Korvova/gitar/print/1/README.txt

ПАПКА 1 — первая нитяная секция (напечатать и подёргать руками):
  zona_body — 1 шт, плашмя (дно+борта+жёлобы+пьедесталы роликов по этажам)
  zona_cover — 1 шт, плашмя (крышка со щелями)
  boat_x4 — 4 шт (лодочка: ножка 3 мм, 4 пары ушек по этажам)
  roller4_x8 — 8 шт, слои 0.12 (ролик Ø4, ось = винт M2 в пьедестал)
СБОРКА ТЕСТА: ролики на M2 -> крышку на M2 -> лодочки в щели ->
нить (зубная/плетёнка): правый борт -> ЛЕВОЕ ушко своего этажа, левый -> ПРАВОЕ
(перекрест под лодочкой), концы пока просто узлами с натягом рукой.
ПРОВЕРКА: лодочка ездит ~43 мм; нить не задевает чужие этажи; тяга без рывков.
