Korvova/gitar/wiki/t-plata.md

Плата управления: ESP32, драйверы моторов TMC2209, питание. Здесь — как подключать
и на чём уже обожглись.

## Требования

| Номер | Требование | Описание | Урок | Статус |
|---|---|---|---|---|
| 8.1 | Собрать под три фаланги пальца | | | ⬜ Не начато |
| 8.2 | UART драйвера — на ножки D16 и D17 | D16 (RX2) → контакт TX драйвера; D17 (TX2) → резистор 1 кОм → контакт RX драйвера. На плате ESP32 эти ножки подписаны **D16 / D17**, а не RX2 / TX2 | Ножки **RX0 / TX0** — это линия USB, к ним драйвер не подключать: команды проходят, ESP отвечает «ok», а мотор стоит. Потеряли на этом вечер 19.09 | ✅ Проверено |
| 8.3 | Команда `diag` в прошивке стенда | `drive_web.ino`: считает байты по RX2. 0 — линия мертва (не те ножки, обрыв); 4 — своё эхо есть, драйвер молчит (нет питания VM); 12 — связь есть, дальше версия, EN, ток, обрыв и замыкание катушек | Проверка перемычкой D16–D17 без драйвера должна дать 4. Библиотека TMCStepper отвечает «нет VM» и на полностью мёртвый UART — верить только счёту байт | ✅ Проверено |
| 8.4 | Драйвер S2209 V4: ток только по UART | Подстроечного винта тока нет, настройки после выключения не сохраняются — прошивка задаёт ток при каждом старте. Два штырька у EN — выходы DIAG и INDEX, не перемычка, оставить пустыми | Без резистора 1 кОм на линии D17 → RX ток не задать | ✅ Проверено |
| 8.5 | Питание драйвера VM | Логика TMC2209 питается от VM, порог запуска 4.75 В; VIO (3.3 В) чип не запускает. Рабочее питание — PD-триггер 9–20 В, минус общий с GND ESP | Для пробы на столе хватает ножки VIN ESP (питание от USB): 19.09 мотор Ø36 на 200 мА крутится, `diag` — версия 0x21, катушки ок. Сила на скорости от 5 В проваливается — для работы нужен триггер (8.7) | ✅ Проверено 19.09 |
| 8.6 | Проба первого мотора Ø36 от ESP32 | Стенд: ESP32 + S2209 V4 + мотор Ø36, пульт `2-0/websim/serial_pult.html` по USB. Команды `deg ±15`, `deg ±90` — вал ходит туда и обратно и возвращается в те же углы | Мотор подключать и отключать только при вынутом USB. Порядок проводов в разъёме мотора подошёл как есть: чёрный A2, оранжевый A1, красный B1, синий B2 | ✅ Проверено 19.09 |
| 8.7 | Питание мотора от PD-триггера | Зарядка Xiaomi 100 Вт (MDY-16-EL) → кабель Type-C → триггер с красным DIP и зелёным клеммником (PDSink) → VBUS на VM, GND на GND рядом с VM. Провод VIN с VM снят; от ESP на этой стороне драйвера только 3V3 → VIO и GND → GND у VIO. `diag`: версия 0x21, обе катушки ок, ток 275 мА при `cur 300`; `deg ±15` ходит туда и обратно без потери шагов | Порядок включения: сначала зарядка, потом USB в ESP (ESP настраивает драйвер при старте; перепутал — кнопка EN на ESP). Выключать наоборот. Клеммы триггера сверху не подписаны — VBUS и GND смотреть на обороте, клемму плюса пометить маркером: переполюсовка сжигает драйвер. VIN и VBUS не соединять — напряжение триггера сожжёт ESP. Таблицы положений DIP у продавца нет, напряжение на выходе не измерено — любое 5–20 В для драйвера безопасно (держит до 28 В). Осталось: измерить напряжение и записать таблицу DIP | ✅ Проверено 19.09 |

## Схема

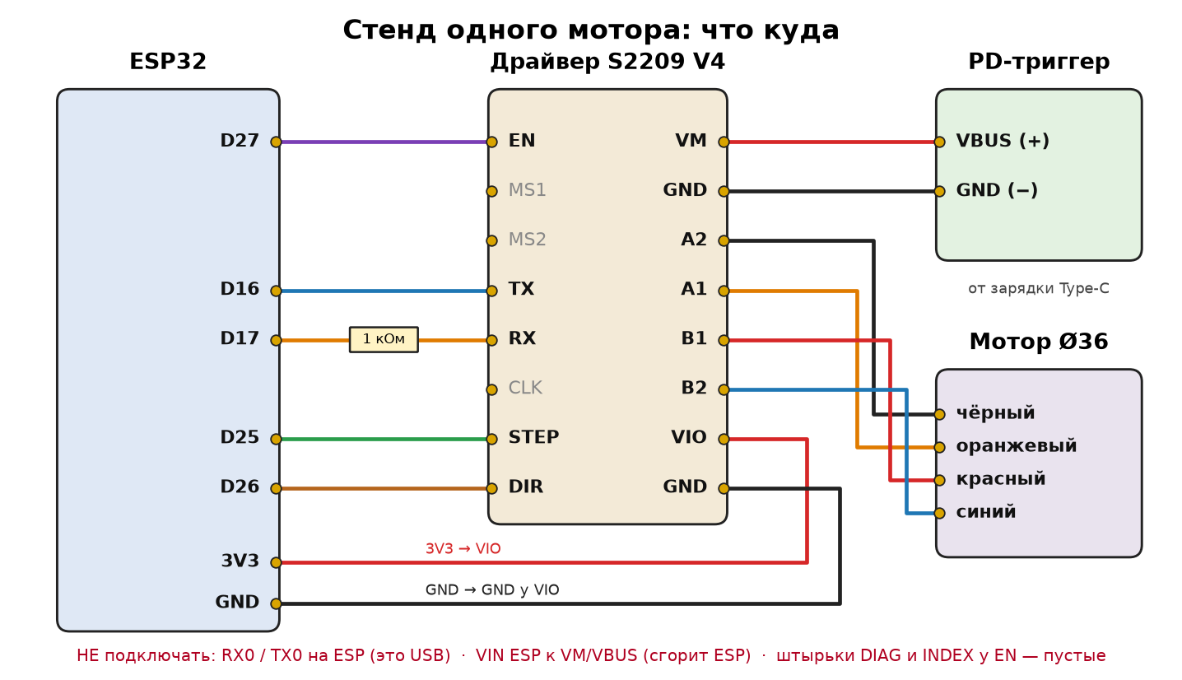
[picture p26: wiki/img/plata_shema.png]
Схема стенда одного мотора


## Распиновка стенда (один мотор)

| ESP32 | Драйвер S2209 V4 |
|---|---|
| D25 | STEP |
| D26 | DIR |
| D27 | EN |
| D16 | TX |
| D17 → 1 кОм | RX |
| 3V3 | VIO |
| GND | GND (рядом с VIO) |
| — | VM и GND рядом с ним: PD-триггер, VBUS на VM, GND на GND |
| — | A2, A1, B1, B2: мотор (чёрный, оранжевый, красный, синий) |

## Фото

**Драйвер S2209 V4.** Подписи контактов — на плате сверху.

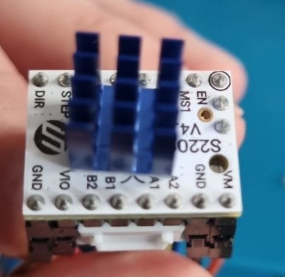
[picture p27: wiki/img/plata_foto_drayver.png]
Драйвер


**Разъём мотора на драйвере:** белый разъём на четырёх средних контактах A2 A1 B1 B2, по бокам — VM, GND и VIO, GND.

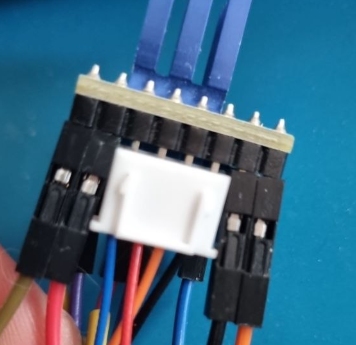
[picture p28: wiki/img/plata_foto_razem_motora.png]
Разъём мотора


**Сюда драйвер НЕ подключать.** Стрелки — ножки TX0 и RX0, это линия USB. Нужные D16 и D17 — ниже по тому же ряду, между D5 и D4.

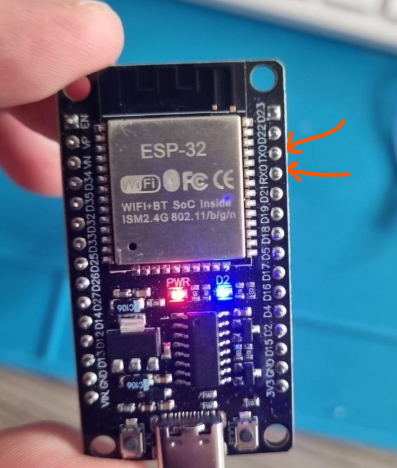
[picture p29: wiki/img/plata_foto_esp_rx0_tx0.png]
RX0 и TX0 — не сюда


**Питание:** зарядка 100 Вт → кабель Type-C → триггер.

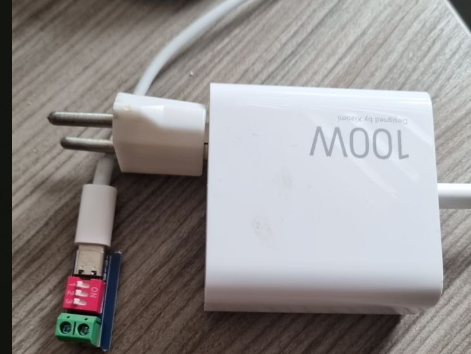
[picture p30: wiki/img/plata_foto_zaryadka_trigger.png]
Зарядка и триггер


**Оборот триггера:** VBUS (плюс) и GND подписаны здесь, на самом клеммнике подписей нет.

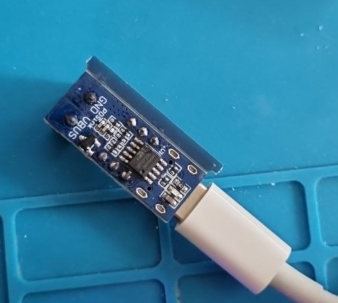
[picture p31: wiki/img/plata_foto_trigger_oborot.png]
Оборот триггера


*Схема рисуется скриптом* `tools/render_plata_shema.py`.
