Korvova/gitar/wiki/t-3d-modeli.md

&nbsp;



&nbsp;



&nbsp;

:file[palka1_golova.stl](/homepage/iniciativa.-razrabotka/jepik-ruka-gitara/t-3d-modeli/.files/palka1golova-2.stl)

:file[palka2_seredina.stl](/homepage/iniciativa.-razrabotka/jepik-ruka-gitara/t-3d-modeli/.files/palka2seredina-2.stl)

:file[palka3_k_deke.stl](/homepage/iniciativa.-razrabotka/jepik-ruka-gitara/t-3d-modeli/.files/palka3kdeke-2.stl)

&nbsp;

&nbsp;



:file[2-0.zip](/homepage/iniciativa.-razrabotka/jepik-ruka-gitara/t-3d-modeli/.files/2-0.zip){type="application/x-zip-compressed"}

&nbsp;

#|
||

Номер

|

Требования

|

Описания

|

Урок

||
||

|

|

|

||
||

|

|

|

||
|#

&nbsp;
