Korvova/gitar/wiki/t-elektronika.md

Электроника: один ESP32 читает шесть датчиков струн, отдаёт поток в браузер по USB,
браузерная страница рисует осциллографы и синтезирует звук. В продукте звук уходит
по BLE-MIDI на телефон или компьютер, динамик не нужен.

## Требования

| Номер | Требование | Описание | Урок | Статус |
|---|---|---|---|---|
| 4.1 | Опрос шести струн | 49E на пинах 32, 33, 34, 35, 36, 39 (ADC1), ~650 полных опросов в секунду | ADC1 не конфликтует с Wi-Fi, в отличие от ADC2 | ✅ Готово |
| 4.2 | Подавление шума ADC | Усреднение 4–16 замеров на выборку | Шум упал в разы, внешние конденсаторы не понадобились | ✅ Готово |
| 4.3 | Поток в браузер | Web Serial, 460800 бод, строка равна шести значениям | Сброс DTR и RTS обязателен, иначе плата висит в ресете; порт занимает открытая Arduino IDE | ✅ Готово |
| 4.4 | Детект щипка | Фильтр высоких частот, порог, антидребезг 70 мс, перевзвод на 0.85 порога | Детект по фронту вместо уровня убрал «динь-динь-динь» после щипка, перевзвод убрал пропуски при быстрой игре | ✅ Готово |
| 4.5 | Звук щипка | Синтез Карплуса-Стронга в браузере, тон зависит от направления рывка | Отзыв владельца: «как на гитаре, не отличить от электрогитары» | ✅ Готово |
| 4.6 | Ноты шести струн | E2 A2 D3 G3 B3 E4 на шести каналах | В странице есть переключатель обратного порядка нот | ✅ Готово |
| 4.7 | BLE-MIDI | Щипок даёт ноту с velocity, направление рывка — артикуляцию | Заменяет динамик: звук из любого синтезатора, плюс девайс становится MIDI-контроллером | ⬜ Не начато |
| 4.8 | Питание и разводка стенда | Две шины (3.3 В и земля) на клеммниках WAGO, сигналы напрямую в ESP | В серии — одна печатная плата на зону струн: шесть холлов в нужных точках, ESP, конденсаторы, DC-DC. Модуль прикручивается к ней без жгута | ⚠️ Частично |
| 4.9 | Заливка прошивок | arduino-cli, ядро esp32 3.3.10, FQBN esp32:esp32:esp32 | Родной ctags падает с access violation — заменён заглушкой, поэтому функции в скетчах объявляются до первого использования | ✅ Готово |
| 4.10 | Пульт не даёт ложных нот на живой раме | Развязка: щипок засчитывается сильнейшей из струн в окне 18 мс; соседям на 250 мс поднимается порог (занавес); повторный щипок должен быть выше собственного звона на 15 %, маска забывается за 150 мс | Три разных сбоя — три разных лекарства: одновременная дрожь соседей лечится сравнением амплитуд, поздний резонанс — занавесом, «пулемёт» на звоне одной струны — маской; чистый порог с перевзводом стрелял очередью на каждом горбе звона. Галка у струны выключает её из детекта и масштаба — так отлаживали по одной. Тремоло глохло, пока маска помнила звон почти секунду | ✅ Готово |
| 4.11 | Пульт показывает ровно то, что видит детект | На графике тот же фильтрованный сигнал, что в детекте; общий масштаб всех дорожек; цифра размаха у каждой струны; ноты селектором, «⇅» переворачивает порядок, «Лесенка» C3..G4 для отладки на слух | Пока график рисовал одно, а детект считал другое, «выше красной линии» ничего не значило; автомасштаб каждой дорожки прятал, кто реально громче. Пустые входы ADC 34–39 без подтяжек шумят до 200 единиц — снимать галку или 10 кОм на землю. У AS5600 магнит у границы шкалы 4095→0 давал иглы ±4096 — развёртка шкалы в пульте оставлена | ✅ Готово |
| 4.12 | Заливка на второй машине | arduino-cli 1.2.2 в Program Files, ядро esp32 3.3.11, esptool 5.3.1 через flasher.exe, порт COM6 (после передёргивания USB — COM4) | Там ctags не падает и заливка без BOOT работает, а на первой машине та же плата просит BOOT при том же драйвере CH340 — расследование на странице [Прошивка ESP32](/homepage/iniciativa.-razrabotka/jepik-ruka-gitara/proshivka-esp32). Вкладка пульта с Web Serial держит порт и молча рвёт заливку | ⚠️ Частично |
| 4.13 | Один ESP32 на струны и четыре мотора | 6 ADC1 (32–39) под 49E плюс STEP/DIR×4 и UART TMC2209 на свободных GPIO; прошивка объединяет стример струн (`struny6_hall`) и качание секторами (`drive_web`) | Пинов одного ESP32 на это хватает; браслет и LED — отдельный контроллер по ESP-NOW, как в карте продукта | ⬜ Не начато |

## Файлы

* `2-0/struny6_hall/struny6_hall.ino` — шесть холлов в ADC, текущая прошивка
* `2-0/hall49e_test/hall49e_test.ino` — одна струна, отладка датчика
* `2-0/struny6_test/struny6_test.ino` — вариант на AS5600 через мультиплексор
* `2-0/websim/struny6_pult.html` — пульт на шесть струн
* `2-0/websim/struna_pult.html` — пульт одной струны
* [Прошивка ESP32](/homepage/iniciativa.-razrabotka/jepik-ruka-gitara/proshivka-esp32) — команды заливки, окружение двух машин, чтение Serial из PowerShell
