Korvova/gitar/wiki/arxitektura.md

Как устроен проект технически: модели пишутся кодом, столы печати собираются
скриптом, геометрия проверяется автоматически.

## Стек

| Слой | Чем сделано |
|---|---|
| Модели деталей | Python и build123d, окружение `2-0/.venv-b123d` |
| Экспорт | STL в `2-0/Print/Print`, столы печати 3MF в `2-0/Print3mf` и `3-0/Print3mf` |
| Проверка сборки | `2-0/clearance.py` — зазоры, касания, совпадение отверстий |
| Слайсер | Bambu Studio, профиль PETG HF, слой 0.2 мм |
| Визуализация | Blender: сцены пересобираются из STL скриптом |
| Прошивки | Arduino ESP32 через arduino-cli, скетчи в папках рядом с моделями |
| Пульты и симуляторы | HTML-страницы в `2-0/websim`, Web Serial, работают без сервера |

## Как это работает

Каждый узел — один Python-файл: `gitara_struny.py`, `trainer_v9.py`,
`gitara_korpus.py`. Файл описывает детали булевыми операциями над примитивами,
экспортирует STL и в конце сам проверяет сборку: строит виртуальную сборку из
экспортированных файлов и убеждается, что детали не пересекаются там, где не должны,
касаются там, где должны, и что отверстия совпадают.

`make_3mf.py` собирает столы печати: каждая позиция — имя стола, профиль печати
и список деталей с ориентацией (положить как есть, перевернуть, положить на бок).
Столы нумеруются по порядку появления, номер живёт до конца проекта — так по
номеру всегда понятно, что печаталось.

## Правила, выведенные из практики

* Печать без поддержек — требование к геометрии, а не пожелание. Если деталь
  просит поддержку, переделывается деталь.
* Все соединения на винтах и защёлках, никакого клея и скотча: «скотч не годится,
  я такое продавать не буду».
* Размеры, проверенные печатью, помечаются в коде как зафиксированные. Например,
  посадка платы датчика: карман 23.1 мм, штырьки Ø3.6 мм — «село прям с щелчком».
* Координаты отверстий в проверках задаются в мировых координатах сборки,
  а не в локальных координатах детали.
* Печатные защёлки-грибки оказались хрупкими: там, где нужна надёжность,
  ставятся винты.
