Korvova/gitar/wiki/hronika.md

Хроника проекта: что произошло и чем кончилось, новые сверху. Подробности — по ссылкам в «Итог».

| Дата | Что произошло | Итог |
|---|---|---|
| 13.11.2026 | Проба балки v2: кнопки с одинаковым шагом 8.5 в длине 50, П ленты в одну сторону, широкий П-язычок тележки 10×10 с перекладиной на линии ленты (совпало = жми) | 🔄 [Т. Моторчик в тележке](/homepage/iniciativa.-razrabotka/jepik-ruka-gitara/t-motorchik-v-telezhki) 19.54 |
| 13.11.2026 | Зазор хвоста выбран 0.2; тележка с двумя П-язычками навстречу (нажатие снова в центре); в репо выложены все генераторы, сцены Blender, STL и asm трёх папок (most_v2, most_test, full_v5) | 🔄 [Т. Моторчик в тележке](/homepage/iniciativa.-razrabotka/jepik-ruka-gitara/t-motorchik-v-telezhki) 19.53 |
| 13.11.2026 | Проба балки с кнопками на столе: корпус, пластина с ячейками, крышка, лента с язычками, тележка с нажимником на кончике; зазор хвоста 0.1 туго / 0.4 болтается → две тележки 0.3 и 0.2 | 🔄 Печать: [Т. Моторчик в тележке](/homepage/iniciativa.-razrabotka/jepik-ruka-gitara/t-motorchik-v-telezhki) 19.52 |
| 13.11.2026 | Полный макет v5: привод телескоп v3 + узкий мост (лоток 9.6, тележка 13.8, рельсы-хвост на крышке, П-язычок, лента TPU с бугорками), вибромоторы под мостом на TPU-подушках с упорами; сцена 4 модулей | 🔄 Модель готова: [Т. Моторчик в тележке](/homepage/iniciativa.-razrabotka/jepik-ruka-gitara/t-motorchik-v-telezhki) 19.51 |
| 12.11.2026 | Мост-кассета с кнопками: STL пробы на столе (верх + лоток + крышки кнопок + пластина), тележка под неё | ⬜ Печать: [Т. Моторчик в тележке](/homepage/iniciativa.-razrabotka/jepik-ruka-gitara/t-motorchik-v-telezhki) 19.50 |
| 12.11.2026 | Решено: кнопки под каждой струной — главная часть, положение тележки даёт кнопка (49E не нужны). Задание: мост-кассета с кармашками, крышками на буртиках, пазом под плату 1.5 мм и каналом под резисторы | ⬜ [Т. Моторчик в тележке](/homepage/iniciativa.-razrabotka/jepik-ruka-gitara/t-motorchik-v-telezhki) 19.50 |
| 12.11.2026 | Телескоп v4: в мосту 6 SMD-кнопок под струнами с крышками и каналами под провода; горбик тележки нажимает кнопку только над струной | ⬜ [Т. Моторчик в тележке](/homepage/iniciativa.-razrabotka/jepik-ruka-gitara/t-motorchik-v-telezhki) 19.49 |
| 12.11.2026 | **Телескоп v3 собран и работает:** мотор неподвижен, шестерня мотора двигает ползун ±11, плавающие шестерни на ползуне катятся по неподвижной рейке и везут тележку ±22. Гриф 50 мм, высота 23.4, провода к тележке не нужны, всё печатается без поддержек. Задача привода, которую решали больше трёх месяцев, закрыта. Дальше — датчик положения и кнопка | ✅ [Т. Моторчик в тележке](/homepage/iniciativa.-razrabotka/jepik-ruka-gitara/t-motorchik-v-telezhki) 19.48 |
| 10.11.2026 | Положение тележки: 3 датчика 49E в платформе и 2 магнита на тележке (решение владельца). Датчики боком, ножки в три отверстия, провода снизу без пересечений и не через щель; на всех 6 струнах по модели определяется верно, между струнами датчики молчат. Главный риск — поле мотора, проверить на стенде | ⬜ Задание на STL: [Т. Моторчик в тележке](/homepage/iniciativa.-razrabotka/jepik-ruka-gitara/t-motorchik-v-telezhki) 19.47 |
| 09.11.2026 | Выбраны провода через центр мотора: МГТФ 0,07 или силиконовый 30 AWG | ⬜ Купить: [Т. Моторчик в тележке](/homepage/iniciativa.-razrabotka/jepik-ruka-gitara/t-motorchik-v-telezhki) 19.46 |
| 09.11.2026 | Шагоход проверен: большие диски заедают в печати и в MuJoCo; штырьки в симуляции идут от мотора только при подобранных зазорах, от пальца полный ход не подтверждён. Сложно: 12 реек на 4 пальца. Основной путь — мотор в тележке | 💤 Шагоход отложен, возможная вторая версия тренажёра: [Т. Моторчик в тележке](/homepage/iniciativa.-razrabotka/jepik-ruka-gitara/t-motorchik-v-telezhki) 19.44–19.45 |
| 09.11.2026 | Шагоход на 3 слоя реек — задание на стенд одной тележки: разбивка на детали, порядок сборки, трапецеидальные зубья | ⬜ [Т. Моторчик в тележке](/homepage/iniciativa.-razrabotka/jepik-ruka-gitara/t-motorchik-v-telezhki) 19.45 |
| 08.11.2026 | Идея владельца: шагоход — неподвижный мотор плашмя, рейки на эксцентриках ходят по кругу и по очереди входят в гребёнку тележки. Анимация; лучший вариант — 3 слоя реек: плавно, без мёртвой точки, ~19.8 мм без основания | 💡 Заметка [Т. Моторчик в тележке](/homepage/iniciativa.-razrabotka/jepik-ruka-gitara/t-motorchik-v-telezhki) 19.44 |
| 06.11.2026 | Рольганг собран — работает плохо («отстойно»). Возврат к мотору в тележке: мотор 2204 плашмя, винт М3 сквозь трубку Ø3, шестерня m1 z12 сразу на выходе — без пластины между ними; лапы рельсов на стойках тележки, перемычка над рейкой, щёчки и упоры под шестернёй, провода вниз в прорезь. До дна ложа 22 мм с плитой 2 мм (владелец печатал такую — крепкая). Основание грифа 2.5, бюджет высоты ~24.5 мм: крышка = дно ложа, шпилька М3 без головки, датчика положения пока нет. Заметка: моторизированный фейдер с ремешком (19.39). Заметка: положение для режима «сам» — 49E на тележке, магниты в плите под струнами разной полярности и высоты (19.40). Порядок: сначала только нормальное перемещение, режим «сам» и датчик — потом. Внешний вид: механизм в неподвижной чёрной ванночке шириной 60.6 с бортиком 4 мм, сверху ездят закрытые кубики; рейка закрыта крышкой, шестерня заходит под неё; прорези оставлены и спрятаны чёрным цветом. Ванночка оказалась шире грифа (60.6 против 52), поэтому итог другой: мотор перевёрнут, неподвижная часть приклеена к крышке, провода идут через его трубку и выходят из центра полой шестерни в щель; шестерня утоплена в паз с зубьями на стенке, ширина 52, высота 24.2. Затем: рейка и ласточкин хвост — одно целое со скосом, задний рельс узкий с упором вплотную, два зеркальных окна сбоку. Замеры: отверстие мотора сквозное Ø3, подшипник вровень. Эту версию владелец печатает и собирает дома на одну тележку. Концепт в Blender; файлы на печать — следующий шаг (стол 114) | ⬜ [Т. Моторчик в тележке](/homepage/iniciativa.-razrabotka/jepik-ruka-gitara/t-motorchik-v-telezhki) 19.38–19.43 |
| 05.11.2026 | Идея владельца: передавать тележку с рейки на рейку шестернёй-улиткой — у шестерни половина с зубьями, половина лысая; две рейки сверху со штырьками на спине, лысина опускает рейку и штырёк выходит из тележки, вторая рейка подхватывает. Перебрали отдельные кулачки, рейки снизу/сверху, мотор плашмя, удвоитель, ремень, овальные шестерни; выбран вариант «мотор боком, рейки сверху» — анимация в Blender. Запасной, если рольганг пойдёт туго. Затем — вариант с копиром: рейки не поднимаются, один штырёк тележки переводит из рейки в рейку неподвижный S-паз (~25°) | 💤 [Т. Моторчик в тележке](/homepage/iniciativa.-razrabotka/jepik-ruka-gitara/t-motorchik-v-telezhki) 19.36–19.37 |
| 04.11.2026 | Гимбал 2204 с Авито (11 Ом, обмотки целые) подключён к SimpleFOC Mini V2: через SimpleFOC не крутится, синус прямо на IN1–IN3 — крутится → прошивка пульта переписана на свой синус без SimpleFOC, мотор ходит с пульта. Владелец нашёл кассету «телескоп» (мотор неподвижен, тележка ±24 через плавающие шестерни, m0.5): проверили ход программно, напечатали на FDM с макетом мотора; добавлена полка под плавающими шестернями и штырьки на ползуне | ⌛ [Т. Моторчик в тележке](/homepage/iniciativa.-razrabotka/jepik-ruka-gitara/t-motorchik-v-telezhki) 19.30, 19.32 |
| 02.11.2026 | Купил на Авито б/у подвес с двумя гимбал-моторами 2204 260KV (1800 ₽; продавец замерил Ø27.8 × 12.2) — та же модель, что сломалась, должна встать в стенд 2204 (стол 101) как есть: можно гнать проверки хода, силы, ручного хода и вибрации, не дожидаясь GB1806. Донор Zhiyun Smooth 4 не пригодился: моторы залиты в корпус, отдельно не вынуть | ⌛ [Т. Моторчик в тележке](/homepage/iniciativa.-razrabotka/jepik-ruka-gitara/t-motorchik-v-telezhki) 19.18 ❌, 19.29, 19.32–19.35 |
| 01.11.2026 | Новая страница «Сборка: лазерная резка»: корпус из фанеры лазером, пропорции настоящей классики (корпус с XII лада, 325 мм), гриф = сама платформа с тележками ~27 мм, дно плоское (ребро-клин 19.26 отклонено — у XII вышло бы 43 мм), гриф расширяется 52 → 60; толкатель — короб во всю высоту грифа с платой ESP32 + 4 драйвера внутри, рейка в пазу дна короба, NEMA17 осью вверх; тележки в корпусах-«клавишах». Опыт: полоса PLA 2.5 × 295 боком держит крепко → дно грифа — фанера 3 мм. Плата AS5048A продавца: можно 3 провода (ШИМ), питание 5 В | ⚠️ [Т. Сборка: лазерная резка](/homepage/iniciativa.-razrabotka/jepik-ruka-gitara/t-sborka-lazernaja-rezka) 20.1–20.15, [Т. Моторчик в тележке](/homepage/iniciativa.-razrabotka/jepik-ruka-gitara/t-motorchik-v-telezhki) 19.14 |
| 30.10.2026 | Почему не крутится 2204: драйвер проверен синусом напрямую — работает; мультиметр — обрыв во всех трёх фазах мотора (брак). На моторе 1306 цепочка ESP32 → SimpleFOC Mini V2 → мотор крутится ровно. 12 В от USB-C зарядника через PD-триггер (только переключатель 1, кабель C↔C). Написаны прошивка motor1_fw и пульт в браузере. Нарисован заранее стенд под GB1806 (стол 103, шестерня m1 z14 ≈ 870 г/А) | ✅ [Т. Моторчик в тележке](/homepage/iniciativa.-razrabotka/jepik-ruka-gitara/t-motorchik-v-telezhki) 19.16, 19.30–19.32 |
| 29.10.2026 | Стенд одного пальца на гимбале 2204 напечатан и собран (стол 101): мотор на ребре в тележке-клетке, шестерня m1 z26, рейка поперёк, Т-рельсы. При нажатии тележка закусывала — полозья расширены до ±16.8, зазор у рейки 1.5 (стол 102). Заказаны 4 × GB1806 с AS5048A и 5 × DRV8316 | ⚠️ [Т. Моторчик в тележке](/homepage/iniciativa.-razrabotka/jepik-ruka-gitara/t-motorchik-v-telezhki) 19.11, 19.15, 19.29 |
| 15.10.2026 | Вибрация «где зажать» — самим мотором тележки (быстрые толчки поверх удержания позиции), без вибромотора; факт зажатия — две мягкие тактовые кнопки под концами рейки, неподвижно на платформе (FSR отклонён — нужен щелчок) | ⚠️ [Т. Моторчик в тележке](/homepage/iniciativa.-razrabotka/jepik-ruka-gitara/t-motorchik-v-telezhki) 19.27–19.28 |
| 14.10.2026 | Платформа с 4 тележками вдоль грифа: двигать **толкателем из деки** (зубчатая штанга перед платформой, мотор в деке — толщина грифа не растёт); штанга-трубка везёт провода к плате на платформе (ESP32 + 4 FOC), в деке — катящаяся петля плоского шлейфа. Затем толкатель сделан плоской пластиной на всю ширину со струнами сверху (провода в желобке под ней), лады — неподвижными метками на бортиках; шторки спереди отклонены. Концепты в Blender. Жёсткость грифа: снизу по центру ребро-клин (у головы тонкое, у деки ~20 мм, как пятка гитары) + печатная насадка, прогиб ~1 мм | ⚠️ [Т. Моторчик в тележке](/homepage/iniciativa.-razrabotka/jepik-ruka-gitara/t-motorchik-v-telezhki) 19.19–19.26 |
| 13.10.2026 | Заказ стабилизатора Aochuan отменён; взамен заказан Zhiyun Smooth 4 (Авито, 1500 ₽) — донор трёх гимбал-моторов для пробы. Обсуждены цена (Founder's около 40 тыс ₽, в мире $800–1000; серия 25–30 тыс + подписка), лестница партий 2 → 10 → 100 → 1000 и оснастка (литьё дорого; первые сотни — 3D-печать + лазерная резка листа) | ⌛ [Т. Моторчик в тележке](/homepage/iniciativa.-razrabotka/jepik-ruka-gitara/t-motorchik-v-telezhki) 19.18 |
| 12.10.2026 | Решение: мотор прямо в тележке — гимбал-мотор на ребро, шестерня по рейке поперёк грифа, бока грифа у тележек открыты. Сравнили моторы (квадрокоптерные, NEMA 8, гимбалы 2204 / GB2205 / GB1806, бескаркасные, пьезо, индукционные, промышленные линейные); выбран SteadyWin GB1806 с AS5048A. Концепт 4 тележек в Blender. Для пробы, пока копится на GB1806, заказан б/у трёхосевой стабилизатор Aochuan (Авито, 1500 ₽, оплата при получении) — донор трёх гимбал-моторов; в пути драйвер BLDC и моторы 1306 / 1503 для отладки FOC | ⌛ [Т. Моторчик в тележке](/homepage/iniciativa.-razrabotka/jepik-ruka-gitara/t-motorchik-v-telezhki) |
| 10.10.2026 | Идеи владельца: спарник (планка между двумя дисками), второй диск у тележки (стенды 99, 100), гипоидная передача | [Т. Вариант с тележками](/homepage/iniciativa.-razrabotka/jepik-ruka-gitara/t-variant-s-telezhkami) 14.19–14.20, [Т. Гипоидная передача](/homepage/iniciativa.-razrabotka/jepik-ruka-gitara/t-gipoidnaja-peredacha) |
| 09.10.2026 | Стенд 90 (приблуда в деке → лента → плечо) собран — тянет слабо, нестабильно. Назад к мотору: шатун 100 мм (стол 92), кривошип R14 сектором (стол 95) | 💤 [Т. Магнитный + Кривошип](/homepage/iniciativa.-razrabotka/jepik-ruka-gitara/t-magnitnyj-krivoshyp) 18.16, [Т. Вариант с тележками](/homepage/iniciativa.-razrabotka/jepik-ruka-gitara/t-variant-s-telezhkami) 14.17–14.18 |
| 08.10.2026 | Стержень Ø15 × 5 на меди 0.4 поехал (500 мА, ±16 мм); идея положить приблуду в деку и толкать ленту — стенд одного пальца, столы 90/91 | [Т. Магнитная версия 2.0](/homepage/iniciativa.-razrabotka/jepik-ruka-gitara/t-magnitnaja-versija-2) 17.18, [Т. Магнитный + Кривошип](/homepage/iniciativa.-razrabotka/jepik-ruka-gitara/t-magnitnyj-krivoshyp) 18.4–18.12 |
| 04–07.10.2026 | Стержень на дисках 4 × 2 едет слабо; на Ø15 намотана стальная проволока «для бисера» — не поехало | [Т. Магнитная версия 2.0](/homepage/iniciativa.-razrabotka/jepik-ruka-gitara/t-magnitnaja-versija-2) 17.12, 17.18 |
| 01–03.10.2026 | Механика с рычагом закусывает — переход на магниты: плоское русло (стол 86), затем «магнитный стержень + бегущая катушка» | 💤 [Т. Магнитная версия](/homepage/iniciativa.-razrabotka/jepik-ruka-gitara/t-magnitnaja-versija), [Т. Магнитная версия 2.0](/homepage/iniciativa.-razrabotka/jepik-ruka-gitara/t-magnitnaja-versija-2) |
| 26–27.09.2026 | Ложа, калибровка струн и упражнения в пульте; палец плохо чувствует ход — рычаг ×5.2 умножает люфт, мёртвые точки кривошипа; стенды рычаг ×2 и шатун (столы 81, 82, 85) | [Т. Тележки](/homepage/iniciativa.-razrabotka/jepik-ruka-gitara/t-telezhki), 💤 [Т. Вариант с тележками](/homepage/iniciativa.-razrabotka/jepik-ruka-gitara/t-variant-s-telezhkami) |
| 24–26.09.2026 | Плата 4 моторов спаяна; короткий гриф (секции 1–2 + дека с 4 моторами) — все четыре тележки ездят от пульта | ✅ [Т. Сборка короткий гриф](/homepage/iniciativa.-razrabotka/jepik-ruka-gitara/t-sborka-korotkij-grif) |
| 19–20.09.2026 | Стенд одного мотора от ESP32 + TMC2209; плата 4 моторов изготовлена дома (маркер, перекись, лужение) | ✅ [Т. Плата для мотора](/homepage/iniciativa.-razrabotka/jepik-ruka-gitara/t-plata), [Т. Плата для 4-х моторов](/homepage/iniciativa.-razrabotka/jepik-ruka-gitara/t-plata-4-motora) |
| 15.09.2026 | Стенд датчика положения: 49E под лентой — монотонно, 194 единицы на 12 мм | ✅ [Т. Положение тележек](/homepage/iniciativa.-razrabotka/jepik-ruka-gitara/t-polozhenie-telezhek) |
| 13.09.2026 | Секция-1 с 4 станциями собрана руками, посадки Ø5.1 по купону | ✅ [Т. Инструкция по сборке: секция-1](/homepage/iniciativa.-razrabotka/jepik-ruka-gitara/t-instrukcija-sborki) |
| 09.09.2026 | Выбран привод «палка»: мотор в деке → кривошип → лента → плечо → тележка; физика 4 станций в Bullet; печать секции-1 | [Т. Гриф и аппликатура](/homepage/iniciativa.-razrabotka/jepik-ruka-gitara/t-grif) 2.10–2.16 |
| июль 2026 | Тросовая версия v9 (барабаны, ролики, нить) | ❌ Исключена — люфт и натяжение; референс в [Т. Гриф и аппликатура](/homepage/iniciativa.-razrabotka/jepik-ruka-gitara/t-grif) |
