Korvova/gitar/wiki/t-motorchik-v-telezhki.md

Текущее направление (12.10.2026): **мотор прямо в тележке**. В каждой тележке стоит маленький бесколлекторный гимбал-мотор на ребро (вал вдоль грифа), на его вращающемся корпусе — шестерёнка, она катится по рейке, уложенной на дне грифа поперёк. Тележка едет сама — без лент, рычагов, кривошипов и мотора в деке. Почему так: за июль–октябрь все варианты упирались в **передачу** от мотора к пальцу — каждое звено (лента, плечо, кривошип, шатун) добавляло люфт, мёртвые точки и трение ([Т. Вариант с тележками](/homepage/iniciativa.-razrabotka/jepik-ruka-gitara/t-variant-s-telezhkami), [Т. Магнитный + Кривошип](/homepage/iniciativa.-razrabotka/jepik-ruka-gitara/t-magnitnyj-krivoshyp)). Здесь звено одно: шестерня по рейке. Как к этому шли — [📜 Хроника](/homepage/iniciativa.-razrabotka/jepik-ruka-gitara/hronika).

**Сейчас (12.11):** привод тележки решён — **телескоп v3 (19.48)**: мотор стоит на месте, шестерни удваивают ход ползуна ±11 до ±22, собран и работает. Дальше — датчик положения и кнопка. Мотор в тележке (19.38–19.43) и шагоход (19.44–19.45) — пройденные варианты.

## Этап 1. Компоновка: 4 тележки в грифе (12.10)

| Номер | Требование | Описание | Урок | Статус |
|---|---|---|---|---|
| 19.1 | Мотор в тележке, шестерня по рейке | Тележка = мотор на ребро + шестерня m0.5 Ø6 на выходе + ложе сверху. Рейка m0.5 лежит на дне своего кармана поперёк грифа, ход тележки ±22 (струны 1–6, шаг 8.8) | Всё, что едет внутри грифа шириной 52 при ходе 44, может быть шириной только ~8 мм — мотор Ø20+ не влезет. Но ложе (~24 мм) и так выезжает за край грифа на ~6 мм: если мотор спрятан под ложем, он выходит не дальше ложа. Решение владельца 12.10: **бока грифа у тележек открыты**, тележка может выезжать за край | ✅ Решение |
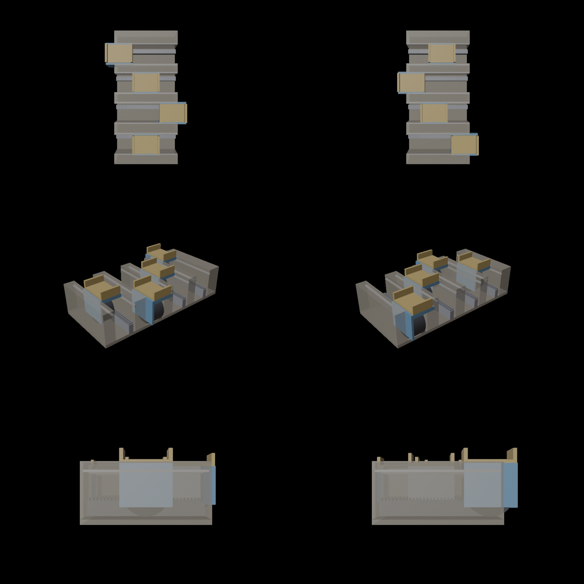
[picture p32: wiki/img/motor_v_telezhke_koncept.png]
Концепт 4 тележек с моторами
| 19.2 | Четыре кармана поперёк грифа | Под каждым пальцем сквозной поперечный карман (открыт с боков и сверху), шаг пальцев V позиции 24–26 мм (станции Y 16 / 42 / 67 / 91). Мотор с шестерней вдоль грифа ~20 мм — между тележками остаётся 4–6 мм. Концепт-сцена [Гриф_4_тележки_моторы.blend](https://raw.githubusercontent.com/Korvova/gitar/main/2-0/%D0%93%D1%80%D0%B8%D1%84_4_%D1%82%D0%B5%D0%BB%D0%B5%D0%B6%D0%BA%D0%B8_%D0%BC%D0%BE%D1%82%D0%BE%D1%80%D1%8B.b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) (пробел — тележки ездят каждая своим ритмом), скрипт [scene_motor_v_telezhke.py](https://github.com/Korvova/gitar/blob/main/2-0/scene_motor_v_telezhke.py). Сверху, наискосок и с торца, два положения:  | Шаг 24–26 — это пальцы на V позиции (указательный на 5 ладу … мизинец на 8), не механика: механически можно до ~20 мм. К деке лады короче (XII — 16–18 мм), к порожку длиннее (I — 31–34 мм); ширина грифа — наоборот, к деке растёт | ⚠️ Концепт, не напечатан |
| 19.3 | Высота грифа | Мотор Ø22 на ребро + дно ~2 = 24 мм — в гриф 25 влезает. С мотором Ø26 (GB2205) гриф толще на 2–3 мм — владелец согласен, если работает | Владелец 12.10: «для тренажёра можно гриф чуть толще, зато будет работать отлично» | ✅ Решение |
| 19.4 | Прочность грифа-«гребёнки» | Карманы открыты с боков — гриф держится на дне и перемычках между карманами. Дно 3–4 мм или полоса стали/алюминия в дне | | ⬜ Не начато |
| 19.5 | Тележку не отжимает от рейки | Шестерня под нагрузкой отжимается вверх: крыша тележки лапками в пазах перемычек или рельсы по дну с «замком». Если тележки ведут рельсы по дну — стенки между карманами не нужны, места вдоль грифа больше | | ⬜ Не начато |

## Этап 2. Какой мотор (12.10)

| Номер | Требование | Описание | Урок | Статус |
|---|---|---|---|---|
| 19.6 | Нужная сила и скорость | 300 г на тележке через шестерню Ø6 (r 3 мм) = **~9 мН·м** на валу (с трением ~12). Скорость ~100 мм/с (струна за 0.1 с, весь ход 44 мм за 0.4 с) = ~320 об/мин | Меньше радиус шестерни — больше сила при том же моторе: колесо Ø20 вместо шестерни Ø6 потребовало бы втрое больше момента | ✅ Посчитано |
| 19.7 | ~~Мотор от квадрокоптера (1404, 1306, 1503)~~ | ~~Сделан на тысячи оборотов: при ~3000 об/мин на вольт момент ~3 мН·м на ампер — для 300 г без редуктора 3–4 А, мотор весом 10 г перегреется. С редуктором 1:4 хватит ~0.7 А, но возвращаются люфт шестерён и шум~~ | ~~1306 и 1503 уже куплены (12.10, едут) — пригодятся для отладки драйвера и прошивки FOC, пока едет основной мотор~~ | ❌ Не основной путь |
| 19.8 | Шаговик NEMA 8 (20HS24) | 20 × 20 × 24, ~10–15 мН·м — силы хватает, работает от нашей платы TMC2209. Минусы: вдоль грифа ~30 мм (четыре только шахматкой), в ручном режиме «рябь» по шагам | | 💤 Запасной |
| 19.9 | Гимбал 2204 (Ø28) | 260–330 об/мин на вольт, ~30–37 мН·м на ампер — сила с большим запасом, но Ø28: на ребро выше грифа, плашмя шире шага пальцев | Годится для пробы одного пальца, не для четырёх в ряд. 30.10: на стенде мотор не крутился — между любыми двумя проводами обрыв (мультиметр «1»), при том что каждый провод до своего контакта целый: оборваны выводы обмоток внутри, вероятнее всего винтами М2 × 6 в неподвижной стороне (входили в мотор на ~2 мм) | ❌ Первый сломан 30.10, выброшен. 02.11 — с Авито два таких же 2204 (хроника); 04.11 новый мотор (11 Ом между проводами, обмотки целые) крутится — 19.32 |
| 19.10 | Гимбал GB2205 (Ø26.3) | Ø26.3 × 13 (+3.5), 0.04 Н·м номинал / 0.06 пик, фаза 8 Ом, 12 В; выход — фланец Ø8 с 4 × М2, вала нет. ~1170 ₽. С шестернёй Ø6 ~1.3 кг | Гриф толще на 2–3 мм (19.3) | 💤 Запасной, дешевле |
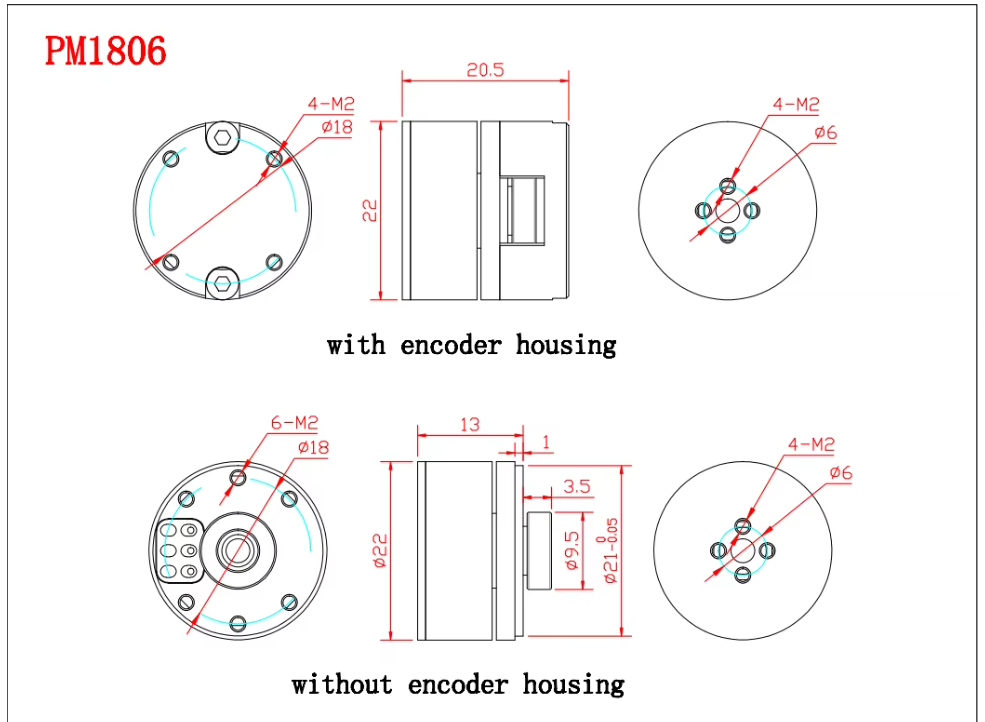
[picture p33: wiki/img/gb1806_chertezh.png]
GB1806 чертёж
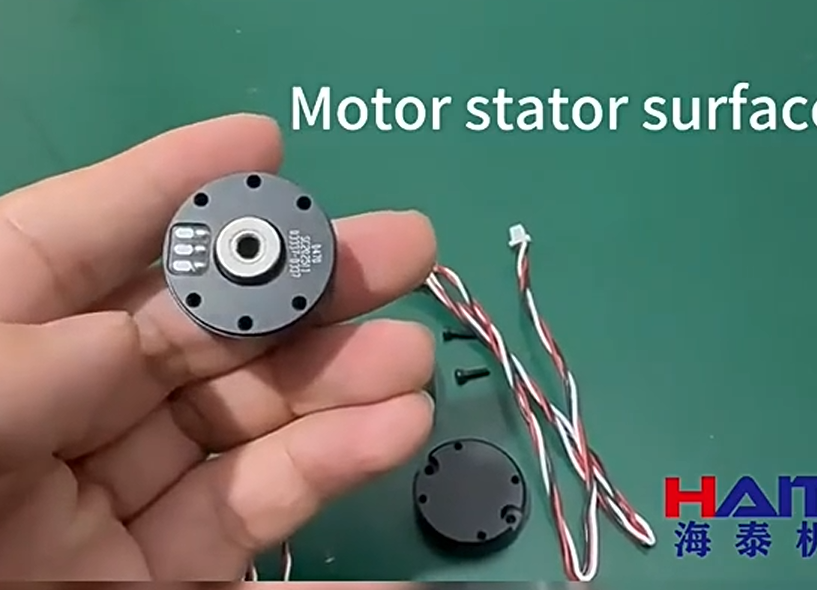
[picture p34: wiki/img/gb1806_stator.png]
GB1806 статор
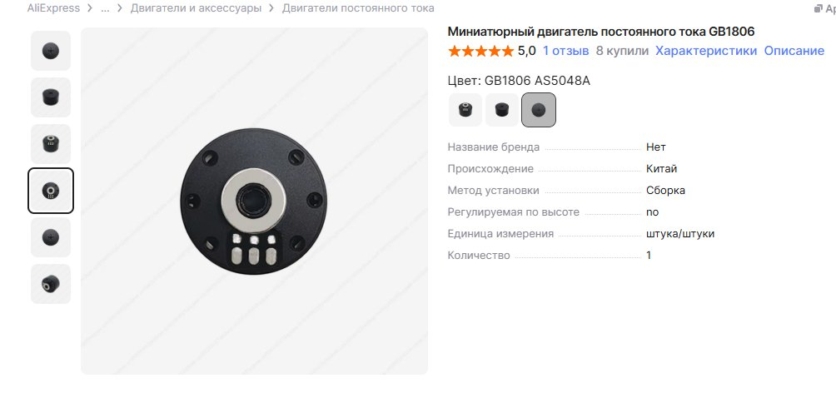
[picture p35: wiki/img/kup_gb1806_as5048a.jpg]
Что купили — GB1806 AS5048A
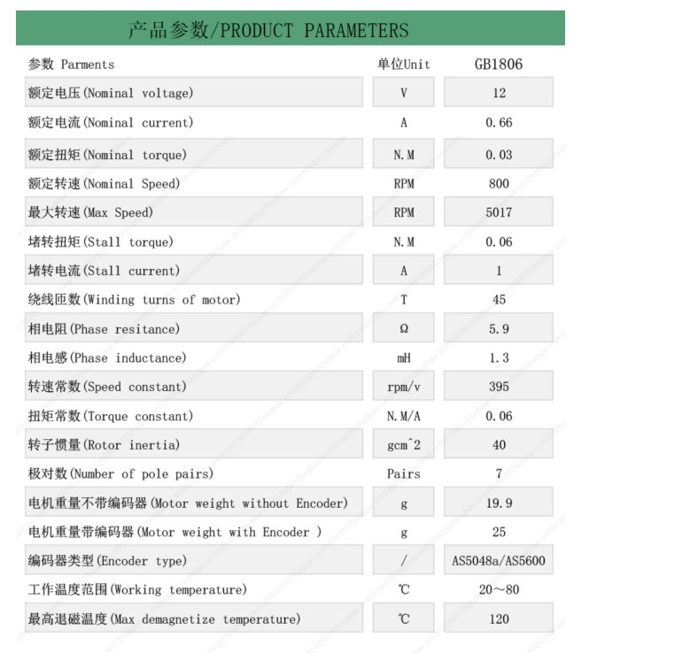
[picture p36: wiki/img/gb1806_parametry.jpg]
GB1806 параметры
| 19.11 | **Гимбал SteadyWin GB1806 / PM1806 (Ø22) — выбран** | Ø22 × 13 + 1 + 3.5 (с корпусом энкодера длина 20.5); **0.03 Н·м номинал, 0.06 пик**, 12 В / 0.66 А, фаза 5.9 Ом, 7 пар полюсов, 395 об/мин на вольт, 20 г (25 с энкодером). Неподвижная сторона — 6 × М2 на Ø18, провода; **вращается весь стакан** с торцом 4 × М2 на Ø6 — на него шестерня. С шестернёй Ø6: **~1 кг постоянно, ~2 кг рывком, ~250 мм/с** — запас по силе ×3, по скорости ×2.5 (можно шестерню Ø8–10). GB1806 с AS5048A ~2330 ₽ + доставка, PM1806 ~3100 ₽. Чертёж:  Сторона статора:  **29.10 заказано 4 шт. GB1806 с AS5048A по 2 329 ₽**  Параметры продавца:  — **постоянная момента 0.06 Н·м/А**, 5.9 Ом, 7 пар полюсов; с корпусом энкодера длина 20.5, неподвижная сторона 4 × М2 на Ø18, крутится торец 4 × М2 на Ø6 | Гимбал сделан ровно под нашу работу: медленно, плавно, с силой держать положение; залипания почти нет — в ручном режиме палец двигает тележку легко. Без редуктора — нет люфта и шума шестерён. Цифры — по карточкам продавцов, проверить на стенде | ⬜ Едут 4 шт. (заказ 29.10) |
| 19.12 | Бескаркасный WK1806 / WK1105 | Только статор и кольцо-ротор, без корпуса и подшипников: вал можно провести насквозь и поставить **шестерни с двух сторон** на две рейки — тележку не перекашивает (идея владельца). WK1806 — та же начинка, что GB1806, ~900 ₽. WK1105 (ротор Ø14.9 × 6) — скорее слабый | Свои подшипники и соосность: магниты тянут ротор к статору, кривой зазор — трение | 💤 Идея |
| 19.13 | ~~Пьезо, индукционный (токи Фуко), промышленные линейные~~ | ~~Пьезо держит трением (ручного режима нет) и дорогой; индукционный слабый на таком масштабе и не держит позицию; промышленные (Yaskawa, HIWIN, GYU) — сотни долларов и длиннее грифа~~ | ~~Промышленный U-канал GYU2: 4.2 Н/√Вт — наша приблуда по расчёту давала ~70 % от него, но в гриф не влезла~~ | ❌ |

## Этап 3. Электроника (12.10)

| Номер | Требование | Описание | Урок | Статус |
|---|---|---|---|---|
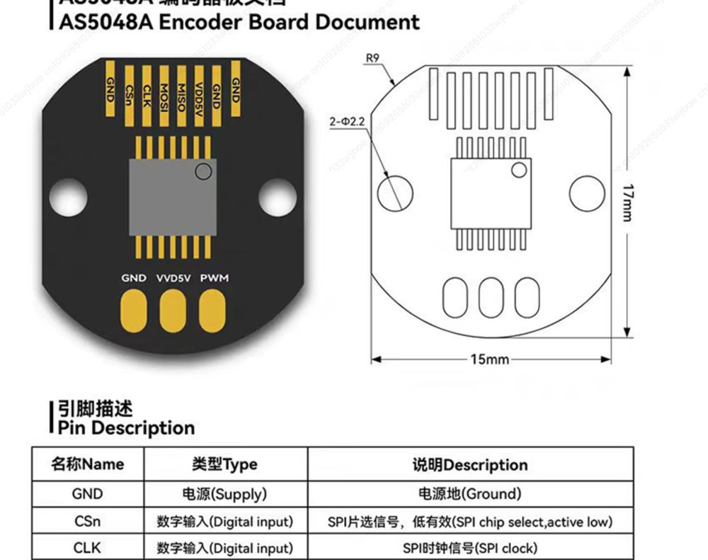
[picture p37: wiki/img/as5048a_raspinovka.jpg]
Плата AS5048A
| 19.14 | Датчик угла на каждом моторе | Для FOC драйверу нужен угол ротора в каждый момент: 7 пар полюсов, при шестерне Ø6 сдвиг тележки на 1 мм — это >100° «электрического» угла, Холл по тележке такой точности не даст. **AS5048A** (14 бит, SPI) — четыре на одну шину, у каждого свой CS; у AS5600 (I2C) адрес у всех одинаковый. Магнит на торце, зазор 0.5–3 мм. **01.11 — плата AS5048A продавца** (стоит в корпусе энкодера GB1806): 15 × 17 мм, 2 × Ø2.2; два набора контактов — ряд SPI (GND, CSn, CLK, MOSI, MISO, VDD5V, GND, GND) и три крупных площадки **GND, VDD5V, PWM** — датчик можно подключить **тремя проводами** (ШИМ ~1 кГц, SimpleFOC читает), тогда на тележку 6 проводов вместо 9.  **Питание 5 В и выход ШИМ 5-вольтовый** — вход ESP32 рассчитан на 3.3 В: на сигнальный провод делитель (10 кОм + 20 кОм). Провода к плате — [Т. Сборка: лазерная резка](/homepage/iniciativa.-razrabotka/jepik-ruka-gitara/t-sborka-lazernaja-rezka) 20.15 | Положение тележки этот же датчик даёт даром: угол вала и путь по рейке связаны жёстко | ⬜ AS5048A едут вместе с GB1806 (19.11) |
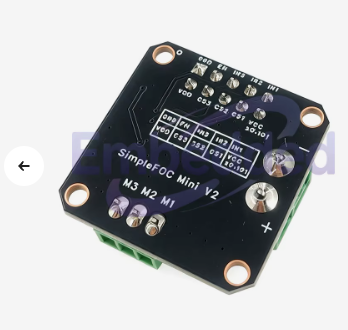
[picture p38: wiki/img/simplefoc_mini_v2_verh.png]
SimpleFOC Mini V2 сверху
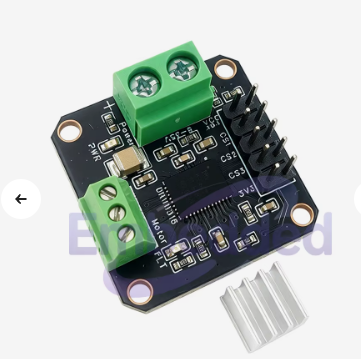
[picture p39: wiki/img/simplefoc_mini_v2_niz.png]
SimpleFOC Mini V2 снизу
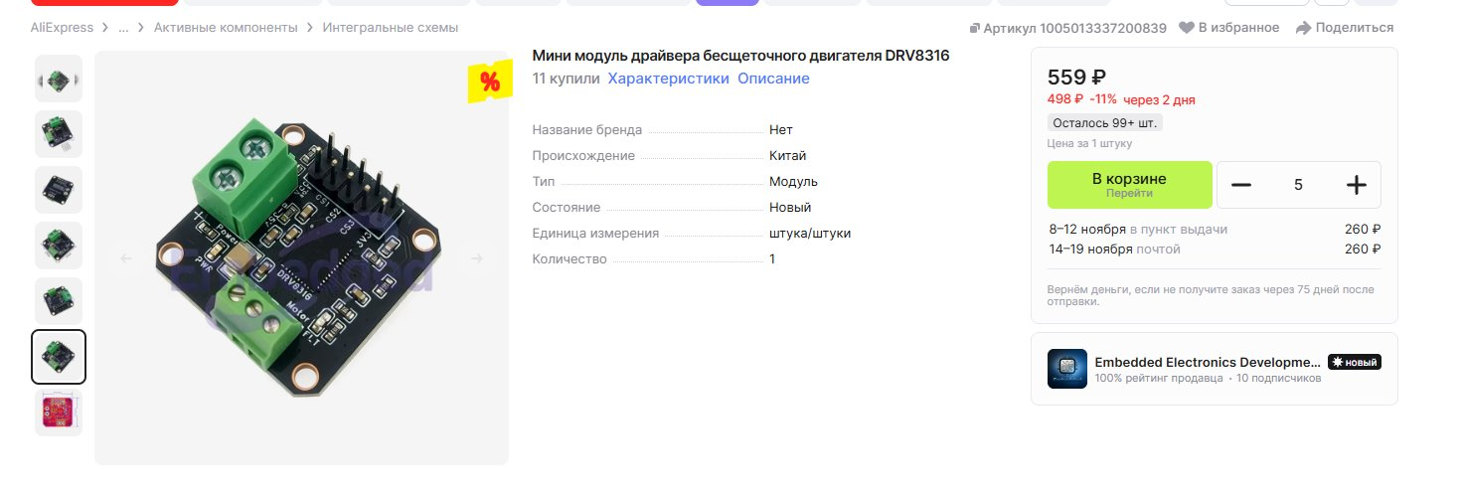
[picture p40: wiki/img/kup_drv8316.jpg]
Что купили — DRV8316
| 19.15 | Драйвер FOC на каждый мотор | SimpleFOC Mini или аналог, 12 В, ток ~1 А; ESP32 + библиотека SimpleFOC. Один уже есть — **SimpleFOC Mini V2** на DRV8316 (866 ₽):   Подключение — 19.30. **29.10 заказано ещё 5 модулей DRV8316CT по 559 ₽** (всего 6: 4 на моторы + 2 запасных) : 8–35 В, 3 А долго / 8 А пик, 3PWM под SimpleFOC, встроенный датчик тока, стабилизатор 3.3/5 В — им же питать энкодеры | Наша плата с TMC2209 трёхфазный мотор не крутит. Владелец: «электроника не проблема, главное — механика»; Модули с клеммниками для прототипа громоздкие — для тренажёра потом своя плата: ESP32 + 4 микросхемы драйвера | ⬜ Едут 5 шт. (заказ 29.10); 1 есть — подключаем на стенде (19.30) |

## Этап 4. Стенд одного пальца

| Номер | Требование | Описание | Урок | Статус |
|---|---|---|---|---|
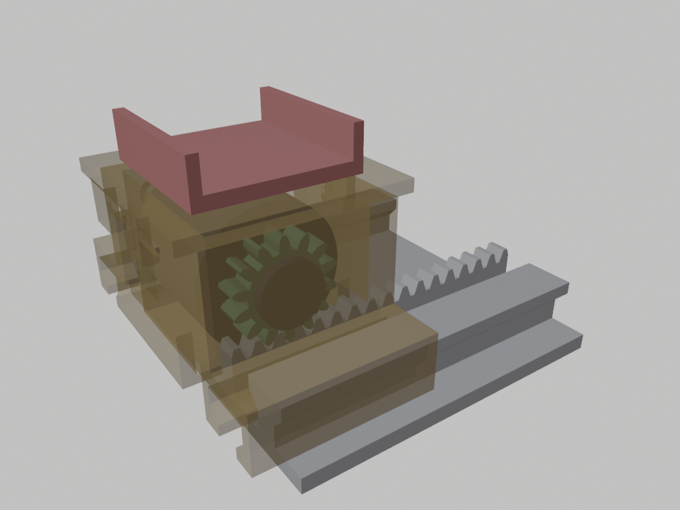
[picture p41: wiki/img/motor2_stend_gb1806.png]
Стенд GB1806
| 19.16 | Стенд под GB1806 | **30.10 нарисован заранее** по чертежу продавца (19.11), на основе стенда 2204 с его исправлениями: Ø22, с корпусом энкодера длина 20.5 (корпус + основание 7.5 неподвижно, стакан 13 крутится). **Шестерня m1 z14** (Ø14 по делительной) на торец стакана 4 × М2 на Ø6, головки винтов наружу: сила ~0.06 Н·м/А ÷ 7 мм ≈ **870 г на ампер** (номинал 0.66 А ≈ 570 г). Чтобы мотор Ø22 не лёг на пол, **рейка на гребне** (делительная линия 10.1 над столом), головка зуба рейки укорочена до 0.8 — у шестерни z14 нет подреза. **Мотор прикручен корпусом энкодера к задней стенке винтами М2 на Ø18** — справа, сверху, слева (мотор повёрнут на 45° от чертежа: снизу дырку закрывает задний полоз); по диагоналям — гнёзда под головки винтов корпуса энкодера. **Глубина винтов — одна цифра SCREW_IN** в скрипте: на сколько винт заходит в мотор; толщина стенки под головкой = длина винта − SCREW_IN. В боках клетки окна у корпуса энкодера — под разъём AS5048A и провода фаз. Полозья по ширине коробки и зазор у рейки 1.5 — как в исправленной тележке 102. Ось мотора 17.1 над столом, верх тележки 30.8 (у 2204 было 20 и 36.7). Генератор [gitara_motor2.py](https://github.com/Korvova/gitar/blob/main/2-0/gitara_motor2.py) — проверка зацепления по всему ходу ±22 и зазоров чистая; стол [103_stend_gb1806.3mf](https://raw.githubusercontent.com/Korvova/gitar/main/2-0/Print3mf/103_stend_gb1806.3mf), всё без поддержек; сцена [Стенд_GB1806.blend](https://raw.githubusercontent.com/Korvova/gitar/main/2-0/%D0%A1%D1%82%D0%B5%D0%BD%D0%B4_GB1806.blend)  | Проверить: сила безменом, ручной ход без тока, люфт шестерни по рейке, нагрев при удержании. Размеры в чертеже продавца могут не совпасть с мотором — до печати замерить: диаметр, длину, расположение дырок М2 и головок винтов корпуса энкодера, куда смотрит разъём. **Урок 2204 (19.9):** винты в неподвижную сторону — не глубже резьбы в её дырках (за ней выводы обмоток). До сборки замерить глубину дырок М2 и сопротивление фаз; мерить мультиметром три раза — из коробки, после винтов, перед драйвером | ⬜ Нарисован; ждёт моторы — замерить мотор и глубину резьбы (SCREW_IN), потом печатать 103 |
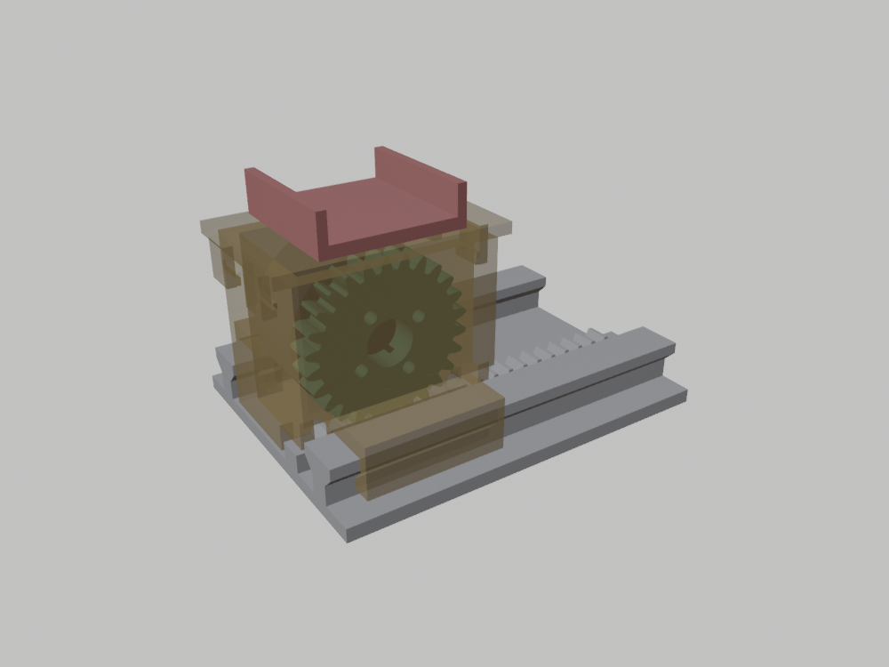
[picture p42: wiki/img/motor1_stend_2204.png]
Стенд 2204
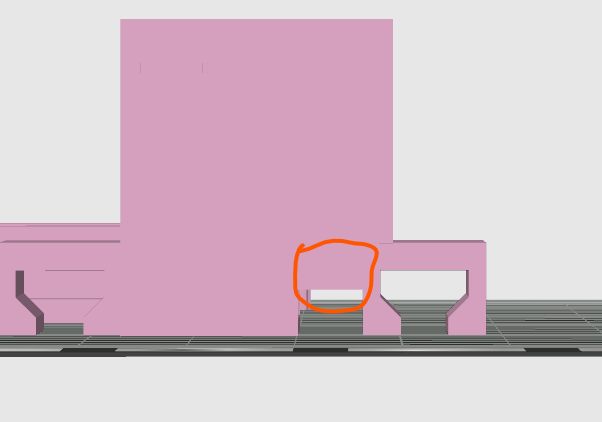
[picture p43: wiki/img/m1_telezhka_vhod_reiki.png]
Тесный вход на рейку
| 19.29 | Стенд одного пальца на гимбале 2204 (29.10) | Приехал гимбал 2204 260kV (Ø27.7 × 13; неподвижна сторона с проводами — на ней тоже дырки М2; крутится сторона с 4 × М2 на Ø12) и драйвер DRV8316 (SimpleFOC, 3PWM, 8–35 В). Стенд: мотор на ребре в тележке, **шестерня m1 z26** (Ø26 по делительной: мотор целиком выше рейки; 4 × М2 на Ø12 — внутри впадин зубьев) на крутящейся стороне, **рейка m1** поперёк — плита шириной грифа 52, зубья до самого края, на краях хода тележка выезжает за грань наполовину, тележка на двух **Т-рельсах с фаской** (не дают шестерне отжаться вверх, 19.5), ход ±22. **Тележка — клетка** (29.10, владелец): рама с полом под мотором, задней стенкой с клеевым кольцом и **окном под провода вниз**, боками и передней стойкой; сверху **крышка на 4 защёлках** — мотор с шестернёй вставляется сверху. Ложе клеится на крышку. Генератор [gitara_motor1.py](https://github.com/Korvova/gitar/blob/main/2-0/gitara_motor1.py) — с проверкой зацепления шестерни по рейке на всём ходу и зазоров; стол [101_motor_v_telezhke.3mf](https://raw.githubusercontent.com/Korvova/gitar/main/2-0/Print3mf/101_motor_v_telezhke.3mf), всё без поддержек (рама стоя, крышка крышей на стол); сцена [Стенд_мотор_в_тележке.blend](https://raw.githubusercontent.com/Korvova/gitar/main/2-0/%D0%A1%D1%82%D0%B5%D0%BD%D0%B4_%D0%BC%D0%BE%D1%82%D0%BE%D1%80_%D0%B2_%D1%82%D0%B5%D0%BB%D0%B5%D0%B6%D0%BA%D0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)  **29.10 напечатан и собран.** Что вылезло на сборке: (1) при нажатии пальцем тележка чуть заваливается и закусывает — полозья были ±12 при коробке ±16.8; (2) вход тележки на зубчатую рейку был тесный (зазор 0.5 мм над зубьями и перед рейкой) — при наклоне кромка цепляла зубья: владелец откусил её кусачками и смазал рельсы силиконовой смазкой — стало ходить хорошо.  Исправлено в модели: **полозья по ширине коробки ±16.8** (на краю хода опора на рельсе ~21 мм вместо ~16) и **зазор вокруг рейки 1.5 мм**; новая тележка — стол [102_telezhka_shire.3mf](https://raw.githubusercontent.com/Korvova/gitar/main/2-0/Print3mf/102_telezhka_shire.3mf) (только тележка, остальное прежнее) | Сборка: шестерню прикрутить к мотору 4 × М2 × 6 (головки утоплены), мотор с шестернёй опустить в клетку сверху, неподвижный торец прикрутить двумя винтами М2 × 6 по диагонали (в стенке радиальные прорези под 45° и 225° — подходят дырки мотора на расстоянии 11…19 мм; можно ещё капнуть клей) к кольцу Ø20 на стенке (обод мотора не касается — он крутится), провода — в окно вниз; защёлкнуть крышку; тележку надеть на рельсы с торца плиты. Сила ~37 мН·м/А / 13 мм ≈ **290 г на ампер**. Ось мотора 20 над столом, верх тележки 36.7 — для пробы; GB1806 вернёт гриф к 25. Закусывание — как ящик в комоде: люфт в Т-пазу (0.3 на сторону) даёт наклон, углы полоза упираются. Помогает длинный полоз, смазка; если мало — проба зазора паза 0.1 / 0.15 / 0.2 (паз печатается стоя, верх мостом — плотный может не пойти) | ⚠️ Механика ходит (со смазкой); мотор 2204 сломан (19.9) — тележку 102 не печатать, стенд переделать под GB1806 (19.16) |
| 19.17 | ~~Донор для пробы: стабилизатор Aochuan (12.10)~~ | ~~Б/у трёхосевой стабилизатор для телефона с Авито, 1500 ₽, оплата при получении — внутри три гимбал-мотора (ожидаемо Ø20–24). При получении проверить, что все три оси работают; перед разборкой — фото и замер каждого мотора. Крутить нашим драйвером: без датчика в режиме «как шаговик» (SimpleFOC) или с AS5600~~ | ~~Готовый стабилизатор за 7 тыс. ради мотора невыгоден — б/у донор за 1.5 тыс. даёт три мотора для пробы силы и ручного хода. Возможны упор поворота в рычаге и фирменные датчики — их не используем~~ | ❌ Заказ отменён 13.10 → 19.18 |
| 19.18 | ~~Донор для пробы: Zhiyun Smooth 4 (13.10)~~ | ~~Заказ Aochuan отменён — взамен Zhiyun Smooth 4 с Авито, 1500 ₽, продавец 4.9 / 62 отзыва, Авито Доставка с оплатой при получении. Трёхосевой, не складной — **три мотора**, у нескладных они обычно крупнее. Разборки с размерами моторов в сети не нашлось — мерить штангенциркулем. При получении проверить все три оси; до разборки прикинуть момент: на включённом стабилизаторе потянуть ось безменом на известном плече~~ | ~~Мотор может оказаться ~Ø28: тогда гриф ~30–31 мм вместо 25 — владелец согласен («для тренажёра не критично»); GB1806 (Ø22) потом вернёт 24–25 мм без переделки остального~~ | ❌ Моторы залиты в корпус стабилизатора — отдельно не вынуть |

## Этап 5. Платформа вдоль грифа и питание (14.10)

| Номер | Требование | Описание | Урок | Статус |
|---|---|---|---|---|
| 19.19 | Платформа с 4 тележками ездит вдоль грифа | Смена позиции (I … XII) — весь блок тележек едет вдоль грифа, ход ~290 мм. Платформа тащит всю кисть ученика — нужна сила в несколько ньютонов и удержание позиции, когда рука тянет назад | С мотором в тележке смена позиции стала простой: тележки самостоятельные, к деке их держат только провода (раньше ленты из деки привязывали тележки к месту). Шаг пальцев вдоль грифа меняется (I — 31–34 мм, XII — 16–18), но ложе ~25 мм вдоль грифа — пальцы сами сдвигаются внутри своих лож (решение владельца 13.10), раздвижка тележек не нужна | ✅ Решение |
| 19.20 | ~~Ремень GT2 / рейка / винт под платформой, моторы на платформе~~ | ~~Ремень GT2 вдоль грифа: обе ветви идут по всей длине — под платформой нужен слой ~7 мм (гриф 32–35). Два гимбала на платформе параллельно + длинная рейка: рейка тоже под платформой, ~+4 мм, плюс вес и нагрев от удержания руки. Винт вдоль грифа: держит позицию, но медленный и ученик сам руку не сдвинет. Магнитный стержень на 30 см — мало силы~~ | ~~В зоне платформы гриф по всей высоте занят моторами тележек — всё, что тянется по всей длине грифа, лезет под платформу и добавляет толщину~~ | ❌ |
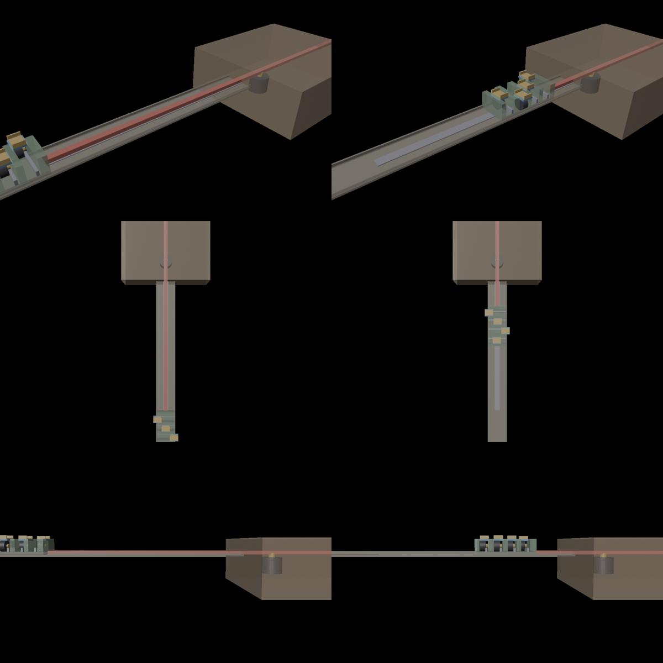
[picture p44: wiki/img/platforma_tolkatel_koncept.png]
Платформа и толкатель
| 19.21 | **Толкатель из деки** | От южного края платформы к деке идёт жёсткая зубчатая штанга (~10 × 6, рейка снизу) в своём канале по дну грифа; в деке мотор с шестернёй толкает и тянет её. Штанга живёт в грифе **перед** платформой, где пусто по всей высоте — **толщина грифа не растёт**. Когда платформа у деки (XII), хвост штанги уходит в корпус почти на 30 см — в корпусе 480 мм места хватает, но вдоль оси нужен свободный канал (не ставить туда электронику и узел струн). Мотор в деке — NEMA на нашей плате TMC2209: сила с запасом, держит позицию, без тока ученик двигает руку сам. Концепт:  Сцена [Гриф_платформа_толкатель.blend](https://raw.githubusercontent.com/Korvova/gitar/main/2-0/%D0%93%D1%80%D0%B8%D1%84_%D0%BF%D0%BB%D0%B0%D1%82%D1%84%D0%BE%D1%80%D0%BC%D0%B0_%D1%82%D0%BE%D0%BB%D0%BA%D0%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) (пробел — платформа ездит вдоль грифа, тележки «паучком»), скрипт [scene_platforma_tolkatel.py](https://github.com/Korvova/gitar/blob/main/2-0/scene_platforma_tolkatel.py) | Та же «лента-спица», что в приводе «палка», только одна, толще и на 290 мм; без канала-направляющей по всей длине выгнется при толкании. Владелец: «гриф чуть толще — не проблема», но толкатель толщину не трогает вовсе | ⚠️ Концепт |
| 19.22 | ~~Штанга-трубка везёт провода (идея владельца)~~ | ~~Штанга делается трубкой: например, алюминиевая квадратная 10 × 10 с печатной рейкой снизу — заодно жёсткая. Внутри трубки — провода к плате на платформе~~ | ~~Одна деталь решает и привод платформы, и проводку — отдельный шлейф вдоль грифа не нужен~~ | ❌ Заменено 14.10 → 19.25 |
| 19.23 | Электроника на платформе | На платформе маленькая плата: ESP32 + 4 драйвера FOC, датчики AS5048A тележек — к ней. Через трубку идут только **2 провода питания** 12 В (4 мотора ~2–4 А → AWG 20–22) и при желании 2 провода связи с платой в деке; можно и по радио (ESP-NOW / Bluetooth) — тогда только питание | Вместо двух десятков проводов от моторов и датчиков — 2–4 провода | ⬜ |
| 19.24 | В деке — «катящаяся петля» плоского шлейфа | От хвоста трубки к неподвижной электронике в деке — плоский шлейф петлёй в своём канале, как у головки принтера или сканера: петля перекатывается при ходе ~290 мм | Витой провод «как у телефона» тоже возможен (идея владельца), но в закрытом корпусе на 30 см хода цепляется и провисает; катящаяся петля рассчитана на миллионы ходов. Решение владельца 14.10: в деке — петля | ✅ Решение |
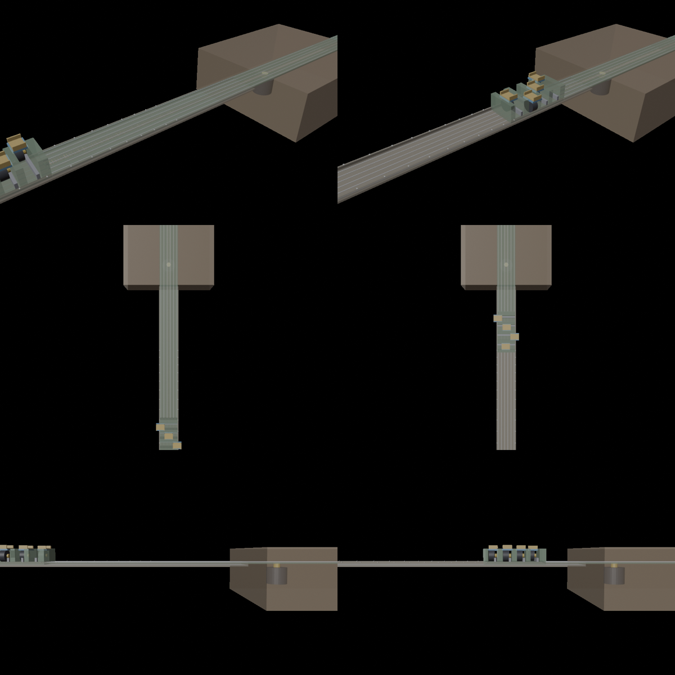
[picture p45: wiki/img/platforma_ploskij_tolkatel.png]
Плоский толкатель
| 19.25 | Плоский толкатель-накладка со струнами (идея владельца 14.10) | Толкатель — не штанга, а **плоская пластина на всю ширину грифа** (~48 × 2.5), края идут в пазах бортиков (иначе выгнется вверх при толкании), рейка снизу посередине. Сверху на пластине **нарисованы струны** — гриф позади платформы выглядит как настоящий. Перед платформой (к порожку) — плоское неподвижное дно грифа тоже со струнами, платформа проезжает над ним. **Лады — неподвижными метками на бортиках** (мензура 650), а не на пластине. Провода к плате на платформе — в плоском желобке под пластиной, трубка не нужна. Концепт:  Сцена [Гриф_платформа_плоский_толкатель.blend](https://raw.githubusercontent.com/Korvova/gitar/main/2-0/%D0%93%D1%80%D0%B8%D1%84_%D0%BF%D0%BB%D0%B0%D1%82%D1%84%D0%BE%D1%80%D0%BC%D0%B0_%D0%BF%D0%BB%D0%BE%D1%81%D0%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), скрипт [scene_platforma_ploskij.py](https://github.com/Korvova/gitar/blob/main/2-0/scene_platforma_ploskij.py) | Струны идут вдоль грифа — на движущейся пластине выглядят одинаково; лады на ней поехали бы вместе с рукой, поэтому лады — только на неподвижных бортиках. Вторая пластина спереди или шторка из ламелей, загибающаяся под гриф, отклонены владельцем: «выглядит как колхоз» | ⚠️ Концепт |
| 19.26 | Жёсткость грифа: ребро-клин снизу по центру (идея владельца 14.10) | Боковые стенки грифа в зоне хода платформы невозможны — тележки выезжают за край и занимают всю высоту. Жёсткость даёт **одно ребро снизу по центру**: в сечении «Т» (дно — шляпка, ребро — ножка). Ребро — **клин**: у головы ~3–5 мм (гриф почти 25), у деки ~20 мм (гриф ~40–45, как пятка гитары). Материал — алюминиевая полоса на ребро, срезанная по клину, или Т-профиль; сверху печатная плавная насадка-спинка. Оценка: нажатие 2.5 кг на конце грифа 45 см → прогиб ~1 мм. Основание платформы — алюминиевая пластина Д16Т 2 мм (~48 × 110), скольжение по полоскам PTFE | Гриф — консоль от деки: изгиб максимален у основания и почти ноль у головы, поэтому высота ребра нужна только у деки. У настоящей гитары гриф к деке тоже толстеет (~21 мм у 1-го лада → 23–24 у 12-го, дальше пятка) и расширяется (52 → ~62) — под рукой привычно. Отклонено: широкая труба 40×20 под всем дном — гриф везде +20 мм; стальной швеллер 50×10 — тяжёлый (470 г) и прогиб ~4.5 мм. Тренажёр — полноценная гитара, держится в руках как настоящая: подпорки грифа не годятся | ⚠️ Концепт |
| 19.27 | Вибрация — сам мотор тележки, без вибромотора | Вибрация показывает, где зажать палец. Плата держит позицию тележки и поверх подмешивает в ток мотора маленькие быстрые толчки (~150–250 Гц, доли миллиметра): тележка с ложем мелко дрожит на месте. Пример: тележка доезжает на 2 см и там вибрирует. Узоры: постоянная («сюда»), короткий «тук», «тук-тук», вибрация на ходу («веду сюда»), сильнее пока не дожал — стихает, когда зажал | Так делают ручки с «щелчками» на гимбал-моторах (проект SmartKnob). Ни отдельной таблетки-вибромотора, ни лишних проводов в тележке. Насколько отчётливо чувствует палец — проверить на стенде одного пальца | ⬜ Проверить на стенде |
| 19.28 | Зажатие пальца — две кнопки под концами рейки (идея владельца 15.10) | Рейка тележки лежит на двух концах, под каждым — мягкая тактовая кнопка (~50–100 г, обычные 160–250 г — тугие). Палец давит на ложе → тележка → рейка → кнопка; обе кнопки параллельно на один вход: нажалась любая — палец зажал. Ход рейки ~0.3 мм, тележка опускается вместе с ней — зацепление шестерни и рейки не меняется; без нажатия рейку поджимает пружина самой кнопки | Кнопки неподвижны на платформе — к тележке не нужен лишний провод. Одна кнопка под одним концом (рейка-рычаг) не годится: тележка у дальнего конца почти не жмёт. Две плёнки FSR (сумма = сила пальца) отклонены владельцем: щелчок кнопки — заодно подсказка ученику «зажал» | ✅ Решение |

## Этап 6. Тест стенда 2204 (29.10)

| Номер | Требование | Описание | Урок | Статус |
|---|---|---|---|---|
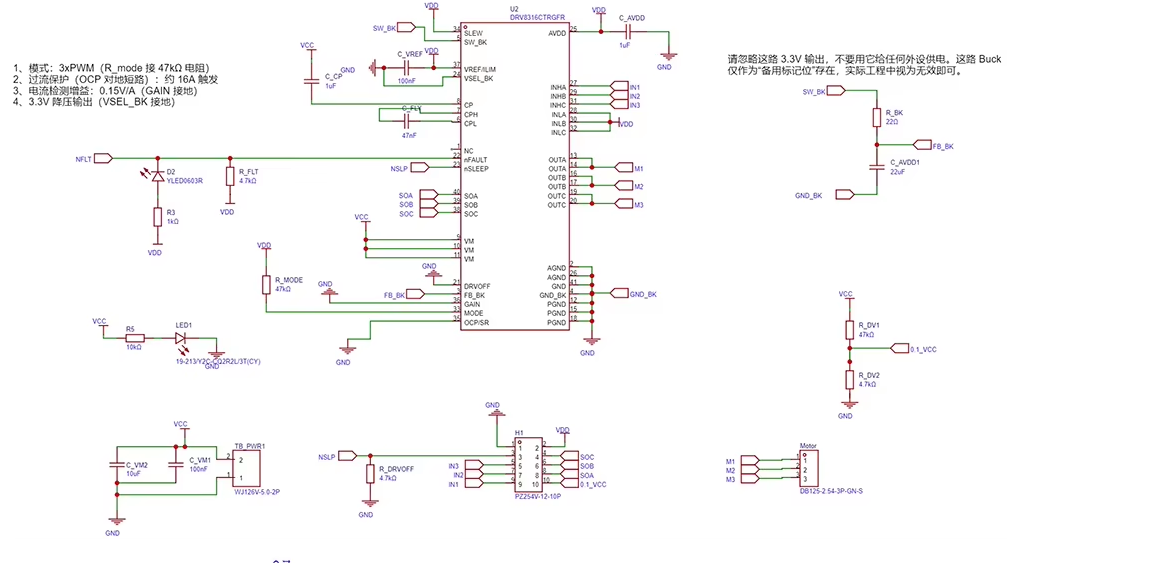
[picture p46: wiki/img/simplefoc_mini_v2_shema.png]
SimpleFOC Mini V2 схема
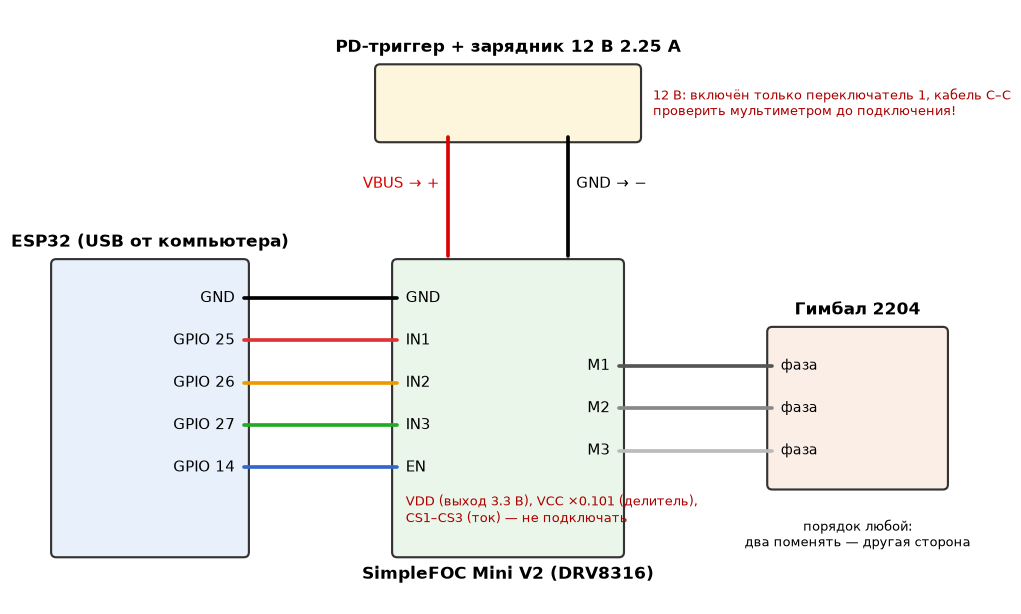
[picture p47: wiki/img/stend2204_podkluchenie.png]
Подключение стенда 2204
| 19.30 | Подключить драйвер к ESP32 и мотору | SimpleFOC Mini V2: **M1, M2, M3** — три провода мотора в любом порядке; **+ / −** — питание 12 В (19.31); **GND** — GND ESP32 (общая земля обязательна); **IN1 / IN2 / IN3** — GPIO 25 / 26 / 27; **EN** — GPIO 14. **VDD, VCC, CS1–CS3 не подключать.** По схеме продавца (ниже): **EN — это nSLEEP** DRV8316 (притянут к GND — без сигнала плата спит); **VDD** (на лицевой стороне «3V3») — выход 3.3 В самой микросхемы, есть только когда она проснулась; **VCC ×0.101** — делитель напряжения питания мотора для АЦП (при 12 В там ~1.2 В — это и намерили «1 В»); CS1–CS3 — выходы датчиков тока; режим 3PWM, INLA/B/C подтянуты к VDD. Светодиоды: **PWR** (жёлтый) — есть питание мотора, **FLT** (красный) — драйвер проснулся и видит ошибку. ESP32 — от USB. Схема платы:  Схема:  Скрипт схемы [render_stend2204_shema.py](https://github.com/Korvova/gitar/blob/main/tools/render_stend2204_shema.py) **04.11 — гимбал 2204 с Авито:** омметр 11 Ом между проводами — обмотки целые. Через SimpleFOC (прошивка пульта) мотор не шевелился, хотя позиция в прошивке менялась; проба с синусом прямо на IN1–IN3 ([motor1_sinus.ino](https://github.com/Korvova/gitar/blob/main/2-0/motor1_sinus/motor1_sinus.ino), ~3.6 В) — **крутится**. Значит, железо в порядке, а молчит библиотека SimpleFOC на нашей ESP32 (core 3.3.10, SimpleFOC 2.4.0) | Порядок фаз ничего не сжигает: поменять две местами — мотор крутится в другую сторону, это правится в прошивке (с датчиком SimpleFOC находит направление сам). Сжечь можно питанием: перепутать + и − или подать 12 В на логику. **30.10 — как искали, почему мотор не крутится:** (1) кабель — первый оказался только для зарядки, ESP32 не появлялась в системе, со вторым — COM7, мигалка залилась; (2) EN включён, красный FLT не горит — ошибки нет; (3) проба без SimpleFOC (синус прямо на IN1–IN3, [motor1_sinus.ino](https://github.com/Korvova/gitar/blob/main/2-0/motor1_sinus/motor1_sinus.ino)) — вольтметр на M1–M2 медленно «гуляет» до ~3 В: **драйвер работает**; (4) мультиметр на сопротивление между проводами мотора — обрыв во всех трёх парах → мотор (19.9). Урок: начинать с замера сопротивления фаз мотора — 30 секунд вместо вечера. **Подтверждение на другом моторе (30.10):** мотор квадрокоптера 1306 3000KV (19.7; обмотки ~0.1–0.2 Ом — поэтому всего 0.54 В, ток ~3–4 А, 15 с и драйвер сам засыпает): на 0.36 В дёргался туда-сюда, на 0.54 В и ~1.4 об/с **крутится ровно** — цепочка ESP32 → SimpleFOC Mini V2 → мотор работает. Прошивка [motor1306_sinus.ino](https://github.com/Korvova/gitar/blob/main/2-0/motor1306_sinus/motor1306_sinus.ino) | ✅ ESP32 и драйвер работают — проверено на моторе 1306; 2204 сломан |
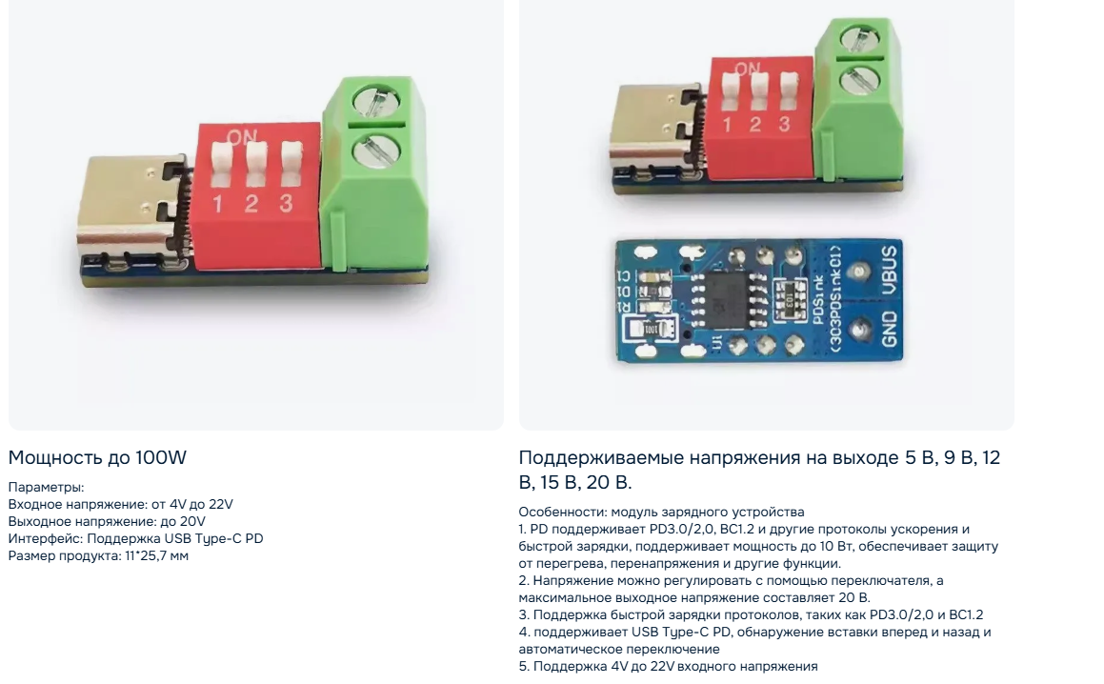
[picture p48: wiki/img/pd_trigger_ch224k.png]
PD-триггер
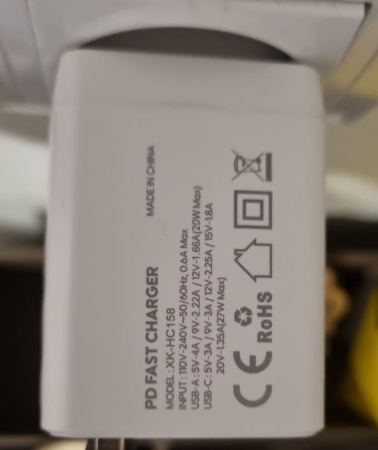
[picture p49: wiki/img/pd_zaryadnik_12v.png]
Зарядник 12 В
| 19.31 | Питание 12 В от USB-C зарядника | PD-триггер (CH224K, переключатели 1–2–3, клеммник VBUS / GND) + зарядник XK-HC158 (USB-C: 5 В 3 А / 9 В 3 А / **12 В 2.25 А** / 15 В 1.8 А / 20 В 1.35 А). **30.10 проверено:** 12 В (на клеммнике 11.67) — включён **только переключатель 1**; раскладка из справки CH224K (3 ON) к этой плате не подошла. Нужен кабель **USB-C ↔ USB-C** в порт USB-C зарядника: с кабелем от USB-A было 4.95 В при любых переключателях (порт USB-A даёт 12 В только по QC, триггер его не понимает). Переключатели читаются при включении — переключил, вынь и вставь кабель. VBUS → «+», GND → «−» платы.   | 12 В 2.25 А на один мотор 2204 — с большим запасом; для четырёх GB1806 (по ~0.7–1 А) — впритык, потом нужен блок 12 В 3–5 А | ✅ 12 В есть (30.10) |
| 19.32 | Мотор крутится: прошивка без датчика | ESP32 + библиотека SimpleFOC, режим без датчика (open loop, «как шаговик»): тележка ходит туда-сюда ±22, команды с компьютера. Ограничение напряжения в прошивке малое (единицы вольт), чтобы мотор не грелся. Потом — с датчиком угла AS5048A (замкнутый контур). **30.10 написано:** прошивка [motor1_fw.ino](https://github.com/Korvova/gitar/blob/main/2-0/motor1_fw/motor1_fw.ino) (команды: x мм, s мм/с, u В, on/off, z ноль, dir, p пары полюсов) и пульт [motor1_pult.html](https://github.com/Korvova/gitar/blob/main/2-0/websim/motor1_pult.html) через Web Serial в Chrome: положение ползунком и кнопками струн 1–6, «качели», сила и скорость; проба «просто крутись» [motor1_test.ino](https://github.com/Korvova/gitar/blob/main/2-0/motor1_test/motor1_test.ino) **04.11 переписана без SimpleFOC:** синус считает сама ESP32 и пишет в IN1–IN3 через ledc (20 кГц), EN — HIGH; команды те же, пульт работает как был. Проверено на гимбале 2204 с Авито: вал ходит туда-сюда ползунком и кнопками струн, держит положение, «качели» работают. Для режима с датчиком AS5048A (GB1806) FOC придётся писать своим кодом поверх этого синуса — или разобраться, почему молчит SimpleFOC | Владелец 29.10: прошивку — когда механика станет уверенной («сборка самое сложное») | ✅ Работает без датчика (свой синус, 04.11, гимбал 2204 с Авито) |
| 19.33 | Толкает ли палец: сила | Безмен на ложе, мотор держит позицию; мерить силу при разном токе. Ожидание по расчёту ~37 мН·м/А ÷ 13 мм ≈ **290 г на ампер**; цель — 300 г (19.6) | Без датчика (open loop) сила меньше, чем в FOC с датчиком — окончательную цифру мерить на GB1806 с AS5048A | ⬜ После 19.32 |
| 19.34 | Ручной ход без тока, люфт, нагрев | Без тока: двигает ли палец тележку легко, чувствуются ли «зубчики» магнитов; люфт шестерни по рейке (качнуть тележку при стоящем моторе); нагрев мотора при удержании позиции 5–10 мин |  | ⬜ После 19.32 |
| 19.35 | Вибрация самим мотором (19.27) | Подмешать в ток мелкие быстрые толчки 50–250 Гц: чувствует ли палец; какие частоты отчётливее; узоры «тук», «тук-тук», «стихает, когда зажал». Тем же мотором — щелчок «перескочил лад» и мягкая упругость «как струна» | Люфт пары шестерня–рейка может дребезжать на слабой вибрации — проверить, мешает или нет | ⬜ После 19.33 |

## Этап 7. Мотор неподвижен — передача тележки (05.11)

| Номер | Требование | Описание | Урок | Статус |
|---|---|---|---|---|
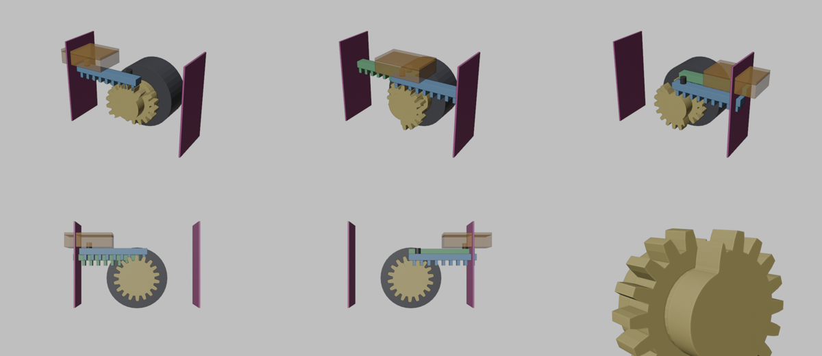
[picture p50: wiki/img/ulitka_lysaja_shesternja.png]
Шестерня-улитка
| 19.36 | Передача тележки с рейки на рейку: шестерня-улитка (идея владельца 05.11) | Задача та же, что у кассеты-телескопа и рольганга (04.11, хроника): **мотор неподвижен, тележка ходит ±24, ничего не торчит дальше тележки**. Мотор **боком** (ось вдоль грифа), на нём одна печатная деталь: фланец + **две шестерни m1 z18 рядом**, у каждой **половина круга с зубьями, дальше зубья плавно «садятся» и круг лысый** (радиус 5.6 вместо 10); у второй шестерни зубья и лысина повёрнуты наоборот. **Две рейки лежат сверху** (каждая на своей шестерне), у каждой **штырёк прямо на спине** — вверх в дырку тележки. Пока под рейкой зубья — рейка поднята, штырёк в тележке, рейка везёт тележку (А — левую половину хода, Б — правую). Пришёл лысый участок — рейка опускается на 2.4 мм, штырёк выходит из тележки, рейка стоит на месте; в середине хода ~3 мм тележку везут обе. Угол вала однозначно задаёт место тележки (весь ход < оборота), поэтому стоящая рейка при возврате попадает зубьями туда, где её оставили — без удара «зуб в зуб». Сцена [Идея_улитка_лысая_шестерня.blend](https://raw.githubusercontent.com/Korvova/gitar/main/2-0/%D0%98%D0%B4%D0%B5%D1%8F_%D1%83%D0%BB%D0%B8%D1%82%D0%BA%D0%B0_%D0%BB%D1%8B%D1%81%D0%B0%D1%8F_%D1%88%D0%B5%D1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) (пробел), скрипт [scene_ulitka_lysaja.py](https://github.com/Korvova/gitar/blob/main/2-0/scene_ulitka_lysaja.py)  | Нужны: пружинка/резинка, прижимающая рейку к шестерне (гитару держат боком — вес не прижмёт), и лёгкий фиксатор стоящей рейки (лысый круг крутится под ней и может тащить трением). Что перебрали по дороге: отдельные кулачки-улитки рядом с шестернями (лишние детали); рейки снизу — длинный штырёк через всю шестерню; рейки сверху со штырьком вбок в крючки тележки — сложно; мотор плашмя (два этажа) — работает, но вдоль грифа ~30–33 мм, больше шага пальцев 24–26; удвоитель с одной шестерёнкой и ремень — рейка тележки 28 мм, выходит за тележку (владелец: «не нравится, что выходит лишнее»); овальные шестерни — скорость и глубина зацепления скачут. Выбрано владельцем: мотор боком, рейки сверху, штырёк на спине | 💤 Запасной — если рольганг (столы 108/109) пойдёт туго в свободном ходе |
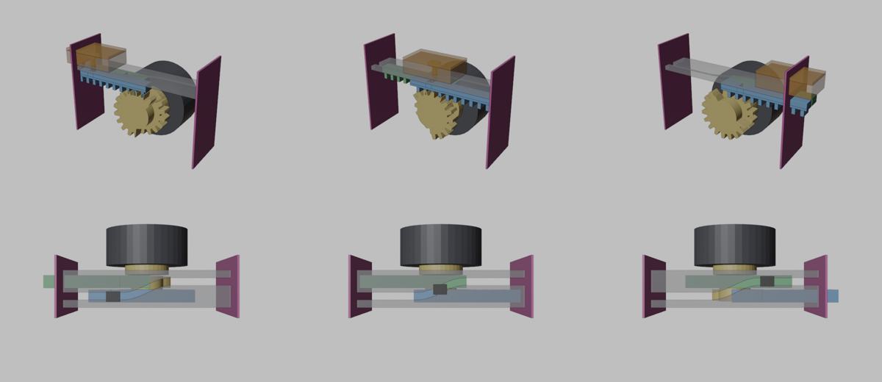
[picture p51: wiki/img/ulitka_kopir.png]
Копир
| 19.37 | Шестерни-улитки + копир: рейки не поднимаются (05.11) | Развитие 19.36 (идея копира — из ответа другого ИИ, «встречные рейки со скользящим зацепом»). Та же деталь на моторе (мотор боком): две шестерни, у каждой половина с зубьями, половина лысая; рейки сверху. **Рейки по высоте не двигаются**: на лысом участке рейка просто стоит, зубья ни за что не цепляют — **пружинки не нужны**. В спине каждой рейки **выемка**, открытая в сторону соседней рейки. Над рейками — **неподвижная пластина-копир с пазом**: над рейкой А — прямо, в середине хода — **плавная S-дуга (~25° в самом крутом месте)**, дальше — над рейкой Б. У тележки **один штырёк**: внизу сидит в выемке рейки, проходит сквозь паз копира, вверху — на **ползунке в поперечном Т-пазу тележки** (паз держит штырёк по ходу — так штырёк толкает тележку, а поперёк пускает). Тележка едет — штырёк идёт по пазу; на S-дуге паз сам переводит его вбок из выемки А в выемку Б (в зоне ±7 обе шестерни с зубьями, обе рейки едут вместе — выемки стоят друг напротив друга). Обратно — так же. Сцена [Идея_улитка_копир_25.blend](https://raw.githubusercontent.com/Korvova/gitar/main/2-0/%D0%98%D0%B4%D0%B5%D1%8F_%D1%83%D0%BB%D0%B8%D1%82%D0%BA%D0%B0_%D0%BA%D0%BE%D0%BF%D0%B8%D1%80_25.blend) (пробел; камера «сверху» — видно паз), скрипт [scene_ulitka_kopir.py](https://github.com/Korvova/gitar/blob/main/2-0/scene_ulitka_kopir.py)  | Угол паза: до 30° штырёк идёт мягко, 45° туго, после ~60° может заклинить. Против закусывания на «перекрёстке»: дуги на входе и выходе вместо изломов; фаски 0.5 × 45° на входе в выемки; щель между рейками ~0.5 мм; паз шире штырька на 0.2–0.3; штырёк — стальной пруток или латунная трубка-ролик, смазка силиконом. Фиксатор стоящей рейки по-прежнему нужен. Высота +2 мм к 19.36 (пластина-копир) | 💤 Запасной — лучше 19.36 (без пружин); если рольганг (108/109) пойдёт туго |

## Этап 8. Мотор плашмя в тележке (06.11)

| Номер | Требование | Описание | Урок | Статус |
|---|---|---|---|---|
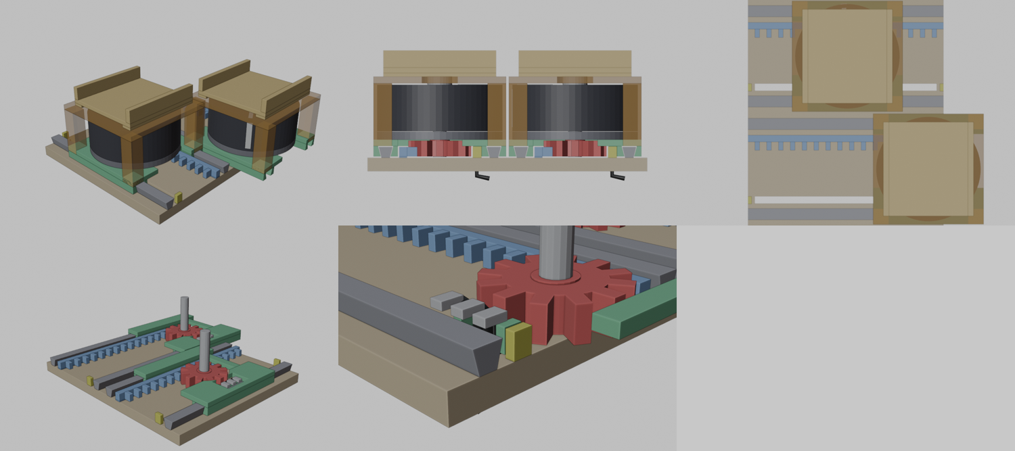
[picture p52: wiki/img/plashmya_nizkij.png]
Мотор плашмя, низкий вариант
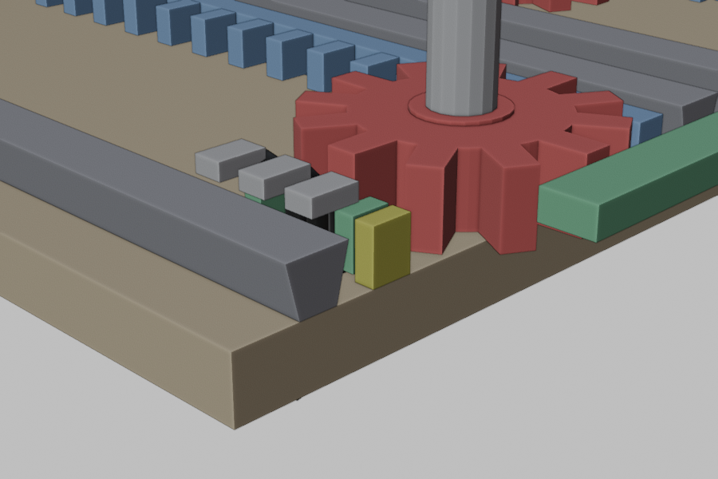
[picture p53: wiki/img/plashmya_nizkij_upor.png]
Упор под шестернёй
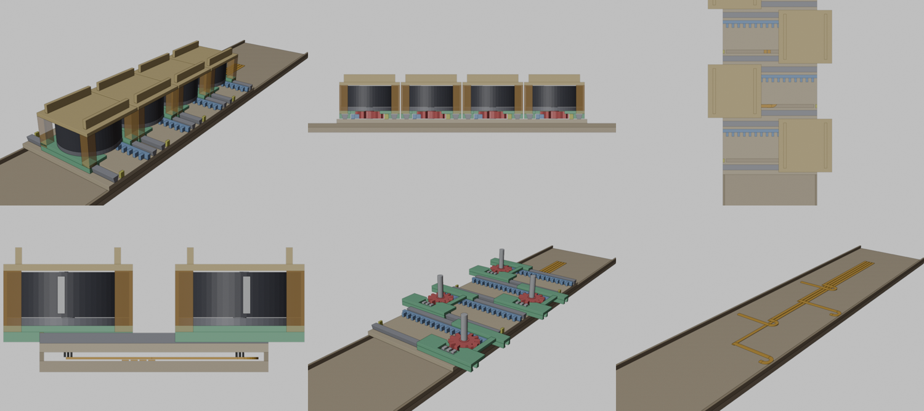
[picture p54: wiki/img/grif_plashmya_itog.png]
Итоговая схема
| 19.38 | Мотор плашмя, низкий вариант (06.11) — **задание: подготовить файлы на печать** | Идея владельца: тележка снова едет вместе с мотором, но мотор **лежит плашмя** и шестерня стоит **сразу на выходе**, в одном слое с рейкой и рельсами. Развитие стола 112 ([plashmya_2204.py](https://github.com/Korvova/gitar/blob/main/2-0/kasseta/plashmya_2204.py)): там между шестернёй и мотором пластина тележки 3 мм и рельсы на y ±17 (шире шага); здесь пластины нет, рельсы на y ±12. **Высоты (Z, 0 — верх плиты; плита стенда 2 мм — владелец печатал такую, крепкая; в сцене нарисована 3):** шестерня и рейка от 0.3; верх рейки 2.4, верх шестерни 3.8; рельсы 0…2.4 (ласточкин хвост: половина ширины 0.9 внизу, 1.5 вверху); плашки 2.6…4.0; мотор 2204 Ø27.8 × 12.23 — 4.0…16.2; крышка 16.5…18.0 с дыркой Ø8 под головку винта; ложе: дно 18.8…20.0, борта до 23.8. В сцене так; **на печать — по бюджету 06.11 ниже** (крышка и дно ложа — одна деталь, винт без головки). **Оси:** X поперёк грифа, ход ±22; Y вдоль; тележка X, Y ±14.7 (29.4, шаг 30 проходит с зазором 0.6). **Детали:** (1) **плита** 52 × длина с рельсами на y ±12 и рейкой m1: зубья y 5…7.25, тело 7.25…9, длина ±26; прорезь под провода x ±24.2, y −9.15…−7.25 насквозь; (2) **упоры** у края плиты x ±25.05…26, y −9.25…−7.3, высота 2.5 — лучше заодно с плитой; (3) **тележка одной деталью или склейкой:** 4 угловые стойки x, y от 10.6 до 14.7, z 2.6…16.5; задняя плашка y −14.7…−5 с круглым вырезом R7.5 и вырезом x ±4.5, y −13…−7 под пайку; передняя плашка y 9.3…14.7; **перемычка над рейкой** x 8…10.6, y −5…9.3; лапы ласточкина хвоста вокруг обоих рельсов z 0.3…2.6, зазор как на столе 112; **две щёчки упора** на внутренней задней лапе x ±(2.05…3), y −9.3…−7.45, z 0.3…2.6 — при x = ±22 упираются в упоры, между ними проходят провода; крышка с ложем; (4) **шестерня** m1 z12, z 0.3…3.8, ступица Ø4.4 до внутреннего кольца подшипника, квадрат 2.6 под винт как на столе 112. **Крепёж:** шпилька **М3** без головки (длина ~16, в сцене нарисован винт с головкой) сквозь трубку мотора Ø3 (трубка крутится с корпусом, проверено владельцем), вкручена в шестерню, с клеем. **Дно мотора приклеить** к плашкам (эпоксидка или гель): отверстия М2 на ~Ø12 закрыты шестернёй радиусом 7, винтами не прикрутить. Мотор повёрнут пайкой к −Y; провода вниз в прорезь (шаг внизу 1.25, родные Ø1 впритык, тонкие силиконовые свободнее). **Сцена** [Стенд_2204_плашмя_низкий.blend](https://raw.githubusercontent.com/Korvova/gitar/main/2-0/kasseta/%D0%A1%D1%82%D0%B5%D0%BD%D0%B4_2204_%D0%BF%D0%BB%D0%B0%D1%88%D0%BC%D1%8F_%D0%BD%D0%B8%D0%B7%D0%BA%D0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) (пробел; две тележки с шагом 30), скрипт [scene_plashmya_nizkij.py](https://github.com/Korvova/gitar/blob/main/2-0/kasseta/scene_plashmya_nizkij.py) — в сцене только концепт, размеры брать оттуда.   **Итоговая схема грифа** (24.5 мм: основание, щель с петлями проводов, платформа, 4 тележки с шагом 30, шпилька без головки, крышка = дно ложа; пробел — тележки ходят, платформа едет вдоль основания): [Гриф_плашмя_итог.blend](https://raw.githubusercontent.com/Korvova/gitar/main/2-0/kasseta/%D0%93%D1%80%D0%B8%D1%84_%D0%BF%D0%BB%D0%B0%D1%88%D0%BC%D1%8F_%D0%B8%D1%82%D0%BE%D0%B3.blend), скрипт [scene_grif_plashmya_itog.py](https://github.com/Korvova/gitar/blob/main/2-0/kasseta/scene_grif_plashmya_itog.py)  **Порядок работ (владелец 06.11): сейчас только нормальное перемещение тележки; режим «сам» и датчик положения — потом, навешиваются позже (19.40). В эту печать карман под датчик, магниты и планку не закладывать.** **Что сделать (другому ИИ):** новый генератор на build123d по образцу plashmya_2204.py (зубья, зазоры C_G, профили рельсов — оттуда), проверка хода ±22 и зазоров, детали без поддержек, следующий свободный стол (**114**) в make_3mf.py, сцена, строка здесь и в хронике. Для стенда плиту поставить на ножки, чтобы провода свисали. | Сила ~630 г/А (37 мН·м/А ÷ 6 мм). В сцене столкновений нет на всём ходу, пересекаются только зубья и то, что входит в дно мотора. **Не мерили на железе:** наружный диаметр внутреннего кольца подшипника (по фото ~4.5). **Риски:** зуб работает по ширине 2.1 мм (рейка понижена ради перемычки) — на рывках близко к пределу пластика; лапы и плашки тонкие (1–1.4 мм), могут разойтись под пальцем; упор 1 × 1.9 мм только страховка — в прошивке останавливать раньше; клей на дне — мотор потом трудно снять. На крайней струне шестерня выходит за плиту на 3 мм, тележка — на ~11 мм. Прорезь оставляет 1.8 мм плиты у краёв. В настоящем грифе петле проводов нужен лоток под плитой ~1–1.5 мм (тонкие силиконовые или FFC), стоя петля заняла бы 5–10 мм. Плита там едет вдоль неподвижного дна грифа; решение владельца 06.11: **дно — авиафанера 2 мм** (20.8), плита 2 мм (или алюминий 1 мм: печатная 1 мм порвётся у прорези, края 1.8). **Цель — гриф как можно тоньше, ужиматься везде, где разумно. Бюджет высоты (владелец 06.11):** основание грифа 2.5 (к платформе не относится, она по нему скользит) + щель под провода 2 + платформа 2 + слой лыж и шестерни 4 + мотор 12.2 + зазор 0.3 + крышка 1.5 = **~24.5 мм**. Для этого: **крышка = дно ложа, одна деталь 1.5 мм** (борта ложа сверху); **вместо винта с головкой — шпилька М3 без головки** (или винт со спиленной головкой): вклеена в трубку и вкручена в шестерню, над мотором ничего не торчит. **Датчика положения пока нет (решение владельца 06.11, придумает позже иначе):** прошивка без датчика на своём синусе (19.32) его не требует; над мотором под него места не оставляем. Сила без датчика ниже расчётной, мерить на стенде (19.33). Рольганг владелец собрал 06.11: «работает отстойно» — поэтому возврат к мотору в тележке | Основа механики; печатаем 19.43 |
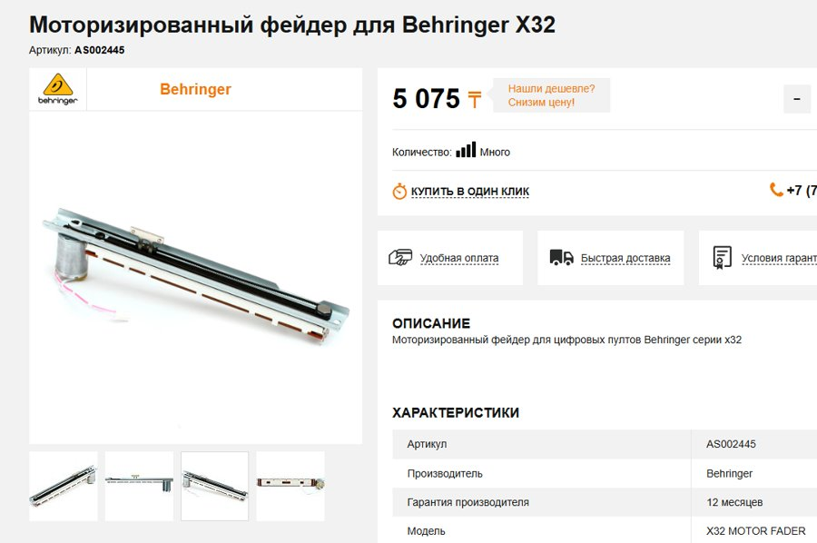
[picture p55: wiki/img/motor_fader_x32.jpg]
Моторизированный фейдер Behringer X32
| 19.39 | Заметка: моторизированный фейдер с ремешком (06.11) | Идея владельца — посмотреть на устройство фейдера микшерных пультов (пример: Behringer X32 Motor Fader, 5 075 ₸): на торце маленький мотор постоянного тока, вдоль всей длины — **ремешок**, он тянет ползунок; положение читается **резистивной дорожкой** того же ползунка. Всё в одной плоской узкой детали, это серийный узел, который сам ездит в заданное положение и которым можно двигать рукой.  | Чем интересно: ремешок без шестерён — свободный ход лёгкий и нет зубьев; ползунок едет сам и даёт положение (режим «сам» решён сразу, 19.32–19.33). Что проверить: длина (ход 44 мм + мотор на торце; у пультовых фейдеров ход обычно около 100 мм и мотор выступает — в гриф 52 мм готовый не войдёт, значит, брать только сам принцип), сила ремешка и маленького мотора (нужно 300 г на пальце), трение ползунка по дорожке. Цифры по длине не мерили | 💡 Заметка |
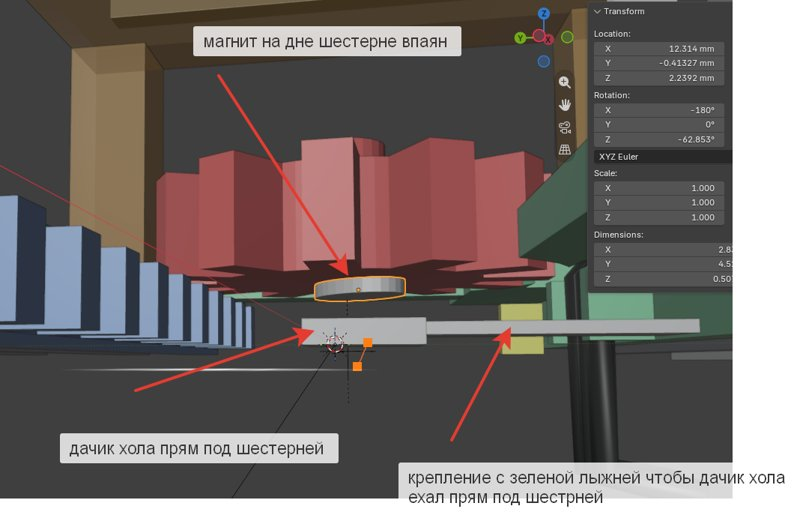
[picture p56: wiki/img/hall_pod_shesternej.jpg]
49E под шестернёй
| 19.40 | Заметка: положение для режима «сам» — 49E на тележке, магниты в плите под струнами (идея владельца 06.11) | Для режима «сам» (мотор отпущен, ученик двигает палец, Т. Положение тележек) нужен датчик; в режиме обучения положение считается по шагам от упора (6.1). Нужно знать только **на какой из 6 струн палец**. На тележке **один датчик Холла 49E** на планке от лыжи (владелец: 49E на опытах работает лучше), смотрит вниз. В плите **под каждой струной магнит** (шаг 8.8, 6 на тележку, 24 всего). **Каждая струна отличается полярностью и высотой магнита:** N/S чередуются, три глубины дают три силы: N близко, S близко, N средне, S средне, N далеко, S далеко — соседние всегда разной полярности, между ними чистый переход через ноль. Датчик показывает струну сразу после включения, без упора и подсчёта; 3 провода на тележку. Таблицу значений записать при калибровке: мотор сам проезжает все струны и запоминает значения (как 6.5), потому что соседние магниты вносят поправку. Первый вариант (магнит в шестерне, два 49E под 90°) отложен: шестерня за ход делает ~1.17 оборота, нужен угол, сложнее.  | Место: под шестернёй зазор 0.3, сбоку полоска 2 мм занята прорезью для проводов. Вариант: карман в плите глубиной ~1.2 мм от прорези под шестерню, вдоль всего хода — датчик на планке едет в нём; магниты клеятся снизу плиты (остаток 0.8) в щель для проводов 2 мм: зазор до датчика ~1–2 мм, магнит опускают проставкой. **Не проверено:** различаются ли шесть значений с запасом. Быстрая проба: картонка с 6 магнитами через 8.8 разной полярности и высоты, вести 49E рукой, смотреть на пульте (стенд 15.09: шум ±1.5). Запасные: 4 × 49E на плите, два оптодатчика на зубьях | 💡 Решение найдено, делаем позже: сначала перемещение (19.38) |
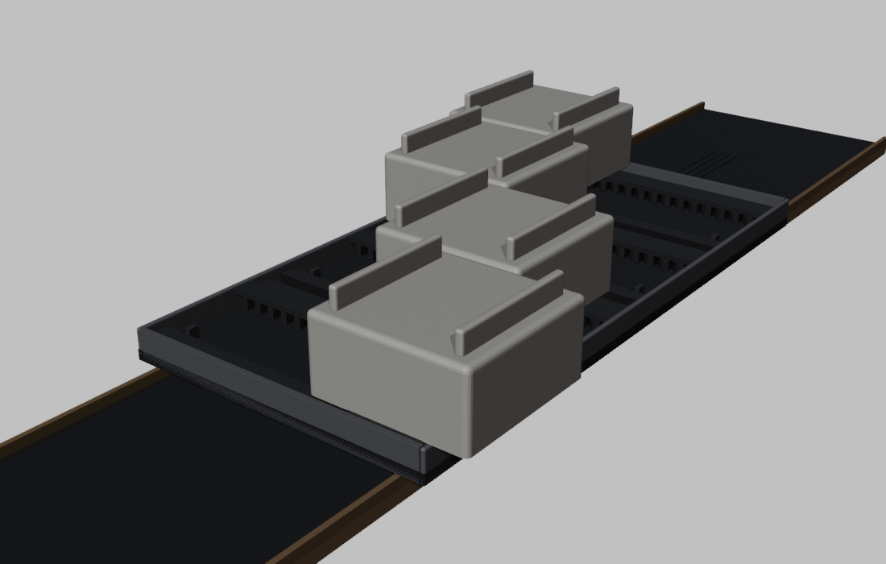
[picture p57: wiki/img/grif_vannochka.png]
Ванночка и кубики
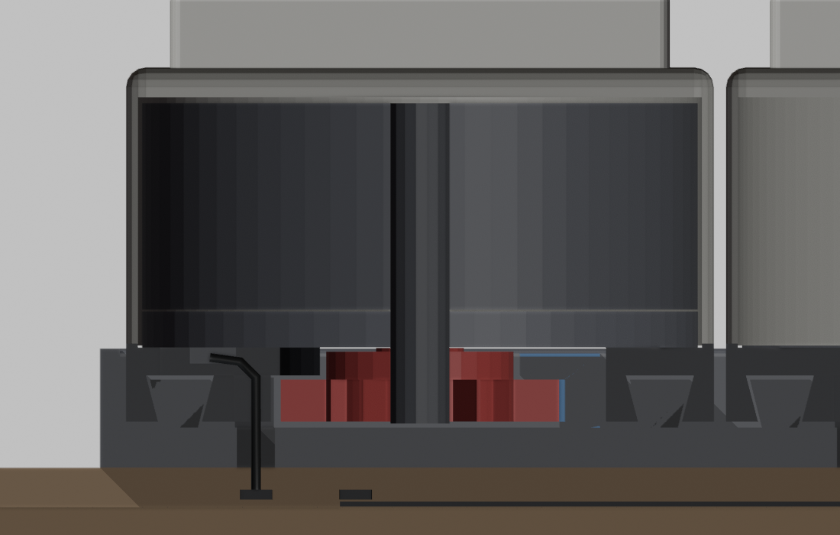
[picture p58: wiki/img/grif_vannochka_razrez.png]
Разрез: шестерня красная, рейка синяя
| 19.41 | Внешний вид: ванночка, кубики, рейка с крышкой (06.11) — **эту версию владелец печатает и собирает дома, на одну тележку; задание: подготовить файлы на печать** | Механика из 19.38, но механизм спрятан: снизу неподвижная ванночка, сверху ездят только закрытые кубики. Все размеры ниже заменяют соответствующие в 19.38, остальное оттуда. **Оси:** X поперёк грифа, ход ±22; Y вдоль; Z = 0 — верх платформы. **(1) Ванночка:** дно 2 мм, бортики x ±(29.3…30.3), верх 3.95, ширина снаружи 60.6; гриф остаётся 52, ванночка выступает над ним на 4.3 с каждой стороны. Рельсы y ±12 и рейка идут от бортика до бортика (±29.3). Упоры и прорезь под провода как в 19.38. **(2) Рейка с крышкой:** зубья y 5…7.25 и тело 7.25…9 по z 0.3…2.4, как раньше; над телом стенка до z 3.7; крышка над зубьями y 5…7.25, z 2.6…3.7 (1.1 мм). Зазор зубья — крышка 0.2, крышка — дно мотора 0.3. Сверху зубья закрыты; низко со стороны шестерни их немного видно. **(3) Шестерня:** m1 z12, зубья z 0.3…2.4 (ширина как у рейки, сила не меняется: верх шестерни и в 19.38 с рейкой не работал); выше гладкий цилиндр Ø9.4 до z 3.8, он проходит в 0.3 мм от края крышки; ступица Ø4.4 и квадрат 2.6 как в 19.38. **(4) Низ тележки ±7:** лапы и плашки укорочены по X до ±7 (на краю хода 22 + 7 = 29, зазор до бортика 0.3); плашки z 2.6…4, задняя y −14.7…−5 с вырезами R7.5 и x ±4.5 под пайку, передняя y 9.3…14.7; щёчки упора как в 19.38; перемычки над рейкой нет. Язычки y ±(14.1…14.7), x ±7, z 4…4.2 соединяют низ с кубиком. **(5) Кубик:** x, y ±14.7, z 4.1…18 (низ над бортиком, зазор 0.15), рёбра и верх скруглены R1, снизу полость Ø28.2 до z 16.5 (зазор до мотора 0.2, самая тонкая стенка 0.6). Крышка 1.5 = дно ложа, борта ложа x ±(10.5…12), y ±12.5 до z 21.8. Высота та же: **24.5 мм** до крышки. **(6) Цвет — чтобы прятать механику:** кубик светлый; ванночка, рейка, рельсы, упоры, низ тележки и шестерня матово-чёрные. Прорезь оставляем (решение владельца 06.11): провода и шлейф чёрные, на основании под платформой чёрная плёнка, щель читается как тёмная линия. **Сцена** (4 тележки, пробел — анимация): [Гриф_ванночка.blend](https://raw.githubusercontent.com/Korvova/gitar/main/2-0/kasseta/%D0%93%D1%80%D0%B8%D1%84_%D0%B2%D0%B0%D0%BD%D0%BD%D0%BE%D1%87%D0%BA%D0%B0.blend), скрипт [scene_grif_vannochka.py](https://github.com/Korvova/gitar/blob/main/2-0/kasseta/scene_grif_vannochka.py).   **Что сделать (другому ИИ):** стенд на **одну тележку**: ванночка y ±16 с торцами, плита на ножках, чтобы провода свисали (датчика нет, карман под него не закладывать, 19.40). Генератор на build123d по образцу [plashmya_2204.py](https://github.com/Korvova/gitar/blob/main/2-0/kasseta/plashmya_2204.py) (зубья, зазоры, профили рельсов оттуда), проверка хода ±22 и зазоров, стол **114** в make_3mf.py, строка здесь и в хронике. **Разбить на детали так, чтобы собиралось:** рельсы и шестерня с рейкой под крышкой заводятся только с торца, поэтому **один бортик съёмный или клеится последним**; рейку с крышкой печатать отдельно на спине (зубья без поддержек) и клеить в ванночку; низ тележки и кубик — отдельные детали, склейка по язычкам. **Порядок сборки:** шпилька в мотор → шестерня на шпильку → мотор в кубик снизу, провода в вырез → низ тележки приклеить к кубику, дно мотора к плашкам → завести тележку с открытого торца → закрыть бортик. | В сцене столкновений нет на всём ходу; пересекаются только зубья и то, что входит в дно мотора. **Железо ещё не проверено. Риски:** лапы короткие (28→14 мм по X) — тележку может подклинивать, проверить первым делом; площадка приклейки мотора стала намного меньше, без перемычки низ держится только через кубик; стенка 0.6 и зазор 0.2 у мотора могут задевать (если задевает — шлифовать или шаг тележек больше 30); зазоры 0.2–0.3 у крышки на грани точности FDM. Ход и ширина: мотору с ходом 44 нужно 72 мм, поэтому кубик на краю всё равно выходит за бортик на 6.4 мм. Открытыми сверху остаются рельсы и прорезь. Ванночка шире грифа (60.6 против 52) | Не печатаем: выбран 19.42 |
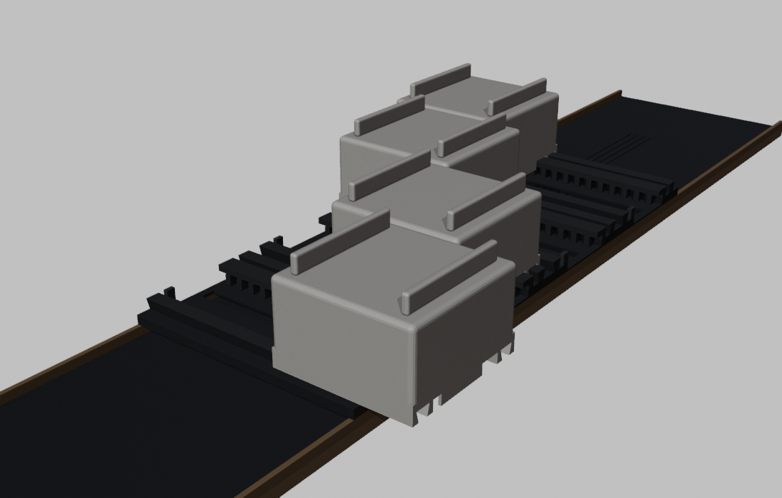
[picture p59: wiki/img/motor_perevernut.png]
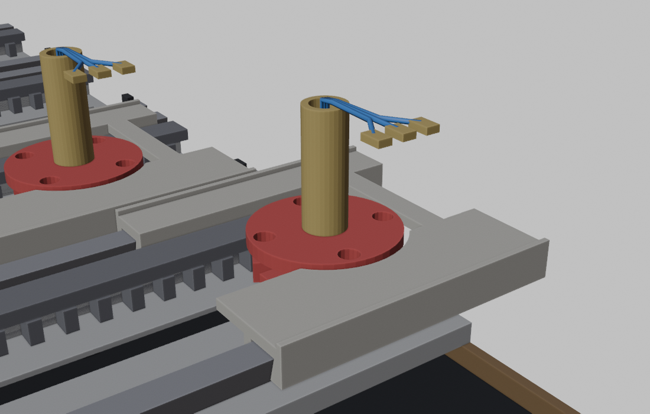
[picture p60: wiki/img/motor_perevernut_put.png]
Без кубика и корпуса: провода синие, трубка жёлтая, шестерня красная
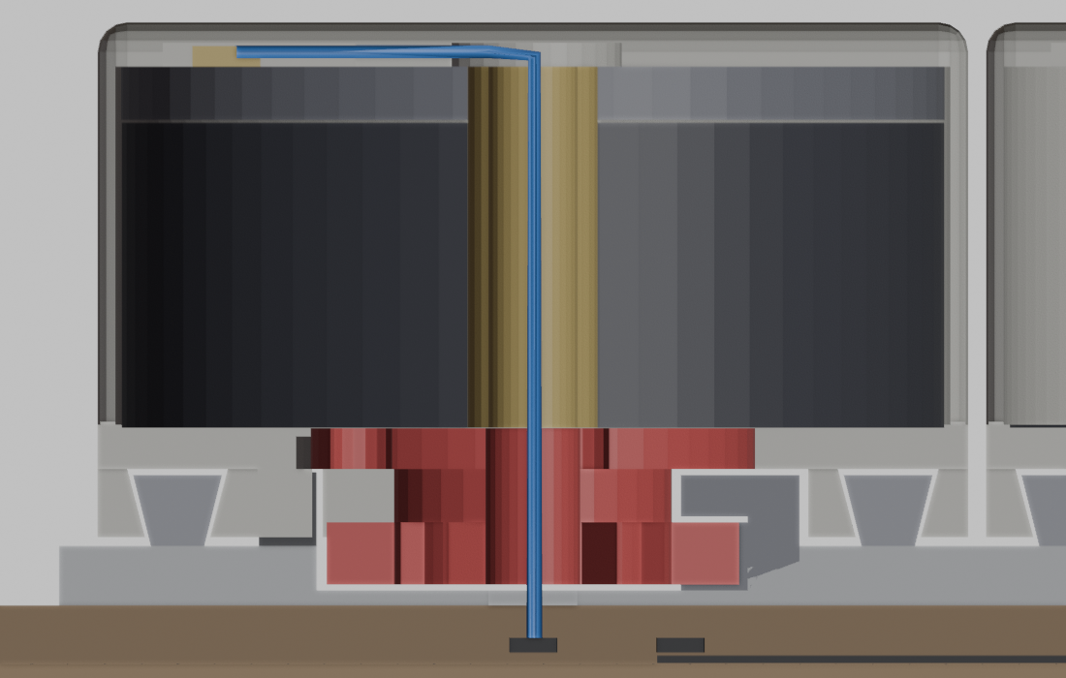
[picture p61: wiki/img/motor_perevernut_razrez.png]
Разрез
| 19.42 | Мотор перевёрнут, провода через его трубку (06.11) — **эту версию владелец печатает и собирает дома, на одну тележку; задание: подготовить файлы на печать** | Идея владельца. Мотор лежит плашмя, но **перевёрнут**: неподвижная часть с пайкой вверху, крутящийся торец корпуса внизу. Провода от пайки сразу идут в центральную трубку мотора и выходят из центра полой шестерни в щель. Трубка поворачивается примерно на ±210° вокруг неподвижных проводов, провода не скручиваются. Шпилька М3 и латунная трубка не нужны. Заменяет на печати 19.38 и 19.41; бортика и ванночки нет. **Оси:** X поперёк грифа, ход ±22; Y вдоль; Z = 0 — верх платформы. Шаг тележек 30, ширина **52 мм**, высота **24.2 мм** (от низа основания до верха крышки, без бортов ложа). **(1) Платформа одной деталью, 52 × длина, толщина 2:** рельсы — ласточкин хвост y ±12, z 0…2.4, половина ширины 0.9 внизу и 1.5 вверху, x ±26. **Паз** поперёк: y −7.3…7.25, дно z −1.5 (остаётся 0.5), концы открыты, потому что шестерня на краю хода выходит за плиту на 3 мм. На стенке +Y зубья m1: y 5…7.25, z −1.5…0.8. За ними стенка y 7.25…9 до z 2.4, над зубьями крышка y 5…7.25, z 1.0…2.4 (зазор до зубьев шестерни 0.2). **Щель под провода** в дне паза: y ±1.5, x ±24.2, насквозь. Упоры x ±25.05…26, y −9.25…−7.3, z 0…2.5. **(2) Шестерня с фланцем одной деталью, полая Ø3.2:** зубья m1 z12, z −1.3…0.8; шейка Ø9.4, z 0.8…2.6; фланец Ø15, z 2.6…3.98, 4 отверстия Ø2.1 на Ø12 под М2 крутящегося торца. Фланец клеить на торец на эпоксидку; винты М2 — только страховка и **не глубже 1.5 мм в мотор** (так сгорел первый 2204). **(3) Мотор 2204 Ø27.8 × 12.2:** корпус z 4…14.3, неподвижная часть z 14.4…16.2 приклеена к крышке, пайка к −Y. **(4) Тележка:** x, y ±14.7. **Кубик** z 4.1…17.7, рёбра и верх скруглены R1, снизу полость Ø28.2 до z 16.2 (стенка в самом тонком месте 0.6). **Крышка** 1.5 = дно ложа, в её низу до z 17: карман под пайку x ±4, y −12.5…−6; канавка под провода x ±1.2, y −9…0; карман Ø6 над трубкой (над ними остаётся 0.7). Борта ложа x ±(10.5…12), y ±12.5 до z 21.5. **Низ тележки** к мотору не приклеен, держится через стенки кубика: плашки z 2.6…3.7 (зазор до корпуса 0.3), задняя y −14.7…−5 с вырезом R8 под фланец, передняя y 9.3…14.7, перемычка x 8…10.6, y −5…9.3; лапы вокруг обоих рельсов z 0.3…2.6, длиной x ±14.7, зазор как на столе 112; щёчки упора x ±(2.05…3), y −9.3…−7.45, z 0.3…2.6, при x = ±22 упираются в упоры. **Боковая юбка** x ±(14.1…14.7): z 2.6…4.2 по всей длине y; z 0.3…2.6 при y −7.1…4.7, закрывает шестерню сбоку. **(5) Провода:** три фазы, тонкие и скользкие (МГТФ 0.07–0.12). Под ними плоская катящаяся петля в щели 2 мм, как в 19.38. **Через эту же трубку потом можно вывести и провода кнопки** (мысль владельца): пять проводов Ø0.6 по расчёту проходят в Ø3. **(6) Цвет:** кубик светлый; платформа, рейка, рельсы, упоры матово-чёрные; провода чёрные, на основании под платформой чёрная плёнка. **Сцена** (4 тележки, пробел — анимация): [Гриф_мотор_перевёрнут.blend](https://raw.githubusercontent.com/Korvova/gitar/main/2-0/kasseta/%D0%93%D1%80%D0%B8%D1%84_%D0%BC%D0%BE%D1%82%D0%BE%D1%80_%D0%BF%D0%B5%D1%80%D0%B5%D0%B2%D1%91%D1%80%D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), скрипт [scene_grif_perevorot.py](https://github.com/Korvova/gitar/blob/main/2-0/kasseta/scene_grif_perevorot.py).    **Что сделать (другому ИИ):** стенд на **одну тележку**: платформа y ±16 на ножках, чтобы провода свисали; датчик не закладывать (19.40). Генератор на build123d по образцу [plashmya_2204.py](https://github.com/Korvova/gitar/blob/main/2-0/kasseta/plashmya_2204.py) (зубья, зазоры, профили рельсов оттуда), проверка хода ±22 и зазоров, детали без поддержек, стол **114** в make_3mf.py, строка здесь и в хронике. Кубик и низ тележки разделить на две детали, склейка по юбке. **Порядок сборки:** припаять тонкие провода к пайке → продеть через трубку → кубик на мотор, неподвижную часть приклеить к крышке → продеть провода в шестерню, фланец приклеить к торцу → приклеить низ тележки → надеть тележку на рельсы с торца платформы (шестерня заходит под крышку зубьев) → провода в щель. | В сцене столкновений нет на всём ходу; пересекаются только зубья и то, что входит в дно мотора (мотор нарисован сплошным). Сила та же, ~630 г/А, без датчика ниже расчётной (19.33). **Железо ещё не проверено. До печати померить на своём 2204:** сквозное ли отверстие на крутящемся торце и его диаметр; насколько трубка выступает над неподвижной стороной (в кармане запас 0.8). **Проверить опытом:** протянуть три провода через трубку и погонять мотор на ±210° — не мешает ли трение. **Риски:** крышка над карманом 0.7, а палец давит сверху — может прогибаться; дно паза 0.5 при открытых концах — плита может быть хлипкой, тогда снизу клеить тонкий лист; стенка кубика 0.6 при зазоре 0.2 у мотора может задевать; зазоры 0.2–0.3 на грани точности печати; клей на моторе потом трудно снять. На краю хода кубик выходит за гриф на 10.7, сбоку видны чёрные концы рельсов и рейки. | Основа; печатаем с изменениями 19.43 |
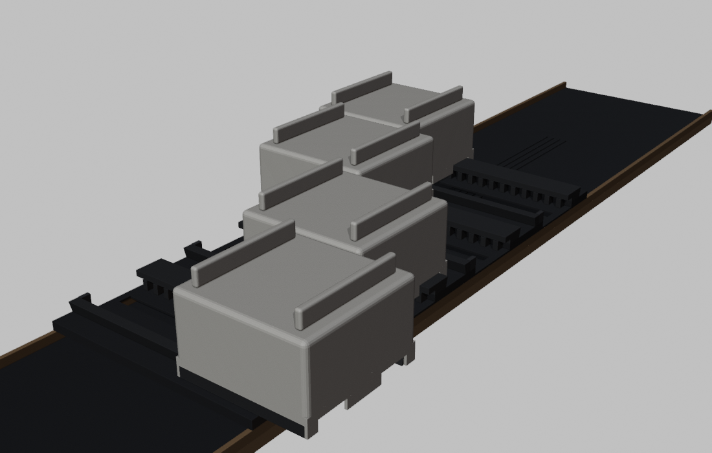
[picture p62: wiki/img/simmetria.png]
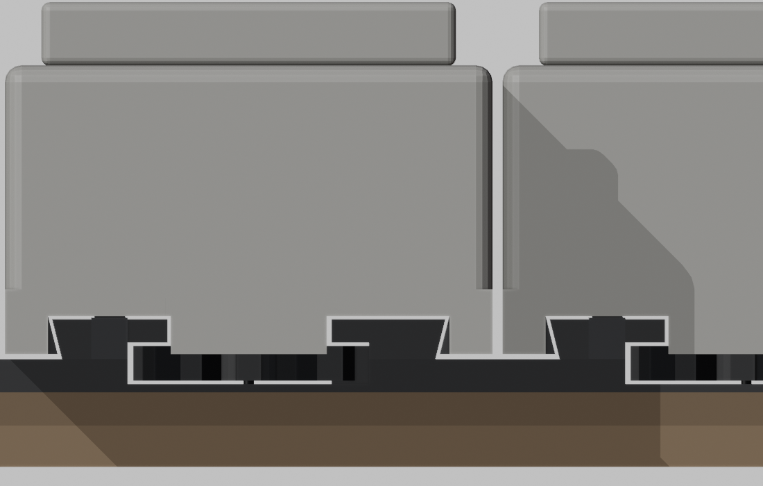
[picture p63: wiki/img/simmetria_sboku.png]
Сбоку: два окна, скосы зеркально
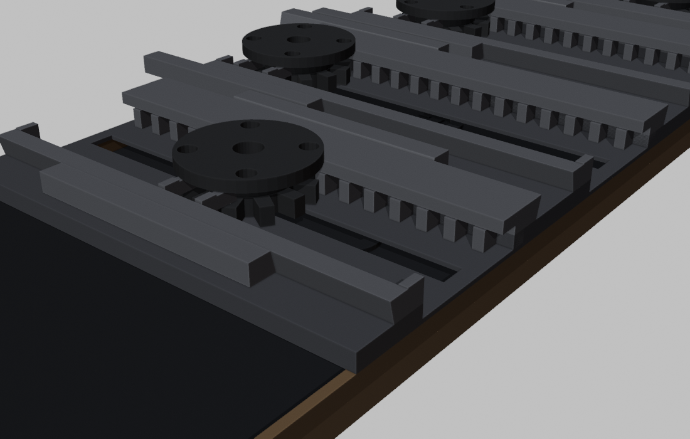
[picture p64: wiki/img/simmetria_bez_kubika.png]
Без кубика и мотора: бортики и шестерня
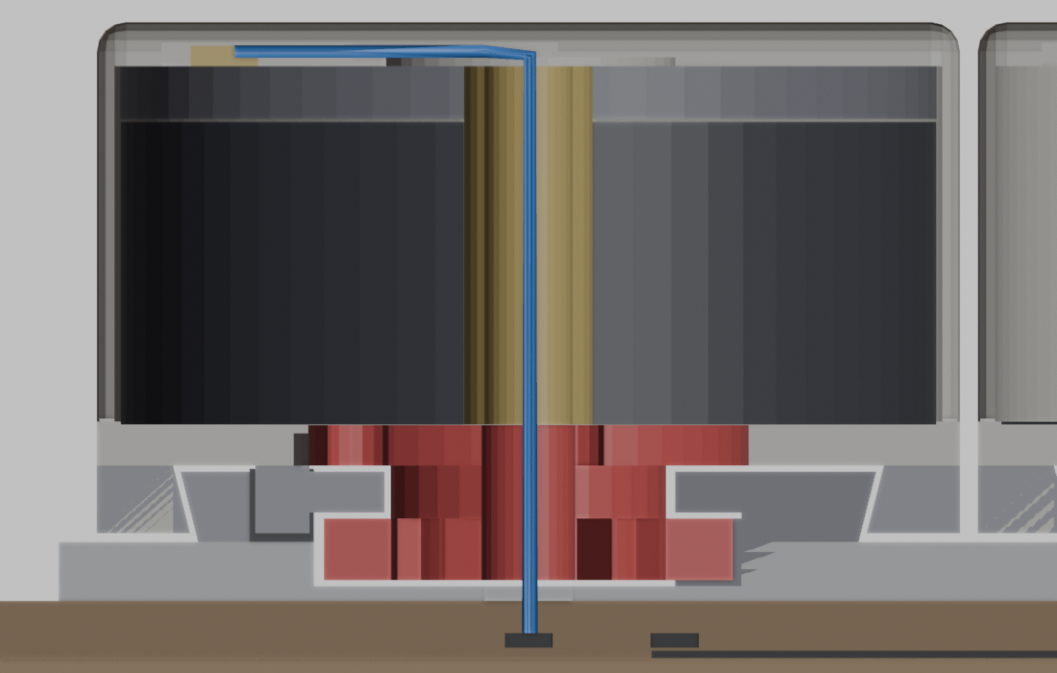
[picture p65: wiki/img/simmetria_razrez.png]
Разрез: провода синие
| 19.43 | Итог внешнего вида: мотор перевёрнут, рейка со скосом, два окна, всё зеркально (06.11) — **эту версию владелец печатает и собирает дома, на одну тележку; задание: подготовить файлы на печать** | Владелец: «как будто прям красота». Основа — 19.42 (мотор перевёрнут, провода через его трубку, полая шестерня с фланцем, паз в платформе), всё, что здесь не указано, оттуда. **Источник геометрии — скрипт** [scene_grif_simmetria.py](https://github.com/Korvova/gitar/blob/main/2-0/kasseta/scene_grif_simmetria.py), сцена [Гриф_симметрия.blend](https://raw.githubusercontent.com/Korvova/gitar/main/2-0/kasseta/%D0%93%D1%80%D0%B8%D1%84_%D1%81%D0%B8%D0%BC%D0%BC%D0%B5%D1%82%D1%80%D0%B8%D1%8F.blend) (4 тележки, пробел: тележки ходят ±22, платформа стоит). Скрипт — эскиз Blender: размеры брать из него, а точные посадки, отверстия и крепёж доводить по столу 112 и замерам. **Оси:** X поперёк грифа, Y вдоль, Z = 0 — верх платформы. Ширина **52 мм**, высота **24.2 мм**. **Что нового относительно 19.42 (идеи владельца):** **(1) Рейка и ласточкин хвост — одно целое.** Отдельного переднего рельса нет: спинка рейки y 7.25…11.25 у основания, скос наружу до y 11.85 на z 2.4, за него цепляется передняя лапа. Зубья и крышка над ними как в 19.42. **(2) Задний рельс узкий, скос только наружу:** внутренняя грань y −9.5, основание до y −11.25, верх до y −11.85, z 0…2.4. Два встречных скоса держат тележку. **(3) Упор вплотную к рельсу, как бортик:** x ±(25.05…26), y −9.5…−7.3, z 0…2.5. Паз y −7.3…7.25, щель y ±1.5 — как в 19.42. **(4) Лапы зеркальные, x ±14.1 (за юбкой):** задняя — контур (y, z): (−12.1, 2.6), (−14.7, 2.6), (−14.7, 0.3), (−11.525, 0.3); передняя — то же с обратным знаком y. Зазор по скосу 0.2 заложен для сцены, на печати подобрать. **(5) Два зеркальных окна сбоку.** Юбка x ±(14.1…14.7): z 2.6…4.2 по всей длине; ниже, z 0.3…2.6, стенка только при y −14.7…−12.1, −4.7…4.7, 12.1…14.7. Окна y 4.7…12.1 и −12.1…−4.7. **(6) Щёчки упора:** x ±(2.05…3), y −9.3…−7.45, z 0.3…2.6 и над зубьями шестерни y −7.45…−4.9, z 1…2.4 (закрывает просвет в окне, под фланцем зазор 0.2). **(7) Цвет:** кубик и юбка светлые; лапы, щёчки, шестерня, платформа, рейка, рельсы, упоры матово-чёрные; провода чёрные, чёрная плёнка на основании. **Замеры на двигателе владельца (06.11):** отверстие сквозное, Ø3; подшипник вровень с неподвижной стороной, не выступает. По фото, примерно: шаг контактов пайки ~3.2, группа ±4.6, контакты на радиусе ~8…12.5, подшипник ~Ø8.7, отверстия М2 на неподвижной стороне ~Ø13 (померить). **Поэтому в крышке, в её низу:** карман под пайку x ±5.5, y −12.5…−6 до z 17; канавка под провода x ±1.2, y −9…1 до z 17; карман над подшипником Ø10 только до z 16.5 (внутреннее кольцо крутится, касаться нельзя). **Клей только по внешнему полю, в подшипник не должен попасть.** Провода перепаять так, чтобы шли внутрь, к центру. Мотор к крышке можно не клеить, а прикрутить короткими потайными М2 — снимается; правило то же: **в мотор не глубже 1.5 мм**.     **Что сделать (другому ИИ):** прочитать скрипт, 19.42 и эту строку; переделать на build123d по образцу [plashmya_2204.py](https://github.com/Korvova/gitar/blob/main/2-0/kasseta/plashmya_2204.py) с точными размерами крепежа и посадок; стенд на **одну тележку** (платформа y ±16 на ножках, чтобы провода свисали; датчик не закладывать, 19.40); проверка хода ±22 и зазоров; **всё без поддержек**, разбить на детали как удобнее для этого; стол **114** в make_3mf.py; строка здесь и в хронике. **Порядок сборки:** как в 19.42. Тележка надевается на рейку и рельс с торца платформы. | В сцене столкновений нет на всём ходу; пересекаются только зубья и то, что входит в дно мотора (мотор нарисован сплошным). **Железо ещё не проверено. Проверить опытом:** три провода через трубку на ±210° — не мешает ли трение. **Риски:** задний рельс узкий (1.75 у основания) — может подломиться при рывке, основная нагрузка на толстой спинке рейки; скосы требуют точности — большой зазор даст качание, малый — тугой ход; дно паза 0.5 при открытых концах; крышка над карманами 0.7; стенка кубика 0.6 при зазоре 0.2 у мотора. | ⬜ Ждёт файлов на печать |
| 19.44 | ~~Заметка: шагоход — неподвижный мотор плашмя и рейки по кругу (08.11)~~ | Идея владельца. Мотор лежит и стоит на месте, вал вертикальный с эксцентриками. Плоские рейки друг над другом ходят по кругу со сдвигом фазы, зубья сбоку по очереди входят в гребёнку тележки, тележка едет вдоль реек. Рейки с размахом целиком внутри грифа (±26), тележка на краю свисает. Вторая опора реек нужна, чтобы рейка не поворачивалась. **Расчёт при эксцентрике 2 мм:** 2 слоя — шаг 4, 8 мм/об, волна хода 0.42 мм, в момент передачи скорость 0 и мёртвая точка; **3 слоя (сдвиг 120°) — шаг 3.46, 10.4 мм/об, волна 0.14 мм, скорость не ниже 50 %, мёртвой точки нет, глубина зуба 1 мм**; 4 слоя — волна 0.06, глубина 0.6. Сила в 3.6 раза больше, чем у шестерни R6 (расчёт). **Высота 3 слоя: мотор 12.2 + рейки 3 × 1.5 с зазорами + дно ложа 2 ≈ 19.8 мм.** Нынешний вариант 19.43 в том же счёте 19.7 (без основания и щели), но у шагохода мотор стоит на месте и его можно утопить: в платформу, щель почти не нужна — всего ~22.5 мм против 24.2; ещё и в прорезь основания шириной 28 — ~20 мм, но основанию нужна компенсация жёсткости. Провода к тележке не идут. Сцена [Шагоход_3_слоя.blend](https://raw.githubusercontent.com/Korvova/gitar/main/2-0/kasseta/%D0%A8%D0%B0%D0%B3%D0%BE%D1%85%D0%BE%D0%B4_3_%D1%81%D0%BB%D0%BE%D1%8F.blend), скрипт [scene_shagohod_3sloya.py](https://github.com/Korvova/gitar/blob/main/2-0/kasseta/scene_shagohod_3sloya.py). Шагоход, 3 слоя | Анимация: столкновений нет, ход ±22. Железо не проверено. **Риски:** зуб заходит на 1 мм, три рейки должны попадать в одни пазы — точность зазоров и эксцентриков; зубья 1.5 мм из PLA слабые, лучше металл или текстолит 1–1.5; на 4 пальца 12 реек и много эксцентриков; на краю тележка свисает. Первый шаг, если пробовать: дорожка на одну тележку, сравнить со стендом 114 Итог проб — в 19.45. | 💤 Вторая версия |
| 19.45 | ~~Шагоход на 3 слоя реек: сборка стенда на одну тележку (09.11) — задание другому ИИ: подготовить файлы на печать~~ | Идея и расчёт — 19.44. **Источник геометрии — скрипт** [scene_shagohod_3sloya.py](https://github.com/Korvova/gitar/blob/main/2-0/kasseta/scene_shagohod_3sloya.py), сцена [Гриф: Шагоход_3_слоя.blend](https://raw.githubusercontent.com/Korvova/gitar/main/2-0/kasseta/%D0%A8%D0%B0%D0%B3%D0%BE%D1%85%D0%BE%D0%B4_3_%D1%81%D0%BB%D0%BE%D1%8F.blend) (пробел — анимация). Скрипт — кинематический эскиз: размеры брать из него, посадки, крепёж и детали без поддержек доводить. Поддержки и вторая опора в сцене показаны условно. **Оси:** X вдоль реек (поперёк грифа), Y поперёк реек, Z вверх; Z = 0 — верх мотора. Ход тележки ±22. **Главные числа:** эксцентриситет 2; шаг зубьев и пазов √3 × 2 = **3.464**; 10.39 мм за оборот, весь ход ±22 — 2.12 оборота в каждую сторону. **(1) Мотор** 2204 Ø27.8 × 12.2 лежит плашмя, неподвижная сторона вниз, в отверстии платформы (утопить, сколько позволяет платформа); крутящийся торец вверх, z −12.2…0. Провода неподвижны, тележки не касаются. Крепление: М2 или клей; **в мотор винт не глубже 1.5 мм**, клей не должен попасть в подшипник. **(2) Вал:** Ø3 в сквозную трубку мотора на эпоксидке (трубка крутится вместе с корпусом, проверено), торчит вверх до z 5.5. Верх вала — **шестигранник** или другая шпонка: шестигранник сам даёт фазы 0°/120°/240°. **(3) Эксцентрики — три отдельных диска Ø8, смещение отверстия 2,** толщина по этажу; фазы 0°, 120°, 240°. Одной деталью напечатать нельзя: рейка не наденется через соседний кулачок, поэтому собирать пакетом снизу вверх: диск, рейка, диск, рейка. **(4) Вторая опора при x = 17** (без неё рейка поворачивается): такие же три диска в тех же фазах на своём шестигранном валу, вал свободно крутится в опоре (держит рейки через мёртвую точку; диски на вал не свободно). Низ её оси — в платформе, сбоку от мотора (R13.9). **(5) Три рейки, толщина 1.5, этажи z 0.3…1.8, 2.1…3.6, 3.9…5.4:** тело x ±24, y ±5; отверстия Ø8.3 при x = 0 и x = 17; зубья вдоль стороны +Y при x = k × 3.464, k = −6…6, высота зуба 2.8 (y 5…7.8), одинаковая фаза у всех трёх реек. С размахом ±2 рейка остаётся в ±26. Материал: для первой пробы можно печатать, но PLA 1.5 мм на зубьях слабый; лучше лазер/фрезер из металла или текстолита 1–1.5. **(6) Тележка:** верх-ложе x ±11, y ±14, z 5.6…7.6 (дно 2 мм), борта x ±(9.5…11), y ±12.5 до z 11.4. Снизу гребёнка: 6 зубьев-столбиков шириной 1.6 при x = (k + 0.5) × 3.464, k = −3…2, y 8.3…11, z 0.3…5.4; спинка y 11…12, x ±11. Глубина захода зуба 0.5 при передаче, до 1.5 в середине окна. На краю хода тележка свисает, в зацеплении минимум 3 паза. **(7) Направляющие:** неподвижные полосы y ±(12.2…14), x ±26, z 0.3…5.55; ложе скользит по ним. В сцене ложе просто лежит сверху — **добавить удержание от подъёма**: встречные скосы, как у рейки в 19.43. Тележка при работе толкается по Y от зубьев, зазор 0.1–0.2. **(8) Зубья трапецией (идея владельца, в сцене пока прямоугольные):** не острый треугольник, а скосы 15–20° на сторону и плоская вершина около 0.7; пазы гребёнки по тому же профилю с боковым зазором 0.2–0.3. **(9) Прошивка:** motor1_fw считать тележку как 10.39 мм/об (эквивалентный радиус 1.654 мм). Положение можно сгладить таблицей x(θ): волна хода известна, 0.14 мм. Упоры на ±22 для привязки положения — добавить. **Что сделать:** стенд на одну тележку: платформа x ±26, y ±15 на ножках; всё без поддержек; проверка хода ±22 и зазоров; первый свободный номер стола — смотреть make_3mf.py; строка здесь и в хронике. Потом сравнить со стендом 114 по силе, ходу, шуму и усилию пальцем. **Порядок сборки:** мотор в платформу → вал в трубку → вторая опора → пакетом снизу: диск, рейка, диск, рейка, диск, рейка на оба вала (фазы 0/120/240 и попадание в зубья проверить) → фиксатор сверху → направляющие → тележка с торца. | Кинематика в сцене: столкновений нет, ход ±22, зубья в зацеплении; нагрузку, трение и прочность сцена не считает. **Железо не проверено. Риски:** зуб заходит всего на 0.5–1.5 мм — важна точность шага и эксцентриков; три рейки должны попасть в одни пазы; зубья 1.5 мм из PLA могут сломаться; на краю хода тележка свисает; 3 диска и 3 рейки на тележку — много деталей (на 4 пальца 12 реек). Если шагоход на дорожке будет туго ходить — сначала зазор и трапеция, потом уже решать. **Итог проб 09.11:** крупная проба с большими дисками Ø14 напечатана — заедает, в симуляции MuJoCo тоже, при трении 0.3 плечо трения 2.1 мм больше рабочего 1.5 мм у передачи. Вариант со штырьками Ø5 ([shag_v3.py](https://github.com/Korvova/gitar/blob/main/2-0/kasseta/shagohod/shag_v3.py), основание и тележка — [shag_v2.py](https://github.com/Korvova/gitar/blob/main/2-0/kasseta/shagohod/shag_v2.py)) в симуляции от мотора идёт только с узкой вершиной зуба 1 мм и разносом отверстий рейки 20.2–20.4 мм при валах на 20 (при 20.0 и меньше заедает); от пальца полный ход не подтверждён: при 2 Н тележка встала через 4 мм. Живая физика с ползунками: [shag_sim.py](https://github.com/Korvova/gitar/blob/main/2-0/kasseta/shagohod/shag_sim.py). В железе штырьки ещё не собраны. **Решение владельца 09.11: сложно, основной путь — мотор в тележке (19.43, стенд 114); шагоход отложен как возможная вторая версия тренажёра.** | 💤 Вторая версия, файлы не нужны |
| 19.46 | Купить тонкие гибкие провода через центр мотора | Для проводов сквозь трубку мотора Ø3: **МГТФ 0,07** (запас — МГТФ 0,12) или **силиконовый 30 AWG**. Запросы: «провод МГТФ 0,07», «провод силиконовый 30 AWG», на AliExpress «30AWG silicone wire ultra flexible». Наружный диаметр проверять в карточке: нужно не больше 0.8 мм, чтобы свободно шли 3–5 проводов. Взять по 2–3 м, лучше трёх цветов | МГТФ скользкий, меньше цепляется в трубке. Силикон мягче, лучше для катящейся петли, но толще (около 0.9–1 мм) и сильнее тормозит в трубке: три пройдут, пять впритык. Диаметры ориентировочные. Сравнить вживую на моторе, ±210° | ⬜ Купить |
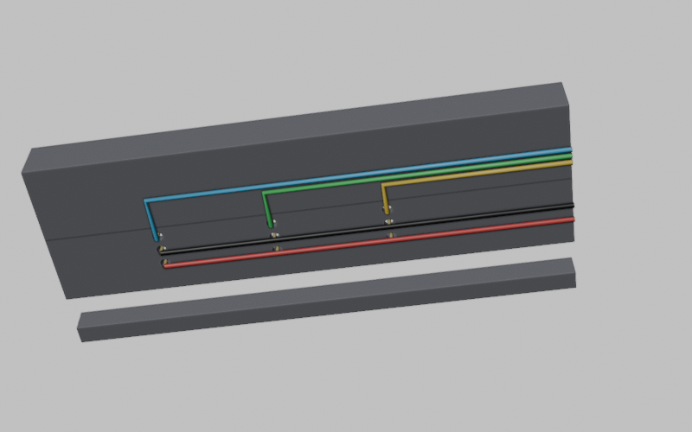
[picture p66: wiki/img/datchiki_bokom_snizu.png]
Снизу: провода без пересечений
| 19.47 | Положение тележки: 3 датчика 49E боком, ножки в отверстия, провода снизу без пересечений (10.11) — **задание другому ИИ: внести в 114/116 и подготовить STL для сборки** | Решение владельца. Развитие коммита 1e7785a (3 датчика 49E в дне паза, 2 магнита на тележке), остальное оттуда. **Принцип:** датчики неподвижно в платформе на x −8.8, 0, +8.8; два магнита Ø4 на тележке на x ±13.2 от её центра, разной полярности (+ при +13.2, − при −13.2), y = −5.2 от оси дорожки. На каждой из 6 струн (тележка на ±4.4, ±13.2, ±22) над одним датчиком стоит один магнит: какой датчик и какой знак — это номер струны, калибровка значений не нужна. Прошивка уже читает три датчика (GPIO 32, 33, 34). **Что меняется — как стоит датчик** (вместо канавок ножек в щель, она занята проводами мотора): оси X вдоль рейки, Y поперёк, Z = 0 верх платформы, ось дорожки y = 0. Датчик **боком**: корпус 3.0 по X, 4.1 по Y, 1.5 по Z, центр y = −5.2, z −3.0…−1.55, **маркировкой вверх**, ножки в сторону −X. Гнездо x ±1.55 от датчика, y центр ±2.1, z −3.05…−1 (сверху открыто в паз). Канавка ножек от x_дат − 3.15 до x_дат − 1.5, y центр ±2.1, z −2.9…−1. Ножки загибаются вниз в **три отверстия Ø0.8 при x_дат − 2.6**, y = −5.2 + 1.27 (питание), −5.2 (земля), −5.2 − 1.27 (сигнал), насквозь через дно. **Провода снизу платформы, z ≈ −3.95:** питание и земля — две прямые линии вдоль X через все три датчика, к краю +X; **сигнал крайний**, сразу уходит в сторону −Y, затем вдоль X к краю: от первого датчика самая дальняя линия (y −10.1), от второго −9.55, от третьего −9.0; так провода не пересекаются. В щель y ±1.5 ничего не заходит. Катящаяся петля проводов мотора — по другую сторону от оси дорожки (+Y). Датчики на платформе, поэтому через трубку мотора их провода не идут: там только 3 фазы и, при необходимости, кнопка. **Сцена одной дорожки** (камеры «Снизу» и «Сверху», тележка условно на x = +4.4): [Датчики_боком_с_дырками.blend](https://raw.githubusercontent.com/Korvova/gitar/main/2-0/kasseta/datchiki/%D0%94%D0%B0%D1%82%D1%87%D0%B8%D0%BA%D0%B8_%D0%B1%D0%BE%D0%BA%D0%BE%D0%BC_%D1%81_%D0%B4%D1%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), скрипт [scene_datchiki_bokom.py](https://github.com/Korvova/gitar/blob/main/2-0/kasseta/datchiki/scene_datchiki_bokom.py). **Интерактивная проверка** с ползунком: [datchiki_3x49e_schema.html](https://github.com/Korvova/gitar/blob/main/2-0/websim/datchiki_3x49e_schema.html).  **Что сделать (другому ИИ):** внести гнёзда, канавки и отверстия в генератор [grif_telezhka_114.py](https://github.com/Korvova/gitar/blob/main/2-0/kasseta/grif_telezhka_114.py) и 116, убрать старые канавки ножек в щель и заглушить их; магниты как есть; снизу платформы при необходимости неглубокие канавки под провода, где толщина позволяет; проверить отверстия и ход ±22; собрать STL/3MF без поддержек, следующий свободный стол — смотреть make_3mf.py; строка здесь и в хронике. **Плата (следующий шаг, не сейчас):** узкая полоска ~22 × 5 мм снизу платформы; на 4 тележки с ADS1115 на каждой — всего 4 провода вдоль грифа вместо 14 и хватит входов (12 сигналов, у ESP32 надёжных ADC1 около 6). | Модель поля — диполь, магнит–кристалл 2.8 мм, порог 35 %: все 6 струн определяются верно, ложных нет на всём ходе; определяется только ±1.8 мм вокруг струны (~44 % хода), между струнами — «ни один не сработал», для вопроса «на какой струне палец» этого достаточно. Число приближённое. **Перед печатью проверить на своих деталях:** шаг ножек 1.27; **распиновку** (питание–земля–сигнал при маркировке вверх, ножки к −X: взята стандартная для 49E, проверить мультиметром, иначе развернуть ножки в +X и зеркально отверстия); зазор гнезда до стенки паза всего 0.05 мм — при необходимости сдвинуть датчик на 0.5 мм к центру. **Главный риск — поле самого мотора:** на части струн мотор проезжает над датчиками; поставить тележку над датчиком, крутить вал и подать ток, смотреть, меняются ли значения (в схеме есть ползунок помехи; реальная величина неизвестна). Провода питания и земли идут под гнёздами соседних датчиков — закрепить клеем или лентой | ⬜ Ждёт файлов на печать |
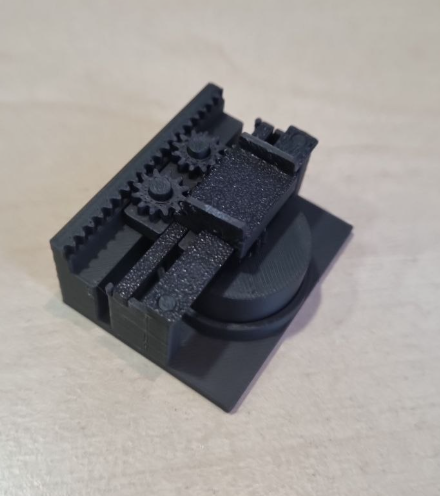
[picture p67: wiki/img/teleskop_v3_sobran.png]
Собранный телескоп
| 19.48 | **Телескоп v3 — РАБОТАЕТ (12.11):** мотор стоит на месте, ход тележки ±22 удваивается шестернями — основной привод | Владелец собрал и проверил: «работает хорошо». Задача привода тележки, которую решали больше трёх месяцев, решена. **Принцип:** мотор 2204 неподвижен в основании. Его шестерня m0.8 z11 двигает **ползун** на ±11; на ползуне две **плавающие шестерни** z12, они катятся по **неподвижной рейке** основания и везут **рейку тележки** вдвое дальше — ±22. К тележке не идут провода, она узкая (20 мм). **Размеры:** основание 50 × 39.6 мм (ширина грифа 50), до верха ложа 23.4 мм; тележка на крайней струне свешивается за край на 7 мм. Сила примерно 430 г на 1 А без потерь, ~360 г с трением (у шестерни R6 прямо по рейке было 630): тележка проходит 55 мм за оборот мотора против 37.7. Если силы мало — шестерня мотора меньше (z9 даст ~+20 %). **Конструкция v3:** полка плоская; ползун ведёт брусок-прямоугольник в пазу на верху ползуна (вровень с ним), брусок лежит в пазах двух стоек у краёв, стойки же — упоры хода ±11; мост — трапеция (шире вверху), тележка держится за него губами и не поднимается; планка сверху связывает оси плавающих шестерён; неподвижная рейка заодно с основанием, под зубьями сплошная стенка до ползуна. Оси Ø4, отверстия шестерён Ø4.5, шестерня мотора Ø3.3 по трубке мотора. Скользящие зазоры 0.2. **Всё печатается без поддержек.** **Файлы:** папка [2-0/teleskop_v3](https://github.com/Korvova/gitar/tree/main/2-0/teleskop_v3) — генератор [teleskop_v3.py](https://github.com/Korvova/gitar/blob/main/2-0/teleskop_v3/teleskop_v3.py) (build123d, при запуске сам проверяет ход и нависания), STL на печать в stl/ (10 деталей, уже положены как печатать), сцена с анимацией [teleskop_v3.blend](https://raw.githubusercontent.com/Korvova/gitar/main/2-0/teleskop_v3/teleskop_v3.blend) (пробел), инструкция [СБОРКА.txt](https://github.com/Korvova/gitar/blob/main/2-0/teleskop_v3/%D0%A1%D0%91%D0%9E%D0%A0%D0%9A%D0%90.txt).  Модель | v1 и v2 — пробы 11–12.11 (вторая печать: упоры, свободные шестерни, рейка заодно с основанием, балка ползуна); v3 — доработка, чтобы детали не снимались при любом положении гитары. **Что осталось:** брусок прямоугольный — ведёт ползун вбок, от подъёма не держит; если при наклоне ползун приподнимется и выйдет из зацепления с шестернёй мотора, вернуть небольшой скос по бокам бруска. Люфт двух зацеплений m0.8 больше, чем у одной шестерни по рейке. На 4 пальца: одна дорожка вместе с мотором 39.6 мм вдоль грифа при шаге 30 — моторы, вероятно, в шахматном порядке, проверить. Дальше — датчик положения и кнопка (у владельца есть простое решение) | ✅ Работает |
| 19.49 | Телескоп v4: кнопка зажатия на каждой струне (12.11) | Основа — v3 (19.48), основание v3 без изменений (штырьки стоек подрезать до 0.4 мм). Мост неподвижный, шире назад на 5 мм: 6 гнёзд под SMD-кнопки 5.2×5.2×1.5 (ход 0.3) под струнами, сверху плотные крышки 5.4×5.4×0.6 вровень с мостом, вдоль гнёзд с двух сторон каналы 1.2 мм под провода, края гнёзд по ходу тележки со скосом 0.3/0.8 — чтобы при нажатом пальце не закусывало. Под центром тележки горбик 0.4 (накладка, печать на боку): над струной продавливает крышку → кнопка, между струн стоит на мосту → нет. Волны на мосту отброшены (ступеньки при печати, лишняя сложность). Генератор [teleskop_v4.py](https://github.com/Korvova/gitar/blob/main/2-0/teleskop_v4/teleskop_v4.py), STL в stl/, сцена teleskop_v4.blend, сборка — СБОРКА.txt. Печатать: 02_most, 08_telezhka, 11_kryshka_knopki ×6, 12_nakladka_telezhki. **Схема кнопок (владелец 12.11): резисторная лестница на один аналоговый пин ESP32.** Кнопки одним выводом на общую шину питания 3.3 В, другим — на точки цепочки резисторов, соединённых последовательно до пина ESP; кнопка 1 — напрямую, кнопка 2 — через 1 резистор, кнопка 6 — через все. Пин подтянут к земле, поэтому напряжение на нём своё у каждой кнопки, по нему прошивка понимает, какая нажата. Пример номиналов: по 1 кОм в цепочке, подтяжка 4.7 кОм — около 3.3 / 2.7 / 2.3 / 2.0 / 1.8 / 1.6 В. На мост 3 провода (3.3 В, сигнал, земля). Две кнопки сразу различить нельзя (победит ближняя к пину) — для зажатия одним пальцем не мешает | Модель проверена по ходу ±22, железо ещё нет. Проверить: горбик на крайних струнах попадает на крышку (крайние кнопки сдвинуты внутрь на 0.6), между струн горбик в 0.1 мм от края крышки; в будущем — плата с кнопками в паз моста | ⬜ Печать |
| 19.50 | Мост-кассета с кнопками под плату (12.11) — **задание другому ИИ: модель и STL** | Решение владельца: кнопки — главная часть тренажёра, каждая кнопка = струна, поэтому датчики 49E становятся не нужны (положение при нажатии даёт кнопка, в обучении — шаги мотора после привязки к упору). Сейчас — проба на ощупь «как щёлкают», потом вставляется плата. **Мост-кассета** на основе v4 (19.49): 6 кармашков под SMD-кнопки 5.2×5.2×1.5 (ход 0.3) под струнами (x ±4.4, ±13.2, крайние ±21.4); снизу паз во всю длину под **плату 1.5 мм** (текстолит FR-4), плата вдвигается с торца; пока вместо платы — **напечатанная пластина 1.5 мм** того же размера. **Крышки** кнопок сверху вровень с мостом, толщина ~0.5, не должны вылетать: крышка с буртиком снизу, буртик шире окна в верху моста — крышки вставляются снизу, потом кнопки, потом плата/пластина держит всё (мост печатать верхом на стол, кармашки открыты вверх — без поддержек). Края окон по ходу тележки со скосом (как в v4), чтобы нажатая крышка не закусывала. **Резисторная лестница** (19.49: по 1 кОм между кнопками, подтяжка 4.7 кОм) — резисторы выводные 0.25 Вт Ø2.2 × 6 мм: канал вдоль кармашков шириной 2.5–3 мм, второй канал — провода; 3 провода на мост (3.3 В, сигнал, земля). Для пробы всё паяется колхозно на ножки кнопок, плата потом просто вставляется в тот же паз. **Высота:** мост станет ~4 мм вместо 2.5 (плата 1.5 + кнопка 1.5 + крышка 0.5 + 0.5). Опустить низ моста за счёт: дно основания 2.5 → 1 мм (мотор ниже на 1.5), слой шестерни мотора/ползуна тоньше на 0.5–1 мм — верх ложа останется ~23.4, допустимо до 25. Основание перепечатать. **Порядок:** сначала только мост-кассета + пластина + крышки для пробы на старом основании (можно временно выше), потом v5 целиком. Генератор — на базе 2-0/teleskop_v4/teleskop_v4.py, новая папка teleskop_v5 | Нужно проверить на пробе: удобство щелчка через крышку, ложные нажатия при движении тележки с нажимом (отсекать в прошивке: тележка стоит и кнопка держится пару мс), как держатся крышки  **STL готовы (12.11), проба на столе:** кассета из двух частей — [kaseta_stl](https://github.com/Korvova/gitar/tree/main/2-0/teleskop_v4/kaseta_stl): 01_kryshka_kasety (верх, трапеция под тележку, окна со скосами, перевёрнута), 02_lotok (низ: гнездо пластины/платы 1.5, сзади канал 3.6 под резисторы, выход на торцы, штырьки Ø1.2), 03_kryshka_knopki ×6 (буртиком вниз), 04_plastina_vmesto_platy; тележка под неё — stl/08_telezhka (длиннее, 22.7) + stl/12_nakladka_telezhki (горбик, печать на боку, вклеить в гнездо). Сборка: пластина в лоток → кнопки → крышки в окна снизу → крышку на лоток. Генераторы: [kaseta_proba.py](https://github.com/Korvova/gitar/blob/main/2-0/teleskop_v4/kaseta_proba.py), [teleskop_v4.py](https://github.com/Korvova/gitar/blob/main/2-0/teleskop_v4/teleskop_v4.py); сцена kaseta_proba.blend (скрипт kaseta_blender.py). Всё без поддержек. В гриф кассета пока не встаёт — для этого v5 с опущенным основанием | ⬜ Печать пробы |
| 19.51 | **Полный макет v5: привод телескоп v3 + узкий мост с кнопками** (13.11) | Мост-кассета (19.50) после печати отброшена, мост переделан с нуля и посажен на привод v3. **Мост:** лоток 9.6 мм с платой 7 мм (6 SMD-кнопок 5.2×5.2 в один ряд, крайние на ±19.5, резисторы лестницы — SMD 0805 между кнопками); крышка на всю ширину с рельсами-ласточкиным хвостом по краям (верх ±5.6, на 0.5 выше ленты), держится 2 штифтами из филамента 1.75; сверху сплошная лента TPU 0.6 с квадратными бугорками 4×4 через окна 4.4×4.4 до кнопок (между струн под лентой сплошная крышка — ложных нажатий нет). **Тележка 20×13.8:** обнимает хвост крышки снизу (надевается с торца, люфт вверх ~0.2), корпус 1.3 мм; П-язычок 8×14.5×0.8 вдоль хода, прорезь 0.5, снизу штырь 4.6×4.6 (до ленты 0.2) — допуск попадания ±4 мм, нажатие ~450 г; сверху накладка 0.4 (2 слоя PLA/TPU) прячет П и продавливается пальцем; спереди рейка v3 к плавающим шестерням, передняя грань одной плоскостью. **Вибромотор — под мостом, не на тележке** (провода неподвижные): лоток с 2 задними ушами, таблетки Ø10×2.7 снизу ушей, мост лежит на TPU-подушках 1.2 на стойках основания (штырьки TPU вниз и вверх), жёсткие упоры через 0.3 — палец лежит → мост плавает и вибрирует, жмёт → мост встаёт на упоры и жмётся кнопка; вибрация идёт на тележку через рельсы. Оси плавающих шестерён срезаны вровень, планки нет — сверху потом будет крышка шестерён почти вровень с тележкой (оставить щель под рейку). Высота модуля 26.5 мм (резерв: пол основания 2.5→1). Проверка хода ±22, подушек, таблеток: пересечений нет, все STL герметичны, без поддержек. **4 модуля** вдоль струн вплотную (158 мм): прямой/прямой/повёрнутый/повёрнутый, средним пальцам сдвиг ~±1, крайним нужен сдвиг ±16.7 — делать сдвигом моста относительно основания (рейка с другого края тележки), удлинитель-рычаг отброшен. Открыто: этот сдвиг, крышка шестерён, настоящая плата, тест вибрации на мосту против тележки. Генераторы: [full_v5.py](https://github.com/Korvova/gitar/blob/main/2-0/full_v5/full_v5.py) (берёт детали из [teleskop_v3](https://github.com/Korvova/gitar/tree/main/2-0/teleskop_v3) и [most_v2.py](https://github.com/Korvova/gitar/blob/main/2-0/most_v2/most_v2.py)), STL: [full_v5/stl](https://github.com/Korvova/gitar/tree/main/2-0/full_v5/stl), сцены: full_v5_blender.py, full_v5_x4_blender.py | 🔄 Модель готова, печать |
| 19.52 | **Проба балки с кнопками на столе** (13.11) — печать и сборка рукой, без привода | Отдельный набор из 19.51, чтобы проверить кнопки до полного макета. **01 корпус** 50×9.6: на торцах 2 штырька, крышка надевается без клея, прорезь проводов в торце. **02 пластина вместо текстолита** с перегородками: 6 ячеек 5.5×5.5, кнопки просто кладутся (выводы поперёк балки), канал проводов вдоль борта. **03 крышка** с рельсами-хвостом, выемка под ленту до самых рельсов. **04 лента** 45×7.2 (PLA или TPU): вокруг каждого бугорка 4×4 П-прорезь — бугорок на своём язычке; у крайних корень к торцу, рамка замкнута (иначе рвались при вынимании). **05 тележка** без накладки и без зуба упора; нажимник 1.6×3 на кончике П-язычка (центральный штырь не нажимал) — точка нажатия смещена от центра тележки на 5.2, учесть в прошивке. **Зазор хвоста по печати:** 0.1 туго, 0.4 болтается (люфт вверх ~0.85) → печатаем 2 тележки: 0.3 (люфт ~0.6) и 0.2 (~0.4), выбрать; в коде параметр CL (по умолчанию 0.3). Проверка: пересечений нет, ход чистый, все STL герметичны, без поддержек. Код: [most_test.py](https://github.com/Korvova/gitar/blob/main/2-0/most_test/most_test.py) (берёт геометрию из [most_v2.py](https://github.com/Korvova/gitar/blob/main/2-0/most_v2/most_v2.py)), [telezhki_zazor.py](https://github.com/Korvova/gitar/blob/main/2-0/most_test/telezhki_zazor.py); STL: [most_test/stl](https://github.com/Korvova/gitar/tree/main/2-0/most_test/stl) | 🔄 Печать, выбор зазора |
| 19.53 | **Тележка: два П-язычка навстречу, зазор хвоста 0.2** (13.11) + всё для доработки дома | По печати 19.52: зазор хвоста **0.2** — хорошо (0.3 почти так же), взят по умолчанию (CL в most_v2.py). Тележка: прорезь «Н» — два язычка 8×8×**0.6** от краёв ±X, кончики сходятся в центре со щелью 0.8, на обоих нажимники (вместе 2.4×3, до ленты 0.2). Точка нажатия снова в центре тележки (сдвиг 5.2 из 19.52 больше не нужен); жмёшь у любого края — давит свой язычок; усилие ~450 г, если туго — толщина 0.5 (T_TG). **Что где (всё в репо):** [2-0/most_v2](https://github.com/Korvova/gitar/tree/main/2-0/most_v2) — генератор моста most_v2.py (вся геометрия: лоток, крышка с рельсами-хвостом, лента, пластина, кнопки, тележка, накладка; параметры в шапке), most_v2_blender.py + most_v2.blend, stl/, asm/; [2-0/most_test](https://github.com/Korvova/gitar/tree/main/2-0/most_test) — проба на столе: most_test.py (берёт геометрию из most_v2), telezhki_zazor.py (тележки с разным зазором), most_test_blender.py + most_test.blend, stl/ (01 корпус, 02 пластина с ячейками, 03 крышка, 04 лента, 05 тележка); [2-0/full_v5](https://github.com/Korvova/gitar/tree/main/2-0/full_v5) — полный макет с приводом: full_v5.py (берёт teleskop_v3 + most_v2), full_v5_blender.py (1 модуль, анимация), full_v5_x4_blender.py (4 модуля), .blend, stl/ (01–15). **Как запустить дома:** venv с build123d + trimesh; из папки детали `python most_test.py` (или most_v2.py / full_v5.py) → stl/ и asm/; сцену: `blender -b -P most_test_blender.py` (скрипты ищут asm/ рядом с собой). Проверки в генераторах печатают «проверка: ЧИСТО» и для каждого STL герметичность и нависание. | 🔄 Печать тележки |
| 19.54 | **Проба балки v2: одинаковый шаг 8.5, П в одну сторону, широкий язычок тележки** (13.11) | Правки после сборки 19.52–19.53. **Кнопки с одинаковым шагом 8.5:** ±4.25, ±12.75, ±21.25 — длина осталась 50 (как гриф), крайние в ходе телескопа ±22; торцы корпуса срезаны до 0.8, штырьков нет — крышку пока на клей, крепление потом. **Лента 49.6×7.2:** все П-прорези в одну сторону (перекладина к −X, корень к +X), бугорки 4×4 на язычках. **Тележка 20×14.4, зазор хвоста 0.2:** один широкий П-язычок под палец 10.7×10×0.6 (узкий 5.7×4.4 жали чуть не ногтем), нажимник 1.6×3 ровно над центром кнопки, усилие ~320 г; **перекладина П тележки на той же линии, что перекладина П ленты — линии совпали = можно жать** (видна тёмная щель сквозь обе прорези). Без накладки и без зуба упора. Проверка: пересечений нет, ход чистый, STL герметичны, без поддержек. Только в тестовом наборе — полный макет full_v5 пока со старой расстановкой. Код [most_test.py](https://github.com/Korvova/gitar/blob/main/2-0/most_test/most_test.py) (база — [most_v2.py](https://github.com/Korvova/gitar/blob/main/2-0/most_v2/most_v2.py)), сцена most_test_blender.py + most_test.blend, [STL](https://github.com/Korvova/gitar/tree/main/2-0/most_test/stl): 01 корпус, 02 пластина с ячейками, 03 крышка, 04 лента, 05 тележка; asm/ для сцены. Запуск: `python most_test.py` → stl/ и asm/, `blender -b -P most_test_blender.py` → .blend | 🔄 Печать дома |
