Korvova/gitar/wiki/t-sborka-lazernaja-rezka.md

Как собрать тренажёр «мотор в тележке» быстро и как продукт: **всё плоское — фанера лазерной резкой по заказу**, на принтере — только мелкие детали сложной формы (тележки, шестерни, рейки, корпуса тележек), остальное — алюминий из магазина и шурупы. Механика — [Т. Моторчик в тележке](/homepage/iniciativa.-razrabotka/jepik-ruka-gitara/t-motorchik-v-telezhki), контур корпуса — классика из [Т. Корпус и дека](/homepage/iniciativa.-razrabotka/jepik-ruka-gitara/t-korpus) (480 × 370, глубина 95).

Сцена [Гитара_сборка_фанера.blend](https://raw.githubusercontent.com/Korvova/gitar/main/2-0/%D0%93%D0%B8%D1%82%D0%B0%D1%80%D0%B0_%D1%81%D0%B1%D0%BE%D1%80%D0%BA%D0%B0_%D1%84%D0%B0%D0%BD%D0%B5%D1%80%D0%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) (кадр 1 — собрано, кадр 120 — разлёт, пробел — анимация; цвет — из чего деталь: светлое дерево — фанера на лазер, оранжевое — печать, серое — алюминий, полупрозрачное — ПЭТ, зелёное — электроника), скрипт [scene_sborka_fanera.py](https://github.com/Korvova/gitar/blob/main/2-0/scene_sborka_fanera.py).

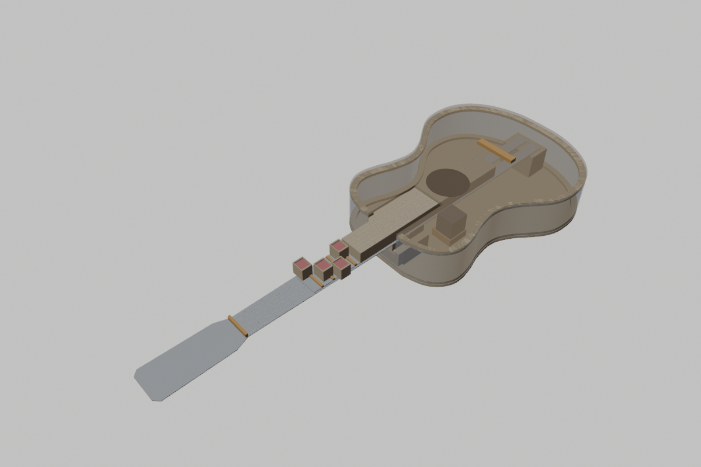
[picture p68: wiki/img/lazer_sborka_sobrano.png]
Сборка — собрано


## Этап 1. Корпус (01.11)

| Номер | Требование | Описание | Урок | Статус |
|---|---|---|---|---|
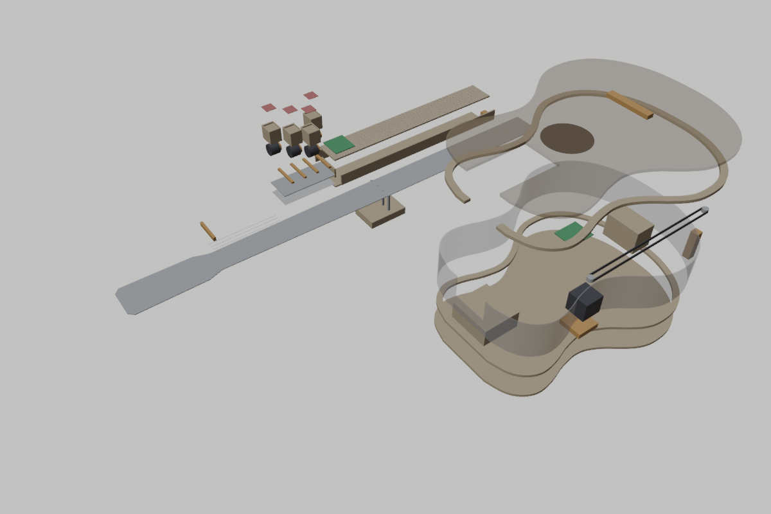
[picture p69: wiki/img/lazer_sborka_razlet.png]
Сборка — разлёт
| 20.1 | Корпус из фанеры лазерной резкой | «Бутерброд»: **дно** 6 мм → **кольцо дна** (рамка по контуру шириной 13) → **бока** → **кольцо деки** → **дека** 6 мм; внутри — склеенные из фанеры **брусок под пятку грифа** (4 винта М4) и **брусок в хвосте**. Всё скручивается шурупами и клеится. Разлёт — порядок сборки:  | На 3D-принтере корпус печатался бы днями кусками и всё равно гнулся (Т. Корпус и дека, 3.2) — плоское на лазере быстро, ровно и жёстко. Свой фрезер TTC3018 режет поле 300 × 180 — корпус и гриф целиком не влезают, поэтому резку заказываем; фанера дешевле пластика и легче, держит шурупы, клеится любым клеем | ✅ Решение |
| 20.2 | Бока — полоса ПЭТ 1.5 мм | Полоса ПЭТ/PETG или полистирол 1.5–2 мм высотой с глубину корпуса огибает фанерные кольца дна и деки, клеится или на мелкие шурупы; в боку у грифа — проём, в него входит гриф и уходит короб толкателя | Сама полоса форму не держит — держат кольца. Печатать бока сегментами можно, но это десятки часов печати | ✅ Решение |
| 20.3 | ~~Прозрачная дека из оргстекла~~ | ~~Чтобы сквозь деку было видно механику~~ | ~~Владелец 01.11: «лишнее, там не так уж и красиво». Оргстекло ещё и в 2–3 раза дороже фанеры, хрупкое у винтов~~ | ❌ Отклонено |
| 20.11 | Пропорции настоящей классики: корпус с XII лада | Владелец 01.11: у настоящей гитары часть ладов на деке — **гриф входит в корпус на XII ладу, 325 мм от порожка**, лады 13–19 — на продолжении грифа по деке. У нас было 480 мм до корпуса — гитара на 15 см длиннее настоящей. Теперь корпус сдвинут к XII; на высоких позициях (IX–XII) платформа с тележками **заезжает в окно в деке** (±38 — тележки выступают за край грифа), короб толкателя уходит под деку; розетка — рисунок на деке (отверстие открыло бы короб), подставка — на мензуре 650 | Откуда взялось 480: из концептов платформы 19.19–19.25 — весь ход платформы с 4 тележками до XII хотели уместить на грифе; с настоящей гитарой не сверили. Плюс: консоль грифа короче (325 вместо 480) — прогиб растёт как куб длины, втрое меньше | ✅ Решение |
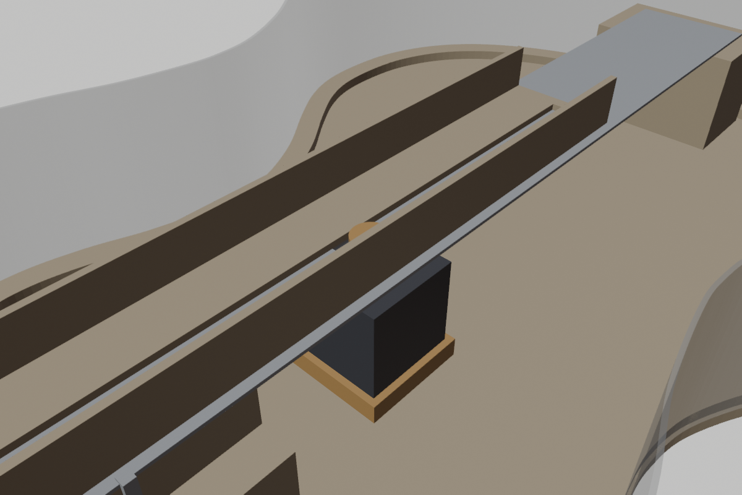
[picture p70: wiki/img/lazer_sborka_vnutri.png]
Внутри корпуса
| 20.4 | Дека над коробом толкателя | Короб толкателя во всю высоту грифа (20.7) уезжает в корпус — дека поднята над ним: верх деки вровень с грифом (как у электрогитары). Внутри: NEMA17 толкателя на печатной стойке, его шестерня через паз в дне грифа цепляет рейку под коробом; место под плату питания. Без деки:  | Можно и как у классики — дека ниже, а над ней накладка-туннель («продолжение грифа») для короба | ⚠️ Концепт |

## Этап 2. Гриф (01.11)

| Номер | Требование | Описание | Урок | Статус |
|---|---|---|---|---|
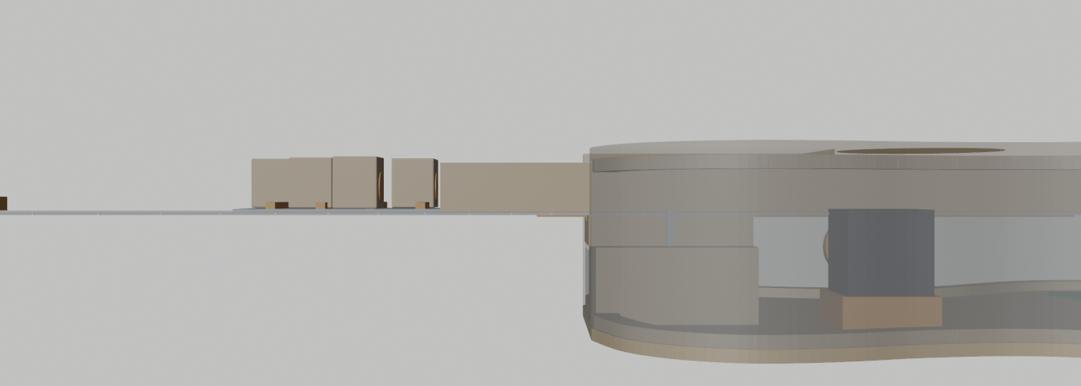
[picture p71: wiki/img/lazer_sborka_sboku.png]
Гриф сбоку
| 20.5 | Гриф = платформа с тележками высотой ~27 мм | Владелец: тележка с 4 гимбалами сделана так, чтобы высота была как у настоящего грифа. Мотор GB1806 — 22 мм, на всё остальное ~3–5 мм: **дно грифа 1.5** + **платформа 1.5** (скользит по дну на плёнке PTFE) + мотор + **ложе**; от дна до ложа 27.2 мм. **Дно грифа плоское** — ни ребра, ни полукруглой спинки. Перед платформой — плоское дно со струнами, метки ладов на торцах дна (мензура 650). Тележки ходят поперёк ±22 (6 струн, шаг 8.8) и на крайних струнах выходят за края грифа 52. Сбоку:  | Первый вариант сцены — дно грифа из двух слоёв фанеры с алюминиевым ребром-клином и печатной спинкой (19.26) — владелец отклонил: гриф — это сама платформа | ✅ Решение |
| 20.12 | ~~Снизу гриф конусом — клин~~ → пятка только в корпусе | ~~Клин под плоским дном: у порожка 1 мм, у XII 16 мм — 9 фанерных пластин треугольного профиля на ребро~~. Посчитали: у XII гриф вышел бы 27 + 16 = **43 мм** против ~24 у настоящей. Владелец 01.11: «слишком толстый, не обхватить, неудобно» — по грифу клина нет, утолщение осталось **только в корпусе**: пятка грифа на бруске (фанерные пластины, 4 винта М4) | Жёсткость от толщины растёт в кубе — клин помогал сильно, но рука важнее. Ширина даёт жёсткость только пропорционально (20.13) — остаются материал дна и платформа на коробе толкателя (20.8) | ⚠️ Пересмотрено 01.11 |
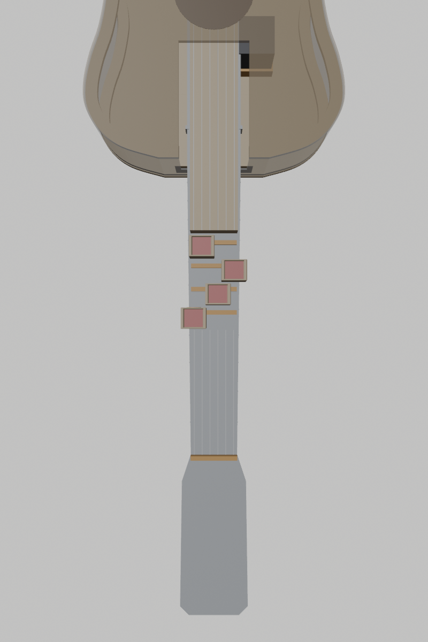
[picture p72: wiki/img/lazer_sborka_sverhu.png]
Сверху
| 20.13 | Гриф расширяется к корпусу | Как у настоящей: **52 мм у порожка → 60 у XII**, дальше в корпусе 60 (у классики ~62 у XII). Расширяется дно грифа и пятка; платформа и короб толкателя остаются 52 и едут по дну; метки ладов — по краю. Струны пока параллельные (шаг 8.8): у настоящей к XII расходятся до ~10 мм — можно повторить прошивкой (у каждой тележки свой мотор с датчиком), но для крайних струн на XII нужен ход ±25 вместо ±22 — решить с прошивкой. Сверху:  | Жёсткость от ширины 52 → 60 растёт только на ~10% (пропорционально ширине) — главное здесь вид и рука | ✅ Решение |
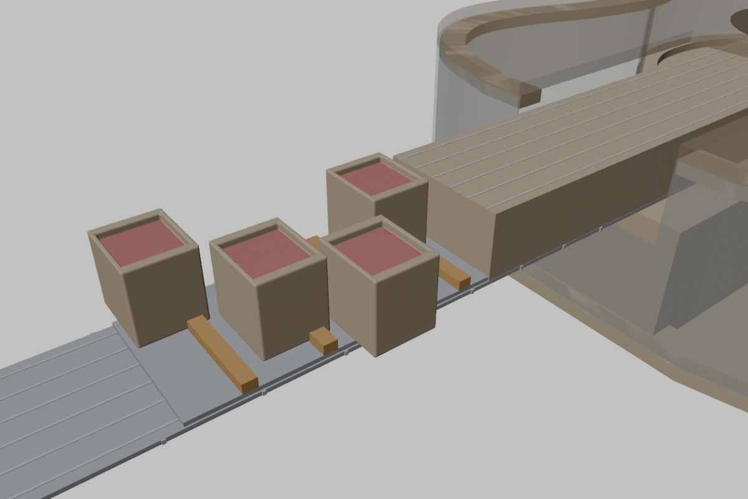
[picture p73: wiki/img/lazer_sborka_klavishi.png]
Клавиши
| 20.6 | Тележки в корпусах-«клавишах» | У каждой тележки свой корпус: гладкая коробочка со скруглёнными углами в цвет короба толкателя, сверху выемка под палец с мягкой накладкой (бортики выемки — бортики ложа). Мотор и шестерня внутри.  | Общий короб на 4 тележки был бы ~76 мм шириной (ход 44 + тележка 28 + стенки) — гриф под рукой в полтора раза шире настоящего. Между клавишами пока видны рейки — можно утопить в пазы платформы или закрыть накладками | ⚠️ Концепт |
| 20.7 | Толкатель — короб во всю высоту грифа | Владелец: толкатель из корпуса толкает платформу; должен быть высотой с гриф — красивее. Короб 52 × 27 из фанеры 3 мм (верх, 2 бока, дно, торец с окном под провода), сверху нарисованы струны. **Внутри — плата ESP32 + 4 драйвера** (у переднего конца) и провода. Двигает короб рейка в пазу его дна (20.14) — снаружи не видна | Плата на платформе была открытой зелёной плашкой — в коробе её не видно, платформа короче | ⚠️ Концепт |
| 20.14 | Привод толкателя — рейка в пазу дна короба | Было: рейка снизу короба, шестерня NEMA17 через **паз посередине дна грифа** — паз ослаблял дно ровно посередине и был виден перед платформой (с IV лада). **Стало (01.11, идея владельца):** паз — **в дне самого короба** (он нужен и так: через него выходят провода), вдоль одного края паза внутри короба — **рейка зубьями вбок** (POM или оргстекло, лазер). NEMA17 стоит в корпусе **осью вверх** под полом канала, его горизонтальная шестерня m1 z16 через окошко в полу входит в паз снизу и цепляет рейку; мотор крутит туда-сюда — короб ездит весь ход ~289 мм. Паз смотрит вниз, на дно грифа — снаружи не виден даже когда короб выдвинут; **дно грифа целое**, окошко под шестерню только в корпусе. NEMA17 крутит наша плата TMC2209. Внутри (без деки и верха короба): Рейка в дне короба | Промежуточный вариант — ремень GT2 на двух шкивах в корпусе (хомут на хвосте короба) — тоже прятал всё в корпусе, но лишние шкивы и натяжение; рейка в пазу проще. Рейка сбоку короба не годится: при 29 см хода ~10 см зубьев выходили бы из корпуса на бок грифа | ✅ Решение |
| 20.15 | Провода от тележек к плате | **Сколько:** на тележку 3 фазы мотора + датчик AS5048A — через ШИМ 3 провода (GND, 5 В, PWM) или через SPI 6; итого **6** (или 9) на тележку, 24–36 на все четыре. Каждая тележка ездит поперёк ±22, вся платформа — вдоль грифа; плата ESP32 + 4 драйвера — в коробе толкателя (20.7). **Основной вариант — плоский шлейф (FFC ~0.15 мм) «катящейся петлёй»**, как у головки принтера: петля U в вертикальной плоскости в щели за каждой тележкой (один конец — на боку тележки, другой — на платформе; высоты 22 мм хватает), дальше шлейф плашмя по платформе под соседними клавишами (зазор 0.3) к щели в торце короба и в разъёмы платы; щели между клавишами ~5 мм вместо 3. **Упрощение:** драйвер прямо на тележке (маленькая плата: DRV8316 + AS5048A) — к тележке только питание и шина, 4 провода. **Для печатного прототипа:** тонкие силиконовые провода свободной петлёй вбок за край грифа и жгутом к коробу — некрасиво, но для механики хватит | Владелец 01.11: «провода в платформе — важная задача». Датчик 5-вольтовый — на сигнал к ESP32 делитель (Т. Моторчик 19.14) | ⬜ Ждём GB1806 — посмотреть кабель энкодера, потом шлейфы |
| 20.8 | Жёсткость грифа | **Сначала посчитали «гриф плашмя, давят сверху»:** чтобы гриф 325 мм под 2 кг гнулся ≤ 1 мм, нужна жёсткость ~2.3·10⁸ Н·мм² — плоская пластина ~55 мм её не даёт ни из чего: алюминий 2 мм мягче в ~90 раз, сталь 3 мм — в ~9, карбон 3 мм — в ~14 (по жёсткости как сталь, только легче), сталь 5 мм — в ~2. Жёсткость даёт высота (растёт в кубе — поэтому мосты делают коробами и фермами) → запасной путь: короб толкателя из алюминиевой профильной трубы 50 × 25 × 1.5 (жёсткость ~2·10⁹, ×9 к нужной), платформа жёстко на трубе, труба в длинной гильзе в корпусе. **Владелец 01.11: гитару держат боком, а не плашмя — так что разобрали, что гриф гнёт на самом деле:** (1) вес и наклоны — гнут пластину по ширине, на ребро: 55 × 2 мм так ~2·10⁹ даже из алюминия — прогиба нет; (2) пальцы давят в ложа, большой палец сзади навстречу — сжатие в одном месте, силы гасят друг друга на платформе, гриф целиком почти не гнётся; (3) тележки ездят поперёк — опять по ширине, на ребро. Гнут поперёк только неуравновешенные нагрузки: рука тянет гриф на себя, удар, гитару прислонили головой — небольшие и редкие; для них хватает стали 2–3 мм или алюминия 3 мм (спружинит и вернётся) | Считать надо по тому, как инструмент держат и как на него давят, а не по худшему случаю «плашмя». Владелец 01.11: «по факту наш гриф-пластина — лишь опора, чтобы боком было удобно держать». Паза под рейку в дне больше нет (20.14) — дно целое | ✅ Проверено 01.11: напечатанная полоса **PLA** 2.5 × 295 мм, заполнение 100% (52 → 58, стол 104, [test_polosa_grifa.py](https://github.com/Korvova/gitar/blob/main/2-0/test_polosa_grifa.py), в описании скрипта указан PETG, но напечатана PLA — подтвердил владелец 06.11) боком держит крепко. Прикидка к этой полосе (берёза E ~9–12 ГПа, PLA ~3.5 ГПа, гриф 325 длиннее полосы: прогиб ×1.34): авиафанера 2 мм ~1.1–1.5 раза, фанера 3 мм ~4 раза. 06.11 владелец: печатал и пластину 2 мм — довольно крепкая (размеры и материал не записаны). **Решение владельца 06.11: основание грифа ~2–2.5 мм из авиационной берёзовой фанеры** (в бюджете 19.38 — 2.5). Запас по жёсткости небольшой, настоящую полосу из авиафанеры ещё не держали в руках; если будет мягко — алюминий 1.5 мм (~3 раза) |

## Этап 3. Заказ резки

| Номер | Требование | Описание | Урок | Статус |
|---|---|---|---|---|
| 20.9 | Список деталей на лазер и DXF | **Фанера:** дно, кольцо дна, кольцо деки, дека с окном (6 мм); пластины брусков пятки и хвоста (6 мм); пластины пятки грифа (6 мм); короб толкателя — верх, бока, дно, торец (3 мм). **Авиафанера берёзовая 2 мм (20.8, решение 06.11):** дно грифа с головой. **Фанера 1.5 мм или алюминий:** платформа. **ПЭТ:** полоса на бока. **Печать:** клавиши-тележки, шестерни, рейки, порожек, стойка мотора, шестерня толкателя. Чертежи DXF — послойно из сцены | Резку заказывать, когда механика устоится на GB1806: от неё зависят высота грифа, паз под рейку и место под электронику | ⬜ После стенда GB1806 (19.16) |
| 20.10 | Сборка шурупами — как продукт | Детали в пазах и на шурупах, без подгонки по месту; инструкция с картинками — как у секции-1 | Владелец 01.11: «по факту останется шурупами скрутить — и будет рыночный продукт» | ⬜ После 20.9 |
