Korvova/gitar/wiki/index.md

Тренажёр для обучения игре на гитаре: устройство ведёт левую руку ученика. На грифе
четыре тележки, в них вставлены пальцы. Моторы в деке двигают тележки поперёк грифа —
пальцы сгибаются и разгибаются, как при зажатии струн, и ученик руками запоминает
аккорды и переходы. Всё печатается на 3D-принтере и собирается на винтах.

Отличие от того, что есть на рынке: карманные тренажёры аккордов и смарт-гитары вроде
AeroBand AG01 показывают или слушают, но руку не ведут. Наш тренажёр сам ставит пальцы,
а тактильные подсказки (вибро в тележках, браслет) переносят опыт «как играет мастер»
на руки ученика.

## Исходная постановка задачи

*Как было задумано вначале. Суть не изменилась — четыре тележки ведут пальцы; привод с тех пор другой: вместо шнура и барабана NEMA 14 — лента и кривошип на моторе Ø36 (см. [Т. Гриф](/homepage/iniciativa.-razrabotka/jepik-ruka-gitara/t-grif)).*

на грифе гитаре 4-ре тележечки рядом примерно по 1.5 см одна тележечка с бортиками,
которые перемещаются перпендикулярно грифу, расстояние между тележечками примерно 1 мм.

Так как ширина грифа 5 см, то тележечка может перемещаться от края до края.
Длина пути будет около 4 см.

в эти тележечки будут вставляться пальцы, что при перемещении тележечки палец будет
сгибаться и разгибаться эмитируя реальную игру на гитаре когда мы зажимаем струны.

Движение тележечки осуществляется через ленту (оплетку) (Плетеный шнур KAME PE MAX
4X 0.5 мм) которая идет в грифе по боковым каналам слева и справа и фиксируется на
барабане моторчика (Шаговый двигатель NEMA 14) который зафиксирован в деке.

всего 4-ре таких моторчика чтобы управлять всеми 4-мя тележками.

каждая полость где идет тросик имеет свой этаж чтобы не пересекаться с другими.
Так как толщина грифа 2 см получается одна полость имеет около 5 мм. на конце полости
стоит подвижный ролик диаметром 5 мм, чтобы на изгибе не было большого трения тросика.

гриф и дека все сборное то есть печатается на 3д принтере слои и собираются,
также и все детали печатаются и собираются.

## Текущее состояние

| Узел | Состояние |
|---|---|
| Привод тележек | ⌛ 12.10: **мотор прямо в тележке** — гимбал-мотор GB1806 на ребро, шестерня по рейке поперёк грифа; концепт 4 тележек готов, моторы к заказу — [Т. Моторчик в тележке](/homepage/iniciativa.-razrabotka/jepik-ruka-gitara/t-motorchik-v-telezhki). Механика с мотором в деке и магнитные приводы — 💤 (история в [📜 Хронике](/homepage/iniciativa.-razrabotka/jepik-ruka-gitara/hronika)) |
| Гриф с тележками | ⌛ Короткий гриф с приводом «палка» собран 26.09, все 4 тележки ездят; под мотор в тележке гриф перерисовывается (карманы поперёк, открытые бока) |
| Плата управления | ✅ Плата 4 шаговых моторов (TMC2209) изготовлена 25.09; для моторов в тележках нужны драйверы FOC — [Т. Моторчик в тележке](/homepage/iniciativa.-razrabotka/jepik-ruka-gitara/t-motorchik-v-telezhki) 19.14–19.15 |
| Корпус и дека | ⌛ Спроектированы полностью, напечатаны частично |
| Тактильная обратная связь | ⬜ Браслет и вибро в тележках — не начаты |
| Струны (правая рука) | Вспомогательная проверка: узел щипка на датчиках Холла собран и работает, дальше пока не развиваем |

## Доступы и ресурсы

* Репозиторий: [github.com/Korvova/gitar](https://github.com/Korvova/gitar) — модели,
  столы печати, прошивки, эта документация в папке `wiki/`
* Модели генерируются кодом (build123d), STL и столы печати — в репозитории
* Плата: своя плата 4 моторов (ESP32 DevKit + 4 × TMC2209 S2209 V4 + PD-триггер), прошивка `plata4_fw`, COM-порт зависит от машины
* Печать: Bambu Lab P2S, PETG HF, слой 0.2, без поддержек
* Две рабочие машины: проект ведётся с обеих через этот репозиторий; порт платы
  COM8 на первой, COM6 на второй, окружение — на странице [Прошивка ESP32](/homepage/iniciativa.-razrabotka/jepik-ruka-gitara/proshivka-esp32)

## Оглавление

**Сейчас в работе**

* [Т. Моторчик в тележке](/homepage/iniciativa.-razrabotka/jepik-ruka-gitara/t-motorchik-v-telezhki) — мотор прямо в тележке, шестерня по рейке: компоновка 4 тележек, выбор мотора (GB1806), электроника, стенд одного пальца
* [Т. Сборка: лазерная резка](/homepage/iniciativa.-razrabotka/jepik-ruka-gitara/t-sborka-lazernaja-rezka) — корпус и короб толкателя из фанеры лазерной резкой, гриф = платформа с тележками ~27 мм, тележки в корпусах-«клавишах»; открытый вопрос — жёсткость грифа
* [📜 Хроника](/homepage/iniciativa.-razrabotka/jepik-ruka-gitara/hronika) — что происходило в проекте и чем кончилось, новые сверху

**В работе и в планах**

* [Т. Тележки](/homepage/iniciativa.-razrabotka/jepik-ruka-gitara/t-telezhki) — тележки с ложем для пальцев: посадка, удобство для любой руки, потом вибро и кнопка
* [Т. Софт](/homepage/iniciativa.-razrabotka/jepik-ruka-gitara/t-soft) — прошивки, пульты в браузере, калибровка и мелодии, скрипты моделей, столов, плат и вики
* [Т. План](/homepage/iniciativa.-razrabotka/jepik-ruka-gitara/t-plan) — дорожная карта до производства (этап 1 писался под привод «палка», см. 1.8)
* [Т. Корпус и дека](/homepage/iniciativa.-razrabotka/jepik-ruka-gitara/t-korpus) — форма классической гитары
* [Т. Электроника и звук](/homepage/iniciativa.-razrabotka/jepik-ruka-gitara/t-elektronika) — датчики, прошивки, MIDI
* [Т. Перемещение по грифу рукой](/homepage/iniciativa.-razrabotka/jepik-ruka-gitara/t-peremeshchenie-po-grifu) — идея «затвор» под большим пальцем: как ученик сам задаёт сдвиг позиции
* [Т. Тактильная обратная связь](/homepage/iniciativa.-razrabotka/jepik-ruka-gitara/t-taktilka) — браслет, вибро, LED
* [Архитектура и стек](/homepage/iniciativa.-razrabotka/jepik-ruka-gitara/arxitektura) — как устроен код моделей
* [Печать и сборка](/homepage/iniciativa.-razrabotka/jepik-ruka-gitara/pechat-sborka) — столы печати и крепёж
* [Прошивка ESP32](/homepage/iniciativa.-razrabotka/jepik-ruka-gitara/proshivka-esp32) — заливка без BOOT, окружение машин, чтение Serial

**Привод «палка» (мотор в деке → лента → плечо) — 💤 отложено 12.10, остаётся рабочим референсом**

* [Т. Гриф и аппликатура](/homepage/iniciativa.-razrabotka/jepik-ruka-gitara/t-grif) — тележки, привод «палка», моторы
* [Т. Гриф под тележки](/homepage/iniciativa.-razrabotka/jepik-ruka-gitara/t-grif-pod-telezhki) — секция-1 v2: тележки на расстоянии пальцев V позиции
* [Т. Гриф в деке](/homepage/iniciativa.-razrabotka/jepik-ruka-gitara/t-grif-v-deke) — дека с четырьмя моторами по шагам
* [Т. Инструкция по сборке: гриф с моторами](/homepage/iniciativa.-razrabotka/jepik-ruka-gitara/t-instrukcija-grif) — секции 2 и 3 с лентами, дека с моторами
* [Т. Сборка гриф](/homepage/iniciativa.-razrabotka/jepik-ruka-gitara/t-sborka-grif) — пошаговый чек-лист сборки грифа, деки и корпуса
* 💤 [Т. Вариант с тележками](/homepage/iniciativa.-razrabotka/jepik-ruka-gitara/t-variant-s-telezhkami) — рычаг, шатун, сектор R14, спарник (стенды 81–100)
* [Т. Гипоидная передача](/homepage/iniciativa.-razrabotka/jepik-ruka-gitara/t-gipoidnaja-peredacha) — заметка владельца 10.10: шестерня в деке → перпендикулярная шестерня → тележка

**Магнитные приводы — 💤 отложено**

* 💤 [Т. Магнитный + Кривошип](/homepage/iniciativa.-razrabotka/jepik-ruka-gitara/t-magnitnyj-krivoshyp) — приблуда в деке толкает ленту, стенд 90 — тянет слабо (18.16)
* 💤 [Т. Магнитная версия 2.0](/homepage/iniciativa.-razrabotka/jepik-ruka-gitara/t-magnitnaja-versija-2) — магнитный стержень + бегущая катушка: расчёты, опыты 4×2 и Ø15
* 💤 [Т. Магнитная версия](/homepage/iniciativa.-razrabotka/jepik-ruka-gitara/t-magnitnaja-versija) — плоское русло со скобой 20×10×5
* 💤 [Т. Инструкция по сборке: магнитное русло (проба)](/homepage/iniciativa.-razrabotka/jepik-ruka-gitara/t-instrukcija-magnit) — стол 86

**Готово ✅**

* [Гриф в деке от астра](/homepage/iniciativa.-razrabotka/jepik-ruka-gitara/t-grif-v-deke-ot-astra) — дека A2/A3 с четырьмя моторами Ø36, собрана в коротком грифе 26.09

* [Т. Сборка короткий гриф](/homepage/iniciativa.-razrabotka/jepik-ruka-gitara/t-sborka-korotkij-grif) — стенд: секция-1 + секция-2 + дека с 4 моторами + плата, проверка всех четырёх тележек
* [Т. Плата для 4-х моторов](/homepage/iniciativa.-razrabotka/jepik-ruka-gitara/t-plata-4-motora) — своя плата: разводка, изготовление на станке, травление, пайка, проверка
* [Т. Плата для мотора](/homepage/iniciativa.-razrabotka/jepik-ruka-gitara/t-plata) — стенд одного мотора: ESP32 + драйвер S2209, проверенная схема
* [Т. Инструкция по сборке](/homepage/iniciativa.-razrabotka/jepik-ruka-gitara/t-instrukcija-sborki) — сборка руками по шагам с картинками: этап А, полная стопка, файлы для печати
* [Т. Положение тележек](/homepage/iniciativa.-razrabotka/jepik-ruka-gitara/t-polozhenie-telezhek) — как узнать, где тележка: хоминг по упору, датчики Холла по ленте в деке, стенд проверки
* [Т. Струны](/homepage/iniciativa.-razrabotka/jepik-ruka-gitara/t-struny) — вспомогательная проверка: узел щипка правой руки
