Korvova/gitar/wiki/t-magnitnaja-versija-2.md

Текущее направление (03.10): **магнитный стержень + бегущая катушка**. Поперёк грифа неподвижно лежит стержень из дисковых магнитов, сложенных полюсами навстречу (N-S-N-S); по нему ездит короткая катушка-муфта, к ней прямо крепится ложе пальца. Ток в катушке толкает её вдоль стержня — сильно, тихо, без рычагов, лент, шестерёнок и люфта. Катушка — в две фазы, как шаговый мотор, поэтому подключается к нашей плате с TMC2209 вместо мотора: пульт, калибровка струн и мелодии работают как есть. Как к этому пришли — ниже, этап 1; прежние варианты отложены: [Т. Вариант с тележками](/homepage/iniciativa.-razrabotka/jepik-ruka-gitara/t-variant-s-telezhkami) (механика, стенды 81–85), [Т. Магнитная версия](/homepage/iniciativa.-razrabotka/jepik-ruka-gitara/t-magnitnaja-versija) (плоское русло со скобой, стол 86). Расчёты — в репозитории `2-0/magnit/`.

## Этап 1. Как пришли к стержню (03.10)

| Номер | Требование | Описание | Урок | Статус |
|---|---|---|---|---|
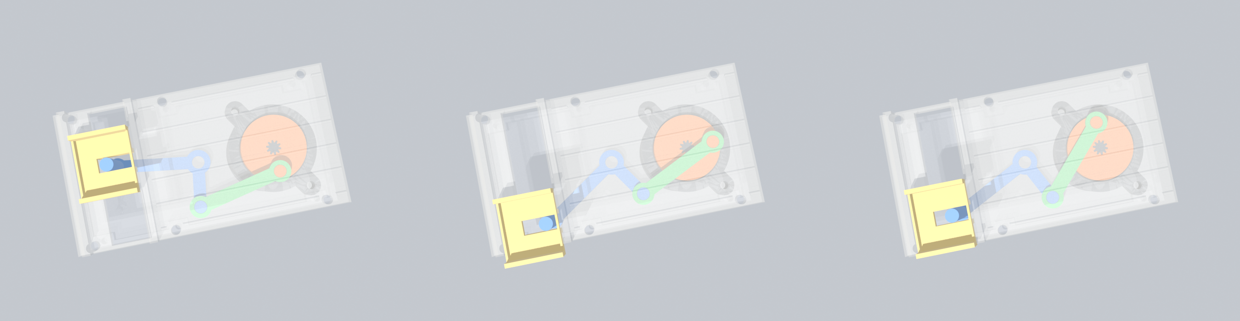
[picture p74: wiki/img/mini2_verh_strip.png]
Стенд с шатуном
| 17.1 | ~~Механика с рычагом и шатуном — закусывает~~ | ~~Стенд одного пальца с шатуном прямо на кривошипе (стол 82/85) собран и поехал, но в месте, где шатун тянет плечо под острым углом (31°), закусывает. Посчитано, что дальний мотор и ход на пол-оборота дают 46–51°, но остаётся рычаг, люфт и шум шестерёнок.  Расчёты: [sim_mini2.py](https://github.com/Korvova/gitar/blob/main/2-0/sim_mini2.py) (MuJoCo), [shatun_sektor.py](https://github.com/Korvova/gitar/blob/main/2-0/shatun_sektor.py), [shatun_dlinnyj.py](https://github.com/Korvova/gitar/blob/main/2-0/shatun_dlinnyj.py), [shatun_polovina.py](https://github.com/Korvova/gitar/blob/main/2-0/shatun_polovina.py)~~ | ~~Владелец: «честно скажу не нравится — давай попробуем на магнитах»~~ | 💤 Отложено |
| 17.2 | {green}(Сравнение магнитных схем на силу 3 Н (~300 г) под палец) | {green}(Посчитано magpylib на одном русле 52 мм, гриф до 25 мм. **Плоское одностороннее** (магниты на каретке над плоскими катушками) — 40–100 Вт, мёртвые точки; со сталью под катушками прижим 15 Н съедает тягу ([ploskij_odnostoronnij.py](https://github.com/Korvova/gitar/blob/main/2-0/magnit/ploskij_odnostoronnij.py)). **U-скоба** с 6 магнитами 20×10×5 — ~9 Вт ([compare_magnets.py](https://github.com/Korvova/gitar/blob/main/2-0/magnit/compare_magnets.py)). **Магнит в трубке, катушки на трубке** — ~5 Вт, но штифт к ложу не выйти сквозь витки; магнитная муфта через намотку тянет 4.5–5.8 Н, зато прижимает ~10 Н ([trubka_magnit_vnutri.py](https://github.com/Korvova/gitar/blob/main/2-0/magnit/trubka_magnit_vnutri.py), [trubka_mufta.py](https://github.com/Korvova/gitar/blob/main/2-0/magnit/trubka_mufta.py)). **Магниты стоят, катушка едет (стержень)** — ~3 Вт и ложе прямо на катушке) | {green}(Катушка, которая охватывает магнит со всех сторон, использует почти весь его поток — в 2–3 раза выгоднее, чем магниты с одной стороны. Почему NEMA сильнее: железо и зазор 0.05 мм, 50 зубьев) | ✅ Выбран стержень |
| 17.3 | {green}(Почему полюса чередуются и зачем 2 фазы) | {green}(У сплошного длинного магнита поле выходит наружу только у концов — в середине катушку не толкает, как ни меняй ток. Встречные группы (N к N) выталкивают поле наружу через каждый полюс — «точки опоры» по всему ходу. Одна катушка над серединой полюса стоит в мёртвой точке, поэтому 4 отсека: A = 1 + 3 наоборот, B = 2 + 4 наоборот, сдвиг четверть периода — как педали велосипеда; плата подаёт синус/косинус и бегунок едет непрерывно) | {green}(Это не «одна толкает, другая тянет»: каждый отсек толкается сам — ток поперёк поля магнитов) | ✅ |

## Этап 2. Расчёт стержня

| Номер | Требование | Описание | Урок | Статус |
|---|---|---|---|---|
| 17.4 | {green}(Диаметр магнитов и полюс) | {green}(N52, катушка-бегунок 4 отсека, намотка 4 мм ([sterzhen_diametr.py](https://github.com/Korvova/gitar/blob/main/2-0/magnit/sterzhen_diametr.py)): Ø10×10 — 500 г за 9 Вт; Ø12×12 — 5 Вт; **Ø15 с полюсом 15 мм (3 диска 15×5) — 500 г за 2.7 Вт, 1 кг за 11 Вт**; Ø20 — 1.7 Вт, но катушка Ø30 не влезает ни по высоте грифа, ни между пальцами (шаг 24–26). Полюс 15 у дисков 15×5 заметно лучше, чем 10 (5 Вт)) | {green}(Предел — высота грифа: катушка вокруг Ø15 выходит Ø24. Диски 15×5 удобнее цельных: дозируются по кассетам) | ✅ Ø15×5, полюс из 3 дисков |
| 17.5 | {green}(Диаметр катушки) | {green}(Магниты Ø12, 4 отсека ([sterzhen_katushka_diametr.py](https://github.com/Korvova/gitar/blob/main/2-0/magnit/sterzhen_katushka_diametr.py)): снаружи Ø17 — 3 Н за 4.1 Вт, **Ø20 — 3.1 Вт**, Ø23 — 2.9, Ø30 — 2.5, Ø36 — 2.3 Вт при 78 г меди) | {green}(Около Ø20–24 оптимум: дальше витки дальше от поля, катушка тяжелеет в разы, а сила почти не растёт) | ✅ |
| 17.6 | {green}(Ток, нагрев, удержание) | {green}(Без железа сила прямо пропорциональна току, нагрев — квадрату: вдвое сильнее — вчетверо горячее. Большой ток — короткими рывками на переход (0.2–0.5 с), держать — малым: на Ø12 удержание 1 Н ≈ 0.3 Вт, 2 Н ≈ 1.3 Вт (ток удержания 20/50/100% уже есть в пульте). TMC2209: ~1.4 А долго, 2 А пик. PETG гильза — до 60–70 °C, магниты — до 80 °C) | {green}(Без тока бегунок стоит свободно (нет «залипания»). Держать без питания — защёлкой (соленоиды с самоблокировкой SDO у владельца есть) или лёгким тормозом) | ✅ |
| 17.7 | {green}(Соседние стержни) | {green}(Поле стержня с чередованием полюсов падает очень быстро: у витков 0.106 Тл, на 10 мм 0.007, на 24 мм (соседний палец) **0.0003 Тл** — меньше 0.3 %. Экран не нужен) | {green}(С магнитами Ø15 у соседа будет ~2–3 % — тоже незаметно; если понадобится — тонкая сталь между руслами) | ✅ |
| 17.8 | Положение без датчиков | Плата считает шаги, струны калибруются в пульте как сейчас. Если палец передавит удержание, катушка соскочит на целый период (16 мм на дисках 4×2, 30 мм на Ø15) — плата не заметит. Поэтому потом: один датчик Холла на краю — «ноль» при включении; при нужде — у струн или полная обратная связь | Сначала без датчиков: проверить, хватает ли удержания | ⬜ Ждёт опыта 17.12 |

## Этап 3. Опыт на дисках 4×2 (стол 87)

| Номер | Требование | Описание | Урок | Статус |
|---|---|---|---|---|
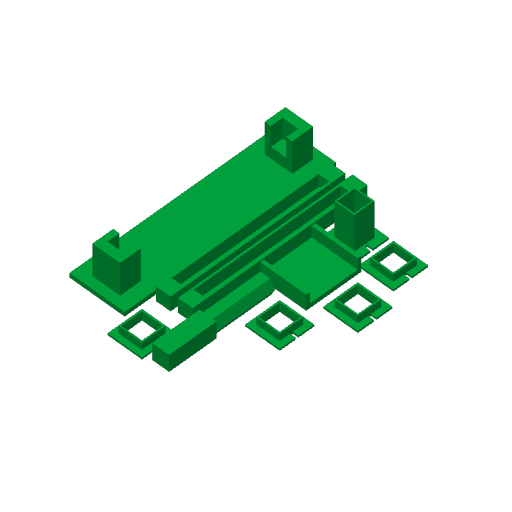
[picture p75: wiki/img/mag_stol87_v2.png]
Стол 87
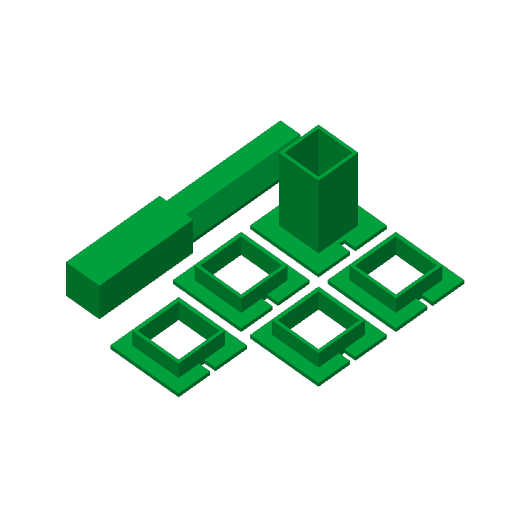
[picture p76: wiki/img/mag_stol88_gilza.png]
Стол 88 — гильза
| 17.9 | {green}(Детали опыта) | {green}(Идея владельца: стержень квадратный снаружи (катушка не крутится), склейка суперклеем. [gitara_sterzhen_proba.py](https://github.com/Korvova/gitar/blob/main/2-0/magnit/gitara_sterzhen_proba.py), всё без поддержек. **Стол [87_sterzhen_proba.3mf](https://raw.githubusercontent.com/Korvova/gitar/main/2-0/Print3mf/87_sterzhen_proba.3mf)**: стержень одной деталью 6.4 × 6.4 × 76 с открытым сверху жёлобом 4.6 под диски, концы сразу в пазы стоек; основа со стойками (ось стержня 10.5 над столом), ложе, ось для намотки 7.35 (квадрат + шестигранник под шуруповёрт). **Стол [88_gilza_sekcii.3mf](https://raw.githubusercontent.com/Korvova/gitar/main/2-0/Print3mf/88_gilza_sekcii.3mf)** — гильза по рисунку владельца: трубка со щёчкой (дырка 7.5) + 4 насадки «щёчка + втулка» — втулка сама задаёт отсек 3.2 при шаге 4.0; щёчки 15 × 15, ~42 витка на отсек. Проверка хода ±22.6 — чисто.  ) | {green}(04.10 переделки по ходу: кассеты 5.6 со стрелками печатались плохо — стержень одной деталью; цельная гильза лёжа печаталась плохо — сборная; дырка 6.8 и 7.0 туго (стержень вышел 6.5 × 6.3) — 7.5. Ожидание 50–90 г было для гильзы вплотную к магнитам; на насадках витки дальше (r 5.1–7.5) — по расчёту ~11 г при 0.8 А, см. 17.12) | ✅ Напечатано 04.10 |
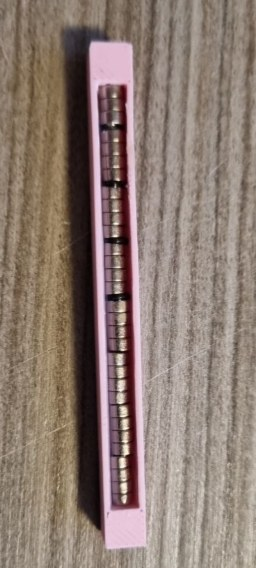
[picture p77: wiki/img/foto_sterzhen_sobran.jpg]
Стержень собран
| 17.10 | {green}(Сборка стержня) | {green}(Диски 4×2 — в жёлоб стержня группами по 4 навстречу (N-S-N-S), каждая группа на капле суперклея, полярность — маркером. Владелец в часть стыков поставил стальные шайбы — сравнить силу; последняя группа — 3 диска. ) | {green}(Соседние группы отталкиваются — вставлять по одной и прижимать, пока схватится. У шайб катушка потом ехала заметно лучше (17.12)) | ✅ Собрано 04.10 |
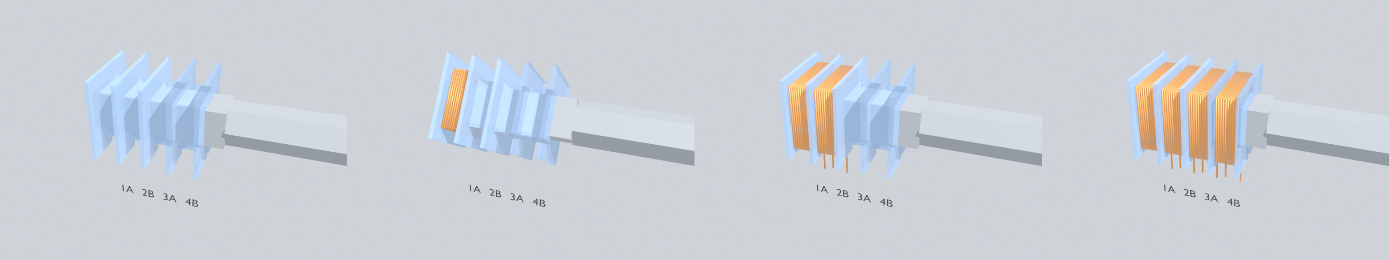
[picture p78: wiki/img/mag_namotka_gilzy.png]
Намотка гильзы
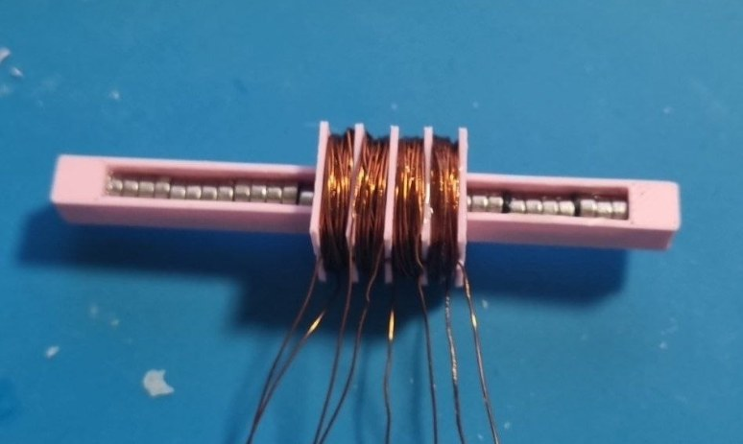
[picture p79: wiki/img/foto_gilza_namotana.jpg]
Гильза намотана
| 17.11 | {green}(Намотка гильзы) | {green}(Гильзу на ось для намотки, шестигранник в шуруповёрт, малые обороты; отсеки 1 → 4 по очереди, **все в одну сторону**, ~50 витков, начало и конец каждого — вниз через прорезь, хвосты 10 см.  Анимация — [Как_мотать_гильзу.blend](https://github.com/Korvova/gitar/blob/main/2-0/magnit/%D0%9A%D0%B0%D0%BA_%D0%BC%D0%BE%D1%82%D0%B0%D1%82%D1%8C_%D0%B3%D0%B8%D0%BB%D1%8C%D0%B7%D1%83.blend) **04.10 намотано** (гильза из трубки + 4 насадок, стол 88): ) | {green}(Готовые катушки (CD105 и т. п.) не подходят: ферритовый сердечник без дырки, к тому же магнитный) | ✅ Намотано 04.10 |
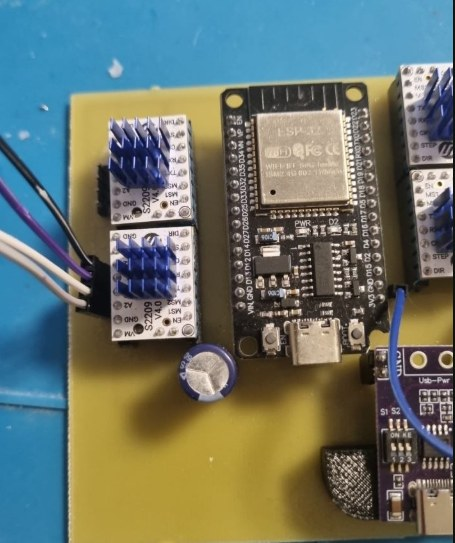
[picture p80: wiki/img/foto_plata_katushka_m3.jpg]
Катушка на драйвере мотора 3
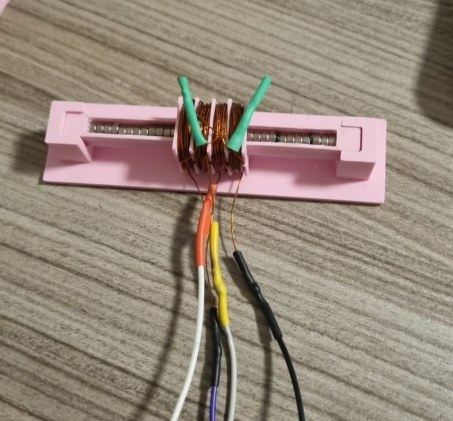
[picture p81: wiki/img/foto_katushka_na_sterzhne.jpg]
Катушка на стержне
| 17.12 | Пайка и пуск | Фаза A = отсек 1 + отсек 3 наоборот, B = 2 + 4 наоборот; к нашей плате вместо мотора, ток 0.5–0.8 А; прошивка — `lim 0` (полный ход). Пульт: ◀ ▶, калибровка струн, мелодии **04.10 — поехала**: плата сама (драйвер 3 отвечает, EN и STEP доходят, катушки без обрыва и замыкания); удержание 900 мА — гильза «защёлкивается» через 4 мм; с пульта ±5° (≈ ±11 мм) ездит влево-вправо. Мотор 3 = нижний левый драйвер; провода: серый (1) + белый (3) — фаза A, синий (2) + чёрный (4) — фаза B. В пульте 1° ≈ 2.2 мм хода.   | Сила маленькая, как и ждали от дисков Ø4: по расчёту ~11 г при 0.8 А, ~21 г при 1.5 А — витки на насадках дальше от магнитов (r 5.1–7.5). **Там, где в стыках стальные шайбы, едет заметно лучше** — подтверждает 17.17. Пальцем сила 10–15 г не ощущается — проверять стержнем вертикально | ⚠️ Едет 04.10, слабо |

## Этап 4. Настоящий палец и дальше

| Номер | Требование | Описание | Урок | Статус |
|---|---|---|---|---|
| 17.13 | Магниты Ø15×5 N52 | Заказано 03.10: набор 15 шт — ровно на один стержень: 5 полюсов по 3 диска (15 мм) = 75 мм. Под них — кассеты, гильза Ø24 и стойки перерисовать после опыта 17.12 | Бегунок с полюсом 15 длиннее (~31 мм) — в крайних положениях выходит за край грифа сильнее ложа: решать (2 отсека вместо 4 или чуть шире гриф у тележек) | ⌛ Едут |
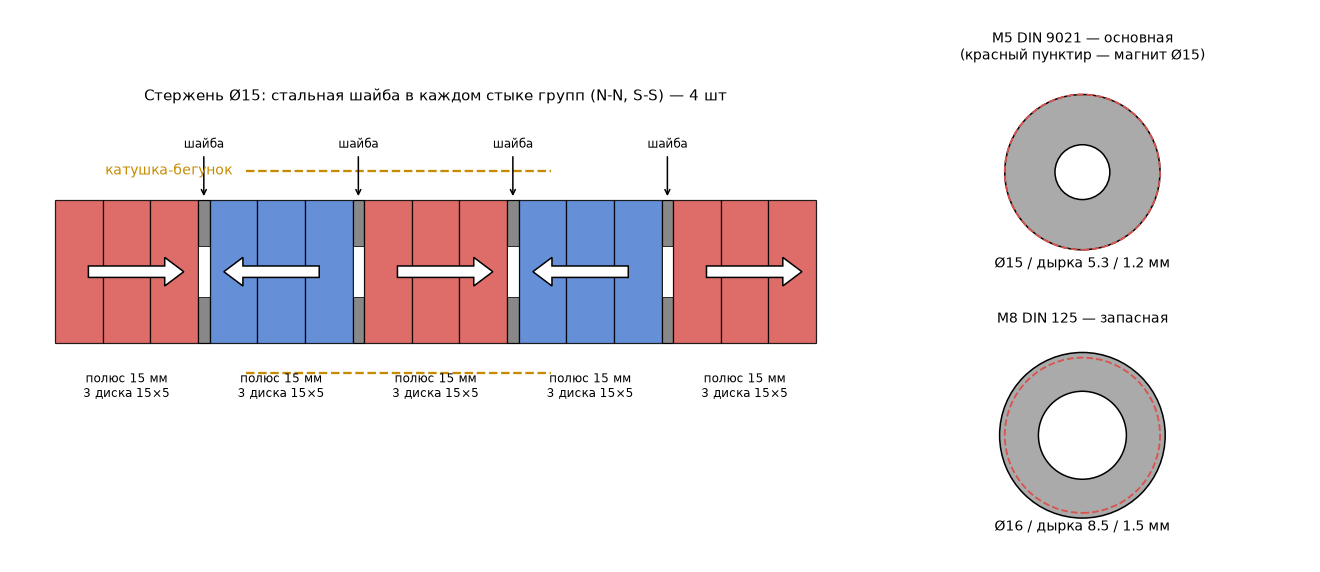
[picture p82: wiki/img/mag_shaiby_sterzhen.png]
Шайбы в стержне
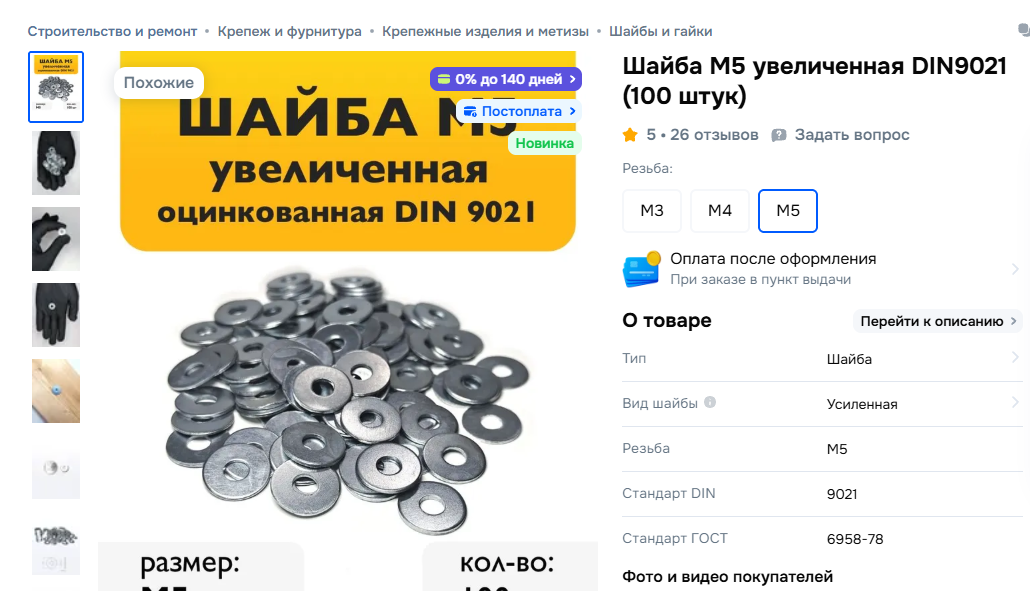
[picture p83: wiki/img/kup_shaiba_m5_din9021.png]
Шайба М5 DIN 9021
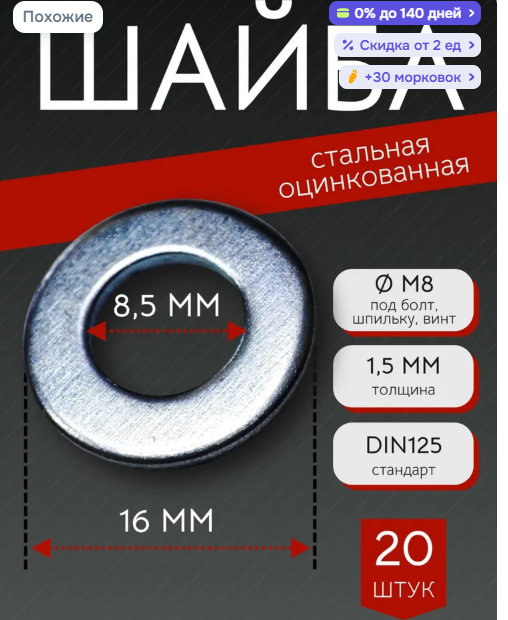
[picture p84: wiki/img/kup_shaiba_m8_din125.png]
Шайба М8 DIN 125
| 17.17 | Стальные шайбы между полюсами | Сталь в стыках групп (N-N, S-S) выталкивает поле наружу, к катушке: по плоскому расчёту ([fem_shaiby.py](https://github.com/Korvova/gitar/blob/main/2-0/magnit/fem_shaiby.py)) шайбы 1–2 мм дают **+22 % силы** (ватты на ту же силу ×0.67), а вместе с неподвижным стальным жёлобом вокруг — до ×1.5–1.65. Заказано 04.10: **шайба М5 увеличенная DIN 9021** (Ø15 / дырка 5.3 / 1.2 мм, 100 шт) — ровно по диаметру магнита, основной вариант; **шайба М8 DIN 125** (Ø16 / 8.5 / 1.5 мм, 20 шт) — запасной. На стержень из 5 полюсов — 4 шайбы (или 8, если по две в стык).  Что купили:   | Шайба должна быть по диаметру магнита: шире — торчит из стержня и отодвигает катушку, уже (Ø9 у владельца) — работает только середина. Дырка в центре почти не мешает. Оцинковка не влияет; нержавейку не брать. Тонкая сталь насыщается — сколько слоёв в стык, досчитать с насыщением | ⬜ Едут |
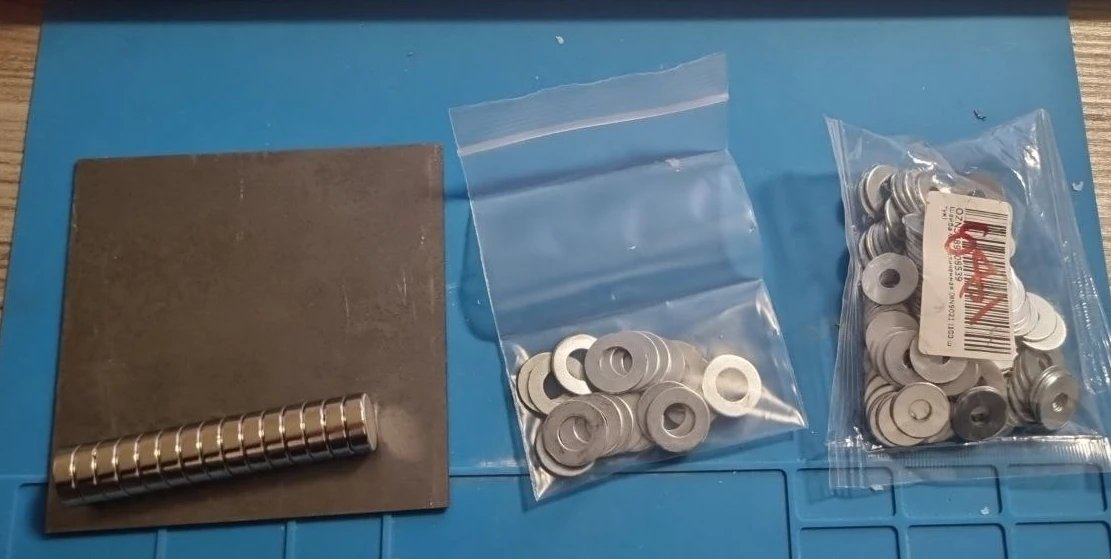
[picture p85: wiki/img/foto_prishlo_magnity_shaiby.jpg]
Пришло
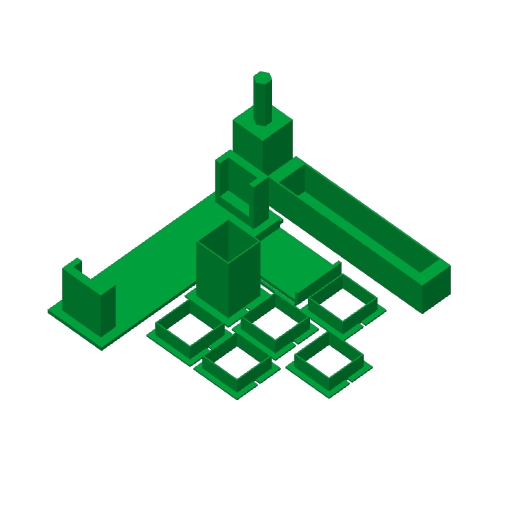
[picture p86: wiki/img/mag_stol89.png]
Стол 89
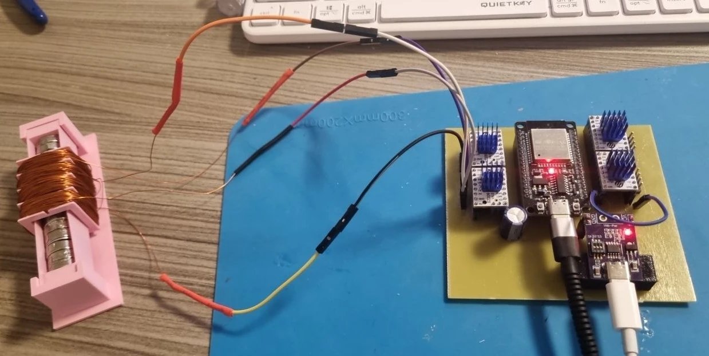
[picture p87: wiki/img/foto_stol89_namotan_stal.jpg]
Намотано стальной
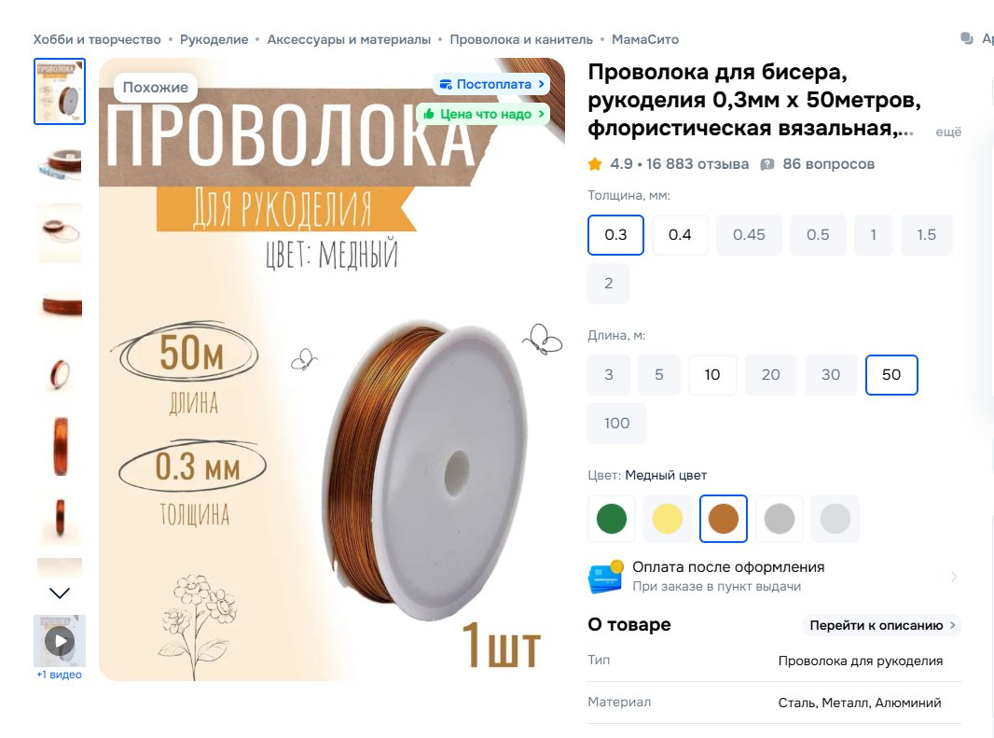
[picture p88: wiki/img/kup_provoloka_stal_oshibka.jpg]
Ошибка — проволока
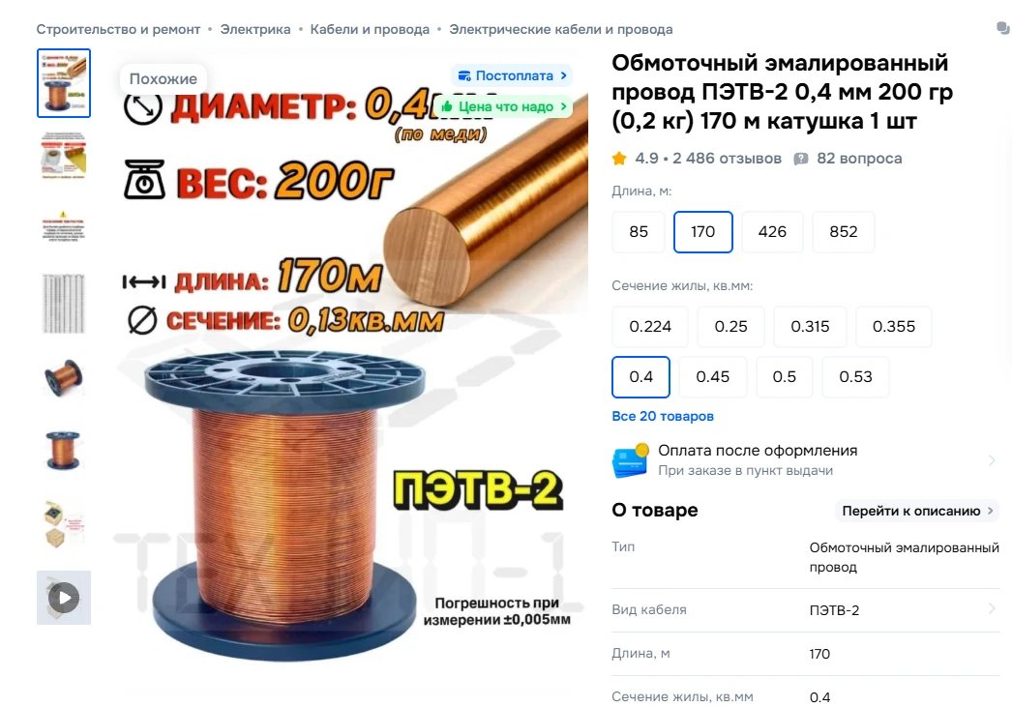
[picture p89: wiki/img/kup_provod_petv2_04.jpg]
ПЭТВ-2 0.4
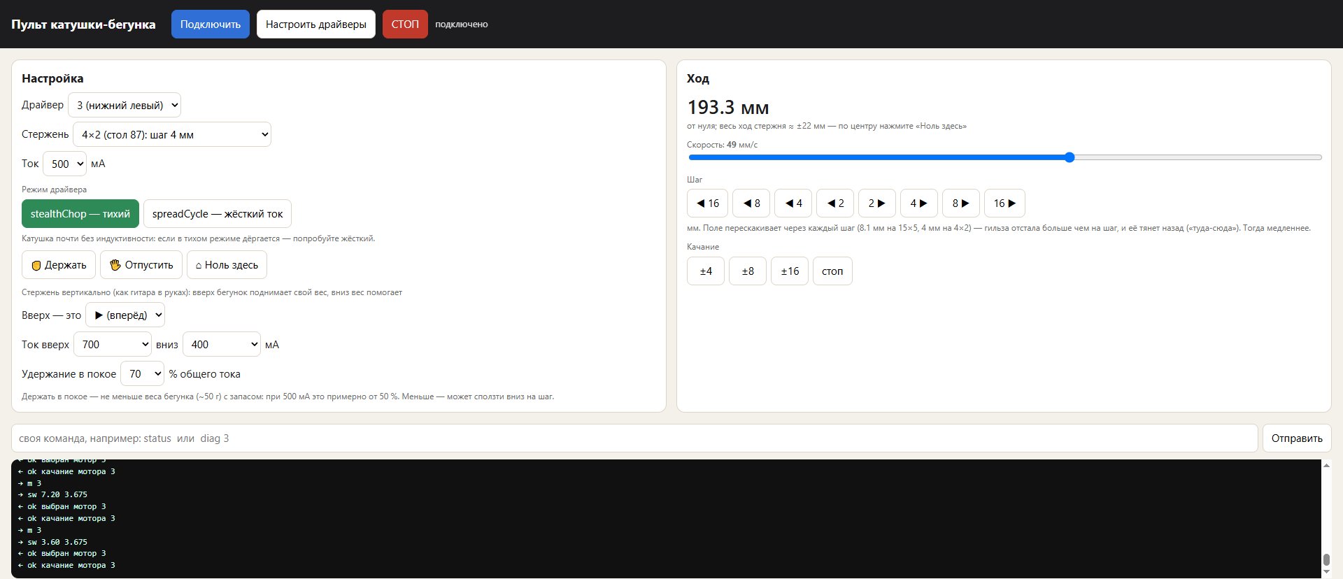
[picture p90: wiki/img/soft_katushka_pult_horosho.jpg]
Пульт — настройка, где хорошо ходит
| 17.18 | {green}(Стол 89: стержень на дисках 15×5) | {green}(Пришли 05.10 диски, шайбы М5 и М8, лист 1.5 . [gitara_sterzhen_15.py](https://github.com/Korvova/gitar/blob/main/2-0/magnit/gitara_sterzhen_15.py), стол [89_sterzhen_15.3mf](https://raw.githubusercontent.com/Korvova/gitar/main/2-0/Print3mf/89_sterzhen_15.3mf): брус 17 × 17 с жёлобом 15.4 — 5 групп по 3 диска навстречу, между группами по одной шайбе М5 (шаг полюсов 16.2); гильза 26 × 26 — трубка со щёчкой + 4 насадки, отсеки 7.3 с шагом 8.1; основа (ось 16), ложе, ось намотки с шестигранником 7 по центру. Ход ±22.5 — чисто. 3D МКЭ с насыщением ([fem3d_zhelob.py](https://github.com/Korvova/gitar/blob/main/2-0/magnit/fem3d_zhelob.py)): 1 шайба М5 ×1.15, 2 шайбы ×1.16, 3 — ×1.13; + неподвижный П-жёлоб ×1.31, + труба со щелью ×1.34. Ожидание при ~120 витках 0.3: 0.3 А ≈ 150 г, 0.5 А ≈ 245 г  07.10 намотано — не поехало : провод оказался стальной проволокой для бисера . Заказан медный ПЭТВ-2 0.4 мм, 170 м  — с ним ~70–90 витков на отсек, фаза ~2 Ом, ~250 г при ~0.85 А **08.10 перемотано медью 0.4 — едет**: 500 мА, spreadCycle, качание «±16» в пульте — ровно, с заметной силой (пульт тогда считал шаг 4 мм как у стержня 4×2; на 15×5 полный шаг 8.1 мм, так что на деле было ±32 мм — больше хода, гильза доезжала до стоек; 08.10 в пульте добавлен выбор стержня). Шаг «4» в пульте (на деле 8.1) ходит хорошо влево-вправо. **08.10 настройка, на которой хорошо ходит туда-сюда** ([пульт катушки](https://github.com/Korvova/gitar/blob/main/2-0/websim/katushka_pult.html)): драйвер 3, режим stealthChop, ток 500 мА, вверх 700 / вниз 400 мА, удержание 70 %, качание `sw 3.6 3.675` — на деле ±16 мм со скоростью ~100 мм/с (в пульте был выбран стержень 4×2, поэтому на экране «±8» и «49 мм/с»; `sw 7.2` = ±32 мм — больше хода). Команды: `m 3`, `cur 500`, `spread 0`, `holdpct 70`, `up 1`, `curup 700`, `curdn 400`, `sw 3.6 3.675` ) | {green}(Проволока «для рукоделия / бисера» цвета «медный» — сталь: липнет к магниту, сопротивление в разы больше, драйвер видит «обрыв». Брать только «ПЭТВ-2 / медный эмалированный». На катушке с большим сопротивлением проверка драйвера в тихом режиме (stealthChop) врёт «обрыв» — проверять и работать в spreadCycle (`spread 1`, кнопка в пульте катушки). Стальное кольцо на бегунке не ставим — залипание в ручном режиме; жёлоб — неподвижный и потом (нужна новая основа, сталь крепить намертво, проверить прогиб стержня) Если палец передержал бегунок (или гильза упёрлась в стойку), он теряет шаг и дальше идёт «с затупом» — плата не знает, где он: нужен датчик Холла / обратная связь (17.14, 17.8).) | ✅ Едет 08.10 |
| 17.14 | Датчик Холла «ноль» | Один датчик на краю хода: при включении бегунок доезжает до него — калибровка держится между включениями | | ⬜ После 17.12 |
| 17.15 | Четыре пальца | 4 стержня с шагом V позиции 24–26, катушки Ø24 между ними помещаются, поле соседей < 3 % | Шлейф к каждому бегунку — 4 провода + потом вибро и кнопка | ⬜ Ждёт опыта 17.12 |
| 17.16 | Перемещение по ладам | Тот же принцип вдоль грифа: длинный магнитный стержень (~30 см) под накладкой, бегунок возит весь блок четырёх тележек; I–XII позиция ≈ 29 см хода. Раздвижка тележек под лады — см. 15.12 | Тихо и без ремня — та же плата, тот же пульт | ⬜ Идея |
| 17.19 | Направление отложено (12.10) | Стержень Ø15 едет (17.18), но в гриф поперёк не влезает (магниты ≥ ход + катушка), а из деки через ленту и плечо силы не хватило ([Т. Магнитный + Кривошип](/homepage/iniciativa.-razrabotka/jepik-ruka-gitara/t-magnitnyj-krivoshyp) 18.16). Привод тележек теперь — [Т. Моторчик в тележке](/homepage/iniciativa.-razrabotka/jepik-ruka-gitara/t-motorchik-v-telezhki) | Промышленные трубчатые моторы подчиняются тому же правилу длины — не наша ошибка, а физика компоновки | 💤 Отложено 12.10 |

### Отложено (03.10)

* [Т. Вариант с тележками](/homepage/iniciativa.-razrabotka/jepik-ruka-gitara/t-variant-s-telezhkami) — механика (рычаг ×2, стенды 81, 82, 85): работает, но закусывает и шумит шестерёнками.
* [Т. Магнитная версия](/homepage/iniciativa.-razrabotka/jepik-ruka-gitara/t-magnitnaja-versija) и [инструкция к столу 86](/homepage/iniciativa.-razrabotka/jepik-ruka-gitara/t-instrukcija-magnit) — плоское русло со скобой 20×10×5: запасной путь, магниты и сталь едут — можно собрать для сравнения.
