Korvova/gitar/wiki/t-magnitnyj-krivoshyp.md

Идея 08.10: линейный магнитный привод «стержень + катушка» (он уже ездит, см. [Т. Магнитная версия 2.0](/homepage/iniciativa.-razrabotka/jepik-ruka-gitara/t-magnitnaja-versija-2), 17.18) кладём **в деку вместо мотора**, а в гриф передаём ход, как раньше: лентой-спицей своего этажа и рычагом у тележки. Так гриф остаётся тонким (50 мм) — в нём только ленты и рычаги, всё неподвижное и тяжёлое в деке.

## Этап 1. Почему привод не помещается в гриф (08.10)

| Номер | Требование | Описание | Урок | Статус |
|---|---|---|---|---|
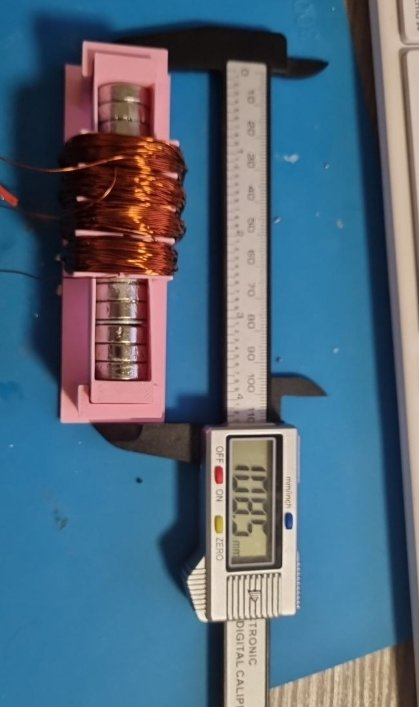
[picture p91: wiki/img/mk_shtangen_108.jpg]
Стол 89 — 108 мм
| 18.1 | {green}(Гриф 50 мм, ход тележки 44 мм) | {green}(6 струн через 8.8 мм — ход 44 мм. Стол 89 с основой — 108 мм поперёк грифа, а гриф 50 мм . Длина магнитов не может быть меньше «ход + длина катушки» = 44 + 33 = 77 мм — иначе на краях катушка съезжает с магнитов) | {green}(Неважно, что стоит, а что едет — катушка или стержень: у любого привода «катушка вокруг магнитов» общая длина 77+ мм) | ✅ Выяснено 08.10 |
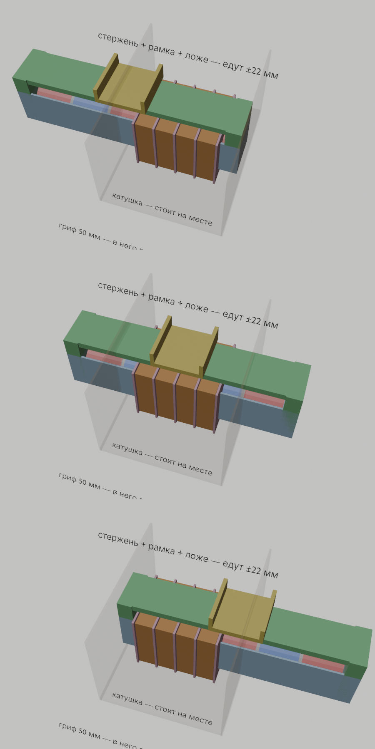
[picture p92: wiki/img/mk_ramka_3_polozhenia.png]
Рамка — 3 положения
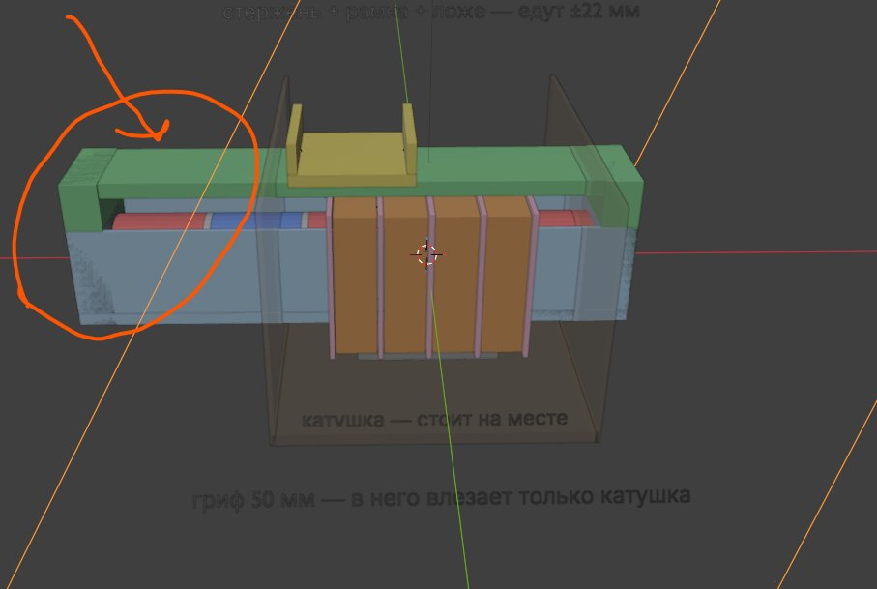
[picture p93: wiki/img/mk_ramka_vyhodit.jpg]
Выходит за гриф
| 18.2 | ~~Перевернуть: катушка стоит в грифе, стержень едет с рамкой~~ | ~~Катушка (33 мм) неподвижно в грифе, стержень с магнитами едет вместе с рамкой — стойки на концах стержня и планка над катушкой, на планке ложе. Сцена [Рамка_стержень_едет.blend](https://github.com/Korvova/gitar/blob/main/2-0/magnit/%D0%A0%D0%B0%D0%BC%D0%BA%D0%B0_%D1%81%D1%82%D0%B5%D1%80%D0%B6%D0%B5%D0%BD%D1%8C_%D0%B5%D0%B4%D0%B5%D1%82.blend) ~~ | ~~Владелец: «так у тебя выходит за гриф» — стержень 92 мм торчит на ~20 мм с каждой стороны даже в середине . Выходить за гриф может только тележка~~ | ❌ Исключено 08.10 → 18.4 |
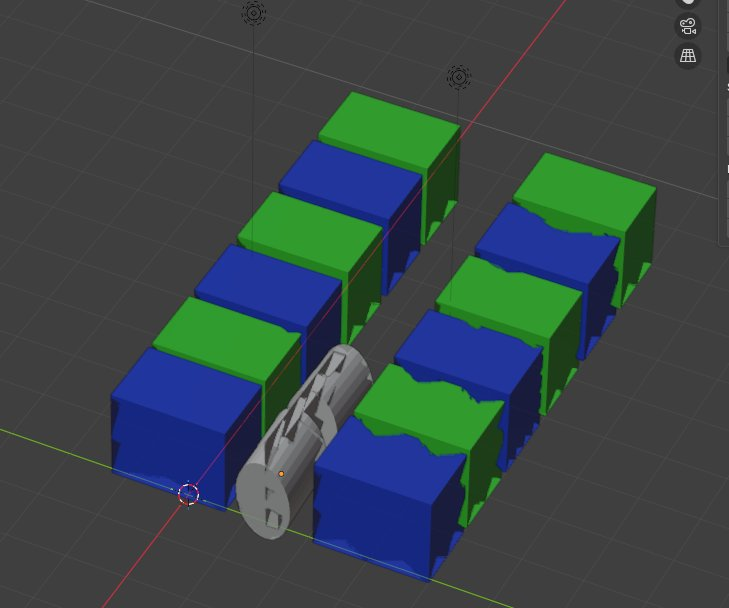
[picture p94: wiki/img/mk_magnity_sboku.jpg]
Магниты по бокам
| 18.3 | Магниты по бокам, катушка в центре (магнитная дорожка) | Идея владельца: два неподвижных ряда магнитов во всю ширину грифа, катушка едет между ними, сверху открыто — ложе прямо на катушке . Для круглой или квадратной катушки ряды должны смотреть друг на друга **одинаковыми** полюсами (N напротив N), вдоль ряда — N, S, N, S; при N напротив S нужна плоская катушка-«стадион». Ряды можно делить между соседними пальцами: ряд — катушка — ряд — катушка …, шаг ~24 мм | На краях хода катушка частично выезжает из рядов — сила ~60–70 %. Катушка едет — к тележке нужны провода. Силу не считали | ⬜ Идея, запасная |

## Этап 2. Привод в деке + передача в гриф (выбрано 08.10)

| Номер | Требование | Описание | Урок | Статус |
|---|---|---|---|---|
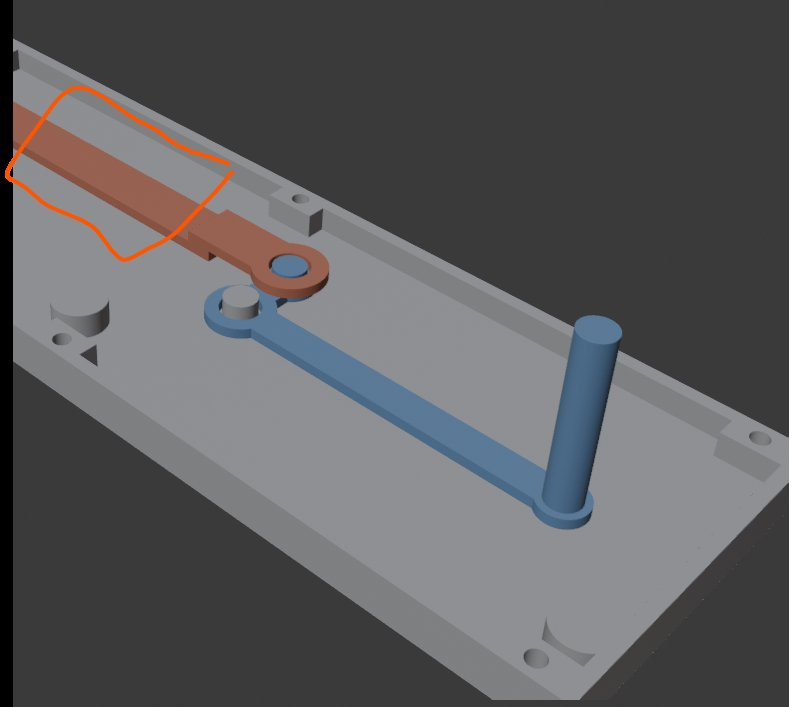
[picture p95: wiki/img/mk_krivoshyp_polzun.jpg]
Кривошип и ползун — было
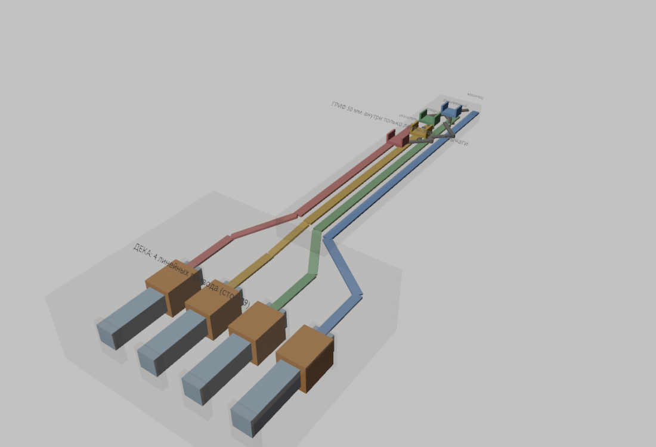
[picture p96: wiki/img/mk_deka_privody_f41.png]
Дека — 4 привода и ленты
| 18.4 | Линейный привод в деке вместо мотора | Идея владельца: как на стенде с кривошипом мотор гнал ленту-спицу , так теперь ленту толкает и тянет катушка линейного привода — **напрямую, без кривошипа и шатуна**. 4 привода (стол 89: стержень 15×5 + шайбы М5, катушка 26 × 26 × 33) лежат в деке рядом, каждый тянет ленту своего этажа . Сцена [Дека_линейные_приводы.blend](https://github.com/Korvova/gitar/blob/main/2-0/magnit/%D0%94%D0%B5%D0%BA%D0%B0_%D0%BB%D0%B8%D0%BD%D0%B5%D0%B9%D0%BD%D1%8B%D0%B5_%D0%BF%D1%80%D0%B8%D0%B2%D0%BE%D0%B4%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) — пробел запускает ход ±22 | Почему лучше мотора с кривошипом: нет угла шатуна (на стенде закусывало при 31°), нет мёртвых точек и люфта шестерён; ход привода ±22 = ход тележки; без тока ход рукой гладкий (в катушке нет железа); провода катушки короткие — в деке, к тележке проводов нет | ⬜ Идея — нарисовать в настоящей деке |
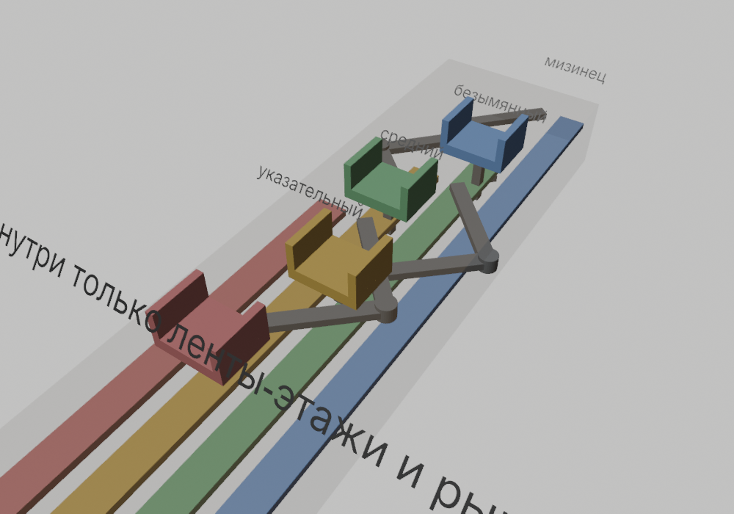
[picture p97: wiki/img/mk_rychagi_f41.png]
Рычаги у тележек
| 18.5 | Перевод хода ленты в ход тележки: рычаг-уголок 1:1 | У тележки — рычаг с двумя перпендикулярными плечами по 30 мм на оси: лента сдвинулась на s — тележка на s поперёк грифа, линейно (качание до ±47°). У каждого пальца свой этаж ленты и свой рычаг; у двух пальцев рычаги зеркальные, чтобы всё влезло в 50 мм  | Урок стенда: штыри шарниров выползают вверх — каждый узел запирать сверху. Концы плеч — штыри в пазах ленты и тележки | ⬜ Идея |
| 18.6 | Даст ли рычаг силы? | Рычаг меняет ход на силу: чтобы на тележке было ×2 силы, привод должен ходить ×2 (±44 мм — стержень из 30 дисков, вдвое медленнее). Наш привод ходит ровно ±22 — значит, рычаг 1:1, сила на тележке ≈ сила привода минус трение ленты в этаже. Привод сейчас (медь 0.4, ~80 витков на отсек): 0.5 А ≈ 250 г, 0.7 А ≈ 330 г, 0.9 А ≈ 400+ г (по расчёту) | Старый рычаг ×2 (лента ±11 → палец ±22) силу наоборот ДЕЛИЛ на 2 — здесь он не нужен. Больше силы: длиннее привод + рычаг 2:1; ток 0.9 А в движении и малый в покое (`holdpct`); П-жёлоб из стали +13 % | ⬜ Посчитать трение ленты |
| 18.7 | {green}(Привод уже работает) | {green}(Стол 89 на меди 0.4: качание и плавный ползунок положения (прошивка: `tgt`, дробление 1/32 — шаг 0.25 мм), ток вверх/вниз отдельно (`curup` / `curdn`) — против веса, когда гриф вертикально. Подробно — 17.18 Т. Магнитная версия 2.0) | {green}(Пульт катушки — [katushka_pult.html](https://github.com/Korvova/gitar/blob/main/2-0/websim/katushka_pult.html)) | ✅ Работает 08.10 |
| 18.8 | Датчики Холла — положение привода | SS49E у владельца есть. Два линейных датчика через 8.1 мм (четверть периода) неподвижно у стержня привода в деке: магниты стержня — сами себе шкала, синус/косинус → положение ~0.1 мм. Дальше: видеть отставание и прибавлять ток до проскока, в покое сбрасывать; потом — управление «как сервопривод» | Датчики стоят в деке рядом с приводом — проводов к тележке нет. Для полного сервопривода нужен драйвер с прямым заданием тока фаз (SimpleFOC и т. п.), TMC2209 умеет только шаги и ток | ⬜ Следующий опыт |
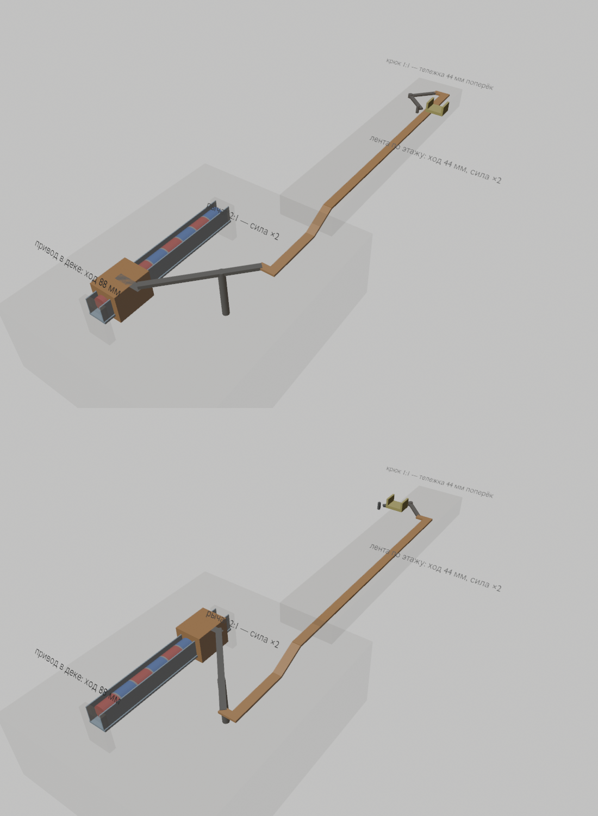
[picture p98: wiki/img/mk_rychag2k1_2pol.png]
Рычаг 2:1 — два крайних положения
| 18.9 | Рычаг 2:1 в деке — сила ×2 без лишнего нагрева | Решение владельца 08.10 «нужна нормальная сила»: привод ходит ±44 (88 мм), рычаг 2:1 в деке (плечи 60 : 30, ось посередине, концы плеч — штыри в поперечных прорезях катушки и ленты) → лента по этажу ходит как раньше ±22 (44 мм), но тянет вдвое сильнее → «крюк» 1:1 у тележки → тележка 44 мм поперёк. Один палец: сцена [Рычаг_2к1_один_палец.blend](https://github.com/Korvova/gitar/blob/main/2-0/magnit/%D0%A0%D1%8B%D1%87%D0%B0%D0%B3_2%D0%BA1_%D0%BE%D0%B4%D0%B8%D0%BD_%D0%BF%D0%B0%D0%BB%D0%B5%D1%86.blend) (пробел — ход)  | В грифе рычаг 2:1 не влезает (длинное плечо ~60 мм, гриф 50) — поэтому в деке. Для 500 г на тележке: 1:1 — ~2.7 Вт, 2:1 — ~0.7 Вт. Цена — стержень ~25 дисков 15×5 (≈128 мм магнитов) и привод едет вдвое быстрее. Ожидание: ~400 г при 0.5 А, ~550 г при 0.7 А (с запасом на трение) | ⬜ Ждёт дисков 15×5 (~10 шт) |
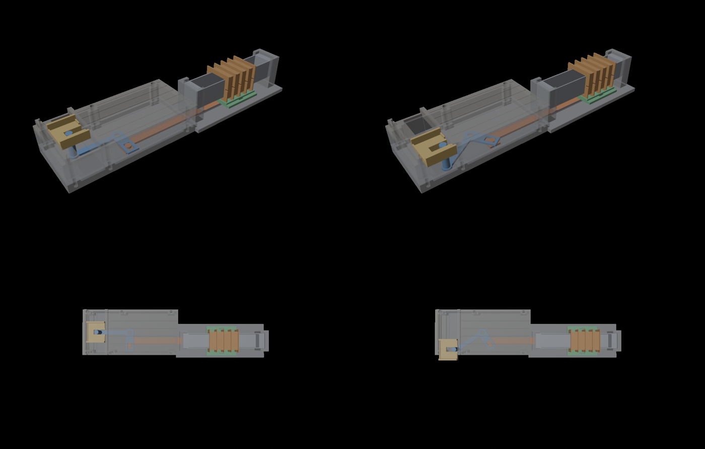
[picture p99: wiki/img/stend_pribluda_mini3.png]
Стенд на приблуде
| 18.10 | Стенд одного пальца на приблуде (вариант А, 09.10) | Стенд 81 (кусок грифа 52 × 110, плечо 36 с прорезью, ложе v3), но вместо мотора с кривошипом — приблуда со стола 89 за южным краем: ось стержня вдоль ленты (x 10) на высоте 22, под гильзой **седло** с пальцем Ø5 вниз в круглую дырку на хвосте ленты. Катушка ±10 → лента ±10 → плечо → ложе ±20. Дно и площадка приблуды — одна деталь 56 × 214 (влезает в стол P2S), лента идёт в рельсах по дну и в туннеле под северной стойкой, сверху мостики. Генератор [gitara_mini3.py](https://github.com/Korvova/gitar/blob/main/2-0/gitara_mini3.py), сцена [Стенд_один_палец_приблуда.blend](https://raw.githubusercontent.com/Korvova/gitar/main/2-0/%D0%A1%D1%82%D0%B5%D0%BD%D0%B4_%D0%BE%D0%B4%D0%B8%D0%BD_%D0%BF%D0%B0%D0%BB%D0%B5%D1%86_%D0%BF%D1%80%D0%B8%D0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) (пробел — ход), скрипт `2-0/scene_mini3.py`. **Стол [90_stend_pribluda.3mf](https://raw.githubusercontent.com/Korvova/gitar/main/3-0/Print3mf/90_stend_pribluda.3mf)**: дно с площадкой, лента, седло (пальцем вверх, юбкой на стол — дно седла мостом 26 мм); **стол [91_stend_pribluda_verh.3mf](https://raw.githubusercontent.com/Korvova/gitar/main/3-0/Print3mf/91_stend_pribluda_verh.3mf)** — середина, палуба, плечо, ложе v3, если стенд 81 не печатался. Стержень и гильза — свои со стола 89. Седло к гильзе — суперклей или стяжка через два паза. Середина хода и край, сбоку и сверху:  | Проверка сборки (`clearance.py`) на ходе ±10 шагом 2.5 — чисто (пара «дно ↔ середина» с глубиной 999 — заглушка fcl, реальное пересечение 0). Прорезь в плече не люфт: стад ленты едет по радиусу 15 → 18 мм, поперёк посадка плотная. Сила на ложе ≈ сила приблуды / 2…2.4 (~125 г при 0.5 А) — мерить безменом. Заметка для ИИ: владелец предложил проще — не печатать большое дно, а поставить основу стола 89 на подставку ~6 мм (две ножки с проходом под ленту) рядом с уже собранным стендом (81 с лентой — снять мотор и кривошип, прорезать окно 9 × 4 в южной стенке; 82/85 с шатуном — седло толкает конец шатуна). Спросить, какой стенд собран, и сделать подставку + седло + ленту | ⬜ Не напечатано |
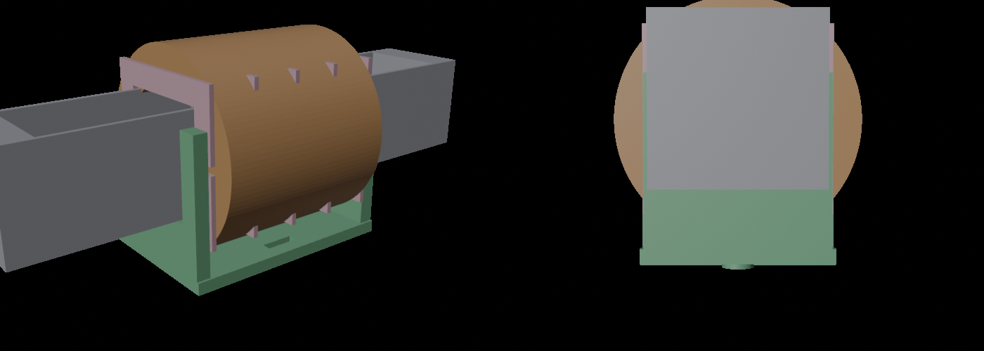
[picture p100: wiki/img/sedlo_v2_mini3.png]
Седло v2
| 18.11 | Седло v2 под толстую медь (10.10) | Владелец намотал на гильзу заметно больше меди — она выпирает за щёчки 26 мм, седло с бортиками по бокам не надевалось. Теперь: **бортиков по бокам нет**, только две торцевые вилки — обнимают крайние щёчки гильзы снаружи по оси и стержень с боков, до оси + 6 мм; пластина под медью с зазором 0.5 при меди до Ø34. Приблуда поднята: ось стержня 22 → **26 мм** над столом (стойки в дне выше), низ седла 6.5, палец Ø5 вниз в ленту — как раньше. Стол 90 пересобран: седло печатается пальцем вверх, вилками на стол, пластина мостом 33 мм между вилками — без поддержек. Медь (оранжевая — Ø34 для проверки), щёчки гильзы (розовые), седло (зелёное):  | Седло держит катушку вдоль хода за щёчки — бока не нужны, палец толкает вдоль оси. Проверка сборки на ходе ±10: медь Ø34 не задевает седло и дно. Если медь толще Ø34 — `CU_D` в `gitara_mini3.py`, перегенерировать и `make_3mf.py 90` | ⬜ Не напечатано |
| 18.12 | Файлы стенда по отдельности и катушка длиннее (10.10) | STL стенда (те же, что на столе 90): [mini3_base.stl](https://raw.githubusercontent.com/Korvova/gitar/main/2-0/Print/Print/mini3_base.stl) — дно с площадкой приблуды, [mini3_lenta.stl](https://raw.githubusercontent.com/Korvova/gitar/main/2-0/Print/Print/mini3_lenta.stl) — длинная лента, [mini3_sedlo.stl](https://raw.githubusercontent.com/Korvova/gitar/main/2-0/Print/Print/mini3_sedlo.stl) — седло v2. Для полной сборки: столы 90 + 91 (91 — если стенд 81 не печатался), стержень и гильза со стола 89 (основа 89 не нужна — стержень ложится в стойки нового дна), 6 винтов М3 × 20–25 (палуба и середина в бобышки дна), стяжка или суперклей для седла, силиконовая смазка. **Катушка длиннее = сила больше** (при том же токе сила растёт с числом отсеков; нагрев на ту же силу падает). Правило: магниты ≥ ход приблуды (±10–11 = 22 мм) + длина катушки; сейчас стержень 5 полюсов ≈ 80 мм магнитов. 4 отсека (33 мм) — нужно 55, есть: ×1, на пальце ~105 г; **6 отсеков** (50 мм) — нужно 72, есть: ×1.5, ~155 г; 8 отсеков (66 мм) — нужно 88, впритык (на краях хода катушка съезжает на ~4 мм): ~×1.8; 8 отсеков + 6-й полюс (ещё 3 диска 15×5 + шайба, 96 мм) — ×2, ~210 г; + стальная труба со щелью ×1.3 — ~270 г. Фазы для 6 отсеков: A = 1, 3 (наоборот), 5; B = 2, 4 (наоборот), 6; для 8 — A = 1, 3̄, 5, 7̄; B = 2, 4̄, 6, 8̄. Цифры на пальце — расчёт при 0.5 А и рычаге ~×2.4; рывком 0.9 А — ещё ~×1.8 | Сначала измерить безменом нынешние 4 отсека на стенде: если ~100 г — расчёту верим и выбираем 6 или 8 отсеков. Гильза под 6/8 отсеков — новая трубка длиннее и 6/8 насадок (`gitara_sterzhen_15.py`, `NSEC`), основание/дно стенда — стойки дальше под длинный стержень | ⬜ Сначала замер |
| 18.13 | Седло v3 — печать без поддержек (09.10) | Владелец: седло v2 плохо печаталось (пальцем вверх, пластина мостом 33 мм между вилками). Теперь палец Ø5 — отдельная деталь [mini3_palec.stl](https://raw.githubusercontent.com/Korvova/gitar/main/2-0/Print/Print/mini3_palec.stl): шляпка Ø8 × 1 входит в зенковку сверху пластины заподлицо, стержень — сквозь дырку Ø5.3 вниз в ленту, вклеить. Седло [mini3_sedlo.stl](https://raw.githubusercontent.com/Korvova/gitar/main/2-0/Print/Print/mini3_sedlo.stl) печатается **пластиной на стол**, вилки растут вверх — ни мостов, ни поддержек; зубцы вилок толще (4.5 вместо 3.5). Стол [90_stend_pribluda.3mf](https://raw.githubusercontent.com/Korvova/gitar/main/2-0/Print3mf/90_stend_pribluda.3mf) пересобран (+2 пальца, один запасной), проверка хода ±10 — чисто | Деталь с выступом в обе стороны от плоской пластины лучше резать на две — каждая плоской стороной на стол | ⬜ Печатается |
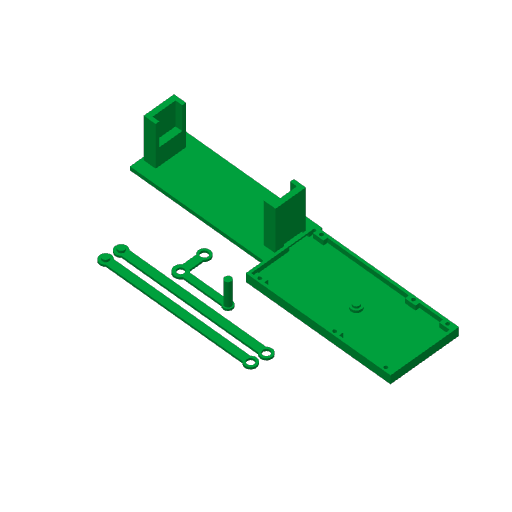
[picture p101: wiki/img/stol93_pribluda_shatun.png]
Стол 93
| 18.14 | Стенд «приблуда + шатун» — без прорези (09.10) | Идея владельца: в столе 90 палец ленты ходит в прямоугольной прорези плеча — это люфт. Здесь вместо ленты **шатун 110 мм с круглыми дырками**: палец седла катушки → задняя дырка шатуна, стад шатуна → круглая дырка на коротком плече 18. Дугу конца плеча берёт наклон длинного шатуна; катушка едет прямо — мёртвых точек нет, пальцем водится по всему ходу. Плечо 36 : 18 — катушка −9.8…+10.1 мм → ложе ±20 (сила на ложе ≈ ÷2). Худший угол передачи 54°. Генератор [gitara_mini4.py](https://github.com/Korvova/gitar/blob/main/2-0/gitara_mini4.py), стол [93_stend_pribluda_shatun.3mf](https://raw.githubusercontent.com/Korvova/gitar/main/2-0/Print3mf/93_stend_pribluda_shatun.3mf): дно (без рельсов ленты, проход шире), шатун + запасной, плечо с круглой дыркой . С других столов: середина, палуба, ложе — 91; седло и палец — 90; стержень и гильза — 89. Проверка хода — чисто | Чтобы сила не делилась, короткое плечо надо длиннее (до 36), но в стенд 52 мм больше ~22 не влезает — решать в настоящем грифе | ⬜ Печатать |
| 18.15 | Палуба v2 и длинное ложе для стендов 90/93 (09.10) | Владелец: на столе 91 короткое ложе v3 (20 мм) проваливается одним концом в прорезь палубы. Сделано как у стенда 85: длинное ложе [mini2_lozhe](https://raw.githubusercontent.com/Korvova/gitar/main/2-0/Print/Print/mini2_lozhe.stl) (лежит на палубе по обе стороны прорези) и палуба [mini1_deck_v2](https://raw.githubusercontent.com/Korvova/gitar/main/2-0/Print/Print/mini1_deck_v2.stl) — северный бортик русла +17 вместо +12. 09.10 по просьбе владельца у ложа длинные полозья ([mini2_lozhe_v2](https://raw.githubusercontent.com/Korvova/gitar/main/2-0/Print/Print/mini2_lozhe_v2.stl)): уходят сквозь прорезь палубы вниз до 9.5 над столом — штырь плеча зажат по высоте ~16 мм, а не только у дна ложа; снаружи тоньше (3.85), чтобы на краю хода не задеть стенки середины. Стол [94_paluba_v2_dlinnoe_lozhe.3mf](https://raw.githubusercontent.com/Korvova/gitar/main/2-0/Print3mf/94_paluba_v2_dlinnoe_lozhe.3mf) — вместо палубы и ложа стола 91; проверки хода стендов 90 и 93 — чисто | Та же ошибка, что на стенде 82 (03.10): исправили в mini2, а в mini1 осталось старое — при переносе деталей между стендами брать исправленные | ⬜ Печатать |
| 18.16 | Стенд 90 собран — тянет слабо (09.10) | Владелец собрал стенд 90 (приблуда → лента → плечо 36 : 15…18 → ложе): «плохо, не двигает толком». Сила катушки делится плечом примерно на 2 и съедается трением ленты в рельсах и пальца в прорези. Решение владельца: назад к мотору NEMA с большим кривошипом сектором — [Т. Вариант с тележками](/homepage/iniciativa.-razrabotka/jepik-ruka-gitara/t-variant-s-telezhkami), 14.18 | Приблуда хороша, когда толкает напрямую или с выигрышем в силе; плечо ×2 (на ход) съедает её силу. Если вернёмся к магниту — без деления силы (рычаг 1:1 или 2:1 в пользу силы, 18.6, 18.9) | ❌ Слабо 09.10 → 14.18 |
| 18.17 | Направление отложено (12.10) | Приблуда в деке с передачей лентой и плечом не дала нужной силы (18.16); привод тележек теперь — мотор прямо в тележке, шестерня по рейке: [Т. Моторчик в тележке](/homepage/iniciativa.-razrabotka/jepik-ruka-gitara/t-motorchik-v-telezhki) | Сила делилась плечом и съедалась трением ленты и пальца в прорези — каждое звено передачи забирает своё | 💤 Отложено 12.10 |
