Korvova/gitar/wiki/t-plan.md

Дорожная карта от текущего прототипа до рыночного производства. Этапы идут по
порядку, внутри этапа пункты можно вести параллельно. Сделанное зачёркиваем и ставим
✅, чтобы прогресс читался сверху вниз. Подробности по каждому пункту — на страницах
требований (ссылки в столбце «Где»).

Опорные решения: механика грифа — привод «палка» (тросы исключены), струны — шесть
картриджей на 49E, звук — BLE-MIDI без динамика, главная фишка продукта — тактильная
подсказка (вибро-браслет входит в первую продаваемую версию). Себестоимость цели
11–13 тыс ₽, первая партия 5–10 шт по ~15 тыс прямыми продажами, дальше 19–22 тыс
плюс подписка на уроки.

## Этап 0 — что уже есть

| Номер | Пункт | Что значит «сделано» | Где | Статус |
|---|---|---|---|---|
| 0.1 | ~~Механизм привода тележки выбран и проверен стендом~~ | Тележка ездит от мотора на 700 мА, ход 40 мм, качание сектором | Т. Гриф 2.10–2.11 | ✅ Готово |
| 0.2 | ~~Гриф трёх секций и дека спроектированы и напечатаны~~ | Столы 31–36, плиты, рейки, ленты, хребет | Т. Гриф 2.12–2.14 | ✅ Готово |
| 0.3 | ~~Узел шести струн работает~~ | Шесть картриджей на 49E, шум ±2–4, пульт со звуком, «как хорошие гусли» | Т. Струны | ✅ Готово |
| 0.4 | ~~Корпус спроектирован~~ | Дно, крышка, обечайка, стыки, розетка — столы 37–47 | Т. Корпус 3.1–3.4 | ✅ Готово |
| 0.5 | ~~Проект ведётся в git и вики~~ | Репозиторий Korvova/gitar, страницы требований, публикация скриптом | Эпик | ✅ Готово |

## Этап 1 — гриф едет: аппликатура

| Номер | Пункт | Что значит «сделано» | Где | Статус |
|---|---|---|---|---|
| 1.1 | Тест силы на 20 В | NEMA14 на стенде от PD-триггера 20 В тянет тележку на рабочей скорости без пропусков шагов. Решение по мотору: остаёмся на NEMA14 (тогда колодцы деки пересчитать — сейчас они под NEMA17) или берём 4 × NEMA17 | Т. Гриф 2.9, 2.15 | ⬜ Не начато |
| 1.2 | Прошивка четырёх каналов | ESP32 качает четыре мотора секторами независимо, принимает позиции тележек по USB/Wi-Fi, рампы, ограничение хода, смена позиции 0.1–0.3 с | Т. Гриф 2.6, Т. Электроника 4.13 | ⬜ Не начато |
| 1.3 | Сборка секции-1 с декой и четырьмя моторами | По чек-листу «Т. Сборка гриф» до шага Д7: все четыре тележки ездят от кривошипов | Т. Сборка гриф | ⚠️ Частично — секция-1 с четырьмя станциями собрана и проверена руками 13.09.2026; хребет перепроектируется под моторы Ø36 (напечатан под NEMA17) |
| 1.4 | Калибровка хода и люфтов | Каждая тележка проходит 40 мм, гистерезис на реверсе измерен и скомпенсирован сектором в прошивке | Т. Гриф 2.11 | ⬜ Не начато |
| 1.5 | Аппликатура | Таблица аккордов и табулатур → позиции четырёх тележек; проигрывание последовательности в темпе метронома | Т. Гриф | ⬜ Не начато |
| 1.6 | Истинная позиция тележки | Датчик угла на оси плеча: ловля пропуска шагов, ручной режим (ученик двигает тележки сам, система видит и оценивает) | Т. Гриф 2.7 | ⬜ Не начато |
| 1.7 | Положение тележки по ленте (магнит + 49E в деке) | Стенд подтвердил формат «датчик под лентой» (194 единицы на 12 мм при шуме ±1.5); дальше — карман под магнит в лентах, стойки v2 под лентой, стол, проверка на деке | Т. Положение тележек 6.3, 6.7–6.9 | ⚠️ Частично |
| 1.8 | Привод тележек (обновление 12.10) | Пункты 1.1–1.4 и 1.6–1.7 писались под привод «палка» (мотор в деке → кривошип → лента → плечо). Привод сменён: мотор прямо в тележке, шестерня по рейке, датчик угла AS5048A на моторе; история — [📜 Хроника](/homepage/iniciativa.-razrabotka/jepik-ruka-gitara/hronika) | [Т. Моторчик в тележке](/homepage/iniciativa.-razrabotka/jepik-ruka-gitara/t-motorchik-v-telezhki) | ⌛ В работе |

### Заметки по этапу 1 — шаг за шагом

* **09.09.2026 — печать под ручной тест цепочки (к 1.3).** На печать уходят шесть столов, файлы
  в репозитории: [31_gitara_sec1_plity](https://raw.githubusercontent.com/Korvova/gitar/main/2-0/Print3mf/31_gitara_sec1_plity.3mf) (4 плиты P0–P3), [32_gitara_sec1_meh](https://raw.githubusercontent.com/Korvova/gitar/main/2-0/Print3mf/32_gitara_sec1_meh.3mf) (палуба, 4 плеча, 4 спицы, 4 тележки; слой 0.12, брим на
  штыри), [33_gitara_sec2](https://raw.githubusercontent.com/Korvova/gitar/main/2-0/Print3mf/33_gitara_sec2.3mf) и [34_gitara_sec3](https://raw.githubusercontent.com/Korvova/gitar/main/2-0/Print3mf/34_gitara_sec3.3mf) (дно, 4 П-рейки, фретборд каждой секции), [35_gitara_deka1](https://raw.githubusercontent.com/Korvova/gitar/main/2-0/Print3mf/35_gitara_deka1.3mf) (хребет Д1, 3 кривошипа, 3 втулки,
  3 гребёнки), [36_gitara_deka2](https://raw.githubusercontent.com/Korvova/gitar/main/2-0/Print3mf/36_gitara_deka2.3mf) (хребет Д2, 8 лент ext, 4 хвоста). Столы 33–36 — поддержки только от стола.
  Все STL — в [2-0/Print/Print](https://github.com/Korvova/gitar/tree/main/2-0/Print/Print), 55 деталей.
  Цель теста: собрать по чек-листу «Т. Сборка гриф» до шага Д7 и **крутить кривошипы пальцем** —
  все четыре тележки должны ездить на 40 мм. Моторы не нужны: вместо вала — болт М5 в колодец.
  Корпус (37–47) для теста не печатаем.
* **09.09.2026, вечер — физика вместо печати вслепую.** Собрали Bullet-модель всех четырёх станций
  ([gitara_physics4.py](https://github.com/Korvova/gitar/blob/main/2-0/gitara_physics4.py)) и ручную сцену с пультом четырёх моторов.
  Нашли до печати: вилка тележки должна смотреть на север (инструкция говорила «на юг»), прорези
  под штыри расширены до ±24.5 (столы 31/32 v2), кривошипу нужен запас r5.5 (в хребет, столы 35/36
  — вместе с решением по мотору). Люфты Ø5/Ø6 съедают ~6 мм на сторону — полные 40 мм требуют
  либо ужатых посадок Ø5.5, либо принять ~34 мм. Тележки в модели клинят на нижних этажах —
  переделываются позже под электронику, сейчас тест руками. Итог для печати: **31, 32 (v2), 33, 34 —
  в печать; 35, 36 — ждут мотора**. Подробно — Т. Гриф 2.16.
* **09.09.2026 — решение: гриф собираем и проверяем ПО ЭТАЖАМ** (идея владельца). Этап А: стопка
  P0 + P1 + P4 (палуба садится на стенки любой межэтажки) = станции 0 и 1: 3 плиты, плечи 0/1,
  спицы 0/1, 2 тележки — печатать первыми, ленты тянуть рукой. Нижний этаж — худший случай
  (штырь 25 мм); если едет — добавляем P2/P3 с плечами 2/3.
* **09.09.2026, 13:00 — отправлено в печать: архив «Печать_гриф_этап_А»** — 9 деталей STL (P0, P1, P4,
  плечи 0/1, спицы 0/1, 2 тележки; прорези ±24.5) + столы 33 и 34 (3MF). Ждём печати.
* **15.09.2026 — стенд датчика положения (стол 70) на машине 2.** Датчик сбоку, как напечатано, —
  горб и 90 единиц; датчик под палкой — монотонно, 194 единицы на 12 мм. Решение владельца: деку и
  ленты делать под формат «магнит в кармане ленты, 49E под лентой» (Т. Положение тележек 6.7–6.9).
  Пульт стенда с анимацией — `websim/hall_stend_pult.html`. Вечером — идея владельца: боковой
  язычок ленты под магнит и тумбочка с датчиком под ним (Т. Положение тележек 6.10), дека
  Астры не перепечатывается, только хвосты и тумбочки; для позиций нужны STL Астры.
* ✅ **Результат этапа А и полной стопки (13.09.2026, машина 1):** секция-1 собрана целиком, все четыре
  плеча и тележки ходят от хвостов спиц свободно, клинов нет. Сработали плотные посадки Ø5.1 по купону
  (стол 65, `FIT_D = 5.1`) и смазка — вместо люфта Ø6. Подробно — [Т. Инструкция по сборке](/homepage/iniciativa.-razrabotka/jepik-ruka-gitara/t-instrukcija-sborki).
  Дальше по той же машине: дека v3 под моторы Ø36 (полный оборот кривошипа r4.8, столы 66–68), проба
  первого мотора (стол 67), датчики положения тележек по ленте (стол 70 — стенд, 71 — стойки),
  «затвор» под большим пальцем (стол 72).

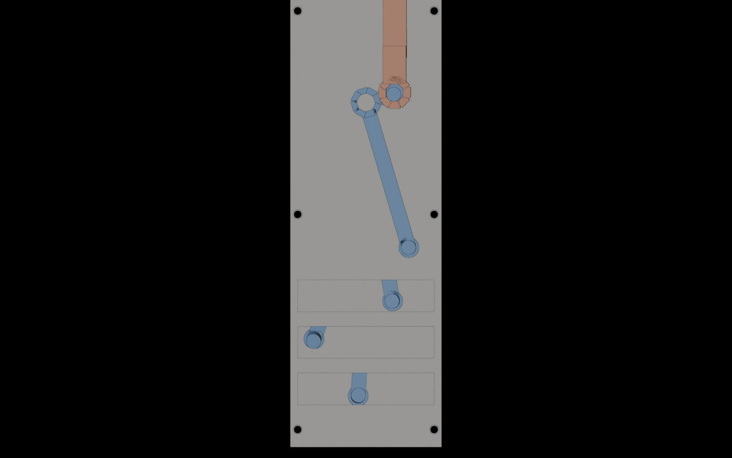
[picture p102: wiki/img/sim4_north_top.jpg]
Физика четырёх станций: плечи и штыри в прорезях (вид сверху, тележки сняты)


## Этап 2 — струны на гитаре, полный цикл игры

| Номер | Пункт | Что значит «сделано» | Где | Статус |
|---|---|---|---|---|
| 2.1 | Основание струн на крышке | Крышка пересчитана под гребёнку основания 108×190, узел стоит над розеткой, провода в розетку | Т. Корпус 3.7 | ⬜ Не начато |
| 2.2 | Одна прошивка на струны и моторы | Стример струн и четыре канала моторов в одном ESP32 | Т. Электроника 4.13 | ⬜ Не начато |
| 2.3 | BLE-MIDI | Щипок → нота с velocity на телефон/ПК, направление рывка → артикуляция; динамик не нужен | Т. Электроника 4.7 | ⬜ Не начато |
| 2.4 | Полный цикл | Тележки ведут пальцы по аккорду, ученик щиплет, звучит правильная нота; кнопка прижима на тележке — следующий шаг | Т. Гриф 2.8 | ⬜ Не начато |

## Этап 3 — корпус целиком

| Номер | Пункт | Что значит «сделано» | Где | Статус |
|---|---|---|---|---|
| 3.1 | Допечатать корпус | Столы 37–47: дно, крышка, обечайка (PETG) | Печать и сборка | ⬜ Не начато |
| 3.2 | Сборка по чек-листу | Шаги Д4–Д9 «Т. Сборка гриф»: хребет на тумбах, ленты, обечайка, крышка с языком фретборда | Т. Сборка гриф | ⬜ Не начато |
| 3.3 | Электроника внутри | ESP32, драйверы, PD-триггер, разводка — на стойках хребта, снимается с крышкой | Т. Электроника 4.8 | ⬜ Не начато |
| 3.4 | Вау-дизайн | Соты, полупрозрачный PETG, подсветка — после отладки техники | Т. Корпус 3.6 | ⬜ Не начато |

## Этап 4 — тактильная подсказка (главная фишка)

| Номер | Пункт | Что значит «сделано» | Где | Статус |
|---|---|---|---|---|
| 4.1 | Браслет с тремя вибромоторами | Бегущая волна «двигай руку туда», ESP-NOW до деки, моторчики разнесены ≥25 мм | Т. Тактилка 5.1–5.2 | ⬜ Не начато |
| 4.2 | Протокол подсказок | Аппликатура задаёт не только тележки, но и волну браслета; синхронная игра «как мастер» | Т. Тактилка | ⬜ Не начато |
| 4.3 | Вибро и кнопка в тележке | Ощущение зажима/отжима, реальный прижим; решён шлейф к подвижной тележке | Т. Тактилка 5.3, Т. Гриф 2.8 | ⬜ Не начато |
| 4.4 | LED вдоль грифа | Позиция мнимой руки; лента клеится сверху | Т. Тактилка 5.4 | ⬜ Не начато |
| 4.5 | Напальчники правой руки | После браслета | Т. Тактилка 5.6 | ⬜ Не начато |

## Этап 5 — испытания прототипа

| Номер | Пункт | Что значит «сделано» | Где | Статус |
|---|---|---|---|---|
| 5.1 | Тест с учениками | 3–5 человек без опыта: аккорд за N минут с тренажёром против видеоурока | Т. маркетинг | ⬜ Не начато |
| 5.2 | Метрики | Ошибки аппликатуры, время до чистого аккорда, субъективная оценка ощущений | | ⬜ Не начато |
| 5.3 | Доработки по итогам | Список изменений в механике, софте, подсказках | | ⬜ Не начато |

## Этап 6 — подготовка к производству

| Номер | Пункт | Что значит «сделано» | Где | Статус |
|---|---|---|---|---|
| 6.1 | Печатная плата зоны струн | Шесть 49E, ESP, конденсаторы, DC-DC на одной плате — без жгута | Т. Электроника 4.8, Т. Плата | ⬜ Не начато |
| 6.2 | Меньше деталей и часов печати | Ревизия каждого узла: объединить, убрать поддержки, посчитать время печати на комплект | Архитектура | ⬜ Не начато |
| 6.3 | BOM и себестоимость | Полный список покупного с ценами, цель 11–13 тыс ₽ | | ⬜ Не начато |
| 6.4 | Софт ученика | Приложение или веб-страница: уроки, аппликатуры, оценка игры, подписка | | ⬜ Не начато |
| 6.5 | Инструкция и упаковка | Сборка для покупателя или готовое изделие, коробка, быстрый старт | Т. Сборка гриф | ⬜ Не начато |
| 6.6 | Безопасность и документы | Питание 20 В от USB-PD, нагрев моторов, что нужно для продажи | | ⬜ Не начато |
| 6.7 | Маркетинг | Видео, лендинг, предзаказ; позиционирование «продаём процесс, а не инвентарь» | Т. маркетинг | ⬜ Не начато |

## Этап 7 — рынок

| Номер | Пункт | Что значит «сделано» | Где | Статус |
|---|---|---|---|---|
| 7.1 | Первая партия 5–10 шт | Продажа по ~15 тыс ₽ напрямую, сбор обратной связи | | ⬜ Не начато |
| 7.2 | Серия | Цена 19–22 тыс ₽ плюс подписка на уроки, производство по заказам | | ⬜ Не начато |
