Korvova/gitar/wiki/t-variant-s-telezhkami.md

Итог обсуждений 27.09: как устроен вариант «тележки на грифе, моторы в деке», почему палец плохо чувствует ход, какие другие механизмы мы примеряли и к чему пришли — **уменьшить рычаг в секции-1**, чтобы лента ходила больше, а люфт умножался меньше. Сами ложа, калибровка и мелодии — на странице [Т. Тележки](/homepage/iniciativa.-razrabotka/jepik-ruka-gitara/t-telezhki), секция-1 v2 — [Т. Гриф под тележки](/homepage/iniciativa.-razrabotka/jepik-ruka-gitara/t-grif-pod-telezhki).

## Этап 1. Как устроено сейчас

| Номер | Требование | Описание | Урок | Статус |
|---|---|---|---|---|
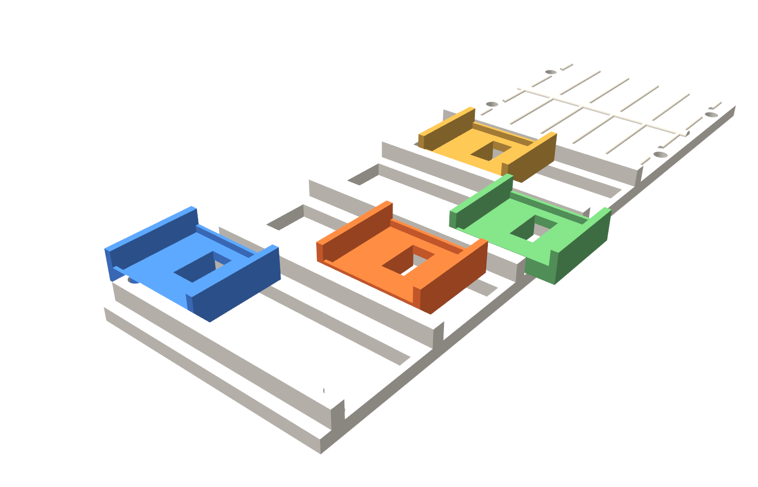
[picture p103: wiki/img/lozhe_v2_plosk_na_grife.png]
Ложа на секции-1 v2
| 14.1 | Цепочка от мотора до пальца | Четыре мотора Ø36 стоят в деке (этажи 0–3, y 515 / 565 / 615 / 678). На валу мотора — кривошип, его палец ходит в прорези-кулисе хвоста ленты. Лента (спица 8 × 1.6) бежит вдоль грифа по жёлобу x 6…14 своего этажа через секции 3 и 2 до секции-1. В секции-1 голова спицы надета на стад короткого плеча, плечо качается на оси, длинное плечо 52 мм несёт штырь — он выходит вверх сквозь прорезь палубы в ложе пальца. Ход ложа поперёк грифа 44 мм: палец достаёт струны 1–6 (шаг 8.8).  | Исходники: дека [gitara_deka.py](https://github.com/Korvova/gitar/blob/main/2-0/gitara_deka.py), секция-1 [gitara_sec1_v2.py](https://github.com/Korvova/gitar/blob/main/2-0/gitara_sec1_v2.py), ложа [gitara_lozhe.py](https://github.com/Korvova/gitar/blob/main/2-0/gitara_lozhe.py), сцена [Гитара_секция1_v2.blend](https://github.com/Korvova/gitar/blob/main/2-0/%D0%93%D0%B8%D1%82%D0%B0%D1%80%D0%B0_%D1%81%D0%B5%D0%BA%D1%86%D0%B8%D1%8F1_v2.blend) | ✅ Собрано, работает |
| 14.2 | Какой мотор — какой палец | V позиция: указательный на 5 ладу, средний на 6, безымянный на 7, мизинец на 8. Мотор в пульте = гнездо драйвера на плате: **0 — мизинец** (этаж 3, тележка у деки), 1 — безымянный, 2 — средний, 3 — указательный. Струна 1 — тонкая, у края грифа со стороны ладони | Номер этажа и номер мотора в пульте не совпадают: этаж 3 = мотор 0. Путались дважды — смотреть подпись пальца на карточке пульта ([Т. Софт](/homepage/iniciativa.-razrabotka/jepik-ruka-gitara/t-soft)) | ✅ |

## Этап 2. Почему палец плохо чувствует ход

| Номер | Требование | Описание | Урок | Статус |
|---|---|---|---|---|
| 14.3 | ~~Люфт умножается рычагом ×5.2~~ | ~~Плечо в секции-1 — 52 : 10. Лента ходит всего ±4.2 мм (8.4 мм от струны 6 до струны 1, 1.7 мм на струну), рычаг растягивает это до ±22 на пальце. Любой зазор у оси, стада, в ленте и в шестерне мотора на пальце становится в 5.2 раза больше, шаг мотора — рывком~~ | ~~Главная причина (вывод владельца 27.09: «проблема в малом ходе»). Лечится меньшим рычагом — этап 4~~ | 💤 Отложено (03.10, см. [Т. Магнитная версия 2.0](/homepage/iniciativa.-razrabotka/jepik-ruka-gitara/t-magnitnaja-versija-2)) |
| 14.4 | ~~Мёртвые точки кривошипа~~ | ~~С радиусом 4.8 струны 1 и 6 стоят на ±62° кривошипа: между струнами 1–2 диск крутится на 35°, посередине на 15° — у краёв тележка ползёт. Кривошип R7.5 — [Т. Тележки](/homepage/iniciativa.-razrabotka/jepik-ruka-gitara/t-telezhki), 11.13–11.14~~ | ~~Чем больше радиус кривошипа на тот же ход ленты, тем ровнее ход~~ | 💤 Отложено (03.10, см. [Т. Магнитная версия 2.0](/homepage/iniciativa.-razrabotka/jepik-ruka-gitara/t-magnitnaja-versija-2)) |
| 14.5 | Штырь пружинит, палец крутит мотор | Штырь Ø5 высотой ~10 мм гнётся под пальцем. При токе удержания 20% палец проворачивал мотор — в пульте выбор 20 / 50 / 100%, по умолчанию 50% | Удержание ниже 50% не ставить, пока палец в ложе | ✅ Удержание 50% |

## Этап 3. Что примеряли вместо (27.09)

| Номер | Требование | Описание | Урок | Статус |
|---|---|---|---|---|
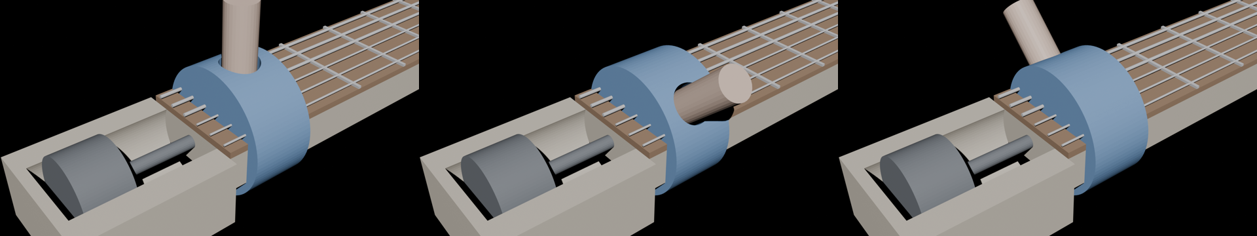
[picture p104: wiki/img/baraban_idea_3kadra.png]
Барабан
| 14.6 | Барабан на валу мотора в голове грифа | Идея владельца: мотор лёжа в голове грифа, на валу барабан Ø60, в нём дырка под кончик пальца — палец идёт по дуге поперёк грифа, без лент и плеч.  Сцена [Идея_барабан_палец.blend](https://github.com/Korvova/gitar/blob/main/2-0/%D0%98%D0%B4%D0%B5%D1%8F_%D0%B1%D0%B0%D1%80%D0%B0%D0%B1%D0%B0%D0%BD_%D0%BF%D0%B0%D0%BB%D0%B5%D1%86.blend), скрипт [scene_baraban_idea.py](https://github.com/Korvova/gitar/blob/main/2-0/scene_baraban_idea.py) | Слишком широко, и так можно вести только один палец | ❌ Отклонено |
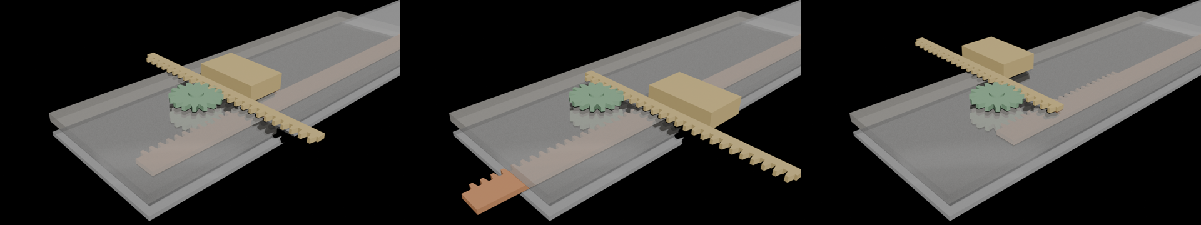
[picture p105: wiki/img/reika_idea_krup.png]
Рейка крупно
| 14.7 | Рейка 1:1 | Шестерня на моторе → лента с зубьями → двухвенцовая шестерня в секции-1 → рейка на тележке. Ход равномерный, без плеча.  Сцена [Идея_рейка_1к1.blend](https://github.com/Korvova/gitar/blob/main/2-0/%D0%98%D0%B4%D0%B5%D1%8F_%D1%80%D0%B5%D0%B9%D0%BA%D0%B0_1%D0%BA1.blend), скрипт [scene_reika_idea.py](https://github.com/Korvova/gitar/blob/main/2-0/scene_reika_idea.py) | Рейка тележки длиной с ход (45+) выезжает за край грифа — мешает руке | ❌ Отклонено |
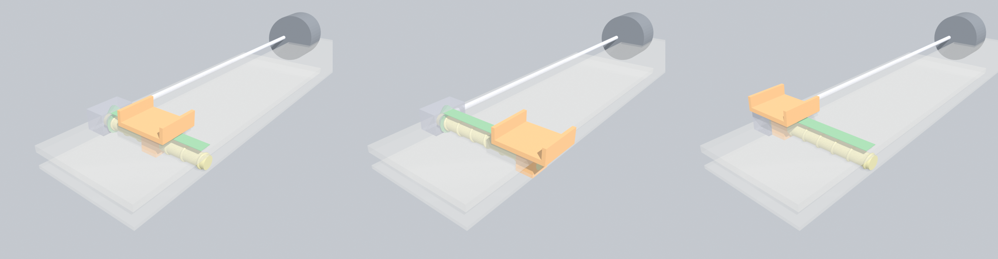
[picture p106: wiki/img/vint_krup_strip.png]
Винт
| 14.8 | Ходовой винт поперёк грифа | Мотор лёжа в деке → пруток вдоль грифа → коническая пара → винт шаг 8 поперёк грифа → гайка в тележке (45 мм = 5.6 оборота). Ход равномерный, винт сам держит.  Сцена [Идея_винт_поперёк.blend](https://github.com/Korvova/gitar/blob/main/2-0/%D0%98%D0%B4%D0%B5%D1%8F_%D0%B2%D0%B8%D0%BD%D1%82_%D0%BF%D0%BE%D0%BF%D0%B5%D1%80%D1%91%D0%BA.blend), скрипт [scene_vint_idea.py](https://github.com/Korvova/gitar/blob/main/2-0/scene_vint_idea.py) | Винт с гайкой на ход 45 занимает всю ширину 52 — коническая пара встаёт снаружи края коробочкой ~10 мм. Пруток можно пустить по центру грифа, но угол всё равно на краю. Сложнее текущего | ❌ Пока нет |
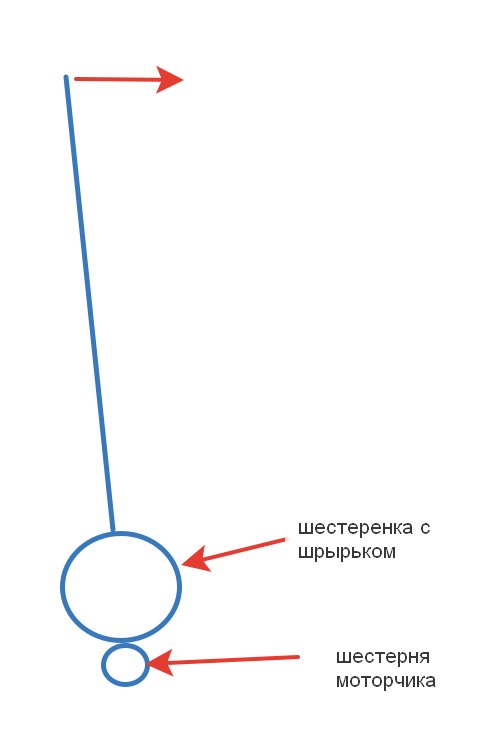
[picture p107: wiki/img/strelka_idea.png]
Стрелка
| 14.9 | «Стрелка часов» | Рисунок владельца: шестерёнка мотора → большая шестерня со стрелкой, кончик стрелки двигает тележку.  | Это и есть наше плечо в секции-1, только с шестернями. Имеет смысл, если мотор прямо под стрелкой — а 4 мотора Ø36 в гриф 52 × 26 не влезают; с мотором в деке опять нужна лента | ❌ = текущий рычаг |
| 14.10 | Шнур / трос | — | Владелец: «мёртвая идея, сразу отметай» | ❌ |
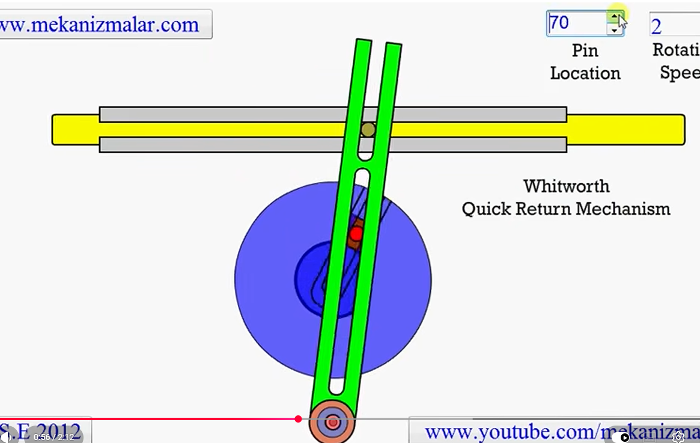
[picture p108: wiki/img/idea_whitworth.png]
Механизм Уитворта
| 14.15 | Кулисный механизм Уитворта (заметка 08.10) | Идея владельца: диск на валу мотора, его палец ходит в прорези длинного рычага-кулисы; рычаг качается на нижней оси, а его верхняя прорезь гонит палец ползуна по направляющей поперёк хода. Ход ползуна меняется переставлением пальца на диске. Видео: [youtube.com/watch?v=UuTNtg7-Bwg](https://www.youtube.com/watch?v=UuTNtg7-Bwg)  | По сути это наше плечо секции-1 (кривошип → кулиса → штырь в тележке), только мотор прямо под рычагом. Свойства: при полном обороте туда и обратно с разной скоростью («быстрый возврат») — не проблема: качаем туда-обратно, а не крутим по кругу (владелец 08.10); две пары «палец в прорези» (палец диска в нижней прорези рычага, палец ползуна в верхней) — в каждой нужен зазор, это люфт: делать плотные посадки со смазкой, как Ø5.1 в секции-1; как поставить тележку — решим потом, главное перпендикулярное перемещение (владелец 08.10); моторы стоят в деке, как сейчас, у каждой тележки свой этаж со своим рычагом (уточнение владельца 08.10). Имеет смысл, если вернёмся к механике | 💤 Заметка |
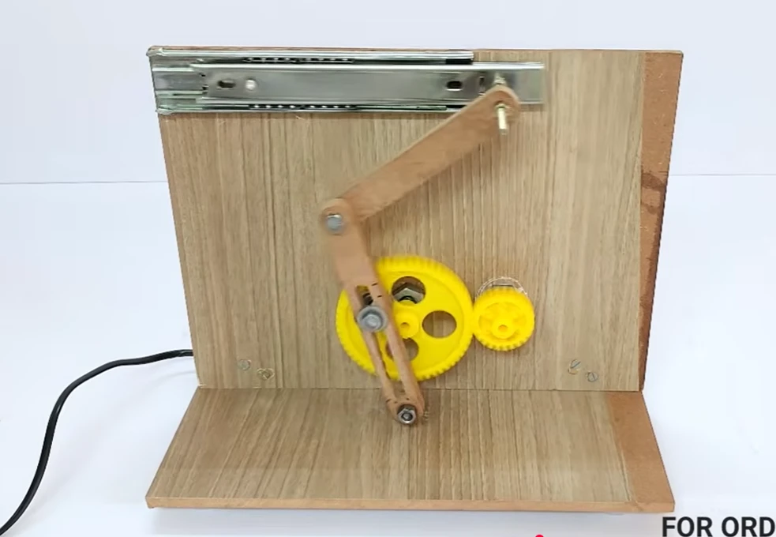
[picture p109: wiki/img/idea_kulisa_shatun.png]
Кулиса с шатуном
| 14.16 | Кулиса с шатуном на ползун (заметка 08.10) | Идея владельца: мотор → малая шестерня → большая шестерня с пальцем; палец ходит в прорези рычага, рычаг качается на нижней оси; верх рычага соединён шатуном (две круглые оси) с ползуном на шариковой мебельной направляющей. Видео: [youtube.com/watch?v=0OTapOLVqEQ](https://www.youtube.com/watch?v=0OTapOLVqEQ)  | Тот же кулисный механизм, что 14.15, но верхняя прорезь заменена шатуном: пара «палец в прорези» осталась одна (внизу), остальные шарниры круглые — люфта меньше. Ползун на шариковой направляющей — ход без люфта и почти без трения. Шестерни дают редукцию (сила больше), но добавляют свой люфт — у нас мотор в деке, шестерни можно не ставить. Шатун под острым углом может подклинивать, как в 14.14 (31°) — проверять угол передачи | 💤 Заметка |
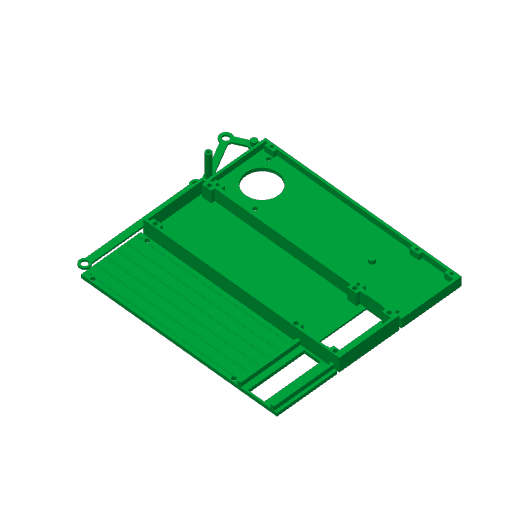
[picture p110: wiki/img/stol92_shatun_100.png]
Стол 92
| 14.17 | Стенд с длинным шатуном ~100 мм (09.10) | Владелец: «если мотор дальше разместить — не будет закуса и пальцем водилось бы лучше». Расчёт угла передачи (кривошип R10, короткое плечо 18): шатун 34.9 — 31° (как мерили на стенде), 50 — 39°, 70 — 44°, 100 — 47.5°; от 40° механизм идёт без заеданий. Стенд v2, мотор отодвинут: [gitara_mini2_dlinnyj.py](https://github.com/Korvova/gitar/blob/main/2-0/gitara_mini2_dlinnyj.py), стол [92_stend_shatun_100.3mf](https://raw.githubusercontent.com/Korvova/gitar/main/2-0/Print3mf/92_stend_shatun_100.3mf) — дно, середина, палуба 170 мм, плечо (длинное 35.6), шатун 96.6 ц-ц; кривошип R10, проставка и ложе — со стенда 82/85. Проверка полного оборота — чисто, ложе ±19.9, худший угол 47°  | Пальцем на струнах 1 и 6 всё равно туго — там мёртвые точки кривошипа (кривошип и шатун на одной линии) при любом шатуне. Лечится кривошипом больше (R14) и качанием сектором ±45° — до мёртвых точек не доходит. Печатается для сравнения с магнитным приводом (Т. Магнитный + Кривошип, 18.10) | ⬜ Печатается |
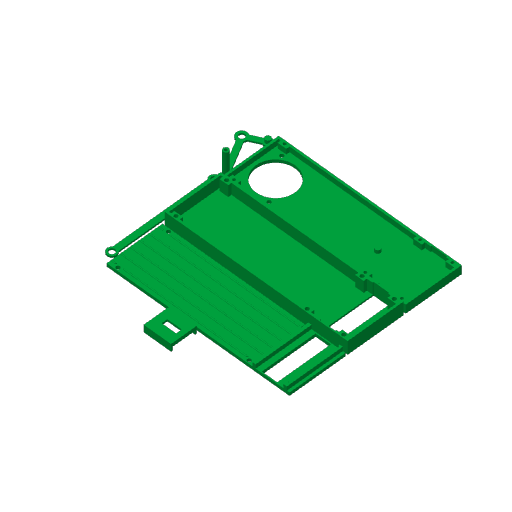
[picture p111: wiki/img/stol95_nema_sektor.png]
Стол 95
| 14.18 | Стенд с мотором: кривошип R14 качается сектором (09.10) | Владелец: приблуда на стенде 90 тянет слабо (сила делится плечом и трением) — назад к NEMA, «круг больше, не полный оборот». Кривошип **R14** качается **+51.3° / −52.4°** вокруг положения «палец поперёк шатуна» — до мёртвых точек не доходит, пальцем водится по всему ходу; шатун 95, плечо 36 : 18, ложе **±22** (как в гитаре: 6 струн через 8.8 = 44 мм), худший угол передачи **49°**. Генератор [gitara_mini2_sektor.py](https://github.com/Korvova/gitar/blob/main/2-0/gitara_mini2_sektor.py), стол [95_stend_nema_sektor.3mf](https://raw.githubusercontent.com/Korvova/gitar/main/2-0/Print3mf/95_stend_nema_sektor.3mf) — дно, середина, палуба 170, плечо, шатун, ложе без полозьев (на ±22 им нет места у стенок — ложе ведут бортики русла); в полосе хода штыря стенки тоньше (1 мм), прорезь ±25, кольцо плеча у штыря Ø5.8; стол [96_krivoshyp_r14.3mf](https://raw.githubusercontent.com/Korvova/gitar/main/2-0/Print3mf/96_krivoshyp_r14.3mf) — кривошип отдельно, с поддержкой только от стола (диск Ø35 шире ступицы — ступица как у R10, чтобы пройти внутри проставки). Проставка и мотор — со стенда 82  | Сектор задаётся в пульте моторов: качание ±52° вокруг нуля (ноль — палец кривошипа поперёк шатуна). Момент мотора на ту же силу ×1.4 к R10 — ток ~800 мА; не хватит — NEMA17 или передача | ⬜ Печатать |
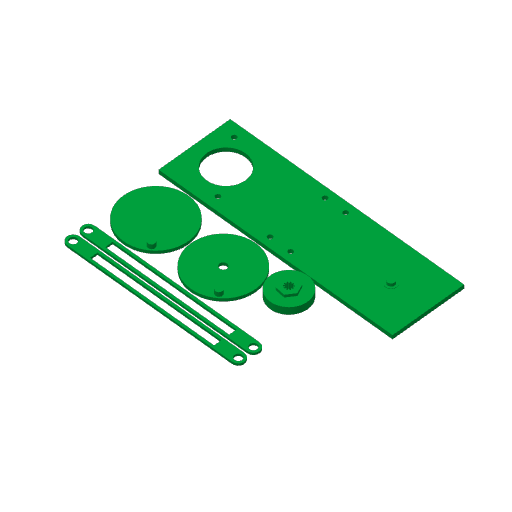
[picture p112: wiki/img/stol99_sparnik.png]
Стол 99
| 14.19 | Стенд «спарник» (10.10) | Идея владельца: на моторе диск с пальцем, на другом конце свободный диск того же радиуса, между пальцами планка — она ходит параллельно сама себе (как спарник паровоза), каждая точка по кругу R20; в щели вдоль планки — штырь тележки: поперёк тележка ходит ±20 (чистый синус), вдоль штырь скользит в щели. Ни плеча, ни шатуна под углом. Генератор [gitara_sparnik.py](https://github.com/Korvova/gitar/blob/main/2-0/gitara_sparnik.py), стол [99_stend_sparnik.3mf](https://raw.githubusercontent.com/Korvova/gitar/main/2-0/Print3mf/99_stend_sparnik.3mf): дно 52 × 170 (мотор как у стенда 95, через проставку), диски R20 над полом, ступица мотора отдельно (шестигранник в диск — диск печатается плашмя), планка ц-ц 120 с дырками 5.3 и щелью 15…105 (+ запасная). Полный оборот — чисто  | В середине хода оба пальца и планка в одну линию — свободный диск может «передумать» и крутануться не туда. Неравные диски это убирают, но планка тогда наклоняется до ~10° — хуже. Если на пробе перевернётся — ремень между дисками или вторая планка со сдвигом 90° (на других уровнях). Ход ±20 в стенде 52 — для ±22 стенд шире | ⬜ Печатать |
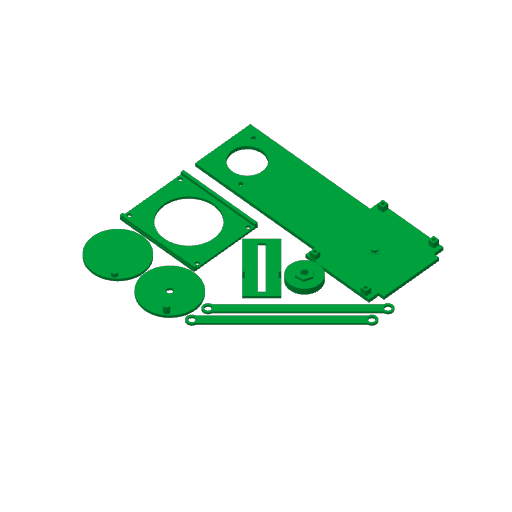
[picture p113: wiki/img/stol100_disk_u_telezhki.png]
Стол 100
| 14.20 | Макет «второй диск у тележки» (10.10) | Идея владельца: на 4 пальца — у каждого диск на моторе в деке и второй диск прямо у своей тележки на своём этаже; планка-спарник между пальцами, второй диск повторяет поворот первого; давление ученика уходит в ось второго диска — длинная планка вбок не нагружена. Макет одного пальца, один мотор: [gitara_sparnik2.py](https://github.com/Korvova/gitar/blob/main/2-0/gitara_sparnik2.py), стол [100_maket_disk_u_telezhki.3mf](https://raw.githubusercontent.com/Korvova/gitar/main/2-0/Print3mf/100_maket_disk_u_telezhki.3mf) — дно, диск на мотор + ступица (как стол 99), второй диск с высоким пальцем, планка без щели (+ запас), мостик с круглым окном и бортиками, салазки-тележка с прорезью вдоль грифа: палец ходит по кругу R20, салазки — только поперёк ±20. Полный оборот — чисто  | Проверить: середину хода (пальцы и планка в одну линию — второй диск может пойти «не туда»; лекарство — зубчатый ремень вместо планки) и тугость пальцем у краёв. Раскладка на 4 этажа — сцены Полудиск_4_этажа.blend (диск сдвинут к деке, лапа тележки) | ⬜ Печатать |
| 14.21 | Механика с мотором в деке отложена (12.10) | Стенды 92, 95, 99, 100 — последние варианты передачи от мотора в деке к тележке. Новое направление — мотор прямо в тележке, без передачи: [Т. Моторчик в тележке](/homepage/iniciativa.-razrabotka/jepik-ruka-gitara/t-motorchik-v-telezhki) | Если стенды 92–100 уже собраны и проверены — дописать результат отдельной строкой | 💤 Отложено 12.10 |

## Этап 4. Меньше рычаг — больше ход ленты

| Номер | Требование | Описание | Урок | Статус |
|---|---|---|---|---|
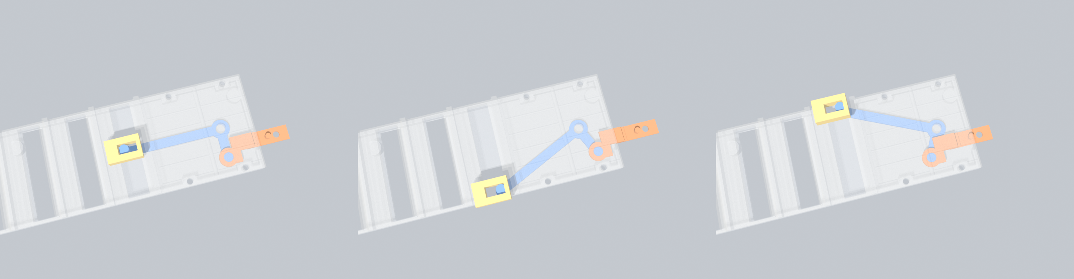
[picture p114: wiki/img/arm3_r16_strip.png]
Плечо R16
| 14.11 | ~~Этаж 3 (мизинец): рычаг ×3.25~~ | ~~Проба без перепечатки секции: короткое плечо 16 вместо 10 (рычаг 52 : 16), лента ±6.8 мм (13.5 мм всего, 2.7 мм на струну) — люфт на пальце в 1.6 раза меньше. Новая спица 3 с «коленом» на 6 мм к жёлобу (стад теперь на x 16). В деке кривошип 3 R10 (сектор ±43°, ровнее, чем ±62°) и хвост 3 R10. Плиты и палуба секции-1 v2 — старые. Синее — плечо, оранжевое — спица, жёлтое — тележка (середина, +25°, −25°):  Стол [80_etazh3_r16.3mf](https://raw.githubusercontent.com/Korvova/gitar/main/2-0/Print3mf/80_etazh3_r16.3mf): плечо, спица, кривошип (пальцем вниз, поддержки под диском), хвост. После сборки: «Стереть калибровку» у мотора 0, кривошип пальцем на запад, откалибровать струны 1–6~~ | ~~Больше 16 не влезает: на махе +12…25° пад стада подходит к бобышке винта стяжки (x 21, y 150); кольцо спицы уменьшено 5.5 → 5.0 по той же причине. Сила на пальце ~на 20% меньше, чем сейчас. Проверка моделью [gitara_arm3_r16.py](https://github.com/Korvova/gitar/blob/main/2-0/gitara_arm3_r16.py) (мах ±22.6° как у v2 — на ±25° штырь и так упирается в концы прорезей), кривошип [gitara_crank3_big.py](https://github.com/Korvova/gitar/blob/main/2-0/gitara_crank3_big.py) `10 45` — чисто. Сцена [Секция1_плечо3_R16.blend](https://github.com/Korvova/gitar/blob/main/2-0/%D0%A1%D0%B5%D0%BA%D1%86%D0%B8%D1%8F1_%D0%BF%D0%BB%D0%B5%D1%87%D0%BE3_R16.blend), скрипт [scene_arm3_r16.py](https://github.com/Korvova/gitar/blob/main/2-0/scene_arm3_r16.py)~~ | 💤 Отложено (03.10, см. [Т. Магнитная версия 2.0](/homepage/iniciativa.-razrabotka/jepik-ruka-gitara/t-magnitnaja-versija-2)) |
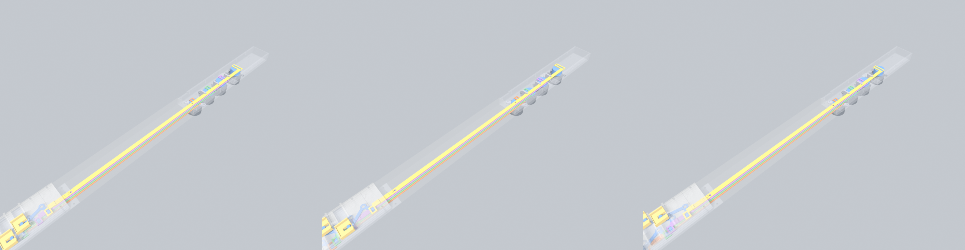
[picture p115: wiki/img/x2_ves_strip.png]
Гриф ×2
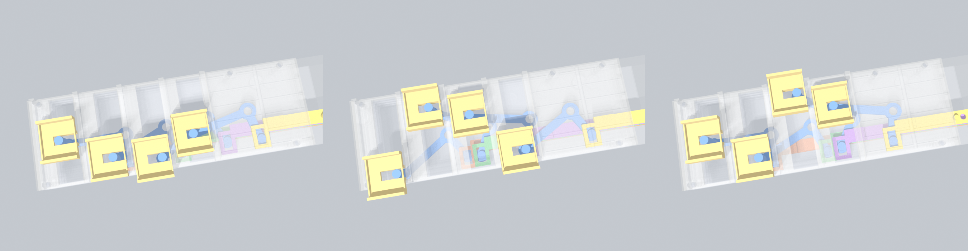
[picture p116: wiki/img/x2_sec1_strip.png]
Секция-1 v3
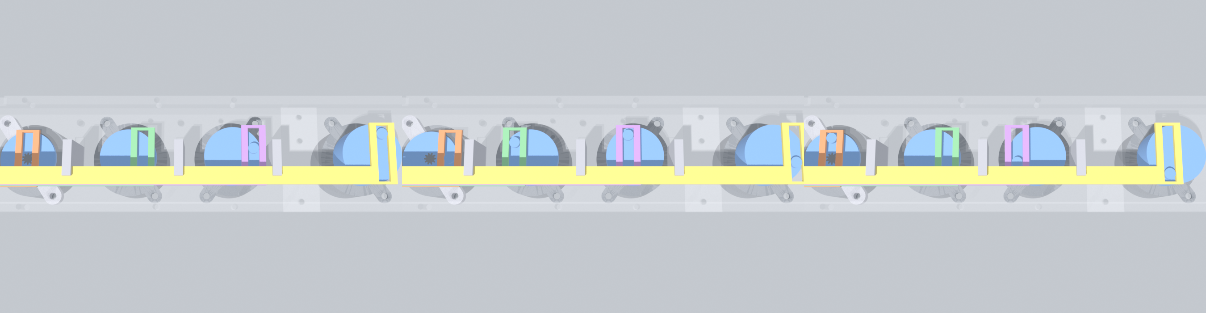
[picture p117: wiki/img/x2_deka_strip.png]
Дека ×2
| 14.12 | ~~Все этажи: рычаг ×2~~ | ~~Решение владельца 27.09: всё от деки до секции-1 под рычаг ×2. **Секция-1 v3:** плечо 36 : 18 (короткое больше 18 не влезает — кольцо стада упирается в стенку x 24), оси на тележка + 36, мах ±37.7°, лента ±11 (22 мм на 44 мм пальца). Штырь на махе уходит к оси на 7.5 — прорези плит и палубы до yc + 10.7, ложе v3 с длинной дыркой и полозьями. Стад на коротком плече уходит по X на 3.8 — голова спицы с прорезью вдоль X (по Y плотно), лента вбок не гнётся; от головы колено к жёлобу. Винт стяжки (23.5, 120) убран — там ходит голова спицы 3. **Дека ×2:** кривошипы R10 полным диском Ø27 (владелец 27.09: струны 1–6 = пол-оборота, 180°; полный круг, и тело диска у этажей 1–3 опускается до дна с зазором 0.35 — не перекосится на шестерне), посадка по зубьям шестерни. Полный оборот разрешён: кулиса хвоста открыта в обе стороны — если мотор проскочит, ничего не заклинит; лента ±10, ложе ±20 — ровно до концов прорезей секции-1, струны 1 и 6 — в крайних точках. Перемычки кулисы хвоста 3 мм (было 1.5) — длинная прорезь меньше пружинит. Палец кривошипа торчит над лентой на 1.8 мм (у мотора 3 — 1.3, выше крышка), чтобы кулиса не соскакивала (просьба владельца); до ленты этажа выше 1.95. В дне Д1 окно под диск 0 кругом Ø28. **Печать без поддержек** (владелец 27.09): кривошип — цилиндр с плоским дном и пальцем сверху, ступицы снизу нет (шестерню держит само тело: у мотора 0 вся, у 1–3 — 3.2 из 4 мм); проставка мотора 0 — кольцо вокруг диска с ушами (gdk_spacer0_x2). Д2, гребёнки, проставка, моторы — на прежних местах. Цепочка: кривошип θ → лента 10·sin θ → ложе 2 × лента. Весь гриф:  Секция-1 сверху — ложа ходят каждое своим ритмом:  Дека сверху — кривошипы крутятся полными оборотами, пальцы в кулисах хвостов:  Симуляция [Гриф_x2.blend](https://github.com/Korvova/gitar/blob/main/2-0/%D0%93%D1%80%D0%B8%D1%84_x2.blend), скрипт [scene_x2.py](https://github.com/Korvova/gitar/blob/main/2-0/scene_x2.py)~~ | ~~Проверки моделью чистые. Секция [gitara_sec1_v3.py](https://github.com/Korvova/gitar/blob/main/2-0/gitara_sec1_v3.py): 4 этажа × 5 положений маха (ложе ±20, как у v2 — на ±22 полозья упираются в концы прорези), штыри сквозь все плиты выше, соседние ложа навстречу. Дека [gitara_deka.py](https://github.com/Korvova/gitar/blob/main/2-0/gitara_deka.py) с `DEKA_X2=1`: полный оборот шагом 30°, все вместе и со сдвигом 90° — минимум: палец в прорези 0.15, кривошип/дно 0.35, лента/гребёнка 0.2, кривошип 0/проставка 0.35. Сила на пальце выше, чем сейчас (10 × 2 = 20 против 4.8 × 5.2 = 25 — меньше плечо), но у струн 1 и 6 ход медленнее (мёртвые точки) Секции 2–3 не меняются — ленты в них идут по сплошным каналам. Прошивка та же: границы хода берутся из калибровки~~ | 💤 Отложено (03.10, см. [Т. Магнитная версия 2.0](/homepage/iniciativa.-razrabotka/jepik-ruka-gitara/t-magnitnaja-versija-2)) |
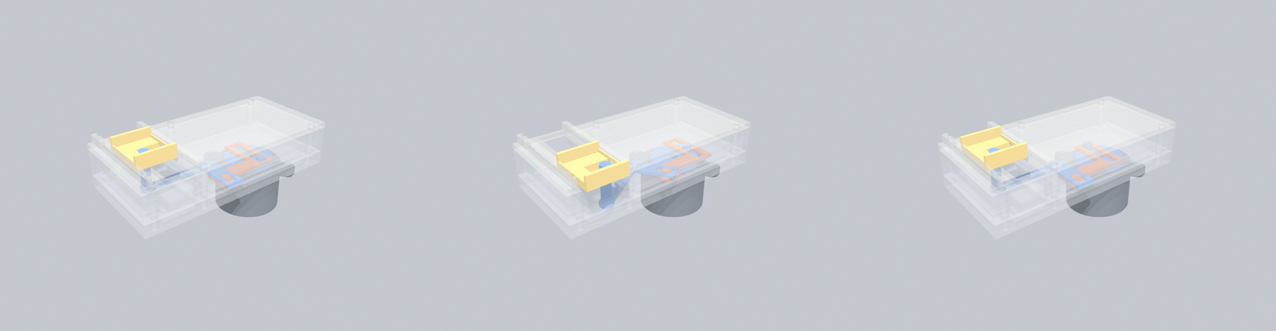
[picture p118: wiki/img/mini1_bok_strip.png]
Стенд сбоку
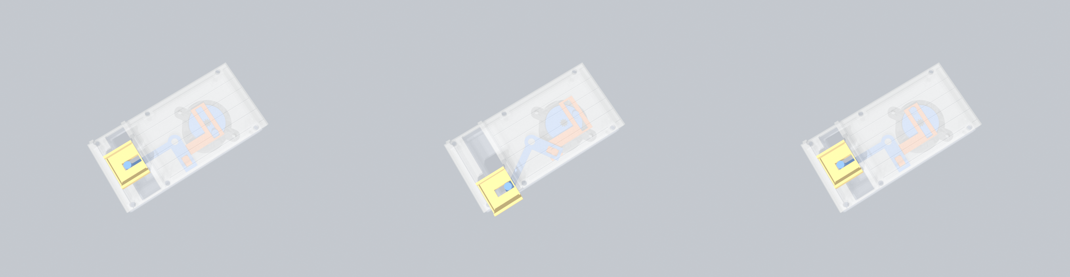
[picture p119: wiki/img/mini1_verh_strip.png]
Стенд сверху
| 14.13 | ~~Стенд одного пальца (указательный)~~ | ~~Идея владельца 27.09: проверить ×2 на одном пальце с минимумом печати, потом раздать на остальные; на этом же стенде потом — тележка с вибро и кнопкой. Кусок грифа 52 × 110, высота до палубы 24 (как гриф 23–25). Всё как этаж 0 грифа ×2, только без секций 2–3: мотор сразу за плечом, спица и хвост — одна короткая лента. Мотор снизу дна на проставке, кривошип R10 полным диском в окне дна (полный оборот = струны 1..6..1), **всё печатается без поддержек** (владелец 27.09): лента плоская со стадом вверх, плечо плоское с прорезью вдоль короткого плеча — стад ленты скользит в ней по радиусу 15…18, плечо лежит на ступеньке стада оси над лентой (передаточное ×2.4 в середине, ×2 у краёв; лента ±10 → ложе ±20); кривошип плоским дном на стол, проставка — кольцо; кулиса ленты у мотора; по X кулису держат рейки на дне, сверху всё прижимает потолок середины. Стопка: дно + середина + палуба, 6 винтов М3 × 20–25 в бобышки дна, мотор — 2 винта М3 сквозь дно и проставку. Мотор висит под дном на 26 мм — ставить на край стола. Сбоку и сверху (полный оборот):   Стол [81_stend_odin_palec.3mf](https://raw.githubusercontent.com/Korvova/gitar/main/2-0/Print3mf/81_stend_odin_palec.3mf): дно, середина, палуба, плечо, лента, кривошип 0 R10 (плоским дном на стол), проставка-кольцо — без поддержек; ложе v3 бортиками на стол, дно мостом~~ | ~~Проверка моделью [gitara_mini1.py](https://github.com/Korvova/gitar/blob/main/2-0/gitara_mini1.py): полный оборот шагом 30° — кривошип, лента, плечо, ложе ничего не задевают, стопка садится. Детали кривошипа, проставки и ложа — те же, что для грифа ×2 (одни файлы). Сцена [Стенд_один_палец.blend](https://github.com/Korvova/gitar/blob/main/2-0/%D0%A1%D1%82%D0%B5%D0%BD%D0%B4_%D0%BE%D0%B4%D0%B8%D0%BD_%D0%BF%D0%B0%D0%BB%D0%B5%D1%86.blend), скрипт [scene_mini1.py](https://github.com/Korvova/gitar/blob/main/2-0/scene_mini1.py). В пульте — калибровка струн у того мотора, куда подключён~~ | 💤 Отложено (03.10, см. [Т. Магнитная версия 2.0](/homepage/iniciativa.-razrabotka/jepik-ruka-gitara/t-magnitnaja-versija-2)) |
| 14.14 | ~~Стенд одного пальца v2: шатун прямо на кривошипе~~ | ~~Идеи владельца 27.09: «не люблю перемычки, когда ходит внутри дырки-прямоугольника — чем меньше ходят, тем лучше» и «зачем посредники — зелёную сразу на пимку в колесе». Ленты и прорезей нет: шарнирный четырёхзвенник — кривошип R10 (полный оборот) → шатун 34.9 мм с двумя круглыми дырками → плечо (длинное 32.5, короткое 18) → штырь → ложе ±20. Размеры подобраны из условия «крайние положения плеча — когда кривошип и шатун на одной линии». Слои: плечо на полу, шатун над ним на стаде плеча и пальце кривошипа; кривошип свой (палец выше — под шатун), проставка-кольцо и ложе v3 — общие. Высота до палубы 24. Штырьки (палец кривошипа, стад плеча, стад оси) торчат над деталями на 1.5 мм — впритык могли выскочить (владелец). В штыре ложа дырка Ø2.6 глубиной 10 под самонарез М3 с шайбой Ø7 (владелец): штырь на 0.3 выше дна ложа — шайба держит ложе сверху, не зажимая (штырь ездит в ложе вдоль грифа на 7 мм); в южном бортике ложа v3 разрыв ±4.5 под шайбу. Сверху, полный оборот: Стенд с шатуном Стол [82_stend_shatun.3mf](https://raw.githubusercontent.com/Korvova/gitar/main/2-0/Print3mf/82_stend_shatun.3mf): дно, середина, палуба, плечо, шатун, кривошип, проставка — без поддержек; ложе бортиками на стол~~ | ~~Проверка моделью [gitara_mini2.py](https://github.com/Korvova/gitar/blob/main/2-0/gitara_mini2.py): полный оборот шагом 15° — ничего не задевает. Минимальный угол передачи (шатун к плечу) 31° — вживую посмотреть, не подклинивает ли там. Сцена [Стенд_шатун.blend](https://github.com/Korvova/gitar/blob/main/2-0/%D0%A1%D1%82%D0%B5%D0%BD%D0%B4_%D1%88%D0%B0%D1%82%D1%83%D0%BD.blend), скрипт [scene_mini2.py](https://github.com/Korvova/gitar/blob/main/2-0/scene_mini2.py). В полном грифе шатуном станет сама лента (идея владельца): гуляет по своему этажу; 50 см на толкание без боковых направляющих гнётся вбок (8 мм — около 5 Н) — делать шире, 12 мм, каналы у деки шире (конец ходит вбок ±10)~~ | 💤 Отложено (03.10, см. [Т. Магнитная версия 2.0](/homepage/iniciativa.-razrabotka/jepik-ruka-gitara/t-magnitnaja-versija-2)) |
