Korvova/gitar/wiki/t-instrukcija-magnit.md

Как собрать пробное магнитное русло руками: по шагам, с картинкой на каждый шаг, что печатать, что купить, как мотать и паять. Картинки нарисованы с настоящих STL стола 86 ([render_sborka_magnit.py](https://github.com/Korvova/gitar/blob/main/2-0/magnit/render_sborka_magnit.py)). Зачем это русло и как посчитано — на странице [Т. Магнитная версия](/homepage/iniciativa.-razrabotka/jepik-ruka-gitara/t-magnitnaja-versija), строки 15.13–15.14.

Как работает: посередине стоит неподвижная пластина из 8 плоских катушек. Её обнимает U-скоба с 6 магнитами. Ток в катушках толкает магниты, и скоба едет вдоль пластины ±22 мм — от струны 6 до струны 1. Проводов к скобе нет.

## Этап 1. Что нужно

| Номер | Требование | Описание | Урок | Статус |
|---|---|---|---|---|
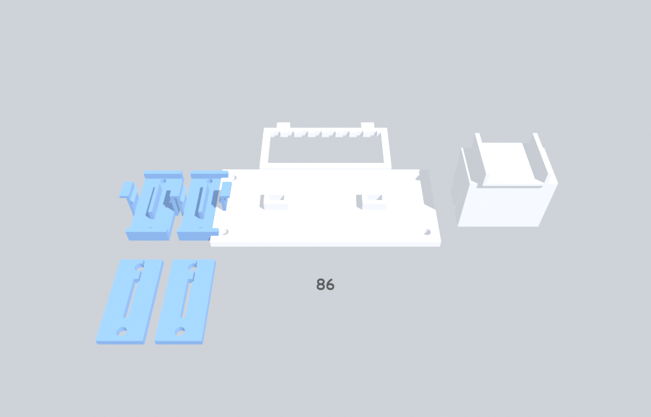
[picture p120: wiki/img/mag_sb_0_detali.png]
Детали стола 86
| 16.1 | ~~Напечатать стол 86~~ | ~~[86_magnit_proba.3mf](https://raw.githubusercontent.com/Korvova/gitar/main/2-0/Print3mf/86_magnit_proba.3mf), PETG, без поддержек: 2 оправки (щёчка с сердечником `mag_opravka_a` + прижимная `mag_opravka_b`), рамка катушек `mag_ramka` (лёжа), основа `mag_osnova`, U-скоба `mag_skoba`. ~~ | ~~Оправки две — пока сохнет клей на одной катушке, мотаем следующую~~ | 💤 Отложено (03.10, см. [Т. Магнитная версия 2.0](/homepage/iniciativa.-razrabotka/jepik-ruka-gitara/t-magnitnaja-versija-2)) |
| 16.2 | ~~Купить и найти~~ | ~~Магниты 20 × 10 × 5 N52, намагничены по толщине 5 — 6 шт (+2 запас). Сталь 1–1.5 мм — 2 пластинки 30 × 20. Провод ПЭТВ-2 0.3 мм — ~14 м из 20. Суперклей или лак для катушек, эпоксидка или суперклей для магнитов. Паяльник, термоусадка. Магнит для проверки стали, мультиметр~~ | ~~Сталь проверить магнитом: шлифованная нержавейка почти не магнитится. Винты рядом со скобой — латунь или пластик: стальной притянет~~ | 💤 Отложено (03.10, см. [Т. Магнитная версия 2.0](/homepage/iniciativa.-razrabotka/jepik-ruka-gitara/t-magnitnaja-versija-2)) |

## Этап 2. Катушки

| Номер | Требование | Описание | Урок | Статус |
|---|---|---|---|---|
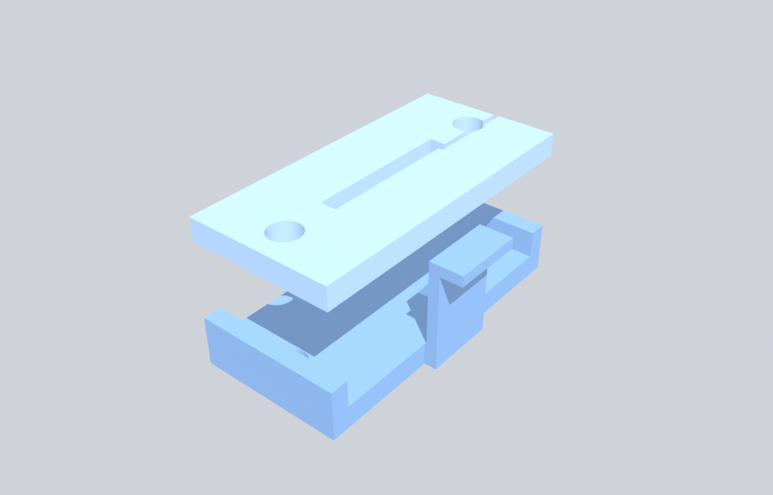
[picture p121: wiki/img/mag_sb_1_opravka.png]
Оправка
| 16.3 | ~~Собрать оправку~~ | ~~Прижимную щёчку надеть на сердечник и **нажать до щелчка** — её держат два язычка с крючками по бокам (винты М3 не нужны, дырки под них остались на всякий случай). Между щёчками ровно 3 мм — это толщина катушки. Открыть: отжать оба язычка за ушки наружу и снять щёчку. ~~ | ~~Щёчки внутри протереть или обклеить скотчем — клей к ним не пристанет~~ | 💤 Отложено (03.10, см. [Т. Магнитная версия 2.0](/homepage/iniciativa.-razrabotka/jepik-ruka-gitara/t-magnitnaja-versija-2)) |
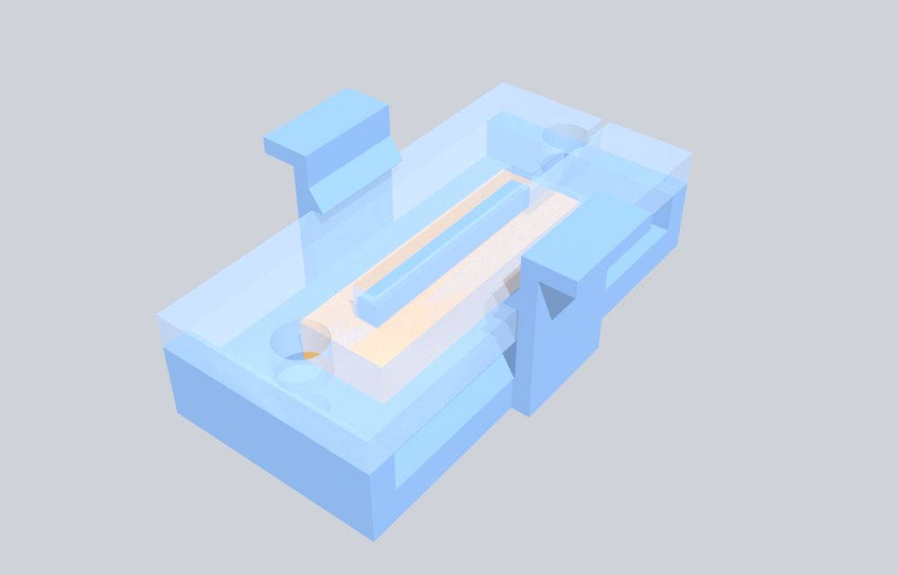
[picture p122: wiki/img/mag_sb_2_namotka.png]
Намотка
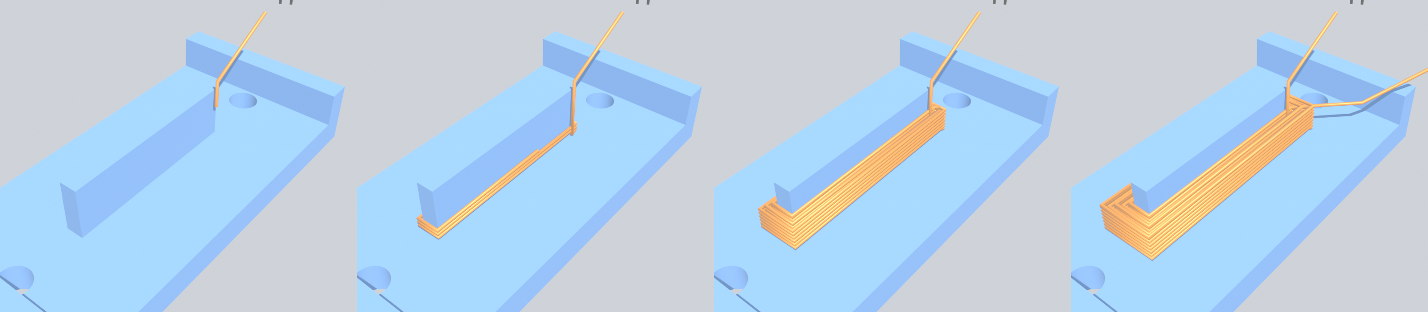
[picture p123: wiki/img/mag_namotka_shagi.png]
Намотка по слоям
| 16.4 | ~~Намотать 8 катушек~~ | ~~Начало провода — в прорезь прижимной щёчки, хвост 10 см: это **«н» — начало**. Мотать ~40 витков плотно, виток к витку, **все катушки в одну сторону** (например, по часовой, глядя на прижимную щёчку). Конец — **«к»**, хвост 10 см. Промазать суперклеем или лаком, дать высохнуть, снять щёчку, стянуть катушку. Получится плоская 6.5 × 21 × 3. Хвосты подписать (скотч «н»/«к»).  Как ложится провод (прижимная щёчка снята, чтобы было видно; анимация — [Как_мотать_катушку.blend](https://github.com/Korvova/gitar/blob/main/2-0/magnit/%D0%9A%D0%B0%D0%BA_%D0%BC%D0%BE%D1%82%D0%B0%D1%82%D1%8C_%D0%BA%D0%B0%D1%82%D1%83%D1%88%D0%BA%D1%83.blend)): начало сверху через прорезь вниз к сердечнику → первый слой 8 витков рядом поперёк щели → второй слой поверх, обратно → … 5 слоёв ≈ 40 витков → конец наружу. ~~ | ~~Если витки не влезают в 3 мм — меньше витков, не страшно: 35 тоже работают. Лак с проводов на концах снять ножом или паяльником с флюсом~~ | 💤 Отложено (03.10, см. [Т. Магнитная версия 2.0](/homepage/iniciativa.-razrabotka/jepik-ruka-gitara/t-magnitnaja-versija-2)) |
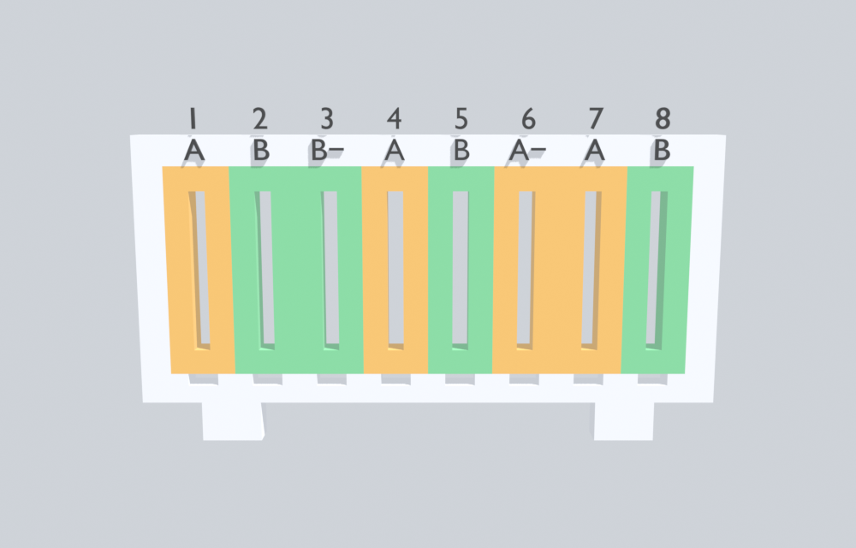
[picture p124: wiki/img/mag_sb_3_katushki.png]
Катушки в рамке
| 16.5 | ~~Вклеить катушки в рамку~~ | ~~Рамку положить, катушки вставить в окно по номерам слева направо (номер = число точек на нижней планке), выводы вниз через пазы. Цвет на картинке — фаза. Приклеить по краям к рамке и друг к другу. ~~ | ~~Катушки должны быть заподлицо с рамкой: торчащая катушка будет тереть по магнитам — щель всего 0.5 с каждой стороны~~ | 💤 Отложено (03.10, см. [Т. Магнитная версия 2.0](/homepage/iniciativa.-razrabotka/jepik-ruka-gitara/t-magnitnaja-versija-2)) |
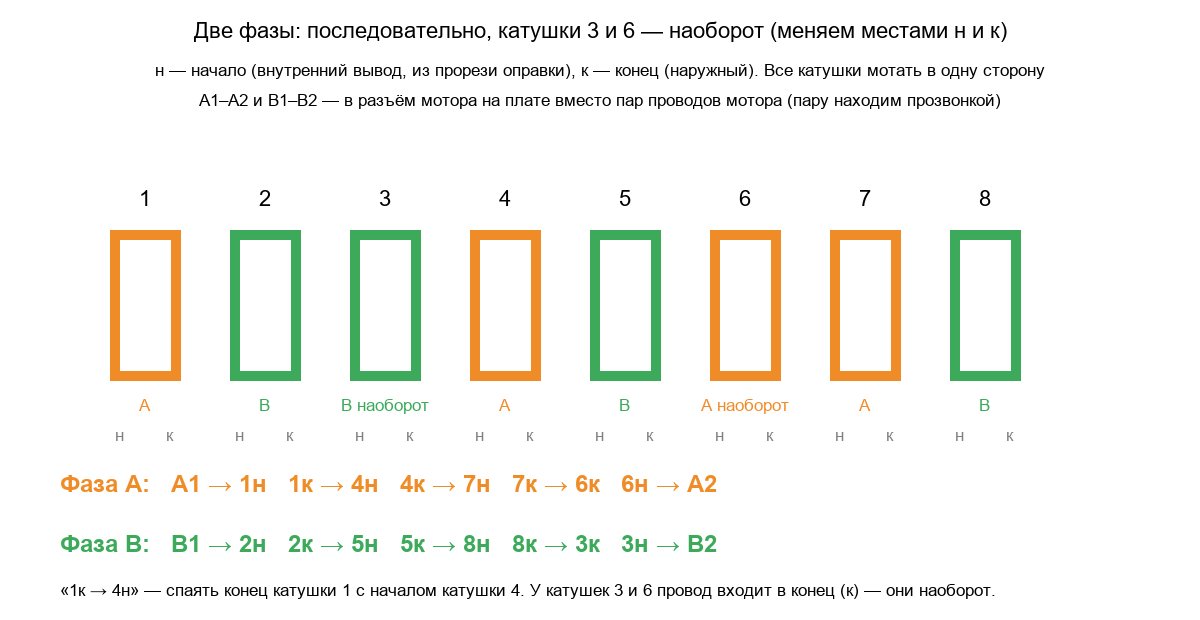
[picture p125: wiki/img/mag_sb_7_shema.png]
Схема
| 16.6 | ~~Спаять в две фазы~~ | ~~По цепочке: **A1 → 1н, 1к → 4н, 4к → 7н, 7к → 6к, 6н → A2**; **B1 → 2н, 2к → 5н, 5к → 8н, 8к → 3к, 3н → B2**. Катушки 3 и 6 — наоборот. Прозвонить: A1–A2 и B1–B2 — по ~1 Ом, между A и B — обрыв. ~~ | ~~Пайки изолировать термоусадкой, провода вывести вниз под рамку~~ | 💤 Отложено (03.10, см. [Т. Магнитная версия 2.0](/homepage/iniciativa.-razrabotka/jepik-ruka-gitara/t-magnitnaja-versija-2)) |
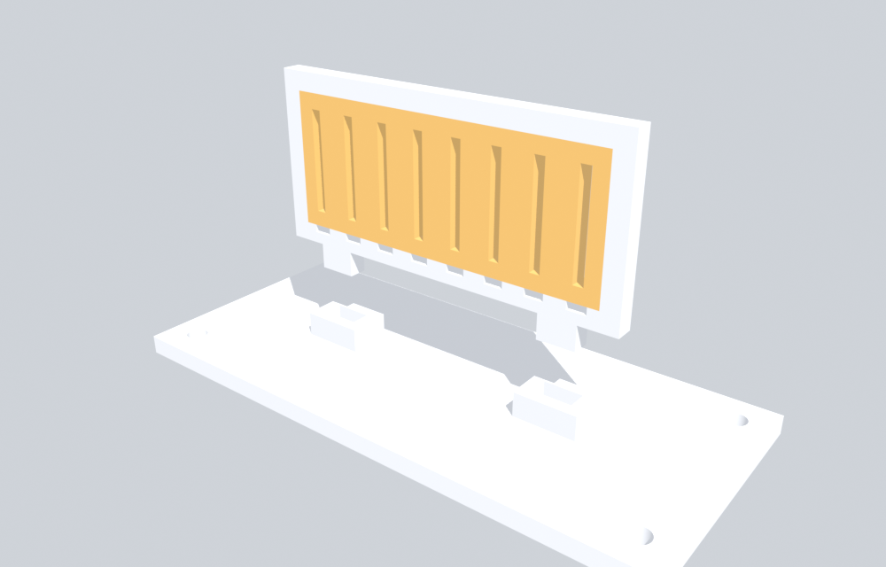
[picture p126: wiki/img/mag_sb_4_osnova.png]
Рамка в основу
| 16.7 | ~~Рамку в основу~~ | ~~Лапки рамки вставить в стойки основы, посадить на клей. Рамка должна стоять вертикально. ~~ | | 💤 Отложено (03.10, см. [Т. Магнитная версия 2.0](/homepage/iniciativa.-razrabotka/jepik-ruka-gitara/t-magnitnaja-versija-2)) |

## Этап 3. Скоба с магнитами (когда приедут магниты)

| Номер | Требование | Описание | Урок | Статус |
|---|---|---|---|---|
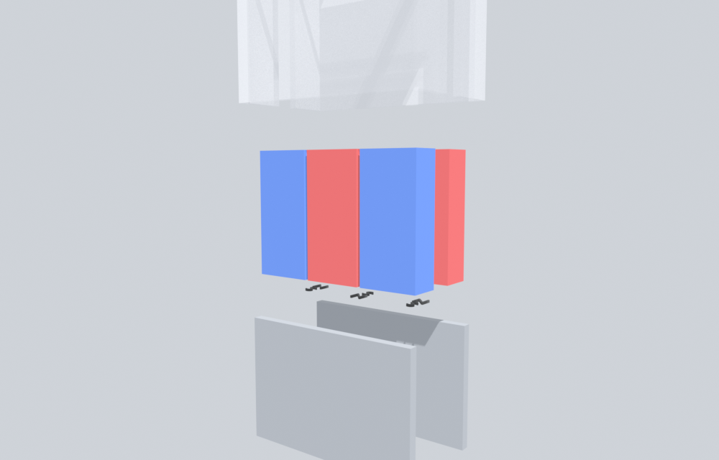
[picture p127: wiki/img/mag_sb_5_magnity.png]
Магниты в скобу
| 16.8 | ~~Магниты и сталь в скобу~~ | ~~Скобу перевернуть. В каждое гнездо снизу: сначала стальная пластинка (к наружной стенке), потом по одному 3 магнита. **С одной стороны полюса к щели N-S-N, с другой — S-N-S**: магниты напротив друг друга должны **притягиваться** через щель. Каждый магнит — на капельку клея. ~~ | ~~N52 сильно щёлкают друг о друга и колются — ставить по одному, держать остальные подальше. Соседние в ряду магниты отталкиваются (они разными полюсами наружу) — придержать, пока схватится клей. Проверка полюсов: магнит из запаса должен прилипать к щели одинаково с обеих сторон~~ | 💤 Отложено (03.10, см. [Т. Магнитная версия 2.0](/homepage/iniciativa.-razrabotka/jepik-ruka-gitara/t-magnitnaja-versija-2)) |
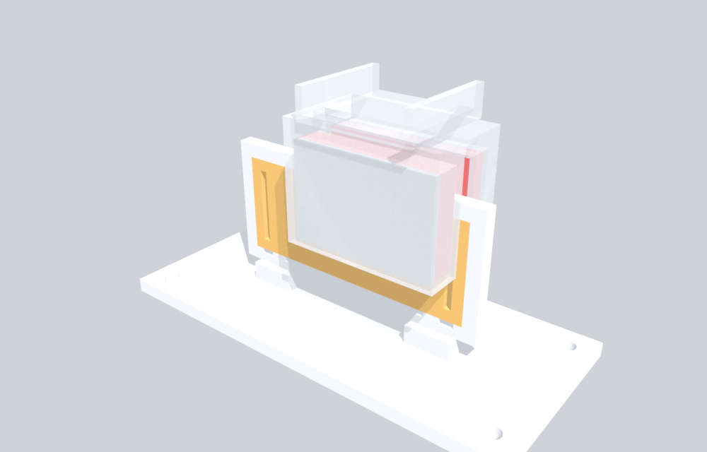
[picture p128: wiki/img/mag_sb_6_skoba.png]
Скоба на рельсе
| 16.9 | ~~Скобу на рельс~~ | ~~Скобу сверху надеть на рамку: паз мостика садится на верхнюю планку, магниты встают по бокам от катушек. Проверить рукой: ходит от края до края, нигде не трёт. ~~ | ~~Если трёт о катушку — катушка торчит из рамки, подпилить или переклеить~~ | 💤 Отложено (03.10, см. [Т. Магнитная версия 2.0](/homepage/iniciativa.-razrabotka/jepik-ruka-gitara/t-magnitnaja-versija-2)) |

## Этап 4. Подключение и первый пуск

| Номер | Требование | Описание | Урок | Статус |
|---|---|---|---|---|
| 16.10 | ~~К плате вместо мотора~~ | ~~Отключить мотор стенда от разъёма платы, на его место — A1, A2 в одну пару контактов, B1, B2 в другую (пару у мотора найти прозвонкой — между проводами одной пары несколько Ом, между разными парами обрыв). Пульт как обычно: «Подключить», PD-триггер, «Настроить драйверы», ток 500 мА~~ | ~~Для платы русло — тот же шаговик: 4 шага = 20 мм (пара полюсов), «оборот» пульта — около 1 м хода, 1° ≈ 2.8 мм, весь ход 44 мм ≈ 16°. Ток выше 1000 мА не ставить, пока не проверен нагрев~~ | 💤 Отложено (03.10, см. [Т. Магнитная версия 2.0](/homepage/iniciativa.-razrabotka/jepik-ruka-gitara/t-magnitnaja-versija-2)) |
| 16.11 | ~~Проверка~~ | ~~Кнопками ◀ 1° / 1° ▶ скоба должна сдвигаться примерно на 3 мм. Если дёргается на месте — поменять местами провода одной фазы (A1 ↔ A2). Дальше: ход от края до края, сила вбок кухонными весами, нагрев катушек пальцем через 5 минут~~ | ~~По расчёту на 1–1.5 А — около 100–150 г вбок. Это проба «едет ли и как ощущается», а не сила под палец~~ | 💤 Отложено (03.10, см. [Т. Магнитная версия 2.0](/homepage/iniciativa.-razrabotka/jepik-ruka-gitara/t-magnitnaja-versija-2)) |
