Korvova/gitar/wiki/t-magnitnaja-versija.md

Магнитная версия привода тележек: вместо моторов в деке, лент, кривошипов и плеч — **линейный мотор прямо в грифе**. В каждом русле поперёк грифа стоит неподвижная пластина из плоских медных катушек, тележка — U-скоба с магнитами, которая обнимает пластину и едет над ней. Ток в катушках толкает магниты: ход прямой, без рычага и без люфта. Механика текущего варианта — на странице [Т. Вариант с тележками](/homepage/iniciativa.-razrabotka/jepik-ruka-gitara/t-variant-s-telezhkami), посадка пальца — [Т. Тележки](/homepage/iniciativa.-razrabotka/jepik-ruka-gitara/t-telezhki).

## Этап 1. Как пришли к магнитам (01.10)

| Номер | Требование | Описание | Урок | Статус |
|---|---|---|---|---|
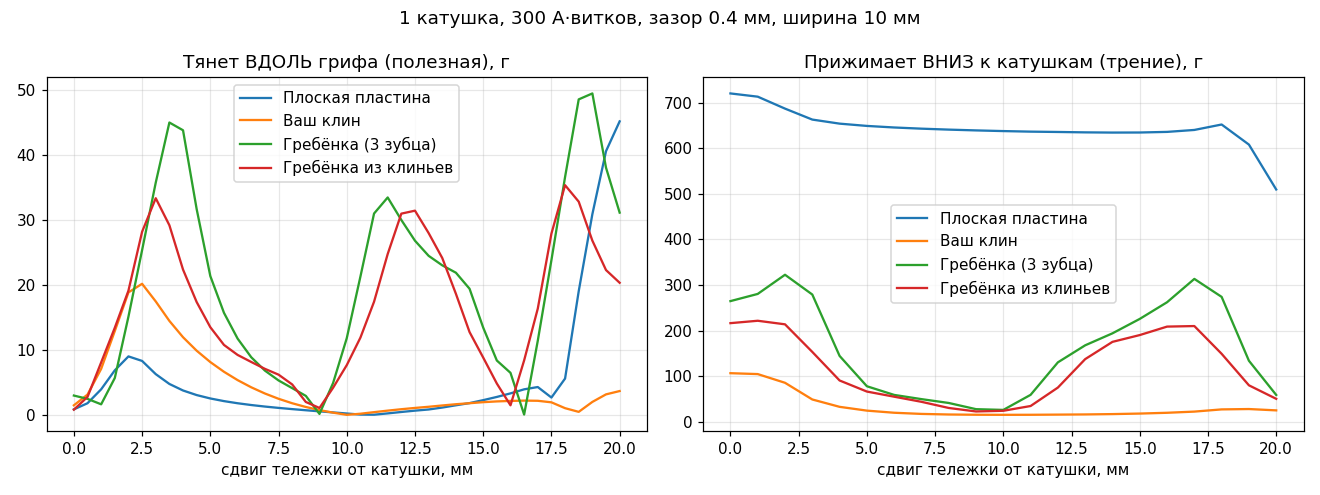
[picture p129: wiki/img/magnit_formy_telezhki.png]
Формы тележки
| 15.1 | Катушки в грифе, стальная тележка | Первая мысль: ряд электромагнитов под палубой, тележка — стальная пластина, катушки включаются по очереди и перетягивают её. Посчитано 2D-моделью (метод конечных элементов): плоская пластина, клин остриём вниз, гребёнка из зубцов, гребёнка из клиньев.  Скрипты [femsim.py](https://github.com/Korvova/gitar/blob/main/2-0/magnit/femsim.py), [analyze.py](https://github.com/Korvova/gitar/blob/main/2-0/magnit/analyze.py) | Плоская пластина почти не тянется вбок, только прилипает вниз (до 700 г прижима при 10–45 г вбок). Лучше всех гребёнка: ~50 г вбок на катушку 300 ампер-витков, и зубцов нужно 4, иначе тележка застревает. Готовые удерживающие электромагниты (KK-P20/15, P25/20 «5 кг») дают вбок ~150–400 г: «5 кг» — это прижим вплотную, а не тяга | ❌ Слабо, заменено 15.2 |
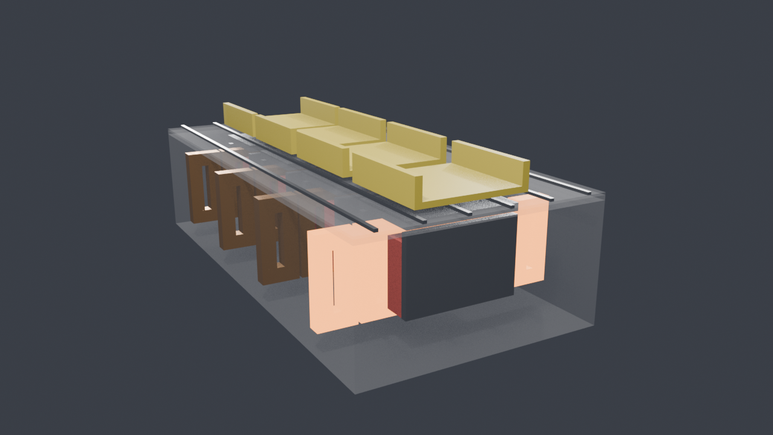
[picture p130: wiki/img/magnit_dorozhki.png]
Магнитные русла
| 15.2 | ~~Магниты на тележке, катушки в грифе без железа~~ | ~~Решение 01.10: постоянные магниты N52 чередуются N-S-N, катушки плоские, без сердечника. Сила растёт прямо с током, ничего не липнет, провода к тележке не нужны. Модель [guitar_mag_lanes.blend](https://github.com/Korvova/gitar/blob/main/2-0/magnit/guitar_mag_lanes.blend) — 4 русла на местах V позиции (Y 16 / 42 / 67 / 91), «Паучок» 6 → 1 → 6, у ближних тележек снята передняя стальная пластина. ~~ | ~~Сначала считали наоборот (магниты в стенках, катушки на тележке), но ход поперёк грифа 44 мм при ширине 52 — тележка с катушками длиной ~50 мм не помещается. Поэтому катушки неподвижны на всю ширину, а короткая скоба с магнитами едет~~ | 💤 Отложено (03.10, см. [Т. Магнитная версия 2.0](/homepage/iniciativa.-razrabotka/jepik-ruka-gitara/t-magnitnaja-versija-2)) |

## Этап 2. Размеры одного русла

| Номер | Требование | Описание | Урок | Статус |
|---|---|---|---|---|
| 15.3 | ~~Тележка: U-скоба с магнитами~~ | ~~С каждой стороны пластины по 3 магнита **15 × 10 × 5 мм N52, намагничены по толщине 5**: 10 мм — вдоль хода (шаг полюсов), 15 мм — по высоте. Полюса N-S-N, магниты напротив друг друга смотрят разными полюсами (поле идёт сквозь щель). Снаружи — стальные пластины 30 × 17 × 1.2, сверху мостик и ложе 24 × 22. Щель между рядами магнитов 4 мм. Ширина скобы ~16.5 мм — влезает в русло с шагом 24. Вес тележки ~50 г: магниты 34, сталь 10, ложе и мостик ~6~~ | ~~Стальные пластины снаружи усиливают поле в щели и закрывают поле от соседних русел. Соседние русла друг другу не мешают~~ | 💤 Отложено (03.10, см. [Т. Магнитная версия 2.0](/homepage/iniciativa.-razrabotka/jepik-ruka-gitara/t-magnitnaja-versija-2)) |
| 15.4 | ~~Пластина катушек~~ | ~~8 плоских катушек в ряд на всю ширину 52, ширина катушки 6.5, толщина 3, высота ~19 (активная часть 15 + лобовые части по 2). Окно катушки ~2.2 × 15. Провод ПЭТВ-2 0.15–0.18 мм, ~200 витков, ~8 Ом. Подключение по три фазы U-V-W-U-V-W-U-V (шаг 6.5 ≈ 120° при шаге полюсов 10). Скрипты подбора [lane_final.py](https://github.com/Korvova/gitar/blob/main/2-0/magnit/lane_final.py), [lane_opt.py](https://github.com/Korvova/gitar/blob/main/2-0/magnit/lane_opt.py)~~ | ~~Раскладка из 3–5 широких катушек даёт «провалы» силы в отдельных точках хода (там, где все катушки стоят в одной фазе с магнитами). 8 узких — самая ровная. Две смещённые прослойки катушек ([lane_2layer.py](https://github.com/Korvova/gitar/blob/main/2-0/magnit/lane_2layer.py)) почти не выигрывают~~ | 💤 Отложено (03.10, см. [Т. Магнитная версия 2.0](/homepage/iniciativa.-razrabotka/jepik-ruka-gitara/t-magnitnaja-versija-2)) |
| 15.5 | ~~Высота стопки ≤ 25 мм~~ | ~~Палуба 1.5 + зазор 0.3 + мостик 1.2 + зазор 0.5 + лобовая часть 2 + магниты/активная часть 15 + лобовая часть 2 + дно 1 = **23.5 мм**~~ | ~~Запас 1.5 мм. Если тесно — магниты 12 мм по высоте, сила падает примерно на 20%~~ | 💤 Отложено (03.10, см. [Т. Магнитная версия 2.0](/homepage/iniciativa.-razrabotka/jepik-ruka-gitara/t-magnitnaja-versija-2)) |
| 15.6 | ~~Сила и нагрев~~ | ~~Оценка расчётом (магниты без учёта стальных пластин — с ними сильнее): **500 г вбок ≈ 16 Вт** в среднем по ходу, до ~22 Вт в худших точках, если каждой катушкой управлять отдельно; при простом подключении тремя фазами — примерно в 1.7 раза больше. **300 г ≈ 6 Вт, 150 г ≈ 1.5 Вт** — мощность растёт как квадрат силы. Переход между струнами 0.2–0.5 с нагревает работающие катушки на 1–3 °C~~ | ~~Держать 500 г долго нельзя — перегрев. Двигать сильно, держать слабо. Сила падает у краёв хода (струны 1 и 6), там магниты частично выходят за пластину~~ | 💤 Отложено (03.10, см. [Т. Магнитная версия 2.0](/homepage/iniciativa.-razrabotka/jepik-ruka-gitara/t-magnitnaja-versija-2)) |
| 15.7 | ~~Удержание без тока (идея)~~ | ~~Маленькие стальные вставки под палубой на местах 6 струн: магниты тележки сами «защёлкиваются» на струне, держать током не нужно. Ток нужен только на переход~~ | ~~Размер вставок подобрать так, чтобы защёлка держала палец, но мотор её легко перебарывал~~ | 💤 Отложено (03.10, см. [Т. Магнитная версия 2.0](/homepage/iniciativa.-razrabotka/jepik-ruka-gitara/t-magnitnaja-versija-2)) |
| 15.8 | ~~Крепёж рядом с руслами~~ | ~~Винты стяжки рядом с магнитами — латунь или нержавейка A2. Стальной винт притянет тележку~~ | ~~Магниты N52 в скобе сильно тянутся друг к другу и к пластинам — собирать скобу на клей в печатной рамке, по одному магниту~~ | 💤 Отложено (03.10, см. [Т. Магнитная версия 2.0](/homepage/iniciativa.-razrabotka/jepik-ruka-gitara/t-magnitnaja-versija-2)) |

## Этап 3. Проба одного русла

| Номер | Требование | Описание | Урок | Статус |
|---|---|---|---|---|
| 15.9 | ~~Покупки на пробу и на 4 русла~~ | ~~Магниты 15 × 10 × 5 N52, намагничены по толщине — 30 шт (24 + запас). Провод ПЭТВ-2 0.15–0.18 мм — катушка 100 г. Стальная полоса 1–1.5 мм под пластины скобы. Драйвер на 3 фазы, например модуль SimpleFOC Mini (DRV8313) — 4 шт (на пробу 1). Блок 12 В 5 А. Эпоксидка или суперклей для катушек, латунные винты M3~~ | ~~Управление и положение тележки — своим способом владельца~~ | 💤 Отложено (03.10, см. [Т. Магнитная версия 2.0](/homepage/iniciativa.-razrabotka/jepik-ruka-gitara/t-magnitnaja-versija-2)) |
| 15.10 | ~~Намотка катушек~~ | ~~Печатная оправка: сердечник 2.2 × 15 и две щёчки с зазором 3 мм. ~200 витков, по ходу пропитывать клеем, снять с оправки. 8 катушек вклеить в рамку пластины в ряд~~ | ~~Удобнее самоспекающийся провод: после намотки прогреть феном, витки склеятся сами~~ | 💤 Отложено (03.10, см. [Т. Магнитная версия 2.0](/homepage/iniciativa.-razrabotka/jepik-ruka-gitara/t-magnitnaja-versija-2)) |
| 15.11 | ~~Проба: «да, это оно» на одном пальце~~ | ~~Одно русло: пластина катушек + скоба с 6 магнитами + ложе. Проверить: ход 44 мм от струны 6 до струны 1, сила под пальцем (потянуть вбок через весы), нагрев за 5 минут «Паучка», насколько ровно идёт у краёв~~ | ~~Как и в 11.12: сначала доводим один палец, потом копируем на остальные~~ | 💤 Отложено (03.10, см. [Т. Магнитная версия 2.0](/homepage/iniciativa.-razrabotka/jepik-ruka-gitara/t-magnitnaja-versija-2)) |
| 15.13 | ~~Магниты и провод на пробу (03.10)~~ | ~~Посчитано, что есть в продаже ([compare_magnets.py](https://github.com/Korvova/gitar/blob/main/2-0/magnit/compare_magnets.py)): **20×10×5 N52 стоя** (10 вдоль хода, 20 по высоте) — 300 г ≈ 9 Вт, 500 г ≈ 25 Вт, стопка 25 мм (катушка 16 + лобовые прячутся в высоте магнита) — лучше расчётного 15×10×5 (12 / 32 Вт). Диск Ø15×5 — 17 / 48 Вт; 20×10×5 лёжа — 48 / 134; 20×10×3 с дыркой — 96 / 267. Куплено: 2 набора 20×10×5 N52 (8 шт), сталь 1.5 мм 100×100. Провод — свой 0.3 мм: силу на ватт не меняет, ~40 витков, малое сопротивление — к нашей плате с TMC2209 (она держит ток). Тоньше 0.15–0.18 понадобится для DRV8833 на каждую катушку~~ | ~~Диски 4×2 владельца — до 60 г даже плиткой ([lane_disk4x2.py](https://github.com/Korvova/gitar/blob/main/2-0/magnit/lane_disk4x2.py)); дорожка магнитов с катушками на тележке — ещё слабее ([track_disk4x2.py](https://github.com/Korvova/gitar/blob/main/2-0/magnit/track_disk4x2.py)); ряд самодельных электромагнитов со сталью под струнами — едет только на колёсиках ([fem_magnit_nad_katushkami.py](https://github.com/Korvova/gitar/blob/main/2-0/magnit/fem_magnit_nad_katushkami.py)). Две фазы последовательно на всю ширину — ~64 Вт на 300 г против ~8–11 при управлении каждой катушкой ([lane_2phase.py](https://github.com/Korvova/gitar/blob/main/2-0/magnit/lane_2phase.py)): для пробы годится, для силы — по катушке~~ | 💤 Отложено (03.10, см. [Т. Магнитная версия 2.0](/homepage/iniciativa.-razrabotka/jepik-ruka-gitara/t-magnitnaja-versija-2)) |
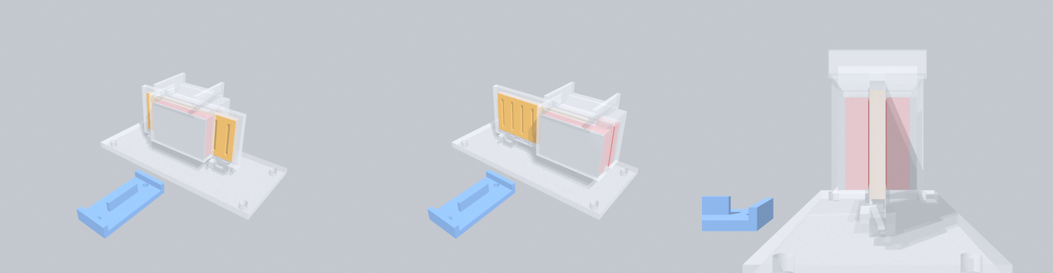
[picture p131: wiki/img/magnit_proba_stol86.png]
Стол 86
| 15.14 | ~~Пробное русло: стол 86~~ | ~~Детали [gitara_magnit_proba.py](https://github.com/Korvova/gitar/blob/main/2-0/magnit/gitara_magnit_proba.py), стол [86_magnit_proba.3mf](https://raw.githubusercontent.com/Korvova/gitar/main/2-0/Print3mf/86_magnit_proba.3mf): 2 оправки для намотки (щёчка с сердечником 1.6 × 16 + прижимная, зазор 3.0, 2 × М3), рамка катушек 3 мм с окном 52 × 21 (верхняя планка — рельс скобы), основа, U-скоба с гнёздами под 6 магнитов и 2 стальные пластинки 30 × 20 × 1.5, мостик с пазом едет по рельсу, сверху ложе. Катушка: окно 1.6 × 16, снаружи 6.5 × 20.9, толщина 3, ~40 витков провода 0.3 (8 шт ≈ 14 м). Фазы: **A — катушки 1, 4, 7 прямо + 6 наоборот; B — 2, 5, 8 прямо + 3 наоборот** (номера — точки на нижней планке, слева направо). ~~ | ~~Стенд шире грифа: скоба 33 мм при ходе ±22 выходит за край на 11 мм — в настоящем грифе решать (2 магнита на сторону или иначе). Магниты в гнёзда — снизу, по одному, на клей; сталь держится на магнитах~~ | 💤 Отложено (03.10, см. [Т. Магнитная версия 2.0](/homepage/iniciativa.-razrabotka/jepik-ruka-gitara/t-magnitnaja-versija-2)) |

## Этап 4. Потом: перемещение по грифу

| Номер | Требование | Описание | Урок | Статус |
|---|---|---|---|---|
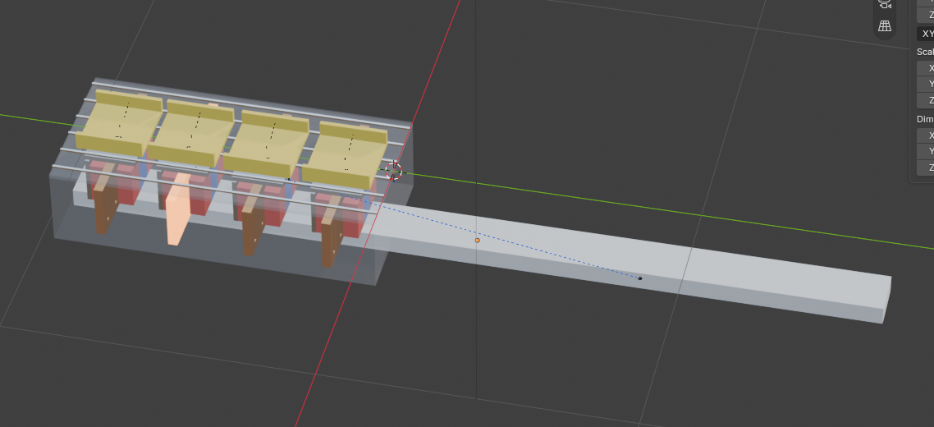
[picture p132: wiki/img/magnit_blok_vdol_grifa.png]
Блок на грифе
| 15.12 | ~~Блок из 4 русел ездит вдоль грифа~~ | ~~Идея владельца 01.10: если магнитные русла заработают, весь блок (4 пластины катушек, 4 тележки, рамка) становится кареткой и ездит вдоль грифа. Возит её NEMA 14 в деке через ремень — смена позиции (I, V, IX…) без участия руки. ~~ | ~~Блок лёгкий (~300–400 г), NEMA 14 с ремнём даёт 2–4 кг тяги — с запасом. К катушкам блока нужен гибкий шлейф. Шаг русел постоянный, а расстояние между ладами меняется: I позиция 34/32/31 мм, V — 27/26/24, XII — 18–16. Блок с шагом V позиции удобен в зоне V–IX; дальше — несколько зон или раздвижные русла~~ | 💤 Отложено (03.10, см. [Т. Магнитная версия 2.0](/homepage/iniciativa.-razrabotka/jepik-ruka-gitara/t-magnitnaja-versija-2)) |

## Переписка 01.10 — для продолжения на другом ПК

Весь разговор с ИИ 01.10, по порядку: вопрос владельца → ответ. Заметка для ИИ на другом ПК: прочитать эту страницу целиком, потом [Т. Вариант с тележками](/homepage/iniciativa.-razrabotka/jepik-ruka-gitara/t-variant-s-telezhkami) и [Т. Тележки](/homepage/iniciativa.-razrabotka/jepik-ruka-gitara/t-telezhki). Расчёты и модели — в репозитории `2-0/magnit/`.

1. **Как сделать тактильный тренажёр аппликатуры (перчатка / платформа / палка)?** Варианты: свет на грифе + вибро в пальцы; перчатка с вибро-кодом; палка-тренажёр с кнопками и вибро; платформа под ладонь с напальчниками; «Брайль на грифе» (выдвижные штырьки); проверка правильности датчиками струн 49E.
2. **А двигающиеся тележки на грифе?** Можно: одна тележка показывает позицию, 4 тележки по пальцу, тележка сзади грифа под большой палец. Поперёк грифа мешают струны.
3. **Нужно, чтобы палец сгибался и разгибался.** Варианты: толкающая «палка», рычаги-экзоскелет, мягкая пневматика, нитинол, электростимуляция. Обязательно ограничение силы.
4. **Решение владельца: 4 тележки, по одной на палец; струн можно не делать.** Без струн тележки едут в самом грифе, нажим — человек.
5. **Магнит в напальчнике + тележка под тонкой крышкой: дальнодействие маленькое?** Да: N52 10×3 — ~2 кг вплотную, ~1 кг через 1 мм, ~0.5 кг через 2 мм, почти ноль через 5 мм. Палец из воздуха не притянет, только держит и ведёт. Вбок держит в 3–5 раз слабее, чем на отрыв.
6. **Идея владельца: ряд катушек под крышкой, на пальце пластинка, катушки включаются по очереди.** Это матрица электромагнитов (плоский шаговый мотор). С магнитом на пальце вместо пластинки — сильнее и можно отталкивать. Смена полярности: текущая катушка отталкивает, следующая тянет. Нюансы: сердечник тянет магнит всегда; для смены полярности нужны H-мосты (DRV8833), ULN2803 не годится.
7. **Идея владельца: тележка над рядом электромагнитов.** Это линейный двигатель. Лучшая тележка — мягкая сталь с зубцами (реактивный мотор, без проводов, не липнет); шаг зубцов ≠ шаг катушек. Готовых линейных моторов в рознице почти нет — собирать из удерживающих электромагнитов KK-P10/10, P20/15. Соленоиды с толкателем не подходят.
8. **Тележка причудливой формы (клин)?** Посчитано 2D-моделью — строка 15.1: лучше всех гребёнка (~50 г вбок на 300 ампер-витков), плоская пластина только прилипает вниз. Модель `linear_finger.blend` (одна тележка с пальцем на IK).
9. **Электромагниты с Али подойдут? Можно хоть 220 В.** 220 В не нужно и опасно; сила упирается в нагрев и насыщение железа. Брать P20/15 12 В, импульсы 24 В. «5 кг» у P25/20 — это прижим вплотную; вбок реально 150–400 г.
10. **NEMA 14 сколько тянет?** Момент 0.1–0.4 Н·м: с ремнём GT2 20T — 2–4.5 кг, с винтом T8 — 10–15 кг. Нужно ограничение тока (TMC2209, StallGuard).
11. **Нужно ~500 г вбок, тележки лёгкие, 4 дорожки. Может, на тележке три электромагнита: один отталкивает, другие тянут?** Да, но перевернуть: внизу дорожка из постоянных магнитов N-S-N-S, катушки без железа. Это линейный мотор с подвижными катушками; U-канал из магнитов с двух сторон почти удваивает поле. Расчёт magpylib (`ironless_track.py`).
12. **Греться будет?** 500 г ≈ 6–7 Вт при длинной дорожке; рывок 0.3–1 с — меньше 1 °C; держать постоянно нельзя. Мощность растёт как квадрат силы: 250 г ≈ 1.7 Вт. Провод 0.25 мм ~320 витков ~8 Ом.
13. **Модель в Blender без пальца, видеть внутренности.** Сцена MagnetTrack (`magnet_track.blend`): 5 стенок магнитов, 4 щели, тележки с катушками.
14. **Вес 0.5 кг магнитов — правда? Сколько весит тележка? Дорожки не мешают друг другу?** ~85 магнитов 12×5×15 по 6.8 г ≈ 0.5 кг; тележка ~30 г (медь 20 г); поле общее, соседям не мешает; стенки сильно тянутся друг к другу.
15. **Что такое плоская катушка, где взять? Ширина грифа 4.5 см?** Наматывать самому ПЭТВ-2 на печатную оправку, пропитка клеем или самоспекающийся провод; катушки-дорожки на плате в 2–3 раза слабее. Гриф: электро 41–43 мм, акустика 43–45, классика 50–52.
16. **Владелец прислал вики проекта.** Главное: тележки ездят ПОПЕРЁК грифа, ход 44, гриф 52 × 26, русла с шагом 24–26. Схема перевёрнута: катушки неподвижны на всю ширину, едет U-скоба с магнитами — строки 15.2–15.6. Модель `guitar_mag_lanes.blend` (сцена GuitarMagLanes).
17. **Создать эту страницу; обратная связь и драйверы — не проблема (владелец делает по-своему); что купить сегодня; учёл ли высоту 2.5 см?** Страница создана; высота стопки 23.5 мм (15.5); список покупок — 15.9.
18. **Если заработает — весь блок русел возить вдоль грифа NEMA в деке (потом).** Записано в 15.12.
19. **Что уже есть в наличии (скриншоты заказов)** — ниже. Итог: магнитная лента (тип Б) слабая, не подходит; MG996R, кнопки, MAX98357, TCA9548A, 74HC14 к этой задаче не относятся.

### Что есть у владельца (01.10)

| Есть | Годится для магнитной версии |
|---|---|
| DRV8833 модуль (сколько — уточнить) | ✅ управление катушками (до 10.8 В, ~1.5 А на канал) |
| ESP32 DevKit CH340C Type-C | ✅ контроллер пробы |
| ПЭТВ-2 0.3 мм, 20 м | ⚠️ на одно русло впритык (~17 м на 8 катушек), витков мало (~50), катушка ~0.6 Ом — ток ограничивать ШИМ. На 4 русла докупить, лучше 0.15–0.18 мм |
| Кабель AWG24 6- и 16-жильный | ✅ шлейф к катушкам |
| Макетные платы 830 / 400, Dupont, клеммники XY301V 3P и MF301, JST ZH 3pin, припой | ✅ стенд |
| Вплавляемые гайки M3 | ✅ рамка |
| Винты M3×8 оцинкованные | ⚠️ стальные — рядом с магнитами не ставить, нужны латунные |
| Подшипники 626-ZZ ×10 | на потом — каретка вдоль грифа (15.12) |
| Магнитная лента 12.7 × 1.5 тип Б | ❌ слишком слабая, нужны неодимовые N52 |

### Следующий шаг

Владелец досылает, что ещё есть, — ИИ даёт короткий список докупки для пробы одного русла (15.9–15.11). Скорее всего докупить: **магниты N52 15 × 10 × 5, намагниченные по толщине 5 мм** (на пробу 6–10 шт, на 4 русла 30), **стальную полосу 1–1.2 мм** под пластины скобы, **латунные винты M3**, тонкий провод 0.15–0.18 мм на остальные русла.
