Korvova/gitar/wiki/t-telezhki.md

Тележки — узел, от которого зависит успех тренажёра: в них вставляются пальцы, и тележки ведут их по грифу. Здесь всё про сами тележки: ложе, посадку на штырь, удобство для любой руки, а потом вибромотор и кнопку в тележке. Гриф, по которому они ездят, — на странице [Т. Гриф под тележки](/homepage/iniciativa.-razrabotka/jepik-ruka-gitara/t-grif-pod-telezhki).

## Этап 1. Ложе и посадка на штырь

| Номер | Требование | Описание | Урок | Статус |
|---|---|---|---|---|
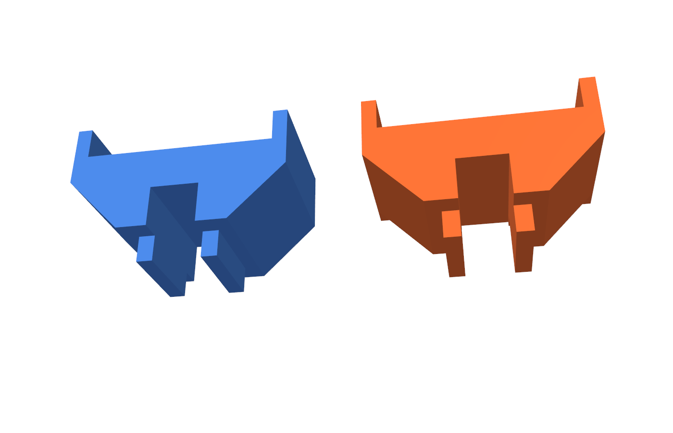
[picture p133: wiki/img/lozhe_v0_detal.png]
Ложе v0
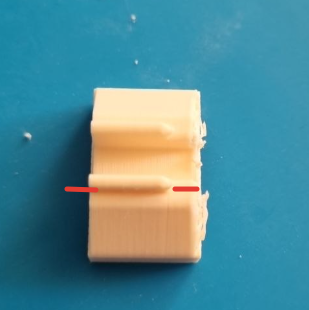
[picture p134: wiki/img/lozhe_v0_pervaya_pechat.png]
Первая печать
| 11.1 | Тележка с ложем для пальца | Под напечатанную секцию-1 (шаг тележек 16). **Переделана 26.09 по замерам владельца:** прорезь палубы на деле 10.5 мм (в модели 11), штырь 4.9. Тележка стоит на палубе, снизу два полоза уходят в прорезь (ширина 10.0) и держат её по Y; штырь — в сквозном по Y канале 5.3: по X ведёт тележку, по Y гуляет (в крайних положениях плеча уходит на юг на 4 мм). Сверху ложе 24×15: бортики 5 мм по концам хода, 1.5 мм вдоль. Старую тележку вынуть, новую поставить полозьями в прорезь на штырь. Стол [69_lozhe_palcy.3mf](https://raw.githubusercontent.com/Korvova/gitar/main/2-0/Print3mf/69_lozhe_palcy.3mf) пересобран — 4 шт, без поддержек, полозьями на стол.  | Первая печать 26.09 не встала: тележка была рассчитана лежать на палубе поверх прорези, а владелец ставил её в прорезь — теперь она делает и то и другое. Полозья вплотную к штырю: на ходу ±20 мм не упираются в концы прорези (±24.5). Модель [gitara_lozhe.py](https://github.com/Korvova/gitar/blob/main/2-0/gitara_lozhe.py) (`v0`), проверка: соседние ложа в крайних положениях не задевают друг друга, полозья не врезаются в палубу. Пальцам тесно при шаге 16 — поэтому секция-1 v2 ([Т. Гриф под тележки](/homepage/iniciativa.-razrabotka/jepik-ruka-gitara/t-grif-pod-telezhki), 12.1) **Итог 26.09:** первая печать (тележка поверх прорези) наклонялась: прорезь сдвинута на 2 мм к деке, и тележка опиралась с одной стороны на 0.5 мм.  Следующий вариант — по центру прорези, но владелец предложил проще: убрать тележку и скосы совсем (11.2) | ❌ Заменено плоским ложем 11.2 |
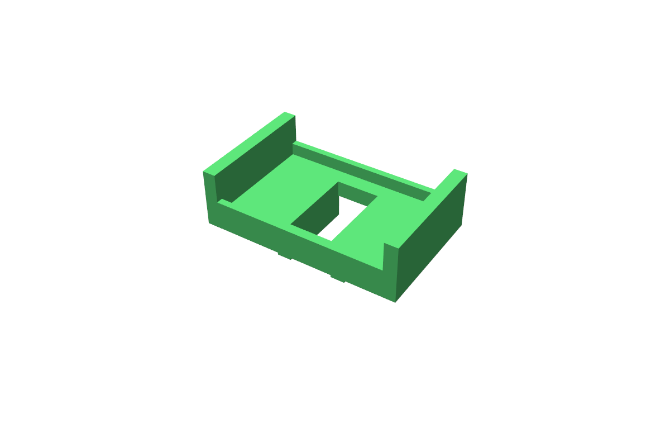
[picture p135: wiki/img/lozhe_plosk_sverhu.png]
Плоское ложе сверху
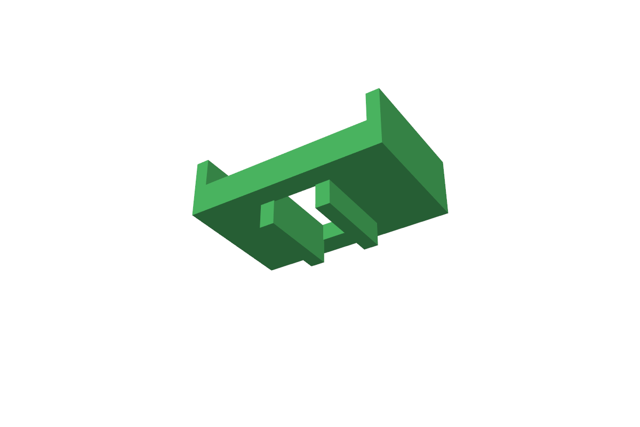
[picture p136: wiki/img/lozhe_plosk_snizu.png]
Плоское ложе снизу
| 11.2 | Плоское ложе (идея владельца 26.09) | Без тележки и скосов: ложе 24×15 с бортиками лежит прямо на палубе, по центру прорези; снизу два полоза уходят в прорезь на 2.9 мм и держат его поперёк; в дне продолговатая дырка под штырь 5.3 × 9.6 — штырь ведёт ложе вдоль хода и гуляет вдоль грифа на 4 мм, над дном торчит ~2 мм (для пробы можно). Для тележки 3 — крайнее: укорочено к деке, там бортик канала. Печать вверх ногами — бортиками на стол, дно мостом, без поддержек. Проба — стол [75_lozhe_proba.3mf](https://raw.githubusercontent.com/Korvova/gitar/main/2-0/Print3mf/75_lozhe_proba.3mf) (1 шт), ещё три — [76_lozhe_plosk_3.3mf](https://raw.githubusercontent.com/Korvova/gitar/main/2-0/Print3mf/76_lozhe_plosk_3.3mf) (2 обычных + крайнее). Сверху:  Снизу:  | Замеры владельца: прорезь палубы напечаталась 10.5 (в модели 11), штырь 4.9 — полозья 10.0, дырка 5.3. Скосы были нужны только чтобы поднять ложе над штырём и напечатать широкое ложе без поддержек; когда ложе лежит на палубе, они не нужны. Модель [gitara_lozhe.py](https://github.com/Korvova/gitar/blob/main/2-0/gitara_lozhe.py) `v0`, проверка: все 4 ложа в крайних положениях ±20 мм ложатся на палубу без вреза, крайнее не задевает бортик | ⚠️ Одно напечатано — «вариант неплох» (26.09), ещё три на печати |
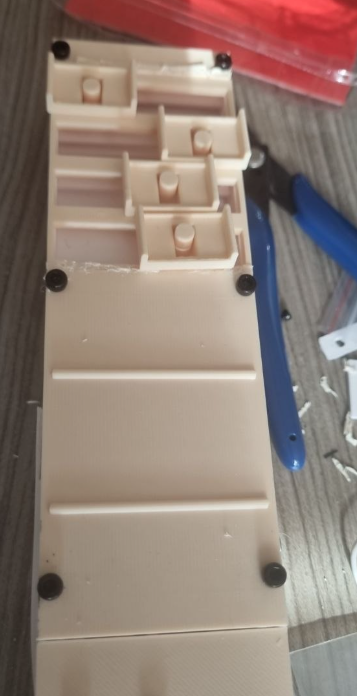
[picture p137: wiki/img/lozhe_plosk_na_grife_foto.png]
Плоские ложа на грифе
| 11.3 | Аппликатура чувствуется | Вставить пальцы в ложа, гонять тележки с пульта по одной и вместе: палец сгибается и разгибается, как при зажатии струн  | 26.09, владелец: «поставил пальцы — было прям лучше, покрутил моторами, потенциал есть; до идеала далеко» | ⚠️ Первая проба 26.09: лучше, до идеала далеко |

## Этап 2. Удобство для любой руки

| Номер | Требование | Описание | Урок | Статус |
|---|---|---|---|---|
| 11.4 | Удобство для любой руки | **Решение 26.09:** прорези остаются перпендикулярны грифу — это путь кончика вдоль лада, как на настоящей гитаре. Угол пальца (веер: указательный к порожку, мизинец к деке) даёт само ложе: оно палец не зажимает, а только ведёт, палец сам поворачивается внутри. Поворотный механизм не нужен — нужно просторное ложе. Проверить на v2 (внутри 20 мм); если тесно под углом — скруглить углы ложа или расширить его к концам | Если повернуть прорези на 10°, кончик на 6-й и 1-й струне разойдётся по ладу на ~8 мм (44 × tan 10°) — треть ладового промежутка V позиции: тренажёр учил бы ставить палец не туда. У гитариста кончик тоже идёт по ладу, а угол подстраивают кисть и запястье; у тренажёра кисть неподвижна — эту свободу даёт ложе | ⬜ Проверить на v2 |
| 11.5 | Размеры под руку: S / M / L | Ширина ложа внутри 12 / 14 / 16 мм — детская, женская, мужская рука; ложе мизинца всегда самое маленькое | Ширина подушечки взрослого 14–18 мм, ребёнка ~12. Делать после пробы секции-1 v2 | ⬜ Идея |

## Этап 3. Электроника в тележке

| Номер | Требование | Описание | Урок | Статус |
|---|---|---|---|---|
| 11.6 | Вибромотор в тележке | Подсказка пальцу: «здесь», «жми», ошибка | Главная трудность — провода к подвижной тележке: ход ±20 мм поперёк грифа, тележек четыре | ⬜ Потом |
| 11.7 | Кнопка в тележке | Тренажёр узнаёт, что ученик нажал пальцем | То же: провода к подвижной тележке | ⬜ Потом |

## Этап 4. Калибровка струн и первая мелодия

| Номер | Требование | Описание | Урок | Статус |
|---|---|---|---|---|
| 11.8 | Калибровка струн для каждой тележки | Идея владельца 26.09: в пульте у каждого мотора кнопки «чуть влево / чуть вправо» (шаг 1° и 5°); ставишь палец над струной 1 — «Струна 1 — запомнить», сдвигаешь — «Струна 2 — запомнить», и так все 6. Позиции хранятся в памяти ESP и не теряются при выключении | Запоминается угол мотора, а не миллиметры: кривошип двигает тележку по синусу, калибровка это учитывает сама | ⚠️ Сделано в прошивке и пульте 26.09, на грифе не проверено — [Т. Софт](/homepage/iniciativa.-razrabotka/jepik-ruka-gitara/t-soft) 13.7–13.8 |
| 11.9 | Сверка в начале сессии | Мотор не знает, где стоит после включения — считаем шаги от места включения. Поэтому в начале сессии каждую тележку ставим на струну 1 и жмём «это струна 1», остальные пять пересчитываются сами | Потом сверку сделают датчики Холла под лентами — [Т. Положение тележек](/homepage/iniciativa.-razrabotka/jepik-ruka-gitara/t-polozhenie-telezhek) | ⚠️ Сделано в прошивке и пульте 26.09, на грифе не проверено — [Т. Софт](/homepage/iniciativa.-razrabotka/jepik-ruka-gitara/t-soft) 13.7–13.8 |
| 11.10 | Первая мелодия: «Ода к радости» | В V позиции, работают все 4 пальца, 2 струны: ми — 2 струна 5 лад, указательный; фа — 2 струна 6 лад, средний; соль — 2 струна 8 лад, мизинец; ре — 3 струна 7 лад, безымянный; до — 3 струна 5 лад, указательный. Порядок: ми ми фа соль, соль фа ми ре, до до ре ми, ми ре ре. На каждой ноте нужная тележка переезжает на свою струну, пульт в это время играет звук ноты; темп — ползунком, для начала медленно. Послушать: [oda_k_radosti.wav](https://raw.githubusercontent.com/Korvova/gitar/main/wiki/audio/oda_k_radosti.wav) | Мелодию выбрал и одобрил владелец 26.09. Звук синтезирован щипком струны (Карплус-Стронг), скрипт [make_oda_wav.py](https://github.com/Korvova/gitar/blob/main/2-0/websim/make_oda_wav.py). Делать после калибровки 11.8 | Мотор = палец (по сборке владельца 27.09): 0 — мизинец, 1 — безымянный, 2 — средний, 3 — указательный; в пульте карточки подписаны пальцами. ⚠️ Сделано в прошивке и пульте 26.09, на грифе не проверено — [Т. Софт](/homepage/iniciativa.-razrabotka/jepik-ruka-gitara/t-soft) 13.7–13.8 |
| 11.11 | Упражнения, где пальцы много ходят | В «Оде» между струнами ходит только указательный — движений для пробы мало (владелец 27.09). В пульте выбор из списка: «Ода к радости»; **«Паучок» 6 → 1 → 6** — на каждой струне по очереди указательный, средний, безымянный, мизинец (лады 5–8), вверх до струны 1 и обратно, 48 нот, каждый палец проходит все 6 струн; **ля-минорная пентатоника** — все 6 струн вверх и обратно, указательный, безымянный и мизинец. Для каждого пункта пульт пишет, какие струны каких моторов нужно откалибровать | Тележка двигает палец только поперёк грифа, «прижать и отпустить» не умеет — поэтому ощущается только смена струн. Идея на потом: «парковка» неиграющих пальцев за край грифа, чтобы каждая нота была движением | ⚠️ Сделано в пульте 27.09, на грифе не проверено |
| 11.12 | Один палец: указательный прыгает | Решение 27.09: сначала довести до «да, это оно» один указательный, потом копировать на остальные. Упражнение «Указательный: прыжки» (стоит первым в списке пульта): 5 лад, по одной струне 6 → 1 → 6, через струну (6–4, 5–3, 4–2, 3–1 и обратно), большие прыжки 6–1–6–1, 5–2, 4–3; 39 нот. Ползунок «переезд» 20–150 об/мин — насколько резко тележка прыгает на струну | Отдельной мелодии на один палец нет: на одном ладу у пальца всего 6 нот (ля, ре, соль, до, ми, ля), зато вместе они звучат как перебор аккорда. Что проверить на указательном: ложе (удобство, угол), движение (какая скорость ощущается естественно), нота (нужен ли «поставил — убрал» — толчок или вибро) | ⚠️ Сделано в пульте 27.09, на грифе не проверено |

## Этап 5. Равномерный ход: большой кривошип (проба на моторе 3)

| Номер | Требование | Описание | Урок | Статус |
|---|---|---|---|---|
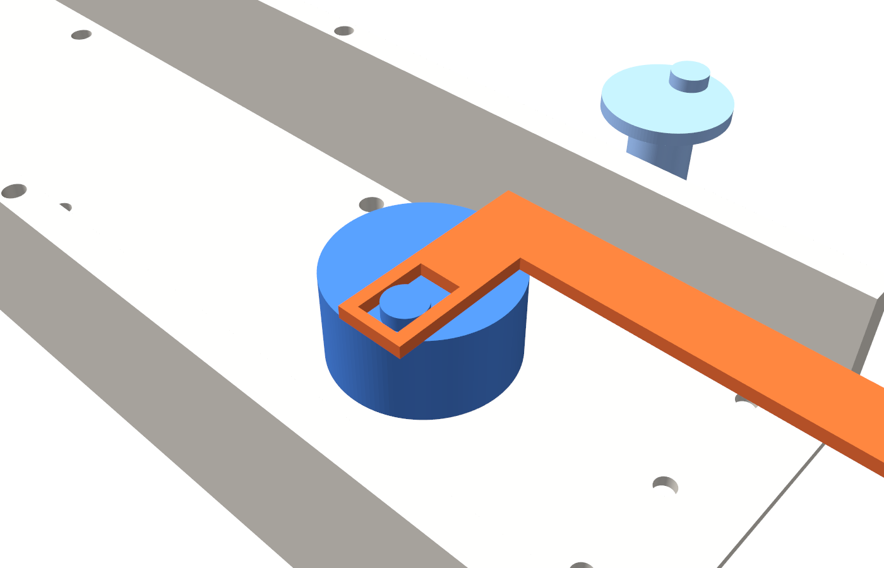
[picture p138: wiki/img/crank3_big.png]
Большой кривошип
| 11.13 | Кривошип 3 радиусом 7.5 и хвост 3 под него | Палец указательного почти не чувствовал переход 1 → 2: с радиусом 4.8 крайние струны стоят в «мёртвых точках» кривошипа (±62°) — между струнами 1–2 и 5–6 диск крутится на 35°, посередине на 15°. С радиусом 7.5 струны 1–6 — это ±34°, ход почти равномерный. Кривошип сделан как усиленный astra_crank3_A3 (та же посадка Ø5.8 на шестерню, высота диска и пальца, конус-усиление), больше только радиус пальца и диска (Ø22). Палец на западе — рабочий сектор 180° ± 50°. Хвост 3: прорезь-кулиса только с западной стороны, лента целая. Стол [78_crank3_big.3mf](https://raw.githubusercontent.com/Korvova/gitar/main/2-0/Print3mf/78_crank3_big.3mf): кривошип пальцем вниз (поддержки от стола под диском) + хвост.  | Полный оборот больше нельзя: на ±50° лента уходит на ±5.75, тележка уехала бы за концы прорези секции-1. Поэтому прошивка держит мотор внутри откалиброванных струн 1–6 (+40 шагов). После замены: «Стереть калибровку» у мотора 3, повернуть кривошип пальцем на запад (от ленты), надеть хвост, откалибровать струны заново. Проверка моделью [gitara_crank3_big.py](https://github.com/Korvova/gitar/blob/main/2-0/gitara_crank3_big.py): сектор ±50° шагом 10° — кривошип и хвост не задевают Д1, Д2 и ленту этажа 2, палец не доходит до концов прорези (запас 0.3). Идея «барабан на валу в голове грифа» ([сцена](https://github.com/Korvova/gitar/blob/main/2-0/%D0%98%D0%B4%D0%B5%D1%8F_%D0%B1%D0%B0%D1%80%D0%B0%D0%B1%D0%B0%D0%BD_%D0%BF%D0%B0%D0%BB%D0%B5%D1%86.blend)) отклонена владельцем: слишком широко | ⬜ Не напечатано |
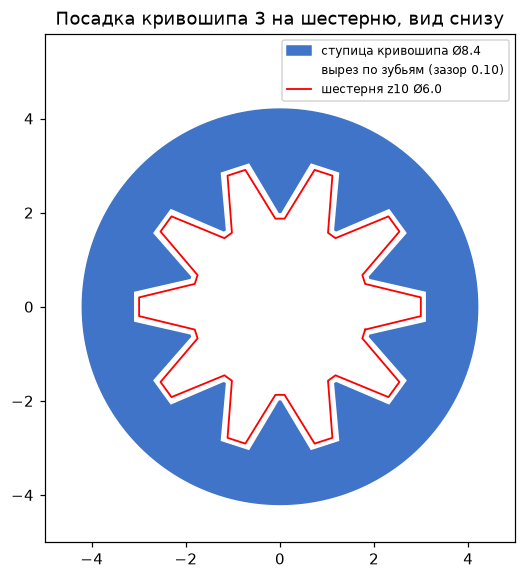
[picture p139: wiki/img/crank3_big_zub_sechenie.png]
Посадка по зубьям
| 11.14 | Кривошип 3 не проворачивается на шестерне | Круглая посадка Ø5.8 на шестерню Ø6.0 проворачивалась (владелец 27.09). У кривошипа 3 R7.5 вырез теперь по зубьям шестерни z10 с зазором 0.10 — профиль «звёздочки» из купона 66. Стол [79_crank3_big_zub.3mf](https://raw.githubusercontent.com/Korvova/gitar/main/2-0/Print3mf/79_crank3_big_zub.3mf) — только кривошип; хвост со стола 78 тот же.  | Шестерня мотора: 10 зубьев, Ø6.0 по вершинам (замер 13.09). Если туго — зазор 0.15–0.2; если болтается — 0.05 | ⬜ Не напечатано |
