Korvova/gitar/wiki/t-grif-pod-telezhki.md

Секция-1 грифа — та, по которой ездят тележки с пальцами. Версия v2 разводит тележки на расстояние между пальцами как на настоящем грифе. Сами тележки — на странице [Т. Тележки](/homepage/iniciativa.-razrabotka/jepik-ruka-gitara/t-telezhki).

## Этап 1. Проект секции-1 v2

| Номер | Требование | Описание | Урок | Статус |
|---|---|---|---|---|
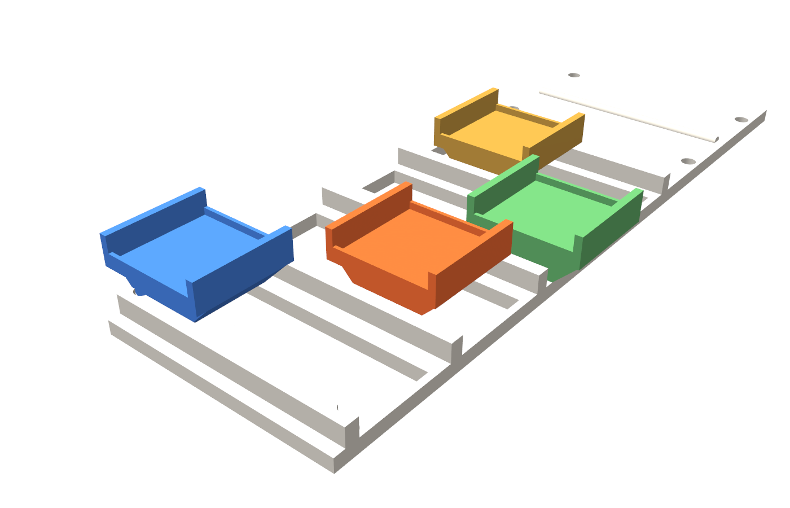
[picture p141: wiki/img/lozhe_v2_na_grife.png]
На грифе
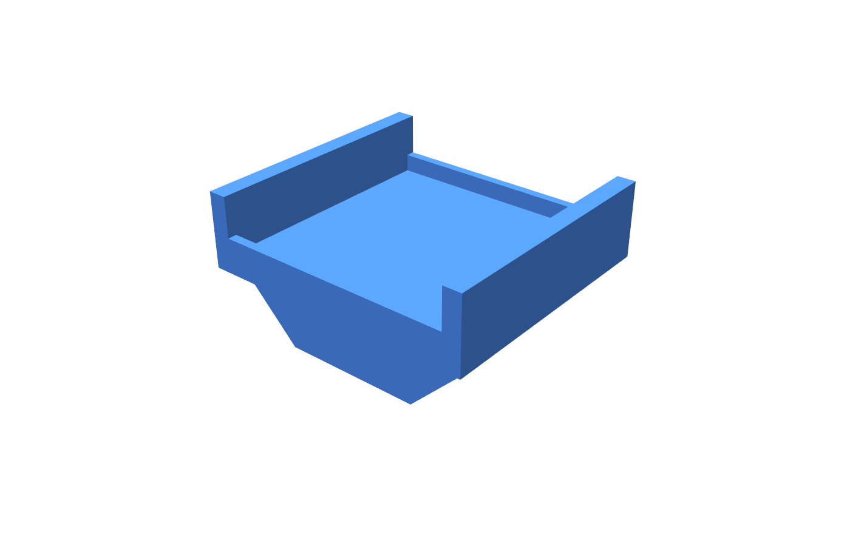
[picture p142: wiki/img/lozhe_v2_detal.png]
Тележка v2
| 12.1 | Шаг тележек V позиции | Тележки на Y 16 / 42 / 67 / 91 — шаг 26 / 25 / 24 мм, как между пальцами на ладах 5–8 (мензура 650). Тележка 12×18, у каждой своё русло: бортики снаружи и между тележками. Паз под штырь закрыт с обеих сторон и длиннее: штырь гуляет по Y и тележку не толкает. Сверху ложе 24×22 — внутри 20 мм, влезает любой палец. Средняя стяжка стопки переехала с y=80 на y=120 (там теперь ходят тележки).   Сцена в сборе с анимацией качания: [Гитара_секция1_v2.blend](https://github.com/Korvova/gitar/blob/main/2-0/%D0%93%D0%B8%D1%82%D0%B0%D1%80%D0%B0_%D1%81%D0%B5%D0%BA%D1%86%D0%B8%D1%8F1_v2.blend) (пробел — проиграть; коллекции прятать глазом, чтобы заглянуть внутрь) | Исследование 26.09: расстояние между пальцами — I позиция 34/32/31 мм, V — 27/26/24, IX — 22/21/19, XII — 18–16. Наши 16 мм — это XII лад, отсюда «тесно». Ширина подушечки взрослого 14–18 мм. Пальцы стоят веером, кончик давит почти отвесно. Модель [gitara_sec1_v2.py](https://github.com/Korvova/gitar/blob/main/2-0/gitara_sec1_v2.py), проверка: плечи на ±22.6° не задевают плиты, штырь в пазу тележки, тележка в русле без вреза, спица-3 (ось 143) ещё помещается до стыка. Меняется только секция-1: секция-2, дека и плата те же | ✅ Модель готова, проверена |
| 12.2 | Струны-бугорки на палубе секции-1 | Как на фретбордах секций 2 и 3: 6 полуцилиндров высотой 0.6 с шагом 8.8 вдоль грифа Сделано на палубе секции-1 v2 (стол 74): от конца русел до южного края, у винтов стяжки прерываются | Решение владельца 26.09: только на свободной части палубы южнее тележек, для вида — в руслах тележки о них спотыкались бы. На напечатанной секции v0 не делаем | ✅ В модели v2 |

## Этап 2. Печать и сборка

| Номер | Требование | Описание | Урок | Статус |
|---|---|---|---|---|
| 12.3 | Печать секции-1 v2 | [73_sec1_v2_plity.3mf](https://raw.githubusercontent.com/Korvova/gitar/main/2-0/Print3mf/73_sec1_v2_plity.3mf) — дно и 3 межэтажки, слой 0.2. [74_sec1_v2_meh.3mf](https://raw.githubusercontent.com/Korvova/gitar/main/2-0/Print3mf/74_sec1_v2_meh.3mf) — палуба, 4 плеча, 4 спицы, 4 тележки с ложем, слой 0.12 (как стол 32) | Столы 31/32 (секция-1 v0) не трогаем — остаются рабочими | ⬜ Не напечатано |
| 12.4 | Сборка секции-1 v2 | Та же, что у v0 — по [Т. Инструкция по сборке: секция-1](/homepage/iniciativa.-razrabotka/jepik-ruka-gitara/t-instrukcija-sborki); отличие одно: тележка ставится в своё русло пазом на штырь |  | ⬜ |
