Korvova/gitar/wiki/t-sborka-korotkij-grif.md

**Готово 26.09:** короткий гриф собран, все четыре мотора ведут свои тележки. Тележки и секция-1 v2 дальше ведутся на отдельных страницах.

Стенд для проверки всех четырёх моторов: гриф **без секции-3**. Секция-3 — просто удлинитель
лент (переходник), на столе с ней неудобно. Снизу секции 2 и 3 одинаковые, поэтому дека
ставится прямо на секцию-2 тем же стыком. Собираем: секция-1 с тележками → секция-2 с лентами →
дека с четырьмя моторами → плата 4 моторов, и гоняем все четыре тележки с пульта.

Подробные шаги с картинками — на страницах [Т. Инструкция по сборке: гриф с моторами](/homepage/iniciativa.-razrabotka/jepik-ruka-gitara/t-instrukcija-grif)
(часть 1) и [Т. Гриф в деке](/homepage/iniciativa.-razrabotka/jepik-ruka-gitara/t-grif-v-deke); здесь — что именно делать для короткого грифа и отметки.

## Этап 1. Что напечатать и найти

| Номер | Требование | Описание | Урок | Статус |
|---|---|---|---|---|
| 10.1 | Стол 68 | [68_deka2_v3.3mf](https://raw.githubusercontent.com/Korvova/gitar/main/2-0/Print3mf/68_deka2_v3.3mf): хребет Д2, кривошип 3, лента-хвост 3. Слой 0.2, поддержки только от стола. Без него мотор 3 ставить некуда |  | ✅ Напечатано |
| 10.2 | Уже есть | Секция-1 с тележками (собрана 13.09). Стол 33 — секция-2: дно, 4 П-рейки, фретборд, планка-потолок. 4 ленты-продолжения со столов 35/36 (нужны 4 из 8). Стол 67 — хребет Д1, кривошипы 0–2, проставка, 3 гребёнки, 3 фиксатора, хвосты 0–2. 4 мотора Ø36, плата 4 моторов | Стол 34 (секция-3) для короткого грифа не нужен | ✅ Есть |
| 10.3 | Винты | М3×4 — 9 шт (стыки 1/2, 2/Д1, Д1/Д2, по 3); М3×10 — 7 шт (фретборд секции-2) + 2 шт (уши мотора 0 сквозь проставку); М3×5 — 6 шт (уши моторов 1–3) |  | ✅ |

## Этап 2. Гриф: секция-1 + секция-2

| Номер | Требование | Описание | Урок | Статус |
|---|---|---|---|---|
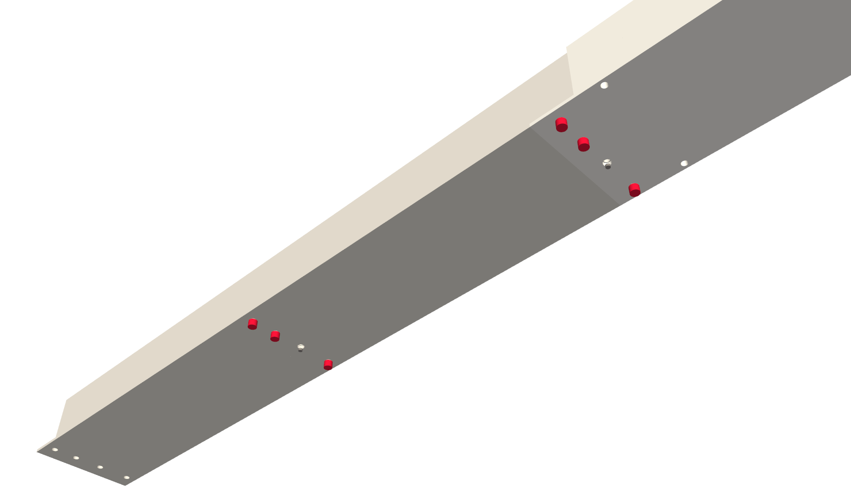
[picture p143: wiki/img/sborka_v_1_styki.png]
Стык
| 10.4 | Стык секция-1 / секция-2 | Дно секции-2 вырезом поверх полки секции-1, 3 винта М3×4 снизу; среднее отверстие со стороны жёлоба лент — пустое (винт вылезет в проход ленты).  |  | ✅ Собрано 26.09 |
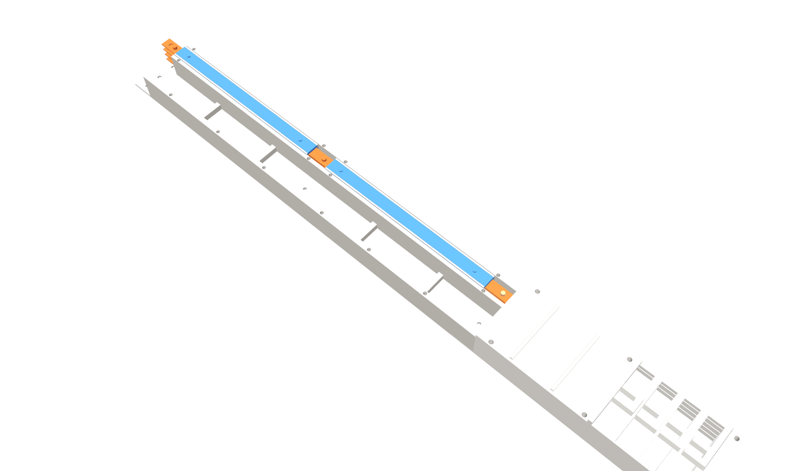
[picture p144: wiki/img/sborka_v_3_etazhi.png]
Этажи
| 10.5 | Ленты этажей 0–3 | В секцию-2 по П-рейке жёлобом вверх, ленту — северным концом на хвост спицы из секции-1 (штырёк в дырку). Следующая рейка — на стенки предыдущей. На ленту этажа 3 — планка-потолок пеньками вверх. После каждого этажа подвигать ленту ±4 мм — едет только своя тележка.  |  | ✅ Собрано 26.09 |
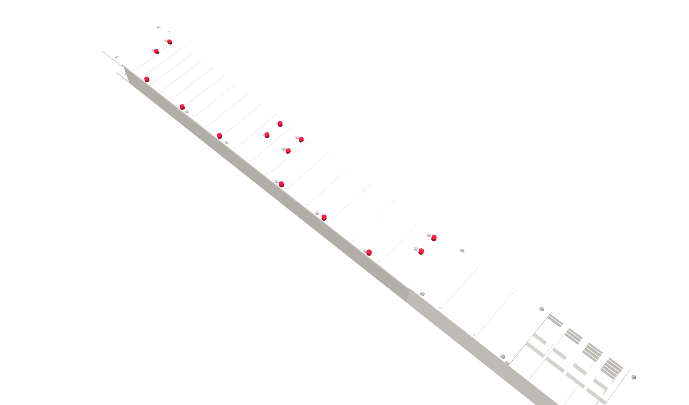
[picture p145: wiki/img/sborka_v_4_fretbordy.png]
Фретборд
| 10.6 | Фретборд секции-2 | Ладами вверх, пеньки планки — в дырки снизу, 7 винтов М3×10.  | Туго после фретборда — пенёк планки не попал в дырку | ✅ Собрано 26.09 |

## Этап 3. Дека с четырьмя моторами

| Номер | Требование | Описание | Урок | Статус |
|---|---|---|---|---|
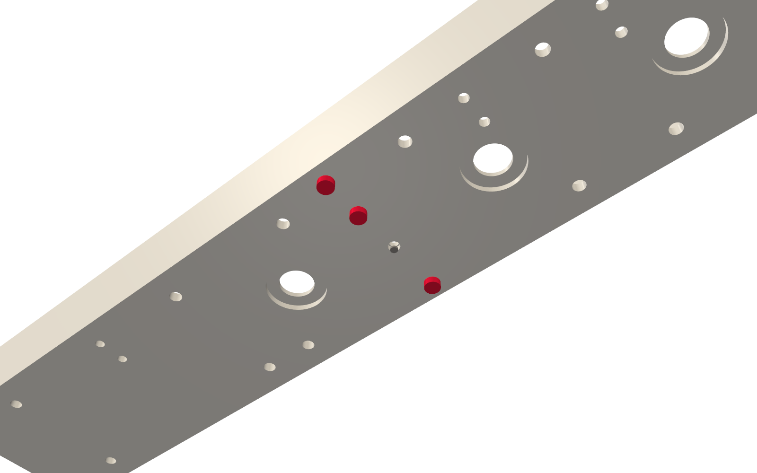
[picture p146: wiki/img/deka3_2_styk.png]
Стык деки
| 10.7 | Стык Д1 / Д2 | Д2 на полку Д1, 3 винта М3×4 снизу, одно среднее — пустое.  |  | ✅ Собрано 26.09 |
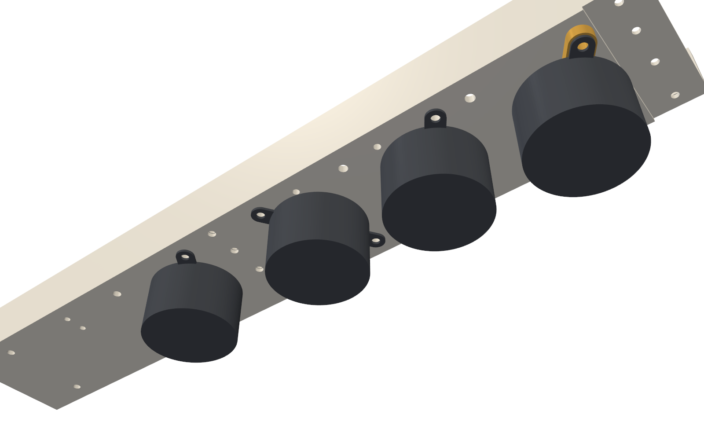
[picture p147: wiki/img/deka3_3_motory.png]
Моторы
| 10.8 | Моторы 0–3 | Снизу круглым выступом в отверстия; мотор 0 (у северного края Д1) — на проставку. Винты сверху: мотор 0 — М3×10, моторы 1–3 — М3×5.  | Мотор 0 уже стоит — проба 25.09 прошла | ✅ Собрано 26.09 |
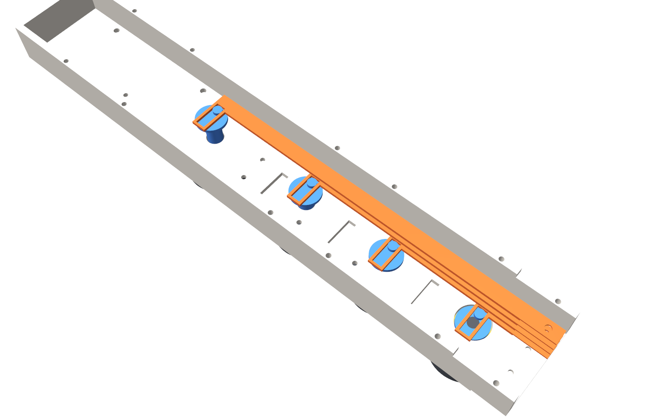
[picture p148: wiki/img/deka3_6_etazhi.png]
Этажи деки
| 10.9 | Кривошипы и хвосты | По этажам 0 → 3: кривошип (ножка от низкой к высокой) на шестерёнку пальцем вверх, хвост — рамкой на палец (от короткого к длинному).  |  | ✅ Собрано 26.09 |
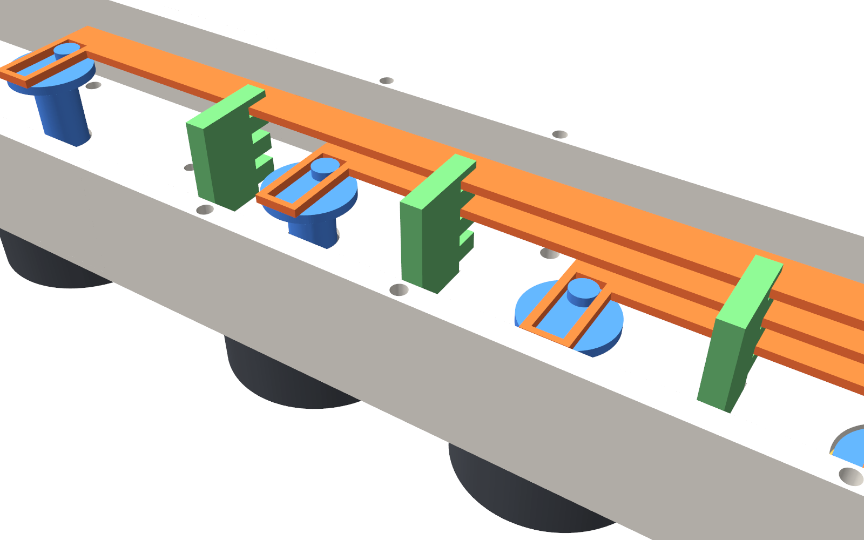
[picture p149: wiki/img/deka3_7b_grebenki_zadvinut.png]
Гребёнки
| 10.10 | Гребёнки | Рядом с лентами, ножкой в щель, задвинуть до упора, фиксатор позади.  |  | ✅ Собрано 26.09 |

## Этап 4. Гриф к деке

| Номер | Требование | Описание | Урок | Статус |
|---|---|---|---|---|
| 10.11 | Стык секция-2 / Д1 | Д1 северным вырезом на южную полку секции-2 — так же, как секции между собой; 3 винта М3×4 снизу, среднее у жёлоба — пустое. Северные концы хвостов деки защёлкнуть на южные концы лент секции-2 (штырёк в дырку, язычки заподлицо) | Дно секций 2 и 3 строится одной функцией (`build_section` в `gitara_sec2.py`) — южная полка одинаковая, поэтому дека встаёт на секцию-2 без переделок | ✅ Собрано 26.09 |

## Этап 5. Плата и проверка всех четырёх

| Номер | Требование | Описание | Урок | Статус |
|---|---|---|---|---|
| 10.12 | Моторы к плате | При вынутой зарядке: мотор k → штыри драйвера k (мотор 0 — северный, у секции-2), чёрный провод к метке «чёрн». Порядок включения: зарядка в триггер, потом USB. Схема и ножки — [Т. Плата для 4-х моторов](/homepage/iniciativa.-razrabotka/jepik-ruka-gitara/t-plata-4-motora) | Мотор переставлять только без питания | ✅ Собрано 26.09 |
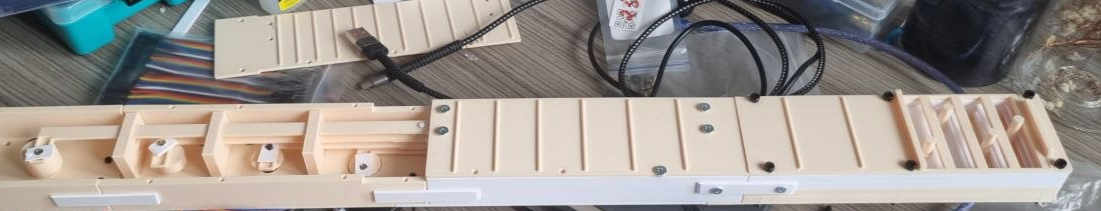
[picture p150: wiki/img/korotkij_grif_sobran.png]
Короткий гриф в сборе
| 10.13 | Каждый мотор ведёт свою тележку | Пульт [plata4_pult.html](https://github.com/Korvova/gitar/blob/main/2-0/websim/plata4_pult.html): «Подключить» → COM-порт ESP, «Настроить драйверы», «Проверить все». В карточке мотора k — ±15°, ±90°, качание: едет тележка k, соседние стоят Собрано и работает 26.09:  |  | ✅ Работает (владелец 26.09) |
| 10.14 | Все четыре по очереди без заеданий | Качание ±90° на 30 об/мин у каждого мотора по минуте: нет пропусков шагов (вал возвращается в ноль), лента не клинит в гребёнке, винты не откручиваются | Если мотор пропускает шаги — ток выше (`cur 500`), скорость ниже Через 5 минут моторы и драйверы тёплые: мотор держал вал половиной рабочего тока и после «Теста» не отпускался. Исправлено в прошивке — см. [Т. Плата для 4-х моторов](/homepage/iniciativa.-razrabotka/jepik-ruka-gitara/t-plata-4-motora) 9.18 | ✅ Проверено 26.09: все четыре гоняли, работает |

## Этап 6. Ложа для пальцев → [Т. Тележки](/homepage/iniciativa.-razrabotka/jepik-ruka-gitara/t-telezhki)

| Номер | Требование | Описание | Урок | Статус |
|---|---|---|---|---|
| 10.15 | Тележка с ложем для пальца | Перенесено в [Т. Тележки](/homepage/iniciativa.-razrabotka/jepik-ruka-gitara/t-telezhki), 11.1 | | ➡️ Перенесено 26.09 |
| 10.15a | Плоское ложе (идея владельца 26.09) | Перенесено в [Т. Тележки](/homepage/iniciativa.-razrabotka/jepik-ruka-gitara/t-telezhki), 11.2 | | ➡️ Перенесено 26.09 |
| 10.16 | Аппликатура чувствуется | Перенесено в [Т. Тележки](/homepage/iniciativa.-razrabotka/jepik-ruka-gitara/t-telezhki), 11.3 | | ➡️ Перенесено 26.09 |

## Этап 7. Секция-1 v2 → [Т. Гриф под тележки](/homepage/iniciativa.-razrabotka/jepik-ruka-gitara/t-grif-pod-telezhki)

| Номер | Требование | Описание | Урок | Статус |
|---|---|---|---|---|
| 10.17 | Шаг тележек V позиции | Перенесено в [Т. Гриф под тележки](/homepage/iniciativa.-razrabotka/jepik-ruka-gitara/t-grif-pod-telezhki), 12.1 | | ➡️ Перенесено 26.09 |
| 10.18 | Печать секции-1 v2 | Перенесено в [Т. Гриф под тележки](/homepage/iniciativa.-razrabotka/jepik-ruka-gitara/t-grif-pod-telezhki), 12.3 | | ➡️ Перенесено 26.09 |
| 10.19 | Сборка секции-1 v2 | Перенесено в [Т. Гриф под тележки](/homepage/iniciativa.-razrabotka/jepik-ruka-gitara/t-grif-pod-telezhki), 12.4 | | ➡️ Перенесено 26.09 |
| 10.20 | Удобство для любой руки | Перенесено в [Т. Тележки](/homepage/iniciativa.-razrabotka/jepik-ruka-gitara/t-telezhki), 11.4 | | ➡️ Перенесено 26.09 |
| 10.21 | Струны-бугорки на палубе секции-1 | Перенесено в [Т. Гриф под тележки](/homepage/iniciativa.-razrabotka/jepik-ruka-gitara/t-grif-pod-telezhki), 12.2 | | ➡️ Перенесено 26.09 |
