Korvova/gitar/wiki/t-plata-4-motora.md

Плата управления четырьмя моторами грифа: одна ESP32, четыре драйвера S2209 V4, общее питание.
Продолжение страницы [Т. Плата для мотора](/homepage/iniciativa.-razrabotka/jepik-ruka-gitara/t-plata) — там проверенная схема одного мотора.

## Требования к плате (проект)

| Номер | Требование | Описание | Урок | Статус |
|---|---|---|---|---|
| 9.1 | Посадочные размеры модулей | ESP32 (30 ножек): между рядами **25.4 мм** (измерено владельцем 19.09). Драйвер S2209 V4: между рядами 12.7 мм, по 8 ножек в ряду. Шаг штырьков везде 2.54 мм. Модули ставятся в гнёзда PBS, моторы — белым разъёмом на штыри PLS по 4 | У плат ESP32 расстояние между рядами бывает 22.9 / 25.4 / 27.9 мм — перед разводкой мерить свою | ✅ Измерено |
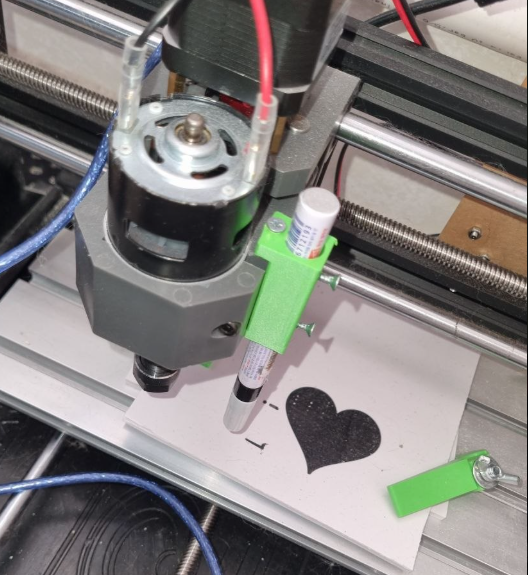
[picture p151: wiki/img/plata4_foto_marker.png]
Маркер на станке
| 9.2 | Способ изготовления: маркер + травление | Односторонний текстолит FR4 1.5 мм, 100×150. Станок: сверловка шпинделем, рисунок дорожек маркером в держателе сбоку от шпинделя, затем травление. Маркер: линия ~1 мм, подпружинен, травление с ним уже проверено владельцем. Дорожки 1.2–1.5 мм, площадки кружками вокруг отверстий Держатель маркера на станке:  | Сверлить и рисовать за одну установку, не снимая плату. Маркер смещён от оси шпинделя — смещение измерить один раз (просверлить точку, нарисовать крестик в тех же координатах) и вписать в G-code. Рисунок проходить дважды. Фрезеровка изоляции V30 для платы такого размера хуже: карта высот, час резки **Итог 20.09:** способ работает — линии маркера 1 мм чёткие, дорожки 1.2 мм с зазором 1 мм не слиплись, после травления перекисью обрывов нет. Порядок на деле: рисунок → сверловка → обрезка → травление → лужение. Смещение маркера мерить не пришлось — сверло выставляется по нарисованному крестику (9.13). Заготовка — 100×100, а не 100×150 (9.11b) | ✅ Проверено 20.09: плата сделана этим способом |
| 9.3 | Компоновка: всё на гнёздах, моторы втыкаются, разъёмы с одной стороны | Плата 141×90 мм, односторонняя. Четыре драйвера в ряд в гнёздах PBS, над каждым 4 штыря PLS под белый разъём мотора (метка «чёрный»). ESP32 в гнёздах. **Оба разъёма — Type-C питания и USB ESP — выходят на правый край**, моторы — на верхний. Конденсатор 470 мкФ на левом конце шины VM. Резистор 1 кОм — один, под ESP. 4 отверстия М3 | Сгоревший драйвер или ESP меняется без пайки. Проверка KiCad: замыканий и нарушений зазора нет (зазор не меньше 0.7 мм, дорожки 1.2 и 1.5 мм — под маркер 1 мм). Первая версия с триггером слева отклонена владельцем: разъёмы должны быть с одной стороны | ❌ Заменено 20.09 компактной платой — см. 9.7–9.9 |
| 9.4 | Ножки ESP32 для прошивки | Мотор 0: EN D32, STEP D33, DIR D25. Мотор 1: EN D26, STEP D27, DIR D14. Мотор 2: EN D23, STEP D22, DIR D21. Мотор 3: EN D19, STEP D18, DIR D5. UART общий: D16 прямо, D17 через 1 кОм; адрес драйвера = номер мотора | Двигают мотор STEP и DIR — они у каждого свои; UART только для настройки тока и диагностики, поэтому он общий. EN у каждого мотора свой: общая линия потребовала бы перемычек, а так можно держать под током только тот мотор, который едет. Ножки выбраны так, чтобы дорожки не пересекались | ❌ Заменено 20.09 компактной платой — см. 9.7–9.9 |
| 9.5 | Разводка в один слой | Ряд ножек модуля — стена, пройти можно только через свою ножку. VM — шина под драйверами; GND — цепочка: под драйвером от ножки 2 к ножке 8, к соседу дугой над его ножкой VM, к ESP — вдоль нижнего края; VIO — шина по верхнему краю и полоса под драйверами; UART — полоса под драйверами, TX и RX каждого драйвера соединены вместе (однопроводная схема) | Остались 3 перемычки адреса (MS1 у драйвера 1, MS2 у драйвера 2, обе у драйвера 3) на полосу VIO — изолированный проводок 5 мм со стороны меди. Соединение TX+RX проверить на стенде до изготовления платы | ❌ Заменено 20.09 компактной платой — см. 9.7–9.9 |
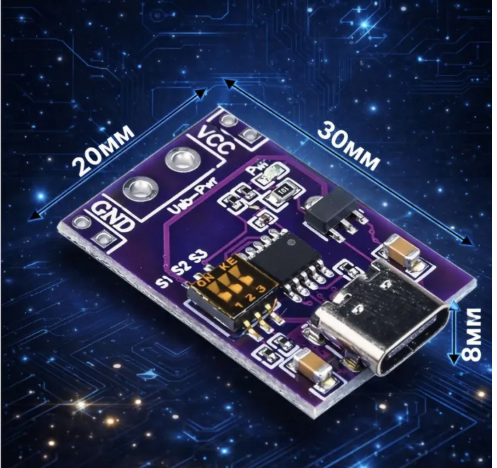
[picture p152: wiki/img/plata4_foto_trigger.png]
Триггер
| 9.6 | PD-триггер лежит на плате плашмя | Фиолетовый триггер 30×20 мм лежит прямо на плате (верх платы — голый текстолит, меди там нет, замкнуть нечего), Type-C у правого края. Четыре штыря **без пластика** (вынуть из гребёнки PLS или взять обрезки ножек) проходят сквозь угловые отверстия GND и VCC триггера и сквозь плату; паяются сверху к триггеру и снизу к меди платы. Между парами отверстий 17.78 мм (8-й штырёк гребёнки, измерено владельцем). Таблица напряжений напечатана на обороте и после пайки не видна — сфотографировать до пайки; переключатели сверху, доступны. Два больших отверстия посередине — тот же выход под винтовой клеммник, не используются Триггер:  | Отклонено владельцем: (1) триггер в гнёздах на высоте 11 мм — держится одним концом, висит; (2) на пластике гребёнки в 2.5 мм над платой — всё равно висит. С пластиком сверху нельзя: он закрывает площадки триггера, и штырь к триггеру не припаять. Если снизу у триггера выступают ножки корпуса Type-C — под них в плате сверлятся 4 отверстия, иначе триггер ляжет с перекосом | ✅ Сделано: триггер на плате, питает все 4 драйвера |
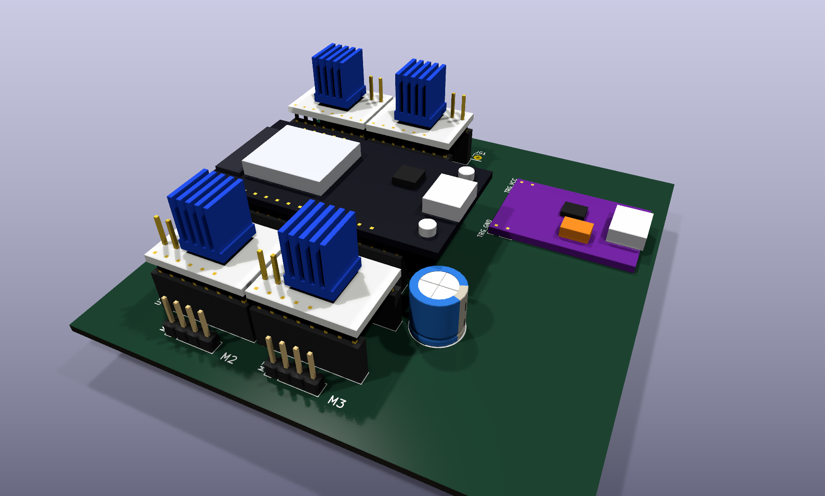
[picture p153: wiki/img/plata4_render_3d.png]
Плата в 3D
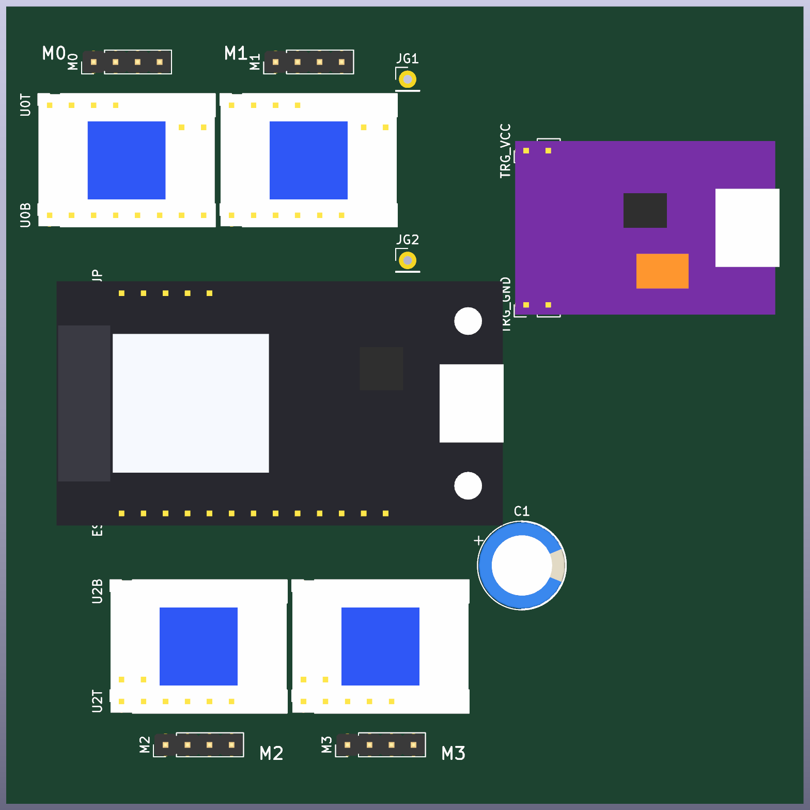
[picture p154: wiki/img/plata4_render_top.png]
Вид сверху
| 9.7 | Компактная плата под заготовку 100×100 | Владельцу удобно крепить на станке заготовку 10×10 см, плата 141×90 не годится. Новая компоновка: драйверы 0 и 1 сверху (штыри моторов у верхнего края), ESP32 посередине, драйверы 2 и 3 снизу, развёрнуты на 180° (штыри моторов у нижнего края). Справа — триггер плашмя и конденсатор; Type-C триггера и USB ESP смотрят в одну сторону, вправо. Плата 92×92, весь рисунок и все отверстия — в поле 65×89 мм, правая полоса заготовки пустая, туда встают прижимы. Крепёжных отверстий нет — плату держит корпус за края Вид в 3D:  Сверху:  Покрутить: открыть [plata_4_motora.kicad_pcb](https://github.com/Korvova/gitar/blob/main/plata-4-motora/plata_4_motora.kicad_pcb) в KiCad и нажать Alt+3 | Идея владельца: драйверы не обязаны стоять в один ряд. В один ряд меньше 93 мм не получалось. Проверка KiCad: замыканий и нарушений зазора нет | ✅ Изготовлена и проверена 25.09 |
| 9.8 | Ножки ESP32 для прошивки (компактная плата) | Мотор 0: EN D23, STEP D22, DIR D21. Мотор 1: EN D19, STEP D4, DIR D2. Мотор 2: EN D25, STEP D33, DIR D32. Мотор 3: EN D14, STEP D27, DIR D26. UART общий: D16 прямо, D17 через 1 кОм (резистор под ESP); адрес драйвера = номер мотора Прошивка: [plata4_fw.ino](https://github.com/Korvova/gitar/blob/main/plata4_fw/plata4_fw.ino) — по USB 115200, пульт `websim/serial_pult.html`; `m 0…3` выбирает мотор, дальше `deg`, `sw`, `hold`, `free`, `stop` к нему; `cur` — ток всех; `init` — перенастроить драйверы (если триггер включили после ESP); `diag` — все адреса, `diag N` — тест катушек мотора N Пульт на 4 мотора: [plata4_pult.html](https://github.com/Korvova/gitar/blob/main/2-0/websim/plata4_pult.html) — карточка на каждый мотор (повороты, качание, скорость, «Тест»), вверху «Настроить драйверы», «Проверить все», ток, «СТОП», «Отпустить все» | Ножки выбраны так, чтобы дорожки шли от драйвера к ESP почти прямо: верхние драйверы — в верхний ряд ESP, нижние — в нижний. D2 — ещё и светодиод на плате ESP: будет мигать вместе с DIR мотора 1, это нормально | ✅ Проверено 25.09: все ножки 4 моторов работают, прошивка plata4_fw |
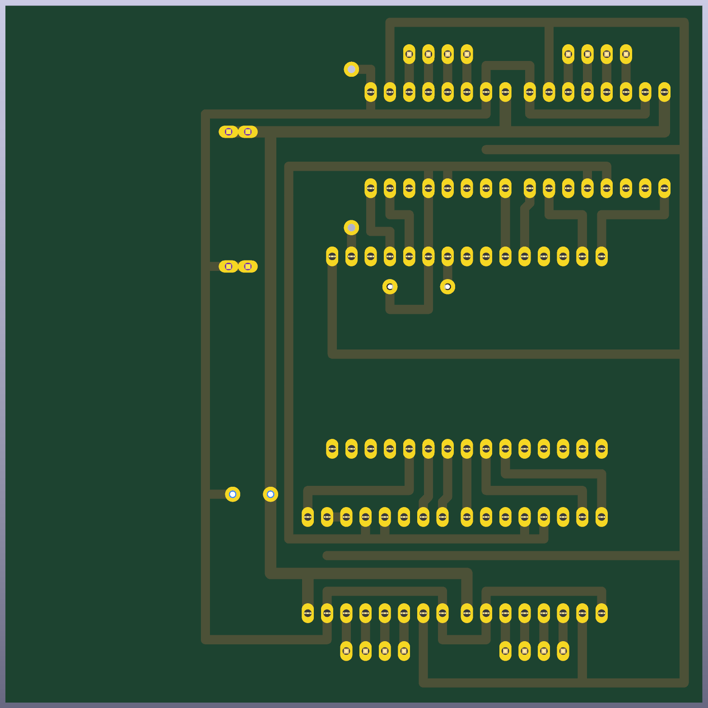
[picture p155: wiki/img/plata4_render_med.png]
Дорожки
| 9.9 | Разводка компактной платы в один слой | Под каждым драйвером 4 полосы: GND, VM, VIO, UART. Верхний и нижний ряд драйверов соединяют вложенные петли справа: UART внутри, VM, GND снаружи; слева — петля VIO, в неё же из-под ESP приходит 3V3. UART к D16 спускается сквозь ножку RX драйвера 1. TX и RX каждого драйвера соединены вместе Сторона меди:  | Перемычек 4: три адресные (MS1 драйвера 1, MS2 драйвера 2, MS1+MS2 драйвера 3 → полоса VIO, изолированный провод 5 мм со стороны меди) и одна GND к ESP — прямая проволочная 21 мм сверху, рядом с драйвером 1 (отверстия JG1 и JG2) | ✅ Проверено 25.09: разводка верная, все цепи работают |

## Этап 1. Подготовка: проверка схемы и станок

| Номер | Требование | Описание | Урок | Статус |
|---|---|---|---|---|
| 9.10 | Проверка на стенде до изготовления: TX и RX драйвера вместе | На плате у каждого драйвера контакты TX и RX соединены (однопроводная схема UART). На стенде одного мотора: провод D16 переставить с контакта TX драйвера на контакт RX (туда же, куда приходит резистор от D17), команда `diag` должна ответить «12 байт, версия 0x21» | Если не ответит — в разводке развести TX и RX отдельными линиями, до травления это бесплатно | ❌ Не понадобилась: однопроводной UART проверен сразу на готовой плате (9.17) |
| 9.11 | Калибровка смещения маркера | На обрезке текстолита: просверлить 2 точки, не снимая заготовку нарисовать маркером крестики в тех же координатах, измерить, на сколько крестик ушёл от отверстия по X и Y. Числа вписать в генератор G-code | Площадка шириной 1.6 мм при сверле 1.0 прощает ошибку не больше 0.3 мм — без калибровки отверстия уйдут с площадок | ❌ Не понадобилась: сверло выставляется по нарисованному крестику (9.13) |
| 9.11a | Станок виден компьютеру | Станок TTC3018, плата MKS DLC32 (ESP32 + CH340), программа Candle, порт COM8, 115200. Если порта нет в диспетчере устройств — сначала мерить блок питания станка мультиметром (должно быть ~24 В), потом кабель и гнездо | 20.09: порт не появлялся совсем — виноват оказался блок питания станка (включался и сразу гас), а не USB. Без питания платы её CH340 не отвечает. Проверка кабеля: тем же кабелем в то же гнездо воткнуть Arduino или ESP32 | ✅ Проверено 20.09 |
| 9.11b | Рабочее поле — заготовка 100×100 | Станок достаёт дальше, но прижимы и стол удобны под заготовку 10×10 см. Плата проектируется так, чтобы рисунок и отверстия влезали в это поле | Из-за этого плата 141×90 была переделана в компактную (9.7). Спрашивать размер заготовки ДО разводки | ✅ Учтено |

## Этап 2. Станок: рисунок, сверловка, обрезка

| Номер | Требование | Описание | Урок | Статус |
|---|---|---|---|---|
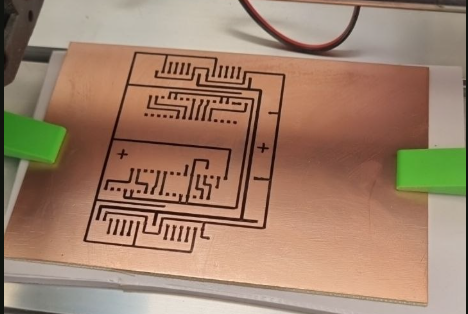
[picture p156: wiki/img/plata4_foto_risunok.png]
Рисунок маркером на заготовке
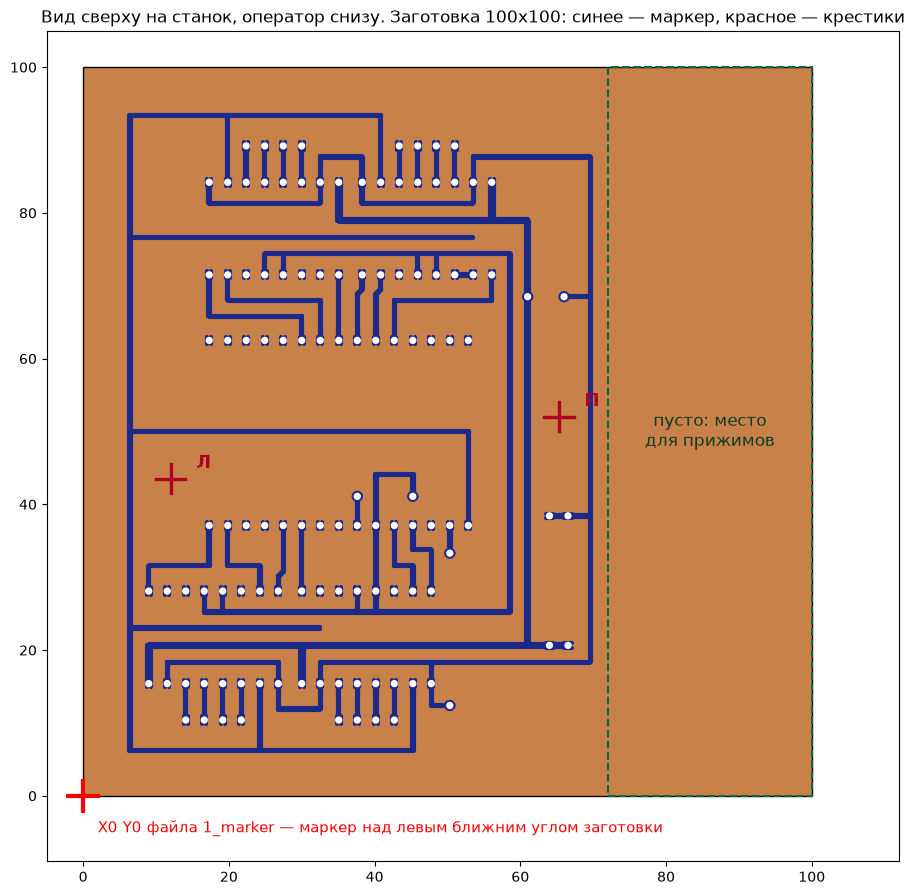
[picture p157: wiki/img/plata4_gcode_preview.png]
Раскладка на заготовке
| 9.12 | Рисунок маркером | Файл [1_marker.nc](https://raw.githubusercontent.com/Korvova/gitar/main/plata-4-motora/gcode/1_marker.nc): заготовка 100×100 медью вверх, X0 Y0 — кончик маркера над левым ближним углом, Z0 — касание меди; 2.6 м линий. Прижимы — на правой пустой полосе 28 мм и не глубже 5 мм с остальных сторон. Текстолит зачистить и обезжирить. Маркер рисует дорожки 1.2 и 1.5 мм, площадки и два крестика; широкие дорожки — в два прохода по кромкам  Как рисунок ложится на заготовку (вид сверху на станок, оператор снизу, красные крестики — для сверла):  | Порядок предложен владельцем: сначала рисунок, потом сверловка. Если сверлить первым — маркер проваливается в отверстия, а снятие заусенцев царапает медь под будущий рисунок | ✅ Сделано 20.09 |
| 9.13 | Точки синхронизации | Маркер вместе с платой рисует два крестика — Л (слева) и П (справа), в меди они остаются как метки. Сверло ставится нулём X0 Y0 на центр крестика Л; файл сверловки сначала уезжает к крестику П и встаёт на паузу в 0.5 мм над медью — проверить попадание и продолжить | Смещение маркера от шпинделя мерить не нужно: сверловка привязана к нарисованному, а не к углу заготовки. Поэтому калибровка 9.11 стала необязательной | ✅ Сделано 20.09: сверло попало в правый крестик |
| 9.14 | Сверловка | Файл [2_sverlo.nc](https://raw.githubusercontent.com/Korvova/gitar/main/plata-4-motora/gcode/2_sverlo.nc): 120 отверстий сверлом 1.0 мм за ту же установку. Между свёрлами перезанулять только Z | Стружку сдувать, не стирать — рисунок маркера царапается. Заусенцы снимать уже после травления | ✅ Сделано 20.09, сверло 0.9 мм |
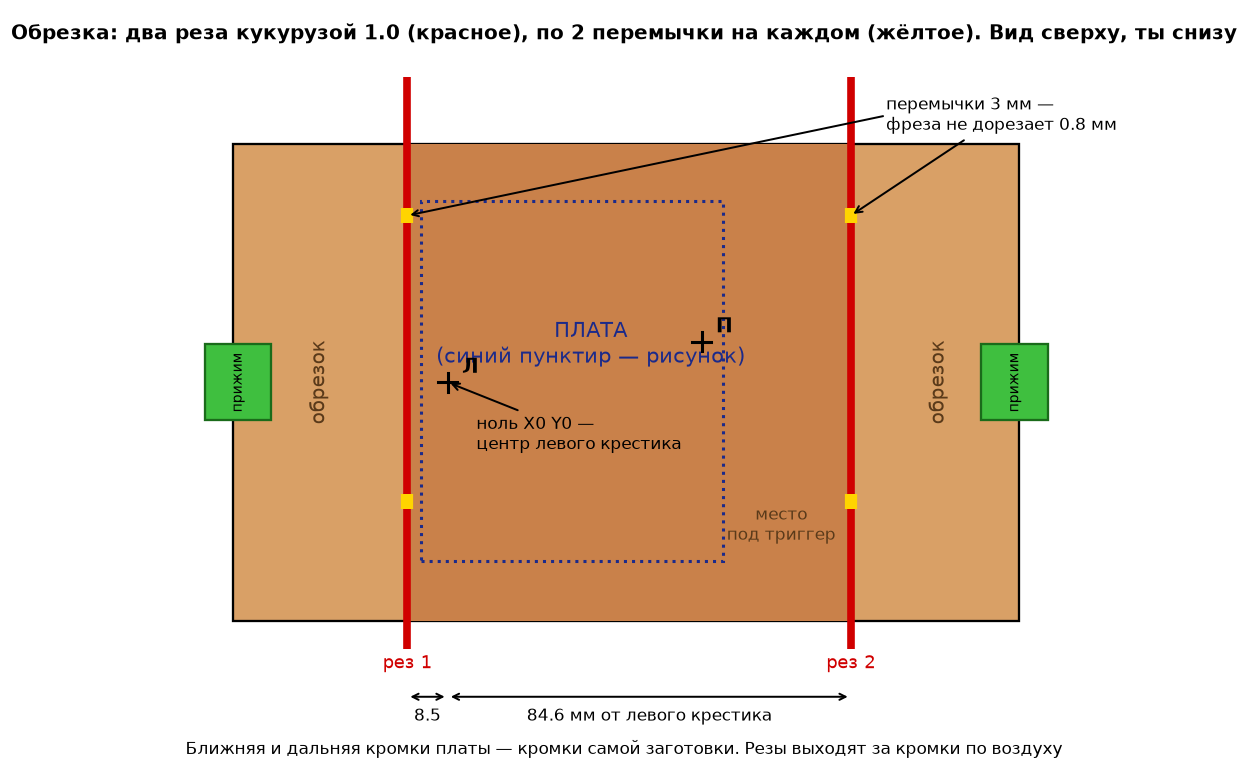
[picture p158: wiki/img/plata4_obrezka.png]
Схема обрезки
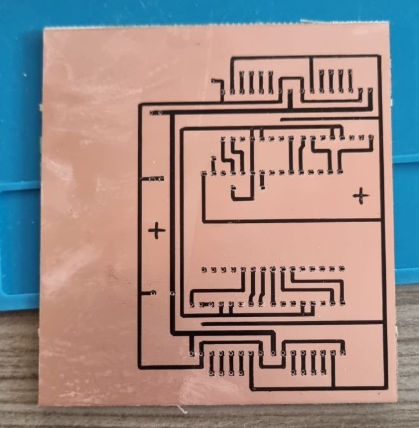
[picture p159: wiki/img/plata4_foto_pered_travleniem.png]
Плата перед травлением
| 9.14a | Обрезка платы | Файл [3_obrezka_kukuruza_1.0.nc](https://raw.githubusercontent.com/Korvova/gitar/main/plata-4-motora/gcode/3_obrezka_kukuruza_1.0.nc): кукуруза 1.0, ноль — по левому крестику, два параллельных реза слева и справа от рисунка, 4 прохода до 1.9 мм, по 2 перемычки на рез. Ближняя и дальняя кромки платы — кромки заготовки.  Плата после обрезки, перед травлением:  | Заготовка у владельца длинная, рисунок посередине, прижимы на концах — поэтому резов два, а не Г-образный. Перемычки держат плату между обрезками, иначе в конце реза она закусит фрезу | ✅ Сделано 20.09 |
| 9.14b | G-code без вложенных скобок | В строке паузы `M0` не должно быть комментария со скобками внутри скобок: GRBL отвечает `error:2`, Candle показывает окно «Ignore / Abort» и встаёт | 20.09: из-за строки `M0 (… P (praviy)? …)` сверловка не пошла. Исправлено: `M0` без комментария. После выключения станка ноль теряется (нет концевиков) — заново навести инструмент на левый крестик, X0 Y0 | ✅ Исправлено |

## Этап 3. Химия: травление и лужение

| Номер | Требование | Описание | Урок | Статус |
|---|---|---|---|---|
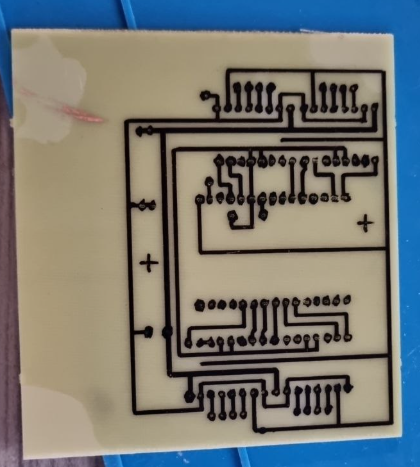
[picture p160: wiki/img/plata4_foto_posle_travleniya.png]
После травления
| 9.15 | Травление: перекись + лимонная кислота + соль | На плату 96×96: **200 мл аптечной перекиси водорода 3 %, 60 г лимонной кислоты, 2 чайные ложки соли** (на 100 мл — 30 г и 1 ложка). Воду не добавлять. Размешать до растворения в пластиковой или стеклянной ёмкости, плату положить медью вверх, покачивать. Тёплый раствор (поставить ёмкость в горячую воду, 40–50 °C) травит за 15–30 минут, холодный — до часа. Готово, когда между дорожками везде виден чистый текстолит. Промыть водой, маркер смыть спиртом или ацетоном, прозвонить соседние дорожки и шины VM/GND на замыкание  | Раствор одноразовый, готовить перед травлением: через пару часов выдыхается. Рисунок в растворе не тереть — маркер держится, пока его не трогают. Если травление встало — долить перекиси и досыпать соли. Металлическую посуду не брать | ✅ Сделано 20.09 |
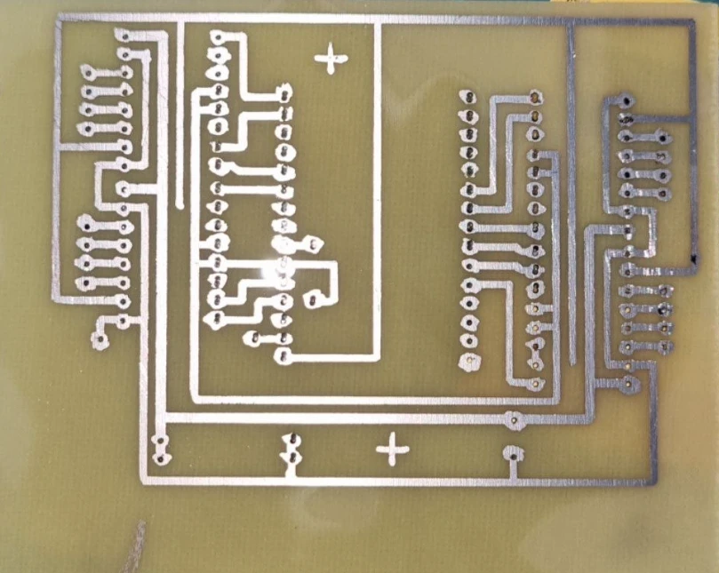
[picture p161: wiki/img/plata4_foto_luzhenie.png]
После лужения
| 9.15a | Лужение «жидким оловом» | После травления: смыть маркер спиртом или ацетоном, зачистить медь мелкой шкуркой до блеска, обезжирить, прозвонить соседние дорожки. Плату медью вверх в раствор «Жидкое олово» на 5–15 минут — дорожки становятся серебристыми. Промыть, высушить. Раствор слить обратно — многоразовый  | Олово садится только на чистую медь, на текстолит не ложится. В составе тиомочевина — перчатки, проветривание, посуда не из-под еды. Слой тонкий: паять в ближайшие дни | ✅ Сделано 20.09 |

## Этап 4. Пайка и проверка платы

| Номер | Требование | Описание | Урок | Статус |
|---|---|---|---|---|
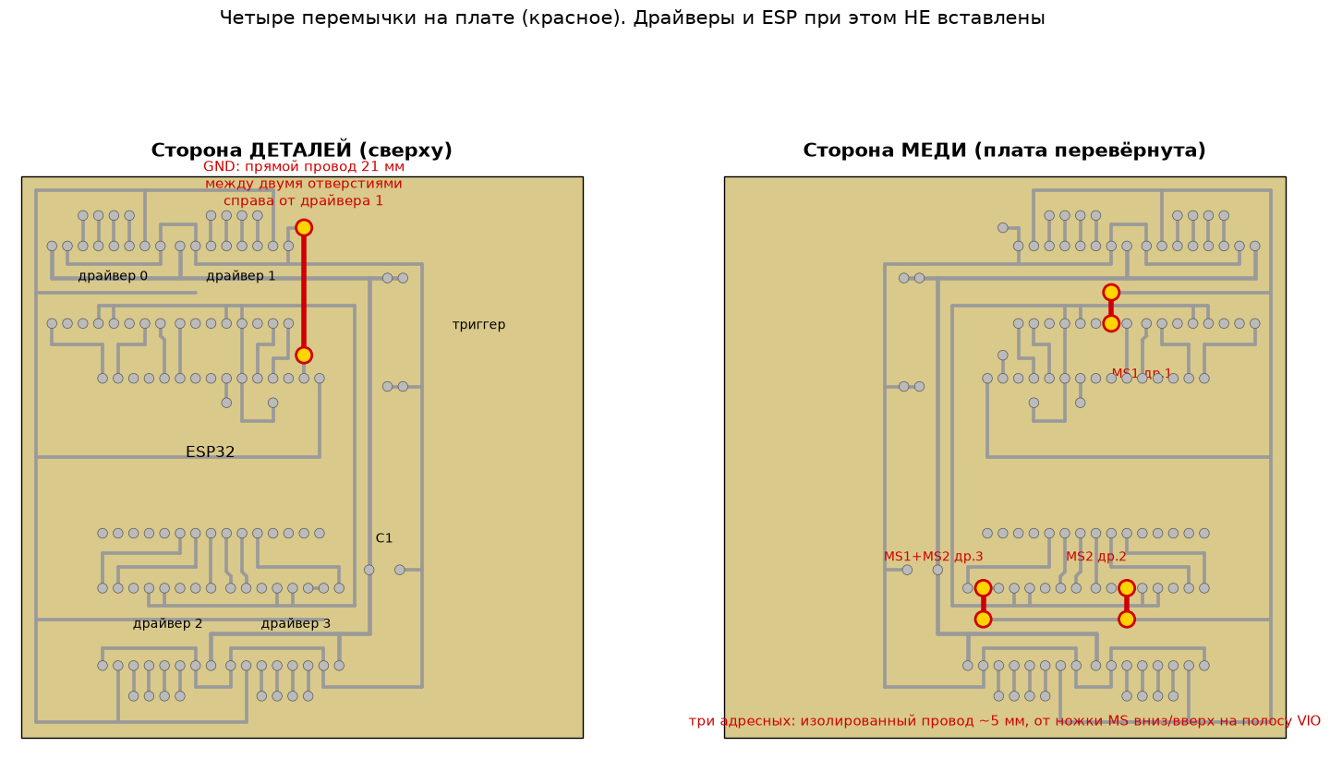
[picture p162: wiki/img/plata4_peremychki.png]
Перемычки
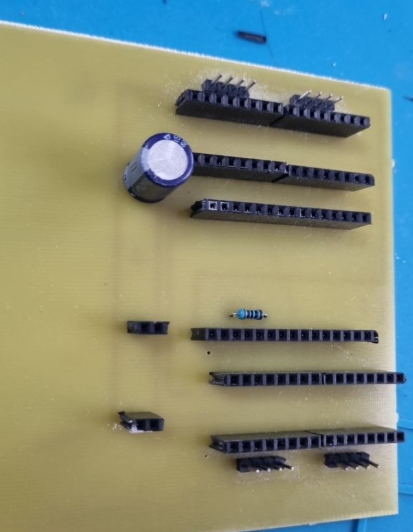
[picture p163: wiki/img/plata4_foto_spayana.png]
Плата спаяна
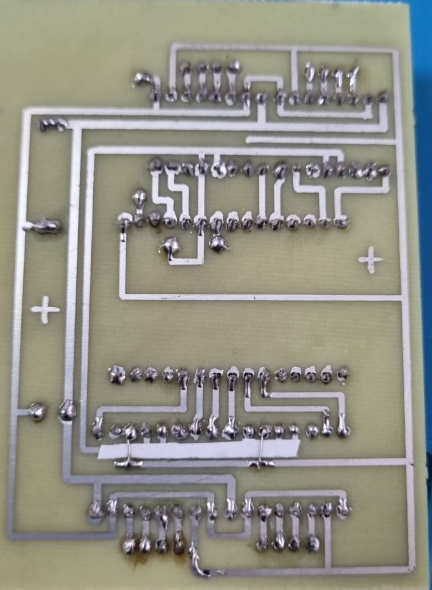
[picture p164: wiki/img/plata4_foto_peremychki_med.png]
Перемычки на меди
| 9.16 | Пайка | Гнёзда PBS: 8 кусков по 8 (драйверы) и 2 по 15 (ESP); штыри PLS 4×4 (моторы); резистор 1 кОм (под ESP); конденсатор 470 мкФ (полоска — к минусу); триггер плашмя на 4 штырях без пластика; 3 перемычки адреса изолированным проводом со стороны меди: MS1 драйвера 1, MS2 драйвера 2, MS1+MS2 драйвера 3 — на полосу VIO Где перемычки:  Спаяно 24.09:  Перемычки со стороны меди:  | Таблицу напряжений с оборота триггера сфотографировать до пайки и выставить 12 В Конденсатор: полоса (минус) — от ESP к краю платы; со стороны меди картинка зеркальная, легко перепутать — проверять прозвонкой минуса с GND. Триггер на 12 В выставлять ДО пайки (таблица на обороте) | ✅ Сделано 24.09 |
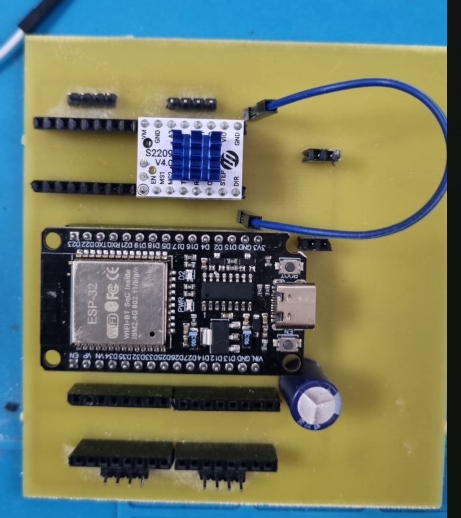
[picture p165: wiki/img/plata4_foto_drayver1.png]
Драйвер 1 на плате
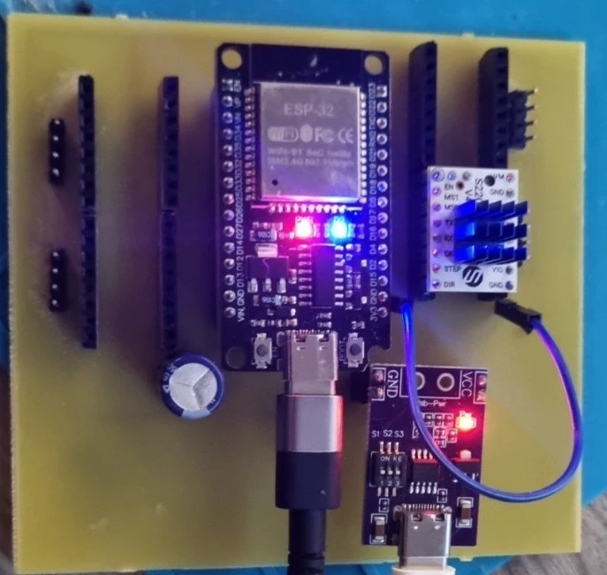
[picture p166: wiki/img/plata4_foto_pervoe_vklyuchenie.png]
Первое включение
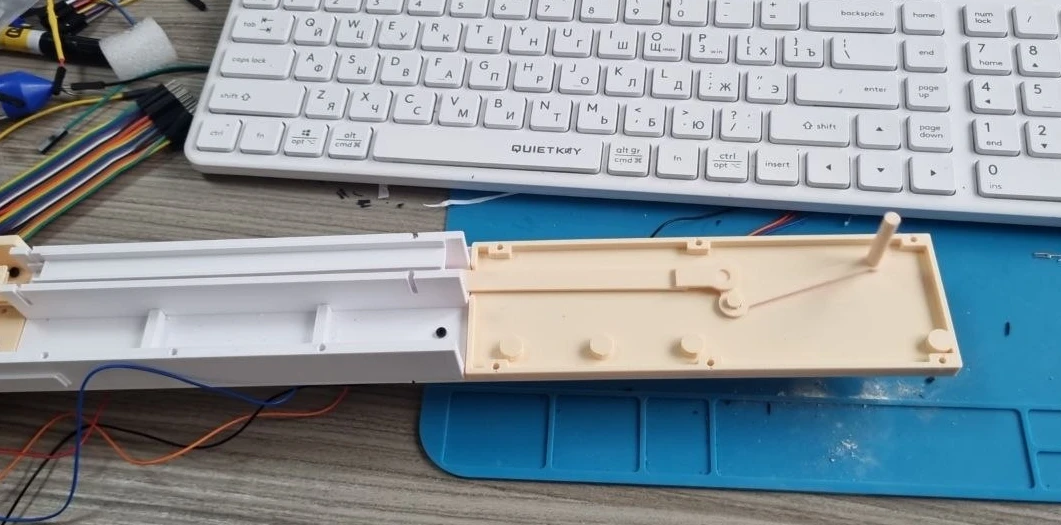
[picture p167: wiki/img/deka3_proba_motor0.png]
Проба первого мотора на деке
| 9.17 | Проверка платы | Без модулей: питание от триггера, на гнёздах VM — 12 В, на VIO — 0. С ESP: 3.3 В на VIO. Потом по одному драйверу: `diag` отвечает версией 0x21 со своего адреса Команда `diag` опрашивает все 4 адреса сразу, `diag N` — полный тест драйвера N с катушками на ножках платы. 24.09, только ESP по USB: на всех адресах 4 байта — эхо идёт по D17 → резистор → D16, дорожки UART и резистор целы. Драйвер 1 в гнезде:  Первое включение 24.09 от триггера: драйвер в гнезде драйвера 1 ответил «12 байт, версия 0x21», но на адресе 0, а не 1 — питание VM, земля и UART платы работают, адресная перемычка MS1 драйвера 1 под вопросом:  Драйверы в гнёздах 0, 2, 3 (гнездо 1 пустое): `diag` — адрес 0, 2 и 3 отвечают «12 байт, версия 0x21», адресные перемычки гнёзд 2 и 3 работают. **24.09, все 4 драйвера на плате:** `diag` — адреса 0, 1, 2, 3 отвечают «12 байт, версия 0x21»; после прошивки `plata4_fw` все четыре приняли настройку тока (336 мА при заданных 350). **25.09:** мотор на драйвере 3 крутится командами пульта [plata4_pult.html](https://github.com/Korvova/gitar/blob/main/2-0/websim/plata4_pult.html), проба на деке: [видео: мотор крутит кривошип, лента ходит](https://raw.githubusercontent.com/Korvova/gitar/main/wiki/video/proba_motor0_deka.mp4)  **25.09, все 4 мотора:** `diag N` у всех четырёх — катушки ок, EN и STEP доходят; каждый мотор крутится от пульта вперёд и назад. В `diag N` добавлены проверки «EN доходит» (флаг драйвера) и «STEP доходит» (счётчик микрошагов MSCNT растёт от каждого импульса, даже если вал зажат). | Моторы втыкать только без питания Ориентация драйвера: ряд GND…VM всегда к 4-штырьковому разъёму своего мотора; у верхних драйверов VM в левом верхнем углу, у нижних — в правом нижнем. Развёрнутый на 180° драйвер под питанием подаёт 12 В на сигнальные ножки. ESP на плате — порт COM8 Пока адреса не проверены, второй драйвер не ставить: два драйвера с одинаковым адресом отвечают одновременно и глушат друг друга на общей линии UART Гнездо 1: драйвер в нём отвечает на адрес 0 вместо 1 — перемычка MS1 гнезда 1 не даёт контакта (MS1 у гнезда 3 при этом работает). Старая прошивка стенда держит D25 в LOW, а на этой плате D25 = EN драйвера 2 — он включён; уйдёт с прошивкой на 4 мотора Гнездо 1 отвечало на адрес 0 потому, что перемычка MS1 драйвера 1 не была припаяна — её легко пропустить, она одна у верхнего ряда драйверов, остальные три — у нижнего. Все драйверы молчат разом — значит, нет питания триггера, а не поломка Мотор 0 не крутился при исправных катушках: `diag 0` показал «STEP НЕ ДОХОДИТ» — плохой припой на дорожке D22 → STEP драйвера 0, перепаяно. Проверка катушек сама по себе не доказывает, что доходят STEP и EN: без EN драйвер не гонит ток, и «обрыв» не ловится — поэтому в `diag` теперь отдельные строки про EN и STEP. На «держать» вал проворачивается рукой легко — это ток удержания в покое (~90 мА, ihold 8), не поломка | ✅ Проверено 25.09: все 4 драйвера и 4 мотора работают |
| 9.18 | Моторы не греются стоя | Ток удержания в покое — 20% рабочего (`rms_current(ток, 0.2)`, ~70 мА при 350), после «Теста» мотор отпускается, команда `off` и кнопка пульта «Отпустить все» снимают ток со всех. Когда не играешь — «Отпустить все» или вынуть зарядку | 26.09: через 5 минут моторы и драйверы заметно тёплые. Причина — прошивка: `rms_current()` в библиотеке TMCStepper сам ставит ток удержания 50% и перезаписывает заданный ранее `ihold`; после `diag N` мотор оставался включённым. Шаговик под током греется и стоя — это нормально до 60–70 °C, но нам удержание не нужно | ✅ Исправлено 26.09, прошивка залита |

## Файлы

* Плата: [plata_4_motora.kicad_pcb](https://github.com/Korvova/gitar/blob/main/plata-4-motora/plata_4_motora.kicad_pcb), собирается скриптом [build_board.py](https://github.com/Korvova/gitar/blob/main/plata-4-motora/build_board.py) (python из KiCad 10)
* 3D-модели модулей: [make_models.py](https://github.com/Korvova/gitar/blob/main/plata-4-motora/make_models.py) (build123d) → `models/*.step`
* Файлы для станка: [make_gcode.py](https://github.com/Korvova/gitar/blob/main/plata-4-motora/make_gcode.py) → `gcode/1_marker.nc`, `gcode/2_sverlo.nc`
* Отчёт проверки: [drc.txt](https://github.com/Korvova/gitar/blob/main/plata-4-motora/drc.txt)
