Korvova/gitar/wiki/t-grif.md

Левая рука: четыре тележки в грифе, в них вставлены пальцы ученика. Тележки ходят
поперёк грифа, каждая на своём этаже. Привод — «палка»: кривошип на валу шагового
мотора в деке, длинная спица-лента вдоль грифа, коромысло-треугольник на оси и плечо,
чей штырь ходит в щели тележки. Все соединения — шарниры, скольжений и тросов нет.
Тросовая версия v9 (барабаны, ролики, нить) отработана и исключена в конце июля 2026:
«палка» выбрана после десятка схем, проверена физикой Bullet и стендом.
Механика напечатана и собрана, работа четырьмя моторами не запрограммирована.

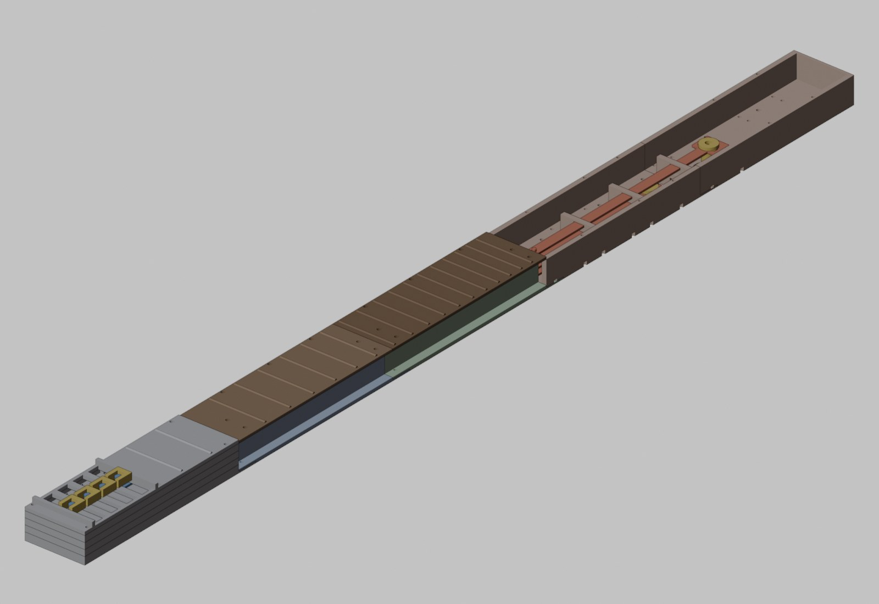
[picture p168: wiki/img/sekciya1.jpg]
Секция-1 грифа: четыре тележки у головы, спицы-ленты по этажам, кривошип у деки


*Секция-1 с четырьмя станциями — сцена [Гитара_секция1.blend](https://github.com/Korvova/gitar/blob/main/2-0/%D0%93%D0%B8%D1%82%D0%B0%D1%80%D0%B0_%D1%81%D0%B5%D0%BA%D1%86%D0%B8%D1%8F1.blend). Анимация механизма всех четырёх станций — [Гитара_палка.blend](https://github.com/Korvova/gitar/blob/main/2-0/%D0%93%D0%B8%D1%82%D0%B0%D1%80%D0%B0_%D0%BF%D0%B0%D0%BB%D0%BA%D0%B0.blend), пробел.*

## Требования

| Номер | Требование | Описание | Урок | Статус |
|---|---|---|---|---|
| 2.1 | Четыре тележки поперёк грифа | Ход ±20 мм, ширина тележки ~15 мм, зазор между ними ~1 мм | Ширина грифа 50 мм — тележка проходит от края до края | ✅ Готово |
| 2.2 | Тросы не пересекаются и не задевают тележки | Каждая тележка на своём этаже (слои L1–L4 по 3.5 мм), трос идёт по дну этажа | Плавники и пятки ходят над тросом с зазором ~0.4 мм — зацепиться не за что — исключено 09.09.2026 вместе с тросом: механизм «палка», см. 2.10 | ❌ Исключено |
| 2.3 | Малое трение на изгибе | Угловой ролик с высокой шейкой (капстан) в конце канала | Трос заходит по дну канала, сходит на высоте окошка пятки — исключено 09.09.2026 вместе с тросом: механизм «палка», см. 2.10 | ❌ Исключено |
| 2.4 | Привод от шаговых моторов | 4 × NEMA 14 в деке, барабаны с юбкой на пилоте Ø16 | Моторы в линию, ближний мотор — нижний этаж — исключено 09.09.2026 барабаны и нить; моторы остались, кривошип на валу: механизм «палка», см. 2.10 | ❌ Исключено |
| 2.5 | Гриф печатается слоями и собирается | 5 слоёв L1–L5, канавки открыты сверху, крепёж 4 × М3 и штифты-филамент | Трос кладётся при стапелировании слоёв, поддержки не нужны — исключено 09.09.2026 вместе с тросом: механизм «палка», стопка плит P0–P4, см. 2.12 | ❌ Исключено |
| 2.6 | Прошивка управления 4 моторами | Синхронное ведение тележек по аппликатуре | Не написана | ⬜ Не начато |
| 2.7 | Контроль реальной позиции тележки | Датчик угла на оси плеча вместо подсчёта шагов | Идея: AS5600 на оси даёт истинную позицию, ловит пропуск шагов и даёт ручной режим — ученик двигает тележки сам, система видит и оценивает | ⬜ Не начато |
| 2.8 | Кнопка на тележке | Реальный прижим «струны» пальцем | Полный цикл игры: позиция плюс прижим плюс щипок равно нота | ⬜ Не начато |
| 2.9 | Питание моторов | PD-триггер 5–20 В, конденсаторы 470 мкФ 35 В | Тест силы на 20 В не проведён; открыт вопрос NEMA14 против NEMA17 | ⚠️ Частично |
| 2.10 | Привод тележки без троса — механизм «палка» | Кривошип r10 на валу мотора → спица вдоль грифа → угол треугольника с дуговым основанием на неподвижной оси → плечо → штырь плеча в щели тележки (кулиса). Мотор не крутится, а качается сектором ±75–80° — позиция тележки однозначна по углу | Выбран из ~10 схем (трос, нога, рейка, кулиса, парус, два толкателя). Урок честной физики: у штырьковых шарниров сила приложена выше опоры, каждый узел ползёт вверх по штырьку — все узлы заперты сверху мостиками и шайбами. Стенд напечатан и работает: тележка ездит при 700 мА и SpreadCycle, редуктор не понадобился (стол 21, `drive_web.ino`, пульт `serial_pult.html`) | ✅ Готово |
| 2.11 | Ход 40 мм при люфтах печатных шарниров | Ход ≈ 6.15·r − 10.6 мм; люфты Ø5/Ø6 на трёх узлах съедают ~10 мм, поэтому кривошип берётся с запасом (r10 → 45 мм), а ход подстраивается сектором в прошивке | На гитаре зазоры жать до ~0.3 мм или ставить мини-подшипники 693ZZ; гистерезис на реверсе принят — «пролетит быстро» | ✅ Готово |
| 2.12 | Четыре станции в одном грифе | Секция-1: этажная стопка плит P0–P4, каждая несёт ось своего плеча; спицы разной длины идут по своим этажам, моторы в ряд в деке. Зеркальная раскладка: станции 1 и 3 — южный борт, 2 и 4 — северный, по два слоя на борт | Потолок каждого этажа прижимает плечо и кольцо спицы — вертикальные замки стенда не нужны. Напечатано (столы 31–36), проверка с четырьмя моторами не проведена | ⚠️ Частично |
| 2.13 | Длинные спицы (350–450 мм) не выпучиваются | Спица — лента 2×8 мм плашмя в жёлобе-этаже: бок держит ширина, вертикаль запирают пол и потолок слоя, перемычки потолка каждые ~100 мм (~20 Н) | Длина не съедает силу (жёсткое звено), опасен только Эйлер на сжатии | ✅ Готово |
| 2.14 | Стыки лент между секциями без крепежа | Нахлёст полуязыками 0.8+0.8 мм с взаимной защёлкой: на нижнем языке штырёк Ø3 вверх и дырка, на верхнем — дырка и штырёк вниз заподлицо; стыки только на переходах секций (y 160/320/480), где свободно по высоте | Болтикам под лентой этажа-0 нет места, печатный пазл-гриб отвергнут: «одна лента крепит другую» | ✅ Готово |
| 2.15 | Мотор под длинный гриф | NEMA14 на 20 В (PD-триггер) либо NEMA17 (17HS4401: в 3.5 раза сильнее и дешевле, редуктор не нужен); плита v3 под NEMA17: колодец 42.3, М3 31×31, пилот Ø22, ножки ~60 | 20 В чинит провал момента на скорости; редуктор 1:3 — только если тест на 20 В покажет нехватку | ⚠️ Частично |
| 2.16 | Физика четырёх станций до печати | Bullet-модель всей цепочки (кривошип → лента → плечо → штырь → тележка) на четыре этажа: `2-0/gitara_physics4.py` (пакетный расчёт с отчётом) и ручная сцена `Гитара_физика4_ручная_*.blend` с аддоном-пультом четырёх моторов | Находки 09.09.2026: (1) штырь плеча ходит по дуге и на краю хода уходит к оси на 4–5 мм — тележку ставить **вилкой на север**, по инструкции «на юг» штырю оставалось 0.5 мм; (2) дуговые прорези X ±23.5 давали оси штыря Ø5 максимум ±21 мм — расширены до ±24.5 (`gitara_sec1.py`, столы 31/32 v2); (3) люфты Ø5/Ø6 на трёх узлах съедают ~6 мм с каждой стороны, кривошип r4.3 без запаса — в хребет закладывать r5.5 и паз хвоста ±9, ход добирать сектором ~±50–55°; (4) в модели нижние этажи (штырь 20–25 мм) клинят в узле штырь-вилка — проверить руками, тележки всё равно переделываются под электронику. Инструменты: в venv нужны `trimesh<5`, `rtree`, `python-fcl`, иначе `clearance.py` молча даёт «999» | ⚠️ Частично |
| 2.17 | Фретборд секций 2–3 печатается без поддержек | Дно фретборда плоское; потолок верхней ленты — отдельная планка `gs2_cap` 9×2×142 мм: кладётся в П-рейку этажа-3 поверх ленты, сверху её прижимает фретборд, вдоль держат два пенька Ø2.4 в глухих дырках снизу фретборда (столы 33, 34) | Раньше потолок был язычком 2 мм под фретбордом — он и есть защита спицы от выпучивания (2.13), срезать его без замены нельзя, но с ним фретборд лежал на столе узкой полоской и требовал поддержек. Планке падать некуда: под ней лента в 0.15 мм. Проверка сборки `gitara_sec2.py` следит, что планка над лентой | ✅ Готово |
| 2.18 | Хребет деки под моторы тележек Ø36 | Дека v2: ось мотора X = 0 сбоку жёлоба, кривошип одной деталью (ступица на шестерне, диск над лентой, палец Ø5 вниз на r7.6), вилка хвоста открыта на запад и не шире щели гребёнки, колодцы: пилот Ø16.1, 2 × М3 на 43.85 с ушами под 56°; моторы на Y 515/565/615/678; столы 66–68 | В v1 валы не были в проверке сборки: палец r4.3 пересекался с валом Ø5, вал упирался в паз вилки, длинный вал NEMA17 протыкал ленты верхних этажей. Теперь в `gitara_deka.py` модель мотора по чертежу и прогон качания ±38°/±40° с зазорами на каждом шаге. Палец на большем радиусе даёт в 1.8 раза меньше силы — проверить на железе | ⚠️ Частично |
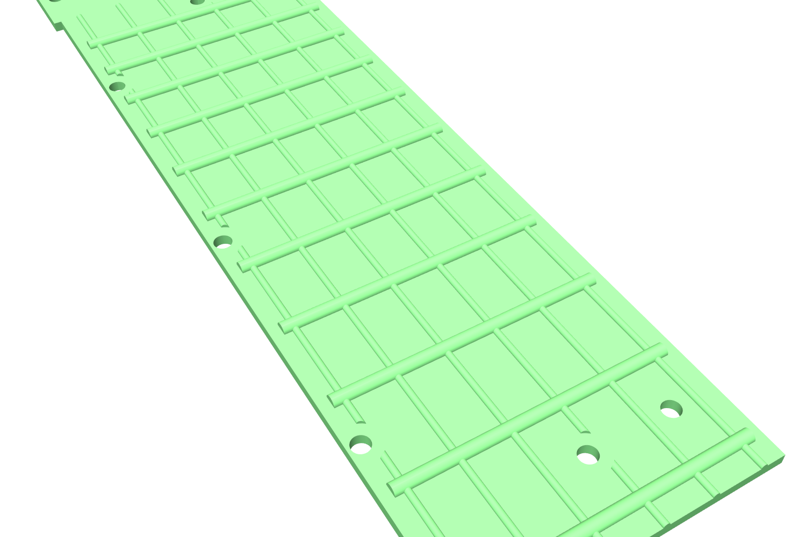
[picture p169: wiki/img/fret_strings.png]
Фретборд с линиями струн
| 2.19 | Линии струн на фретбордах секций 2–3 | Шесть валиков-полуцилиндров Ø1.2 (высота 0.6) вдоль грифа поверх ладов, шаг 8.8 мм: X = ±4.4, ±13.2, ±22; у винтов фретборда валик прерывается под головку. Идея владельца 13.09.2026 | На палубу секции-1 не ставятся: по ней поперёк ездят тележки, продольные валики стали бы порогами. Печать ладами вверх, поддержки не нужны.  | ✅ Готово |
| 2.20 | Кривошип деки на полный оборот (кулиса) | Дека v3, идея владельца: диск кривошипа ПОД лентой своего этажа, палец Ø5 ВВЕРХ на радиусе 4.8 в поперечную прорезь-рамку на конце ленты; ступица и шестерня мотора не доходят до ленты, поэтому кривошип крутится на 360°, лента ходит на ±4.8 мм. Мотор 0 опущен на проставке 4 мм (под лентой этажа 0 нет места). Гребёнки «Е» с короткими зубьями ставятся рядом с лентами и задвигаются на 4.5 мм по пазу, за ними фиксатор. Столы 66–68 | Против v2 (сектор ±38°, палец вниз r7.6): сила на ленте в 1.6 раза больше, палец не может выйти из вилки, прошивке не нужны упоры сектора. Мотор сверху хребта невозможен — над хребтом сразу крышка корпуса. Круглая дырка вместо прорези не работает: палец ходит вбок. Проверено моделью: полный оборот вместе и со сдвигом 90°, шаг 30°, мин. зазоры: палец в прорези 0.15, лента/гребёнка 0.20, гребёнка при установке 0.36, кривошип/дно 0.50. Расчёт перенесён на сервер: утечка памяти (самопересекающийся профиль звёздочки купона) вешала компьютер | ⚠️ Частично |
| 2.21 | Шаг тележек как между пальцами на V позиции | Секция-1 v2: тележки с шагом 26/25/24 мм (лады 5–8, мензура 650) вместо 16 вплотную; у каждой тележки своё русло, ложе для пальца 24×22 сверху. Подробно — [Т. Сборка короткий гриф](/homepage/iniciativa.-razrabotka/jepik-ruka-gitara/t-sborka-korotkij-grif), 10.17 | Шаг 16 соответствует XII ладу — пальцам тесно (проба владельца 26.09). На I позиции пальцы стоят через 31–34 мм, на V — 24–27. Штырь плеча в крайних положениях уходит по Y на 4 мм — паз тележки должен это пропускать, иначе штырь толкает тележку на соседку | ⚠️ Модель готова, не напечатано |

## Дека v2 под моторы Ø36: устройство и проверка моделью

**Заменена декой v3 с полным оборотом кривошипа (2.20).** Раздел оставлен как история решения.

Перенесено из инструкции по сборке 13.09.2026, чтобы инструкция осталась только про печать и сборку.

Что поменялось и почему:

| Было в v1 | Стало в v2 | Зачем |
|---|---|---|
| Ось мотора под жёлобом лент (X = 10) | Ось мотора сбоку, X = 0 | Вал и ступица кривошипа не проходят сквозь ленты |
| Кривошип: D-отверстие на вал Ø5 и отдельная втулка, палец r4.3 | Одна деталь: ступица на шестерне, диск над лентой своего этажа, палец Ø5 вниз на r7.6 | Втулки не нужны; палец не пересекается с валом |
| Вилка хвоста: площадка 19 мм, паз 6 мм | Вилка открыта на запад, зубья не шире щели гребёнки | Палец не упирается в концы паза; хвост протаскивается сквозь гребёнки |
| Колодцы NEMA17: пилот Ø22.6, 4 × М3 на 31×31 | Пилот Ø16.1, 2 × М3 на 43.85, уши повёрнуты на 56° | Мотор Ø36 садится; винты ушей ложатся между жёлобом и стенкой |
| Мотор 0 на Y = 505 | Моторы на Y = 515 / 565 / 615 / 678 | Пилот и уши мотора 0 уходят с полки стыка секции-3 (она уже напечатана) |
| 9 тумб корпуса | 6 тумб: две в Д1 у западной стенки, четыре в Д2 | Корпуса моторов глубиной 22 врезались в тумбы на 3–7 мм |

**Что проверила симуляция.**

`2-0/gitara_deka.py` в конце прогоняет качание ±38° и предел ±40°, все кривошипы вместе
и вразнобой, и печатает минимальные зазоры:

| Пара | Мин. зазор, мм |
|---|---|
| палец ↔ зубья вилки | 0.15 |
| кривошип ↔ дно хребта | 0.30 |
| лента ↔ щель гребёнки | 0.20 |
| лента ↔ свой мотор (вал и шестерня с допуском +0.5) | 1.55 |
| лента ↔ чужой кривошип | 1.85 |
| лента ↔ чужой мотор | 3.58 |
| кривошип ↔ гребёнка | 5.90 |

Плюс в `gitara_korpus.py`: моторы не касаются дна и тумб корпуса.

Что остаётся открытым:

| Номер | Вопрос | Статус |
|---|---|---|
| Г-1…Г-3 | Конфликты валов с кривошипами и лентами в деке v1 | ✅ Готово — решено в v2, проверено моделью |
| Г-5 | Наружный Ø шестерни — замер и купон 66 | ⚠️ Частично — замер 6.0 мм совпал с моделью (13.09.2026); какое из отверстий купона 5.6–6.2 держит плотнее — после печати купона |
| Г-6 | Сила: палец на r7.6 вместо r4.3 стенда — при том же моменте мотора сила на ленте в 1.8 раза меньше, а моторы Ø36 слабее NEMA14. Проверить на собранной деке, хватает ли на тележку | ⬜ Не начато |

## Файлы

* Модели привода «палка»: [gitara_sec1.py](https://github.com/Korvova/gitar/blob/main/2-0/gitara_sec1.py) (секция-1: четыре станции, плиты P0–P4),
  [gitara_sec2.py](https://github.com/Korvova/gitar/blob/main/2-0/gitara_sec2.py) (секции 2–3), [gitara_deka.py](https://github.com/Korvova/gitar/blob/main/2-0/gitara_deka.py) (дека: хребет, кривошипы, гребёнки),
  [gitara_joints.py](https://github.com/Korvova/gitar/blob/main/2-0/gitara_joints.py) (стыки); стенд — [palka_test.py](https://github.com/Korvova/gitar/blob/main/2-0/palka_test.py), демо — [palka_demo.py](https://github.com/Korvova/gitar/blob/main/2-0/palka_demo.py), [palka_full.py](https://github.com/Korvova/gitar/blob/main/2-0/palka_full.py)
* Сцены: [Гитара_секция1.blend](https://github.com/Korvova/gitar/blob/main/2-0/%D0%93%D0%B8%D1%82%D0%B0%D1%80%D0%B0_%D1%81%D0%B5%D0%BA%D1%86%D0%B8%D1%8F1.blend), [Гитара_палка.blend](https://github.com/Korvova/gitar/blob/main/2-0/%D0%93%D0%B8%D1%82%D0%B0%D1%80%D0%B0_%D0%BF%D0%B0%D0%BB%D0%BA%D0%B0.blend) (анимация четырёх станций),
  [Стенд_ручной.blend](https://github.com/Korvova/gitar/blob/main/2-0/%D0%A1%D1%82%D0%B5%D0%BD%D0%B4_%D1%80%D1%83%D1%87%D0%BD%D0%BE%D0%B9.blend) с аддоном [stend_addon.py](https://github.com/Korvova/gitar/blob/main/2-0/stend_addon.py) (N-панель «Стенд»: цель угла, лимит скорости)
* Прошивки: [drive_web/drive_web.ino](https://github.com/Korvova/gitar/blob/main/drive_web/drive_web.ino) (стенд: качание сектором, Wi-Fi и USB, команды deg/sw/zero/cur),
  `drive_test/drive_test.ino`, `ota_base/ota_base.ino`; пульт [serial_pult.html](https://github.com/Korvova/gitar/blob/main/2-0/websim/serial_pult.html)
* Тросовая v9 (референс, исключена): `2-0/trainer_v9.py`, `2-0/cart_module.py`,
  `2-0/finger_module.py`, `2-0/odnoetazhnik.py`, столы 01–20
* Инструкция сборки с картинками: [grif.html](https://raw.githack.com/Korvova/gitar/main/2-0/manual/grif.html), узлы троса — [tie.html](https://raw.githack.com/Korvova/gitar/main/2-0/manual/tie.html), привод «палка» — [palka.html](https://raw.githack.com/Korvova/gitar/main/2-0/manual/palka.html); оглавление — [manual/index.html](https://raw.githack.com/Korvova/gitar/main/2-0/manual/index.html)
* Столы печати: 21 (стенд палки), 31–36 (секции грифа и дека) в [2-0/Print3mf](https://github.com/Korvova/gitar/tree/main/2-0/Print3mf); 01–20 — тросовая v9
