Korvova/gitar/wiki/t-grif-v-deke.md

**Что соберём:** хребет деки с четырьмя моторами, кривошипами и лентами.
Крутишь кривошип рукой по кругу — кончик ленты ходит туда-сюда.

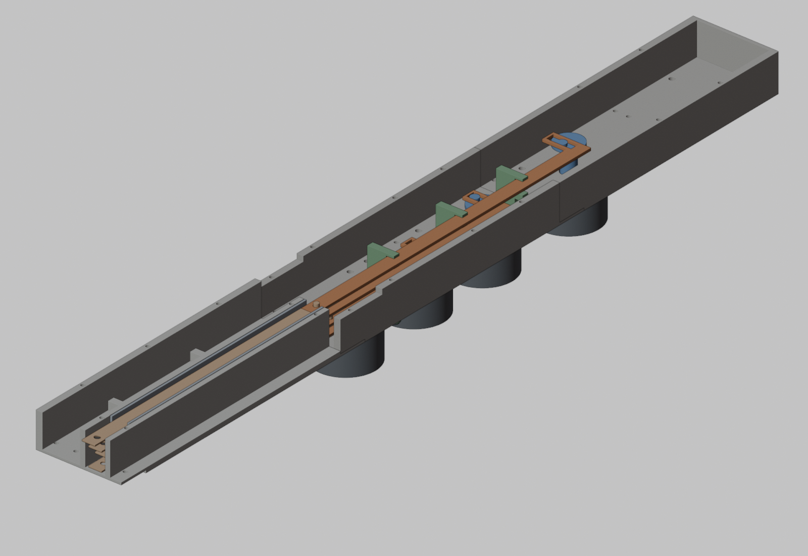
[picture p170: wiki/img/deka_v3_iso.png]
Что получится


## Сначала проба первого мотора

Сначала печатаем только стол 67 — в нём уже есть всё для первого мотора, и ничего
не придётся перепечатывать.

| Стол | Что на нём | Статус |
|---|---|---|
| [67_deka1_v3.3mf](https://raw.githubusercontent.com/Korvova/gitar/main/2-0/Print3mf/67_deka1_v3.3mf) | хребет Д1, кривошипы 0–2, проставка, 3 гребёнки, 3 фиксатора, ленты 0–2 | ✅ Напечатано |

Настройки: слой 0.2 мм, поддержки только от стола.

1. **Проставка и мотор 0** — у самого края хребта: переверни хребет, положи проставку,
   на неё мотор круглым выступом, 2 **длинных винта М3×10** сверху сквозь дно в уши.
2. **Кривошип 0** (с самой низкой ножкой) — сверху на шестерёнку, палец вверх.
3. **Лента 0** (самая короткая) — рамкой на палец.
4. **Покрутить кривошип по кругу** — кончик ленты ходит туда-сюда примерно на 10 мм.

| Что проверяем | Результат |
|---|---|
| Мотор с проставкой садится ровно, не шатается | ✅ 25.09 |
| Кривошип на шестерёнке: не прокручивается и не слишком туго | ✅ 25.09 |
| Палец в рамке крутится без заеданий на весь оборот | ✅ 25.09 |
| Кончик ленты ходит на ~10 мм | ✅ 25.09 |

**Проба 25.09 — всё работает:** мотор 0 на плате 4 моторов крутит кривошип, лента ходит. [видео: мотор крутит кривошип, лента ходит](https://raw.githubusercontent.com/Korvova/gitar/main/wiki/video/proba_motor0_deka.mp4)

Проба первого мотора на деке

Всё хорошо — печатаем стол 68 и собираем остальное по шагам ниже.

## Что нужно

**Напечатать:**

| Стол | Что на нём | Статус |
|---|---|---|
| [66_kupon_shesternya.3mf](https://raw.githubusercontent.com/Korvova/gitar/main/2-0/Print3mf/66_kupon_shesternya.3mf) | купон — 6 трубок для примерки на шестерёнку | ⬜ |
| [67_deka1_v3.3mf](https://raw.githubusercontent.com/Korvova/gitar/main/2-0/Print3mf/67_deka1_v3.3mf) | хребет Д1, кривошипы 0, 1, 2, проставка, 3 гребёнки, 3 фиксатора, ленты 0, 1, 2 | ⬜ |
| [68_deka2_v3.3mf](https://raw.githubusercontent.com/Korvova/gitar/main/2-0/Print3mf/68_deka2_v3.3mf) | хребет Д2, кривошип 3, лента 3 | ⬜ |

Настройки: слой 0.2 мм, **поддержки только от стола** — они нужны под дисками кривошипов.

**Купить:**

| Что | Сколько |
|---|---|
| мотор Ø36 с шестерёнкой | 4 |
| винт М3×5 | 6 |
| винт М3×10 | 2 |
| винт М3×4 | 3 |

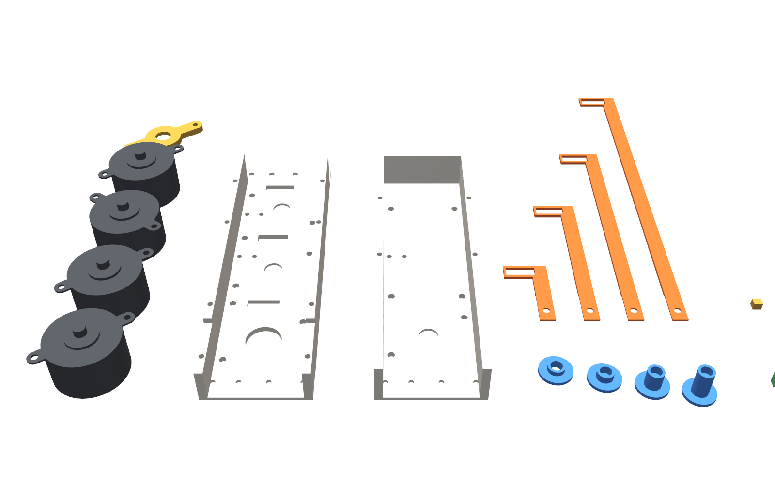
[picture p171: wiki/img/deka3_1_detali.png]
Все детали


Как не перепутать:
* **ленты** разной длины: лента 0 самая короткая, лента 3 самая длинная;
* **кривошипы** с ножкой разной высоты: у кривошипа 0 ножка самая низкая, у 3 — самая высокая;
* **проставка** — плоская деталь с большим отверстием, она одна.

## Шаги

### Шаг 1. Купон

Напечатай стол 66. Надень трубки по одной на шестерёнку мотора.

✔ Нужна та, что садится туго и не прокручивается. Посчитай риски рядом с ней и напиши
число. **Две риски** — всё уже готово, печатай дальше.

### Шаг 2. Печать

Напечатай стол 68 (стол 67 уже есть после пробы).

### Шаг 3. Соедини хребет

Положи Д2 на полку Д1. Снизу закрути **3 винта М3×4**. Одно среднее отверстие оставь
пустым — серое на картинке.

Шаг 3

### Шаг 4. Моторы

Переверни хребет.

* **Моторы 1, 2, 3:** вставь круглым выступом в большое отверстие.
* **Мотор 0** (у самого края хребта): сначала положи **проставку**, на неё мотор.

Шаг 4: моторы снизу

Переверни обратно и закрути винты **сверху** в уши моторов: у моторов 1, 2, 3 —
**М3×5**, у мотора 0 — **длинные М3×10** (они проходят ещё и сквозь проставку).

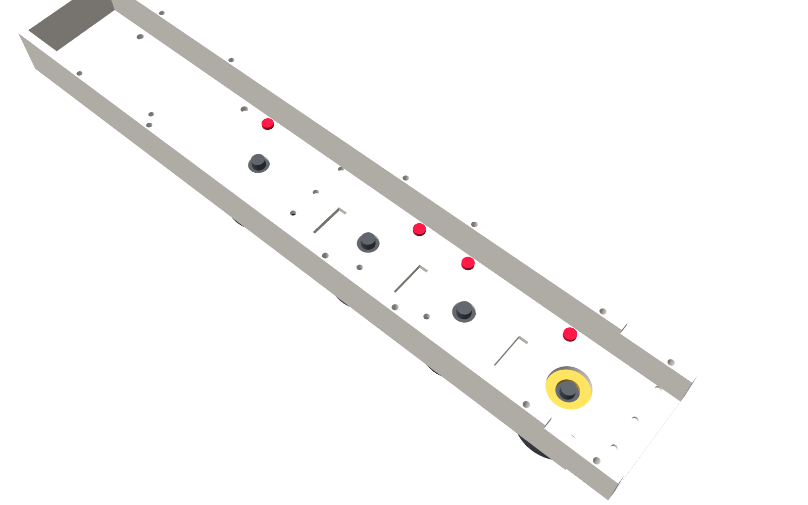
[picture p172: wiki/img/deka3_3b_vinty.png]
Шаг 4: винты сверху


✔ Готово, если моторы не шатаются.

### Шаг 5. Кривошип 0

Возьми кривошип **с самой низкой ножкой**. Надень его сверху на шестерёнку мотора 0.
Палец смотрит вверх.

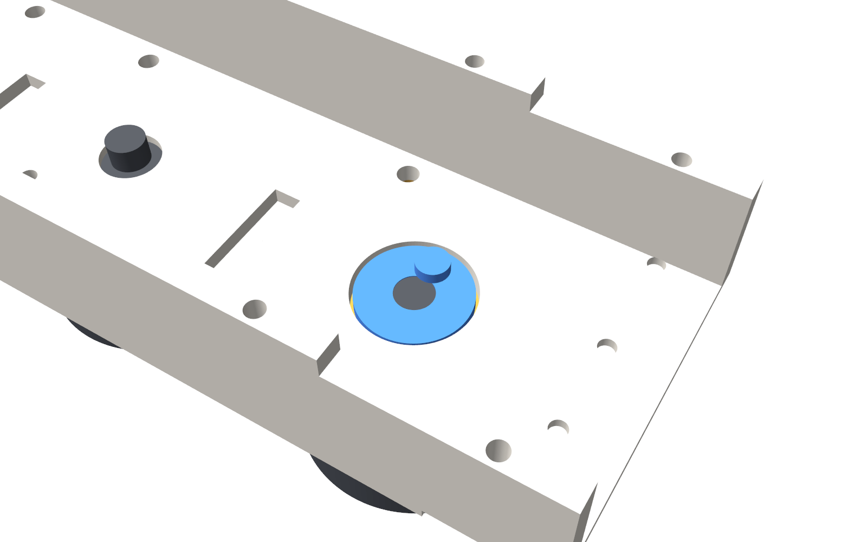
[picture p173: wiki/img/deka3_4_krivoship0.png]
Шаг 5


### Шаг 6. Лента 0

Возьми **самую короткую** ленту. Положи её сверху так, чтобы **палец кривошипа вошёл
в рамку** на конце ленты.

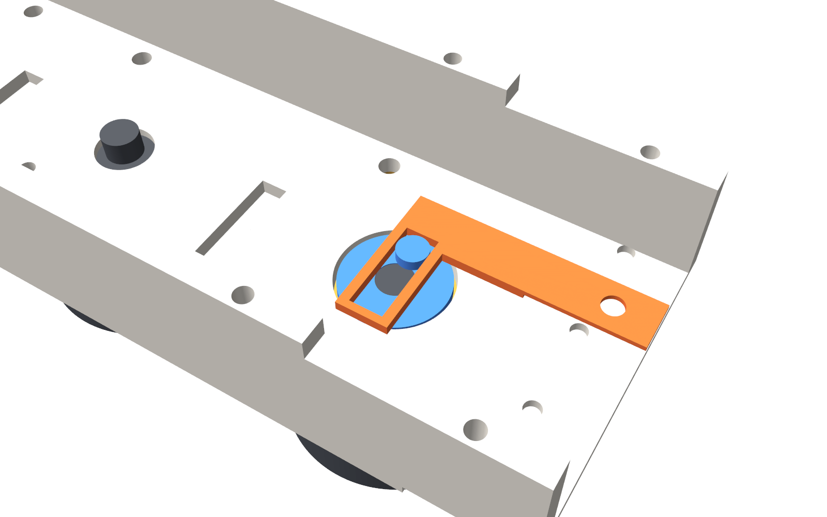
[picture p174: wiki/img/deka3_5_lenta0.png]
Шаг 6


✔ Проверь: покрути кривошип — лента ездит туда-сюда.

### Шаг 7. Остальные этажи

Повтори шаги 5 и 6 для кривошипа и ленты 1, потом 2, потом 3. Каждая следующая лента
длиннее и ложится выше предыдущей.

Шаг 7

### Шаг 8. Гребёнки

Гребёнок три, они держат ленты, чтобы те не прогибались. Для каждой:

1. поставь гребёнку **рядом с лентами**, открытыми зубьями к лентам, ножкой в длинную
   щель в дне;

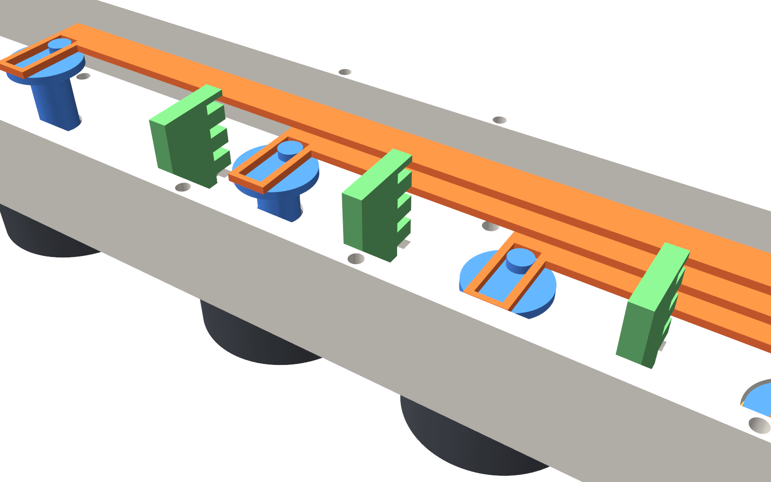
[picture p175: wiki/img/deka3_7a_grebenki_postavit.png]
Шаг 8: поставить


2. **задвинь её на ленты** до упора — ленты войдут между зубьями;
3. в щель позади гребёнки вставь **фиксатор**.

Шаг 8: задвинуть и зафиксировать

### Шаг 9. Проверка

Крути кривошип рукой **по кругу**. Кончик ленты у края хребта ходит вперёд-назад —
примерно на 10 мм.

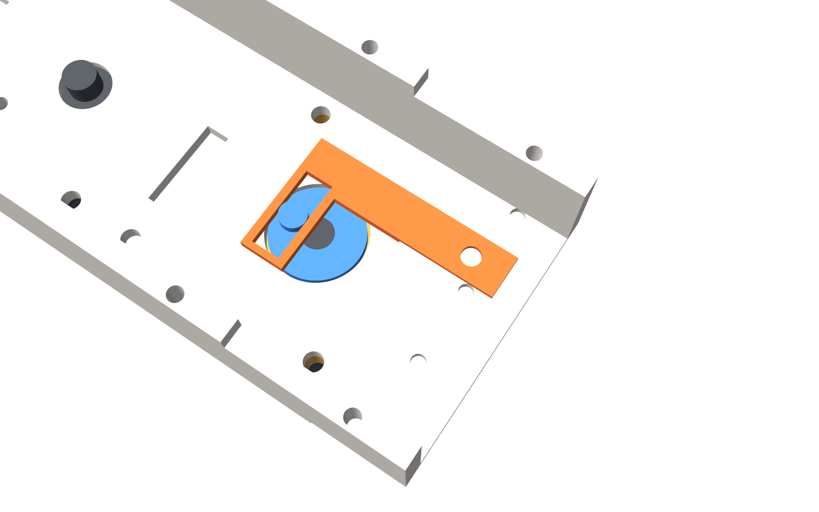
[picture p176: wiki/img/deka3_8_a.png]
Крайнее положение 1

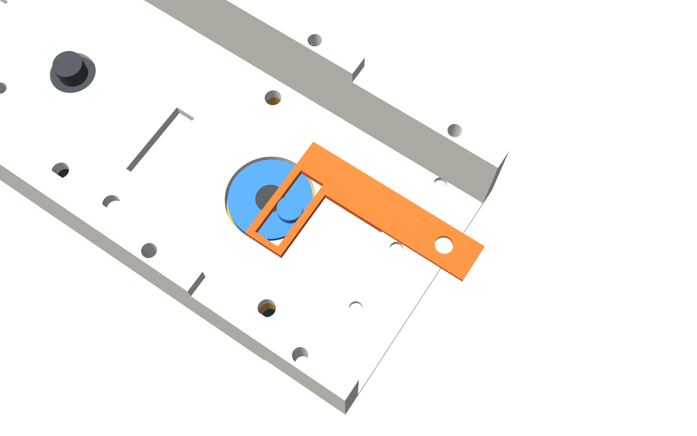
[picture p177: wiki/img/deka3_8_b.png]
Крайнее положение 2


✔ Готово, если:
* кривошип крутится по кругу без заеданий;
* двигается только эта лента, соседние стоят.

Проверь так все четыре кривошипа.

| Если… | Сделай |
|---|---|
| кривошип крутится, а лента стоит | кривошип прокручивается на шестерёнке — вернись к шагу 1 |
| кривошип заедает | лента не сидит рамкой на пальце — положи заново |
| двигается соседняя лента | лента попала не между своими зубьями гребёнки — переложи |

## Дальше

Подключить моторы к электронике — это следующий этап.

*Посмотреть в Blender:* [Гитара_дека_v3.blend](https://github.com/Korvova/gitar/blob/main/2-0/%D0%93%D0%B8%D1%82%D0%B0%D1%80%D0%B0_%D0%B4%D0%B5%D0%BA%D0%B0_v3.blend) — нажми пробел, кривошипы крутятся.
