Korvova/gitar/wiki/t-instrukcija-grif.md

Продолжение [Т. Инструкция по сборке: секция-1](/homepage/iniciativa.-razrabotka/jepik-ruka-gitara/t-instrukcija-sborki).
Здесь только что напечатать, что купить и что собрать. Почему детали устроены именно
так и что проверено моделью — в [Т. Гриф и аппликатура](/homepage/iniciativa.-razrabotka/jepik-ruka-gitara/t-grif),
требования 2.17–2.19.

## 1. Что напечатать

| Стол | Что на нём | Настройки | Статус |
|---|---|---|---|
| [33_gitara_sec2.3mf](https://raw.githubusercontent.com/Korvova/gitar/main/2-0/Print3mf/33_gitara_sec2.3mf) | секция-2: дно, 4 П-рейки, фретборд, планка-потолок | поддержки только от стола | ✅ Напечатано |
| [34_gitara_sec3.3mf](https://raw.githubusercontent.com/Korvova/gitar/main/2-0/Print3mf/34_gitara_sec3.3mf) | секция-3: дно, 4 П-рейки, фретборд с языком, планка-потолок | поддержки только от стола | ✅ Напечатано |
| [35_gitara_deka1.3mf](https://raw.githubusercontent.com/Korvova/gitar/main/2-0/Print3mf/35_gitara_deka1.3mf), [36_gitara_deka2.3mf](https://raw.githubusercontent.com/Korvova/gitar/main/2-0/Print3mf/36_gitara_deka2.3mf) | из этих столов нужны только **8 лент-продолжений** | — | ✅ Напечатано |
| [66_kupon_shesternya.3mf](https://raw.githubusercontent.com/Korvova/gitar/main/2-0/Print3mf/66_kupon_shesternya.3mf) | купон посадки кривошипа на шестерёнку мотора | 0.2 мм, **печатать первым** | ⬜ Не напечатано |
| [67_deka1_v3.3mf](https://raw.githubusercontent.com/Korvova/gitar/main/2-0/Print3mf/67_deka1_v3.3mf) | хребет Д1, кривошипы 0–2, проставка мотора 0, 3 гребёнки, 3 фиксатора, ленты 0–2 — **печатать первым: с него проверяется первый мотор** | 0.2 мм, поддержки только от стола | ✅ Напечатано, проба мотора 25.09 прошла |
| [68_deka2_v3.3mf](https://raw.githubusercontent.com/Korvova/gitar/main/2-0/Print3mf/68_deka2_v3.3mf) | хребет Д2, кривошип 3, лента 3 | 0.2 мм, поддержки только от стола | ⬜ Не напечатано |

Со столов 35/36 старые хребты, кривошипы, втулки, хвосты и гребёнки **не нужны** — они были
под другой мотор и другой механизм.

По желанию: фретборды на столах 33/34 теперь с линиями струн. Уже напечатанные
фретборды рабочие, новые можно допечатать отдельно.

## 2. Что купить

| Что | Сколько | Куда |
|---|---|---|
| Мотор Ø36 с шестерёнкой | 4 | в хребет деки |
| Винт М3×4 | 12 | стыки секция-1/2, 2/3, 3/Д1, Д1/Д2 — по 3 на стык |
| Винт М3×10 | 14 | фретборды, по 7 на секцию |
| Винт М3×5 | 6 | уши моторов 1, 2, 3 |
| Винт М3×10 | 2 | уши мотора 0 (сквозь проставку) |
| Силиконовая смазка с PTFE | капля | стыки лент, жёлоб |

## 3. Сборка

«Север» — сторона порожка, «юг» — сторона деки.

### Часть 1. Гриф: секции 2 и 3 с лентами

Моторы не нужны — можно собирать уже сейчас.

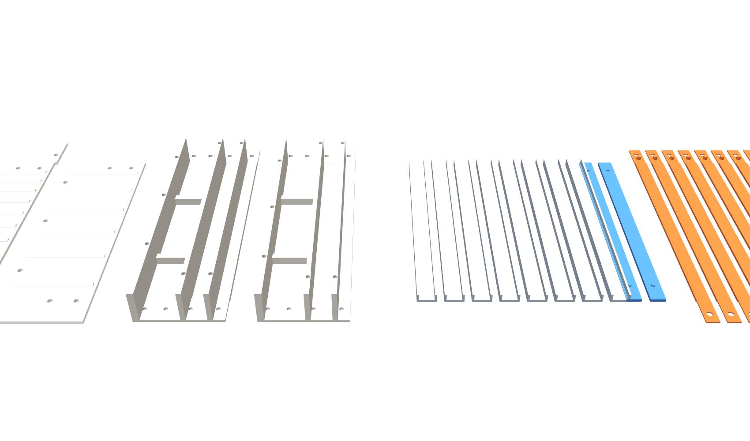
[picture p178: wiki/img/sborka_v_0_detali.png]
Детали части 1


**Шаг 1. Стыки секций.** Дно секции-2 положить вырезом поверх полки секции-1, четыре
отверстия совпадают. **Три винта М3×4 снизу:** в два крайних отверстия и в одно из
двух средних. **Среднее отверстие со стороны жёлоба лент оставить пустым** (на картинке
оно серое) — винт из него вылезет в проход ленты. Так же секцию-3 на полку секции-2.

Шаг 1: три винта на стык, у жёлоба — пусто

**Шаг 2. Этаж 0.** В каждую секцию по П-рейке жёлобом вверх. Ленту-продолжение
положить в жёлоб секции-2 и северным концом накрыть хвост спицы-0, торчащий из
секции-1: высокий штырёк — в дырку, язычки ложатся заподлицо. Вторую ленту — в
секцию-3, на конец первой.
*Проверка:* двинуть свободный конец ленты на ±4 мм — тележка 0 едет.

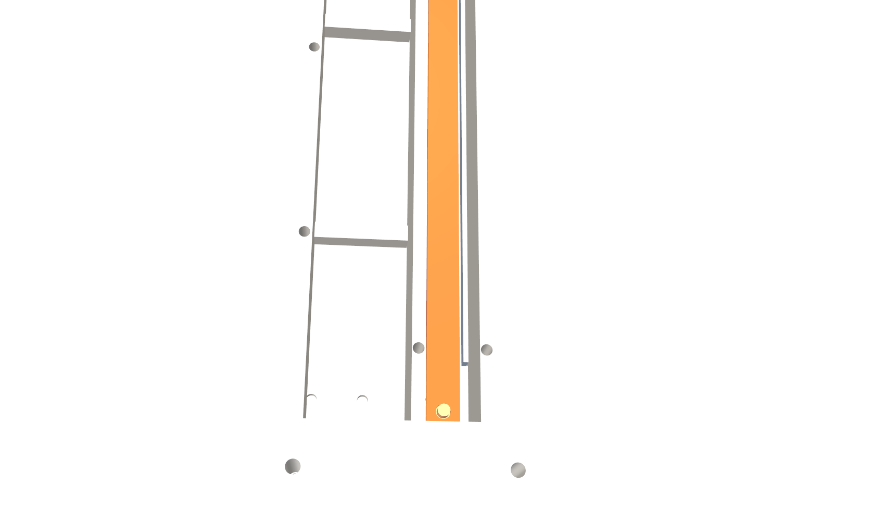
[picture p179: wiki/img/sborka_v_2_etazh0.png]
Шаг 2: лента защёлкнута на хвост спицы


**Шаг 3. Этажи 1, 2, 3.** Следующая рейка ложится прямо на стенки предыдущей, дальше
как на этаже 0. После каждого этажа подвигать его ленту — клин видно сразу. На ленту
этажа 3 в каждую секцию положить **планку-потолок пеньками вверх**.

Шаг 3: четыре этажа лент и планки-потолки

**Шаг 4. Фретборды.** Ладами вверх, пеньки планки — в дырки снизу фретборда, **7 винтов
М3×10** на секцию. Язык фретборда секции-3 **не прикручивать** — он для корпуса.

Шаг 4: фретборды

*Проверка части 1:* каждая лента за южный конец ходит на ±4 мм от лёгкого нажатия и
двигает только свою тележку; после фретбордов так же легко, как до. Туго — пенёк
планки не попал в дырку. Едут две тележки — перепутаны ленты этажей.

### Часть 2. Дека с моторами

После печати столов 66, 67, 68 — по шагам, с картинкой на каждый шаг, на отдельной странице
**[Т. Гриф в деке](/homepage/iniciativa.-razrabotka/jepik-ruka-gitara/t-grif-v-deke)**.

Кривошип там крутится на полный оборот, ленты кладутся сверху прорезью на палец, гребёнки
задвигаются в конце.

Дека в сборе

## Файлы

* Сцена для просмотра: [Гитара_дека_v3.blend](https://github.com/Korvova/gitar/blob/main/2-0/%D0%93%D0%B8%D1%82%D0%B0%D1%80%D0%B0_%D0%B4%D0%B5%D0%BA%D0%B0_v3.blend) — пробел запускает полный оборот кривошипов
* Модели: [gitara_sec2.py](https://github.com/Korvova/gitar/blob/main/2-0/gitara_sec2.py) (секции 2–3), [gitara_deka.py](https://github.com/Korvova/gitar/blob/main/2-0/gitara_deka.py) (дека с моторами и проверкой качания)
* Картинки: `2-0/render_sborka_v.py`, `2-0/render_sborka_g3.py`, `2-0/scene_deka_v3.py`
