Korvova/gitar/wiki/t-polozhenie-telezhek.md

Как устройство узнаёт, где сейчас каждая тележка, то есть насколько согнут палец
ученика. В режиме обучения положение известно из счётчика шагов мотора после хоминга
по упору — датчик не нужен. Для режима «сам» (мотор отпущен, ученик двигает палец,
система видит положение и сравнивает с аккордом) положение читается не по тележке,
которая ходит на 40 мм, а по ленте в деке, которая ходит всего на ±4.8 мм.

**Формат, подтверждённый стендом 15.09.2026:** магнит Ø4×1.5 сидит в кармане сверху
ленты, датчик Холла 49E лежит плашмя **под лентой**, надписью вверх; магнит проезжает
над ним и на краю хода останавливается в 0.5 мм, не доезжая до точки над чипом.
Напряжение меняется монотонно, 194 единицы АЦП на 12 мм при шуме ±1.5 — шесть зон
струн на ходе тележки читаются с большим запасом. Датчик сбоку от ленты (первый
вариант стоек) не годится: у ребра дискового магнита поле меняет знак, показание
идёт горбом, а размах всего 90 единиц.

Что осталось по этому узлу: карманы под магнит в хвостах лент (6.8), стойки v2 под
лентой (6.9), калибровка в прошивке (6.5). Прижим пальца и вибро в тележке — отдельная
задача, [Т. Тактильная обратная связь](/homepage/iniciativa.-razrabotka/jepik-ruka-gitara/t-taktilka).

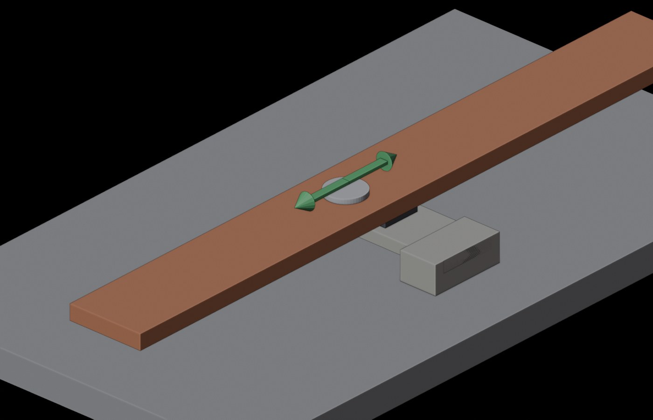
[picture p180: wiki/img/hall_format_iso.jpg]
Формат: магнит в кармане ленты, 49E плашмя под лентой на язычке стойки; стрелки — ход ленты ±4.8


## Требования

| Номер | Требование | Описание | Урок | Статус |
|---|---|---|---|---|
| 6.1 | Положение в режиме обучения без датчиков | Хоминг по упору: при r4.8 палец кривошипа доводит штырь до конца прорези секции-1 раньше конца сектора, TMC2209 видит упор по StallGuard, счётчик обнуляется; дальше положение = шаги. Хоминг повторять в паузах между аккордами | Мотор нагружен на 3 %, пропуск шагов только при сопротивлении пальца сильнее 3–6 Н | ⬜ Не начато |
| 6.2 | Датчик положения по ленте, а не по тележке | Ход ленты ±4.8 мм — зона уверенной видимости магнита для 49E; ход тележки 40 мм одним датчиком не покрыть (поле падает как куб расстояния). Датчик со сдвигом +R_CR+0.5 от среднего положения магнита, поэтому за весь ход поле монотонно | Магнит на плече (±5 мм на радиусе 15) работал бы так же, но лента в деке доступнее и не трогает секцию-1 | ✅ Готово |
| 6.3 | Стенд проверки гипотезы | Основание со встроенной стойкой и палка-лента с магнитом, ход ровно 9.6 мм между упорами, шкала 0…10 мм. Стол 70 | Проверено 15.09.2026 (машина 2). Датчик **сбоку** в кармане стойки — горб: 1937 → 1980 за ~4 мм, потом обвал до 1890, размах 90. Датчик **под палкой** — монотонно: 2142 → 2121 → 2084 → 2032 → 1995 → 1966 → 1948 (шаг 2 мм, 0…12 мм), каждый шаг в 10–36 раз выше шума ±1.5. Пульт `websim/hall_stend_pult.html` | ✅ Готово |
| 6.4 | Стойки в деке v3 сбоку от ленты | Четыре стойки на дно хребта сбоку от жёлоба, датчик плашмя на высоте магнита; проверено на полном обороте кривошипов, зазоры ≥ 0.8 мм (стол 71) | Исключено 15.09.2026: стенд показал горб и слабый сигнал при датчике сбоку — заменено стойками под лентой, см. 6.9 | ❌ Исключено |
| 6.5 | Калибровка | В режиме обучения мотор проезжает сектор от упора до упора, прошивка записывает напряжение датчика на каждом шаге; в режиме «сам» по напряжению находится шаг, по шагу — струна | Таблица на 60 точек на станцию живёт в прошивке. Кривая S-образная (стенд): круче всего в середине хода ~26/мм, у краёв ~10/мм — таблица нужна, линейной формулы не хватит | ⬜ Не начато |
| 6.6 | Входы | 4 аналоговых входа ADC1 на ESP32-S3 (GPIO 7–10 в раскладке), питание 3.3 В | Один ESP32 классический не подошёл бы: его ADC1 целиком заняты струнами | ⬜ Не начато |
| 6.7 | Датчик под лентой, а не сбоку | Поле дискового магнита сбоку слабое и у рёбер переворачивается; над полюсом (как у струн: магнит проходит над чипом) сигнал втрое сильнее и монотонный до самого центра | Стенд 15.09.2026, см. 6.3. Решение владельца 15.09: деку и ленты делать под этот формат | ✅ Готово |
| 6.8 | Ленты и спицы под магнит | В хвосте ленты каждого этажа — круглый карман под магнит Ø4×1.5 сверху, глубина 1.0, магнит торчит на 0.5 + клей, как у палки стенда (`gitara_hall_stend.py`); лента остаётся 8×1.6, над магнитом в полости этажа 3.8 запас есть | Карман фиксирует магнит по месту без разметки; позиции MAG_Y — из `gitara_hall.py` | ⬜ Не начато |
| 6.9 | Стойки v2 под лентой | Стойка на дне хребта с язычком под лентой: карман под 49E плашмя надписью вверх, верх чипа на ~1 мм ниже низа ленты, центр чипа на +R_CR+0.5 от среднего положения магнита вдоль хода; этаж 0 — карман снизу в полу хребта. Проверить зазоры на полном обороте кривошипов и к ленте этажом ниже, как делала v1 | Формат стенда 15.09: магнит подходит к точке над чипом и останавливается в 0.5 мм, не проезжая. 15.09 вечером владелец предложил проще — язычок сбоку ленты, см. 6.10; если 6.10 принимается, стойки под лентой в жёлобе не нужны | ⬜ Не начато |
| 6.10 | Язычок сбоку ленты под магнит, датчик под язычком | Идея владельца (15.09.2026): у хвоста каждой ленты в деке — боковой язычок на восток (x от 14 до ~20, внутри стенки хребта 22), на нём карман под магнит Ø4×1.5; датчик 49E плашмя под язычком в маленькой стойке-тумбочке на дне хребта, формат стенда (чип на ~1 мм ниже язычка, центр на +R_CR+0.5 по ходу). Язычок ходит вместе с лентой на ±4.8, жёлоб и опоры не трогаются, место под датчик и провода — свободная восточная полоса хребта. Этаж 0 — язычок низко (3 мм над полом): датчик над язычком на мостике или карман в полу с крышкой 0.9 мм | Плюсы против 6.9: стойка не лезет в жёлоб между лентами, датчик одинаково ставится на всех этажах, перепечатать только 4 хвоста и 4 тумбочки — напечатанная дека Астры остаётся. Ограничение: опоры Астры — закрытые окна, язычок должен на всём ходе ±4.8 не доезжать до опоры и до рамки кривошипа; позиции язычков считать по STL деки Астры (файлы во вложениях страницы «Гриф в деке от астра», в git их нет) | ⬜ Не начато |
| 6.11 | Накладка на ленту вместо перепечатки хвоста | Уточнение владельца (15.09.2026): язычок делать отдельной накладкой сверху ленты — пластинка на ширину ленты с боковым крылом на восток, магнит в кармане крыла; крепление два винта М2 самонарезом в просверленные в ленте дырки Ø1.8 (или суперклей). Датчик 49E под крылом в тумбочке на дне; у этажа 0 крыло на подставке 2 мм, чтобы тумбочка была печатной (~3.4 мм) | Хвосты, опоры и дека Астры не перепечатываются: 4 накладки + 4 тумбочки. Зазор чип–магнит ~2.4 мм — сигнал сильнее стендового. Позиции крыльев по длине — по STL Астры: не доезжать до опоры и до диска своего кривошипа (x 3..17) на всём ходе ±4.8 | ⬜ Не начато |

## Как проверяли (стенд, стол 70)

Стенд — основание с каналом и упорами (ход палки ровно 9.6 мм, шкала 0…10) и палка-лента
8×1.6 с карманом под магнит. Напечатанная стойка сбоку от канала оказалась не нужна: датчик
кладётся **под палку** плашмя, надписью вверх, ножками наружу.

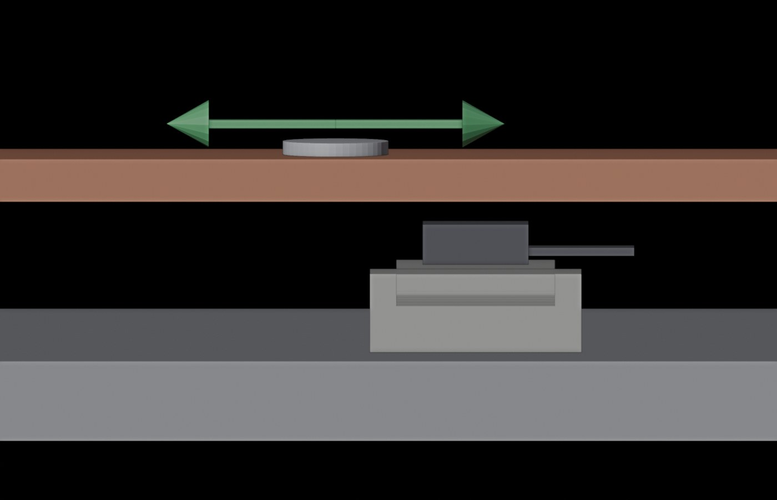
[picture p181: wiki/img/hall_format_side.jpg]
Датчик под палкой: магнит проезжает над чипом


**Подключение 49E** (надписью вверх, ножки к себе): левая — 3.3 В, средняя — земля, правая —
АЦП (GPIO32 = канал 1 прошивки `struny6_hall`).

**Пульт** [hall_stend_pult.html](https://raw.githack.com/Korvova/gitar/main/2-0/websim/hall_stend_pult.html)
(Web Serial, Chrome): АЦП и шум вживую, кнопки «палка на южном упоре = 0» и «на северном = 9.6»,
схема стенда, на которой палка едет по показанию датчика, таблица «мм → АЦП» с вердиктом
(монотонность, Δ/шум) и готовая строка для вики.

**Результат 15.09.2026**

| Магнит от датчика, мм | 0 | 2 | 4 | 6 | 8 | 10 | 12 |
|---|---|---|---|---|---|---|---|
| АЦП | 2142 | 2121 | 2084 | 2032 | 1995 | 1966 | 1948 |
| Δ на 2 мм | | −21 | −38 | −52 | −37 | −29 | −18 |

Монотонно, 194 единицы на 12 мм при шуме ±1.5, при возврате показание повторяется. Для
сравнения датчик сбоку (как в стойках v1): 1937 → 1941 → 1954 → 1970 → 1980 → 1975 → 1890 —
горб у края магнита и вчетверо меньший размах.

Файлы стенда: [70_hall_stend.3mf](https://raw.githubusercontent.com/Korvova/gitar/main/2-0/Print3mf/70_hall_stend.3mf),
генератор [gitara_hall_stend.py](https://github.com/Korvova/gitar/blob/main/2-0/gitara_hall_stend.py).

## Стойки v2 в деке — что сделать

Позиции магнитов на лентах не меняются (подобраны генератором подальше от ушей моторов,
гребёнок, дисков и тумб). Меняется место датчика: под лентой вместо сбоку.

| Этаж | Магнит на ленте: от северного конца хвоста | Датчик | Верх чипа относительно пола хребта |
|---|---|---|---|
| 0 | 12 мм, на языке защёлки | карман снизу в полу хребта под лентой | −0.95 (в толще пола 3 мм) |
| 1 | 26 мм | язычок стойки под лентой | ~7.5 |
| 2 | 76 мм | язычок стойки под лентой | ~12.9 |
| 3 | 167 мм | язычок стойки под лентой | ~18.3 |

Центр чипа по ходу — на +5.3 мм от среднего положения магнита; расстояние от чипа до
центра магнита ~3.3 мм (зазор 1 + лента 1.6 + половина магнита), как на стенде. У этажей
1–3 язычок проходит над лентой этажом ниже с зазором ~0.3 мм — проверить генератором на
полном обороте всех кривошипов, как это делал `gitara_hall.py` для v1.

**Порядок:** карман в хвостах лент (`gitara_deka.py`, 6.8) → стойки v2 (`gitara_hall.py`, 6.9) →
стол печати → проверка на деке: крутить кривошип, показание меняется плавно на всём ходе,
у соседних этажей не шевелится.

## Вариант проще: язычок сбоку ленты (6.10)

Вместо стойки под лентой в жёлобе — боковой язычок у хвоста ленты, магнит в кармане на
язычке, датчик под язычком в тумбочке на восточной полосе дна. Язычок ездит вместе с лентой
на ±4.8, поэтому измерение то же, что на стенде, а место под датчик и провода свободно.
Что нужно для расчёта позиций: STL напечатанной деки Астры (Д1, опоры с закрытыми окнами,
хвосты, кривошипы) — язычок на всём ходе не должен доезжать до опоры и до рамки кривошипа.
Перепечатываются только четыре хвоста и четыре тумбочки.

## Дальше

* Прошивка четырёх каналов: хоминг по упору (6.1), калибровка датчиков (6.5).
* Прижим пальца и вибро в тележке — [Т. Тактильная обратная связь](/homepage/iniciativa.-razrabotka/jepik-ruka-gitara/t-taktilka).
