Korvova/gitar/wiki/t-peremeshchenie-po-grifu.md

Как ученик задаёт сдвиг позиции руки по грифу (аккорд на 5-м ладу вместо 1-го),
если пальцы 2–5 сидят в тележках и вдоль грифа не двигаются. Позиция виртуальная:
лента вдоль грифа показывает, «где рука», тележки переставляются на новую
аппликатуру. Нужен орган, которым ученик делает движение, максимально похожее на
настоящую смену позиции.

**Идея владельца (14.09.2026): «затвор» под большим пальцем.** На задней стороне грифа
площадка, как затвор пистолета. Большой палец лежит на ней, как на настоящем грифе.
При смене позиции рука тянет затвор к порожку или к деке, он уходит на ±6 мм и
возвращается пружинами в центр. Именно так на гитаре и происходит сдвиг: большой
палец скользит по задней стороне первым, рука идёт за ним. В затворе же живут три
вибромотора: волна под пальцем — «сдвинь руку туда».

Страница фиксирует идею и первый эскиз. Статус — ⌛ идея, до печати не дошло; в
очереди после стенда датчика положения.

## Что уже отвергнуто и почему

| Вариант | Почему нет |
|---|---|
| Язычки на бортах, давить сверху ребром ладони | при реальной посадке ребру ладони нечем давить, жест не гитарный |
| Лопатки на басовом борту выше и ниже кисти, толкать вдоль грифа | кисть свободно висит под грифом и до лопаток не достаёт; ширина грифа растёт до 82 мм |
| Весь блок тележек «плавает» вдоль грифа | движение честное, но тележки приводятся штырями снизу через прорези — механика усложняется в разы |

## Требования

| Номер | Требование | Описание | Урок | Статус |
|---|---|---|---|---|
| 7.1 | Жест как на гитаре | Большой палец на задней стороне грифа тянет затвор вдоль грифа; пальцы 2–5 в тележках | Ребро ладони и сдвиг сверху — не работают, см. таблицу выше | ✅ Готово (решение) |
| 7.2 | Затвор не мешает секции-1 | Пластина 52×160×5 под дно, крепится винтами стяжки М3 (Y 80, 150) на 5 мм длиннее; секция не меняется | У Y 6 площадка невозможна: борт канала тележек | ✅ Готово (эскиз) |
| 7.3 | Ход ±6 мм, возврат в центр | Окно 22.6×52 в пластине, затвор 22×40 на язычках в пазах; две пружины Ø4 от авторучки в гнёздах по торцам; лёгкий щелчок в центре — следующая версия | Печатные пружины-змейки в 6 мм не помещаются, пружины от ручки надёжнее | ⬜ Не начато |
| 7.4 | Датчик: сила или положение — сравнить | На одной детали оба: FSR402/RFP-602 в нишах на торцах окна, пятачки Ø4.8 на торцах затвора (сила нажатия по направлению); магнит Ø4×2 в боку затвора + 49E на ребре в пластине (положение). Владелец ожидает, что FSR по ощущению лучше; проверять оба | 49E со сдвигом +6.5 от среднего положения магнита — кривая монотонна на всём ходе, как на стенде датчика положения | ⬜ Не начато |
| 7.5 | Вибро под пальцем | Три мотора 10×3 в затворе с шагом 13 мм, заподлицо с ложбинкой; провода петлёй с запасом на 12 мм хода | Шаг 13 меньше рекомендованных 25 — волна на такой площадке будет коротко-направленной, проверить | ⬜ Не начато |
| 7.6 | Электроника | Свой ESP32-C3 на накладке: 2 FSR на АЦП, 1 Холл на АЦП, 3 мотора через транзисторы, ESP-NOW к деке, питание 5 В двумя проводами | Лента светодиодов — отдельная задача владельца, сюда не входит | ⬜ Не начато |
| 7.7 | Ложные срабатывания | Порог по силе/смещению, чтобы нажим пальца вниз при аккорде не читался как сдвиг | Проверить на стенде и живой руке | ⬜ Не начато |

## Эскиз v0

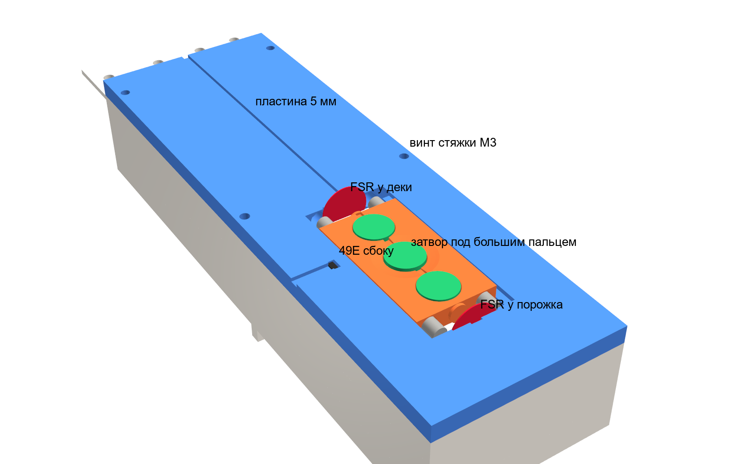
[picture p182: wiki/img/zatvor_1_snizu.png]
Затвор под большим пальцем, вид снизу


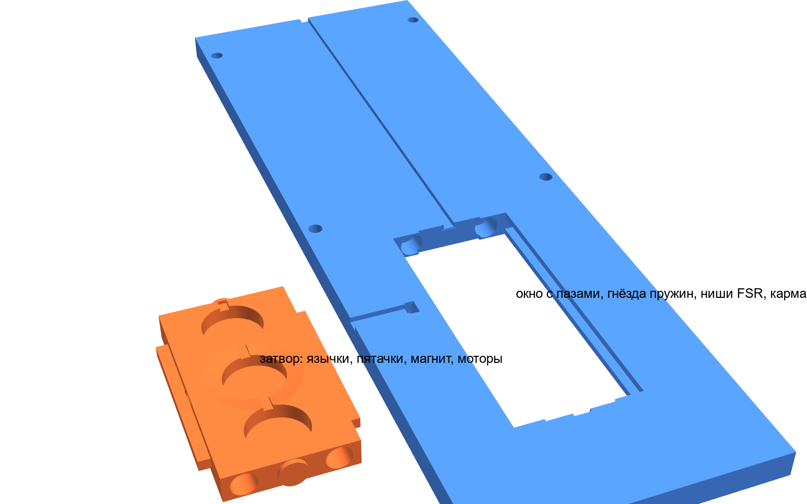
[picture p183: wiki/img/zatvor_2_detali.png]
Пластина и затвор отдельно


Три положения: к порожку, центр, к деке (вид снизу):

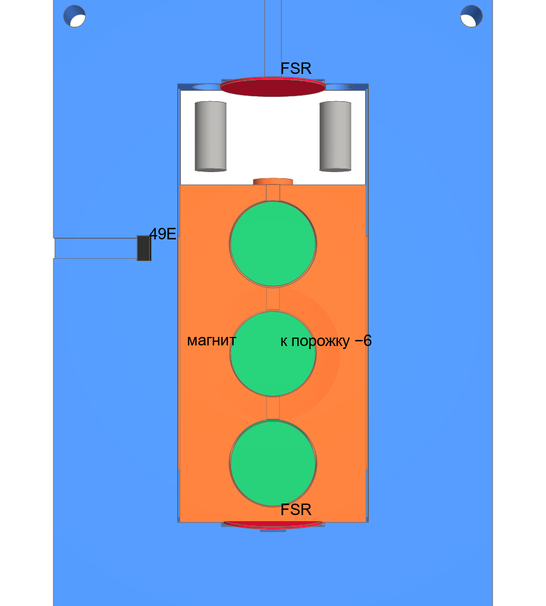
[picture p184: wiki/img/zatvor_3_porozhek.png]
К порожку

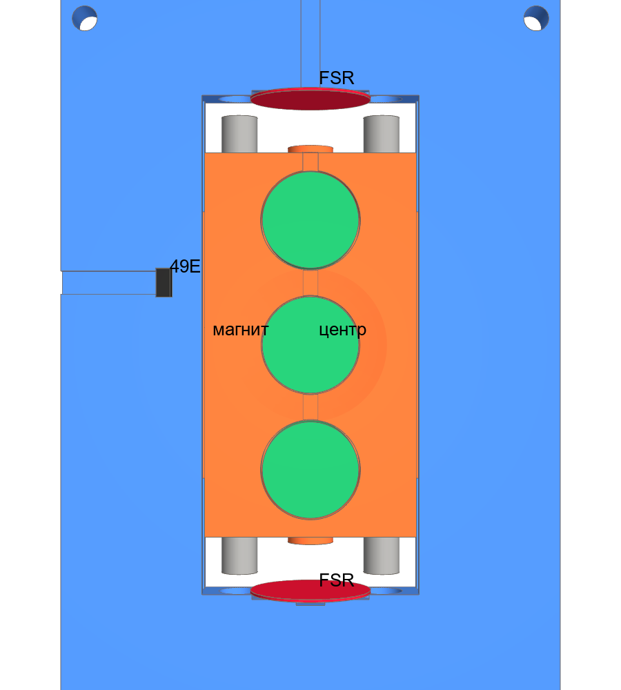
[picture p185: wiki/img/zatvor_3_centr.png]
Центр

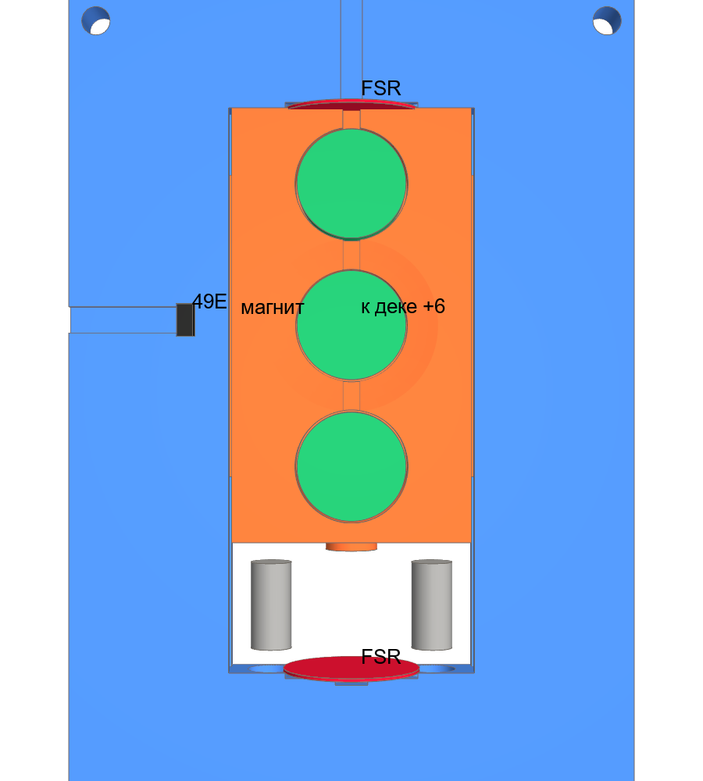
[picture p186: wiki/img/zatvor_3_deka.png]
К деке


Как устроено:

* **Пластина** под дно секции-1: окно Y 20…72 под ладами 1–4, в боковых стенках окна
  пазы под язычки затвора (Z −3.5…−1.5), по торцам окна два гнезда Ø4.4 под пружины и
  ниша Ø13.2×0.5 под диск FSR с щелью под хвост; справа от окна карман под 49E,
  стоящий на ребре лицом к окну, на Y 52.5 (середина хода + 6.5).
* **Затвор** 22×40×5: язычки 2×2 по бокам, ложбинка 0.8 мм под подушечку, на торцах
  пятачки Ø4.8 против FSR и гнёзда пружин, в правом боку карман под магнит Ø4×2 осью
  поперёк, снизу три кармана Ø10.4 под моторы и канавки проводов.
* Ход ±6 мм ограничен торцами окна через сжатые пружины; на упоре пятачок давит
  на FSR.

## Файлы

| Стол | Что на нём | Настройки |
|---|---|---|
| [72_zatvor.3mf](https://raw.githubusercontent.com/Korvova/gitar/main/2-0/Print3mf/72_zatvor.3mf) | пластина и затвор | 0.2 мм, без поддержек; пластина пазами вниз (печатается верхом на стол), затвор верхом на стол |

STL: `zatvor_plate_v0.stl`, `zatvor_slide_v0.stl` в [2-0/Print/Print](https://github.com/Korvova/gitar/tree/main/2-0/Print/Print).
Генератор: [gitara_zatvor.py](https://github.com/Korvova/gitar/blob/main/2-0/gitara_zatvor.py), картинки — `2-0/render_zatvor.py`.

Купить: 2 пружины Ø4 (от авторучки, отрезать по 8 мм), 2 FSR (есть), 1 магнит Ø4×2 (есть),
1 датчик 49E (есть), 3 плоских вибромотора 10×3, ESP32-C3 SuperMini (есть).

## Как проверить, когда дойдёт очередь

1. Напечатать стол 72, вставить пружины, поставить затвор в окно. Без датчиков:
   палец на затворе, тянуть к порожку и к деке — ход ±6, возврат в центр, при обычном
   нажиме вниз затвор не уезжает.
2. FSR: подключить оба к АЦП, записать силу при «сдвиге» и при обычном нажиме
   аккорда — нужен порог, который их разделяет.
3. Холл: магнит и 49E, кривая напряжения от положения, как на стенде датчика положения.
4. Решить по ощущениям и по цифрам, какой датчик оставить; второй убрать из
   генератора одной константой.
