Korvova/gitar/wiki/t-korpus.md

Корпус в размерах настоящей классической гитары: тело 480×370 мм, глубина 95 мм,
розетка Ø87 мм у талии. Внутри живёт механика грифа, сверху над розеткой ставится
узел струн. Всё печатается кусками и собирается на винтах.

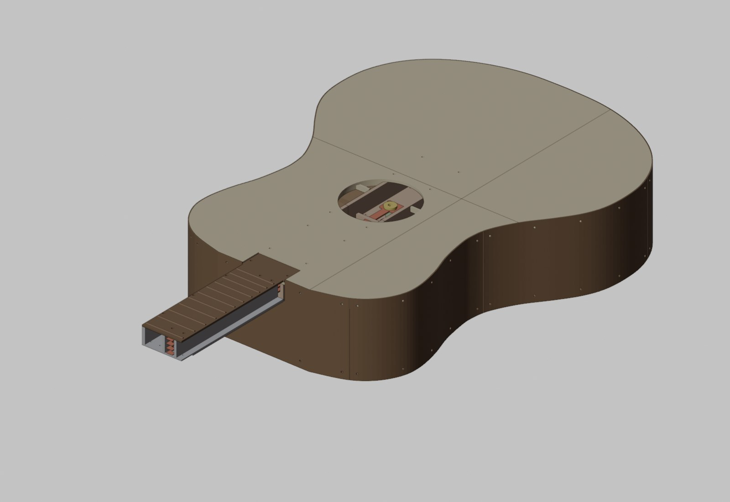
[picture p187: wiki/img/korpus.jpg]
Корпус в сборе: дно и крышка из четырёх кусков, обечайка на винтах, розетка, приступок под пятку грифа


*Корпус в сборе — сцена [Гитара_корпус.blend](https://github.com/Korvova/gitar/blob/main/2-0/%D0%93%D0%B8%D1%82%D0%B0%D1%80%D0%B0_%D0%BA%D0%BE%D1%80%D0%BF%D1%83%D1%81.blend). Дека (хребет на девяти тумбах внутри корпуса, с этажами спиц и кривошипами) — сцена [Гитара_дека.blend](https://github.com/Korvova/gitar/blob/main/2-0/%D0%93%D0%B8%D1%82%D0%B0%D1%80%D0%B0_%D0%B4%D0%B5%D0%BA%D0%B0.blend):*

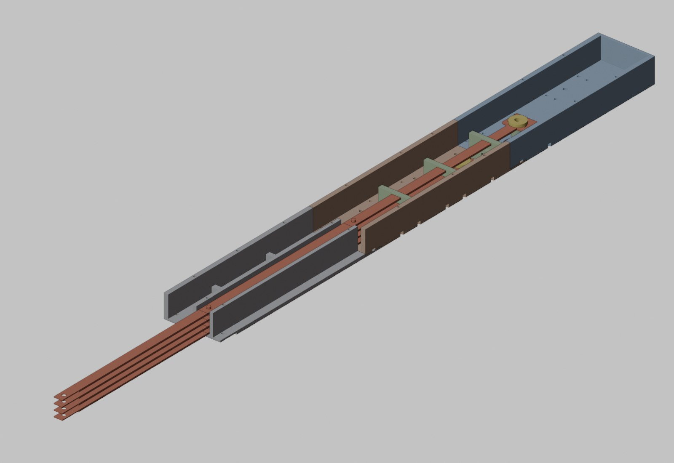
[picture p188: wiki/img/deka.jpg]
Дека: хребет с этажами спиц, гребёнки, кривошип у мотора


## Требования

| Номер | Требование | Описание | Урок | Статус |
|---|---|---|---|---|
| 3.1 | Форма и размеры настоящей классики | Контур по кривой Катмулла-Рома, 480×370, глубина 95 | Размеры взяты у настоящего инструмента, чтобы девайс не выглядел макетом | ✅ Готово |
| 3.2 | Дно и крышка печатаются кусками | По 4 куска, стыки-полки внахлёст 1 плюс 2 мм | Стык «бутербродом» держит плоскость; южная часть дна и северная часть крышки печатаются с поддержкой от стола | ✅ Готово |
| 3.3 | Обечайка | 7 лент PETG на винтах к бортикам 10×10 мм | Стыки лент — взаимная защёлка: выступ 1 мм заходит в ответную дырку, идея владельца | ✅ Готово |
| 3.4 | Соединение грифа с декой | Язык фретборда заходит в окно крышки, крепёж винтами через бобышки | Решение владельца: удлинить фретборд и сделать в крышке утолщение под винты | ✅ Готово |
| 3.5 | Место под узел струн | Крепление узла к крышке винтами М3 через шайбы-проставки 4 мм | Под узлом остаётся ход проводам вниз в розетку. После перехода на модули-картриджи крепление пересчитывается | ⚠️ Частично |
| 3.6 | Вау-дизайн корпуса | Соты, полупрозрачный PETG, подсветка изнутри | Отложено до отладки техники: контур параметрический, форма меняется кодом, печать делает сложный дизайн бесплатным | ⬜ Не начато |
| 3.7 | Узел шести струн на крышке | Основание картриджей 108×190 мм с площадкой ESP32 ставится над розеткой; в крышке — отверстия под его ножки и винты М3, провода датчиков уходят в розетку, ESP и питание — внутри корпуса | Крепление 3.5 считалось под раму AS5600 — пересчитать в `gitara_korpus.py` под гребёнку основания; высота основания над крышкой задаёт положение струн под правой рукой | ⬜ Не начато |
| 3.8 | Тумбы под хребтом не задевают моторы | 6 тумб 16×16 вместо 9: (−18, 540), (−18, 590), (±18, 705), (±18, 775) | Корпуса моторов Ø36.5 глубиной 22 под хребтом v2 врезались в старые тумбы на 3–7 мм. В Д1 столбик помещается только у западной стенки между моторами. В проверку `gitara_korpus.py` добавлены модели моторов. Столы 37–46 пересобраны 13.09.2026, корпус ещё не печатался | ✅ Готово |

## Файлы

* Модели: [gitara_korpus.py](https://github.com/Korvova/gitar/blob/main/2-0/gitara_korpus.py), [gitara_deka.py](https://github.com/Korvova/gitar/blob/main/2-0/gitara_deka.py), [gitara_sec1.py](https://github.com/Korvova/gitar/blob/main/2-0/gitara_sec1.py),
  [gitara_sec2.py](https://github.com/Korvova/gitar/blob/main/2-0/gitara_sec2.py), [gitara_joints.py](https://github.com/Korvova/gitar/blob/main/2-0/gitara_joints.py)
* Сцены Blender: [Гитара_корпус.blend](https://github.com/Korvova/gitar/blob/main/2-0/%D0%93%D0%B8%D1%82%D0%B0%D1%80%D0%B0_%D0%BA%D0%BE%D1%80%D0%BF%D1%83%D1%81.blend), [Гитара_дека.blend](https://github.com/Korvova/gitar/blob/main/2-0/%D0%93%D0%B8%D1%82%D0%B0%D1%80%D0%B0_%D0%B4%D0%B5%D0%BA%D0%B0.blend), [Гитара_стыки.blend](https://github.com/Korvova/gitar/blob/main/2-0/%D0%93%D0%B8%D1%82%D0%B0%D1%80%D0%B0_%D1%81%D1%82%D1%8B%D0%BA%D0%B8.blend)
* Инструкция сборки с картинками: [deka.html](https://raw.githack.com/Korvova/gitar/main/2-0/manual/deka.html) (оглавление всех инструкций — [manual/index.html](https://raw.githack.com/Korvova/gitar/main/2-0/manual/index.html); на GitHub .html показывается исходником, поэтому ссылки через raw.githack)
* Столы печати: 31–47 в [2-0/Print3mf](https://github.com/Korvova/gitar/tree/main/2-0/Print3mf)
* Картинки выше — `wiki/img/`, пересобираются без открытия Blender:
  `blender -b 2-0\Гитара_корпус.blend -P tools\render_scene.py -- wiki\img\korpus.jpg`
