Korvova/gitar/wiki/t-sborka-grif.md

Пошаговая сборка грифа с тележками и деки с моторами — от напечатанных плит до
момента, когда четыре тележки ездят от кривошипов. Порядок повторяет инструкции
`2-0/manual/grif.html` и `deka.html` (там же картинки крупно), а таблица ниже —
чек-лист: статусы проставляются по мере сборки живого экземпляра, уроки — сразу.

Механика: секция-1 (плиты P0–P4, четыре плеча-кулисы, четыре тележки), секции 2 и 3
(жёлоба с П-рейками под ленты, фретборды с ладами на позициях мензуры 650),
хребет-дека (четыре мотора лесенкой, кривошипы пальцем вниз в вилки лент, гребёнки),
корпус (дно, тумбы, обечайка, крышка). Всё на винтах М3 самонарезом, без клея и штифтов.

Секция-1: четыре тележки, спицы по этажам, кривошип у деки

## Что должно быть на руках

| Деталь | Сколько | Стол |
|---|---|---|
| Плиты секции-1: дно P0 (с полкой на юг), межэтажки P1–P3 | 4 | 31 |
| Палуба P4 (канал тележек + лады) | 1 | 32 |
| Плечо-кулиса (диск с дыркой, длинное плечо со штырём вверх, короткое со стадом) | 4 | 32 |
| Спица-голова (лента с кольцом на ступеньке, хвост с защёлкой) | 4 | 32 |
| Тележка-палец с вилкой-пазом на юг | 4 | 32 |
| Дно секции-2 и секции-3, по 4 П-рейки на секцию, фретборды (у секции-3 — с языком) | 1+1, 8, 1+1 | 33, 34 |
| Дно хребта Д1 (3 мотора) и Д2 (1 мотор), кривошипы + втулки своей высоты, гребёнки | 1+1, 4+4, 4 | 35, 36 |
| Ленты: сегменты ext 178 мм (одинаковые) и хвосты с вилкой (4 длины) | 8, 4 | 36 |
| Куски дна корпуса (nw/ne/sw/se), куски крышки (wn/ws/en/es), 7 лент обечайки | 4, 4, 7 | 37–46 |
| Моторы ×4, TMC2209 ×4, ESP32, PD-триггер 20 В, конденсатор 470 мкФ/50 В | покупное | — |
| Винты М3: 6 × 30 (стопка секции-1), 14 × 10 (фретборды), 8 × 8 (стыки секций), 16 × 6–8 (моторы), 9 × 8 (тумбы), 24 × 4 (стыки кусков), 12 × 8 (крышка и язык), ~68 × 5 (обечайка) | | набор |

Печать: столы 33, 34, 35, 36, 39, 40, 41, 43 — с поддержками «только от стола»
(стыковые полки нависают 1.5 мм), остальное без поддержек.

## Шаги

| Номер | Шаг | Что делаем | Урок | Статус |
|---|---|---|---|---|
| С1 | Секция-1, этаж 0 | Дно P0 полкой на юг. На стад оси — плечо-0 диском, длинное плечо на юг, штырь вверх. На стад короткого плеча — спицу-0 кольцом: тело в жёлоб, хвост с защёлкой на юг за край | Покрутить плечо пальцем — спица ездит вдоль жёлоба; так работает каждый этаж | ✅ Готово |
| С2 | Этажи 1–3, стопка | Межэтажка P1: штырь плеча-0 — в её дуговую прорезь; на стад P1 — плечо-1 и спицу-1. Так же P2 и P3. Каждая прорезь пропускает все нижние штыри | Плита не ложится плоско — штырь упёрся в плиту, а не вошёл в прорезь | ✅ Готово |
| С3 | Палуба и тележки | Палуба P4 ладами вверх; 4 штыря выходят в общий канал; тележки **вилками на север** (к оси плеча) — каждая на свой штырь; 6 винтов М3×30 через приливы (3 пары) | Потолок этажа прижимает плечо и кольцо спицы — вертикальные замки стенда здесь не нужны. Подвигать спицу за хвост — тележка едет поперёк. Физика 09.09: штырь на краю хода уходит по дуге к оси на 4–5 мм, вилкой на юг ему остаётся 0.5 мм — клинит | ✅ Готово |
| С4 | Секции 2 и 3, рейки | В дно каждой секции стопкой 4 П-рейки жёлобом вверх: подошва следующей закрывает жёлоб предыдущей | Ленты пока не класть — протягиваются на общей сборке снизу вверх (Д7) | ⬜ Не начато |
| С5 | Фретборды | На каждую секцию фретборд ладами вверх, 7 винтов М3×10 (4 в стенки жёлоба, 3 вдоль западного борта). Язык секции-3 не прикручивать — он уйдёт в окно крышки | Позиции винтов подобраны между ладами, нарезаются сами | ⬜ Не начато |
| С6 | Стыки секций | Полка юга нижней секции под вырез севера следующей («бутерброд»), 4 канала совпадают, 4 винта М3×8 снизу на стык. Гриф из трёх секций готов, хвосты спиц торчат на юг | Поправка 13.09.2026 (проверка по STL): стык толщиной 3 мм, отверстие X = +5 у края прохода ленты — ставить 3 × М3×4 в X = −21, −9, +21, а X = +5 оставить пустым; М3×8 вышел бы в ленту этажа 0 на 5 мм. Порядок — в [гриф с моторами](/homepage/iniciativa.-razrabotka/jepik-ruka-gitara/t-instrukcija-grif) | ⬜ Не начато |
| Д1 | Моторы в хребет | Дно хребта перевернуть, мотор валом вверх в колодец, 4 винта М3 сквозь дно во фланец 31×31, провода на запад | Колодцы деки сейчас под NEMA17 (Ø22 пилот); если остаёмся на NEMA14 — колодцы пересчитать | ⬜ Не начато — хребет v2 под моторы Ø36 спроектирован и проверен симуляцией (столы 66–68), порядок — этап Г в [гриф с моторами](/homepage/iniciativa.-razrabotka/jepik-ruka-gitara/t-instrukcija-grif) |
| Д2 | Втулки и кривошипы | На вал втулку своей высоты (подписать при печати!), сверху кривошип D-отверстием на лыску, пальцем вниз | Ближний к грифу мотор — этаж 0 (нижняя лента), дальний — этаж 3 | ⬜ Не начато |
| Д3 | Гребёнки | 4 гребёнки штырями в ямки дна между моторами — держат ленты по высоте на пролётах | | ⬜ Не начато |
| Д4 | Дно корпуса | 4 куска в восьмёрку тумбами вверх, стыки полкой под соседа, 10 винтов М3×4 снизу | Изнутри дно гладкое, дырки только под гитарой | ⬜ Не начато |
| Д5 | Хребет на тумбы | Д1+Д2 бутербродом 4×М3; хребет на 9 тумб, 9 винтов М3×8 сверху. Электроника — на стойки на западе хребта или на дно рядом | Моторам до дна ~18 мм | ⬜ Не начато |
| Д6 | Стыковка с грифом | Полка юга секции-3 под вырез севера Д1, 4 винта М3×8 снизу | | ⬜ Не начато |
| Д7 | Ленты по этажам | Цепочка голова → ext → ext → хвост с вилкой, стыки — взаимные защёлки на переходах секций. Снизу вверх по одному этажу: ext в секцию-2, защёлкнуть с головой; ext в секцию-3; хвост в хребет, вилку под кривошип своего мотора | Крутить кривошип пальцем — тележка этажа ездит. Прогнать все четыре до крышки! Высокий штырёк стыка торчит над лентой — потолок щели не даст расцепиться | ⬜ Не начато |
| Д8 | Обечайка | 7 сегментов PETG по кругу, начиная с проёма под пятку грифа; М3×5 в радиальные каналы нижнего ряда | Талия R~100 — гнуть плавно; упирается — ослабить соседние винты | ⬜ Не начато |
| Д9 | Крышка и язык | 4 куска крышки бутербродом (14 × М3×4 снизу); крышка на корпус, язык фретборда в окно на бобышки: 2 × М3×8 сквозь язык в хребет, 10 × М3×8 по краям окна, верхний ряд обечайки М3×5 | Крышка снимается целиком — полный доступ к механике | ⬜ Не начато |
| Э1 | Электрика стенда | PD-триггер 20 В → VM всех TMC2209, конденсатор 470 мкФ на VM/GND у клемм; ток 700 мА, SpreadCycle; ESP32: STEP 25, DIR 26, EN 27, UART TMC RX 16 / TX 17 (текущая `drive_web.ino` — один канал) | Прошивка на четыре канала — см. [Т. Электроника](/homepage/iniciativa.-razrabotka/jepik-ruka-gitara/t-elektronika) 4.13 и [Т. План](/homepage/iniciativa.-razrabotka/jepik-ruka-gitara/t-plan) | ⬜ Не начато |
| П1 | Проверка руками | Плечо ходит во всём секторе, штырь не цепляет прорези; тележки без закусывания на всех 40 мм; спицы не выпрыгивают со стадов; кривошипы свободны, палец не выскакивает из вилки; стыки лент заподлицо; ленты не цепляют гребёнки и чужие диски; хребет не качается; тележки ездят одинаково без крышки и с крышкой | Если трёт — капля силиконовой смазки с PTFE на стады и в канал тележек | ⬜ Не начато |

## Картинки шагов

Секция-1: этаж 0 → стопка → палуба и тележки; секции 2–3: рейки → фретборды.

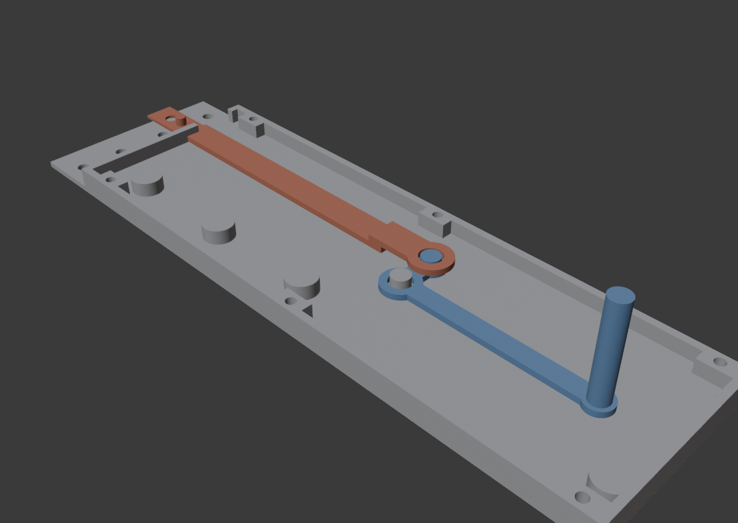
[picture p189: 2-0/manual/img/grif_step1.png]
С1 — этаж 0

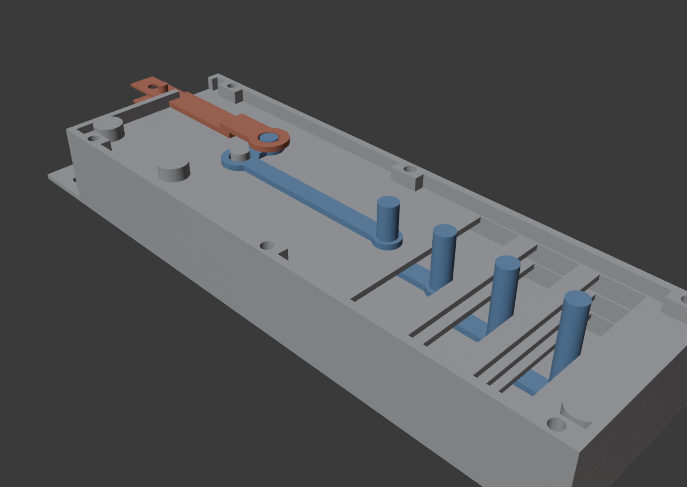
[picture p190: 2-0/manual/img/grif_step2.png]
С2 — стопка этажей

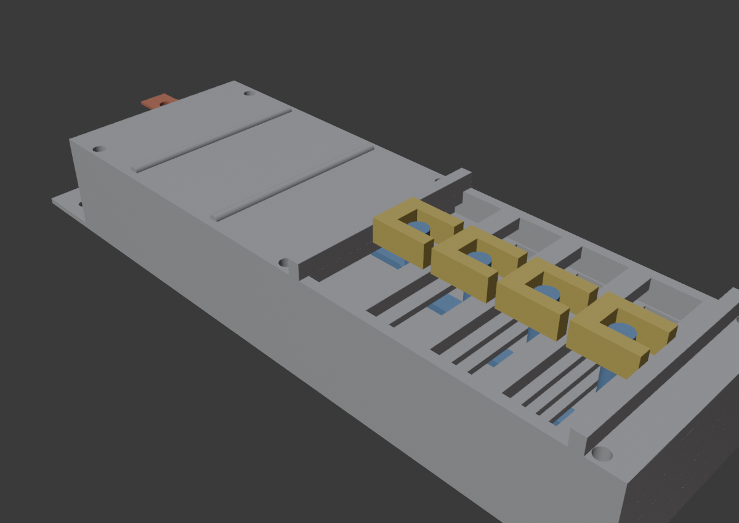
[picture p191: 2-0/manual/img/grif_step3.png]
С3 — палуба и тележки

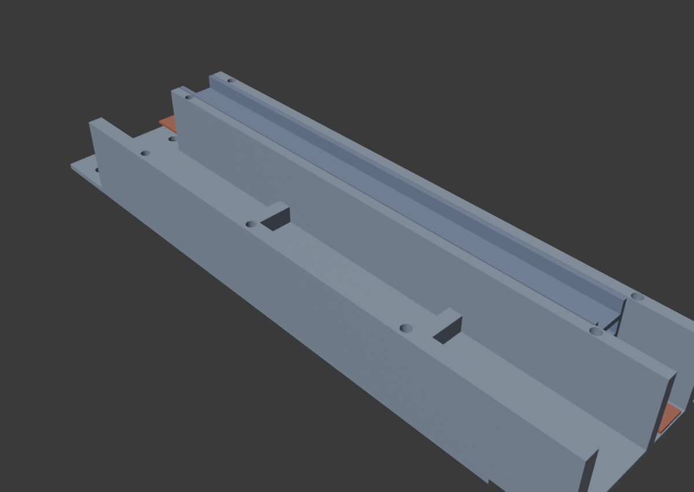
[picture p192: 2-0/manual/img/grif_step4.png]
С4 — рейки в дно секции

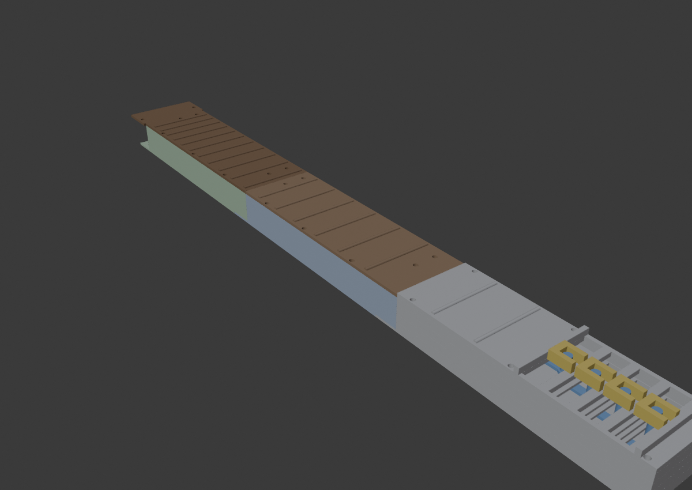
[picture p193: 2-0/manual/img/grif_step5.png]
С5 — фретборды


Дека и корпус: кривошипы → дно → хребет на тумбы → ленты → обечайка → крышка.

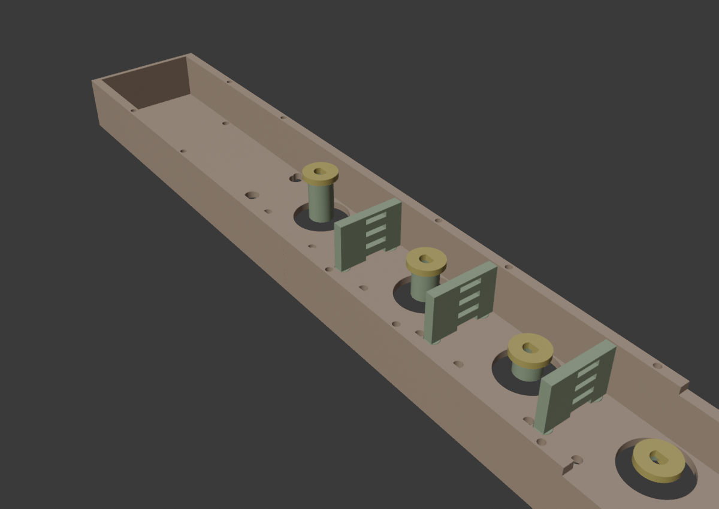
[picture p194: 2-0/manual/img/deka_step1.png]
Д2 — втулки и кривошипы

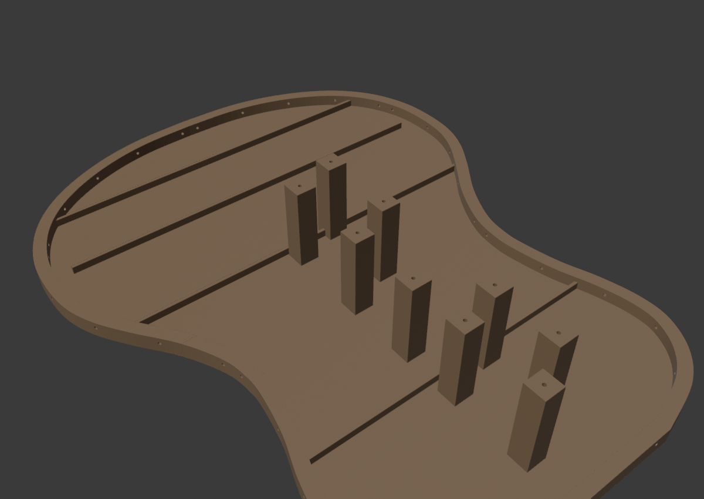
[picture p195: 2-0/manual/img/deka_step2.png]
Д4 — дно корпуса

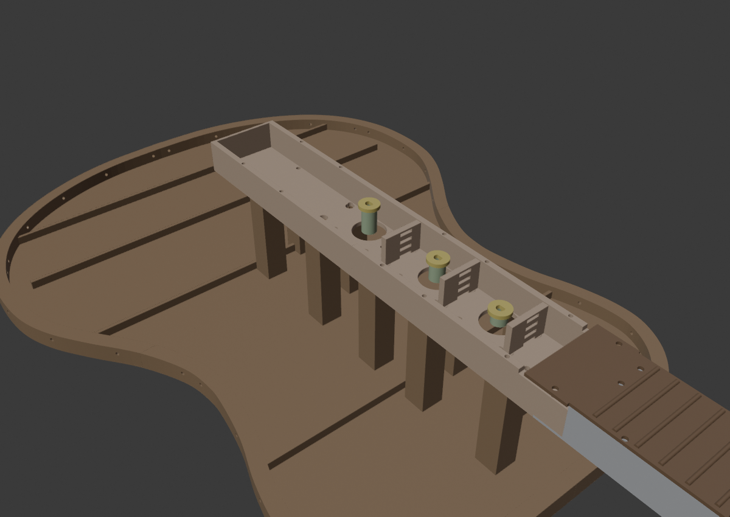
[picture p196: 2-0/manual/img/deka_step3.png]
Д5 — хребет на тумбы

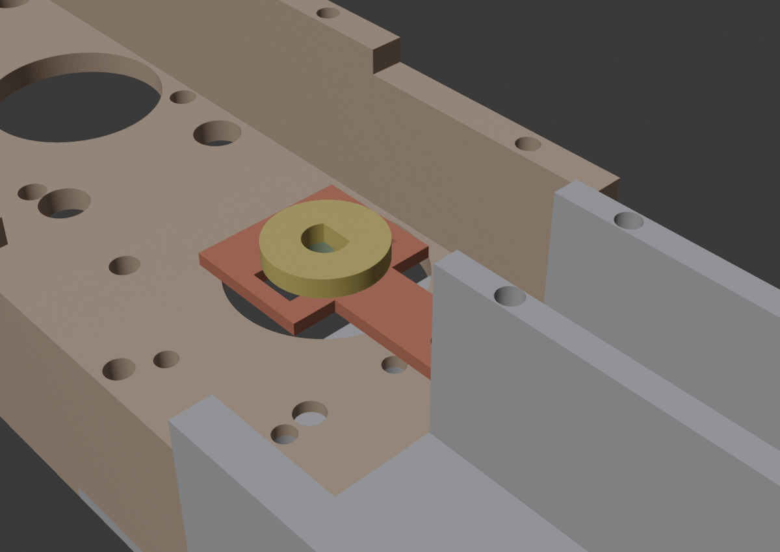
[picture p197: 2-0/manual/img/deka_step4.png]
Д7 — ленты по этажам

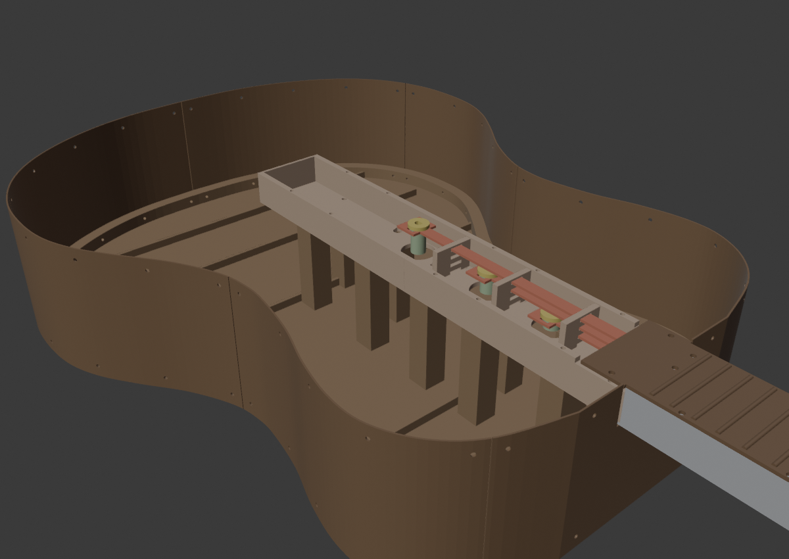
[picture p198: 2-0/manual/img/deka_step5.png]
Д8 — обечайка

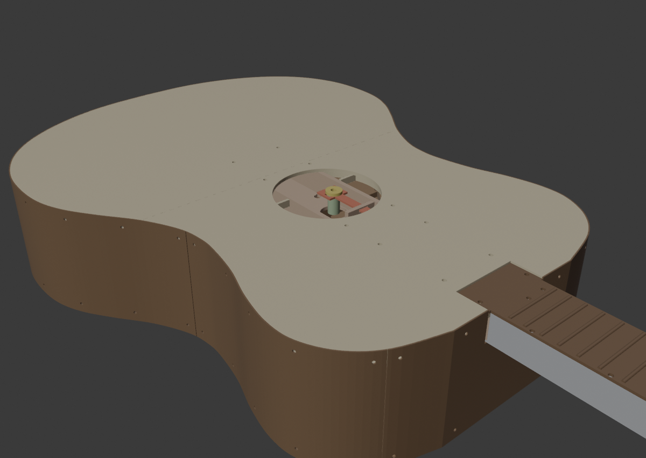
[picture p199: 2-0/manual/img/deka_step6.png]
Д9 — крышка и язык


## Файлы

* Инструкции с картинками крупно: [grif.html](https://raw.githack.com/Korvova/gitar/main/2-0/manual/grif.html), [deka.html](https://raw.githack.com/Korvova/gitar/main/2-0/manual/deka.html), стенд одной станции — [palka.html](https://raw.githack.com/Korvova/gitar/main/2-0/manual/palka.html)
* Модели: [gitara_sec1.py](https://github.com/Korvova/gitar/blob/main/2-0/gitara_sec1.py), [gitara_sec2.py](https://github.com/Korvova/gitar/blob/main/2-0/gitara_sec2.py), [gitara_deka.py](https://github.com/Korvova/gitar/blob/main/2-0/gitara_deka.py), [gitara_korpus.py](https://github.com/Korvova/gitar/blob/main/2-0/gitara_korpus.py)
* Столы печати 31–47 в [2-0/Print3mf](https://github.com/Korvova/gitar/tree/main/2-0/Print3mf); столы 31/32 после 09.09 — STL с прорезями ±24.5 (3MF не пересобраны: на второй машине нет Bambu Studio)
* Физика четырёх станций: [gitara_physics4.py](https://github.com/Korvova/gitar/blob/main/2-0/gitara_physics4.py), ручные сцены `2-0/Гитара_физика4_ручная_*.blend` + аддон [gitar_stend4_addon.py](https://github.com/Korvova/gitar/blob/main/2-0/gitar_stend4_addon.py) (N-панель «Стенд»)
