Korvova/gitar/wiki/t-instrukcija-sborki.md

Как собрать гриф руками: по шагам, с картинкой на каждый шаг, какие файлы печатать и
какими винтами крутить. Страница для стола, а не для проектирования: чек-лист всего
устройства с уроками живёт в [Т. Сборка гриф](/homepage/iniciativa.-razrabotka/jepik-ruka-gitara/t-sborka-grif),
здесь только «что взять в руки и куда поставить». Картинки нарисованы с настоящих STL
(`2-0/render_sborka_a.py`), поэтому положение каждой детали на них точное.

Следующий этап — секции 2 и 3 с лентами и хребет с моторами — в [Т. Инструкция по сборке: гриф с моторами](/homepage/iniciativa.-razrabotka/jepik-ruka-gitara/t-instrukcija-grif).

Оси: Y вдоль грифа, порожек = 0, дека = 160. «Юг» — сторона деки, «север» — сторона
порожка. X поперёк, Z вверх.

## Этап А: две станции без моторов

Цель этапа: собрать стопку P0 + P1 + P4 со станциями 0 и 1 и убедиться руками, что
тележки ездят на ~40 мм. Моторы не нужны: спицу двигаем за хвост пальцами.
Это самый нагруженный случай — нижний этаж с самым длинным штырём (25 мм).

### Что должно лежать на столе

| Деталь | Файл STL | Стол | Сколько |
|---|---|---|---|
| Дно P0 (с полкой на юг) | `gs1_p0_base.stl` | 31 | 1 |
| Межэтажка P1 | `gs1_p1_mid.stl` | 31 | 1 |
| Палуба P4 (канал тележек, лады) | `gs1_p4_deck.stl` | 32 | 1 |
| Плечо 0 (штырь длиннее) и плечо 1 | `gs1_arm0.stl`, `gs1_arm1.stl` | 32 | 1 + 1 |
| Спица 0 (длиннее) и спица 1 | `gs1_spica0.stl`, `gs1_spica1.stl` | 32 | 1 + 1 |
| Тележка | `gs1_cart.stl` | 32 | 2 |
| Купон посадок: пластина с отверстиями и стад-щуп | `gs1_kupon.stl`, `gs1_kupon_stud.stl` | 65 | 1 + 1 |
| Винты М3×14 (или 16) | — | — | 6 |
| Силиконовая смазка с PTFE | — | — | капля на стад |

Винты: стопка этапа А всего 15 мм высотой, поэтому М3×30 из полного комплекта
вылезет снизу на 15 мм. Резьбу винт нарезает сам в дне P0 (отверстия Ø2.6), в P1 и
палубе отверстия проходные Ø3.2.

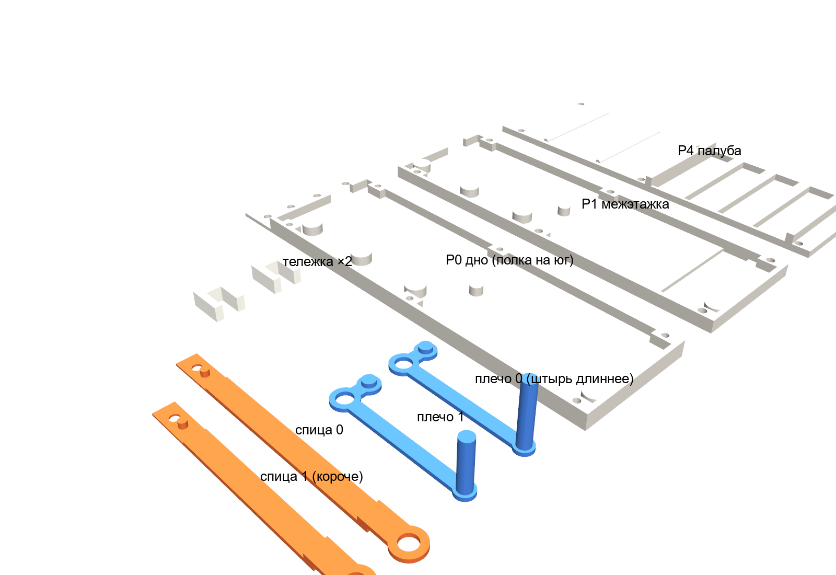
[picture p200: wiki/img/sborka_a_0_detali_v2.png]
Детали этапа А


Как отличить плечи и спицы: у плеча 0 штырь длиннее (он идёт с самого нижнего этажа
до тележки), у спицы 0 тело длиннее (её ось дальше от деки). Если сомневаешься —
приложи друг к другу.

### Шаг 0. Купон посадок (15 минут печати, до стола 32)

Все посадки Ø5 в механике плотные: стад в диске плеча, стад в кольце спицы, штырь в
пазу тележки. Было Ø6 с люфтом 0.5 мм, и этот люфт съедал 5 мм хода тележки
(MuJoCo, 11.09). Реальный размер зависит от принтера, поэтому первым печатается
купон из двух деталей: пластина с отверстиями
(верхний ряд 5.0 / 5.1 / 5.2 / 5.3, нижний ряд 5.8 / 5.9 / 6.0 / 6.1 под подшипники
MR63 на будущее) и отдельный стад-щуп Ø5 на шайбе, такой же, как стады на плитах.
Риски на кромке: одна риска — первый размер, четыре — четвёртый.

Что делаем: вставляем щуп в каждое отверстие верхнего ряда. Нужно то, в которое стад
входит без молотка, но без ощутимого качания и крутится пальцем. Этот диаметр
записываем в `FIT_D` в `gitara_sec1.py`, перегенерируем стол 32
(`python make_3mf.py 32`) и только потом печатаем механику.

**Результат купона на принтере владельца (12.09.2026): подошло 5.1** — две риски,
верхний ряд. `FIT_D = 5.1` уже стоит в генераторе, стол 32 пересобран под него, так
что на этом принтере купон повторять не нужно. Порог проверки сборки ослаблен до
0.01 мм: радиальный зазор посадки стал 0.05 мм, и фасеты STL съедают его почти
в ноль. Купон пригодится снова при смене принтера, сопла или материала.

Смазка: капля силиконовой с PTFE на стад оси и стад спицы при сборке, PETG по PETG
без смазки на плотной посадке подклинивает.

> **Заметка для ИИ-ассистента (порядок при повторном купоне).** Владелец печатает купон
> и говорит, какое отверстие верхнего ряда подошло (по рискам: 1 = 5.0, 2 = 5.1, 3 = 5.2,
> 4 = 5.3). Что сделать:
> 1. В `2-0/gitara_sec1.py` константа `FIT_D` (сейчас 5.1) — поставить выбранный диаметр.
>    Она задаёт три отверстия под стад/штырь Ø5: дырка оси в диске плеча, кольцо спицы,
>    паз вилки тележки (паз = FIT_D + 0.1). Если посадка «между» двумя размерами —
>    брать больший, люфт 0.1 лучше клина, смазка есть.
> 2. Запустить `gitara_sec1.py` из окружения с build123d (на машине владельца venv
>    `.venv-b123d`, см. страницу «Архитектура и стек»). Он экспортирует STL в
>    `2-0/Print/Print` и делает проверку сборки (`clearance.py`, нужен python-fcl; пары
>    «посадка» с глубиной 999 — заглушка старой версии fcl, не ошибка).
> 3. `python 2-0/make_3mf.py 32` — пересобрать стол 32 (палуба + плечи + спицы + тележки).
>    Стол 31 (плиты) от FIT_D не зависит, его не трогать.
> 4. Закоммитить `gitara_sec1.py`, STL `gs1_*` и `32_gitara_sec1_meh.3mf`, запушить, и
>    обновить статус строки И0.5 в таблице внизу этой страницы (какой диаметр выбран).
> Нижний ряд купона (5.8–6.1) — под запрессовку подшипников MR63ZZ 3×6×2.5, это отдельный
> вариант плеч и спиц на будущее (строка И1), сейчас механика без подшипников.

### Шаг 1. Дно P0 и плечо 0

Дно кладём полкой на юг (полка — тонкий язык 18 мм за стенкой, это будущий стык с
секцией-2). Плечо 0 диском на стад оси (столбик Ø5 на дне у Y = 70), длинным плечом
на север, штырём вверх. Короткое плечо со стадом смотрит в жёлоб, к борту X = +10.

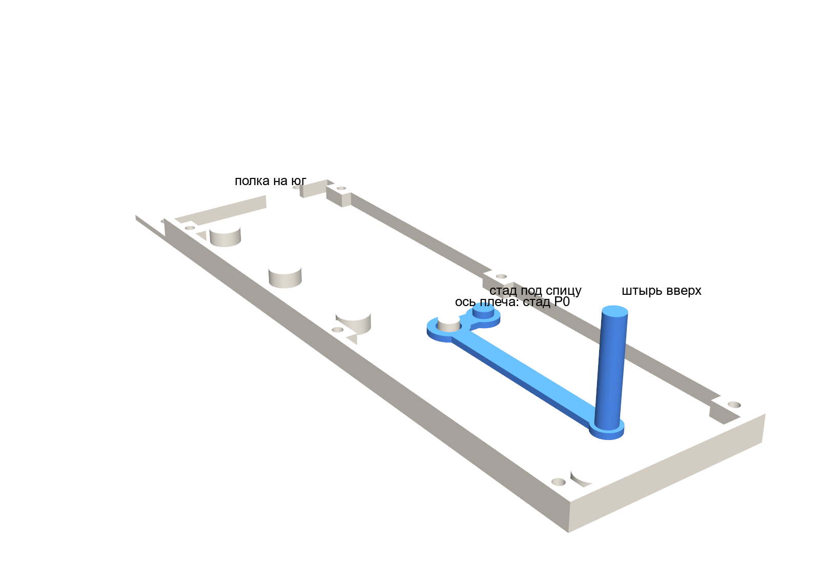
[picture p201: wiki/img/sborka_a_1_plecho0_v2.png]
Шаг 1: плечо 0 на дне


Проверка: плечо крутится на стаде пальцем без усилия, диск лежит на дне плоско.

### Шаг 2. Спица 0

Спица 0 кольцом на стад короткого плеча. Кольцо приподнято на ступеньке: оно ложится
поверх плеча, а тело спицы ложится на пол жёлоба и уходит на юг. Хвост с защёлкой
выходит за южную стенку наружу — за него потом будем двигать.

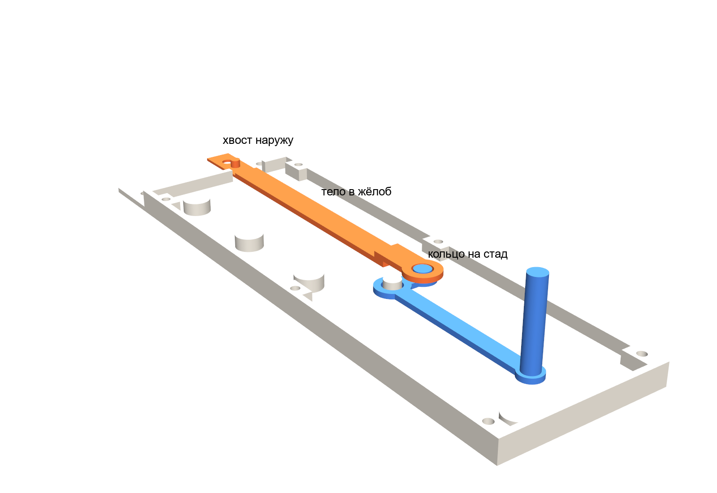
[picture p202: wiki/img/sborka_a_2_spica0_v2.png]
Шаг 2: спица 0 на стаде плеча


**Если плиты напечатаны до 11.09.2026** (первый стол 31): южная стенка P0 и P1 перекрывает
жёлоб на 4 мм — проход в стенке был x 10…22 от старого жёлоба, а спица идёт по x 6…14.
Рендер этой страницы это и показал. Лечится ножом: вырезать в южной стенке участок
x 4…10 на всю высоту стенки (6 мм в длину, 2 мм толщина). В генераторе и столе 31
исправлено, следующие плиты печатаются с правильным проходом x 4…16.

Проверка: тянем хвост на себя и от себя на 3–4 мм — плечо качается, штырь описывает
дугу поперёк грифа. Если спица подпрыгивает с стада — ничего страшного, её прижмёт
потолок следующей плиты.

### Шаг 3. Межэтажка P1, плечо 1, спица 1

Плиту P1 опускаем сверху так, чтобы штырь плеча 0 вошёл в её дуговую прорезь у
Y = 18. Плита должна лечь на стенки P0 плоско; если стоит на 5 мм выше — штырь упёрся
в плиту рядом с прорезью, чуть повернуть плечо. На стад P1 (Y = 86) ставим плечо 1,
на его стад — спицу 1, всё точно так же, как на этаже 0.

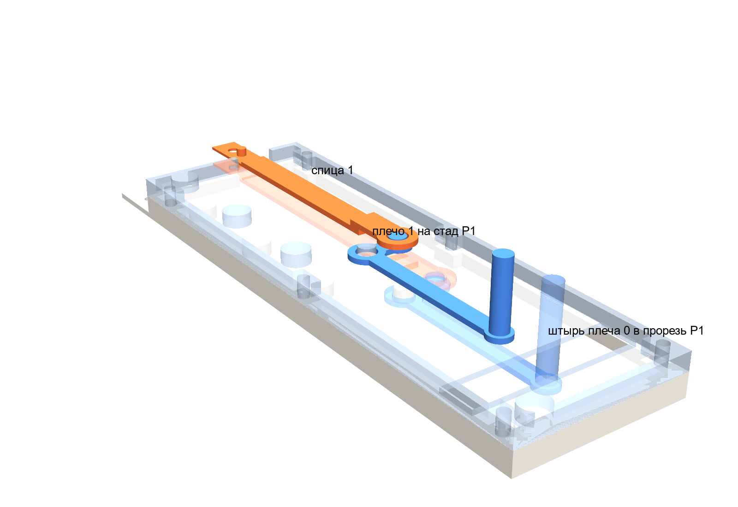
[picture p203: wiki/img/sborka_a_3_p1_v2.png]
Шаг 3: P1 со своей станцией


Проверка: оба хвоста двигаются независимо, штырь плеча 0 ходит в прорези P1 от края
до края, не задевая её концов.

### Шаг 4. Палуба P4 и тележки

Палуба ладами вверх, оба штыря выходят через её прорези в общий канал между бортами.
Тележки надеваем на штыри **вилкой на север**, к оси плеча: штырь на краю хода уходит
по дуге на 4 мм к северу, и с вилкой на юг ему не хватает места (урок физики 09.09).
Тележка 0 — на штырь у Y = 18, тележка 1 — у Y = 34.

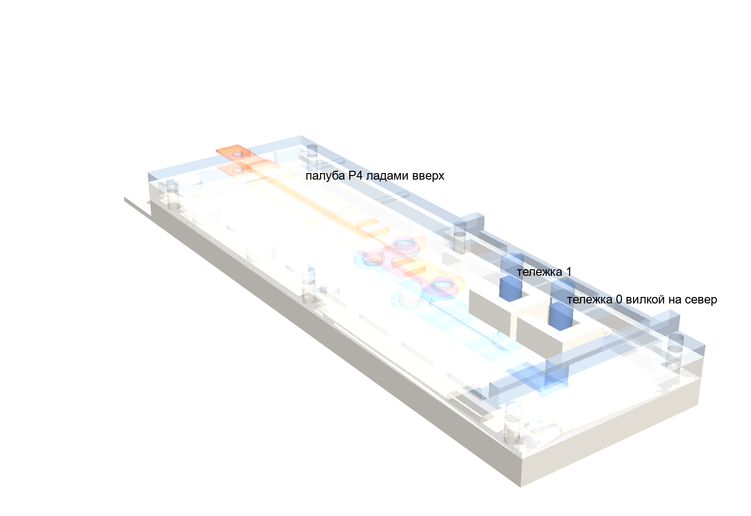
[picture p204: wiki/img/sborka_a_4_paluba_v2.png]
Шаг 4: палуба и тележки


### Шаг 5. Стянуть стопку

Шесть винтов М3 сверху через приливы палубы: три пары по бортам у Y = 6, 80, 150.
Закручивать по кругу, не до упора сразу: после всех шести — дотянуть. Стопка должна
остаться плоской, а хвосты спиц — свободными.

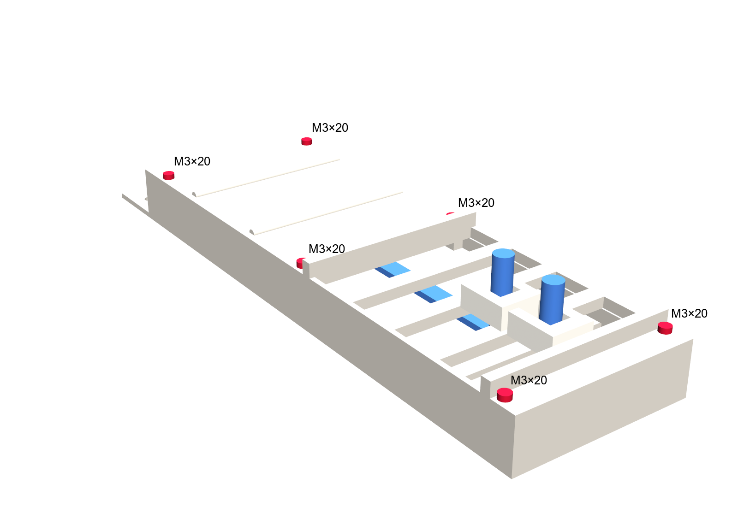
[picture p205: wiki/img/sborka_a_5_vinty_v2.png]
Шаг 5: шесть винтов М3


### Шаг 6. Проверка руками

Двигаем хвост спицы 0 на ±4 мм. Плечо качается на ±22°, тележка 0 едет поперёк грифа
примерно на ±20 мм. То же для станции 1.

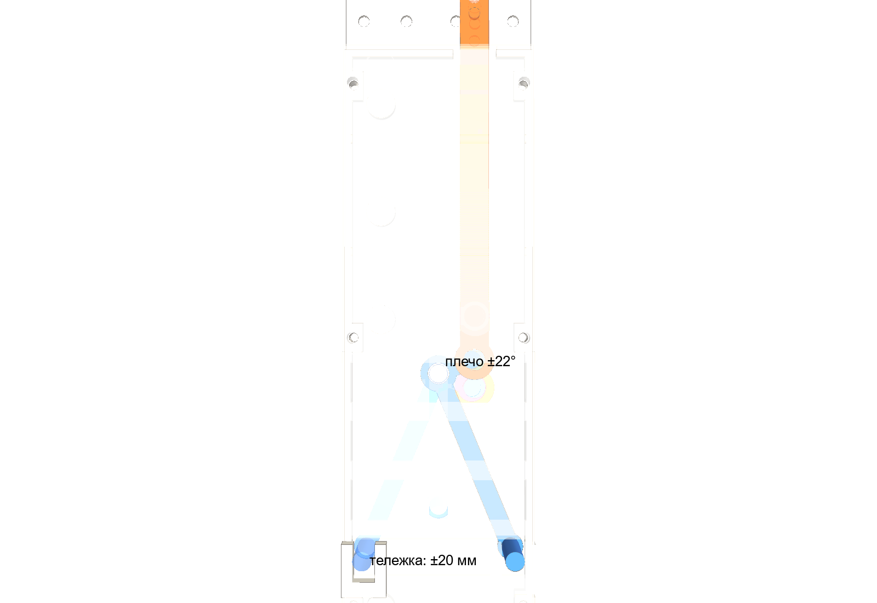
[picture p206: wiki/img/sborka_a_6_proverka_v2.png]
Шаг 6: ход тележки


Что записать в [Т. План](/homepage/iniciativa.-razrabotka/jepik-ruka-gitara/t-plan) (результат этапа А):

| Что смотрим | Норма | Если не так |
|---|---|---|
| Ход тележки | 34–40 мм от края до края | меньше 30: люфт в кольце спицы или в вилке, смотри заметку ниже про подшипники |
| Штырь в прорезях | не касается концов прорезей P1 и палубы | прорези ±24.5 — если бьёт, плечо стоит не на своём стаде |
| Тележка в канале | едет ровно, не закусывает | перекос — вилка стоит на юг, перевернуть |
| Спица | не вылезает из жёлоба, не спрыгивает со стада | потолок плиты должен прижимать кольцо; зазор больше 0.4 — плита не села |
| Усилие | плечо ходит от лёгкого нажатия на хвост | если туго — капля силиконовой смазки на стад и в канал |

**Результат (13.09.2026): собрано и проверено руками.** Плечи ходят свободно, тележки двигаются от хвостов спиц, клинов нет. Посадки Ø5.1 по купону и смазка сработали.

## Этап Б: полная стопка из четырёх станций

То же самое ещё два раза: после P1 — межэтажка P2 со станцией 2 (стад Y = 102), потом
P3 со станцией 3 (Y = 118), и только потом палуба с четырьмя тележками. Каждая прорезь
плиты пропускает все нижние штыри, поэтому плиты опускаются строго сверху, а не
заводятся сбоку. Винты — М3×30 (стопка 26 мм). Детали: `gs1_p2_mid`, `gs1_p3_mid`
(стол 31), `gs1_arm2/3`, `gs1_spica2/3`, ещё две тележки (стол 32).

**Результат (13.09.2026): полная стопка из четырёх станций собрана, все четыре плеча и тележки ходят хорошо.** Дальше — [Т. Инструкция по сборке: гриф с моторами](/homepage/iniciativa.-razrabotka/jepik-ruka-gitara/t-instrukcija-grif).

Порядок и уроки по остальным узлам — секции 2–3, дека с моторами, ленты по этажам,
корпус — в [Т. Сборка гриф](/homepage/iniciativa.-razrabotka/jepik-ruka-gitara/t-sborka-grif),
шаги С4–Д9, и в инструкциях с картинками
[grif.html](https://raw.githack.com/Korvova/gitar/main/2-0/manual/grif.html) и
[deka.html](https://raw.githack.com/Korvova/gitar/main/2-0/manual/deka.html).

## Файлы для печати

| Стол | Что на нём | Настройки | Статус |
|---|---|---|---|
| [65_kupon_posadok.3mf](https://raw.githubusercontent.com/Korvova/gitar/main/2-0/Print3mf/65_kupon_posadok.3mf) | купон посадок Ø5 и Ø6 | 0.2 мм, печатать первым | ✅ Напечатано |
| [31_gitara_sec1_plity.3mf](https://raw.githubusercontent.com/Korvova/gitar/main/2-0/Print3mf/31_gitara_sec1_plity.3mf) | P0, P1, P2, P3 | 0.2 мм, без поддержек | ✅ Напечатано |
| [32_gitara_sec1_meh.3mf](https://raw.githubusercontent.com/Korvova/gitar/main/2-0/Print3mf/32_gitara_sec1_meh.3mf) | палуба P4, 4 плеча, 4 спицы, 4 тележки — **посадки Ø5.1 (по купону 12.09.2026)** | 0.12 мм, брим на штыри плеч | ✅ Напечатано |
| [33_gitara_sec2.3mf](https://raw.githubusercontent.com/Korvova/gitar/main/2-0/Print3mf/33_gitara_sec2.3mf), [34_gitara_sec3.3mf](https://raw.githubusercontent.com/Korvova/gitar/main/2-0/Print3mf/34_gitara_sec3.3mf) | секции 2 и 3: дно, 4 П-рейки, фретборд, планка-потолок — **у фретборда плоское дно (13.09.2026), под ним поддержки не нужны** | поддержки только от стола | ✅ Напечатано |
| [35_gitara_deka1.3mf](https://raw.githubusercontent.com/Korvova/gitar/main/2-0/Print3mf/35_gitara_deka1.3mf), [36_gitara_deka2.3mf](https://raw.githubusercontent.com/Korvova/gitar/main/2-0/Print3mf/36_gitara_deka2.3mf) | хребет деки (колодцы под NEMA17), кривошипы, гребёнки, ленты | поддержки только от стола | ✅ Напечатано — хребет с моторами ждёт перепроектирования, см. [гриф с моторами](/homepage/iniciativa.-razrabotka/jepik-ruka-gitara/t-instrukcija-grif) |

Все STL по отдельности — в [2-0/Print/Print](https://github.com/Korvova/gitar/tree/main/2-0/Print/Print).
Столы открывать в Bambu Studio «как проект». Пластик PETG HF.

## Что поменять перед следующей печатью

Из MuJoCo-симуляции привода (`2-0/mujoco_palka.py`, 11.09.2026): нынешняя геометрия
даёт ход тележки 28 мм, не 40. Причина не трение (мотор нагружен на 3 %), а люфты
Ø5/Ø6 в кольце спицы и вилке. Что закрывает вопрос до 40 мм:

| Номер | Изменение | Где | Статус |
|---|---|---|---|
| И0 | Южная стенка плит P0–P3: проход под жёлоб x 4…16 вместо 10…22 (старый жёлоб 11…21; спица упиралась в стенку). В проверку сборки добавлена пара «спица — своя плита» | `gitara_sec1.py` walls(), стол 31 перегенерирован | ✅ Готово |
| И0.5 | Посадки Ø5 плотные (вместо Ø6): диск плеча, кольцо спицы, паз тележки; купон посадок `gs1_kupon`, стол 65. Решение владельца: пока без подшипников, плотно + смазка. **Купон напечатан 12.09.2026, подошло 5.1 — `FIT_D = 5.1`, стол 32 пересобран** | `gitara_sec1.py`, столы 32 и 65 | ✅ Готово |
| И1 | Подшипник MR63ZZ 3×6×2.5 (вариант на потом, когда приедут): в паде короткого плеча отверстие Ø6.1 с бортиком 0.4, штифт Ø3; ступень спицы от 3.6 мм от центра кольца; отдельные файлы плеч и спиц, плиты не меняются | `gitara_sec1.py` плечи, спицы | ⬜ Не начато |
| И2 | Палец кривошипа r5.0 вместо 4.3, паз вилки ленты ±8.5 вместо ±7.5 | `gitara_deka.py` кривошипы, хвосты | ⬜ Не начато |
| И3 | Подшипник на штыре в вилку тележки — тоже MR63 (693 Ø8 задевает борт канала на станции 3); закрытый торец вилки отодвинуть на 1 мм | `gitara_sec1.py` тележка, плечи | ⬜ Не начато |
| И4 | Колодцы деки под NEMA14 36STH17: пилот Ø16.1×1.5, 2×М3 на 43.85; ступица кривошипа — звёздочка на шестерне m0.5 z10 | `gitara_deka.py` | ⬜ Не начато |
| И5 | Купон посадки подшипника Ø6: отверстия 5.9 / 6.0 / 6.1 / 6.2 — напечатать до столов | новый купон | ⬜ Не начато |
