Korvova/gitar/wiki/t-marketing.md

https://www.youtube.com/shorts/J1KYnqHHIYg

&nbsp;

https://www.youtube.com/watch?v=g9YFGtB8ZUA 

&nbsp;

&nbsp;

&nbsp;

Он не умеет главного — сделать из покупателя гитариста. Статистика жанра беспощадна: подавляющее большинство дешёвых «гитар для начинающих» через месяц стоят в углу, потому что дальше начинается настоящая цена обучения:

&nbsp;

Аналогия, которая всё ставит на место: беговая дорожка за 30к не боится кроссовок за 3к. Кроссовки — инвентарь, дорожка — процесс. Ты продаёшь процесс.

&nbsp;

И тогда сравнивать его будут не с JOOL за 12к, а с полугодом занятий за 80к — и сравнение ты выигрываешь с разгромным счётом.

&nbsp;

#|
||

Номер

|

Требования

|

Описания

|

Урок

||
||

|

|

|

||
||

|

|

|

||
|#

&nbsp;
