Korvova/gitar/wiki/t-struny.md

Узел правой руки: шесть печатных струн, каждая со своим датчиком. Устройство видит
щипок, его силу, направление (вниз/вверх) и статику — струну можно отклонить и
удерживать. Собран и проверен вживую: «работает прям ваще как надо» (сентябрь 2026).

Конструкция после переосмысления — шесть независимых модулей-картриджей. Каждый
модуль: планка 12×175 мм с интегрированными столбиками и гнездом датчика, палка-моноблок
(пружина-гармошка + струна + пружина одной деталью), обойма с магнитом на шплинте.
Модули прикручиваются к общему основанию двумя винтами М3 каждый.

## Требования

| Номер | Требование | Описание | Урок | Статус |
|---|---|---|---|---|
| 1.1 | Шесть струн с шагом как на классической гитаре | Шаг 12 мм, крайние струны разнесены на 60 мм | На классике между соседними струнами у бриджа 11.7–12 мм — правая рука узнаёт расстояние | ✅ Готово |
| 1.2 | Струна пружинит как настоящая | Печатная пластина 2×10×100 мм на двух пружинах-гармошках | Подтверждено на стенде: «пружинит как настоящая струна» | ✅ Готово |
| 1.3 | Датчик видит щипок, силу и направление | Магнит Ø4.1×2.1 мм над датчиком, зазор ~2.5 мм | Потенциометр ALPS не работает: гибкая струна изгибается по длине, а ось у основания не поворачивается | ✅ Готово |
| 1.4 | Датчик дешёвый и без лишней обвязки | Линейный холл 49E (SS49E) прямо в ADC ESP32, ~15 ₽ | Замена AS5600 (≈250 ₽ + мультиплексор). Шум ADC давится усреднением 4–16 замеров, конденсатор не понадобился | ✅ Готово |
| 1.5 | Струны независимы, меняются по одной | Модуль-картридж: планка + палка + обойма + датчик | Общая рама на 6 плат AS5600 давала жгут из 30 проводов и не давала настраивать струны по отдельности | ✅ Готово |
| 1.6 | Щипок одной струны не звучит на соседних | Чередование жёсткости пружин: 0.8 / 0.6 / 0.7 мм по кругу | На общей раме все струны имели одну резонансную частоту — рама перекачивала энергию, программный гейт по громкости не помогал, так как амплитуды равны | ⚠️ Частично |
| 1.7 | Крепление датчика без клея | Туннель в планке: 49E вдвигается сбоку плашмя, надписью вверх, ножки вниз через прорезь | Магнит и датчик держатся печатной геометрией — в серии заменится платой | ✅ Готово |
| 1.8 | Фиксация проводов | Вставка-пробка в прорезь: провода проходят свободно, жгут не выдёргивается | Вставка на 1 мм уже прорези — вокруг остаётся щель, изоляция не пережимается | ✅ Готово |
| 1.9 | Основание под шесть модулей | Гребёнка 108×190 мм: две балки, окно проводки, 12 каналов М3, 4 ножки | Под модулями просвет 10 мм — там ножки датчиков и вся проводка | ✅ Готово |
| 1.10 | Площадка электроники | Ложе ESP32 с терминал-адаптером, прорези под стяжки, места клеммников WAGO | Пристыковывается к основанию двумя ушами поверх балки | ✅ Готово |

## История сенсора

| Вариант | Почему отпал |
|---|---|
| Потенциометр-джойстик ALPS RKJXV | Струна изгибается, ось не поворачивается — щипок не виден |
| AS5600 аналоговый выход | У версии AS5600L выход OUT не работает (всегда VDD), только I2C |
| AS5600 по I2C через TCA9548A | Работает и проверено, но 6 плат ≈ 1500 ₽, мультиплексор и жгут из 30 проводов |
| AS5600 + TCA9548A на клеммниках, живой стенд 21–25.08 | Дрожащий зажим на SDA/SCL даёт битые биты и отвал датчика до перезагрузки; магнит у границы шкалы 4095→0 — иглы на каждом колебании. «Каша» на графиках оказалась болезнью цифрового жгута, а не механики: после перехода на 49E шум ±2–4 единицы |
| Пьезо-диск, TCRT5000 | Пьезо видит только удар, не видит статику и направление |
| **49E (текущий)** | Аналоговый выход прямо в ADC, ~15 ₽, видит всё то же самое |

## Файлы

* Модели: `2-0/gitara_struny.py` — модули, палки, обоймы, основание, вставки
* Прошивки: `2-0/hall49e_test/` (одна струна), `2-0/struny6_hall/` (шесть),
  `2-0/struny6_test/` (вариант на AS5600 через TCA9548A, оставлен как референс)
* Пульт: `2-0/websim/struna_pult.html`, `2-0/websim/struny6_pult.html`
* Столы печати: 56–64 (см. [Печать и сборка](/homepage/iniciativa.-razrabotka/jepik-ruka-gitara/pechat-sborka))
