Korvova/gitar/wiki/pechat-sborka.md

Печать всех деталей идёт готовыми столами: файл 3MF открывается в Bambu Studio и
сразу отправляется на печать. Столы лежат в репозитории (`2-0/Print3mf`, `3-0/Print3mf`)
и генерируются из `2-0/make_3mf.py`.

## Столы по узлам

| Номера | Что |
|---|---|
| 01–30 | Гриф, тележки, ролики, направляющие, дека, моторные узлы |
| 31–47 | Корпус: дно, крышка, обечайка, тумбы, секции грифа |
| 48–52 | Узел струн на AS5600: стенды и рама. Референс, в продукт не идёт |
| 53 | Тест-ячейка платы AS5600, посадка проверена печатью |
| 54–55 | Пружины 0.7 мм и палки-моноблоки на шесть струн |
| 56–62 | Модули-картриджи струн на 49E: 56 — первый, 57–61 — по одному, 62 — все пять разом |
| 63 | Основание на шесть картриджей, площадка ESP32, ножки |
| 64 | Вставки-фиксаторы проводов |

## Крепёж

| Где | Что |
|---|---|
| Палка к столбикам модуля | 2 × М2 в торцы столбиков |
| Модуль к основанию | 2 × М3 |
| Ножки основания | 4 × М3 сверху сквозь балку |
| Площадка электроники к основанию | 2 × М3 |
| Обойма магнита к струне | Шплинт из куска филамента Ø1.7 мм |

## Сборка модуля струны

1. Магнит Ø4.1×2.1 мм — в ямку обоймы.
2. Обойма — на струну, фиксируется шплинтом-филаментом.
3. Палка — на столбики модуля, два винта М2 в торцы.
4. Датчик 49E — в туннель планки плашмя, надписью вверх, до упора, ножки вниз.
5. Провода: левая ножка на 3.3 В, средняя на землю, правая на свой пин ESP32.
6. Вставка-фиксатор — снизу в прорезь, провода проходят через её окно.

## Жёсткости пружин

Палки-моноблоки различаются толщиной стенки зигзага, на плече нанесены риски:

| Риски | Жёсткость | Струны |
|---|---|---|
| 1 | 0.6 мм | 2 и 5 |
| 2 | 0.7 мм | 3 и 6 |
| 3 | 0.8 мм | 1 и 4 |

Жёсткости чередуются, чтобы у соседних струн не совпадали резонансные частоты:
при одинаковых пружинах щипок одной струны раскачивает соседние через общее
основание, и программное подавление не помогает — амплитуды получаются равными.
