Korvova/gitar/wiki/t-taktilka.md

Тактильная обратная связь — главная фишка продукта: устройство не показывает, а
даёт почувствовать, куда двигать руку. Научная основа — Passive Haptic Learning
(Georgia Tech). У владельца есть личный опыт: такой же подход он уже применял в
тренажёре для игры на пианино, там три вибромотора и подсказывали, и создавали
ощущение перемещения.

## Требования

| Номер | Требование | Описание | Урок | Статус |
|---|---|---|---|---|
| 5.1 | Браслет с тремя вибромоторами | Бегущая волна по ладони означает «двигай руку туда» | Закрывает продольное перемещение руки, которое тележки не делают. Входит в первую продаваемую версию, а не в апгрейд | ⬜ Не начато |
| 5.2 | Связь браслета с устройством | ESP-NOW или BLE до ESP32 деки | Моторчики разносить не ближе 25 мм, иначе ощущения сливаются | ⬜ Не начато |
| 5.3 | Вибро в тележках | Ощущение зажима и отпускания пальца | Открытая проблема: к подвижной тележке нужен гибкий шлейф или пружинные контакты | ⬜ Не начато |
| 5.4 | LED-подсветка позиции | Адресная лента вдоль грифа показывает позицию мнимой руки | Канавку в грифе делать не нужно — лента клеится сверху | ⬜ Не начато |
| 5.5 | Умная подсветка корпуса | Пульс в темп метронома, цвет по качеству игры, «дыхание» в ожидании ученика | Одновременно функция и маркетинг: светящийся корпус останавливает скролл в ленте | ⬜ Не начато |
| 5.6 | Напальчники правой руки | Вибро на подушечке и ногте, фаза задаёт направление струны | Из плана полного тренажёра, очередь после браслета | ⬜ Не начато |
