Korvova/gitar/2-0/CONTEXT.md

# Гитара-тренажёр — контекст проекта

## СТАТУС 2026-07-25 (главное поверх всего нижеследующего)

- Git в этой папке (main), коммитить после каждой правки геометрии.
- Привод канала: СЕКТОР-ДИСК на заводской шестерне мотора (тугая звёздочка
  −0.25 по диаметру). Два варианта: Ø27 `bigdrum27_v9` (86.4 мм/об, вписан
  в 4-канальную компоновку, 2 канавки-ручья) и Ø54 `disk54_v1` (171.2 мм/об,
  гладкий без канавок — сектора нитей не пересекаются; ДЛЯ ПРОТОТИПА: в
  4-канальную компоновку НЕ влезает — вопрос открыт).
- ФИКСАЦИЯ НИТЕЙ РЕШЕНА И ПРОТЕСТИРОВАНА НА ЖИВОМ ВАЛУ: «поворотный ключ» —
  плоская пластинка 2 мм с дыркой (`keylock_key_v2`) в прорези диска.
  Нить сквозь канал диска и дырку ключа, протяжка свободная; поднял ключ,
  повернул, опустил — заперто. На диске нить ОГИБАЕТ цилиндр (кабестан),
  поэтому хватает даже 90° поворота; 360° — абсолютно намертво.
  Стол печати: Print3mf\14_disk_final.3mf (диск + 3 ключа).
- Тележка v10 (дно 2/стенки 5, плавники сбоку на 2×M2), плавники v11
  (Т-лыжа + зигзаг-палец мимо ролика). Слои грифа v12 (канавки углублены
  под вкладыши-liner). ВАЖНО: система A/B ЗЕРКАЛЬНАЯ (ролики обоих бортов
  смещены к деке) — вкладыши и плавники для борта B это ОТДЕЛЬНЫЕ детали
  (liner_b*, fin_b*), не поворотные копии A! Столы 05 и 17 = по 4 A + 4 B.
- Ярус-диск v3 (после теста юзера): третья прорезь и длинный ключ убраны,
  стопка стягивается 2 шурупами сверху (дырочки Ø1.7 сквозь диск на x=±9).
  Стол 16 = 2 диска v3 + 3 коротких ключа. Механизм фиксации нити найден
  и проверен: поворотный плоский ключ + капстан.
- Стол 18_etazh1_test.3mf — этаж 1 целиком для проверки руками (слой L1,
  тележка, плавники A+B, вкладыши A+B, 2 угловых ролика).
- Новая папка этапа: C:\App\gitar\3-0 (пока копии свежих столов 16 и 18;
  код и git остаются в 2-0).
- Веб-пульт: http://192.168.1.4 (края/тренажёр/стоп), прошивка
  C:\App\gitar\drive_web (MM_PER_REV=29.8 — ПОД БАРАБАН; для диска Ø27
  поменять: селектор «Привод» на странице (Ø54=171.2, Ø27=86.4)!). ESP32 OTA порт 3232.
- Полная история решений — в памяти Claude и git-логе.

# Исходный контекст (на 2026-07-21)

Файл-передача контекста для Claude на другом ПК. Прочитай целиком — здесь всё,
что сделано и решено. Рабочая папка проекта: `C:\app\Esp-gitar`.

## Идея устройства

Тренажёр для обучения игре на гитаре: 4 тележки-стакана (в них вставляются
пальцы) ездят ПОПЕРЁК грифа и двигают пальцы, имитируя зажатие струн.
Привод — тросик (плетёный шнур KAME PE MAX 4X 0.5 мм) петлёй: барабан на валу
шагового мотора NEMA 14 в деке → направляющий ролик → продольный канал в
грифе → угловой ролик Ø5 на повороте → поперёк грифа к ножке тележки (узлы).
4 мотора = 4 тележки. Всё печатается на 3D-принтере и собирается.

## Текущая версия: v9.1 — ГОТОВА К ПЕЧАТИ

Генератор всей геометрии: `trainer_v9.py` (build123d, python). Все параметры
в шапке файла. Экспортирует 21 STL (все проверены: watertight, 1 тело).
Папка `Print\` — 20 STL для печати (31 деталь) + `README.txt` с ориентациями
печати, полным BOM и пошаговым порядком сборки. `Прототип.blend` — сборка
в Blender 5.2 с анимацией (пробел = тележки ездят, барабаны крутятся).

### Ключевая геометрия (кратко)

- Оси: X вдоль грифа (0..125 — гриф, 100..330 — дека), Y поперёк (±25), Z вверх.
- Гриф 125×50×20 из 5 печатных слоёв: L1..L4 — «этажи» по 3.5 мм (z=3.5·i),
  L5 — верх (z14..20) с полкой z14..16 в зоне тележек (X 24..94) и щелями.
- Тележки: центры X = 35/51/67/83 (шаг 16). Каждая на своём этаже: тележка 1
  (у головы) = этаж 1 (нижний), ... тележка 4 = этаж 4. Ход ±20 мм.
- Тележка = корпус (одинаковый ×4: основание + стакан под палец) + 2 съёмных
  ПЛАВНИКА с Т-пяткой (4 длины по этажам, по 2 шт). Плавники вставляются с
  торцов грифа в щели (A с борта −Y, B с борта +Y), крепятся винтом M2 сверху
  через пол стакана. Пятка ходит в канавке своего этажа, Т-профиль держит
  тележку от вырывания. Трос вяжется узлом в окошко 1.2×1.2 пятки.
- Каналы к деке идут ПО ДНУ этажа (трос на z = низ_этажа + 0.75) — плавники
  и пятки ходят НАД тросом с зазором 0.4 мм (это решило зацеп троса ножкой).
  Каналы разнесены к краю по этажам: Y = ±17 / 18.5 / 20 / 21.5 (этажи 1..4) —
  на деке каждый трос идёт своим коридором и не задевает чужие ролики.
- Угловой ролик = капстан с высокой шейкой (Ø4.6, фланцы Ø6): трос заходит по
  дну канала, сходит на высоте окошка пятки (низ+2.1). Ролик стоит ВНУТРИ
  поворота троса (центры: A = (S−1.5, +(CH_Y−2.5)), B = (S+6.5, −(CH_Y−2.5))) —
  натянутый трос прижимается и обходит ролик со стороны края грифа.
  Ось — кусочек филамента 1.75 ~4 мм в лунке кармана; сверху запирается
  выемкой следующего слоя. Сквозных отверстий в слоях нет.
- Дека: плита 100..330×±30, ноги 26 мм. 4 мотора в линию X = 160/206/252/298:
  мотор k = тележка k (ближний = нижний этаж). Мотор падает в колодец Ø37.4
  сверху, уши ложатся на плиту (M3 самонарез, уши вдоль Y), разъём проходит
  в вырез к −X. Барабаны: юбка Ø20 с полостью Ø16.4 садится на пилот мотора
  Ø16×1.5 (подшипник скольжения), бора Ø2.35 на вал Ø2.5 (натяг + суперклей),
  глубина боры 6.8 (запас под вал 6+0.5). Ручьи барабана на высоте своего
  этажа (ZFD = 3.0/4.25/7.75/11.25), ручей A верхний, B нижний.
- Направляющие ролики: на винтах М4 (самонарез в отверстия Ø3.3 плиты),
  на винт надевается отрезок латунной трубки K&S 5×0.45 (внутр. Ø4.1 — плотно
  на М4), ролик (бора Ø5.2, шейка Ø7) крутится по трубке. Позиции:
  (MOT_X−29, ±(CH_Y_этажа − 3.75)). Дальние тросы проходят НАД ближними
  роликами (запас ~0.75 мм по Y-коридорам + высоты).
- Крепёж грифа: стяжка 4×M3×20 (X=8 и 96, Y=±12, потаи сверху), в деку
  2×M3×25 ПО ЦЕНТРУ (X=108 и 118, Y=0), 4 штифта-филамента 16 мм (43/75, ±12).

### Мотор NEMA 14 (круглый, по чертежу юзера)

Ø36.5, длина 22, уши 2-M3 на 43.85, пилот Ø16×1.5, вал Ø2.5×6(±0.5),
разъём ZH-4AW сбоку у задней крышки (выступ 3.35, ширина 10.5). Есть 4 шт.

## Статус закупок (2026-07-21)

- Куплено/есть: шнур KAME PE MAX 0.5, суперклей, филамент 1.75 (оси/штифты),
  моторы ×4.
- Заказано, приедет ~23.07: НАБОР винтов M2/M3/M4 (длины 4..25 по 20 шт +
  ключи) — закрывает весь крепёж; латунная трубка K&S #9823 5×0.45 ×30 см.
- Отдельные позиции винтов из первой корзины отменены в пользу набора.

## Что дальше (план)

1. Юзер печатает пластик по `Print\README.txt` и собирает. При проблемах
   посадок — правки в `trainer_v9.py` (все размеры параметрические) и
   перегенерация: `python trainer_v9.py` (нужен venv с build123d + trimesh;
   на исходном ПК это `...\mcp-blender-cloude\.venv-b123d`; на новом —
   `pip install build123d trimesh`).
2. Прошивка ESP32: 4 шаговика NEMA 14 (биполярные), драйверы скорее всего
   TMC2209 (юзер уже использовал их с NEMA 17 в этом проекте, серво MG90S
   отклонены — шумные). Нужен тестовый скетч: STEP/DIR ×4, плавные рампы,
   режим «подвигай тележку с серийника/кнопками». Ограничить ход ±20 мм
   (±19 при задевании), скорость смены позиции 0.1–0.3 с.
3. Дальше: ноты/табулатуры → последовательности движений тележек.

## История версий (для понимания решений)

- v6 (finger_module.py): серво SG90 лёжа + рейка-шестерня — заменено.
- v7/v8 (cart_module.py): одна тележка на тросике, NEMA 14; v8 — гриф из
  2 слоёв, ход ±20. Уроки: ничего не должно выпирать за борта грифа (рука
  цепляется); обводной ролик ставится ВНУТРИ поворота троса; отверстие-цилиндр
  вдоль оси Y в мелкой детали даёт не-watertight STL (делать квадратное окно).
- v9/v9.1 (trainer_v9.py): полный тренажёр 4×4, этажи, каналы по дну.
- Полноразмерный гриф из 3 палок (grif_palki.py, palka1..3.stl) — отдельная
  ветка, декоративный гриф 600 мм, к тренажёру пока не пристыкован.

## Стиль работы с юзером

Юзер (Владимир) общается по-русски, делает хардверные DIY-проекты, 3D-печать
на Bambu P2S (стол 256×256). Отвечать по-русски. Проверять модели рендерами
и в Blender (юзер смотрит сборку там). Все детали для печати — watertight,
одно тело. Юзер сам ловит механические косяки по картинке — показывать
крупные планы узлов. Не переусложнять, boolean-вырезы вместо loft.
