Korvova/gitar/2-0/kasseta/chertezhi.pdf

## Кассета тактильного грифа: спецификация

01 Основание с рейкой (1 шт)
02 Шестерня мотора Z18, m0.5, Ø9 (1 шт)
03 Плавающая шестерня Z12, m0.5, Ø6, отв. Ø1.6 (2 шт) 04 Ползун (1 шт)
05 Тележка (1 шт)
06 Упор паза (1 шт)

Для 4 секций умножь всё на 4.

Материал: фотополимер, слой 25–50 мкм. FDM не подойдёт: модуль зуба 0,5.
Печать: 01 основанием на столе, 04 и 05 верхней плоскостью вниз, зубья не держать поддержками.

Сверить с мотором ДО печати (в cassette.py это параметры сверху):
- высота от опоры до торца выступа: принято 17,5 мм (из таблицы продавца);
- расположение отверстий M2 на Ø18 и выход проводов: в основании сделаны 4 отверстия и окно Ø9;
- диаметр выступа Ø9,5 и 4-M2 на Ø6.

Покупные: 2 штифта Ø1,5×5, 4 шпильки M2 (шестерня мотора садится на них на эпоксидку), 4 винта M2 на мотор.

Сборка: 1) мотор снизу в основание, заведя его под стенку; 2) шестерни 03 на штифты ползуна, штифты вклеить; снизу на штифт шайба или капля клея; 3) ползун вдвинуть с края −X, затем вклеить упор 06 в паз;
4) тележку вдвинуть по ласточкину хвосту; 5) выставить центр: ползун и тележка по центру, зубья в зацеплении.

Ориентиры: ход 48 мм (±24), ползун ±12, толщина секции 26,6 мм, шаг секций 24 мм.
Расчётный зазор: 0,04 мм на зуб, 0,1 мм в пазах. Подгонять шкуркой после первой печати.

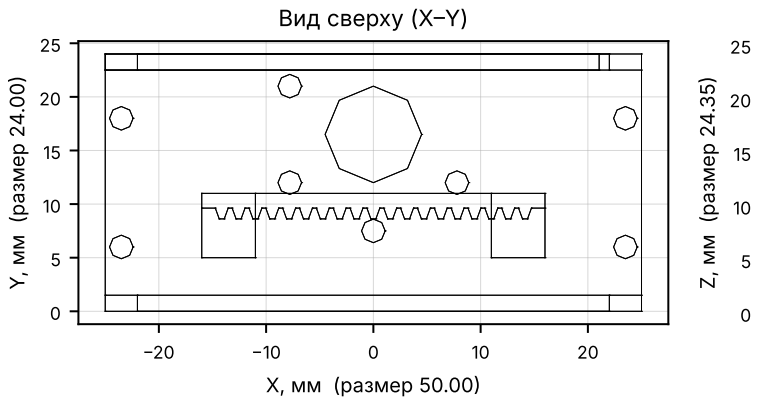
[picture p207: figure]
X, мм (размер 50.00); Y, мм (размер 24.00); Вид сверху (X–Y); Z, мм (размер 24.35)

−20 | −10 | 0 | 10 | 20
X, мм (размер 50.00)

Вид спереди (X–Z)

0 | 5 | 10 | 15 | 20 | 25
Y, мм (размер 24.00)

0

5

10

15

20

25

Z, мм (размер 24.35)

Вид сбоку (Y–Z)

### 01 Основание с рейкой (1 шт)

### 02 Шестерня мотора Z18, m0.5, Ø9 (1 шт)

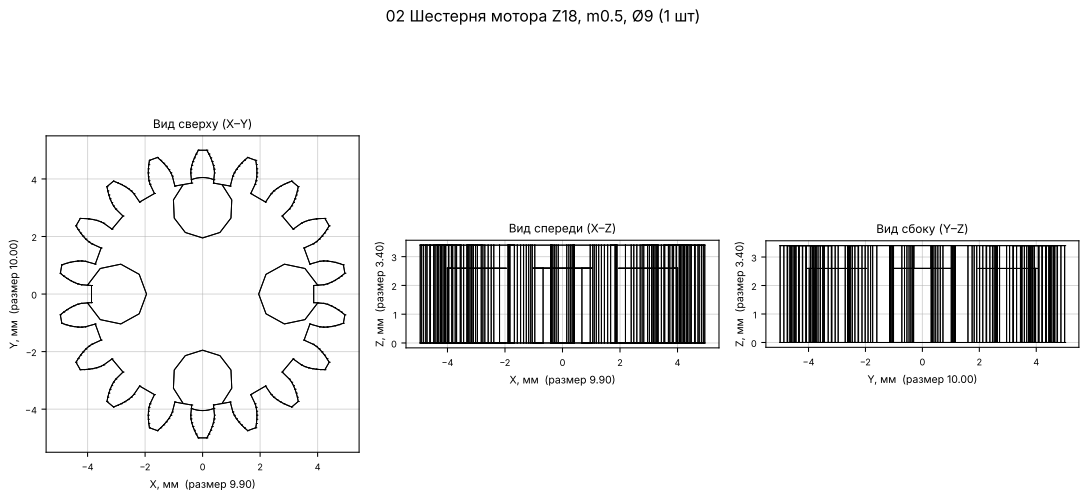
[picture p208: page 3]
X, мм (размер 9.90); Y, мм (размер 10.00); Вид сверху (X–Y); Z, мм (размер 3.40); Вид спереди (X–Z); Вид сбоку (Y–Z)

### 03 Плавающая шестерня Z12, m0.5, Ø6, отв. Ø1.6 (2 шт)

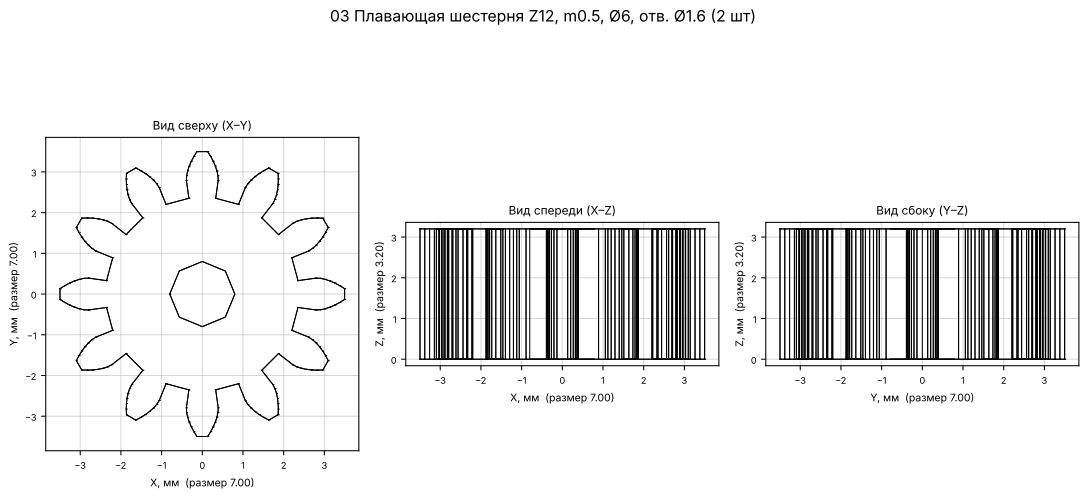
[picture p209: page 4]
X, мм (размер 7.00); Y, мм (размер 7.00); Вид сверху (X–Y); Z, мм (размер 3.20); Вид спереди (X–Z); Вид сбоку (Y–Z)

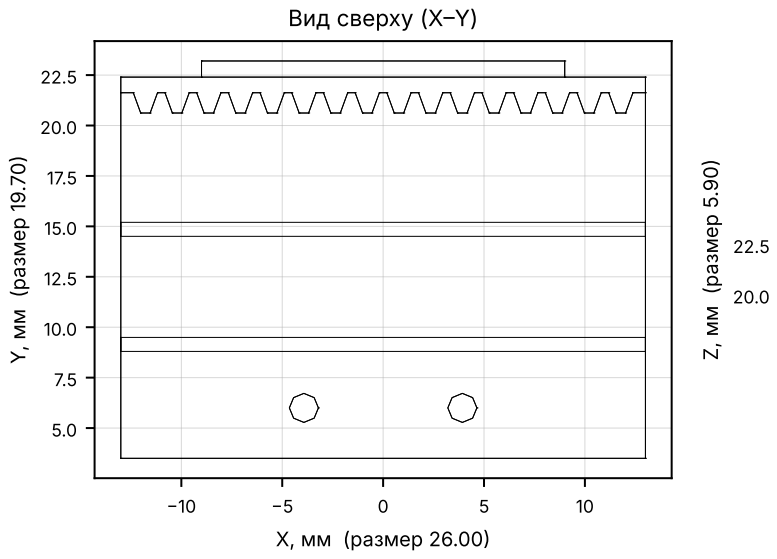
[picture p210: figure]
X, мм (размер 26.00); Y, мм (размер 19.70); Вид сверху (X–Y); Z, мм (размер 5.90)

−10 | −5 | 0 | 5 | 10
X, мм (размер 26.00)

Вид спереди (X–Z)

5.0 | 7.5 | 10.0 | 12.5 | 15.0 | 17.5 | 20.0 22.5
Y, мм (размер 19.70)

20

22

24

Z, мм (размер 5.90)

Вид сбоку (Y–Z)

### 04 Ползун (1 шт)

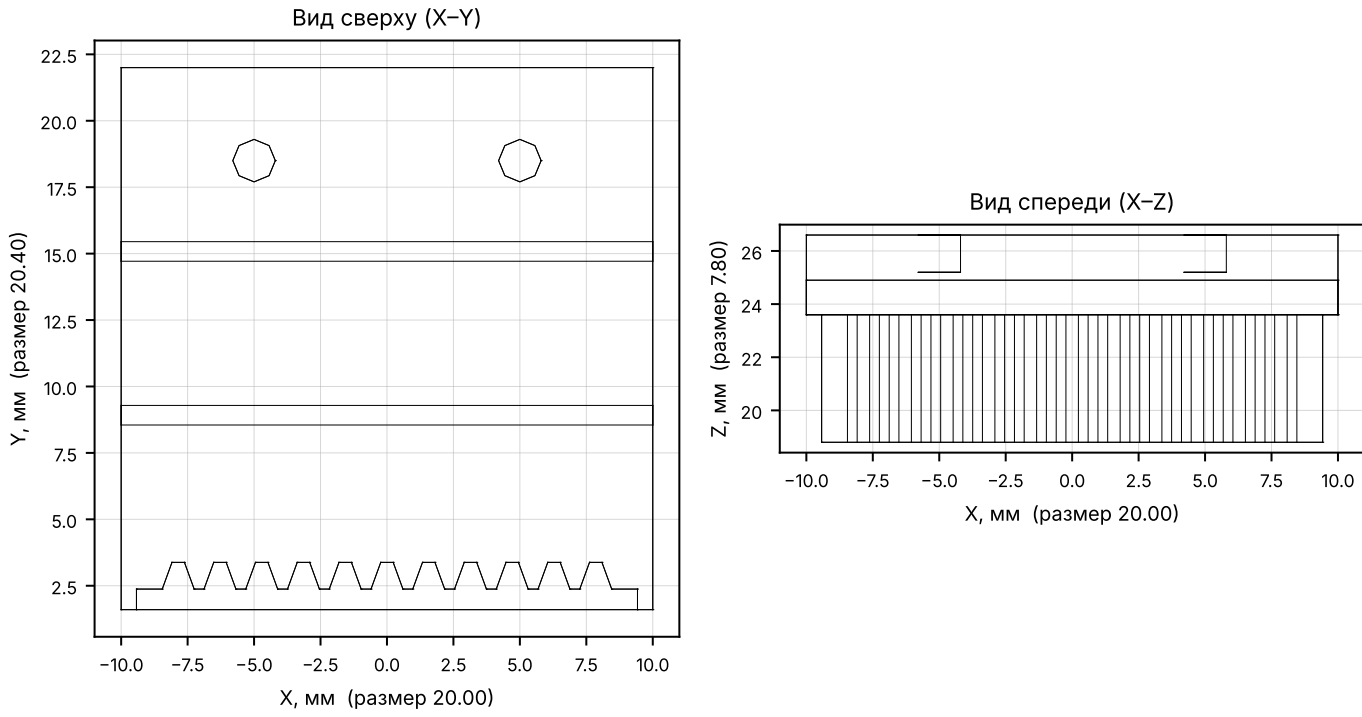
[picture p211: figure]
X, мм (размер 20.00); Y, мм (размер 20.40); Вид сверху (X–Y); Z, мм (размер 7.80); Вид спереди (X–Z)

2.5 | 5.0 | 7.5 | 10.0 | 12.5 | 15.0 | 17.5 | 20.0 22.5
Y, мм (размер 20.40)

20

22

24

26

Z, мм (размер 7.80)

Вид сбоку (Y–Z)

### 05 Тележка (1 шт)

0.0 | 0.5 | 1.0 | 1.5 | 2.0 | 2.5
X, мм (размер 2.50)

0.00

0.25

0.50

0.75

Y, мм (размер 0.75)

Вид сверху (X–Y)

0.0 | 0.5 | 1.0 | 1.5 | 2.0 | 2.5
X, мм (размер 2.50)

0.0

0.2

0.4

0.6

0.8

1.0

1.2
Z, мм (размер 1.15)

Вид спереди (X–Z)

0.0 | 0.1 | 0.2 | 0.3 | 0.4 | 0.5 | 0.6 | 0.7
Y, мм (размер 0.75)

0.0

0.2

0.4

0.6

0.8

1.0

1.2

Z, мм (размер 1.15)

Вид сбоку (Y–Z)

### 06 Упор паза (1 шт)

### Сборка: тележка в центре

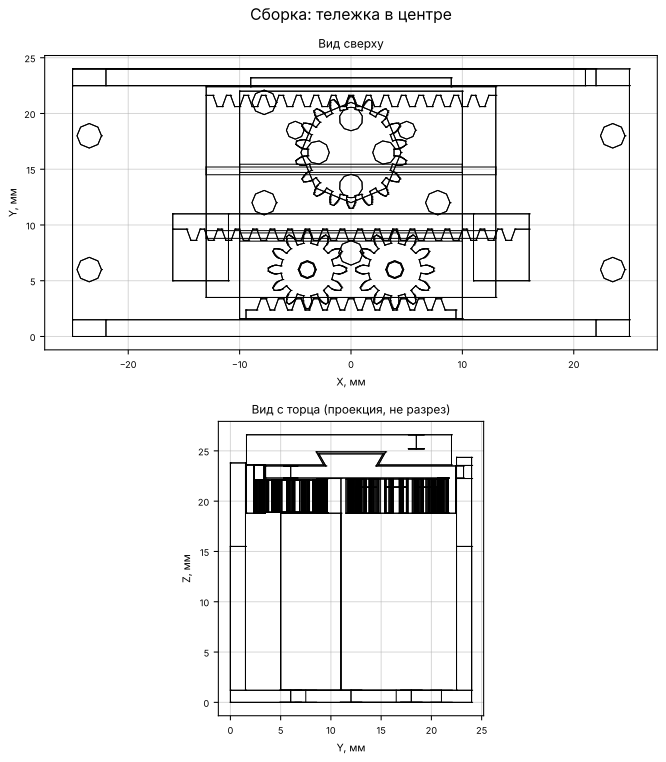
[picture p212: page 8]
Вид сверху

Вид с торца (проекция, не разрез)
