Korvova/gitar/2-0/astra/deka-astra/images/mobile.png

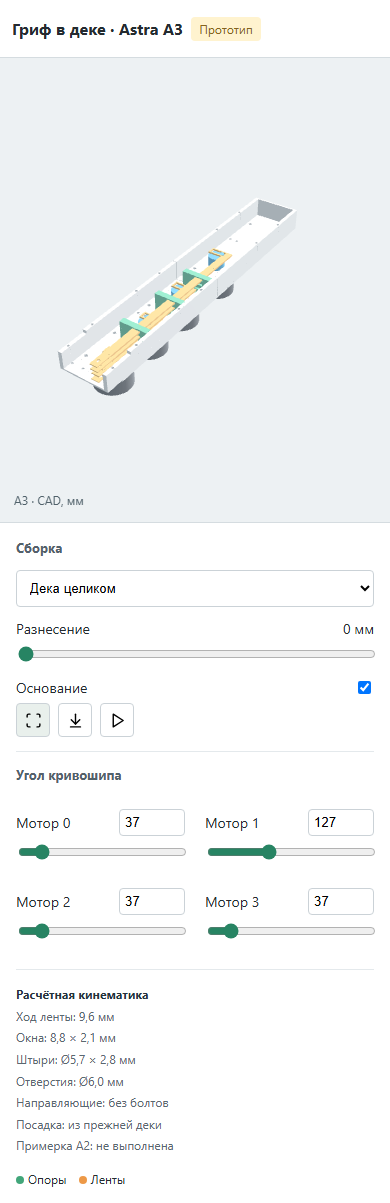
2-0/astra/deka-astra/images/mobile.png
