Korvova/gitar/2-0/manual/img/_rack_concept.png

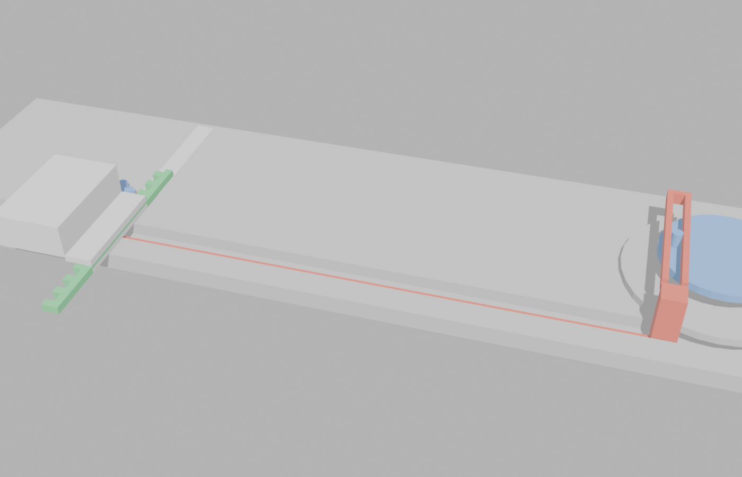
2-0/manual/img/_rack_concept.png
