Korvova/gitar/2-0/manual/img/_spica_concept.png

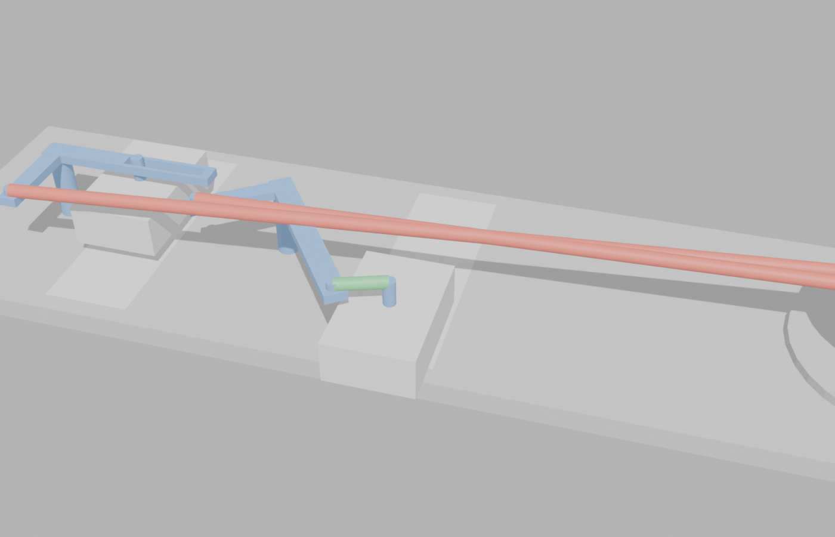
2-0/manual/img/_spica_concept.png
