Korvova/gitar/wiki/img/as5600_plata.jpg

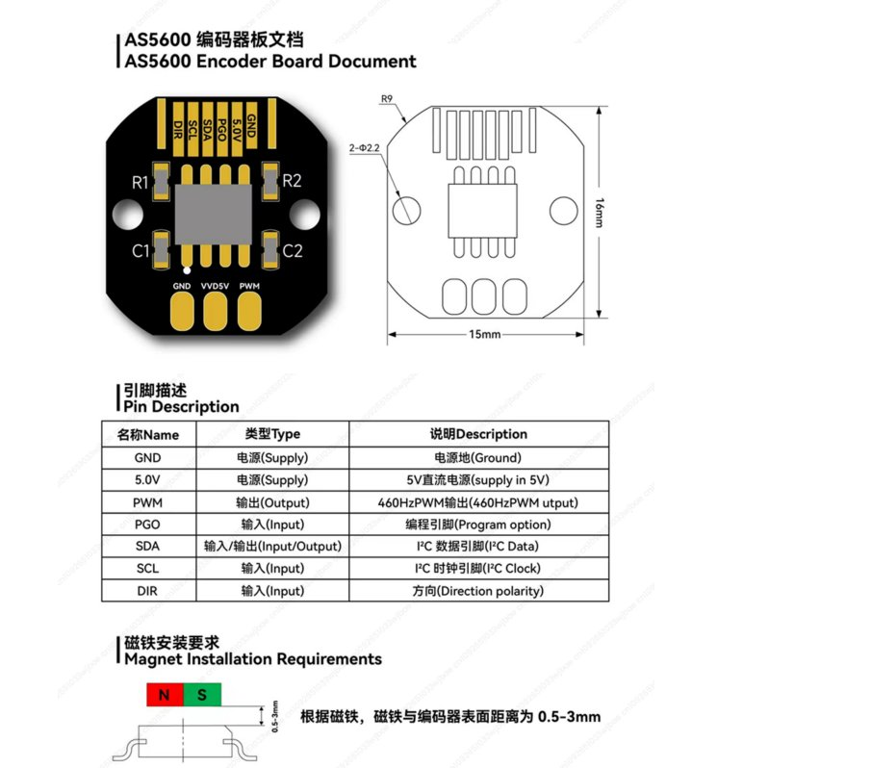
wiki/img/as5600_plata.jpg
