Korvova/gitar/wiki/img/baraban_f31.png

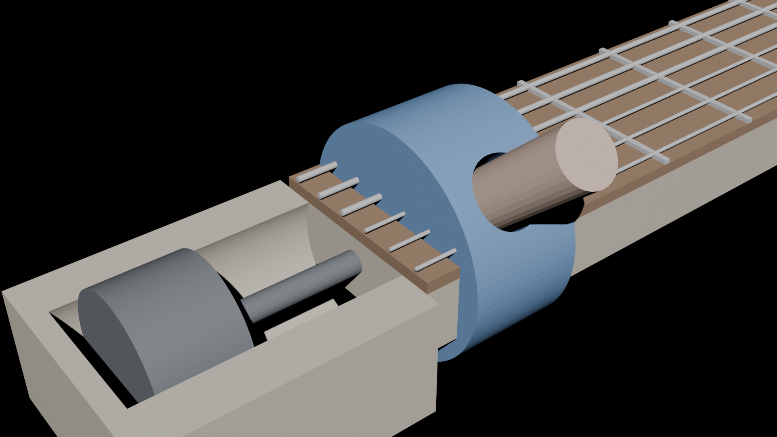
wiki/img/baraban_f31.png
