Korvova/gitar/wiki/img/baraban_f91.png

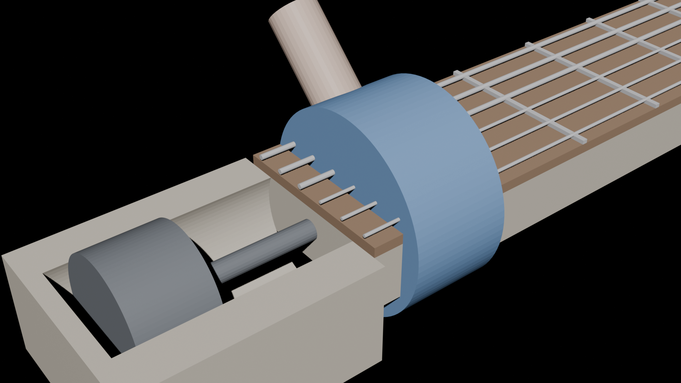
wiki/img/baraban_f91.png
