Korvova/gitar/wiki/img/crank3_big_zub.png

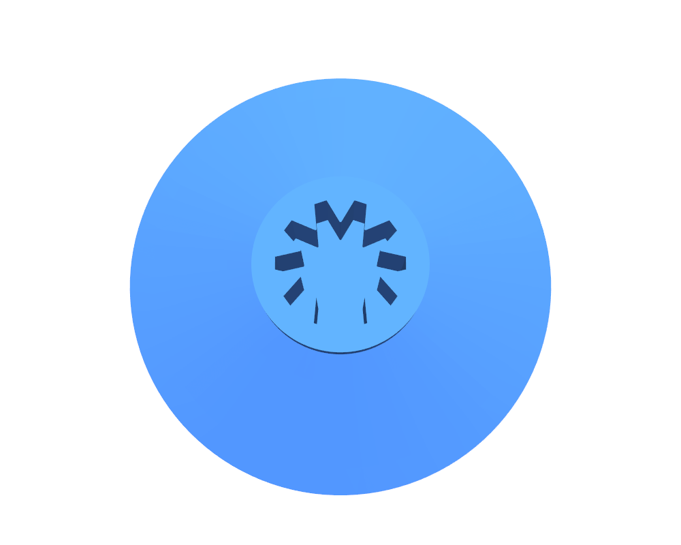
wiki/img/crank3_big_zub.png
