Korvova/gitar/wiki/img/deka3_7_grebenki.png

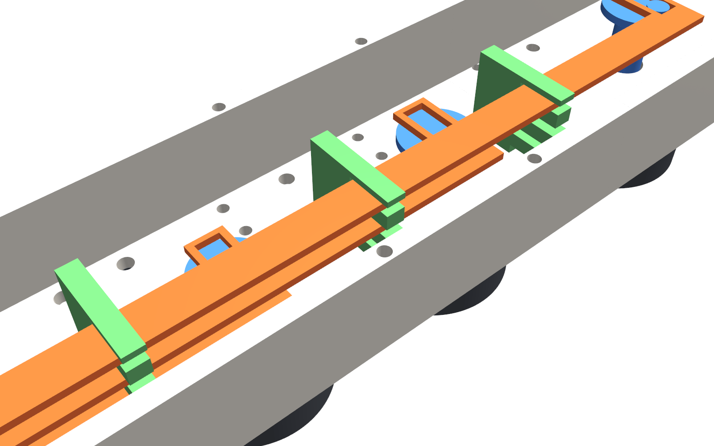
wiki/img/deka3_7_grebenki.png
