Korvova/gitar/wiki/img/deka_g_1_detali.png

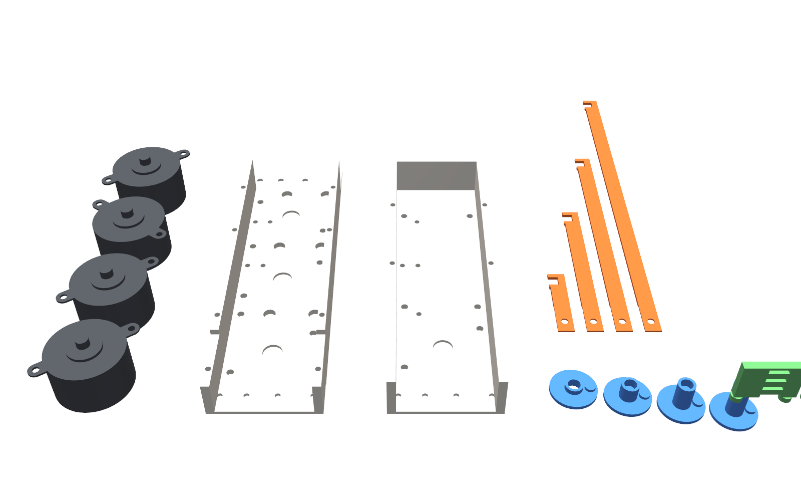
wiki/img/deka_g_1_detali.png
