Korvova/gitar/wiki/img/deka_g_4_grebenki.png

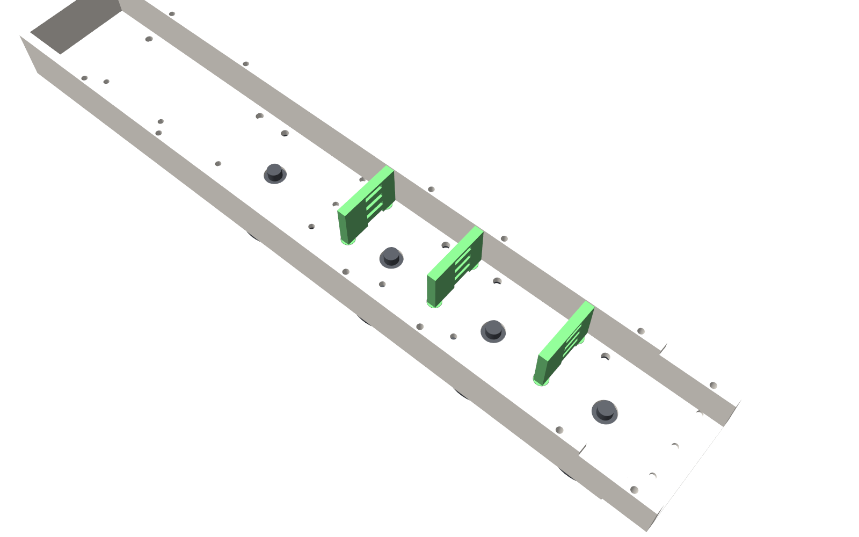
wiki/img/deka_g_4_grebenki.png
