Korvova/gitar/wiki/img/deka_g_5a_hvost0.png

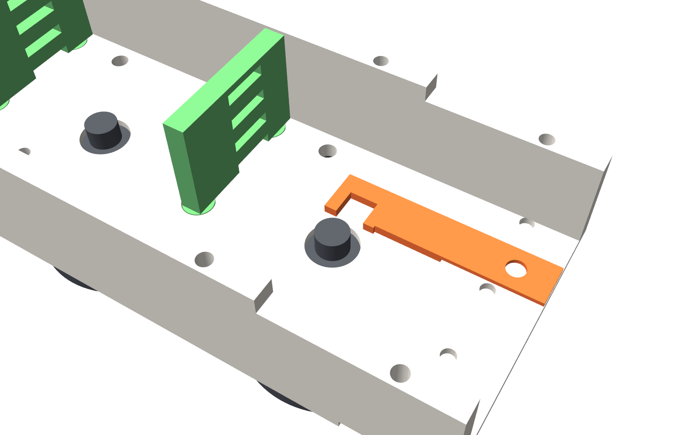
wiki/img/deka_g_5a_hvost0.png
