Korvova/gitar/wiki/img/deka_g_5b_krivoship0.png

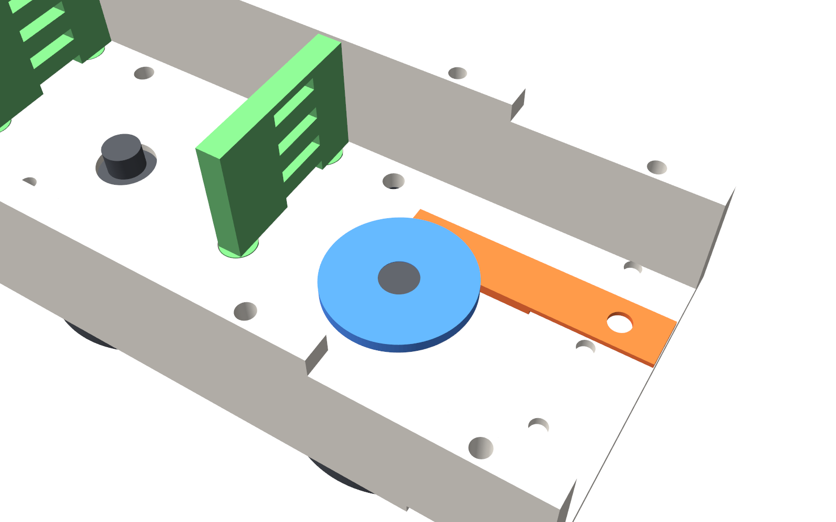
wiki/img/deka_g_5b_krivoship0.png
