Korvova/gitar/wiki/img/deka_v2_top.png

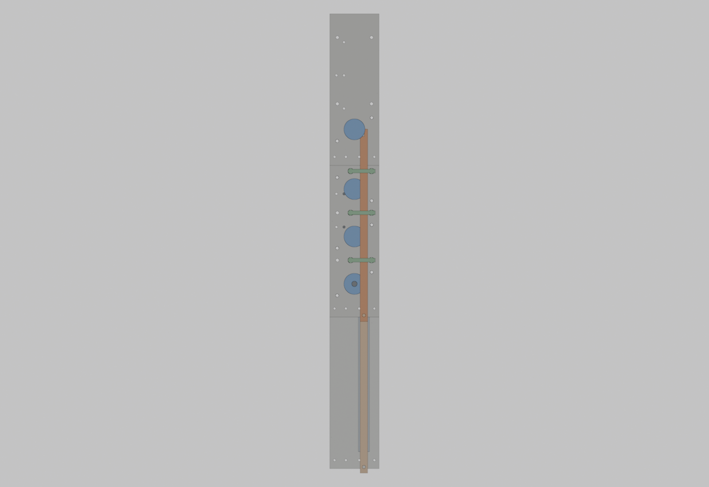
wiki/img/deka_v2_top.png
