Korvova/gitar/wiki/img/hall_deka_3_etazh3.png

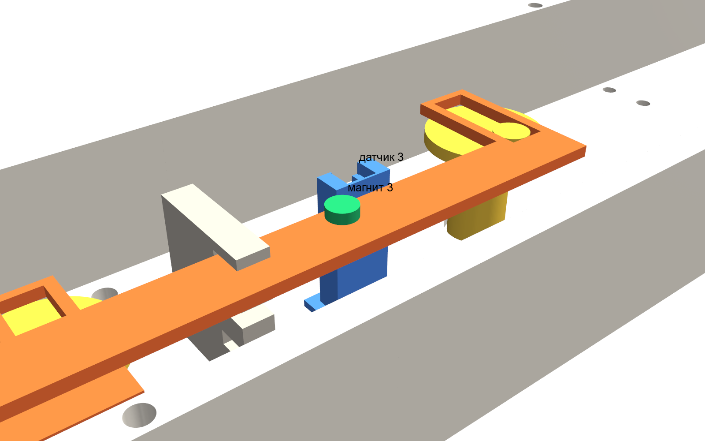
wiki/img/hall_deka_3_etazh3.png
