Korvova/gitar/wiki/img/hall_stend_1_detali.png

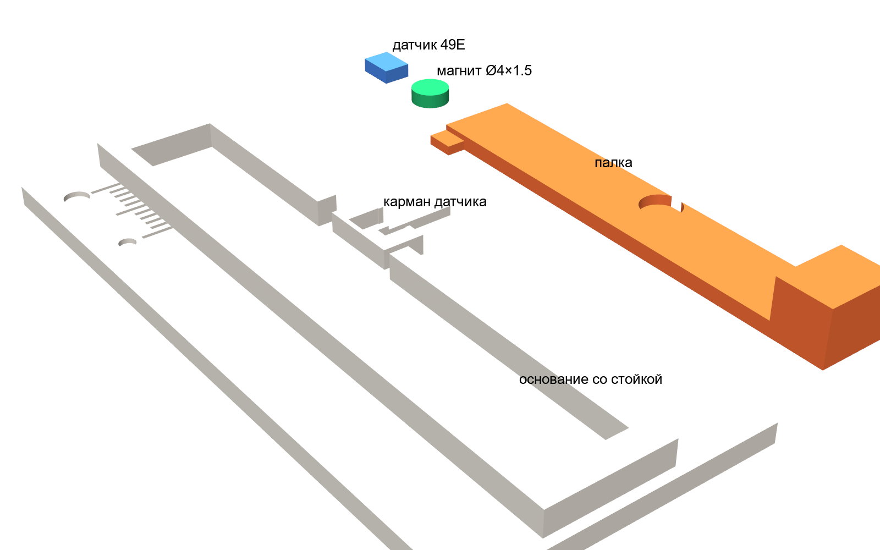
wiki/img/hall_stend_1_detali.png
