Korvova/gitar/wiki/img/hall_stend_2_sborka.png

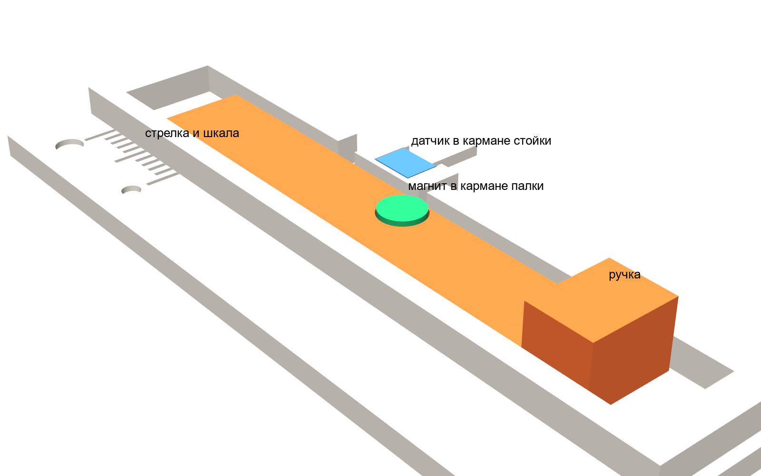
wiki/img/hall_stend_2_sborka.png
