Korvova/gitar/wiki/img/hall_stend_3_jug.png

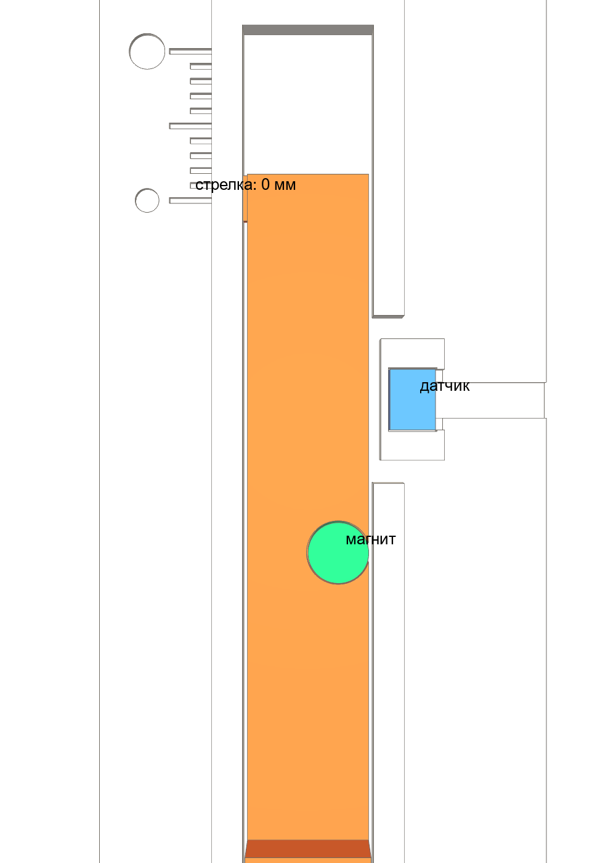
wiki/img/hall_stend_3_jug.png
