Korvova/gitar/wiki/img/hrapovik_idea_34.png

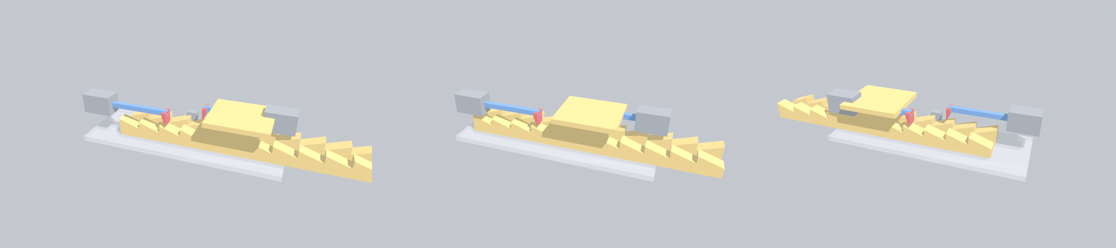
wiki/img/hrapovik_idea_34.png
