Korvova/gitar/wiki/img/hrapovik_idea_bok.png

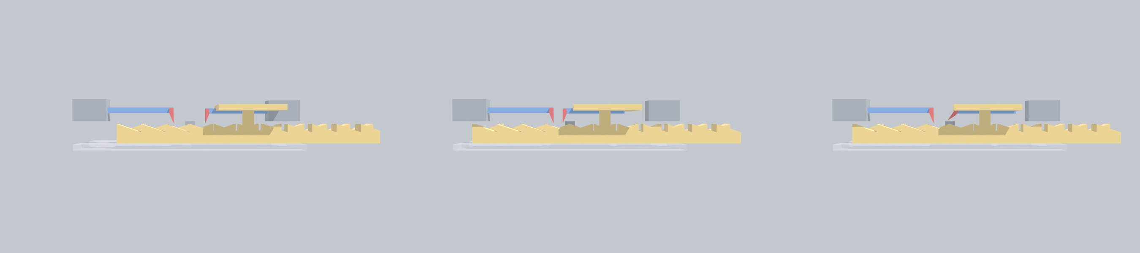
wiki/img/hrapovik_idea_bok.png
