Korvova/gitar/wiki/img/lazer_sborka_klin.png

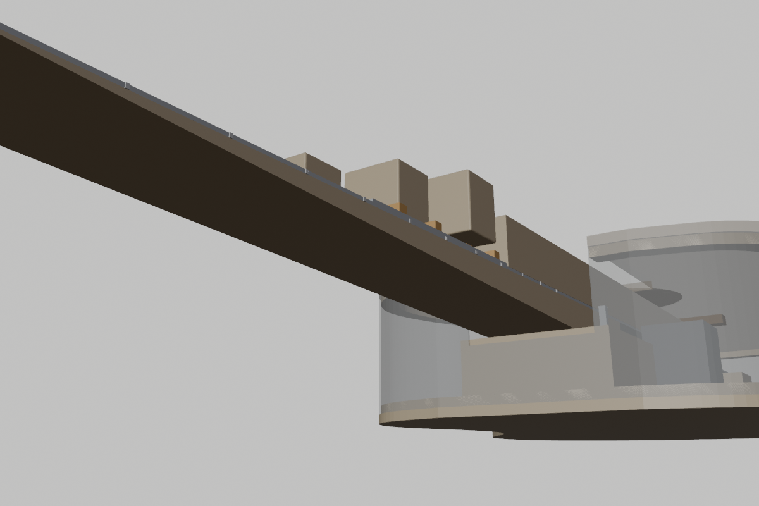
wiki/img/lazer_sborka_klin.png
