Korvova/gitar/wiki/img/lozhe_na_grife.png

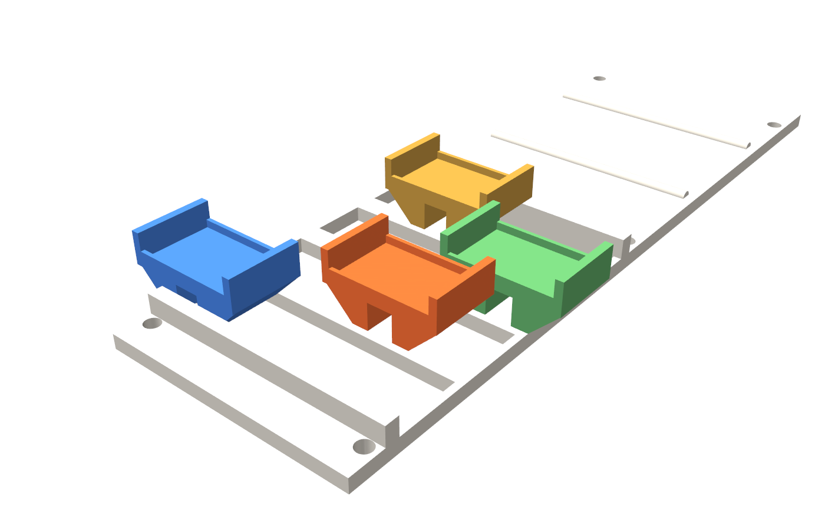
wiki/img/lozhe_na_grife.png
