Korvova/gitar/wiki/img/lozhe_v0_na_grife.png

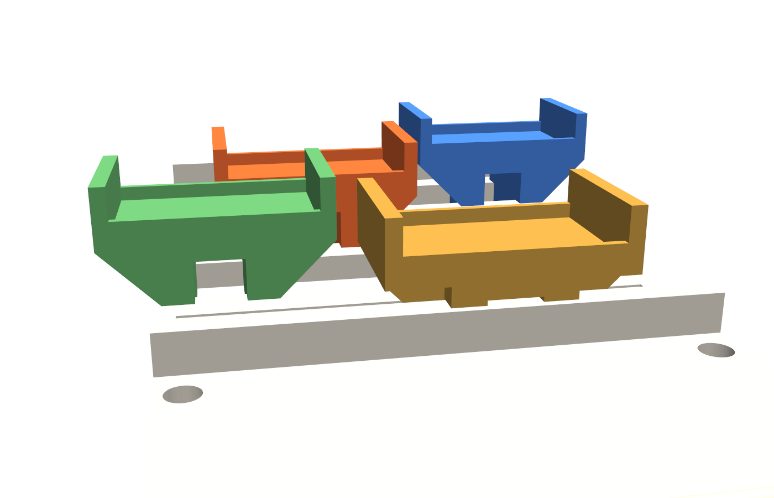
wiki/img/lozhe_v0_na_grife.png
