Korvova/gitar/wiki/img/lozhe_v2_plosk_detal.png

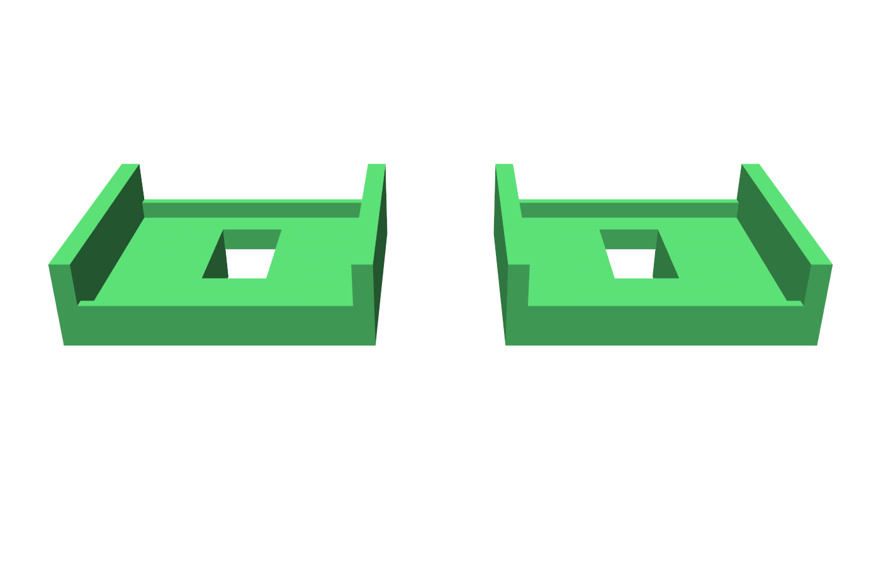
wiki/img/lozhe_v2_plosk_detal.png
