Korvova/gitar/wiki/img/mag_karkas_idea.png

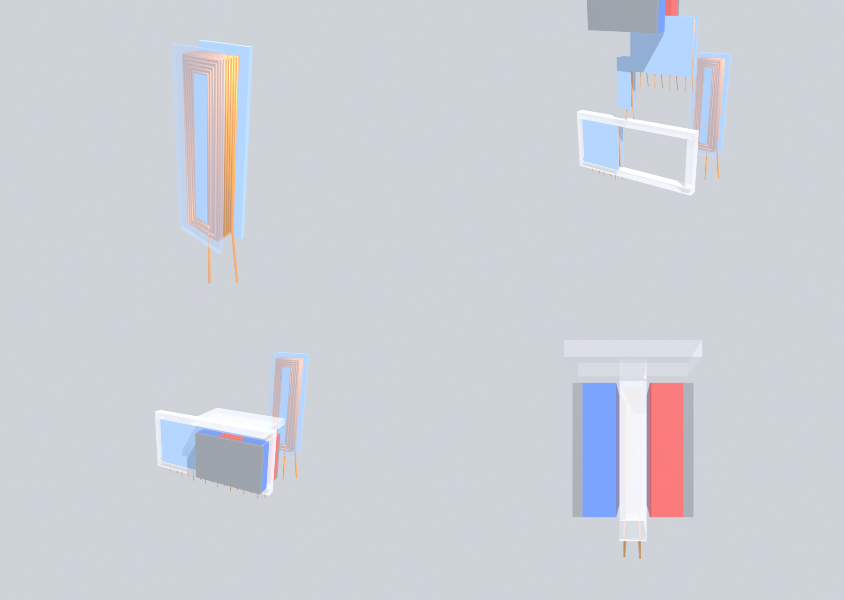
wiki/img/mag_karkas_idea.png
