Korvova/gitar/wiki/img/mag_kasseta_strelka.png

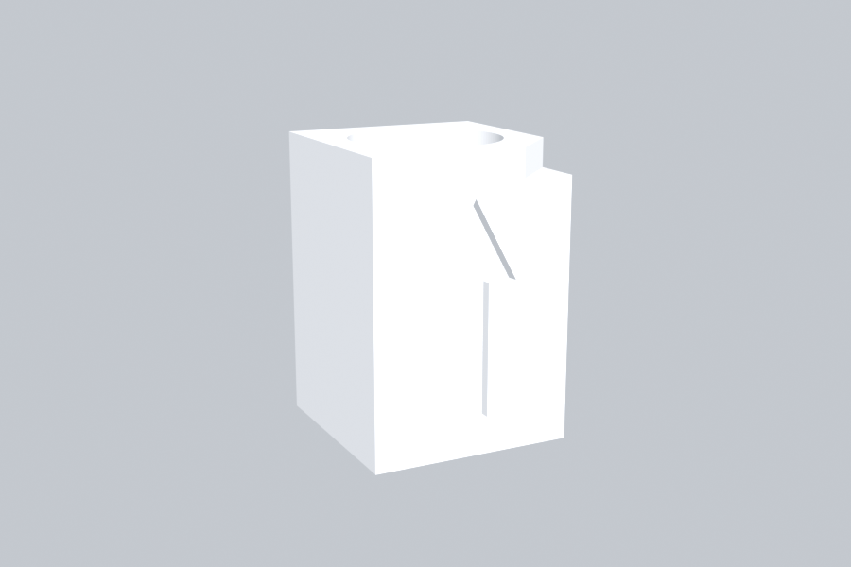
wiki/img/mag_kasseta_strelka.png
