Korvova/gitar/wiki/img/mag_sterzhen_idea.png

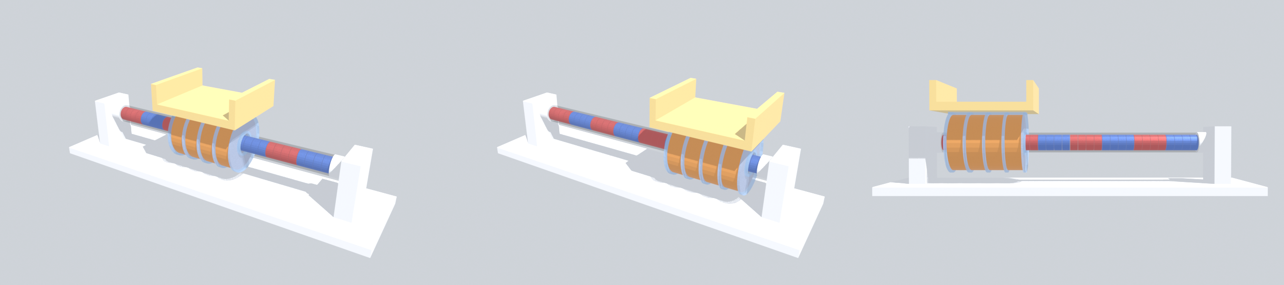
wiki/img/mag_sterzhen_idea.png
