Korvova/gitar/wiki/img/mag_sterzhen_stol87.png

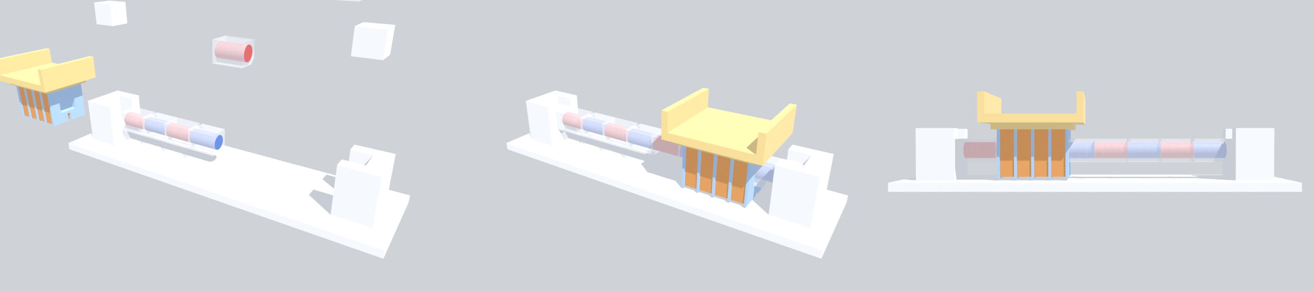
wiki/img/mag_sterzhen_stol87.png
