Korvova/gitar/wiki/img/magnit_proba_sborka.png

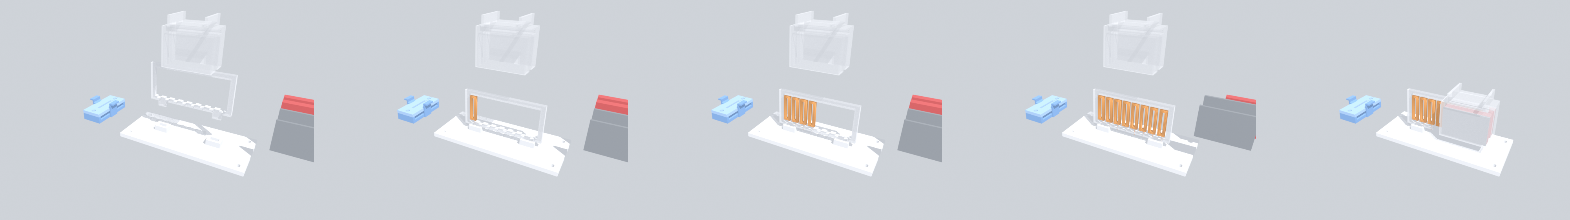
wiki/img/magnit_proba_sborka.png
