Korvova/gitar/wiki/img/magnit_ruslo_proba.png

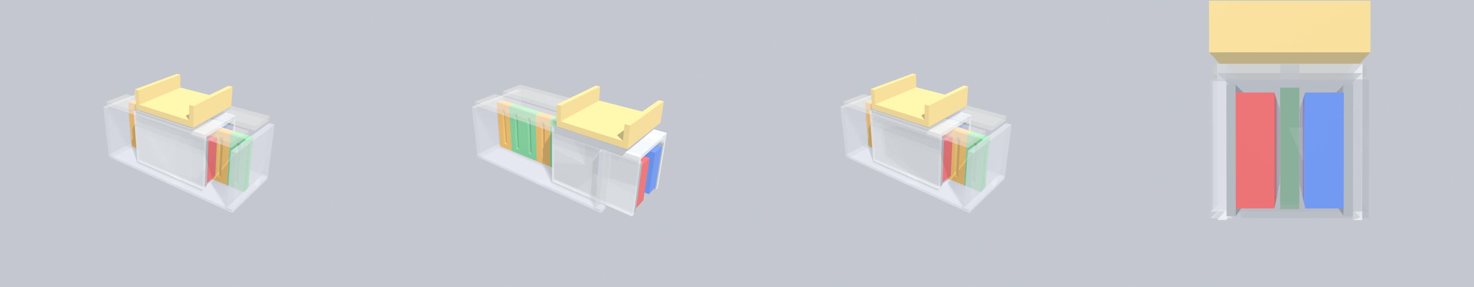
wiki/img/magnit_ruslo_proba.png
