Korvova/gitar/wiki/img/mk_rychag2k1_f41.png

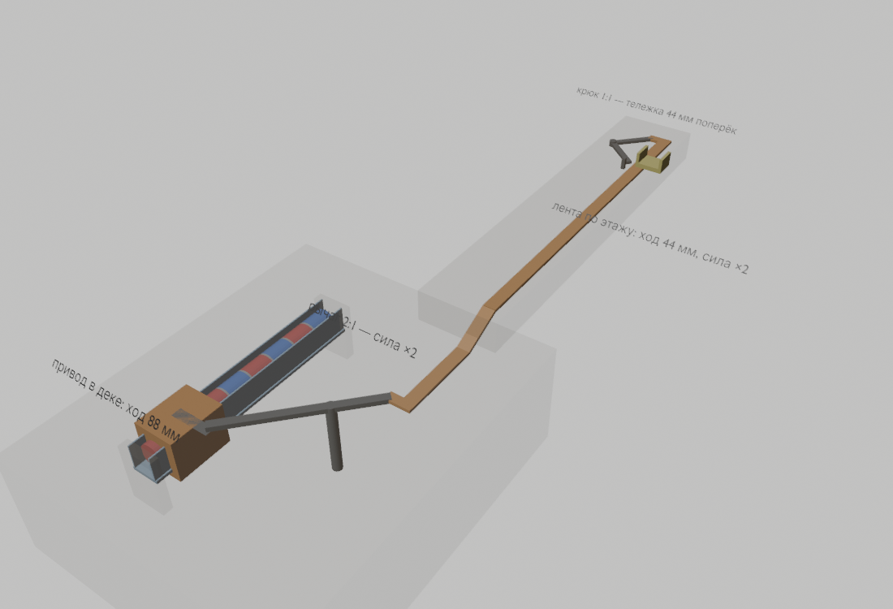
wiki/img/mk_rychag2k1_f41.png
