Korvova/gitar/wiki/img/plata4_gnezdo1_prozvonka.png

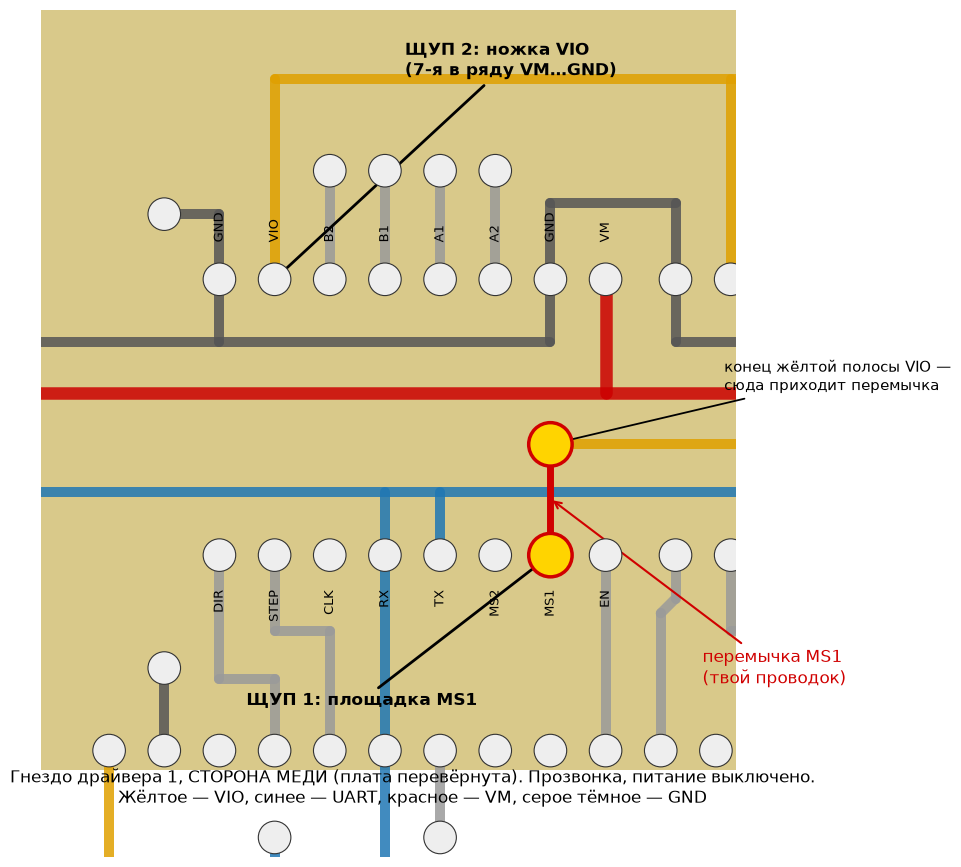
wiki/img/plata4_gnezdo1_prozvonka.png
