Korvova/gitar/wiki/img/plata4_gnezdo1_sverhu.png

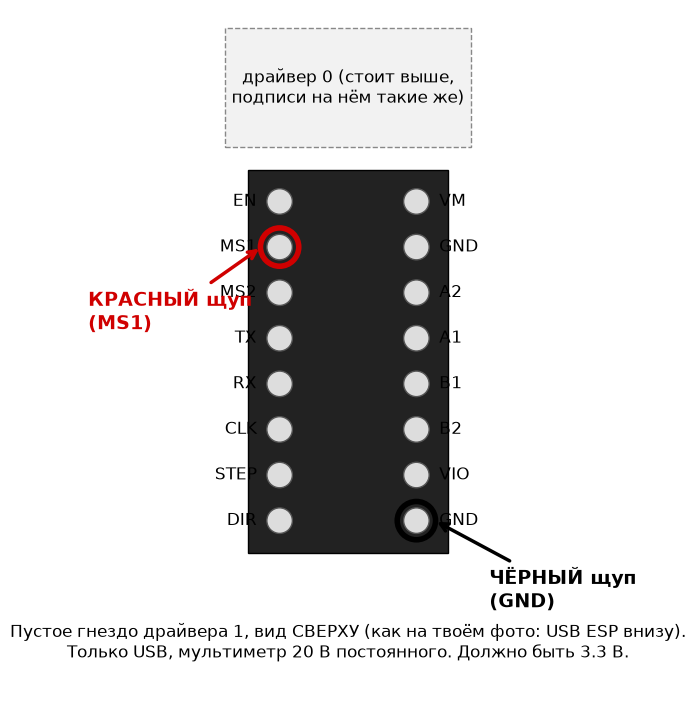
wiki/img/plata4_gnezdo1_sverhu.png
