Korvova/gitar/wiki/img/plata4_komponovka.png

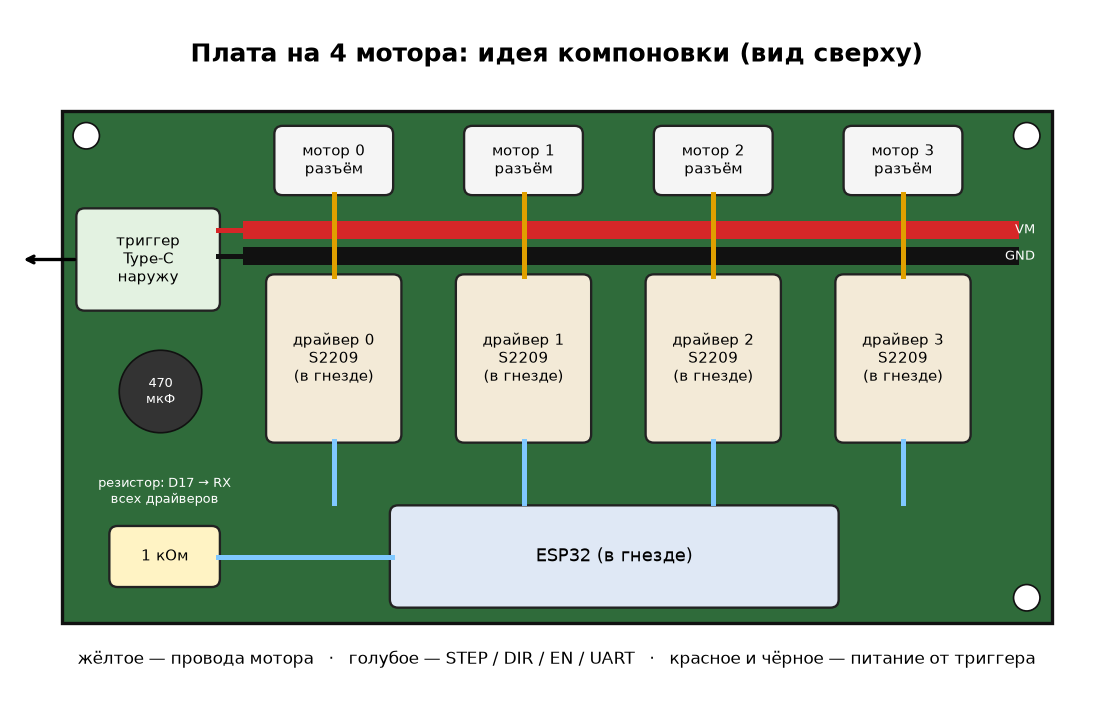
wiki/img/plata4_komponovka.png
