Korvova/gitar/wiki/img/reika_f01.png

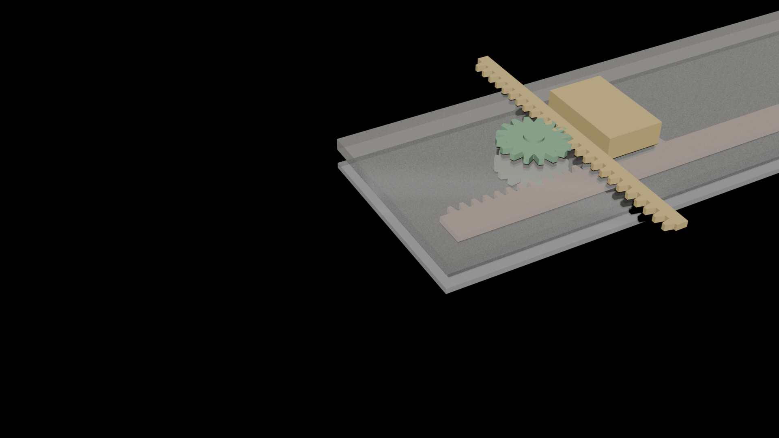
wiki/img/reika_f01.png
