Korvova/gitar/wiki/img/reika_f91.png

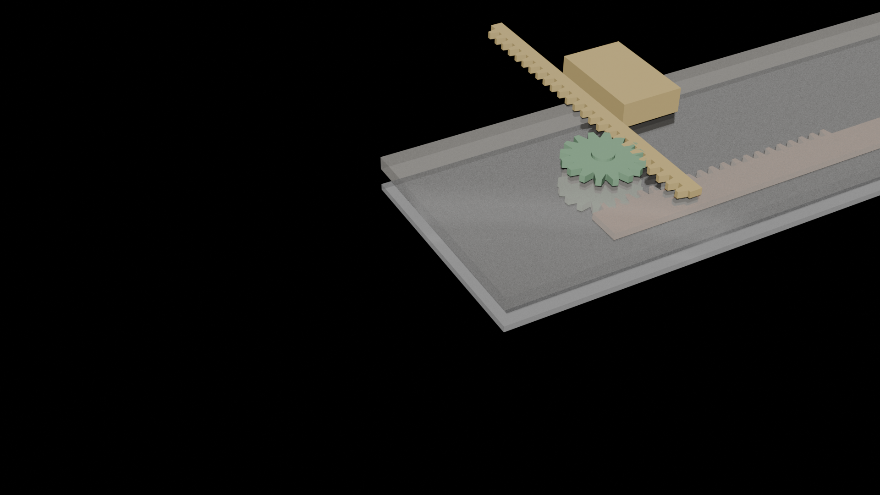
wiki/img/reika_f91.png
