Korvova/gitar/wiki/img/reika_krup_f31.png

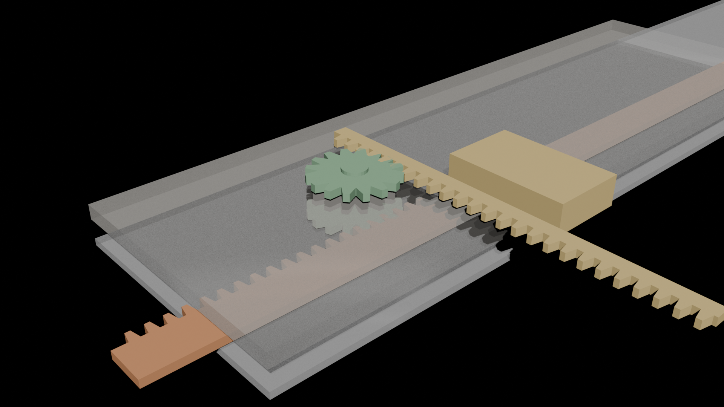
wiki/img/reika_krup_f31.png
