Korvova/gitar/wiki/img/reika_krup_f91.png

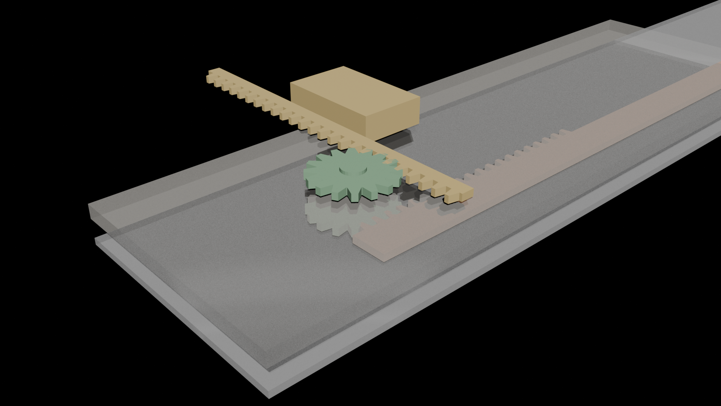
wiki/img/reika_krup_f91.png
