Korvova/gitar/wiki/img/reika_obsh_f01.png

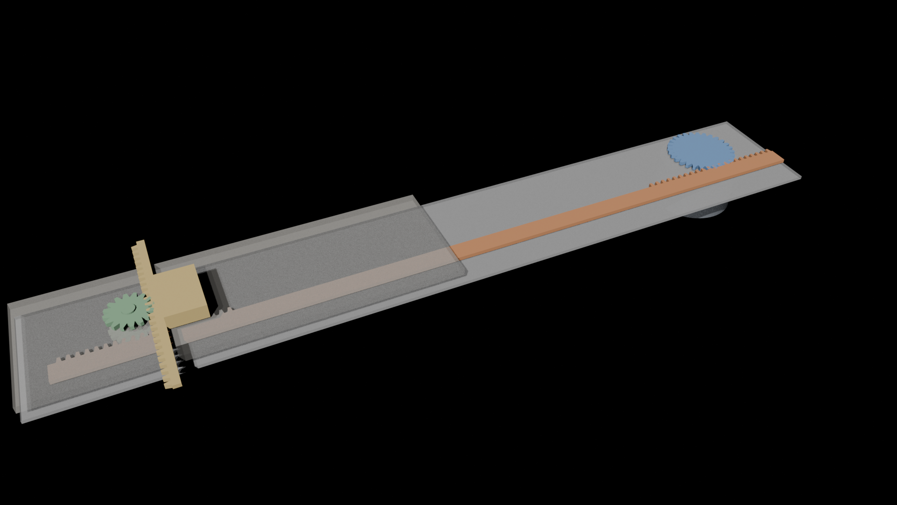
wiki/img/reika_obsh_f01.png
