Korvova/gitar/wiki/img/shatun_idea_strip.png

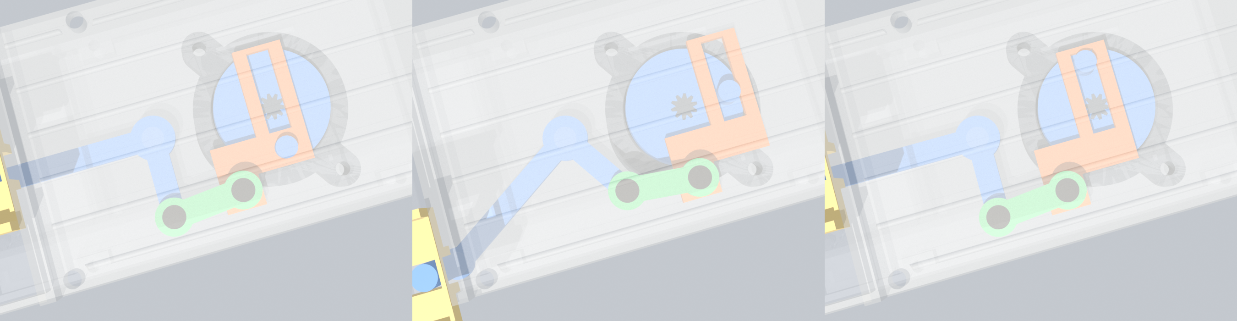
wiki/img/shatun_idea_strip.png
