Korvova/gitar/wiki/img/sim4_north_deka.jpg

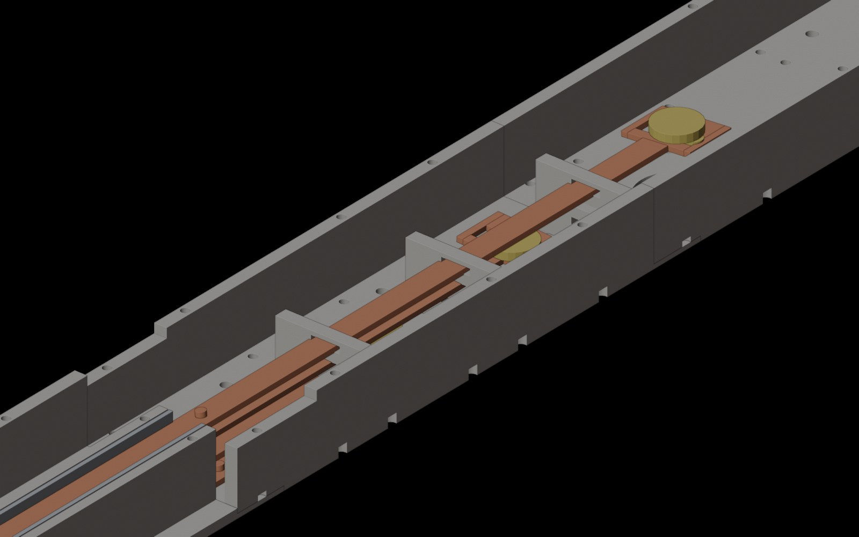
wiki/img/sim4_north_deka.jpg
