Korvova/gitar/wiki/img/sim4_south_carts.jpg

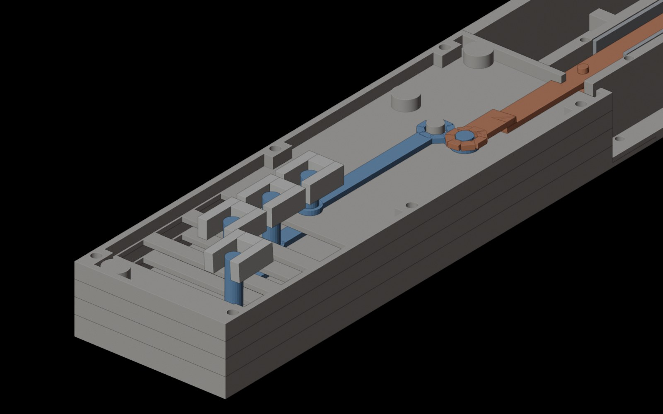
wiki/img/sim4_south_carts.jpg
