Korvova/gitar/wiki/img/vint_krup_f31.png

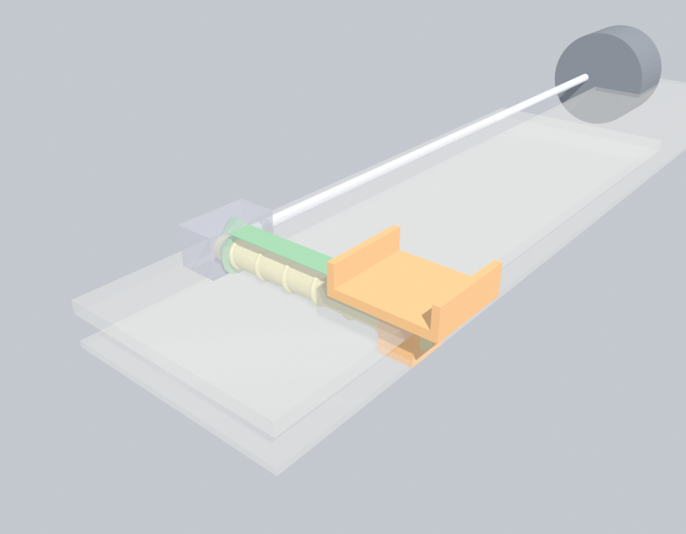
wiki/img/vint_krup_f31.png
