Korvova/gitar/wiki/img/vint_obsh_f01.png

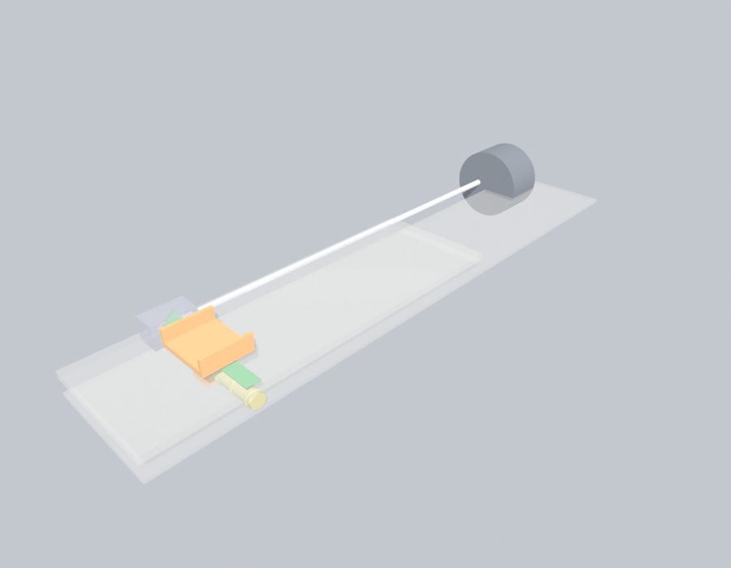
wiki/img/vint_obsh_f01.png
