Korvova/gitar/wiki/img/vint_obsh_strip.png

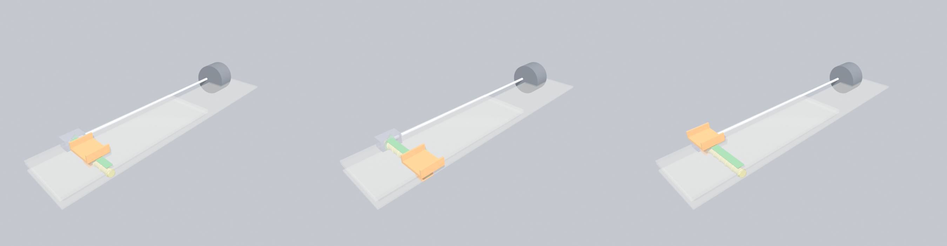
wiki/img/vint_obsh_strip.png
