Korvova/gitar/2-0/teleskop_v4/kaseta_stl/asm_tray.stl

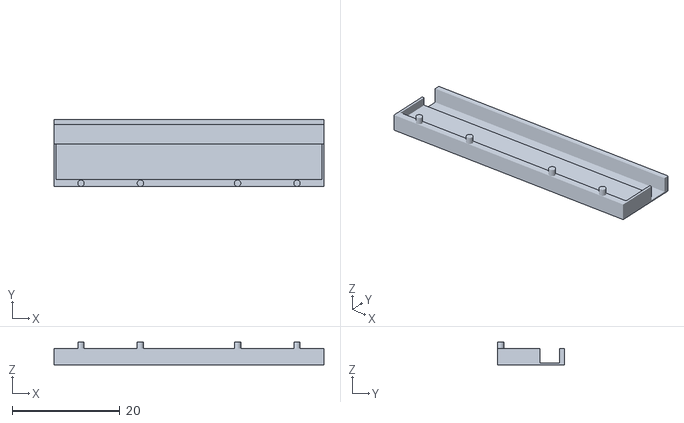
[picture p257: CAD file, 2026-11-12]
2-0/teleskop_v4/kaseta_stl/asm_tray.stl
50.0 x 12.5 x 4.20
