Korvova/gitar/2-0/teleskop_v4/kaseta_stl/asm_btns.stl

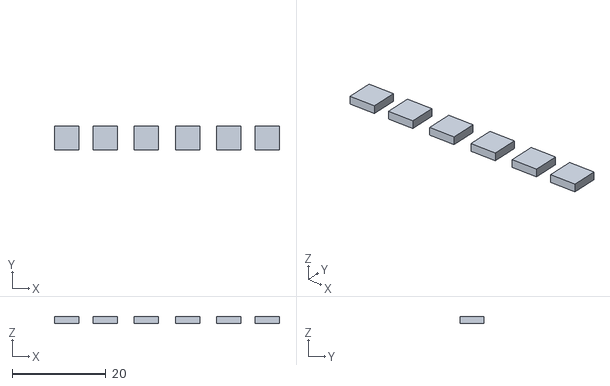
[picture p258: CAD file, 2026-11-12]
2-0/teleskop_v4/kaseta_stl/asm_btns.stl
48.0 x 5.20 x 1.50
