Korvova/gitar/2-0/teleskop_v4/kaseta_stl/asm_lid.stl

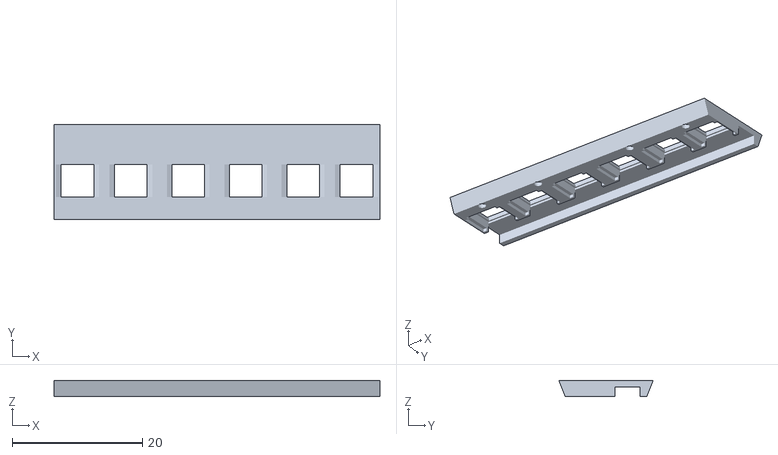
[picture p259: CAD file, 2026-11-12]
2-0/teleskop_v4/kaseta_stl/asm_lid.stl
50.0 x 14.5 x 2.50
