Korvova/gitar/2-0/astra/deka-astra/assembly_astra_A3.step

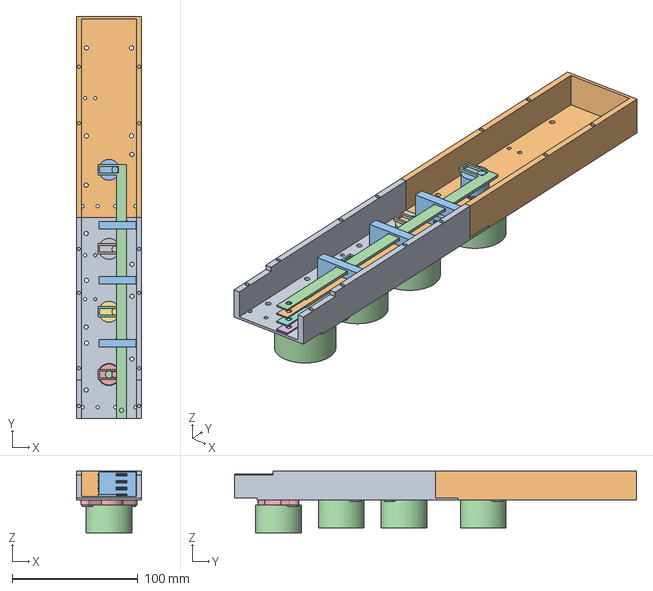
[picture p260: CAD file, 2026-09-27]
2-0/astra/deka-astra/assembly_astra_A3.step
52.0 x 320.0 x 49.0 mm
