Korvova/gitar/2-0/teleskop_v4/kaseta_stl/asm_caps.stl

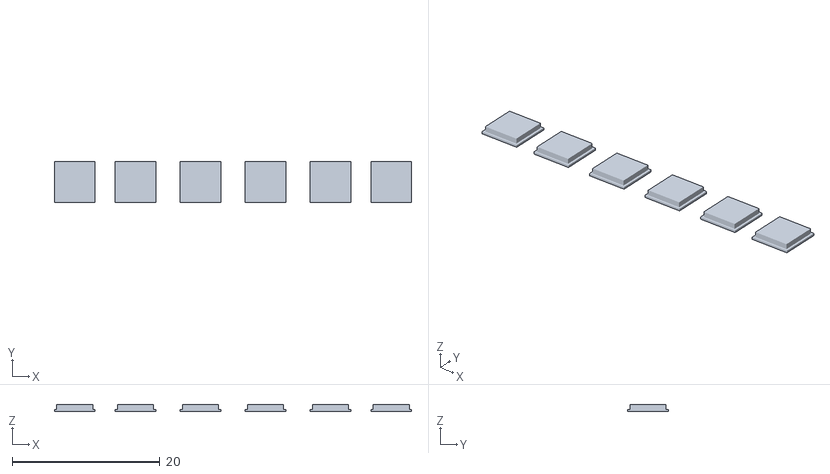
[picture p261: CAD file, 2026-11-12]
2-0/teleskop_v4/kaseta_stl/asm_caps.stl
48.3 x 5.50 x 1.00
