Korvova/gitar/2-0/teleskop_v4/kaseta_stl/asm_plate.stl

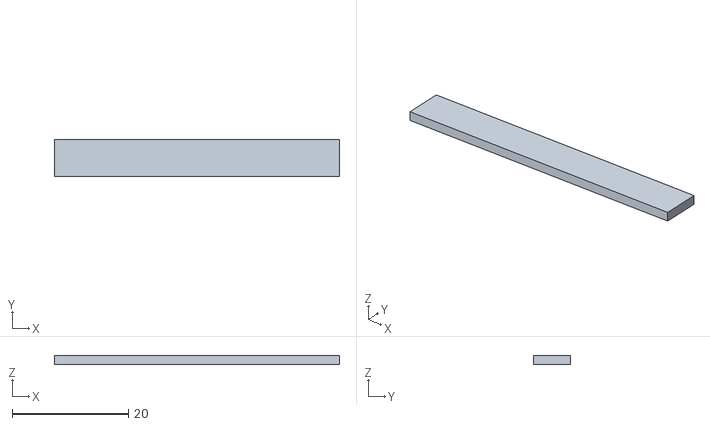
[picture p262: CAD file, 2026-11-12]
2-0/teleskop_v4/kaseta_stl/asm_plate.stl
49.0 x 6.40 x 1.50
