Korvova/gitar/2-0/astra/deka-astra/guide_astra_A2.step

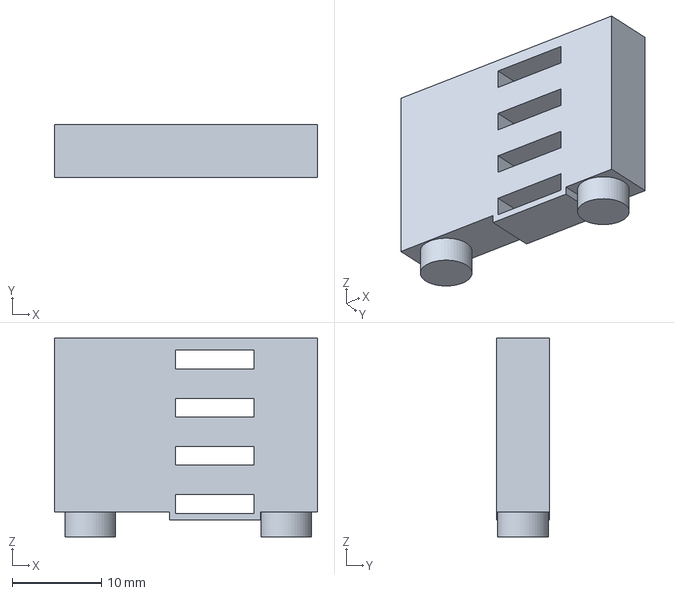
[picture p263: CAD file, 2026-09-27]
2-0/astra/deka-astra/guide_astra_A2.step
29.5 x 6.00 x 22.3 mm
