Korvova/gitar/2-0/astra/deka-astra/plates/01_A2_D1_and_3_guides.3mf

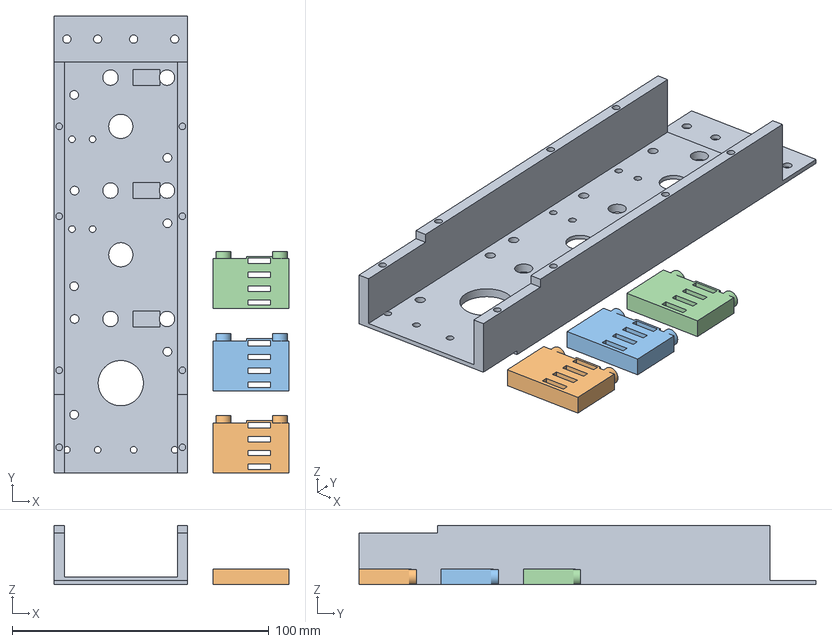
[picture p264: CAD file, 2026-09-27]
2-0/astra/deka-astra/plates/01_A2_D1_and_3_guides.3mf
91.5 x 178.0 x 23.0 mm
D1_A2
Guide_A2_1
Guide_A2_2
Guide_A2_3
