Korvova/gitar/2-0/astra/deka-astra/stl/reference_d2_v3.stl

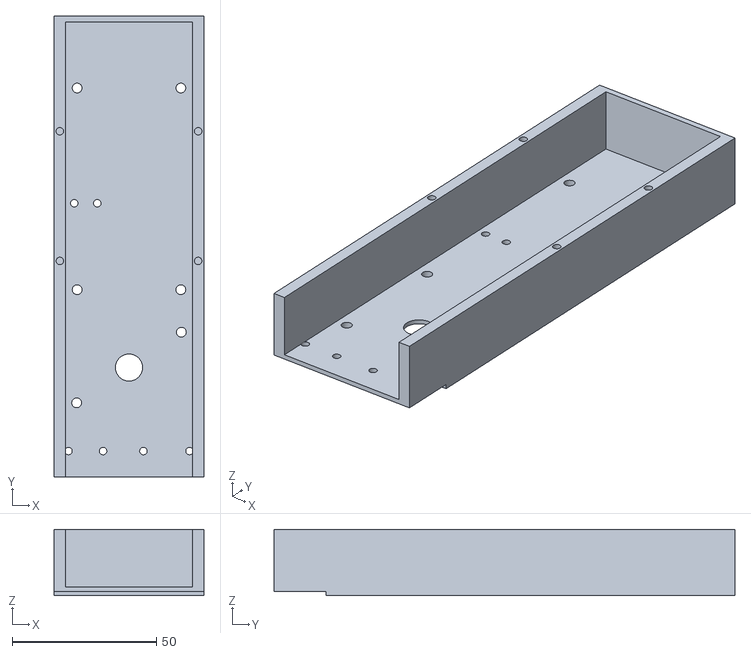
[picture p265: CAD file, 2026-09-27]
2-0/astra/deka-astra/stl/reference_d2_v3.stl
52.0 x 160.0 x 23.0
