Korvova/gitar/2-0/astra/deka-astra/viewer/meshes/motor_2.stl

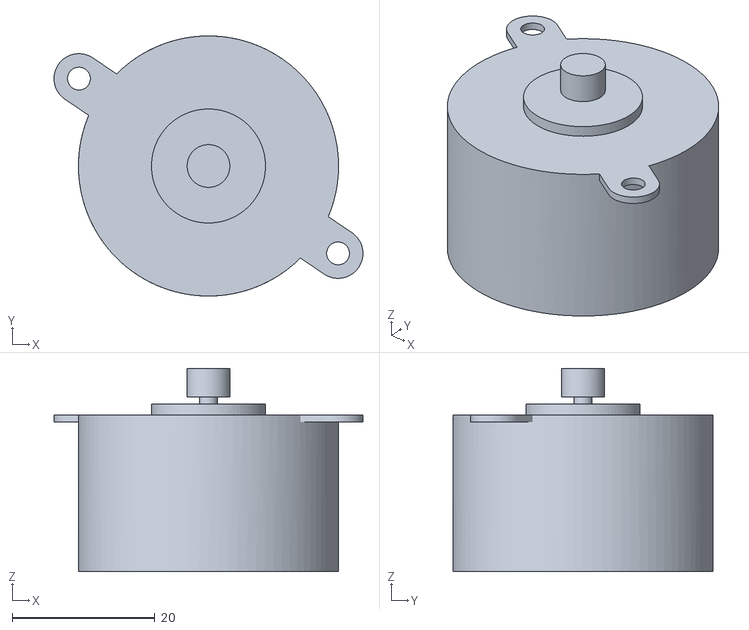
[picture p266: CAD file, 2026-09-27]
2-0/astra/deka-astra/viewer/meshes/motor_2.stl
43.4 x 36.5 x 28.5
