Korvova/gitar/2-0/full_v5/asm/tray.stl

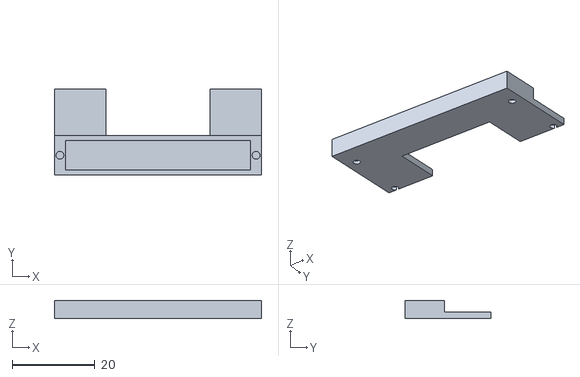
[picture p267: CAD file, 2026-11-13]
2-0/full_v5/asm/tray.stl
50.0 x 20.8 x 4.40
