Korvova/gitar/2-0/full_v5/stl/06_telezhka.stl

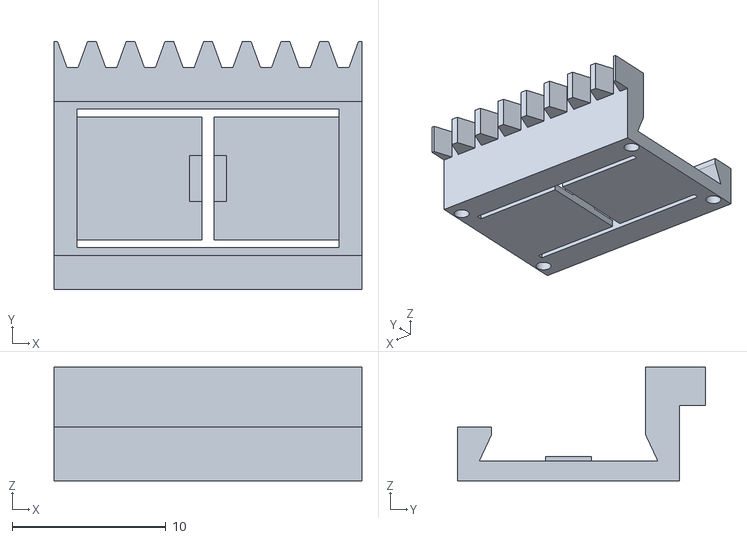
[picture p268: CAD file, 2026-11-13]
2-0/full_v5/stl/06_telezhka.stl
20.0 x 16.1 x 7.40
