Korvova/gitar/2-0/kasseta/01_osnovanie.step

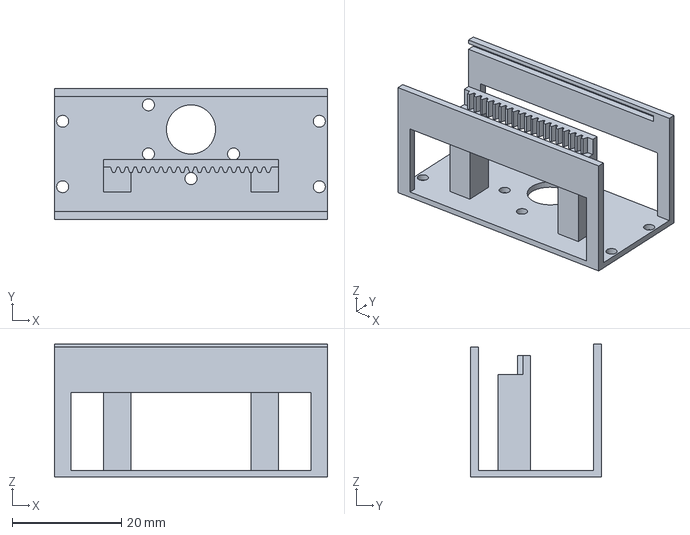
[picture p269: CAD file, 2026-11-04]
2-0/kasseta/01_osnovanie.step
50.0 x 24.0 x 24.4 mm
