Korvova/gitar/2-0/most_test/asm/тележка.stl

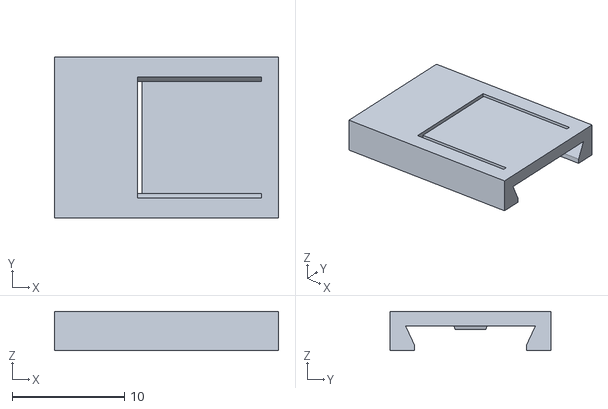
[picture p270: CAD file, 2026-11-13]
2-0/most_test/asm/тележка.stl
20.0 x 14.4 x 3.50
