Korvova/gitar/2-0/most_v2/asm/lid.stl

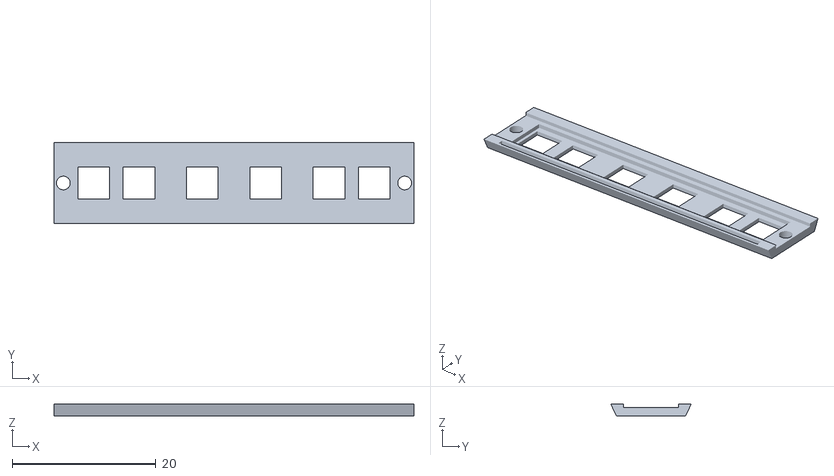
[picture p271: CAD file, 2026-11-13]
2-0/most_v2/asm/lid.stl
50.0 x 11.2 x 1.70
