Korvova/gitar/2-0/most_v2/stl/05_telezhka.stl

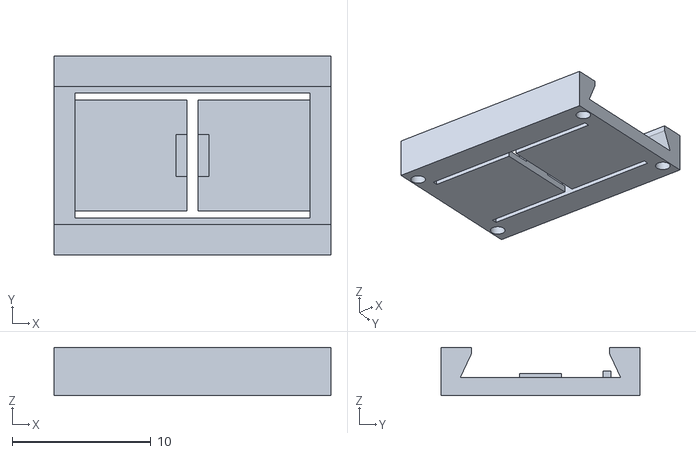
[picture p272: CAD file, 2026-11-13]
2-0/most_v2/stl/05_telezhka.stl
20.0 x 14.4 x 3.50
