Korvova/gitar/2-0/Print/Print/gt4_platforma.stl

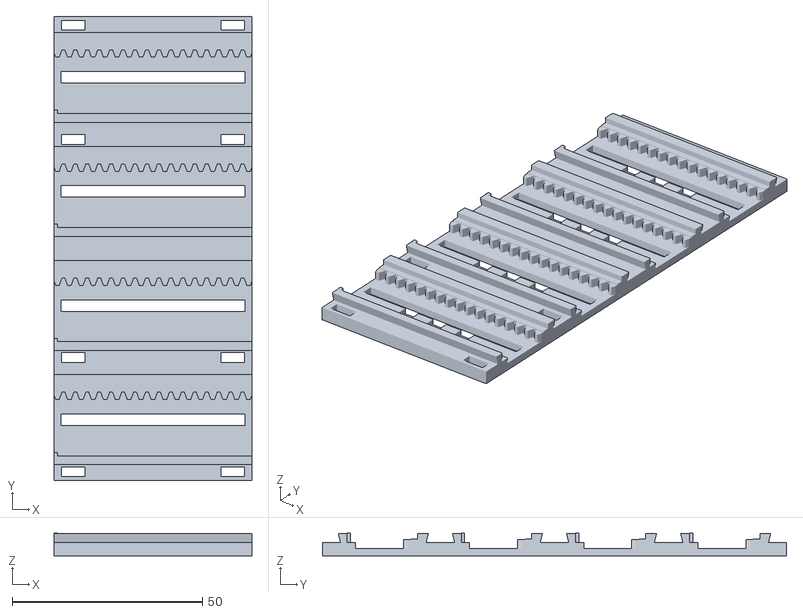
[picture p273: CAD file, 2026-11-09]
2-0/Print/Print/gt4_platforma.stl
52.0 x 122.0 x 6.00
