Korvova/gitar/2-0/Print3mf/117_balka_v2.3mf

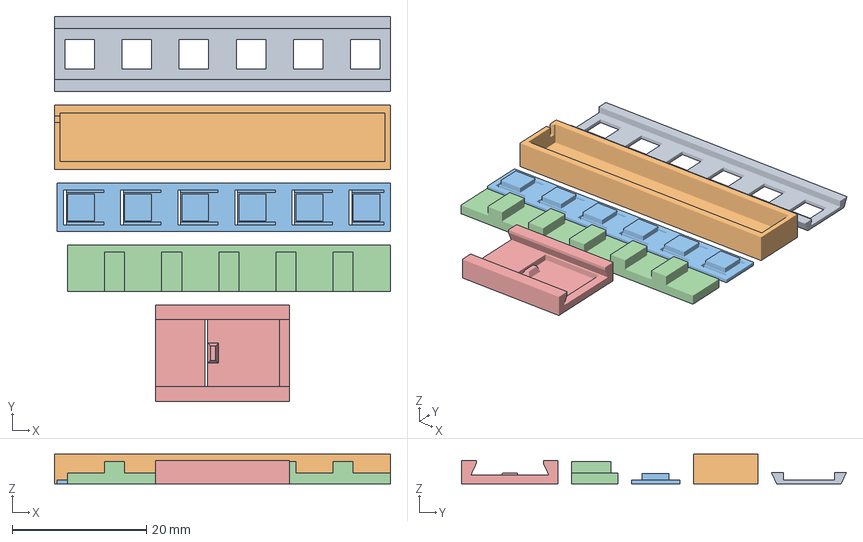
[picture p274: CAD file, 2026-11-13]
2-0/Print3mf/117_balka_v2.3mf
50.0 x 57.3 x 4.40 mm
C:/App/gitar/2-0/most_test/stl/03_kryshka.stl
C:/App/gitar/2-0/most_test/stl/01_korpus.stl
C:/App/gitar/2-0/most_test/stl/04_lenta_PLA_ili_TPU.stl
C:/App/gitar/2-0/most_test/stl/02_plastina_jachejki.stl
C:/App/gitar/2-0/most_test/stl/05_telezhka.stl
