Korvova/gitar/2-0/teleskop_v4/asm/cart.stl

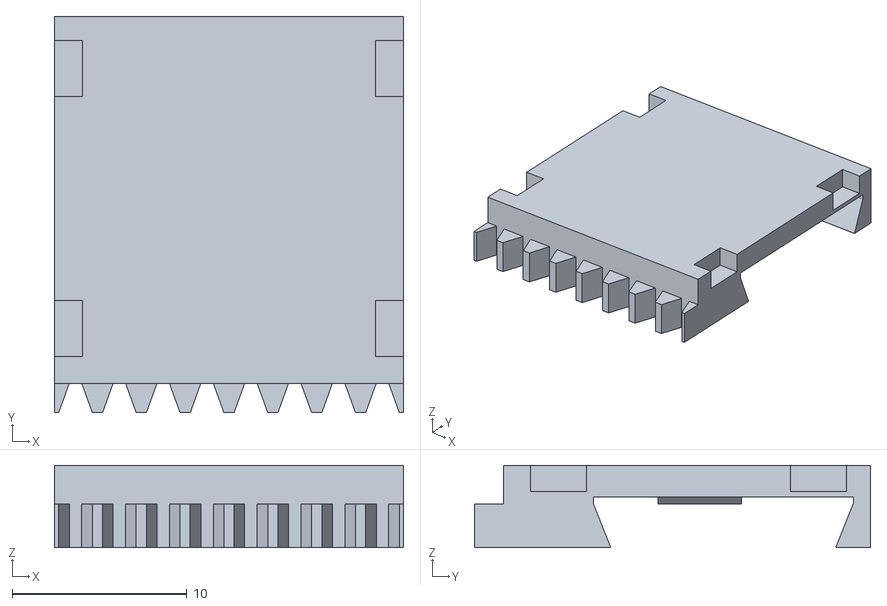
[picture p275: CAD file, 2026-11-12]
2-0/teleskop_v4/asm/cart.stl
20.0 x 22.7 x 4.70
