Korvova/gitar/2-0/teleskop_v4/stl/08_telezhka.stl

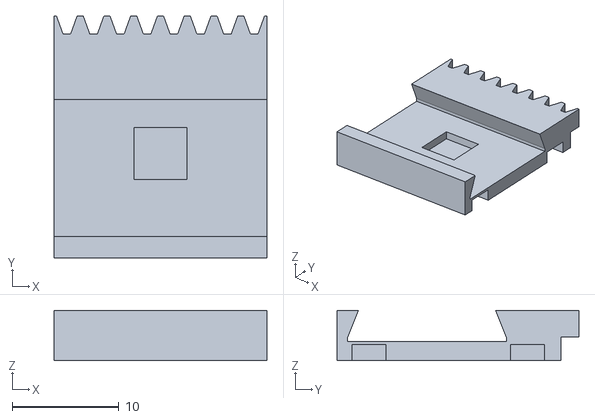
[picture p276: CAD file, 2026-11-12]
2-0/teleskop_v4/stl/08_telezhka.stl
20.0 x 22.7 x 4.70
