Korvova/gitar/2-0/подложка.stl

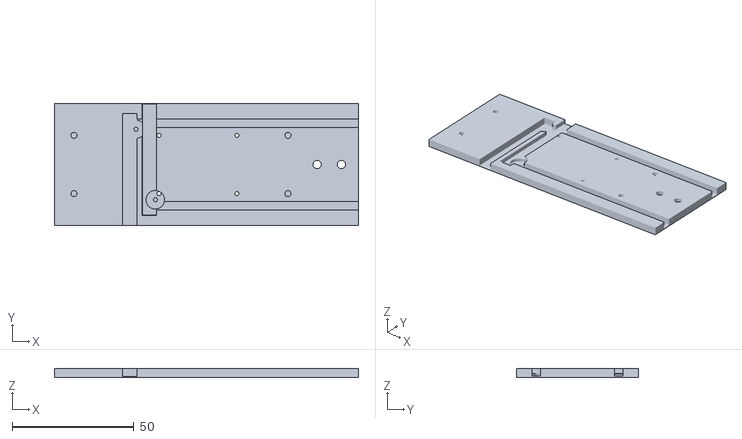
[picture p277: CAD file, 2026-07-25]
2-0/подложка.stl
125.0 x 50.0 x 3.50
