Korvova/gitar/3D model/palka2_seredina.stl

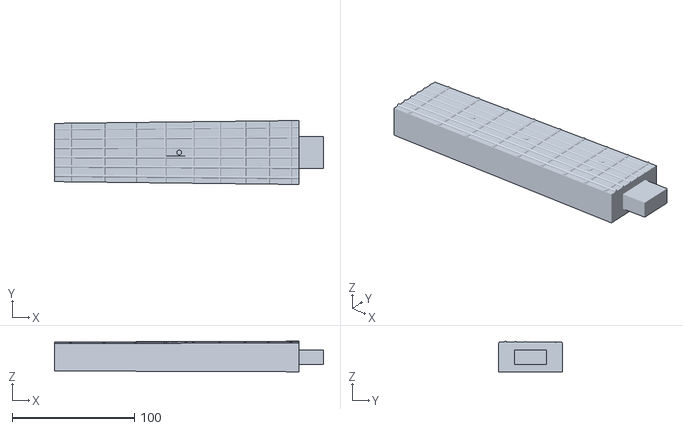
[picture p278: CAD file, 2026-09-08]
3D model/palka2_seredina.stl
220.0 x 52.3 x 25.0
