Korvova/gitar/_архив/fcstd_старое/Lane_proto_справочно.FCStd

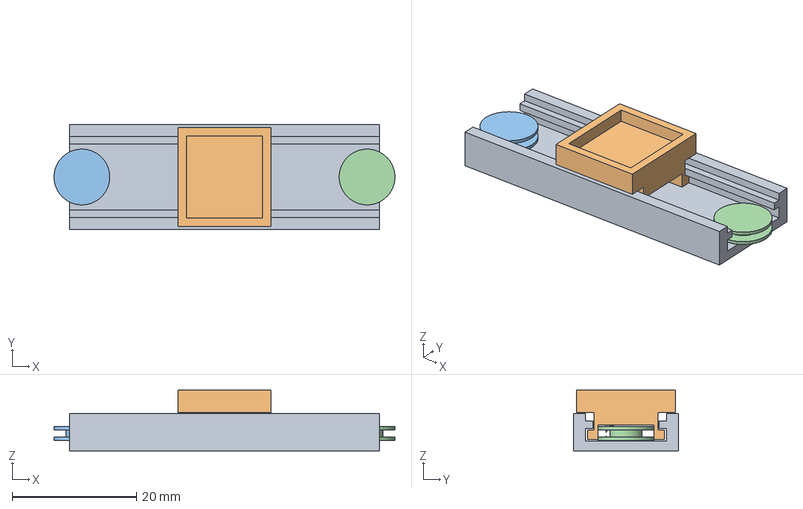
[picture p279: CAD file, 2026-09-08]
_архив/fcstd_старое/Lane_proto_справочно.FCStd
55.0 x 17.0 x 9.80 mm
Lane_base
Carriage
PulleyA
PulleyB
