Korvova/gitar/Drive_test.FCStd

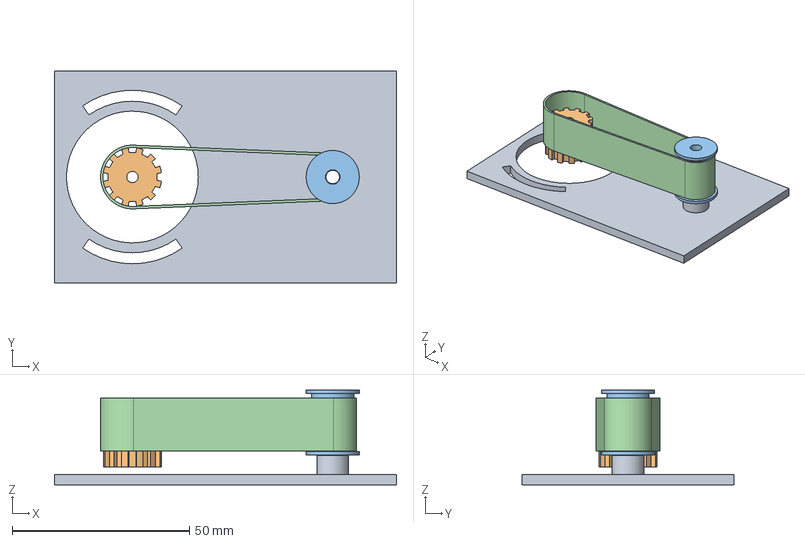
[picture p280: CAD file, 2026-09-08]
Drive_test.FCStd
96.6 x 60.0 x 26.8 mm
Base
BeltPinion12T
Idler
Belt_ghost
