Korvova/gitar/plata-4-motora/models/s2209.step

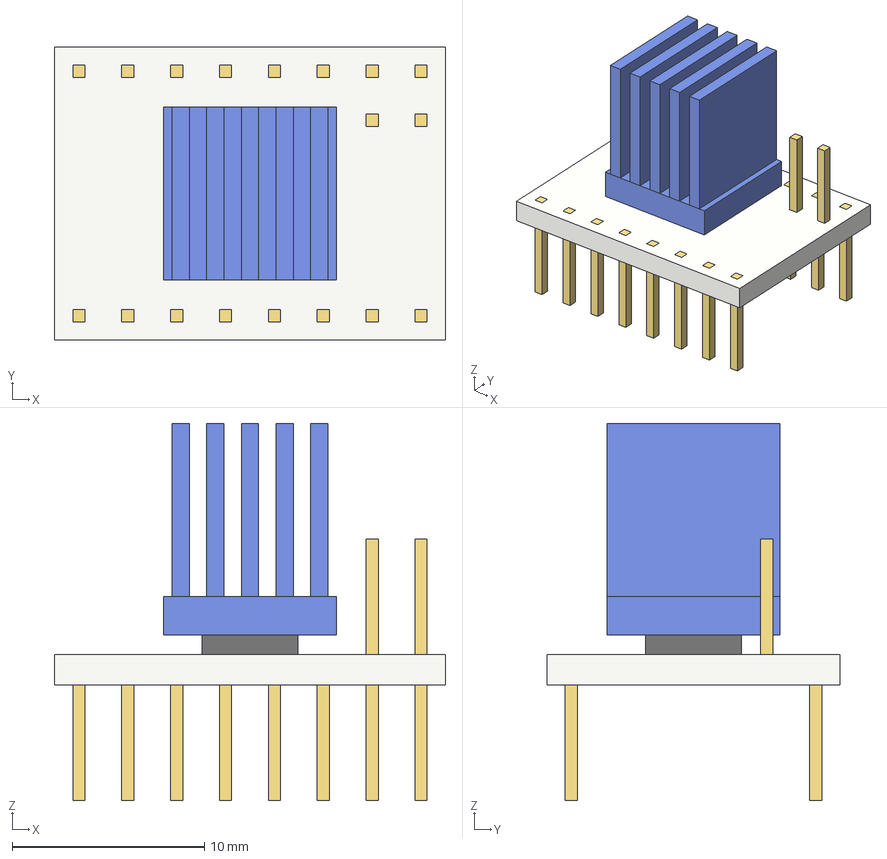
[picture p281: CAD file, 2026-09-19]
plata-4-motora/models/s2209.step
20.3 x 15.2 x 19.6 mm
pcb
chip
heatsink
fin x 5
pin x 16
diag x 2
