Korvova/gitar/print/1/zona_body.stl

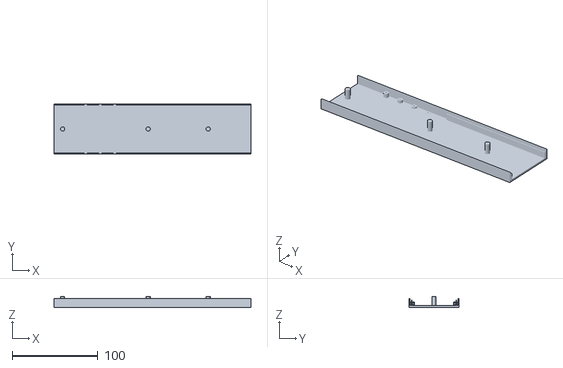
[picture p282: CAD file, 2026-09-08]
print/1/zona_body.stl
230.0 x 58.0 x 12.6
