Korvova/gitar/print/2/seg3_cover.stl

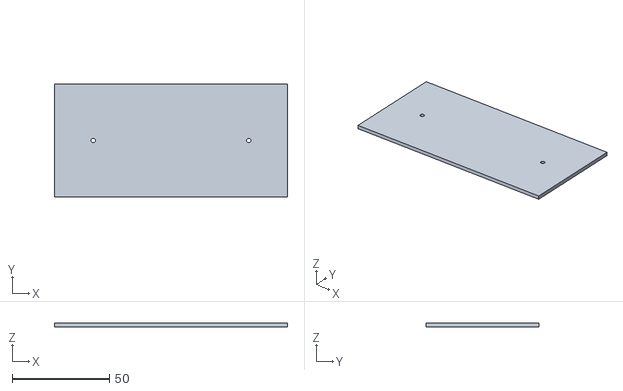
[picture p283: CAD file, 2026-09-08]
print/2/seg3_cover.stl
120.0 x 58.0 x 2.00
