Korvova/gitar/print/_архив/roller6_x8.stl

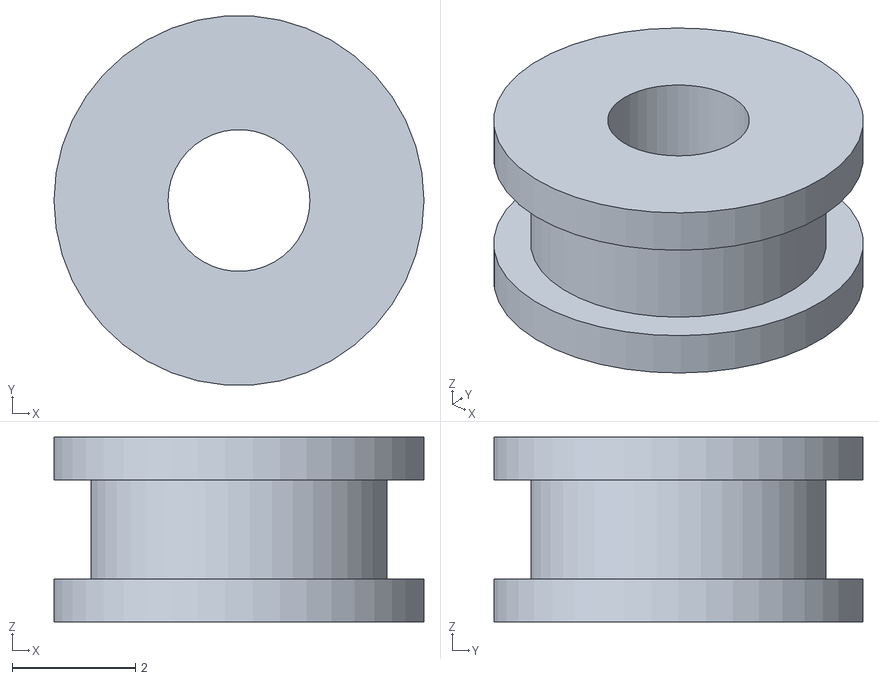
[picture p284: CAD file, 2026-09-08]
print/_архив/roller6_x8.stl
6.00 x 5.98 x 3.00
