Korvova/gitar/print/_архив/ленточная_версия/1/deck1.stl

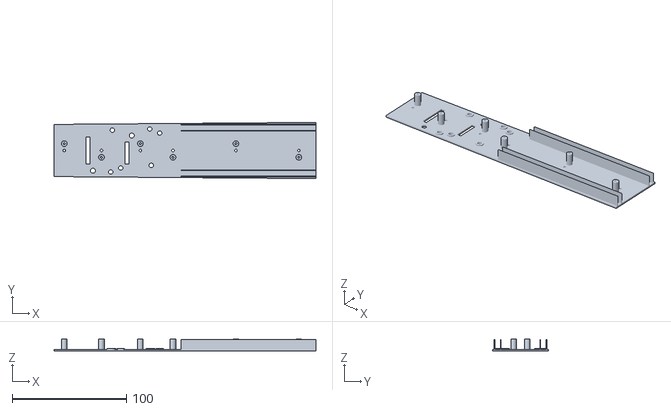
[picture p285: CAD file, 2026-09-08]
print/_архив/ленточная_версия/1/deck1.stl
229.0 x 49.2 x 10.8
