Korvova/gitar/print/_архив/ленточная_версия/2/deka_panel.stl

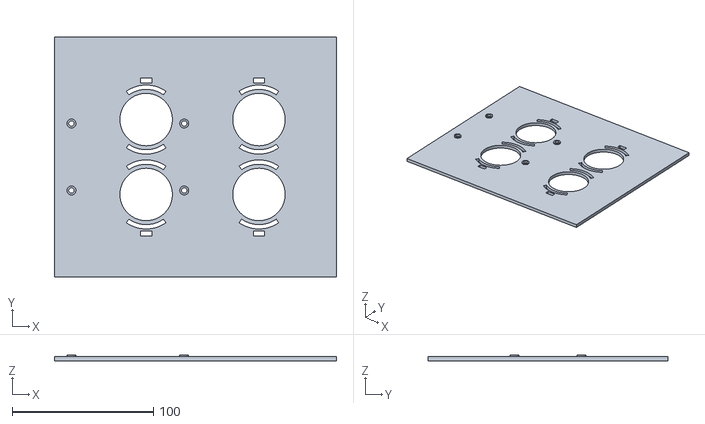
[picture p286: CAD file, 2026-09-08]
print/_архив/ленточная_версия/2/deka_panel.stl
200.0 x 170.0 x 4.00
