Korvova/gitar/print/_архив/ленточная_версия/3/belt_lane1.stl

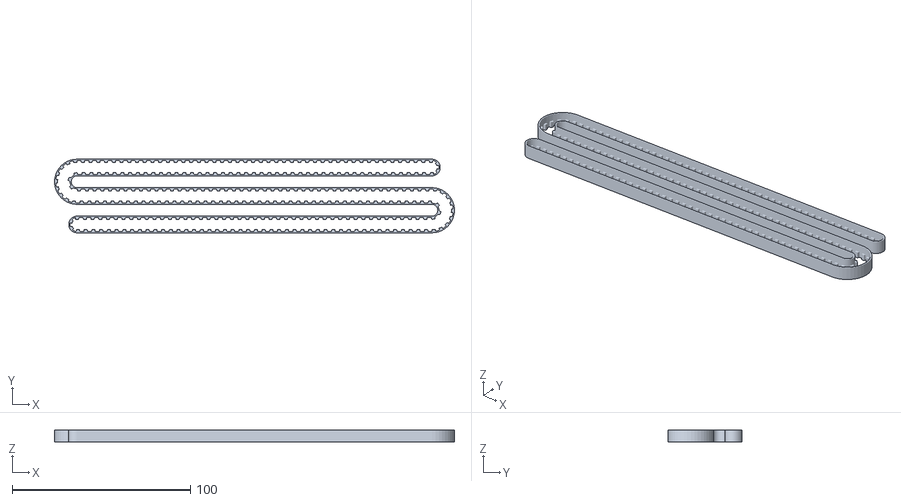
[picture p287: CAD file, 2026-09-08]
print/_архив/ленточная_версия/3/belt_lane1.stl
224.7 x 41.4 x 7.00
