Korvova/gitar/2-0/astra/deka-astra/plates/03_v3_tails_optional.3mf

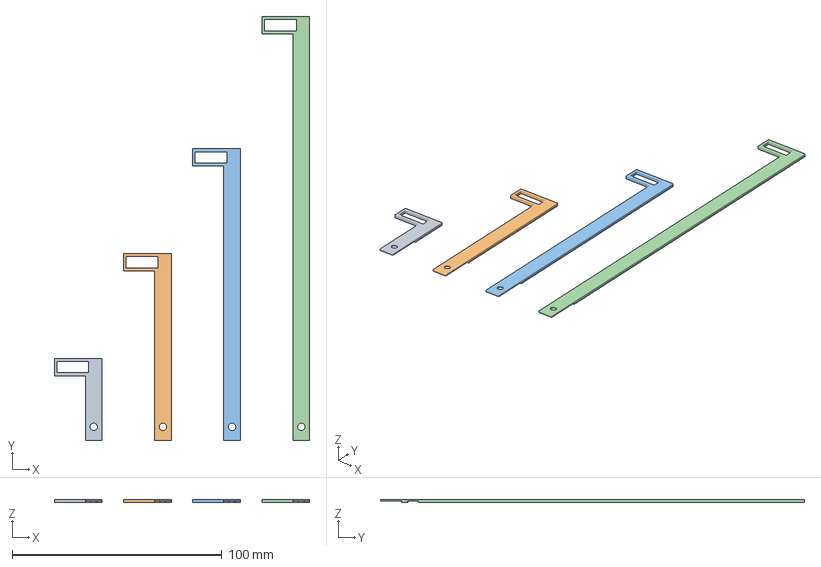
[picture p289: CAD file, 2026-09-27]
2-0/astra/deka-astra/plates/03_v3_tails_optional.3mf
121.8 x 202.2 x 1.60 mm
