Korvova/gitar/2-0/astra/deka-astra/stl/reference_tail0_v3.stl

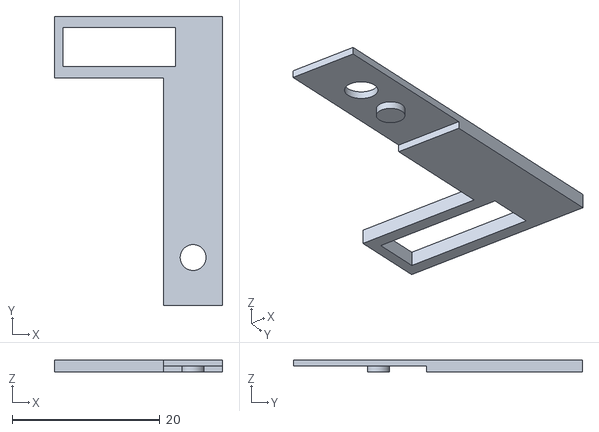
[picture p290: CAD file, 2026-09-27]
2-0/astra/deka-astra/stl/reference_tail0_v3.stl
22.8 x 39.2 x 1.60
