Korvova/gitar/2-0/astra/deka-astra/viewer/meshes/crank_0.stl

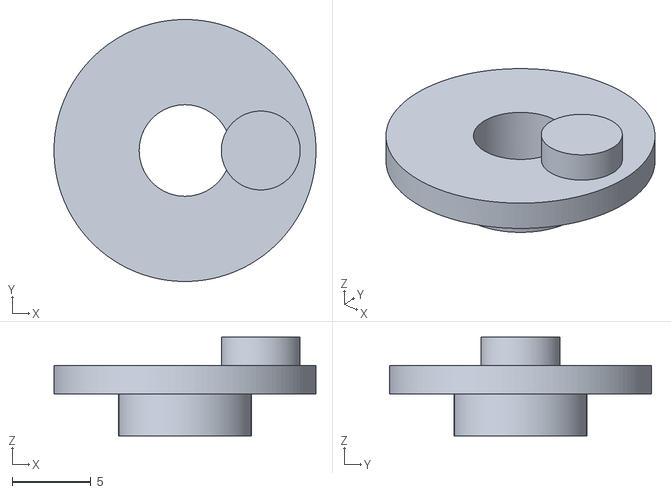
[picture p291: CAD file, 2026-09-27]
2-0/astra/deka-astra/viewer/meshes/crank_0.stl
16.6 x 16.6 x 6.25
