Korvova/gitar/2-0/full_v5/asm/coins_b.stl

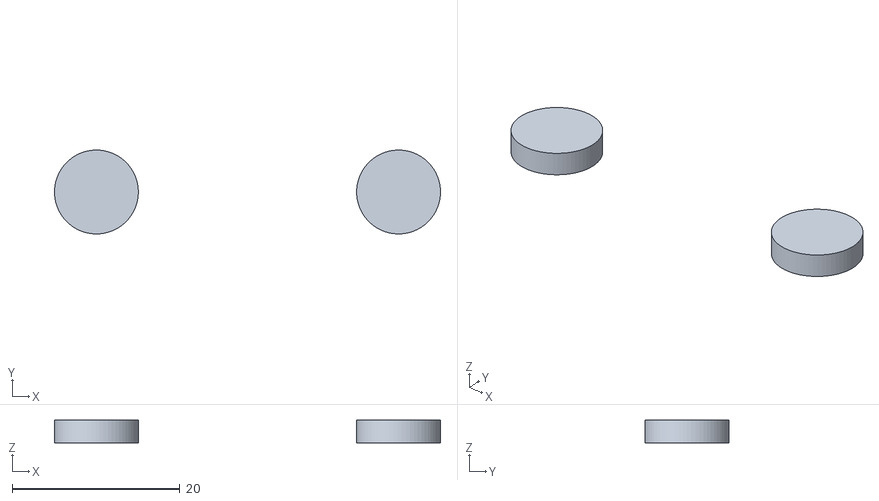
[picture p292: CAD file, 2026-11-13]
2-0/full_v5/asm/coins_b.stl
46.0 x 10.00 x 2.70
