Korvova/gitar/2-0/full_v5/stl/07_nakladka_telezhki.stl

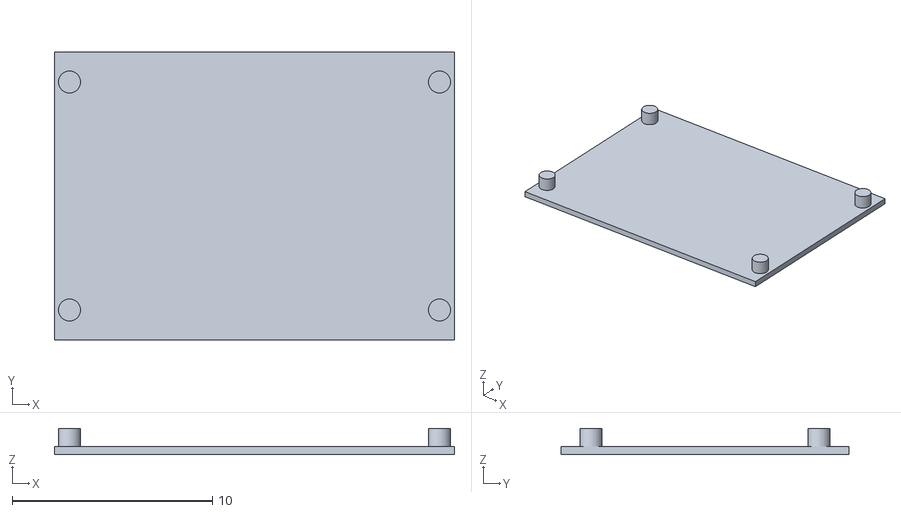
[picture p293: CAD file, 2026-11-13]
2-0/full_v5/stl/07_nakladka_telezhki.stl
20.0 x 14.4 x 1.30
