Korvova/gitar/2-0/kasseta/05_telezhka.step

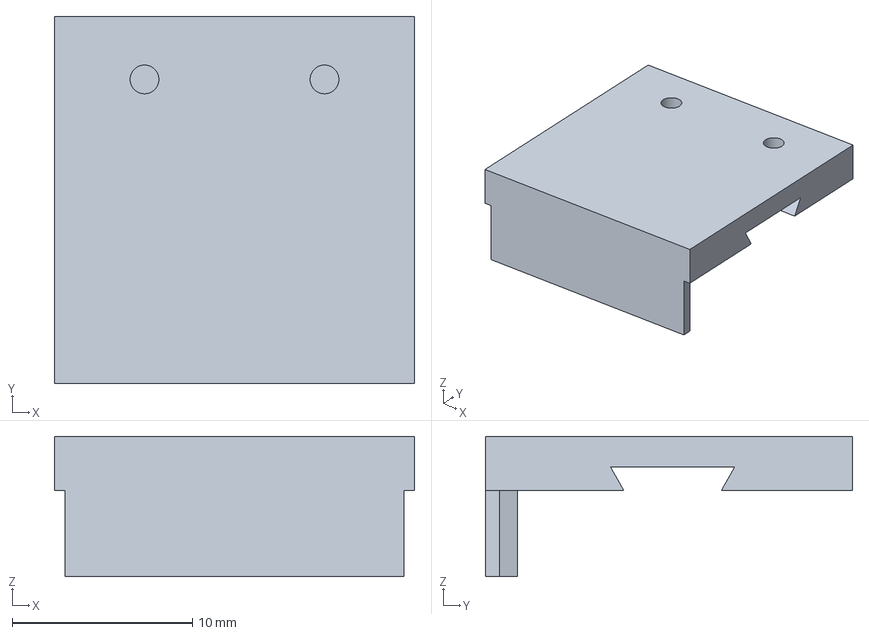
[picture p294: CAD file, 2026-11-04]
2-0/kasseta/05_telezhka.step
20.0 x 20.4 x 7.80 mm
