Korvova/gitar/2-0/most_test/asm/лента.stl

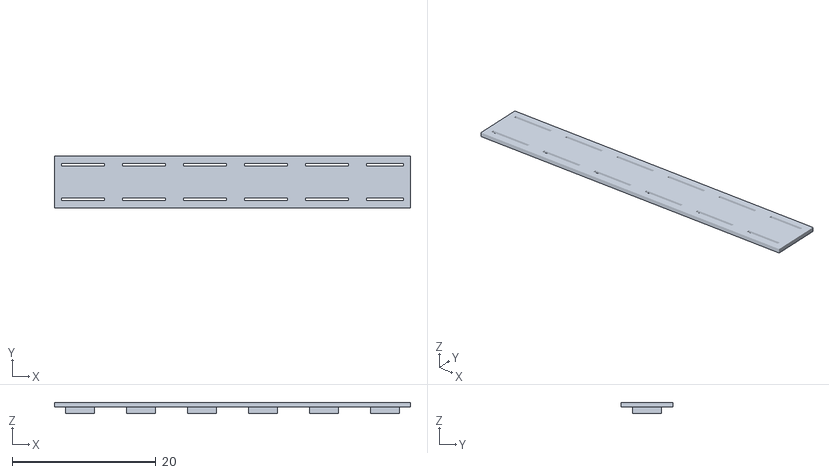
[picture p295: CAD file, 2026-11-13]
2-0/most_test/asm/лента.stl
49.6 x 7.20 x 1.50
