Korvova/gitar/2-0/Print/Print/gt_niz.stl

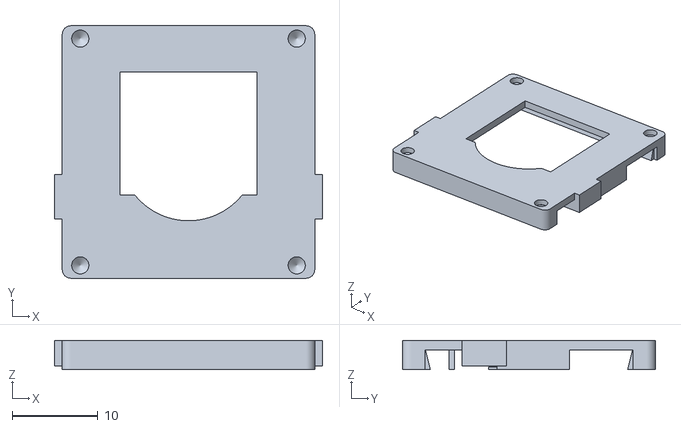
[picture p296: CAD file, 2026-11-09]
2-0/Print/Print/gt_niz.stl
31.2 x 29.4 x 3.40
