Korvova/gitar/2-0/Print3mf/114_grif_telezhka.3mf

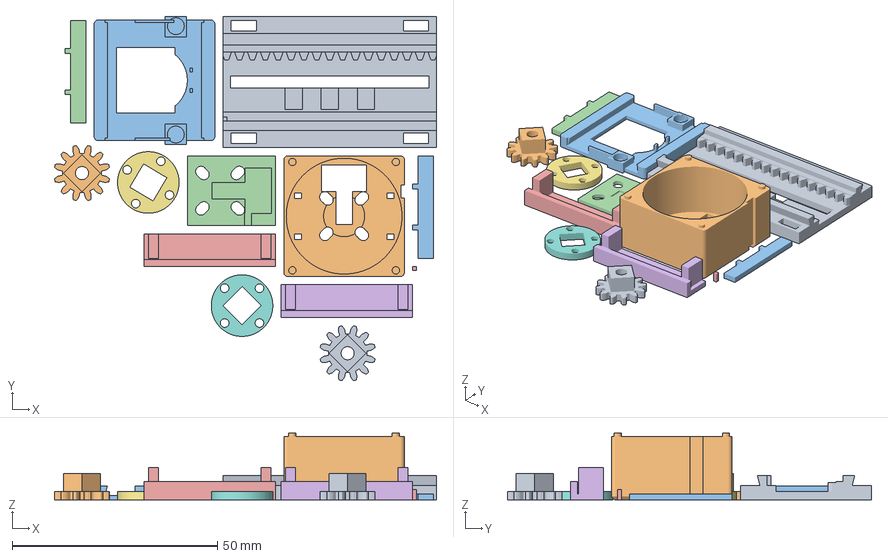
[picture p297: CAD file, 2026-11-09]
2-0/Print3mf/114_grif_telezhka.3mf
93.1 x 88.8 x 16.3 mm
gt_platforma_orient.stl
gt_kubik_orient.stl
gt_niz_orient.stl
gt_plastina_orient.stl
gt_vkladka_orient.stl x 2
gt_flanec_orient.stl x 2
gt_shesternya_orient.stl x 2
gt_bort_orient.stl x 2
gt_upor_orient.stl
