Korvova/gitar/2-0/teleskop_v4/stl/09_bort_x2.stl

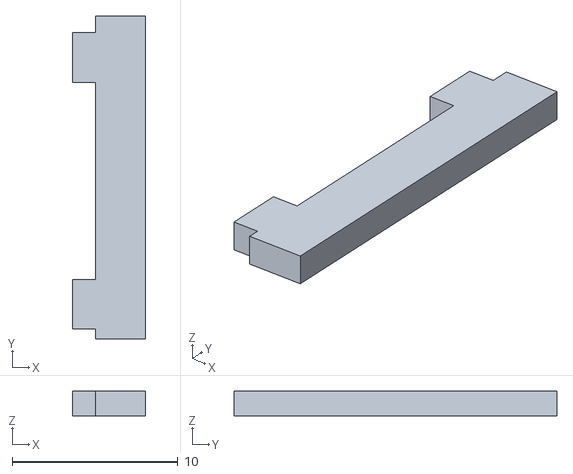
[picture p299: CAD file, 2026-11-12]
2-0/teleskop_v4/stl/09_bort_x2.stl
4.40 x 19.5 x 1.50
