Korvova/gitar/2-0/слой.stl

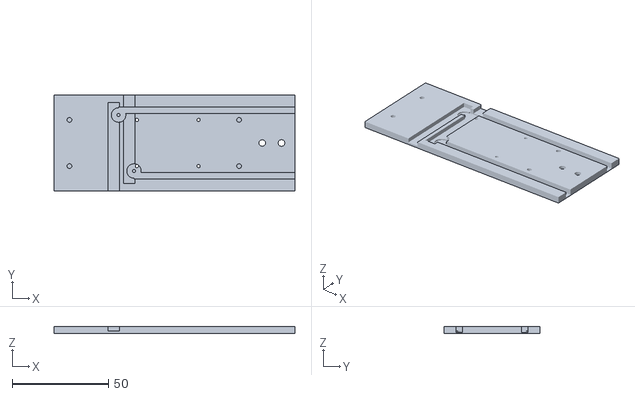
[picture p300: CAD file, 2026-07-25]
2-0/слой.stl
125.0 x 50.0 x 3.50
