Korvova/gitar/3-0/19.54_balka_v2/02_plastina_jachejki.stl

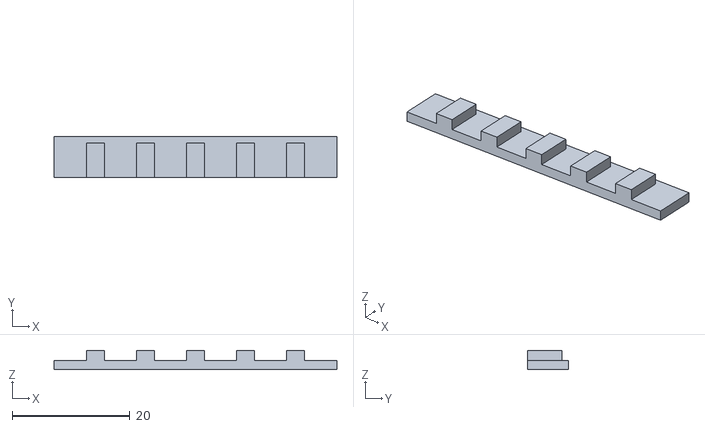
[picture p301: CAD file, 2026-11-13]
3-0/19.54_balka_v2/02_plastina_jachejki.stl
48.1 x 6.90 x 3.30
