Korvova/gitar/3-0/Print3mf/116_grif_4_palca.3mf

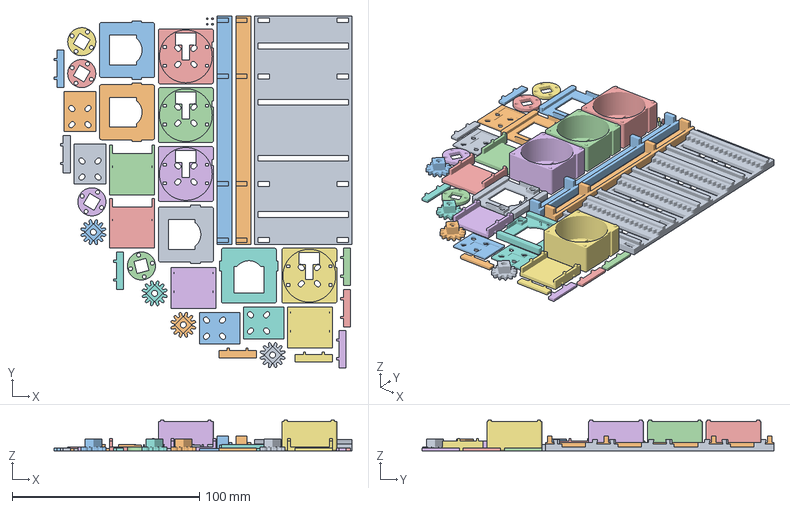
[picture p302: CAD file, 2026-11-09]
3-0/Print3mf/116_grif_4_palca.3mf
159.1 x 188.0 x 16.3 mm
gt4_platforma_orient.stl
gt4_vkladka_orient.stl x 2
gt_kubik_orient.stl x 4
gt_niz_orient.stl x 4
gt4_lozhe_9_orient.stl x 2
gt4_lozhe_3_orient.stl x 2
gt_plastina_orient.stl x 4
gt_flanec_orient.stl x 4
gt_shesternya_orient.stl x 4
gt4_bort_orient.stl x 8
gt_upor_orient.stl x 4
