Korvova/gitar/3D model/palka3_k_deke.stl

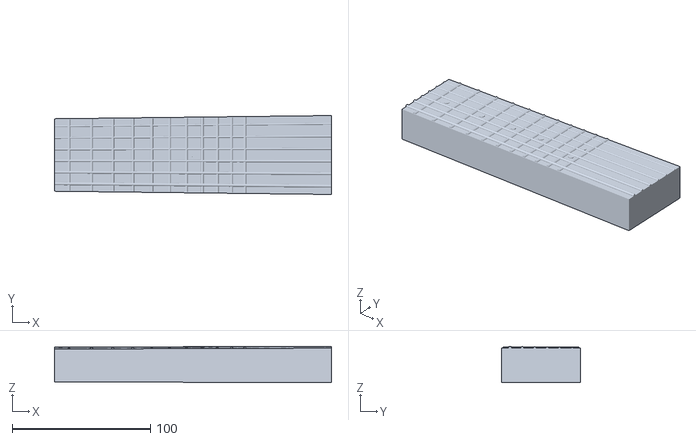
[picture p303: CAD file, 2026-09-08]
3D model/palka3_k_deke.stl
200.0 x 57.0 x 26.3
