Korvova/gitar/_архив/fcstd_старое/Stand_v3_view.FCStd

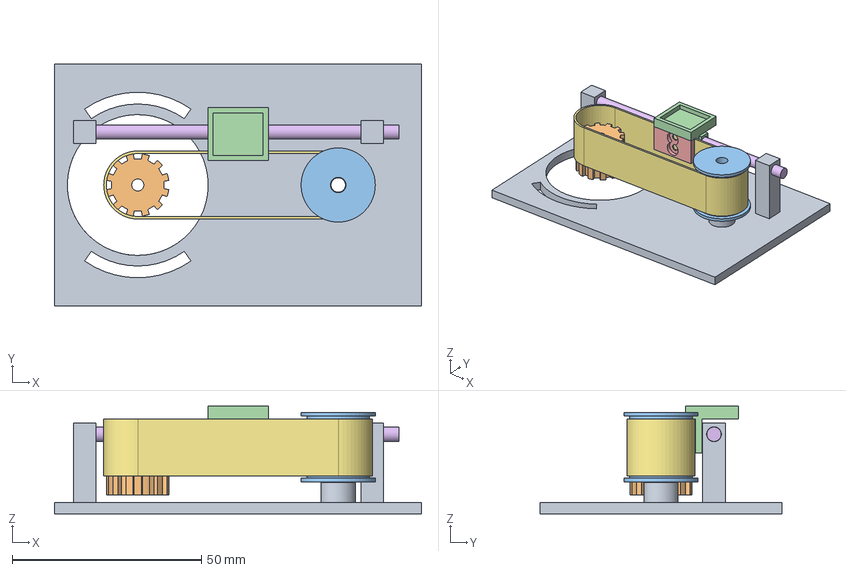
[picture p304: CAD file, 2026-09-08]
_архив/fcstd_старое/Stand_v3_view.FCStd
97.0 x 64.0 x 28.4 mm
Base
BeltPinion12T
Idler
CarriageOuter
CarriageInner
Rail
Belt_ghost
