Korvova/gitar/Cable_view.FCStd

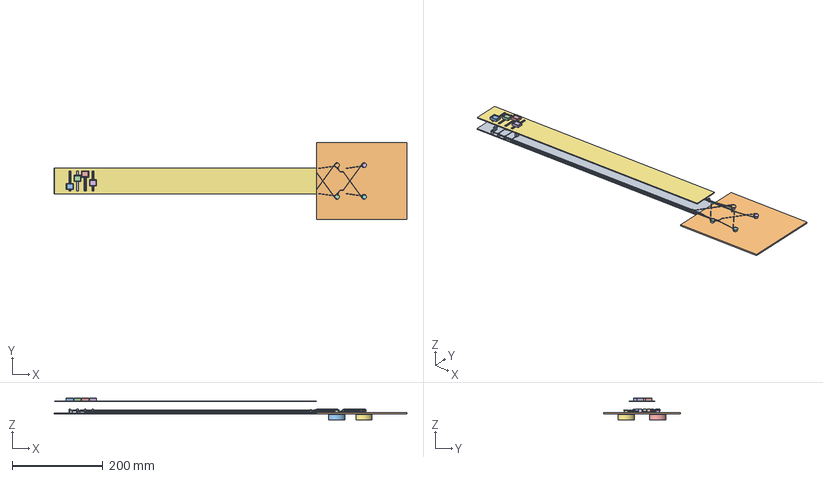
[picture p305: CAD file, 2026-09-08]
Cable_view.FCStd
780.0 x 170.0 x 47.6 mm
Grif_dno
Deka_plita
Lodochka1
Lodochka2
Lodochka3
Lodochka4
Rolik1p
Glazok1
Rolik1l
Nit1
Motor1
Baraban1
Rolik2p
Rolik2l
Glazok2
Nit2
Motor2
Baraban2
Rolik3p
Glazok3
Rolik3l
Nit3
Motor3
Baraban3
Rolik4p
Rolik4l
Glazok4
Nit4
Motor4
Baraban4
Grif_kryshka
