Korvova/gitar/plata-4-motora/models/esp32_devkit30.step

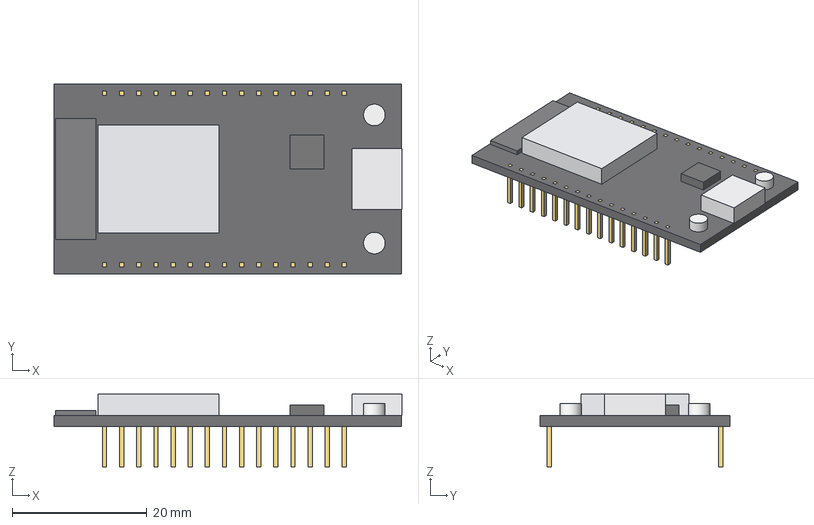
[picture p306: CAD file, 2026-09-19]
plata-4-motora/models/esp32_devkit30.step
51.6 x 28.2 x 10.8 mm
pcb
shield
antenna
usb
uart
btn x 2
pin x 30
