Korvova/gitar/print/1/zona_cover.stl

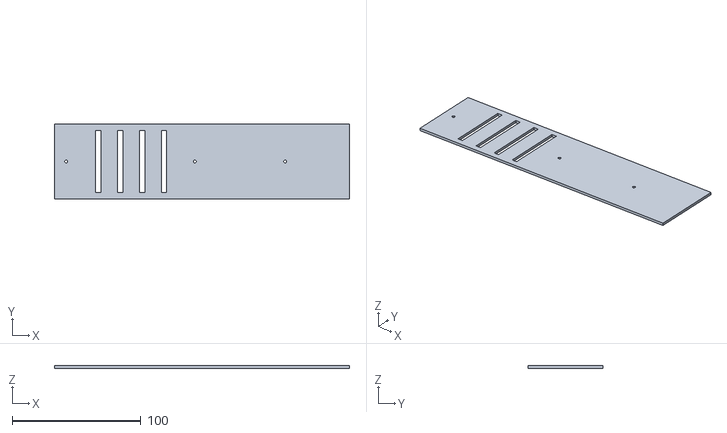
[picture p307: CAD file, 2026-09-08]
print/1/zona_cover.stl
229.0 x 58.0 x 2.00
