Korvova/gitar/print/2/drum_x4.stl

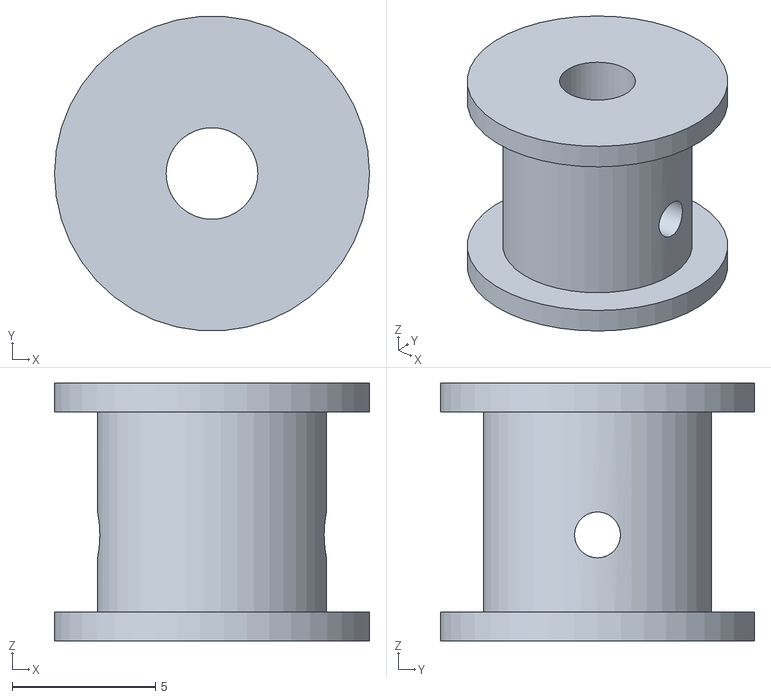
[picture p308: CAD file, 2026-09-08]
print/2/drum_x4.stl
11.0 x 11.0 x 9.00
