Korvova/gitar/print/_архив/carriage_outer.stl

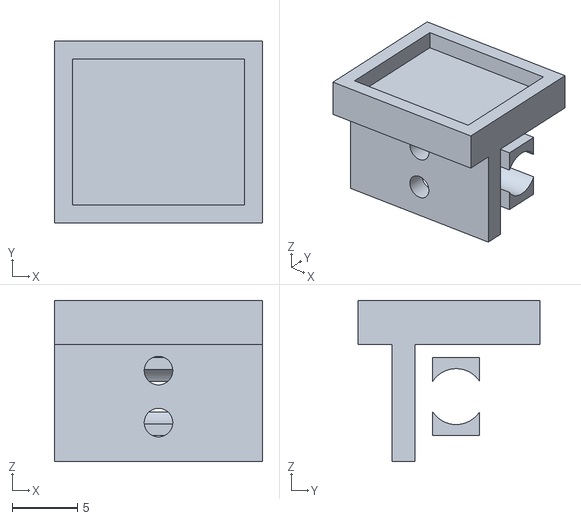
[picture p309: CAD file, 2026-09-08]
print/_архив/carriage_outer.stl
16.0 x 14.0 x 12.4
