Korvova/gitar/print/_архив/ленточная_версия/1/seg1_base.stl

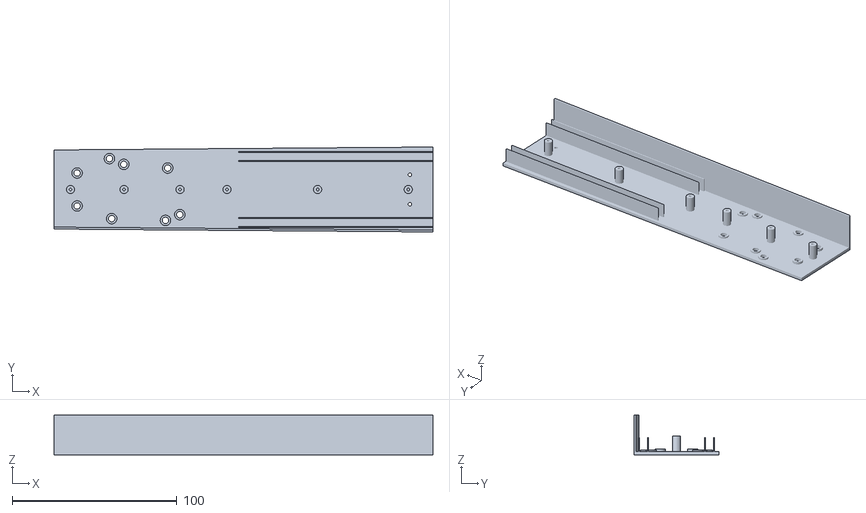
[picture p310: CAD file, 2026-09-08]
print/_архив/ленточная_версия/1/seg1_base.stl
230.0 x 51.6 x 24.2
