Korvova/gitar/print/_архив/ленточная_версия/2/carriage_high_outer_x2.stl

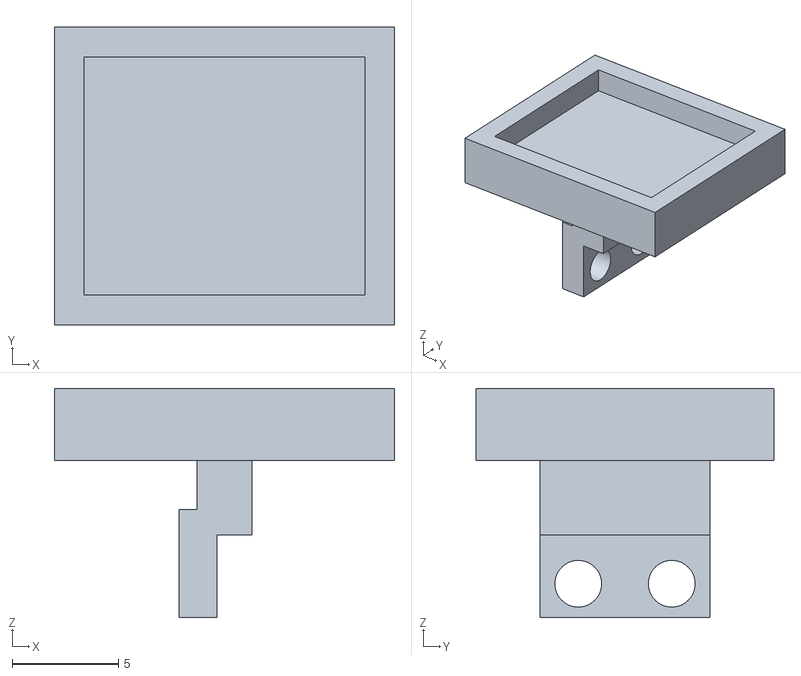
[picture p311: CAD file, 2026-09-08]
print/_архив/ленточная_версия/2/carriage_high_outer_x2.stl
16.0 x 14.0 x 10.8
