Korvova/gitar/print/_архив/ленточная_версия/_свежее_из_скрипта/carriage_low_outer_x2.stl

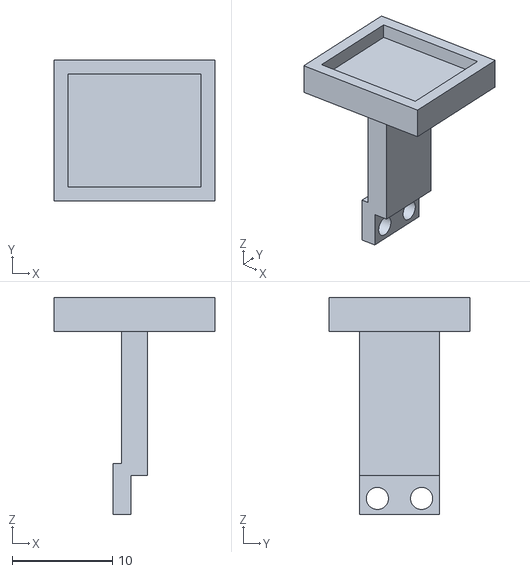
[picture p312: CAD file, 2026-09-08]
print/_архив/ленточная_версия/_свежее_из_скрипта/carriage_low_outer_x2.stl
16.0 x 14.0 x 21.6
