Korvova/gitar/2-0/astra/deka-astra/astra_crank2_A3.step

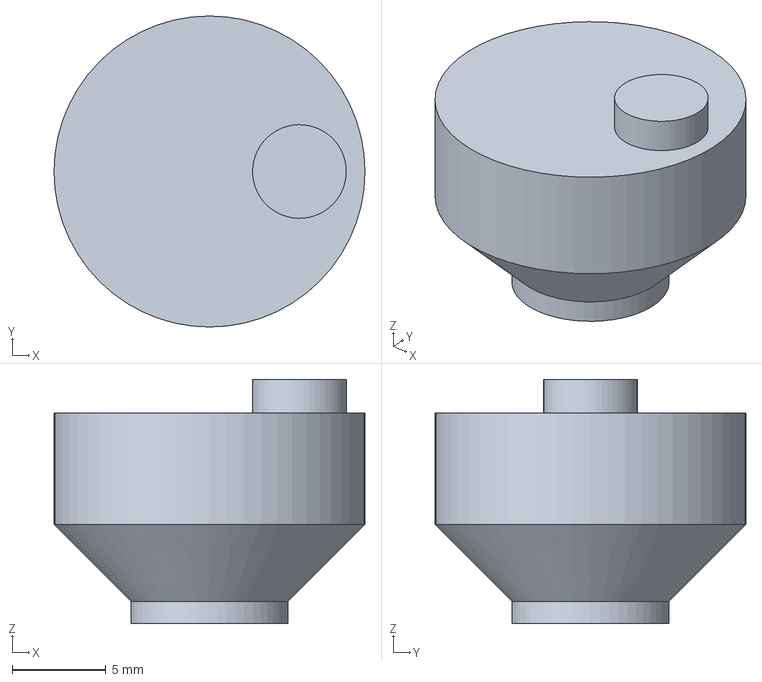
[picture p313: CAD file, 2026-09-27]
2-0/astra/deka-astra/astra_crank2_A3.step
16.6 x 16.6 x 13.1 mm
