Korvova/gitar/2-0/astra/deka-astra/manual/lap_ext.stl

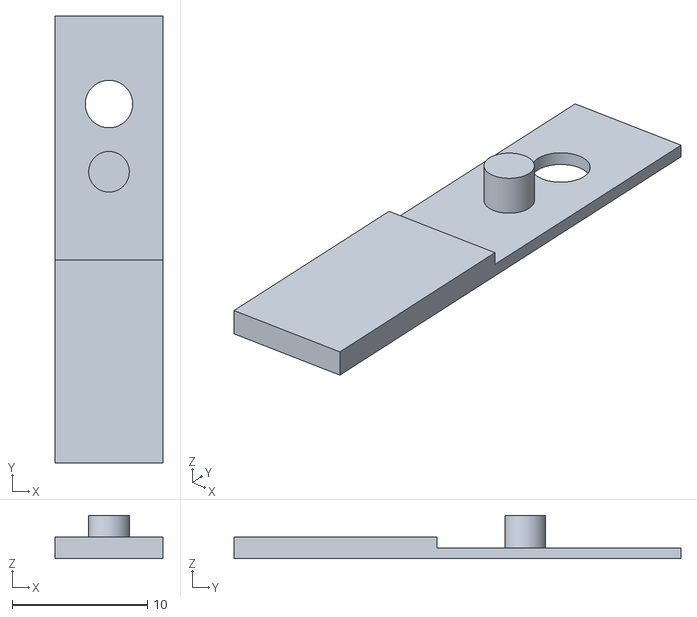
[picture p314: CAD file, 2026-09-27]
2-0/astra/deka-astra/manual/lap_ext.stl
8.00 x 33.0 x 3.20
