Korvova/gitar/2-0/astra/deka-astra/plates/04_A3_reinforced_cranks_1_2_3.3mf

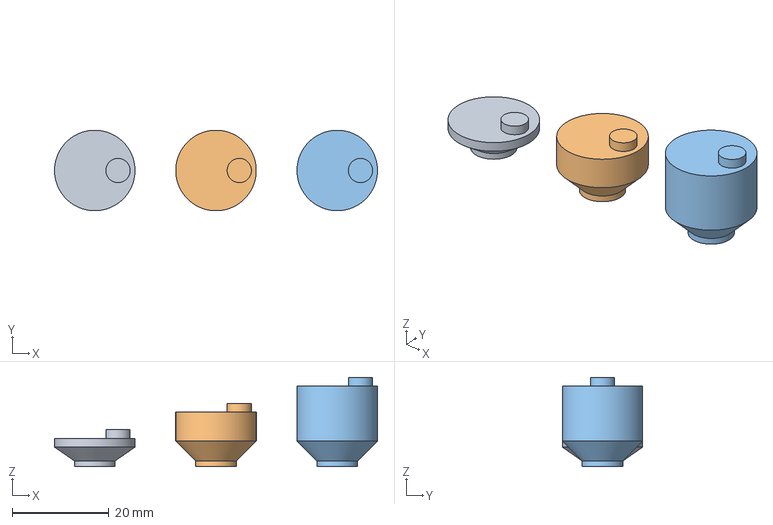
[picture p315: CAD file, 2026-09-27]
2-0/astra/deka-astra/plates/04_A3_reinforced_cranks_1_2_3.3mf
66.6 x 16.6 x 18.4 mm
