Korvova/gitar/2-0/astra/deka-astra/stl/reference_tail1_v3.stl

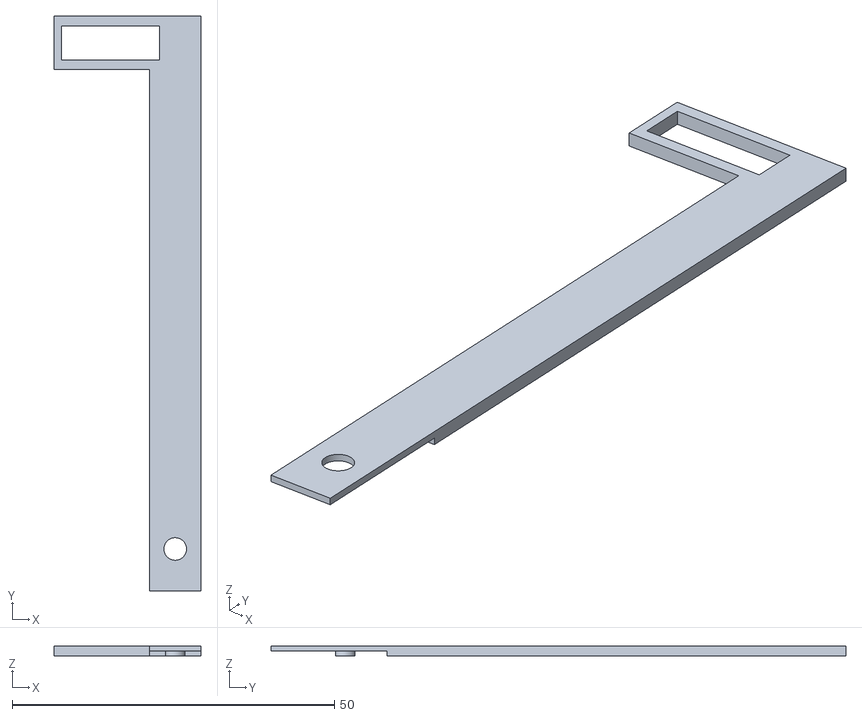
[picture p316: CAD file, 2026-09-27]
2-0/astra/deka-astra/stl/reference_tail1_v3.stl
22.8 x 89.2 x 1.60
