Korvova/gitar/2-0/full_v5/asm/btns.stl

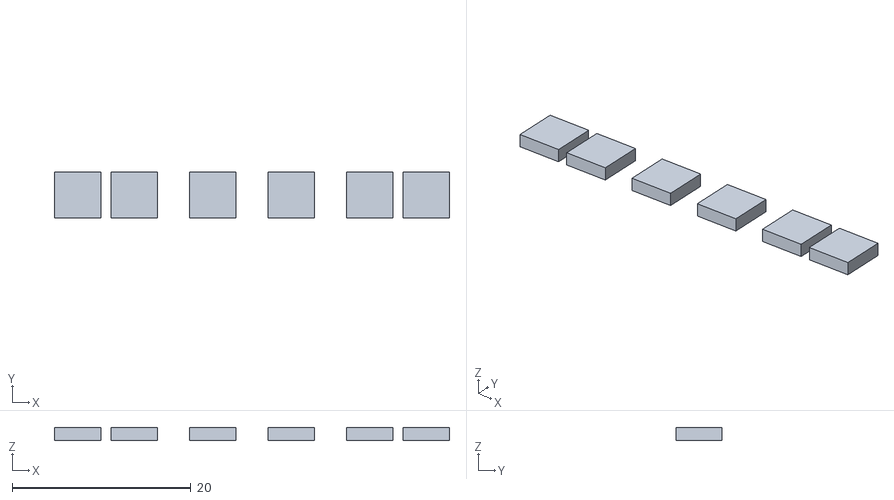
[picture p317: CAD file, 2026-11-13]
2-0/full_v5/asm/btns.stl
44.2 x 5.20 x 1.50
