Korvova/gitar/2-0/kasseta/06_upor_paza.step

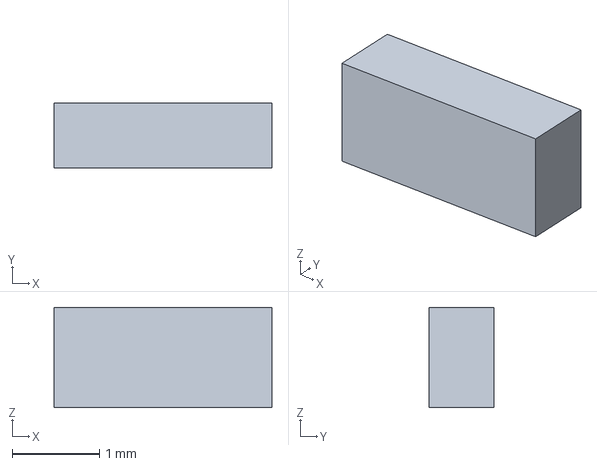
[picture p318: CAD file, 2026-11-04]
2-0/kasseta/06_upor_paza.step
2.50 x 0.75 x 1.15 mm
