Korvova/gitar/2-0/most_test/asm/плёнка.stl

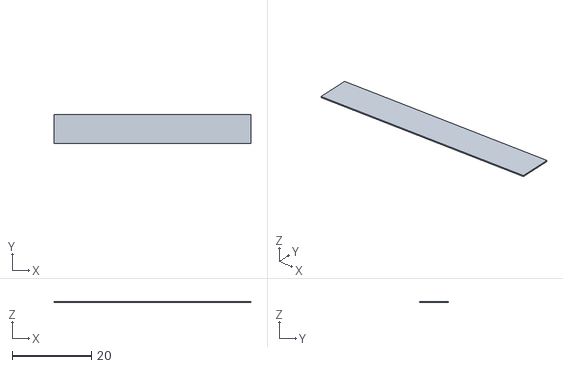
[picture p319: CAD file, 2026-11-13]
2-0/most_test/asm/плёнка.stl
49.6 x 7.40 x 0.24
