Korvova/gitar/2-0/Print/Print/gt_platforma.stl

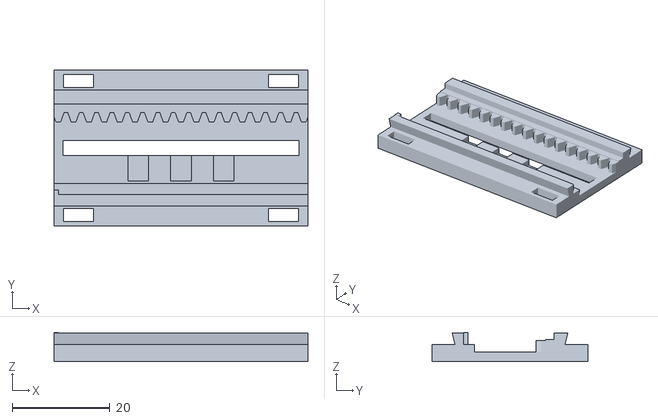
[picture p320: CAD file, 2026-11-09]
2-0/Print/Print/gt_platforma.stl
52.0 x 32.0 x 6.00
