Korvova/gitar/2-0/teleskop_v4/asm/pin_m.stl

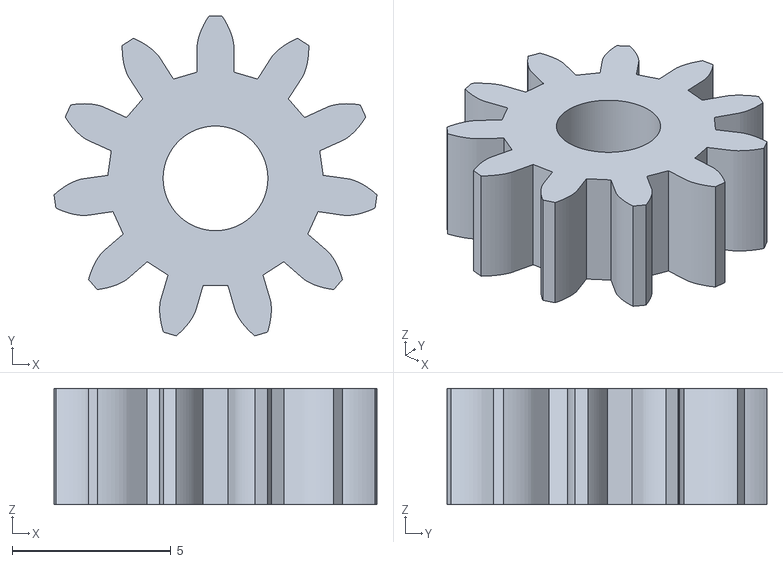
[picture p321: CAD file, 2026-11-12]
2-0/teleskop_v4/asm/pin_m.stl
10.2 x 10.1 x 3.67
