Korvova/gitar/3-0/19.54_balka_v2/05_telezhka.stl

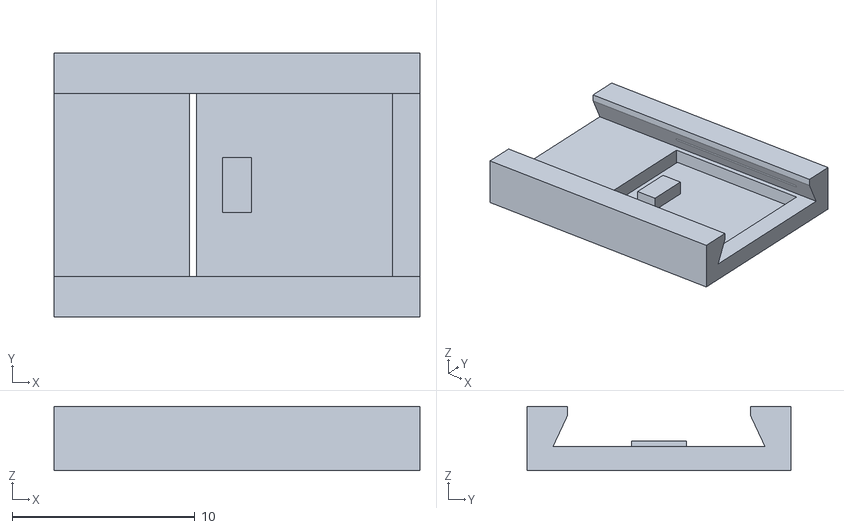
[picture p322: CAD file, 2026-11-13]
3-0/19.54_balka_v2/05_telezhka.stl
20.0 x 14.4 x 3.50
