Korvova/gitar/3D model/palka1_golova.stl

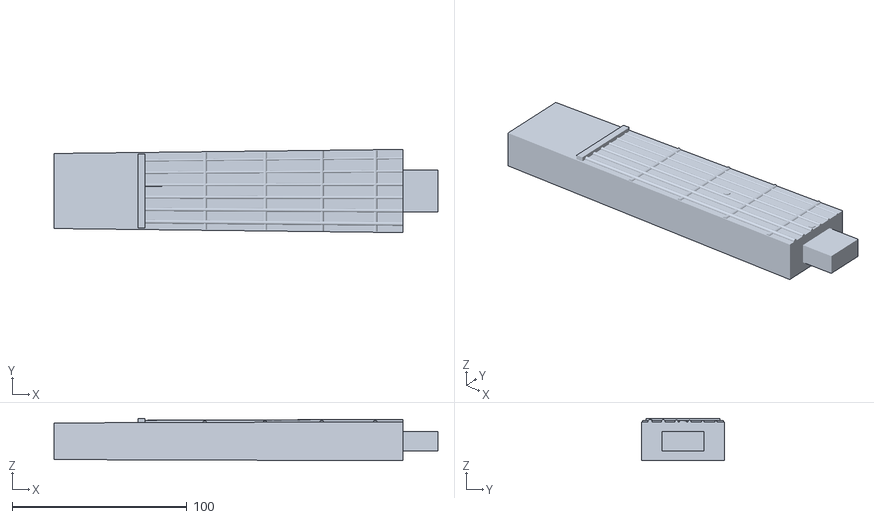
[picture p323: CAD file, 2026-09-08]
3D model/palka1_golova.stl
220.0 x 47.7 x 24.3
