Korvova/gitar/_архив/fcstd_старое/Trainer_layout.FCStd

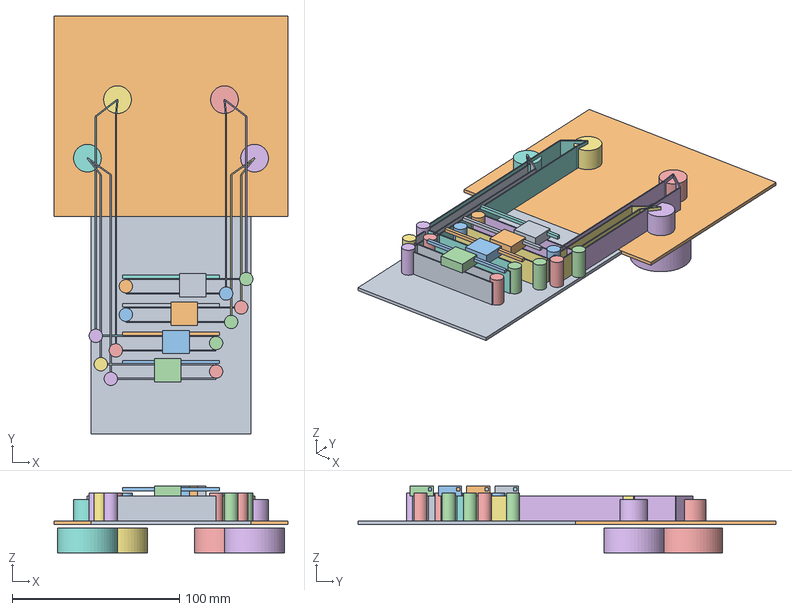
[picture p324: CAD file, 2026-09-08]
_архив/fcstd_старое/Trainer_layout.FCStd
140.0 x 250.0 x 40.0 mm
Plate_grif
Plate_deka
Rail1
Carriage1
EndRoll1
Corner1a
Corner1b
Motor1
Belt1
Rail2
Carriage2
EndRoll2
Corner2a
Corner2b
Motor2
Belt2
Rail3
Carriage3
EndRoll3
Corner3a
Corner3b
Motor3
Belt3
Rail4
Carriage4
EndRoll4
Corner4a
Corner4b
Motor4
Belt4
