Korvova/gitar/Cable_kit.FCStd

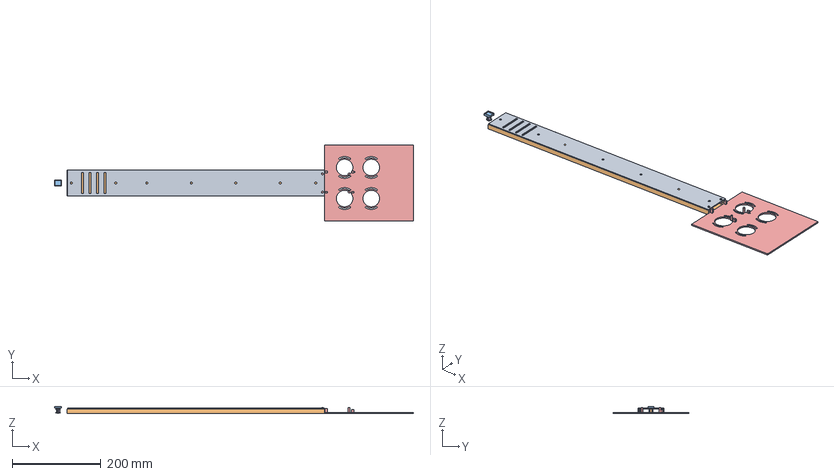
[picture p325: CAD file, 2026-09-08]
Cable_kit.FCStd
808.0 x 170.0 x 16.6 mm
Cover
Boat
Roller4
Deka_panel
Drum
