Korvova/gitar/plata-4-motora/models/pd_trigger.step

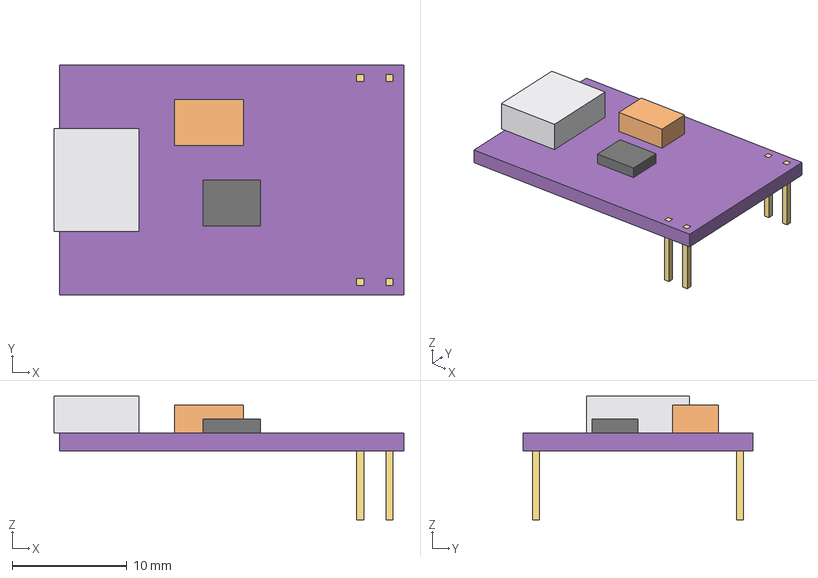
[picture p326: CAD file, 2026-09-19]
plata-4-motora/models/pd_trigger.step
30.5 x 20.0 x 10.8 mm
pcb
usbc
dip
chip
pin x 4
