Korvova/gitar/print/1/boat_x4.stl

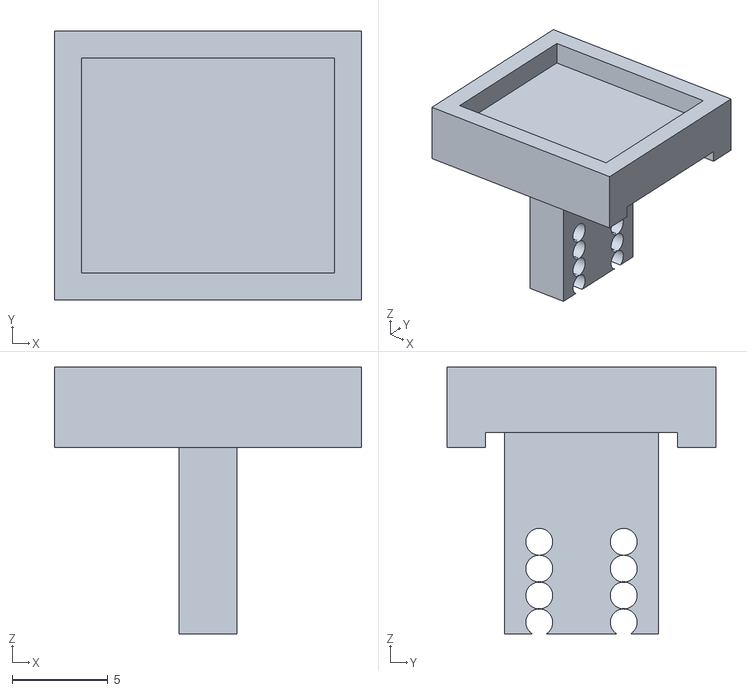
[picture p327: CAD file, 2026-09-08]
print/1/boat_x4.stl
16.0 x 14.0 x 13.9
