Korvova/gitar/print/2/seg2_cover.stl

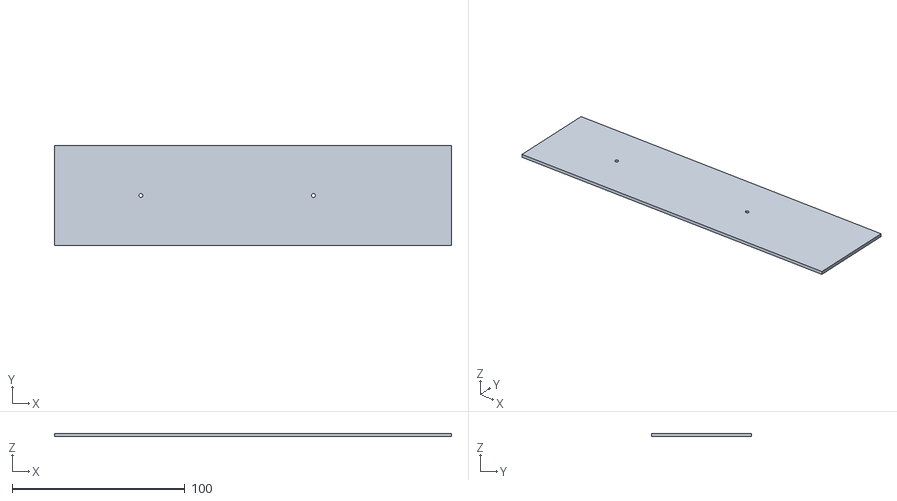
[picture p328: CAD file, 2026-09-08]
print/2/seg2_cover.stl
230.0 x 58.0 x 2.00
