Korvova/gitar/print/_архив/drive_base.stl

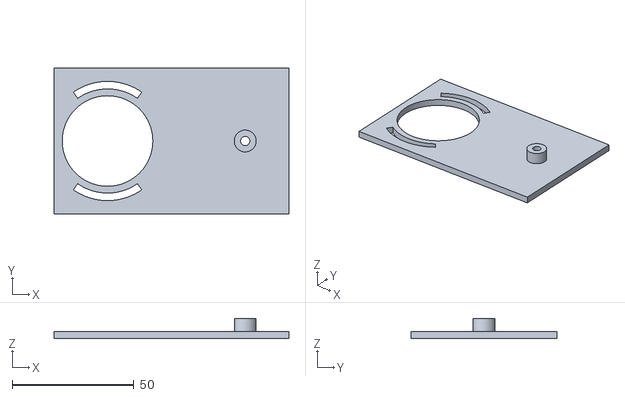
[picture p329: CAD file, 2026-09-08]
print/_архив/drive_base.stl
96.6 x 60.0 x 8.30
