Korvova/gitar/print/_архив/ленточная_версия/1/roller_CR_x8.stl

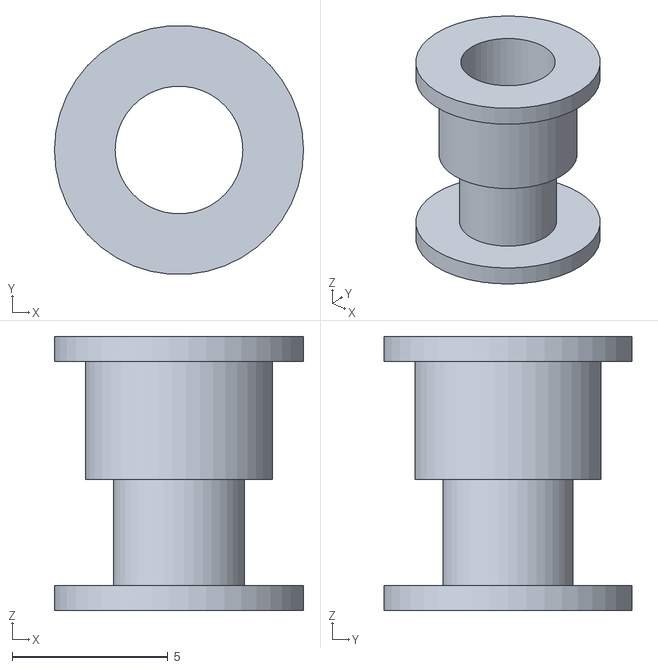
[picture p330: CAD file, 2026-09-08]
print/_архив/ленточная_версия/1/roller_CR_x8.stl
8.00 x 7.98 x 8.80
