Korvova/gitar/print/_архив/ленточная_версия/3/belt_lane3.stl

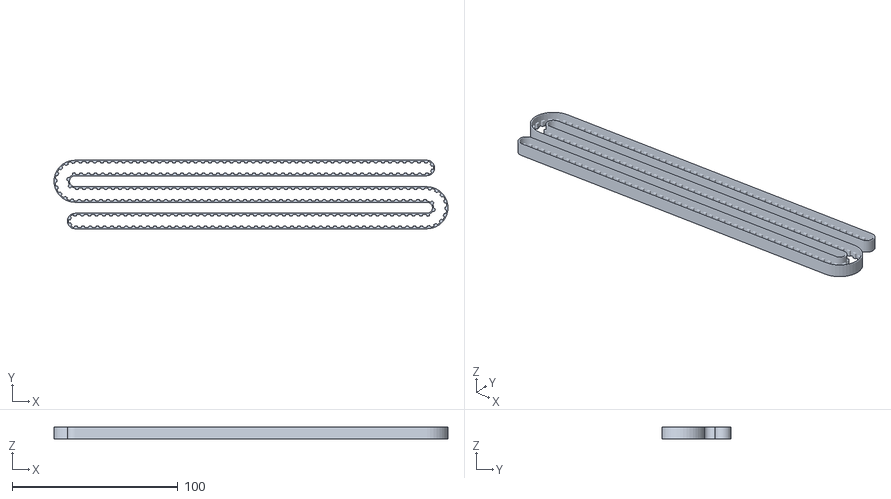
[picture p332: CAD file, 2026-09-08]
print/_архив/ленточная_версия/3/belt_lane3.stl
237.7 x 41.4 x 7.00
