Korvova/gitar/2-0/astra/deka-astra/stl/astra_d1.stl

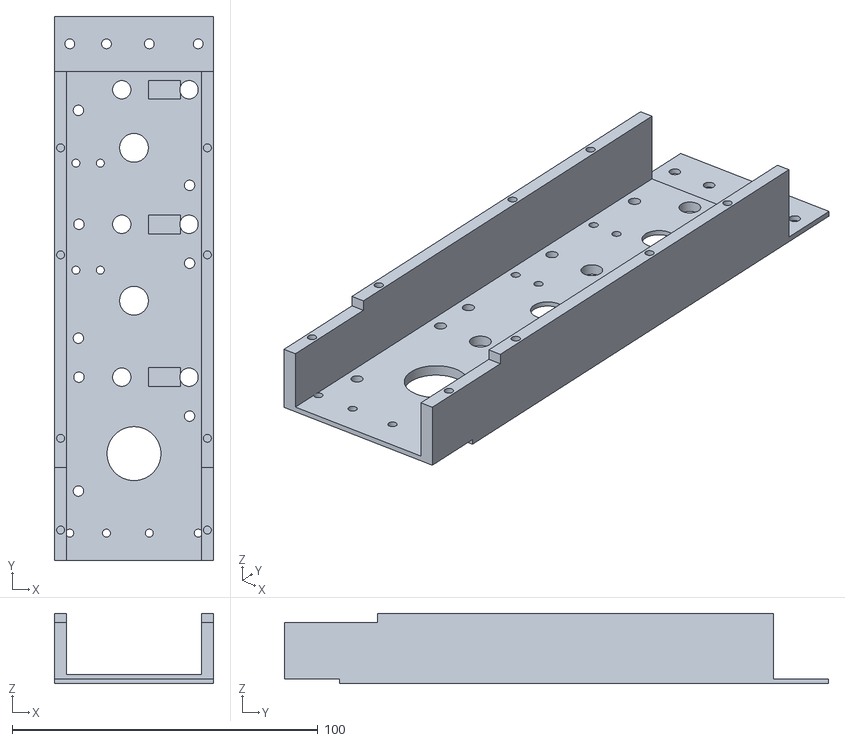
[picture p334: CAD file, 2026-09-27]
2-0/astra/deka-astra/stl/astra_d1.stl
52.0 x 178.0 x 23.0
