Korvova/gitar/2-0/full_v5/stl/10_polzun.stl

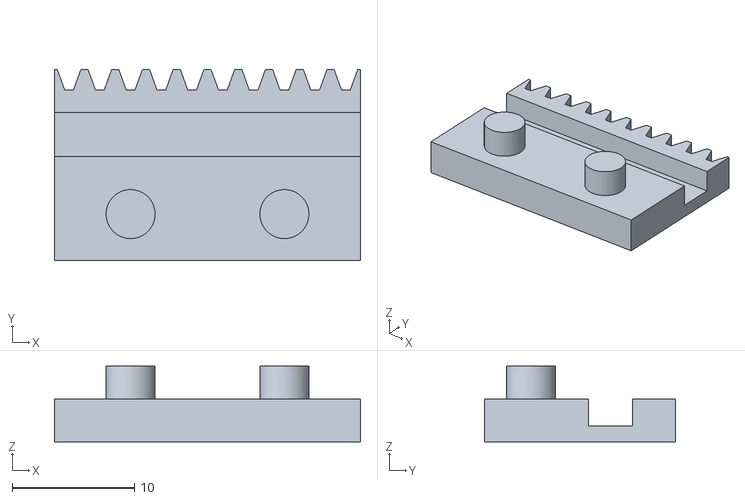
[picture p335: CAD file, 2026-11-13]
2-0/full_v5/stl/10_polzun.stl
25.0 x 15.6 x 6.20
