Korvova/gitar/2-0/kasseta/sborka_4_kassety.step

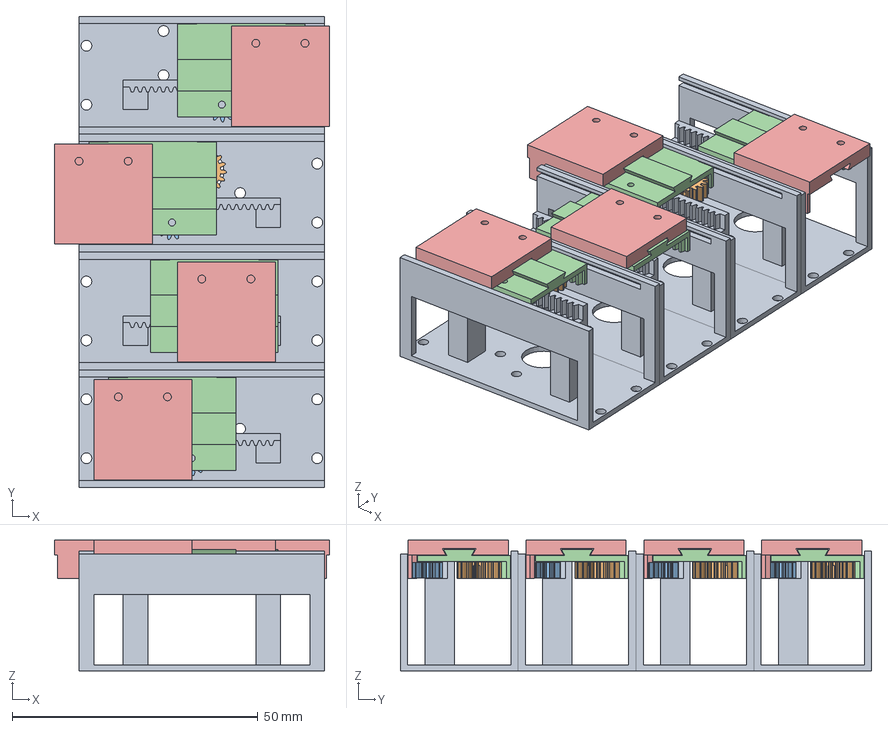
[picture p336: CAD file, 2026-11-04]
2-0/kasseta/sborka_4_kassety.step
56.0 x 96.0 x 26.6 mm
base_0 x 4
pinion_0
float0_0
float1_0
slider_0
cart_0
pinion_1
float0_1
float1_1
slider_1
cart_1
pinion_2
float0_2
float1_2
slider_2
cart_2
pinion_3
float0_3
float1_3
slider_3
cart_3
