Korvova/gitar/2-0/most_test/stl/02_plastina_jachejki.stl

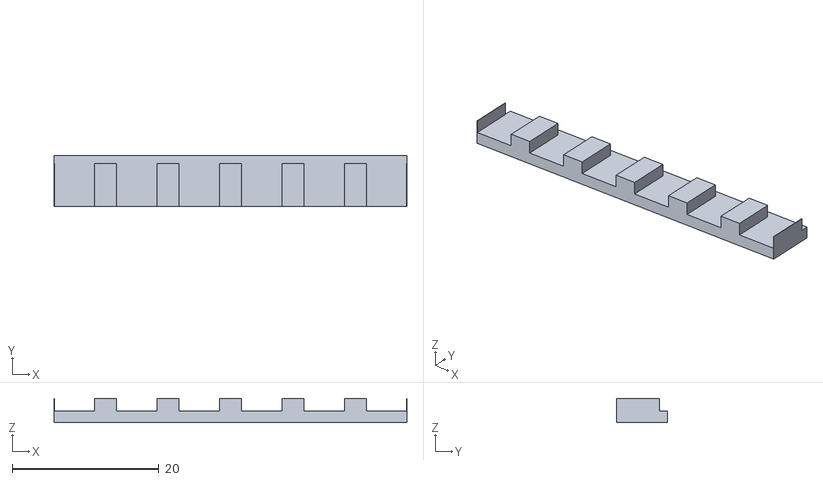
[picture p337: CAD file, 2026-11-13]
2-0/most_test/stl/02_plastina_jachejki.stl
48.1 x 6.90 x 3.30
