Korvova/gitar/2-0/most_v2/asm/coin.stl

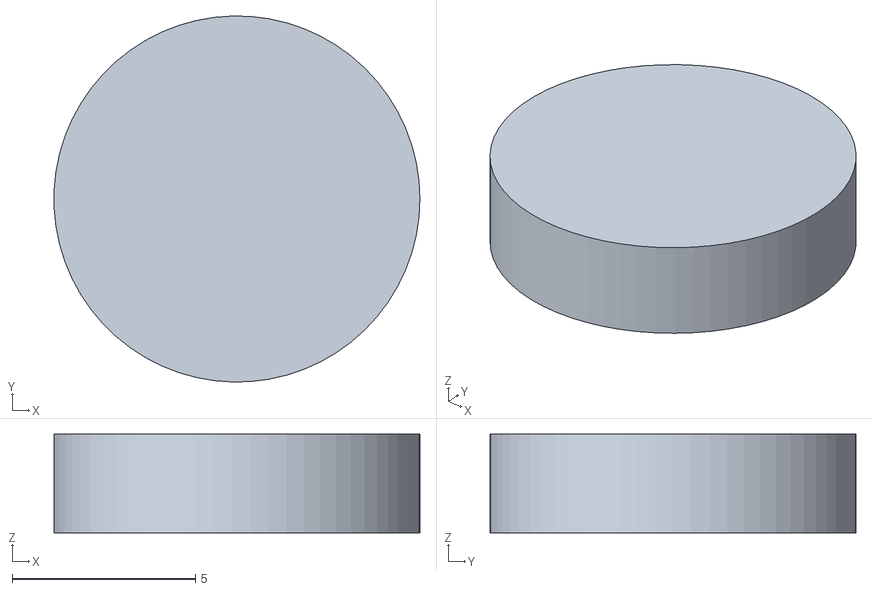
[picture p338: CAD file, 2026-11-13]
2-0/most_v2/asm/coin.stl
9.99 x 10.00 x 2.70
