Korvova/gitar/2-0/most_v2/stl/03_lenta_TPU.stl

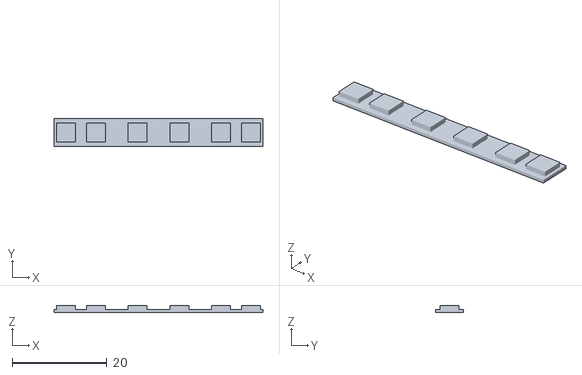
[picture p339: CAD file, 2026-11-13]
2-0/most_v2/stl/03_lenta_TPU.stl
44.0 x 6.00 x 1.50
