Korvova/gitar/2-0/Print/Print/gt4_bort.stl

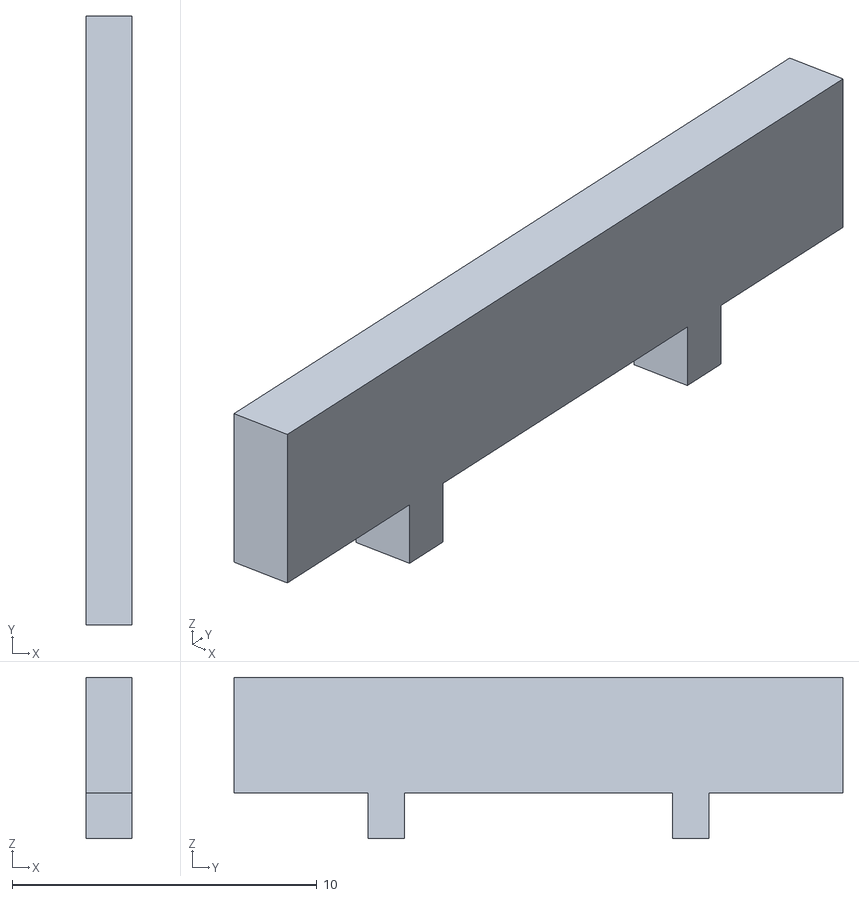
[picture p340: CAD file, 2026-11-07]
2-0/Print/Print/gt4_bort.stl
1.50 x 20.0 x 5.30
