Korvova/gitar/2-0/Print3mf/115_stoyka_nizkaya.3mf

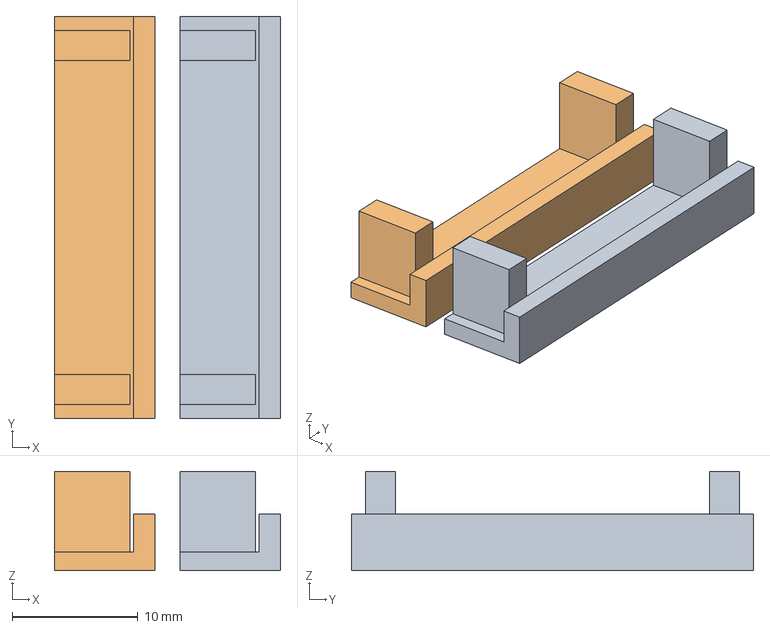
[picture p341: CAD file, 2026-11-07]
2-0/Print3mf/115_stoyka_nizkaya.3mf
18.0 x 32.0 x 7.90 mm
gt_vkladka_orient.stl x 2
