Korvova/gitar/2-0/teleskop_v4/stl/11_kryshka_knopki_x6.stl

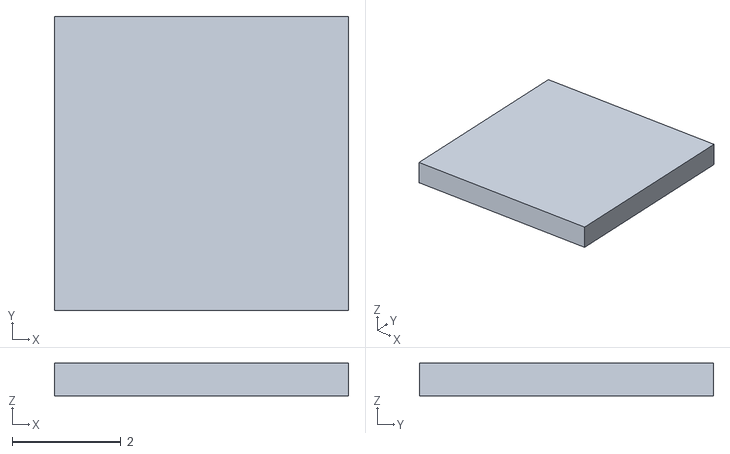
[picture p342: CAD file, 2026-11-12]
2-0/teleskop_v4/stl/11_kryshka_knopki_x6.stl
5.40 x 5.40 x 0.6
