Korvova/gitar/3-0/19.54_balka_v2/04_lenta_PLA_ili_TPU.stl

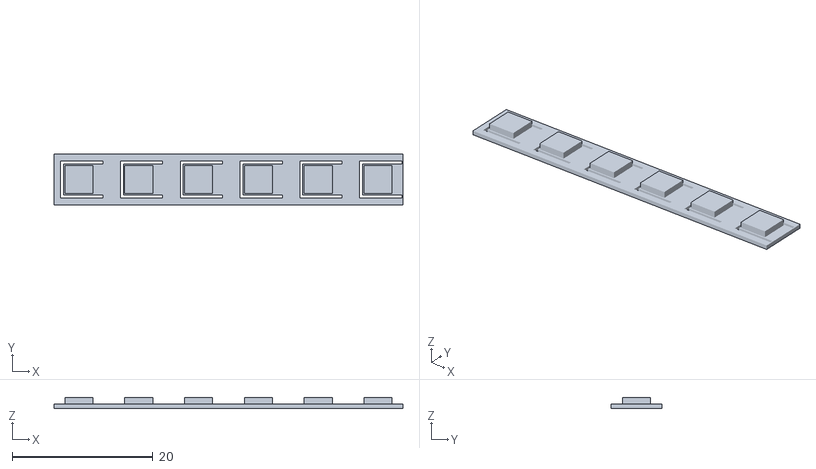
[picture p343: CAD file, 2026-11-13]
3-0/19.54_balka_v2/04_lenta_PLA_ili_TPU.stl
49.6 x 7.20 x 1.50
