Korvova/gitar/_архив/fcstd_старое/Stand_v3.FCStd

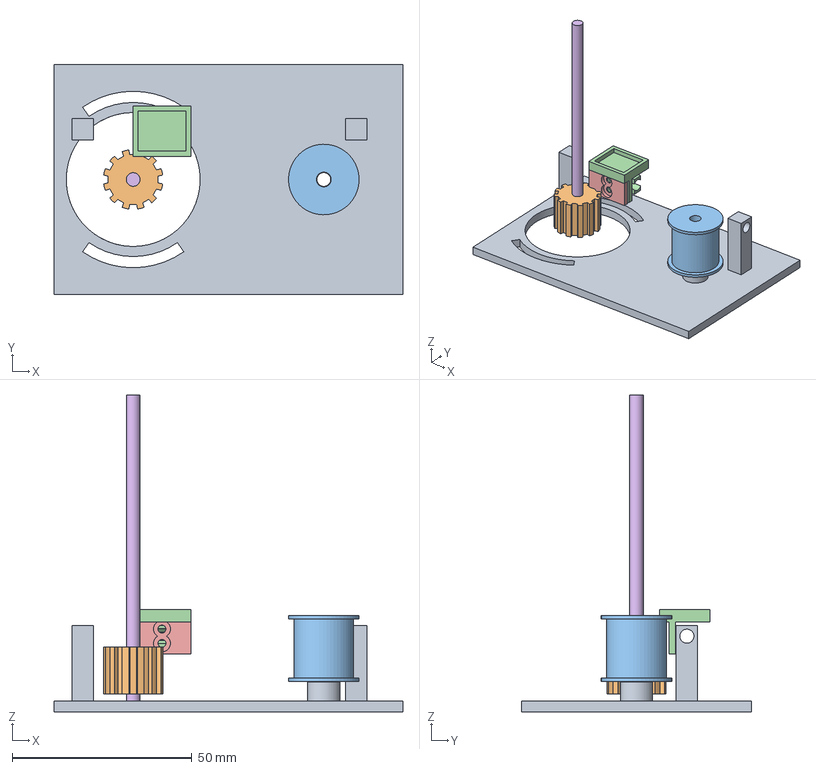
[picture p344: CAD file, 2026-09-08]
_архив/fcstd_старое/Stand_v3.FCStd
97.0 x 64.0 x 88.0 mm
Base
BeltPinion12T
Idler
CarriageOuter
CarriageInner
Rail
