Korvova/gitar/print/1/roller4_x8.stl

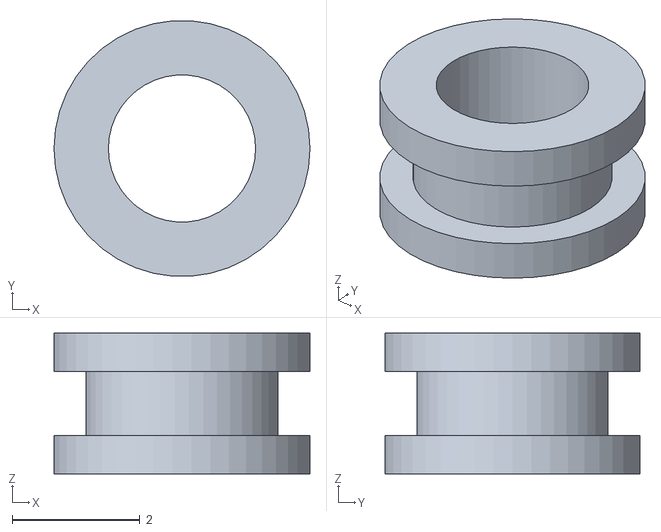
[picture p345: CAD file, 2026-09-08]
print/1/roller4_x8.stl
4.00 x 3.99 x 2.20
