Korvova/gitar/print/2/deka_panel.stl

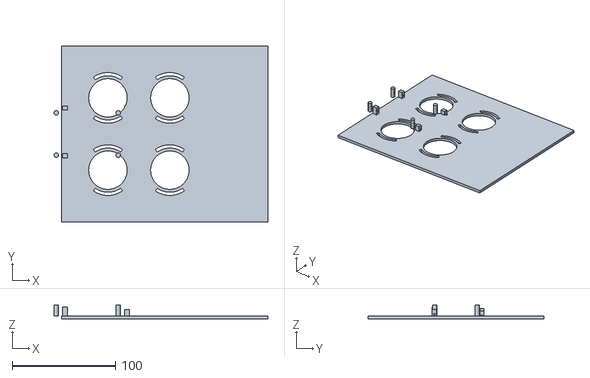
[picture p346: CAD file, 2026-09-08]
print/2/deka_panel.stl
207.2 x 170.0 x 14.0
