Korvova/gitar/print/_архив/belt_pinion12.stl

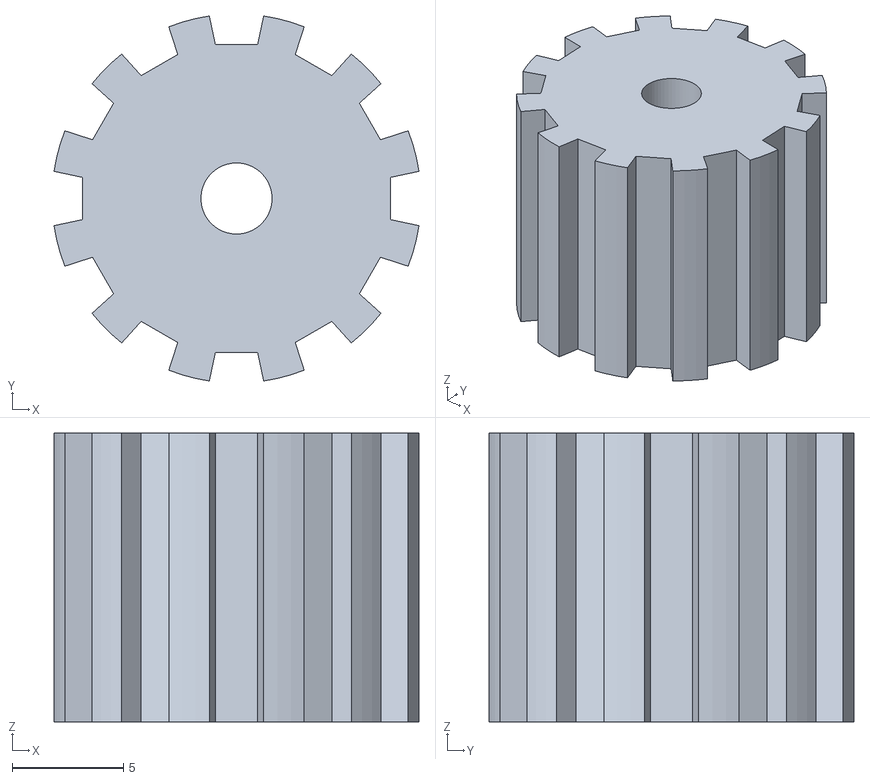
[picture p347: CAD file, 2026-09-08]
print/_архив/belt_pinion12.stl
16.4 x 16.4 x 13.0
