Korvova/gitar/print/_архив/ленточная_версия/1/pin_4x12_nado_4sht.stl

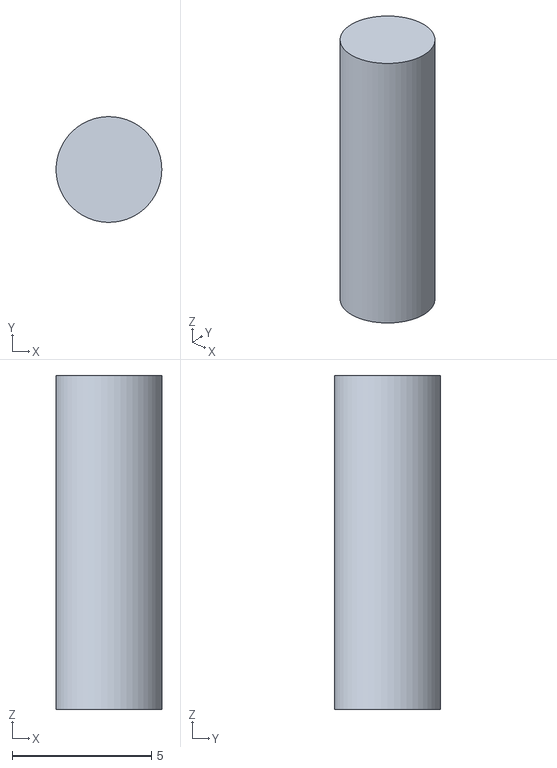
[picture p348: CAD file, 2026-09-08]
print/_архив/ленточная_версия/1/pin_4x12_nado_4sht.stl
3.80 x 3.80 x 12.0
