Korvova/gitar/print/_архив/ленточная_версия/2/splice_x2.stl

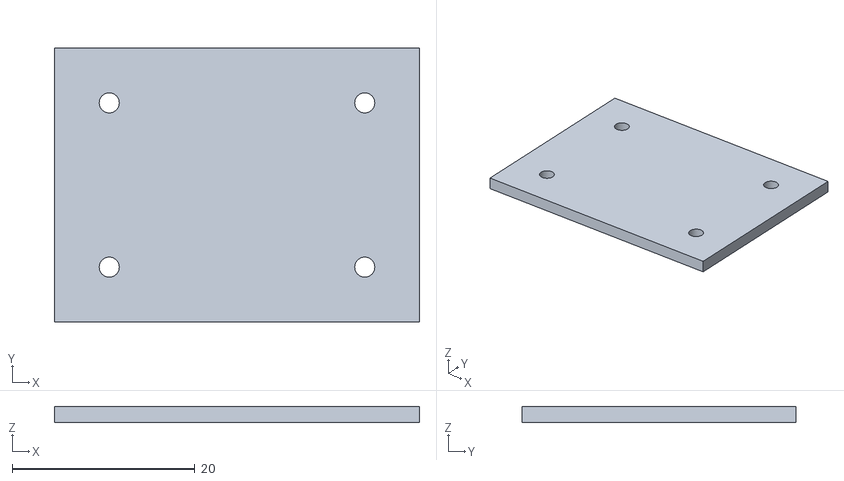
[picture p349: CAD file, 2026-09-08]
print/_архив/ленточная_версия/2/splice_x2.stl
40.0 x 30.0 x 1.80
