Korvova/gitar/print/_архив/ленточная_версия/3/belt_lane4.stl

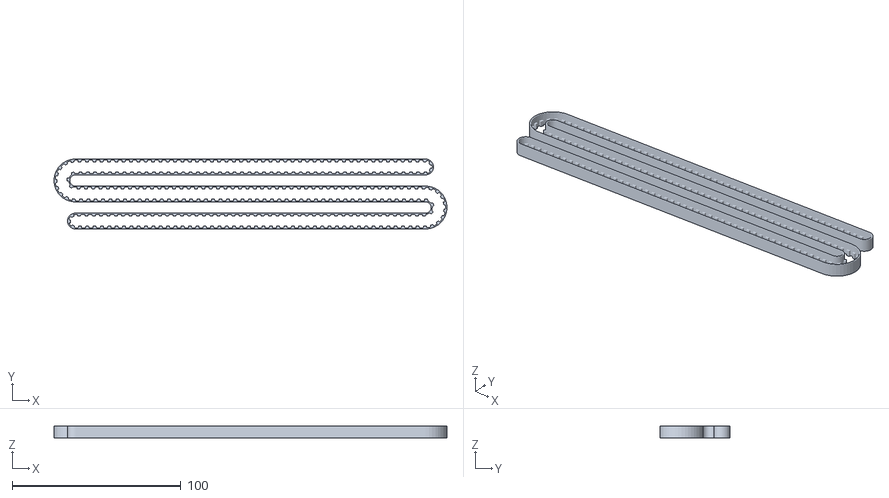
[picture p350: CAD file, 2026-09-08]
print/_архив/ленточная_версия/3/belt_lane4.stl
232.7 x 41.4 x 7.00
