Korvova/gitar/print/_архив/ленточная_версия/_свежее_из_скрипта/cover1.stl

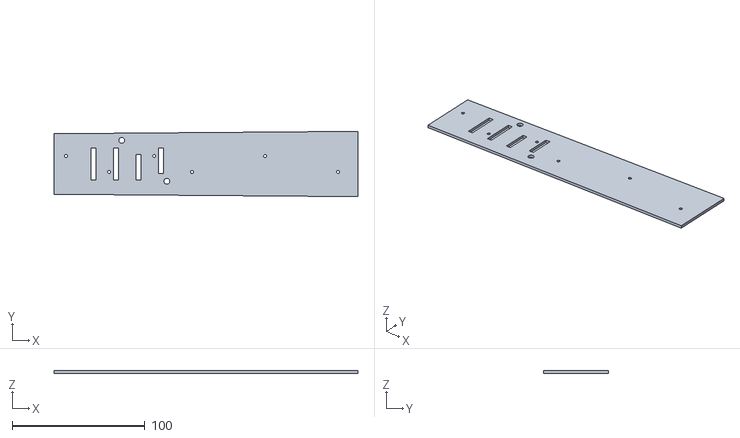
[picture p351: CAD file, 2026-09-08]
print/_архив/ленточная_версия/_свежее_из_скрипта/cover1.stl
229.0 x 49.2 x 2.00
