Korvova/gitar/2-0/astra/deka-astra/manual/crank_id_1.stl

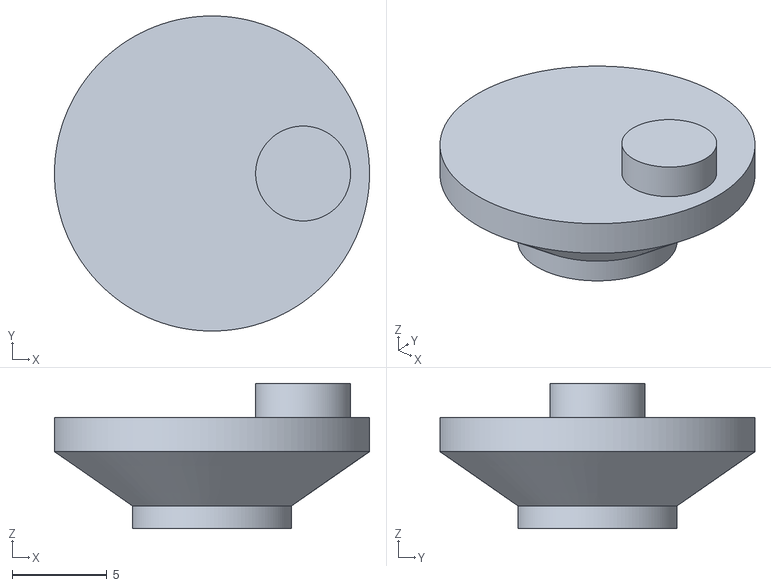
[picture p352: CAD file, 2026-09-27]
2-0/astra/deka-astra/manual/crank_id_1.stl
16.6 x 16.6 x 7.65
