Korvova/gitar/2-0/astra/deka-astra/stl/reference_tail2_v3.stl

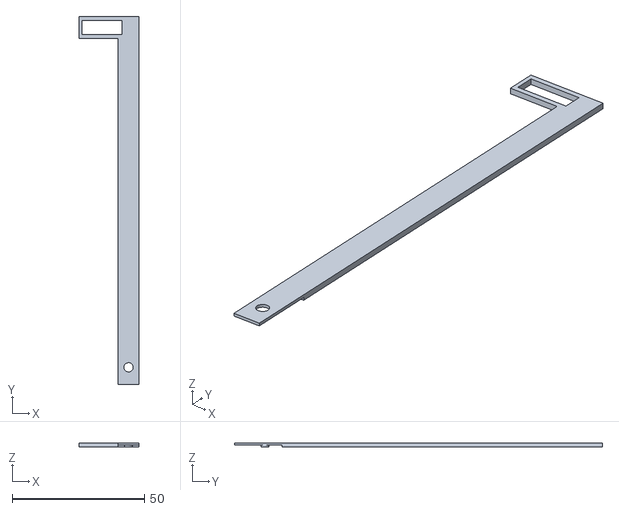
[picture p353: CAD file, 2026-09-27]
2-0/astra/deka-astra/stl/reference_tail2_v3.stl
22.8 x 139.1 x 1.60
