Korvova/gitar/2-0/astra/deka-astra/viewer/meshes/spacer_0.stl

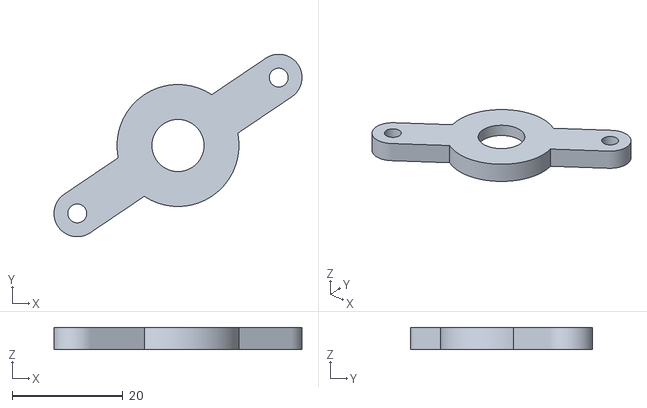
[picture p354: CAD file, 2026-09-27]
2-0/astra/deka-astra/viewer/meshes/spacer_0.stl
44.8 x 32.9 x 4.00
