Korvova/gitar/2-0/full_v5/stl/03_kryshka_lotka.stl

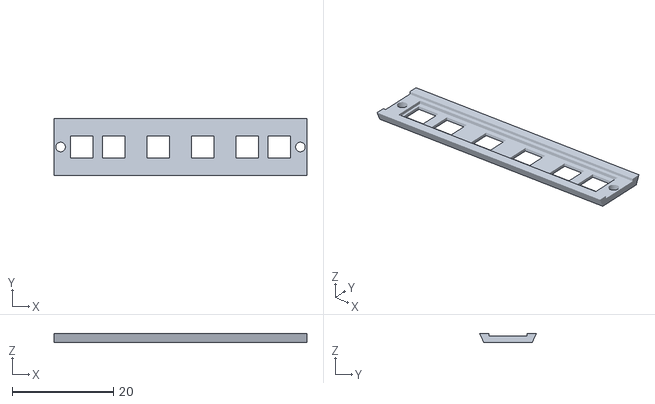
[picture p355: CAD file, 2026-11-13]
2-0/full_v5/stl/03_kryshka_lotka.stl
50.0 x 11.2 x 1.70
