Korvova/gitar/2-0/kasseta/03_shesternya_plav_Z12.step

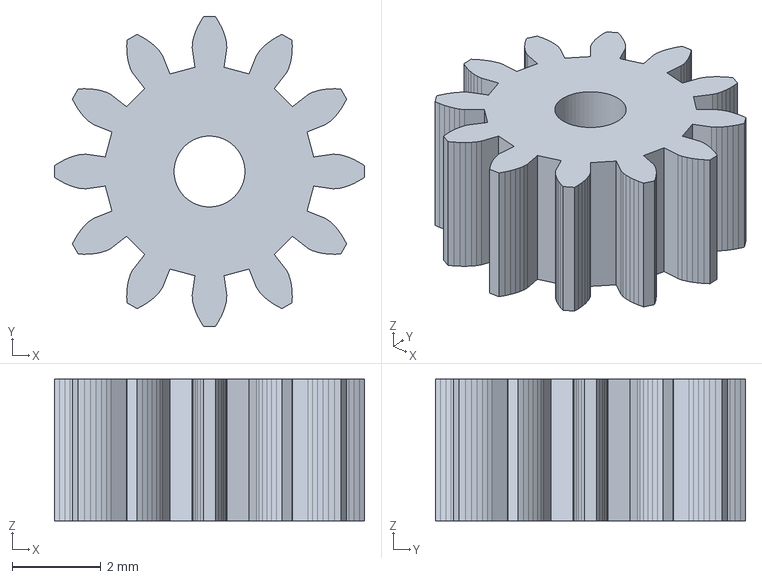
[picture p356: CAD file, 2026-11-04]
2-0/kasseta/03_shesternya_plav_Z12.step
7.00 x 7.00 x 3.20 mm
