Korvova/gitar/2-0/most_v2/asm/pcb.stl

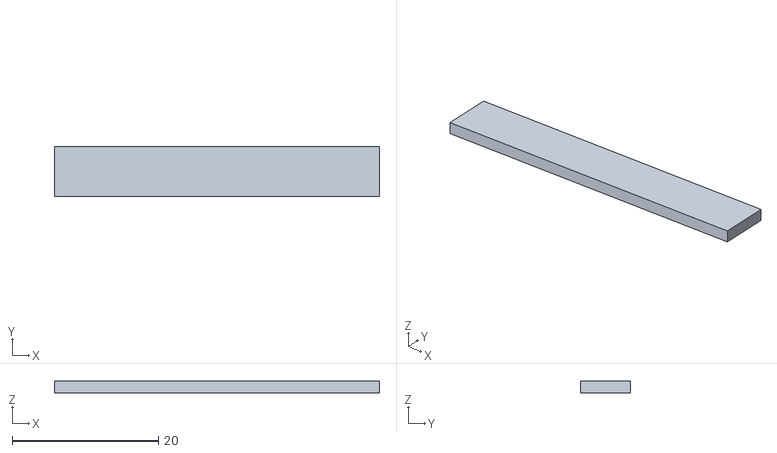
[picture p357: CAD file, 2026-11-13]
2-0/most_v2/asm/pcb.stl
44.5 x 6.90 x 1.60
