Korvova/gitar/2-0/most_v2/stl/01_lotok.stl

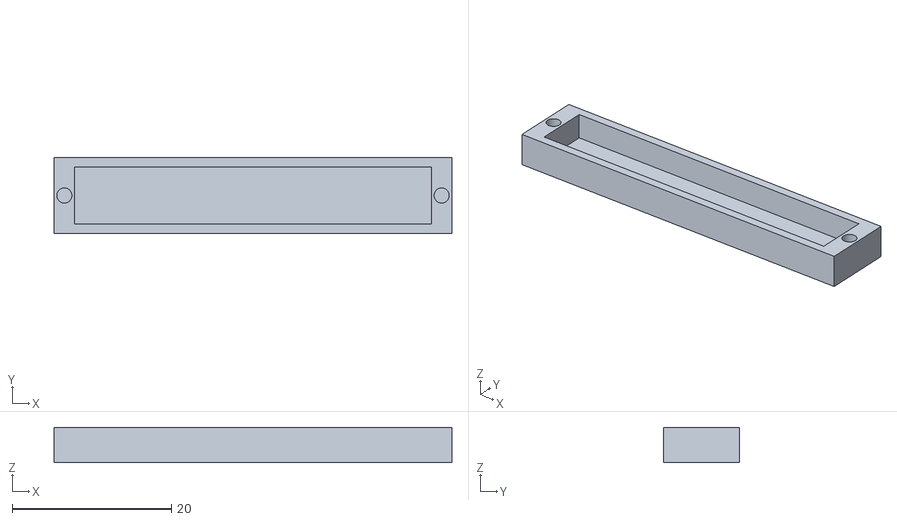
[picture p358: CAD file, 2026-11-13]
2-0/most_v2/stl/01_lotok.stl
50.0 x 9.60 x 4.40
