Korvova/gitar/2-0/Print/Print/gt4_lozhe_9.stl

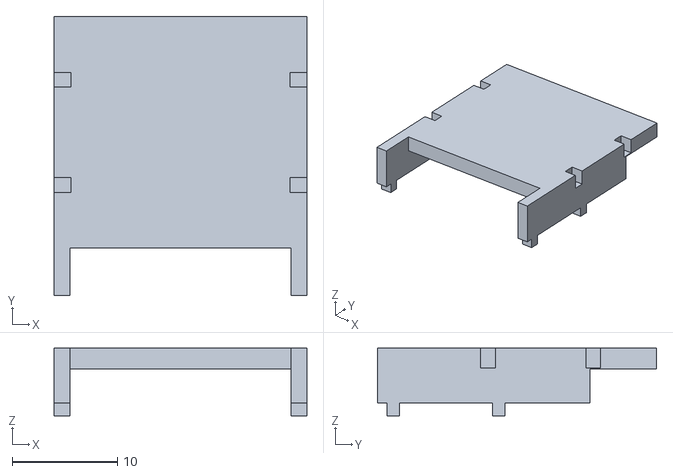
[picture p359: CAD file, 2026-11-07]
2-0/Print/Print/gt4_lozhe_9.stl
24.0 x 26.5 x 6.45
