Korvova/gitar/2-0/Print3mf/113_disk_ruchnoj.3mf

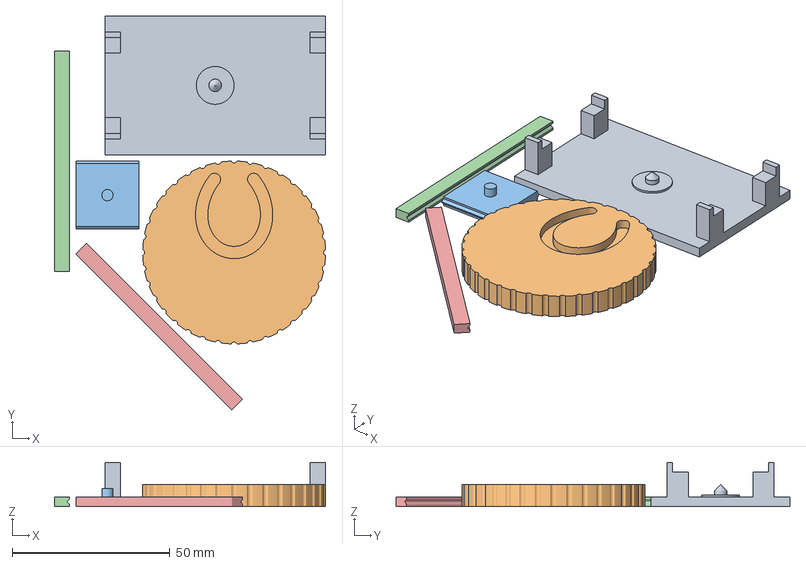
[picture p360: CAD file, 2026-11-05]
2-0/Print3mf/113_disk_ruchnoj.3mf
86.0 x 124.9 x 14.0 mm
disk_osnovanie_orient.stl
disk_disk_orient.stl
disk_telezhka_orient.stl
disk_rels_orient.stl x 2
