Korvova/gitar/2-0/teleskop_v4/asm/base.stl

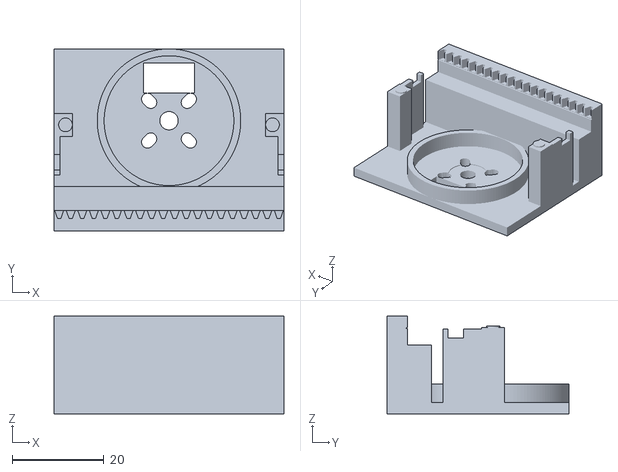
[picture p361: CAD file, 2026-11-12]
2-0/teleskop_v4/asm/base.stl
50.0 x 39.6 x 21.2
