Korvova/gitar/3-0/Print3mf/112_plashmya_2204.3mf

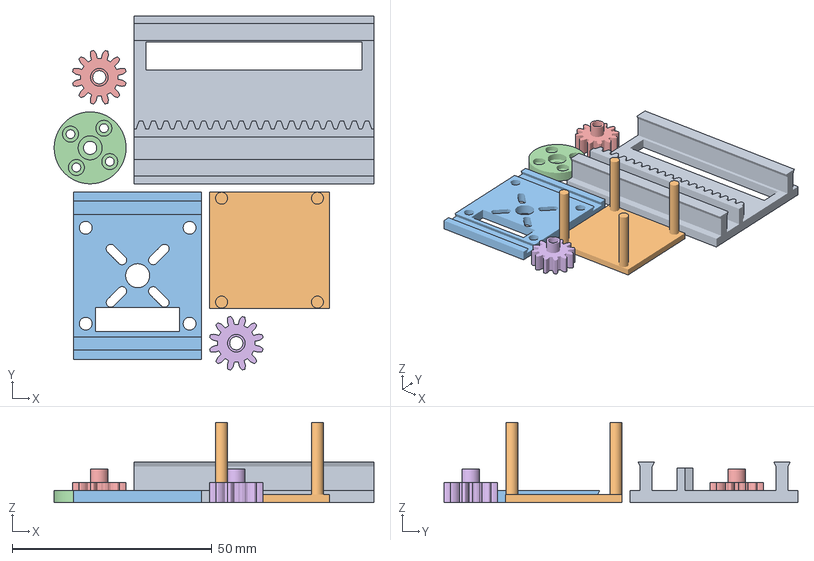
[picture p362: CAD file, 2026-11-05]
3-0/Print3mf/112_plashmya_2204.3mf
80.0 x 88.6 x 20.0 mm
pl_grif_orient.stl
pl_lozhe_orient.stl
pl_telezhka_orient.stl
pl_kryshka_orient.stl
pl_shesternya_orient.stl x 2
