Korvova/gitar/_архив/fcstd_старое/Belts.FCStd

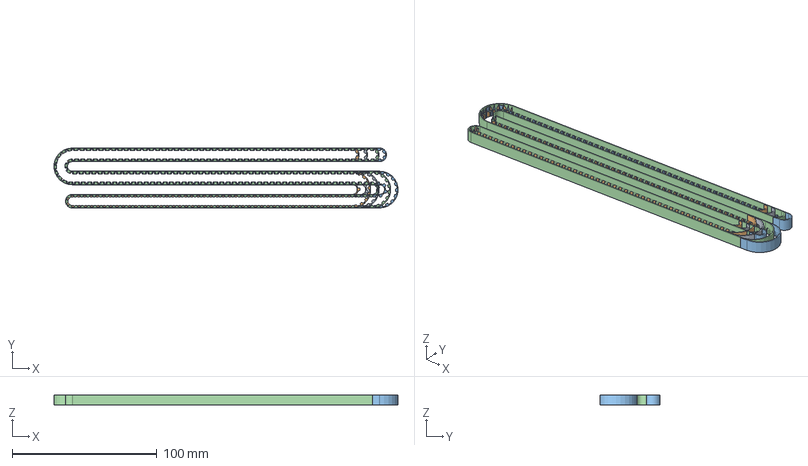
[picture p363: CAD file, 2026-09-08]
_архив/fcstd_старое/Belts.FCStd
237.6 x 41.4 x 7.00 mm
Belt_lane1
Belt_lane2
Belt_lane3
Belt_lane4
