Korvova/gitar/print/2/seg2_body.stl

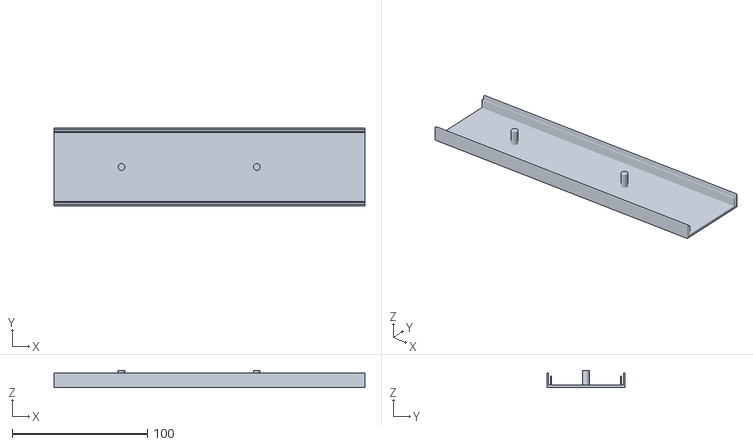
[picture p364: CAD file, 2026-09-08]
print/2/seg2_body.stl
230.0 x 58.0 x 12.6
