Korvova/gitar/print/_архив/carriage_inner.stl

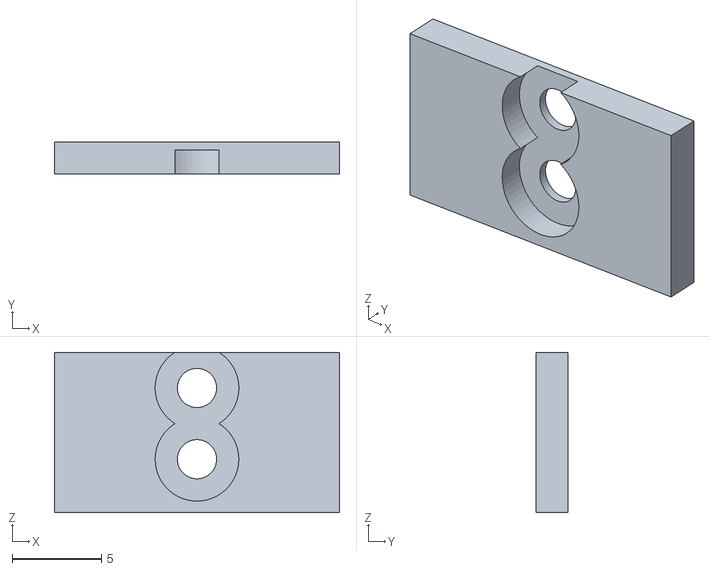
[picture p365: CAD file, 2026-09-08]
print/_архив/carriage_inner.stl
16.0 x 1.80 x 9.00
