Korvova/gitar/print/_архив/ленточная_версия/1/carriage_low_inner_x2.stl

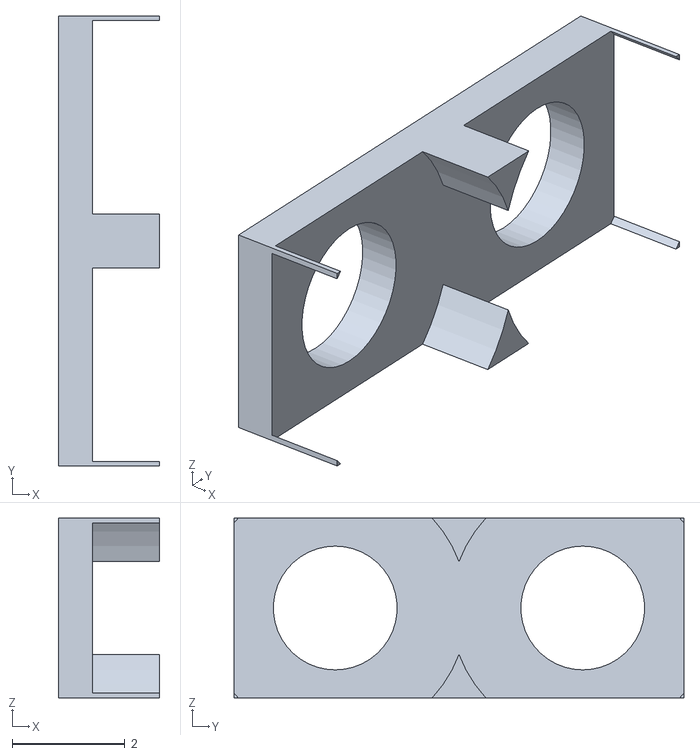
[picture p366: CAD file, 2026-09-08]
print/_архив/ленточная_версия/1/carriage_low_inner_x2.stl
1.80 x 8.00 x 3.20
