Korvova/gitar/print/_архив/ленточная_версия/2/pinion_high_x2.stl

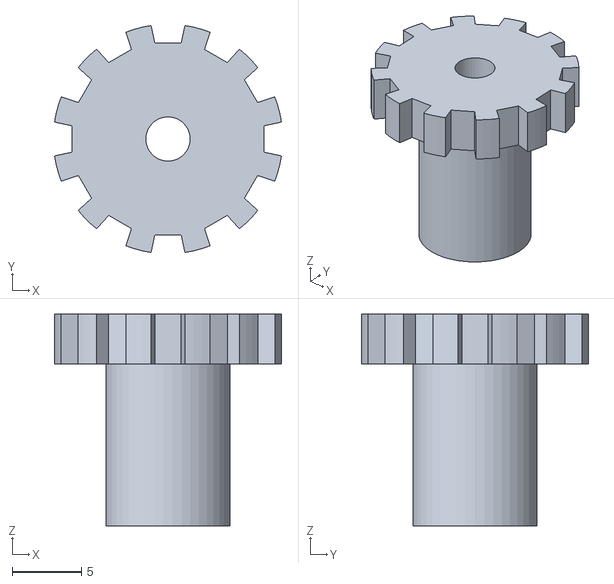
[picture p367: CAD file, 2026-09-08]
print/_архив/ленточная_версия/2/pinion_high_x2.stl
16.4 x 16.4 x 15.3
