Korvova/gitar/2-0/astra/deka-astra/manual/mount_floor.stl

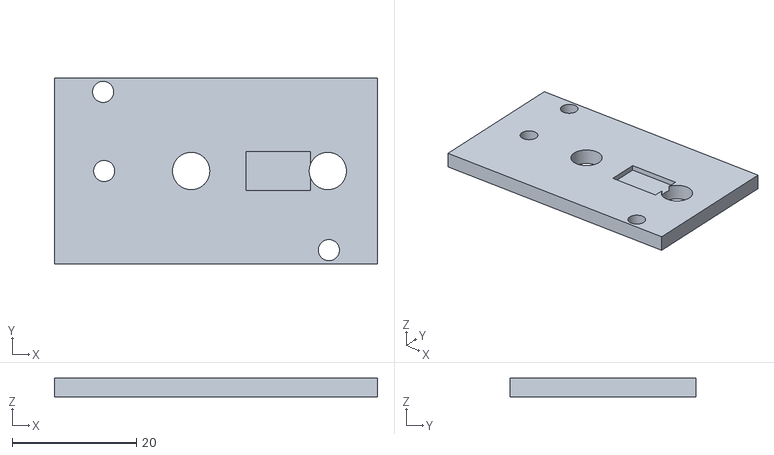
[picture p368: CAD file, 2026-09-27]
2-0/astra/deka-astra/manual/mount_floor.stl
52.0 x 30.0 x 3.00
