Korvova/gitar/2-0/full_v5/asm/res.stl

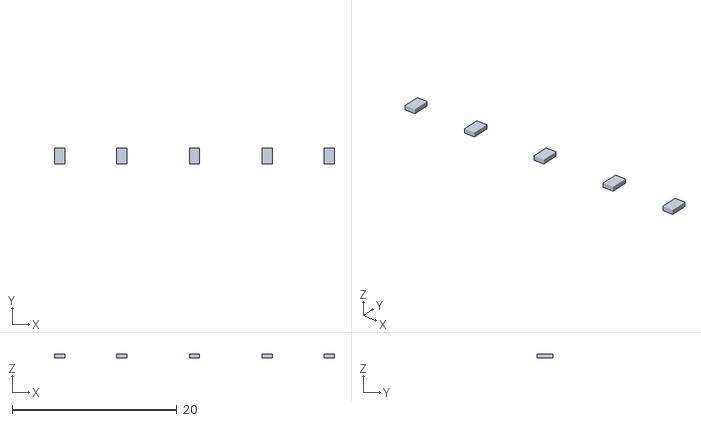
[picture p369: CAD file, 2026-11-13]
2-0/full_v5/asm/res.stl
34.0 x 2.00 x 0.5
