Korvova/gitar/2-0/full_v5/stl/15_podushka_TPU_P_bokom.stl

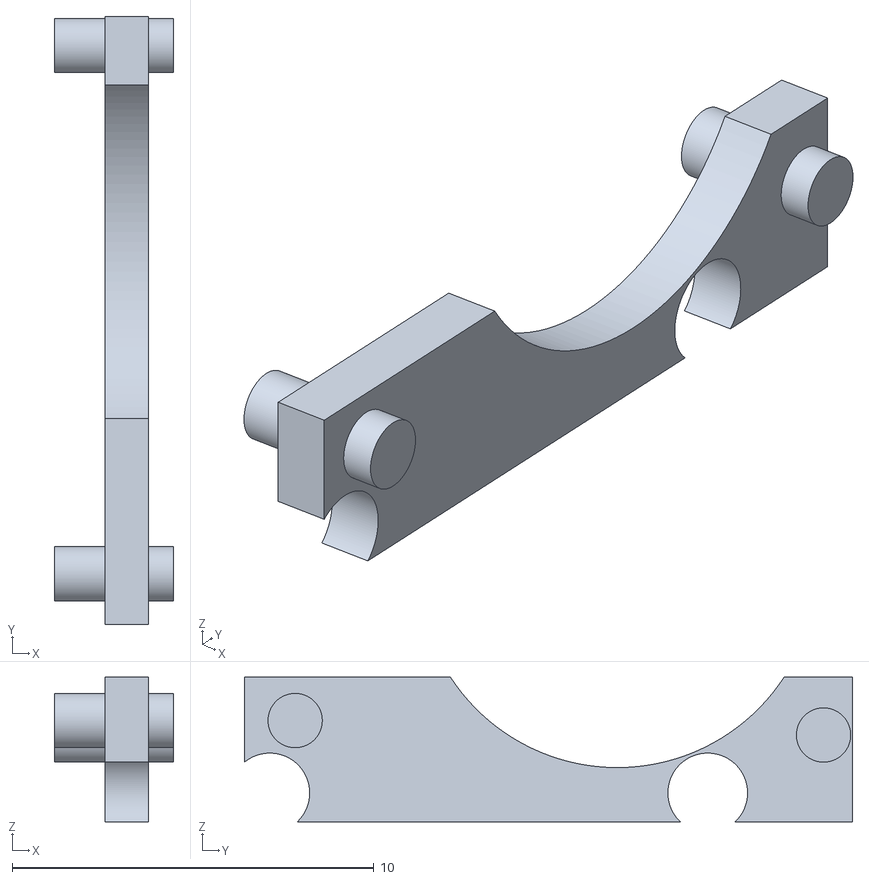
[picture p370: CAD file, 2026-11-13]
2-0/full_v5/stl/15_podushka_TPU_P_bokom.stl
3.30 x 16.8 x 4.00
