Korvova/gitar/(list of files, cad)

Other CAD files:
2-0/astra/deka-astra/manual/plate_3.stl
2-0/most_test/stl/05_telezhka.stl
3-0/19.54_balka_v2/117_balka_v2.3mf
3-0/Print3mf/117_balka_v2.3mf
2-0/astra/deka-astra/manual/crank_id_3.stl
2-0/most_test/stl/04_lenta_PLA_ili_TPU.stl
2-0/most_v2/asm/cart.stl
2-0/most_v2/stl/06_nakladka_telezhki.stl
print/_архив/ленточная_версия/3/belt_lane2.stl
2-0/astra/deka-astra/viewer/meshes/tail_0.stl
2-0/full_v5/stl/02_lotok.stl
2-0/most_test/stl/06_plenka.stl
2-0/most_v2/asm/cover.stl
2-0/most_v2/stl/02_kryshka_lotka.stl
2-0/Print3mf/116_grif_4_palca.3mf
2-0/teleskop_v4/stl/02_most.stl
3-0/Print3mf/114_grif_telezhka.3mf
2-0/astra/deka-astra/manual/crank_id_2.stl
2-0/astra/deka-astra/viewer/meshes/guide_0.stl
2-0/full_v5/asm/cover.stl
2-0/most_test/asm/пластина.stl
2-0/teleskop_v4/asm/buttons.stl
2-0/teleskop_v4/kaseta_stl/01_kryshka_kasety.stl
3-0/Print3mf/115_stoyka_nizkaya.3mf
2-0/full_v5/asm/tape.stl
2-0/most_test/asm/кнопки.stl
2-0/most_test/stl/03_kryshka.stl
2-0/teleskop_v4/kaseta_stl/02_lotok.stl
2-0/teleskop_v4/stl/03_shest_motora.stl
3-0/19.54_balka_v2/01_korpus.stl
2-0/astra/deka-astra/d1_astra_A2.step
2-0/astra/deka-astra/stl/astra_closed_guide.stl
2-0/astra/deka-astra/viewer/meshes/tail_2.stl
2-0/Print/Print/_hall_magnet0_model.stl
2-0/Print/Print/_hall_magnet1_model.stl
2-0/Print/Print/_hall_magnet2_model.stl
2-0/Print/Print/_hall_magnet3_model.stl
2-0/Print/Print/_mock_nema14_v9.stl
2-0/Print/Print/bar_baraban.stl
2-0/Print/Print/bar_baraban_ruchnoj.stl
2-0/Print/Print/bar_os.stl
2-0/Print/Print/bar_rama.stl
2-0/Print/Print/bar_rama_ruchnaja.stl
2-0/Print/Print/bar_rels.stl
2-0/Print/Print/bar_ruchka.stl
2-0/Print/Print/bar_telezhka.stl
2-0/Print/Print/bigdrum27_v9.stl
2-0/Print/Print/bigdrum_v9.stl
2-0/Print/Print/bush_m1_v9.stl
2-0/Print/Print/bush_m2_v9.stl
2-0/Print/Print/bush_m3_v9.stl
2-0/Print/Print/bush_m4_v9.stl
2-0/Print/Print/cart_body_v9.stl
2-0/Print/Print/cilindr_r8_3.stl
2-0/Print/Print/coupon_pilot_1.stl
2-0/Print/Print/coupon_pilot_2.stl
2-0/Print/Print/coupon_pilot_3.stl
2-0/Print/Print/coupon_spline_1.stl
2-0/Print/Print/coupon_spline_2.stl
2-0/Print/Print/coupon_spline_3.stl
2-0/Print/Print/coupon_spline_4.stl
2-0/Print/Print/deck_v9.stl
2-0/Print/Print/disk54_v1.stl
2-0/Print/Print/disk_disk.stl
2-0/Print/Print/disk_osnovanie.stl
2-0/Print/Print/disk_rels.stl
2-0/Print/Print/disk_telezhka.stl
2-0/Print/Print/drum_ring_v9.stl
2-0/Print/Print/drum_top_v9.stl
2-0/Print/Print/fin_b1_v1.stl
2-0/Print/Print/fin_b2_v1.stl
2-0/Print/Print/fin_b3_v1.stl
2-0/Print/Print/fin_b4_v1.stl
2-0/Print/Print/fin_f1_v9.stl
2-0/Print/Print/fin_f2_v9.stl
2-0/Print/Print/fin_f3_v9.stl
2-0/Print/Print/fin_f4_v9.stl
2-0/Print/Print/gdk1_base.stl
2-0/Print/Print/gdk1_base_v2.stl
2-0/Print/Print/gdk1_base_v3.stl
2-0/Print/Print/gdk1_base_x2.stl
2-0/Print/Print/gdk2_base.stl
2-0/Print/Print/gdk2_base_v2.stl
2-0/Print/Print/gdk_comb.stl
2-0/Print/Print/gdk_comb_key_v3.stl
2-0/Print/Print/gdk_comb_v3.stl
2-0/Print/Print/gdk_crank0.stl
2-0/Print/Print/gdk_crank0_v2.stl
2-0/Print/Print/gdk_crank0_v3.stl
2-0/Print/Print/gdk_crank0_x2.stl
2-0/Print/Print/gdk_crank1.stl
2-0/Print/Print/gdk_crank1_v2.stl
2-0/Print/Print/gdk_crank1_v3.stl
2-0/Print/Print/gdk_crank1_x2.stl
2-0/Print/Print/gdk_crank2.stl
2-0/Print/Print/gdk_crank2_v2.stl
2-0/Print/Print/gdk_crank2_v3.stl
2-0/Print/Print/gdk_crank2_x2.stl
2-0/Print/Print/gdk_crank3.stl
2-0/Print/Print/gdk_crank3_big.stl
2-0/Print/Print/gdk_crank3_r10.stl
2-0/Print/Print/gdk_crank3_v2.stl
2-0/Print/Print/gdk_crank3_v3.stl
2-0/Print/Print/gdk_crank3_x2.stl
2-0/Print/Print/gdk_ext.stl
2-0/Print/Print/gdk_ext1.stl
2-0/Print/Print/gdk_ext2.stl
2-0/Print/Print/gdk_hall_post0_v1.stl
2-0/Print/Print/gdk_hall_post1_v1.stl
2-0/Print/Print/gdk_hall_post2_v1.stl
2-0/Print/Print/gdk_hall_post3_v1.stl
2-0/Print/Print/gdk_kupon_shesternya.stl
2-0/Print/Print/gdk_motor0_model.stl
2-0/Print/Print/gdk_motor1_model.stl
2-0/Print/Print/gdk_motor2_model.stl
2-0/Print/Print/gdk_motor3_model.stl
2-0/Print/Print/gdk_sleeve0.stl
2-0/Print/Print/gdk_sleeve1.stl
2-0/Print/Print/gdk_sleeve2.stl
2-0/Print/Print/gdk_sleeve3.stl
2-0/Print/Print/gdk_spacer0_v3.stl
2-0/Print/Print/gdk_spacer0_x2.stl
2-0/Print/Print/gdk_tail0.stl
2-0/Print/Print/gdk_tail0_v2.stl
2-0/Print/Print/gdk_tail0_v3.stl
2-0/Print/Print/gdk_tail0_x2.stl
2-0/Print/Print/gdk_tail1.stl
2-0/Print/Print/gdk_tail1_v2.stl
2-0/Print/Print/gdk_tail1_v3.stl
2-0/Print/Print/gdk_tail1_x2.stl
2-0/Print/Print/gdk_tail2.stl
2-0/Print/Print/gdk_tail2_v2.stl
2-0/Print/Print/gdk_tail2_v3.stl
2-0/Print/Print/gdk_tail2_x2.stl
2-0/Print/Print/gdk_tail3.stl
2-0/Print/Print/gdk_tail3_big.stl
2-0/Print/Print/gdk_tail3_r10.stl
2-0/Print/Print/gdk_tail3_v2.stl
2-0/Print/Print/gdk_tail3_v3.stl
2-0/Print/Print/gdk_tail3_x2.stl
2-0/Print/Print/git_joint_pin.stl
2-0/Print/Print/git_neck_joint_a.stl
2-0/Print/Print/git_neck_joint_b.stl
2-0/Print/Print/git_spica_seg_a.stl
2-0/Print/Print/git_spica_seg_b.stl
2-0/Print/Print/gk_band0.stl
2-0/Print/Print/gk_band1.stl
2-0/Print/Print/gk_band2.stl
2-0/Print/Print/gk_band3.stl
2-0/Print/Print/gk_band4.stl
2-0/Print/Print/gk_band5.stl
2-0/Print/Print/gk_band6.stl
2-0/Print/Print/gk_band_bent.stl
2-0/Print/Print/gk_dno_ne.stl
2-0/Print/Print/gk_dno_nw.stl
2-0/Print/Print/gk_dno_se.stl
2-0/Print/Print/gk_dno_sw.stl
2-0/Print/Print/gk_top_en.stl
2-0/Print/Print/gk_top_es.stl
2-0/Print/Print/gk_top_wn.stl
2-0/Print/Print/gk_top_ws.stl
2-0/Print/Print/gs1_arm0_v2.stl
2-0/Print/Print/gs1_arm0_v3.stl
2-0/Print/Print/gs1_arm1_v2.stl
2-0/Print/Print/gs1_arm1_v3.stl
2-0/Print/Print/gs1_arm2_v2.stl
2-0/Print/Print/gs1_arm2_v3.stl
2-0/Print/Print/gs1_arm3_r16.stl
2-0/Print/Print/gs1_arm3_v2.stl
2-0/Print/Print/gs1_arm3_v3.stl
2-0/Print/Print/gs1_cart.stl
2-0/Print/Print/gs1_cart_lozhe.stl
2-0/Print/Print/gs1_cart_lozhe_kraj.stl
2-0/Print/Print/gs1_cart_lozhe_plosk.stl
2-0/Print/Print/gs1_cart_lozhe_plosk_kraj.stl
2-0/Print/Print/gs1_cart_lozhe_v2.stl
2-0/Print/Print/gs1_cart_lozhe_v2_plosk.stl
2-0/Print/Print/gs1_cart_v2.stl
2-0/Print/Print/gs1_kupon_stud_v2.stl
2-0/Print/Print/gs1_kupon_v2.stl
2-0/Print/Print/gs1_lozhe_v3.stl
2-0/Print/Print/gs1_p0_base.stl
2-0/Print/Print/gs1_p0_base_v2.stl
2-0/Print/Print/gs1_p0_base_v3.stl
2-0/Print/Print/gs1_p1_mid.stl
2-0/Print/Print/gs1_p1_mid_v2.stl
2-0/Print/Print/gs1_p1_mid_v3.stl
2-0/Print/Print/gs1_p2_mid.stl
2-0/Print/Print/gs1_p2_mid_v2.stl
2-0/Print/Print/gs1_p2_mid_v3.stl
2-0/Print/Print/gs1_p3_mid.stl
2-0/Print/Print/gs1_p3_mid_v2.stl
2-0/Print/Print/gs1_p3_mid_v3.stl
2-0/Print/Print/gs1_p4_deck.stl
2-0/Print/Print/gs1_p4_deck_v2.stl
2-0/Print/Print/gs1_p4_deck_v3.stl
2-0/Print/Print/gs1_spica0.stl
2-0/Print/Print/gs1_spica0_v2.stl
2-0/Print/Print/gs1_spica0_v3.stl
2-0/Print/Print/gs1_spica1.stl
2-0/Print/Print/gs1_spica1_v2.stl
2-0/Print/Print/gs1_spica1_v3.stl
2-0/Print/Print/gs1_spica2.stl
2-0/Print/Print/gs1_spica2_v2.stl
2-0/Print/Print/gs1_spica2_v3.stl
2-0/Print/Print/gs1_spica3.stl
2-0/Print/Print/gs1_spica3_r16.stl
2-0/Print/Print/gs1_spica3_v2.stl
2-0/Print/Print/gs1_spica3_v3.stl
2-0/Print/Print/gs2_band_test.stl
2-0/Print/Print/gs2_base.stl
2-0/Print/Print/gs2_cap.stl
2-0/Print/Print/gs2_fret.stl
2-0/Print/Print/gs2_lid.stl
2-0/Print/Print/gs2_mono.stl
2-0/Print/Print/gs2_tray.stl
2-0/Print/Print/gs3_base.stl
2-0/Print/Print/gs3_fret.stl
2-0/Print/Print/gs3_lid.stl
2-0/Print/Print/gs_splice.stl
2-0/Print/Print/gst_baza6.stl
2-0/Print/Print/gst_bridge.stl
2-0/Print/Print/gst_elektro.stl
2-0/Print/Print/gst_garm.stl
2-0/Print/Print/gst_garm_mid.stl
2-0/Print/Print/gst_garm_soft.stl
2-0/Print/Print/gst_klamp.stl
2-0/Print/Print/gst_kryshka_big.stl
2-0/Print/Print/gst_kryshka_mag.stl
2-0/Print/Print/gst_kryshka_pcb.stl
2-0/Print/Print/gst_kryshka_pcb2.stl
2-0/Print/Print/gst_modul.stl
2-0/Print/Print/gst_nozhka.stl
2-0/Print/Print/gst_palka06.stl
2-0/Print/Print/gst_palka07.stl
2-0/Print/Print/gst_palka08.stl
2-0/Print/Print/gst_plastina.stl
2-0/Print/Print/gst_podstavka.stl
2-0/Print/Print/gst_pot_dummy.stl
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
