Korvova/gitar/2-0/Print/Print/README.txt

ТРЕНАЖЁР v10 — ПЕЧАТЬ И СБОРКА
================================
(готовые настроенные столы — в ..\..\Print3mf\*.3mf, открывать «КАК ПРОЕКТ»!)

ЧТО ПЕЧАТАТЬ
------------
Файл                  Кол-во  Ориентация / заметки
neckL1_v9.stl           1     как есть (канавки вверх), без поддержек
neckL2_v9.stl           1     как есть
neckL3_v9.stl           1     как есть
neckL4_v9.stl           1     как есть
neckL5_v9.stl           1     как есть (плоским низом на стол)
deck_v9.stl             1     ПЕРЕВЕРНУТЬ (плитой на стол, ноги вверх), без поддержек
rail_v9.stl             2     рельсы грифа, вверх ногами (глухие отверстия вверх)
stop_v9.stl             1     упор торца, вверх ногами
cart_body_v9.stl        4     стоя как есть (v10: дно 2, стенки 5, отв. сбоку)
fin_f1_v9.stl           2     ЛЁЖА, монолит (99-100%); f1 длинный — этаж 1
fin_f2_v9.stl           2     лёжа, монолит
fin_f3_v9.stl           2     лёжа, монолит
fin_f4_v9.stl           2     лёжа, монолит (самый короткий, этаж 4)
drum_ring_v9.stl        8     плашмя ребордой вниз; монолит (кольцо барабана)
drum_top_v9.stl         4     плашмя; монолит (крышка барабана)
riser_m2_v9.stl         2     столбики под уши мотора 2 (h=1.25)
riser_m3_v9.stl         2     под уши мотора 3 (h=4.75)
riser_m4_v9.stl         2     под уши мотора 4 (h=8.25)
guide_m1..m4_v9.stl   по 2    как есть (направляющие ролики)
roller_corner_v9.stl    8     как есть, мелкие — печатать пачкой
bush_m1..m4_v9.stl    по 2    ВРЕМЕННЫЕ втулки вместо латунной трубки (опция)
coupon_*.stl           —      калибровочные шайбы посадок (по необходимости)

Материал: PETG. Мелочь (барабаны/ролики/плавники) — слой 0.12, внешний
периметр 45 мм/с, вентилятор 60-100%, мин. время слоя 15 с («cool»).
Барабаны и плавники — монолит (заполнение 99-100% или 6 стенок).
МЕЛКИЕ ДЕТАЛИ НЕ ПЕЧАТАТЬ ПО ОДНОЙ — минимум 2 шт на столе (остывание).

КРЕПЁЖ И МАТЕРИАЛЫ
-------------------
М3 (цилиндрическая головка):
  M3 x 20        4 шт   стяжка слоёв грифа (X=8 и 96, Y=+-12, сверху)
  M3 x 25        2 шт   гриф -> дека (по центру, X=108 и 118)
  M3 x 8         6 шт   рельсы (2x2) и упор (2) — СНИЗУ сквозь плиту
  M3 x 6..8      2 шт   уши мотора 1 (без столбиков)
  M3 x 8         2 шт   уши мотора 2 (сквозь столбик 1.25)
  M3 x 10        2 шт   уши мотора 3 (сквозь столбик 4.75)
  M3 x 12..14    2 шт   уши мотора 4 (сквозь столбик 8.25)
М4 (оси направляющих роликов, самонарез в отверстия Ø3.3 плиты):
  M4 x 8..18     8 шт   длины по высоте ролика (см. мотор 1..4)
  + латунная трубка K&S 5x0.45 отрезками ~5.5/7/10.5/14 мм (или печатные
    втулки bush_* как временные)
М2:
  M2 x 5..6      8 шт   плавники к стенкам тележек (СБОКУ, самонарез)
Прочее:
  - Шнур KAME PE MAX 4X 0.5 мм ~3 м; суперклей (стопки барабанов);
  - филамент-пруток 1.75: оси угловых роликов 8x ~4 мм + 4 штифта 16 мм;
  - моторы NEMA 14 круглые с шестернёй 10T m0.5 (Ø5.9x4, низ на z3) — 4 шт.

ПОРЯДОК СБОРКИ
--------------
1. ГРИФ послойно L1..L4: на каждом слое вложить 2 угловых ролика, оси-
   филамент ~4 мм сверху в лунки; трос уложить НА ДНО каналов, обвести
   ролик (трос МЕЖДУ роликом и краем грифа!), концы наружу через торцы.
   Слой k = тележка k (1 — у головы). Запас концов ~250 мм.
2. Накрыть L5, вставить 4 штифта 16 мм, стянуть 4x M3x20.
3. Рельсы и упор на деку: в карманы, прикрутить СНИЗУ 6x M3x8.
   Гриф на деку между рельсами до упора: 2x M3x25 по центру.
4. ТЕЛЕЖКИ (v10): корпус на полку между щелями. Плавник — пяткой с торца
   борта в щель, задвинуть к тележке, пластину на стенку СНАРУЖИ,
   2x M2x5..6 горизонтально. Трос — в дырочку Ø1.5 над Т-пяткой,
   компактный двойной узел (выше пятки ходит в щели 3 мм!).
5. МОТОРЫ: m1 без столбиков; m2/m3/m4 — под каждое ухо столбик riser
   (1.25/4.75/8.25), винт сквозь ухо и столбик в плиту. Разъём — в вырез
   к грифу. Мотор k = тележка k.
6. БАРАБАНЫ (все одинаковые): на шестерню стопкой кольцо -> кольцо ->
   крышка, между слоями капля суперклея на торец ядра (не в ручей!).
7. Направляющие ролики: трубка (латунь или bush) в ролик, M4 в плиту,
   не затягивать до упора — ролик должен крутиться.
8. ТРОСЫ: через направляющие ролики к своему барабану (дальние — НАД
   ближними роликами). Конец A: снизу вверх сквозь дырочку КРЫШКИ, узел
   сверху. Конец B: вниз сквозь дырочку НИЖНЕГО кольца, узел плоско +
   оплавить зажигалкой. Тележку в СЕРЕДИНУ хода, намотать по 2-3 витка
   В ПРОТИВОПОЛОЖНЫЕ стороны (A — верхний ручей, B — нижний).
   Проверка: барабан пальцем — тележка ездит, оба троса натянуты.
   Натяг: грубо — перестановка стопки на зуб шестерни (~3 мм), точно —
   проворот барабана с проскальзыванием витков.

Проверка: ход +-20 мм от упора до упора, трос нигде не чиркает. Если
пятка цепляет угловой ролик в крайнем положении — ограничить ход +-19
в прошивке. Намотка барабана: ~29.8 мм/об (ядро Ø9 + трос 0.5).
