Korvova/gitar/print/_архив/_старые_папки/1_зона_секция/README.txt

ПАРТИЯ 1: секция зоны (проверка посадки слоёв)
seg1_base.stl  x1 — PLA/PETG, плашмя, 0.2мм
deck1.stl      x1 — плашмя
cover1.stl     x1 — плашмя
Сухая сборка: ролики из партии 2 -> палуба на M2x6 -> крышка на M2x6.
