Korvova/gitar/print/_архив/_старые_папки/2_ролики_и_тележка/README.txt

ПАРТИЯ 2: ролики и тележка
roller_ER_x4.stl 	печатать 4 шт — слои 0.12
roller_CR_x8.stl 	печатать 8 шт — слои 0.12
carriage_low_outer_x2.stl	2 шт
carriage_low_inner_x2.stl	2 шт (карманы под гайки M2)
+ штифты Ø4x12 — 16 шт (резать из прутка или печатать стоя)
