Korvova/gitar/print/_архив/_старые_папки/4_дека_и_шестерни/README.txt

ПАРТИЯ 4: дека и привод
deka_panel — 1 шт (моторы снизу, уши на M3)
pinion_low_x2 — 2 шт, pinion_high_x2 — 2 шт (слои 0.12, прессом на вал)
carriage_high_outer_x2 / inner_x2 — по 2 шт
