Korvova/gitar/print/_архив/ленточная_версия/1/README.txt

ПАПКА 1 — напечатать и проверить (ОБНОВЛЕНО: палуба без дырок у щелей,
тележка развёрнута правильно, клемма 8 мм):
  seg1_base, deck1, cover1 — по 1 шт (плашмя)
  roller_ER_x4 — 4 шт;  roller_CR_x8 — 8 шт (слои 0.12)
  carriage_low_outer_x2 и carriage_low_inner_x2 — по 2 шт
Штифты Ø4: для петлевых (ER) — 12 мм (верх садится в палубу/крышку),
для угловых (CR) — 10 мм (консольные, до палубы НЕ достают).
ПРОВЕРКА: ролики на штифты -> палуба на M2x6 -> крышка на M2x6 ->
ножка тележки в щель: ход свободный, ~19-20 мм.
