Korvova/gitar/print/_архив/ленточная_версия/2/README.txt

ПАПКА 2 — после успеха папки 1:
  seg2_base, seg3_base, deck2, deck3, cover2, cover3 — по 1 шт
  splice_x2 — 2 шт (стык сегментов на M2)
  deka_panel — 1 шт (моторы снизу, уши на M3)
  pinion_low_x2 и pinion_high_x2 — по 2 шт (слои 0.12, прессом на вал)
  carriage_high_outer_x2 и carriage_high_inner_x2 — по 2 шт
ПРОВЕРКА: сегменты стыкуются пластинами; моторы в гнёзда панели;
шестерни на валы — зубья на высоте своего этажа.
