Korvova/gitar/print/_архив/ленточная_версия/3/README.txt

ПАПКА 3 — ленты (TPU 95A, стенка: линия 0.35 x 2 периметра, слои 0.15,
шов на зубчатую сторону, печатаются как лежат - змейкой):
belt_lane1.stl - 1 шт (304 зубьев)
belt_lane2.stl - 1 шт (296 зубьев)
belt_lane3.stl - 1 шт (322 зубьев)
belt_lane4.stl - 1 шт (315 зубьев)
Зубья снизу (первые 3.2 мм высоты). Устанавливать зубьями к своей шестерне.
