Korvova/gitar/print/2/README.txt

ПАПКА 2 — остальной гриф и дека:
  seg2_body, seg3_body, seg2_cover, seg3_cover — по 1 шт
  deka_panel — 1 шт (гнёзда моторов как на стенде, M3)
  drum_x4 — 4 шт (барабан Ø8 на шестерёнку мотора, 2 отверстия под узлы)
СБОРКА: нити обеих сторон лодочки -> ролики -> канавки -> глазок панели ->
2-3 витка на барабан в противоположные стороны -> узлы в отверстия.
