Korvova/gitar/print/_архив/_старые_папки/3_сегменты_грифа/README.txt

ПАРТИЯ 3: длинные сегменты грифа
seg2_base, seg3_base, deck2, deck3, cover2, cover3 — по 1 шт
splice_x2 — 2 шт (стыковые пластины, M2)
Печать плашмя; сегменты 230мм — по диагонали стола если не лезут.
