Korvova/gitar/2-0/manual/grif.html

# 🎸 ГРИФ гитары-тренажёра — сборка трёх секций

Гриф = 3 секции по 160 мм (всего 480, мензура 650, лады на настоящих позициях). Секция-1 — «моторная голова» без мотора: в ней 4 плеча-кулисы и 4 тележки-пальца. Секции 2 и 3 — «туннели»: по ним к секции-1 бегут 4 ленты-тяги от моторов в корпусе.

Печать: столы 31_gitara_sec1_plity (4 плиты), 32_gitara_sec1_meh (палуба + механика), 33_gitara_sec2, 34_gitara_sec3. Для столов 33 и 34 включи в слайсере поддержки «только от стола» — у дна секций стыковой вырез нависает на 1.5 мм. Остальное — без поддержек.

## Шаг 0 — что должно быть на руках

Деталь | Сколько | Откуда
Плиты секции-1: дно P0 (с полкой на юг), межэтажки P1–P3 | 4 | стол 31
Палуба P4 (канал тележек + лады) | 1 | стол 32
Плечо-кулиса (диск с дыркой + длинное плечо со штырём вверх + короткое со стадом) | 4 | стол 32
Спица-голова (лента с кольцом на ступеньке, хвост с защёлкой) | 4 | стол 32
Тележка-палец (с вилкой-пазом на юг) | 4 | стол 32
Дно секции-2 / секции-3 | 1+1 | столы 33/34
П-рейка (жёлоб ленты) | 8 (по 4) | столы 33/34
Фретборд секции-2; фретборд секции-3 с языком на юг | 1+1 | столы 33/34

Крепёж: винты М3: 6 стяжек ~30 мм (стопка секции-1), 14 × ~10 мм (фретборды), 8 × ~8 мм (два стыка секций «бутербродом»). Отвёртка. Ни штифтов, ни клея.

## Шаг 1 — секция-1: этаж 0

этаж 0

Положи дно P0 полкой на юг (полка — тонкий выступ, он потом зайдёт под секцию-2). На плите торчит стад оси — надень на него плечо-0 диском. Длинное плечо смотрит на юг (вдоль грифа), его высокий штырь — вверх. На стад короткого плеча (у жёлоба) надень спицу-0 кольцом: её тело ляжет в жёлоб, ступенька поднимает кольцо над плечом, а хвост с защёлкой уйдёт на юг за край секции.

Покрути плечо пальцем: спица ездит вдоль жёлоба туда-сюда. Так работает каждый этаж.

## Шаг 2 — этажи 1–3: стопка

стопка

Накрой этаж межэтажкой P1: высокий штырь плеча-0 пройди в её дуговую прорезь (штырь будет ездить по ней). На стад P1 — плечо-1, на него спицу-1. Дальше так же: P2 + плечо-2 + спица-2, P3 + плечо-3 + спица-3. Каждая следующая прорезь пропускает ВСЕ нижние штыри.

Плиты сядут на внутренние колонны и приливы по бокам — если плита не ложится плоско, проверь, что штыри плеч попали в прорези, а не упёрлись в плиту.

## Шаг 3 — палуба и тележки

палуба и тележки

Накрой стопку палубой P4 (лады сверху, канал тележек поперёк). Все 4 штыря плеч выйдут в общий канал. Опусти 4 тележки в канал вилками на север (открытым пазом к оси плеча, от головы грифа) — каждая вилка садится на свой штырь. Физика 09.09.2026: на краю хода штырь уходит по дуге к оси на 4–5 мм; вилкой на юг ему оставалось 0.5 мм — упор в торец. Тележки стоят вплотную друг к другу (шаг 16 мм) и ездят каждая от своего плеча.

Стяни стопку 6 винтами М3×30 через приливы по бокам (3 пары).

Подвигай спицу-0 за хвост — тележка-0 едет поперёк грифа. Проверь все четыре.

## Шаг 4 — секции 2 и 3: рейки в дно

секция 2

В дно секции-2 уложи стопкой 4 П-рейки (жёлобом вверх) — они встают в карман дна друг на друга: подошва каждой следующей закрывает жёлоб предыдущей. По этим жёлобам поедут ленты. То же самое — с секцией-3.

Ленты в жёлобы пока НЕ клади: они протягиваются на общей сборке с корпусом, по одному этажу снизу вверх (см. deka.html, шаг «Ленты»).

## Шаг 5 — фретборды

фретборды

Накрой каждую секцию фретбордом (лады сверху): его язычок с 45°-скосами лёгонько прижмёт верхнюю рейку/ленту. Прикрути 7 винтами М3×10: 4 — в стенки жёлоба (по 2 с каждого конца), 3 — вдоль западного борта. Винты нарезаются сами, позиции подобраны между ладами.

У фретборда секции-3 на юг торчит язык 55×26 с двумя дырками — он НЕ прикручивается сейчас: ляжет в окно крышки корпуса и прошьётся в хребет (см. deka.html).

## Шаг 6 — стыки секций

Состыкуй секции на столе: полка юга нижней секции заходит ПОД вырез севера следующей («бутерброд»), 4 канала совпадают. Прошей каждый стык 4 винтами М3×8 снизу — винт проходит нижнюю полку насквозь и нарезается в верхнюю. Гриф из трёх секций готов.

Хвосты 4 спиц торчат из секции-1 на юг — за них дальше зацепятся ленты. Продолжение — сборка корпуса и общая стыковка: manual/deka.html.

## Что проверить руками

- Каждое плечо ходит свободно во всём секторе, штырь не цепляет прорези;
- Тележки ездят без закусывания по всему ходу 40 мм;
- Спицы не выпрыгивают с стадов (их держит следующая плита);
- Если трёт — капля силиконовой смазки с PTFE на стады и в канал тележек.

Гитара-тренажёр · гриф · файлы: gitara_sec1.py, gitara_sec2.py, сцена Гитара_секция1.blend, инструкция — manual/grif.html
