Korvova/gitar/2-0/manual/palka.html

# 🔩 Тест-стенд механизма «палка» — подробная сборка

Стол печати: Print3mf\21_palka_test.3mf — 22 детали, все печатаются как лежат. Это одна станция привода: мотор → кривошип → спица-шатун → треугольник → штырь в вилке тележки (кулиса: высокий штырь плеча ходит в вилке палубы — ни серьги, ни губок, ни шатуна). Проверено честной физической симуляцией: ход тележки 43–45 мм, полный оборот и качание.

Откуда мостики и шайба: физическая симуляция показала, что под нагрузкой детали пытаются выползти вверх по штырькам. Поэтому каждый узел заперт сверху: спицу держат 2 мостика, плечо — низкий мост, тележку — высокий мост и высокие рельсы, треугольник — шайба на винте M2.

Штифты не нужны! Во всех шарнирах — печатный штырёк Ø5 на одной детали и ямка Ø6 на другой (зазор 1 мм — крутится свободно): детали просто надеваются друг на друга сверху.

## Шаг 0 — что должно быть на руках

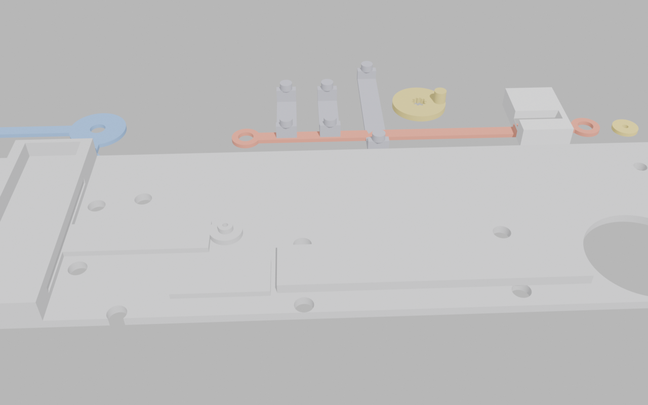
[picture p371: 2-0/manual/img/palka_step1.png]
все детали


№ | Деталь | Сколько | Цвет на картинках
1 | Плита-стенд 255×70 | 1 | серая
2 | Ножка-столбик с шипом | 4 | тёмно-серые
3 | Треугольник (два плеча + диск) | 1 | синий
4 | Спица-шатун (длинная полоска ~144 мм, две дырки, хвост приподнят ступенькой) | 1 | красная
5 | Кривошипы со звёздочкой и пальцем: r6 / 6.5 / 7 / 8 / 8.5 / 9 / 10 — радиус задаёт ход (≈ 6.15·r − 10.6 мм); начни с r8.5 | 7 | жёлтые
6 | Тележка-ползун (в палубе — сквозная щель-кулиса) | 1 | белая
7 | Заглушка-«фальшмотор» | 1 | для игры без мотора
8 | Мостик-прижим спицы (штыри в ямки) | 2 | серые
9 | Низкий мост (над длинным плечом) | 1 | серый
10 | Высокий мост (над тележкой) | 2 | серые
11 | Шайба оси треугольника (+ винт M2) | 1 | жёлтая

Из инструментов нужны 2 винта M3 (если ставишь мотор), 1 винт M2 (шайба оси) и отвёртка. Больше ничего: ни штифтов, ни клея.

## Шаг 1 — ножки

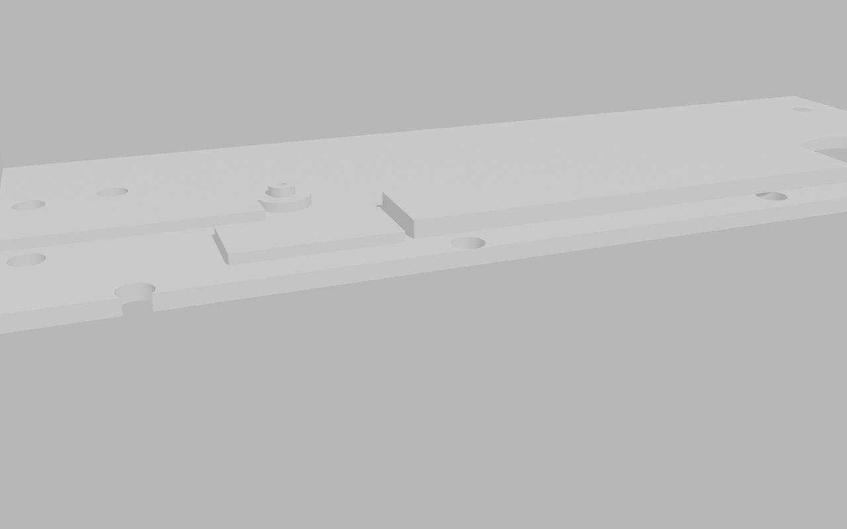
[picture p372: 2-0/manual/img/palka_step2.png]
ножки


Переверни плиту. По углам — четыре отверстия. Вставь шип каждой ножки в отверстие до упора (плотно, можно капнуть клея). Поставь плиту на ножки — она стоит как столик, под ней место для мотора.

## Шаг 2 — мотор (вариант А)

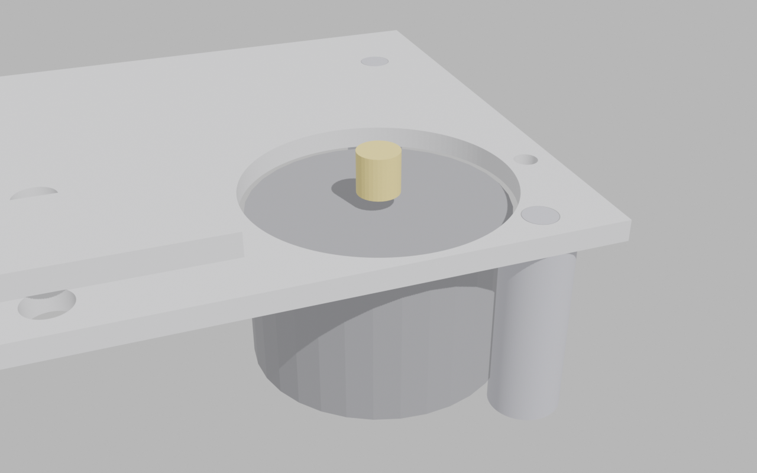
[picture p373: 2-0/manual/img/palka_step3.png]
мотор


Возьми NEMA14. Снизу плиты вставь его валом вверх в большой круглый колодец — вал с шестернёй выйдет над плитой. Поверни мотор так, чтобы уши легли вдоль плиты, и прикрути 2 винтами M3 через отверстия рядом с колодцем (самонарез прямо в уши).

Вариант Б — без мотора: положи в колодец заглушку — из её центра торчит пенёк, на него сядет звёздочка кривошипа, крутить будешь пальцем.
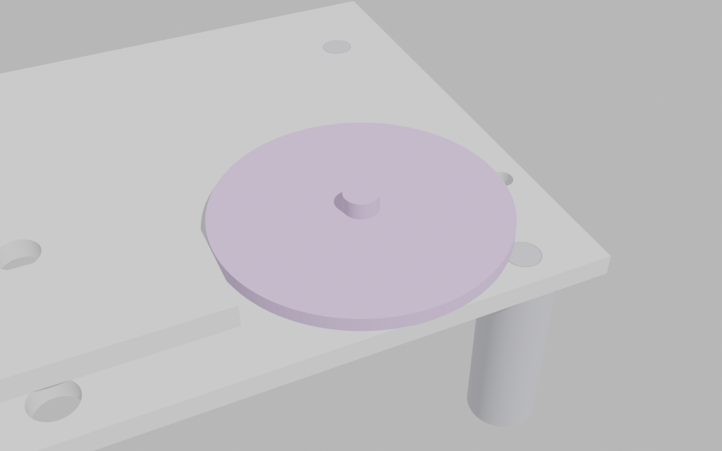
[picture p374: 2-0/manual/img/palka_step3b.png]
заглушка


## Шаг 3 — треугольник на ось

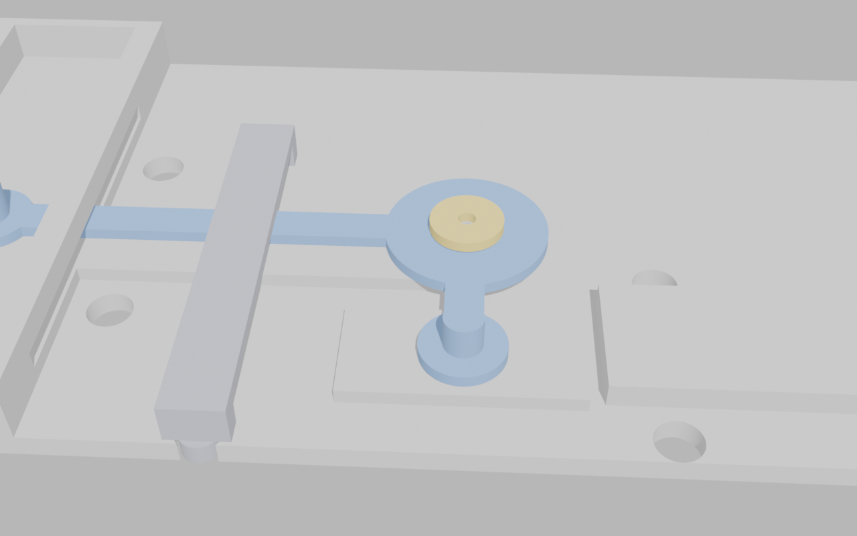
[picture p375: 2-0/manual/img/palka_step4.png]
треугольник


На стойке плиты сверху уже торчит бугорок. Надень на него треугольник центральной дыркой диска. Длинное плечо смотрит влево (к каналу тележки), короткое — к ближнему краю плиты. Крутится пальцем свободно? Отлично. Бугорки на концах его плеч смотрят вверх.

Теперь запри узел: положи шайбу на бугорок оси и вкрути винт M2 в дырочку в его торце (самонарез). Затем защёлкни низкий мост штырями в ямки поперёк длинного плеча — плечо будет ходить под ним.

## Шаг 4 — кривошип

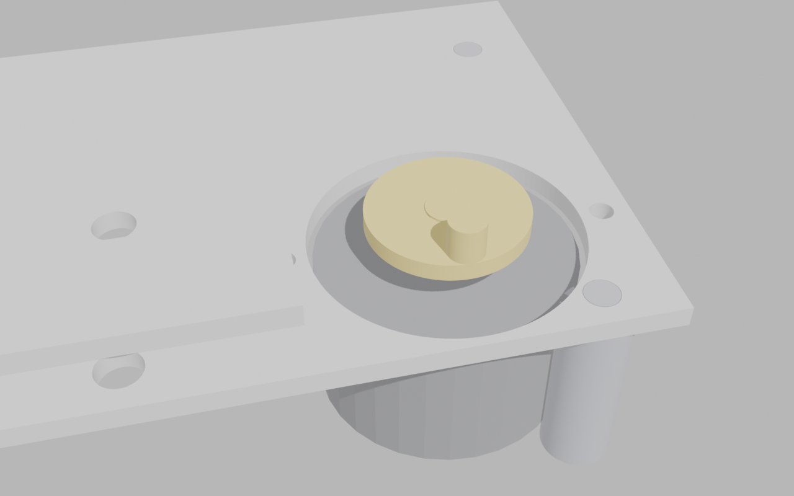
[picture p376: 2-0/manual/img/palka_step5.png]
кривошип


Возьми кривошип r6.5 (средний; r6 — ход меньше, r7 — больше) и надень звёздочкой на шестерню мотора (или на пенёк заглушки). Его палец-бугорок смотрит вверх.

## Шаг 5 — спица-шатун

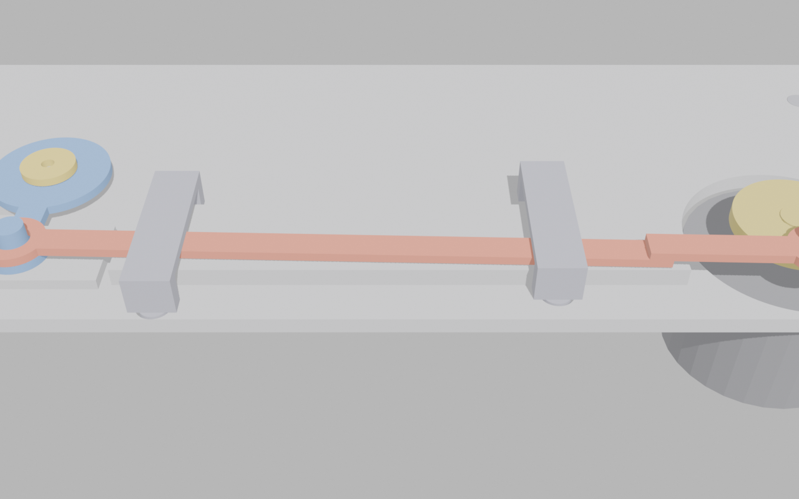
[picture p377: 2-0/manual/img/palka_step6.png]
спица


Возьми спицу. Её плоский конец надень дыркой на бугорок короткого плеча треугольника, а приподнятый ступенькой хвост — дыркой на палец кривошипа (ступенька нужна, чтобы хвост проходил над диском кривошипа). Спица ляжет на длинную полку. Сверху защёлкни два мостика штырями в ямки — они не дают спице выскочить вверх с пальца. Покрути кривошип — спица ездит, треугольник машет.

## Шаг 6 — тележка на штырь

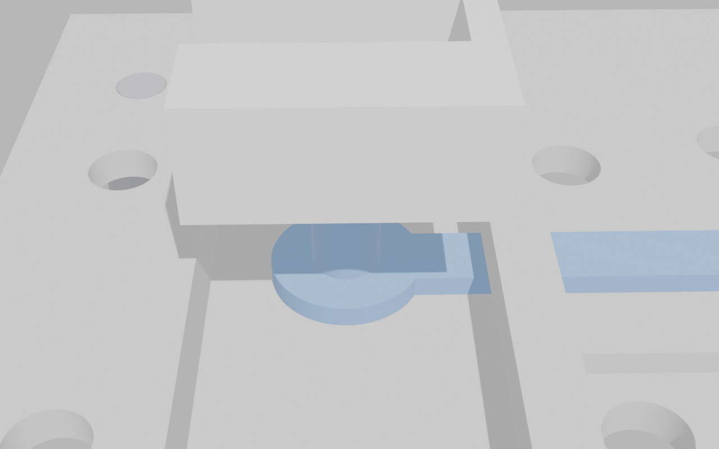
[picture p378: 2-0/manual/img/palka_step7.png]
тележка на штырь


На конце длинного плеча вверх торчит высокий штырь (плечо заходит в проём восточной рельсы под навесной стенкой). Опусти тележку в канал между рельсами так, чтобы штырь вошёл в вилку её палубы (вилка открыта к западной рельсе — можно и надвинуть тележку боком). Сверху видно, как штырь ездит в вилке: вдоль канала он зажат плотно (привод), поперёк — гуляет по дуге. Никакой серьги не нужно.

## Шаг 7 — два высоких моста

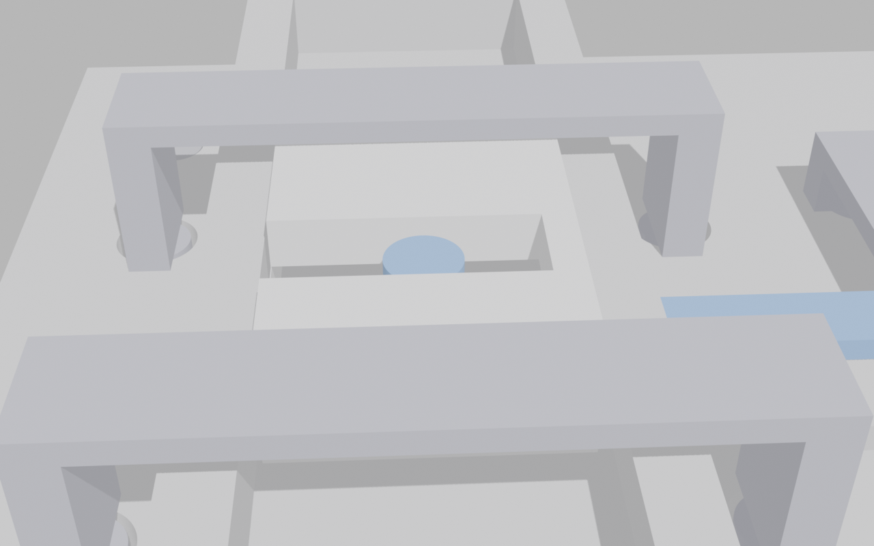
[picture p379: 2-0/manual/img/palka_step8.png]
высокие мосты


Защёлкни оба высоких моста штырями в ямки поперёк канала — тележка ездит под ними и не может подпрыгнуть ни в одном положении хода. Если ход тяжеловат — капля силиконовой смазки в вилку и вдоль рельс. Всё, ни одного штифта не понадобилось.

## Шаг 8 — готово!

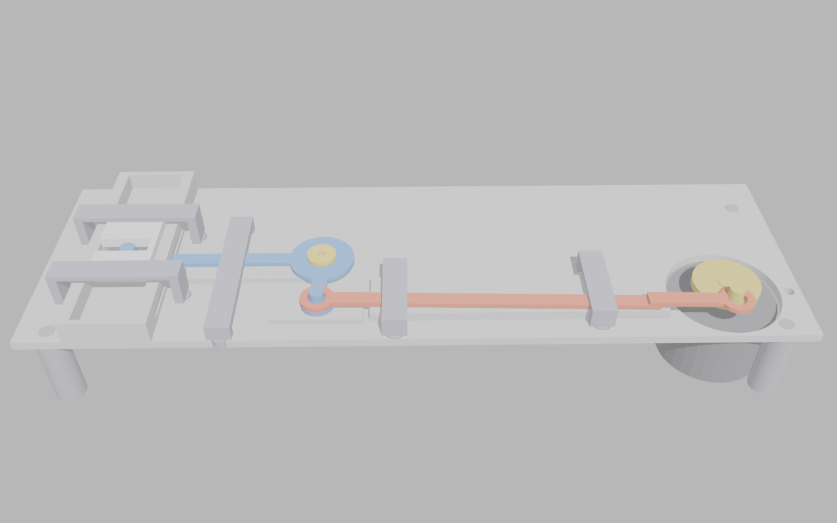
[picture p380: 2-0/manual/img/palka_step9.png]
финал


Крути кривошип (или запусти мотор с пульта 192.168.1.4) — тележка ездит поперёк канала. Рабочий режим — КАЧАНИЕ: не полные обороты, а туда-сюда в секторе ±60° вокруг нижней точки (позиция тележки однозначна по углу мотора). С кривошипом r8.5 ход ~43 мм; хочешь другой ход — поменяй кривошип или сектор.

## Что проверить руками

- Люфт: держи кривошип и покачай тележку — сколько набегает мёртвого хода;
- Крайние положения: не подклинивает ли, когда штырь глубоко в вилке и спица под максимальным углом;
- Мёртвый ход: держи кривошип, покачай тележку — люфты Ø5/Ø6 дают заметный свободный ход (это цена лёгкой сборки);
- Спица: не соскакивает ли с бугорков на полном обороте;
- Радиус пальца: поменяй кривошип на r6 или r7 — ход меньше/больше;
- Если что-то трёт — капля силиконовой смазки на штифты и в губки.

Гитара-тренажёр · тест механизма «палка» · файлы: palka_test.py, Гитара_палка.blend, инструкция — manual/palka.html
