Korvova/gitar/2-0/manual/tie.html

# Сектор-барабан: привязка тросов (вид сверху)

Гриф и ролики — слева. Красная нить — от верхнего ролика, синяя — от нижнего. Мотор — «🖐 Отпустить».

## 1Исходное положение

Тележку рукой — в центр хода. Сектор поверни так, чтобы ушки смотрели поперёк (вертикально на картинке: одно к верхнему ролику, другое к нижнему). Нити пока свободны.

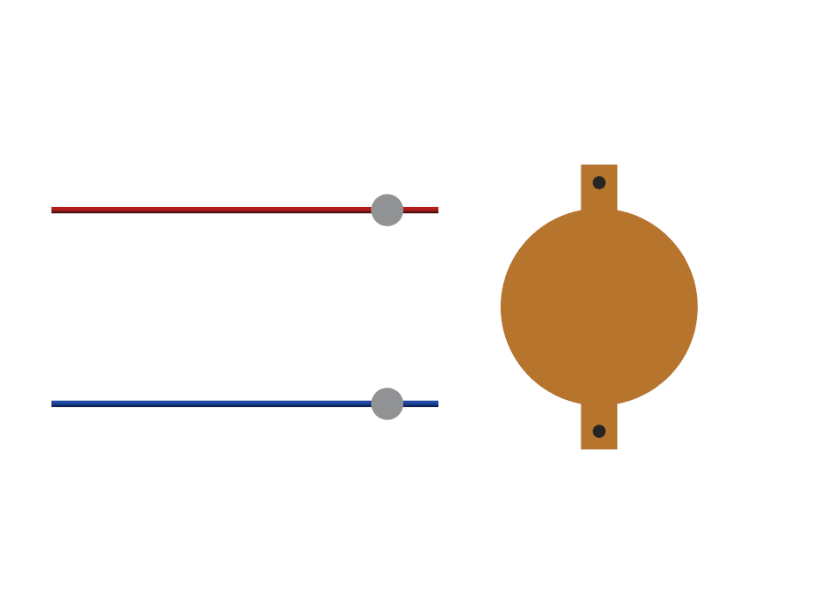
[picture p395: 2-0/manual/img/tie1.png]
Шаг 1: тележка в центре, ушки поперёк


## 2Первая нить — полоборота вокруг дальней стороны

Красную нить веди от её ролика вокруг дальней (правой) стороны цилиндра примерно полоборота — к нижнему ушку. Натяни рукой без провиса и привяжи двойным узлом.

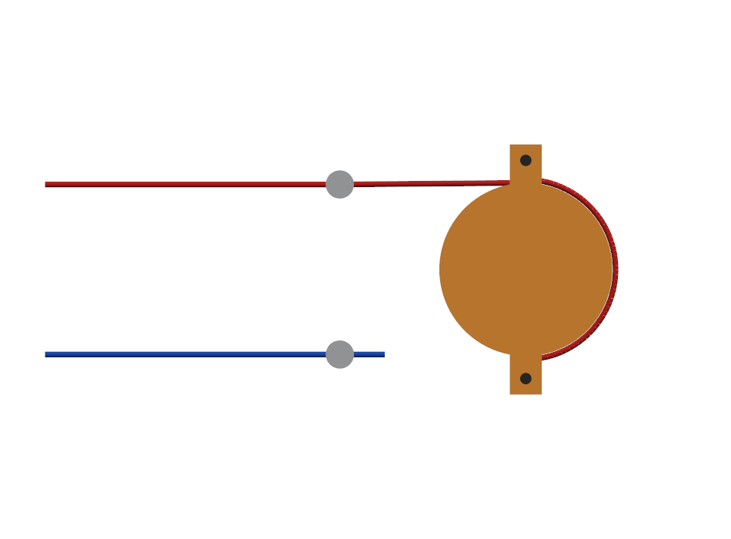
[picture p396: 2-0/manual/img/tie2.png]
Шаг 2: красная нить полоборота по часовой к нижнему ушку


## 3Вторая нить — встречно, тоже полоборота

Синюю нить веди от её ролика вокруг той же дальней стороны, но навстречу (снизу вверх) — к верхнему ушку. Натяни и привяжи. Нити лягут рядом по правой стороне — это нормально, они на цилиндре не трутся: работают на разных дугах.

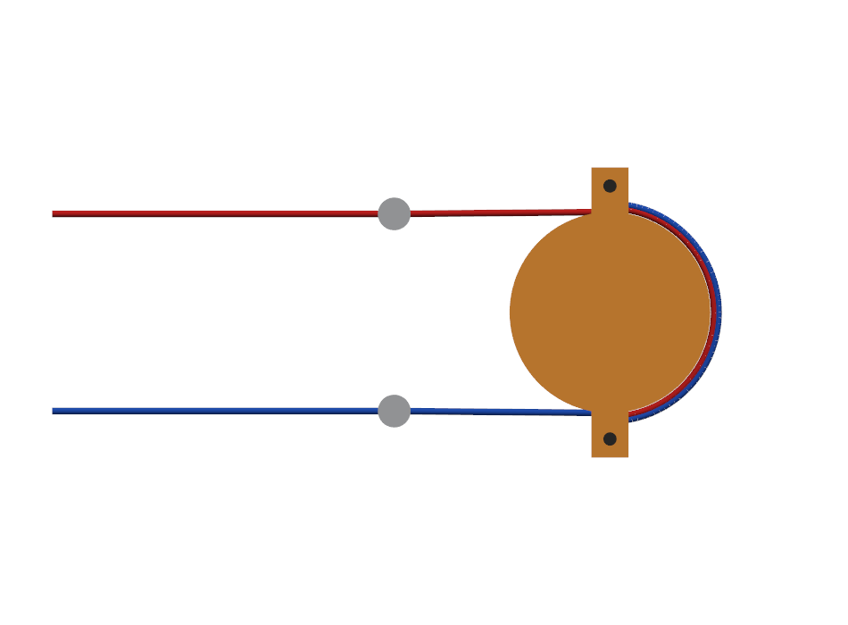
[picture p397: 2-0/manual/img/tie3.png]
Шаг 3: синяя нить встречно к верхнему ушку


## 4Проверка

Прокати тележку рукой до упоров: сектор крутится, одна нить доматывается, другая отдаётся, обе всегда натянуты. На картинке — тележка у правого края: красная намоталась почти на ¾ оборота, синяя отдалась до короткой дуги.

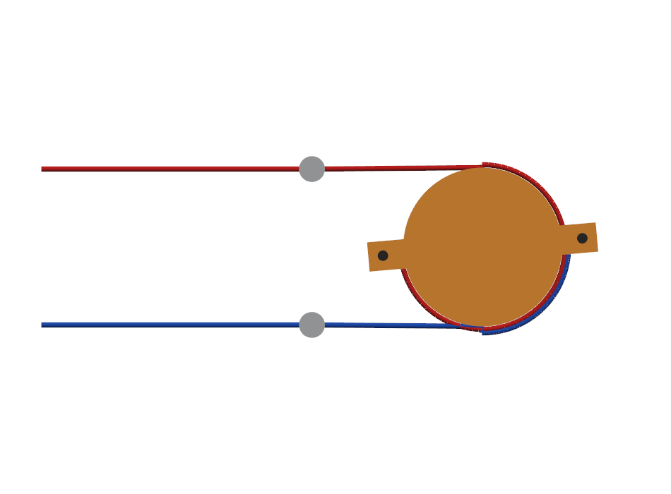
[picture p398: 2-0/manual/img/tie4.png]
Шаг 4: крайнее положение — одна нить домоталась, другая отдалась


Если при прокатке какая-то нить провисает — перевяжи её узел на 2–3 мм короче. После проверки: «✊ Держать» → отметь края на пульте → «▶ Тренажёр».

## 5Фиксация «как ремешок часов» — U-змейка через пазы

После обхвата подними нить по боку и заведи U-змейкой через пару пазов: вниз до дна первого паза → вверх → через гребень → вниз во второй → вверх, хвост наружу. Натяг регулируется протяжкой нити с усилием — а рабочая тяга держится на перегибах, без узлов. У каждой нити своя пара пазов (по разные стороны от звёздочки).

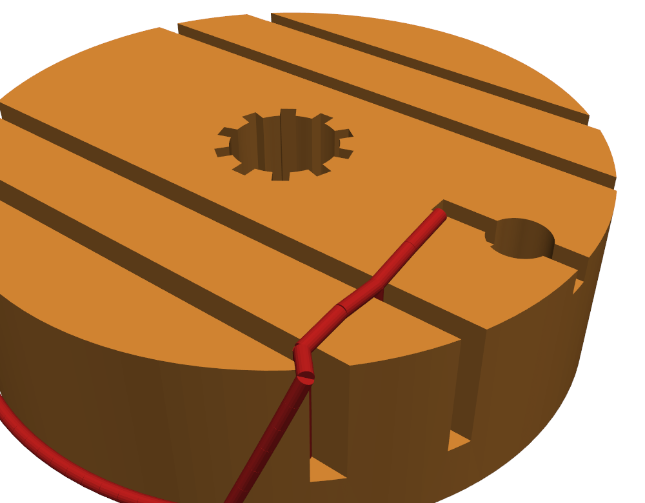
[picture p399: 2-0/manual/img/tie5_slots.png]
U-змейка нити через сквозные пазы


Твист-лок (крышка-байонет): в положении «О» (риски совпали) нить свободно протягивается через пазы — выставь натяг; надень крышку штифтами во входы и поверни на 18° до щелчка — гребёнка крышки запирает нить в пазах. Открыть: поворот обратно до «О».

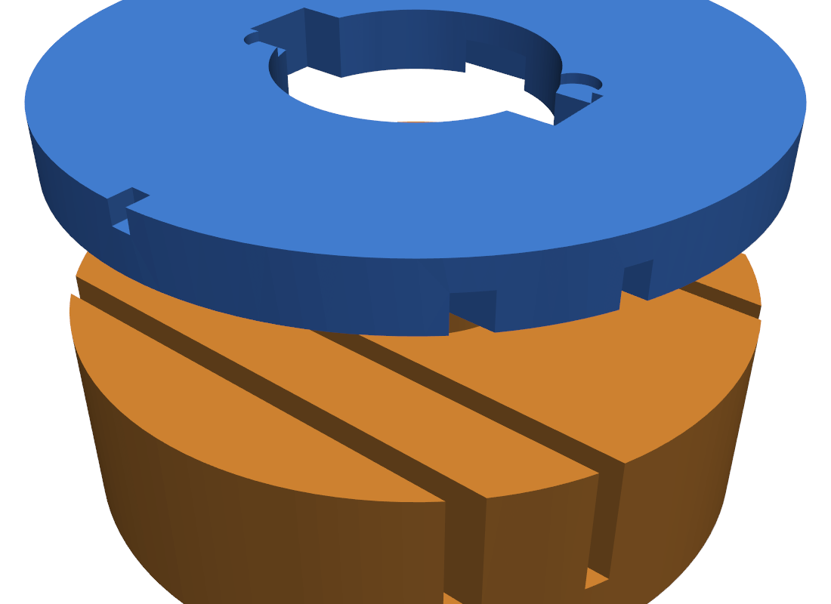
[picture p400: 2-0/manual/img/tie6_twist.png]
Твист-лок: тело с пазами и крышка-байонет


← к основной инструкции
