Korvova/gitar/2-0/astra/deka-astra/images/assembly.png

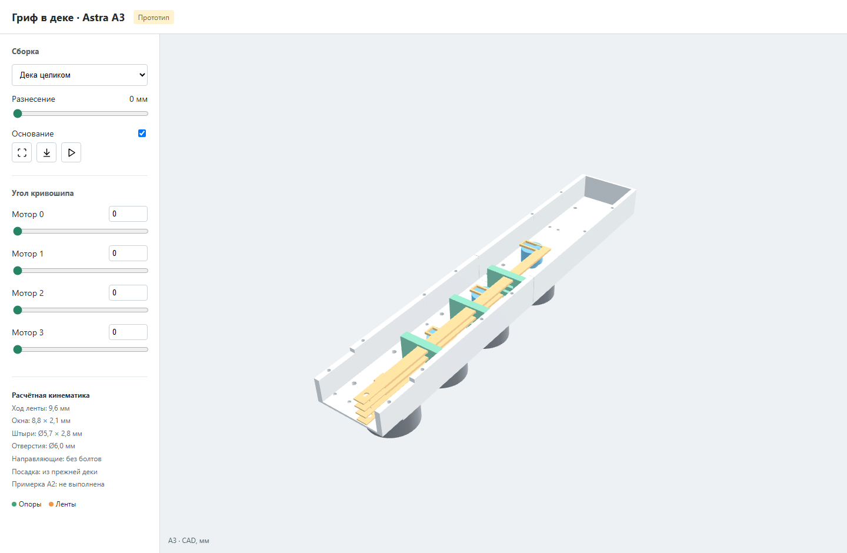
2-0/astra/deka-astra/images/assembly.png
