Korvova/gitar/2-0/astra/deka-astra/images/assembly_cad.png

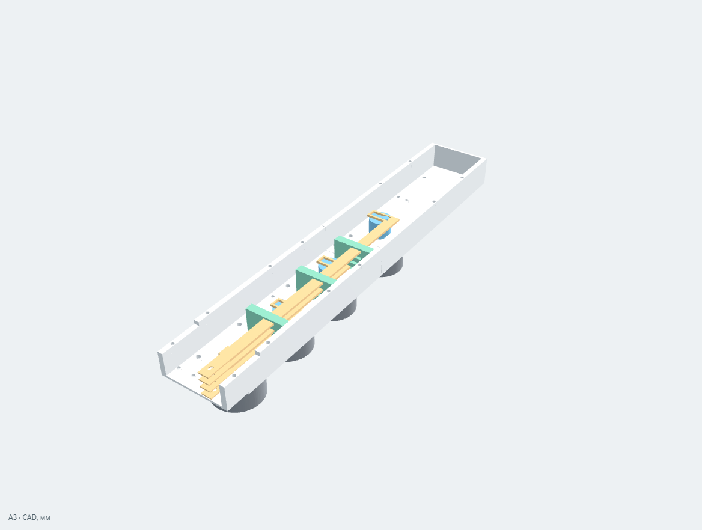
2-0/astra/deka-astra/images/assembly_cad.png
