Korvova/gitar/2-0/astra/deka-astra/images/guide.png

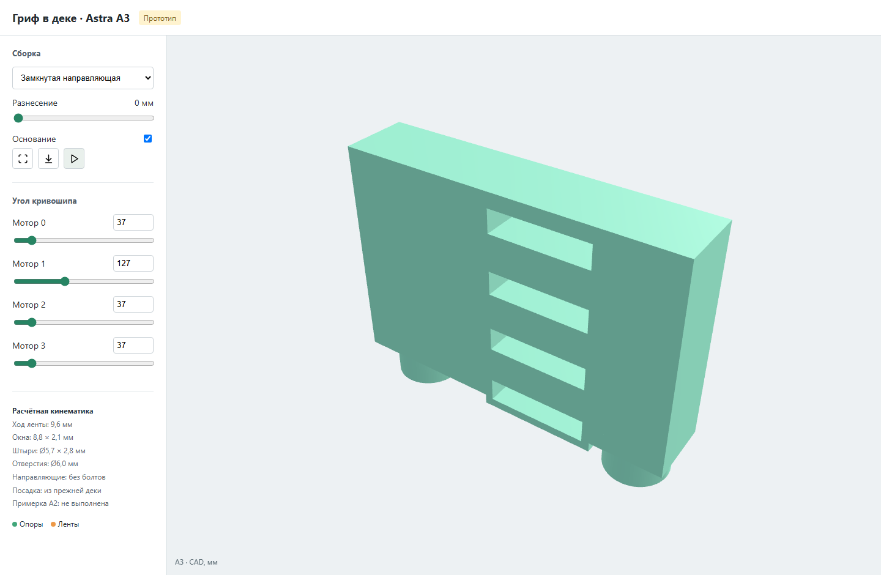
2-0/astra/deka-astra/images/guide.png
