Korvova/gitar/2-0/astra/deka-astra/images/guide_cad.png

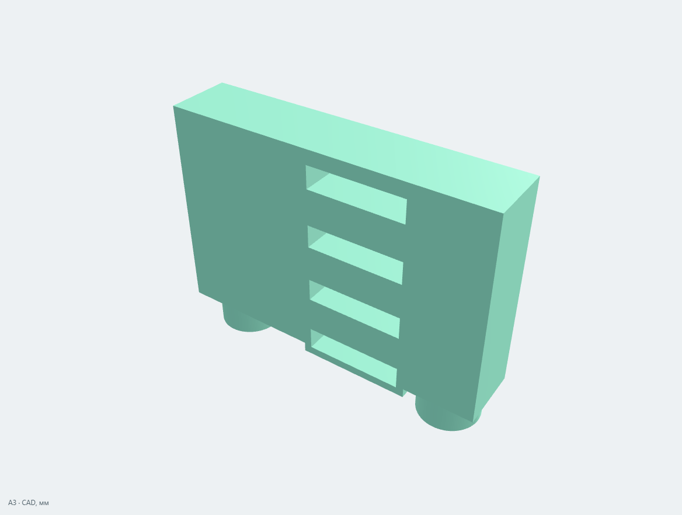
2-0/astra/deka-astra/images/guide_cad.png
