Korvova/gitar/2-0/manual/img/_b1_close.png

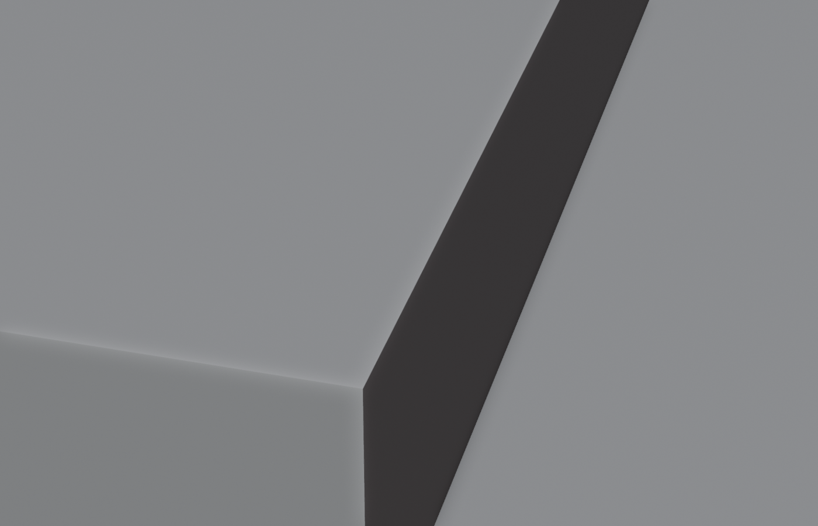
2-0/manual/img/_b1_close.png
