Korvova/gitar/2-0/manual/img/_b1_level2.png

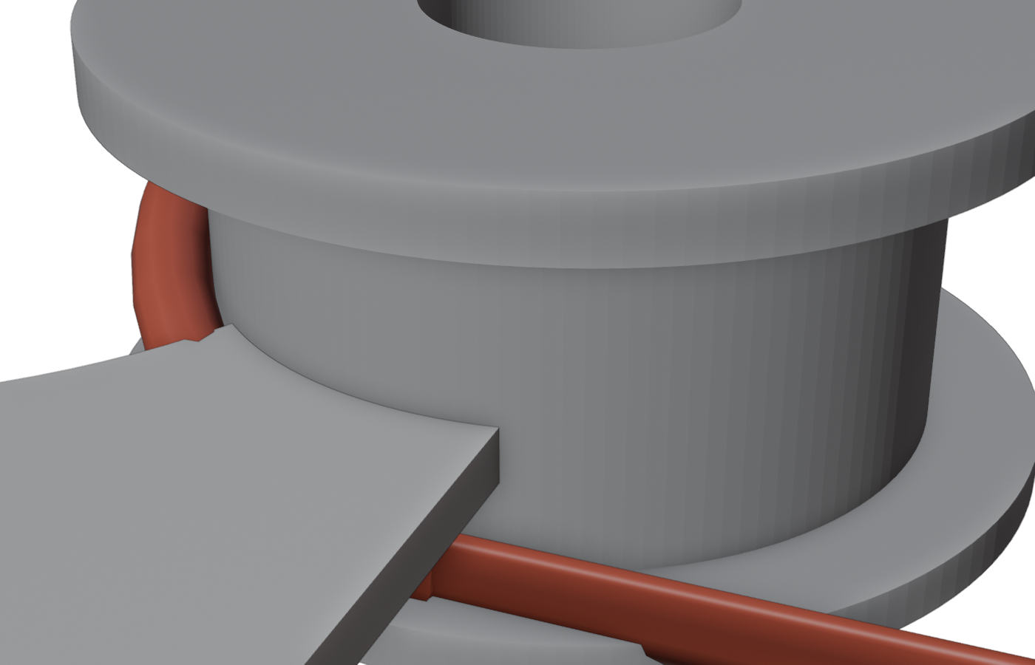
2-0/manual/img/_b1_level2.png
