Korvova/gitar/2-0/manual/img/_b1_liner_fixed.png

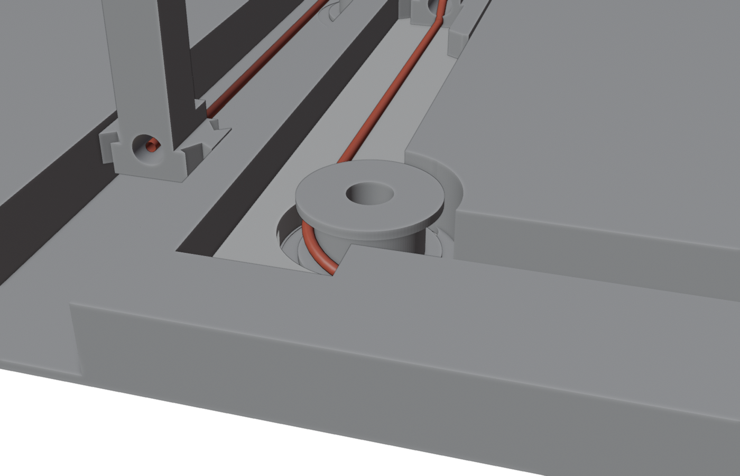
2-0/manual/img/_b1_liner_fixed.png
