Korvova/gitar/2-0/manual/img/_b1_top.png

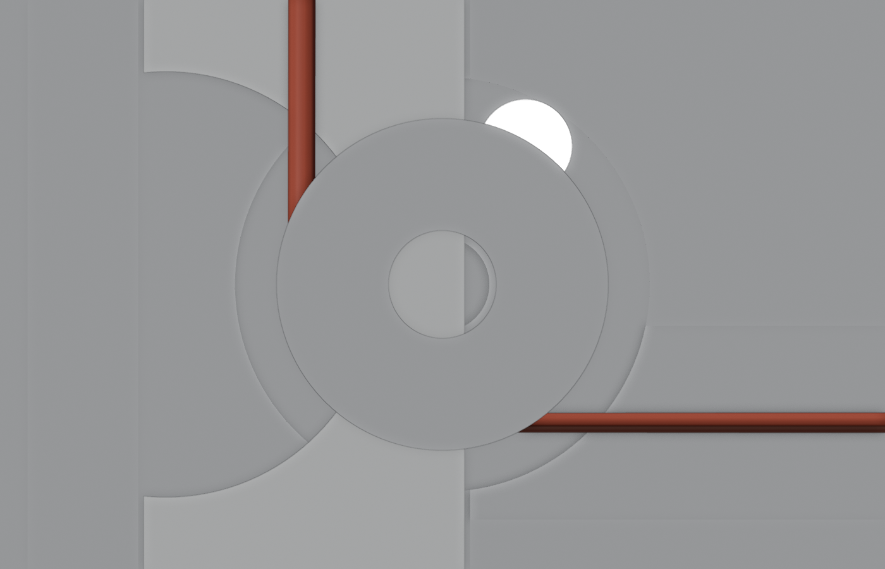
2-0/manual/img/_b1_top.png
