Korvova/gitar/2-0/manual/img/_cables_check2.png

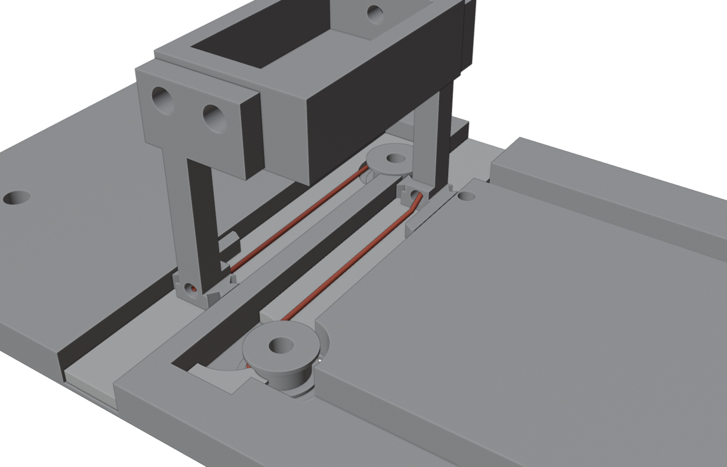
2-0/manual/img/_cables_check2.png
