Korvova/gitar/2-0/manual/img/_cables_check3.png

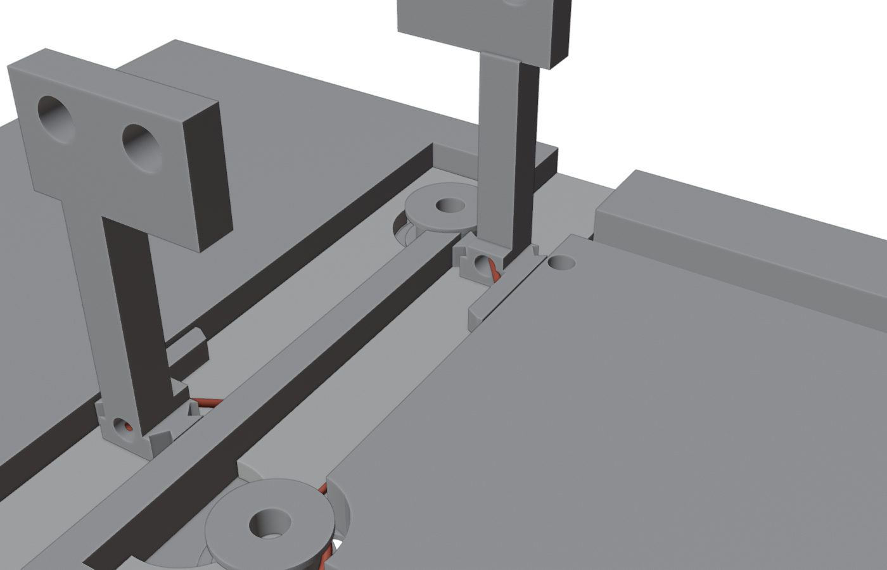
2-0/manual/img/_cables_check3.png
