Korvova/gitar/2-0/manual/img/_cables_check.png

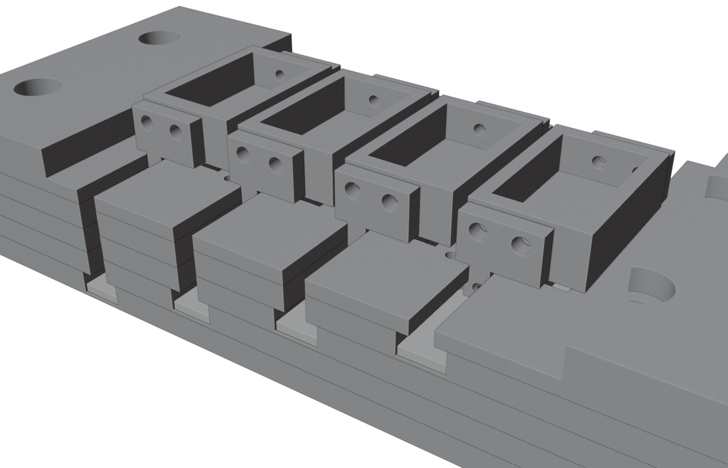
2-0/manual/img/_cables_check.png
