Korvova/gitar/2-0/manual/img/_cables_top2.png

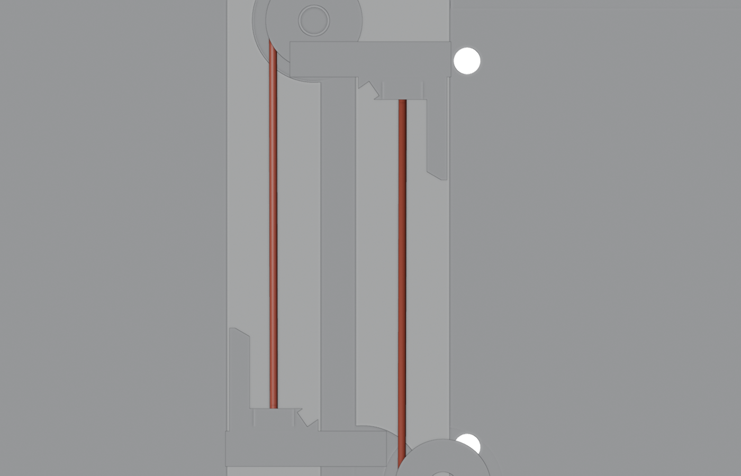
2-0/manual/img/_cables_top2.png
