Korvova/gitar/2-0/manual/img/_cables_top.png

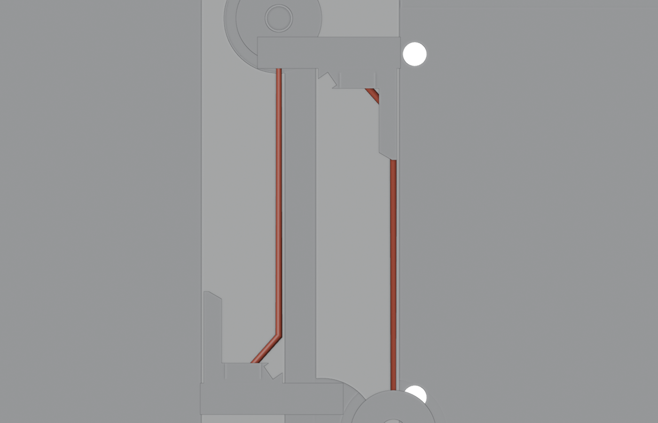
2-0/manual/img/_cables_top.png
