Korvova/gitar/2-0/manual/img/_disk_final.png

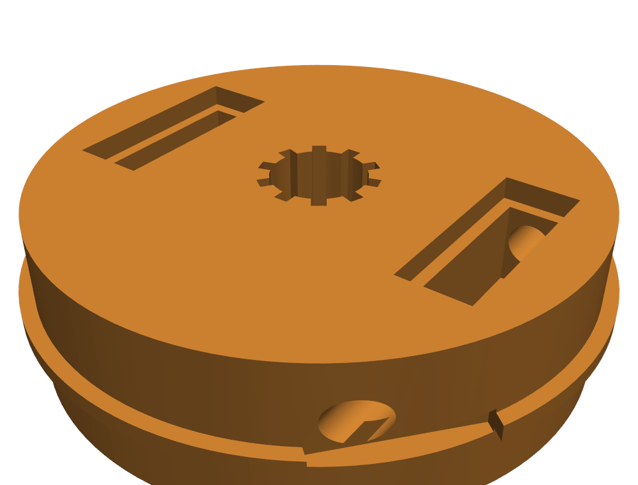
2-0/manual/img/_disk_final.png
