Korvova/gitar/2-0/manual/img/_disk_grooves.png

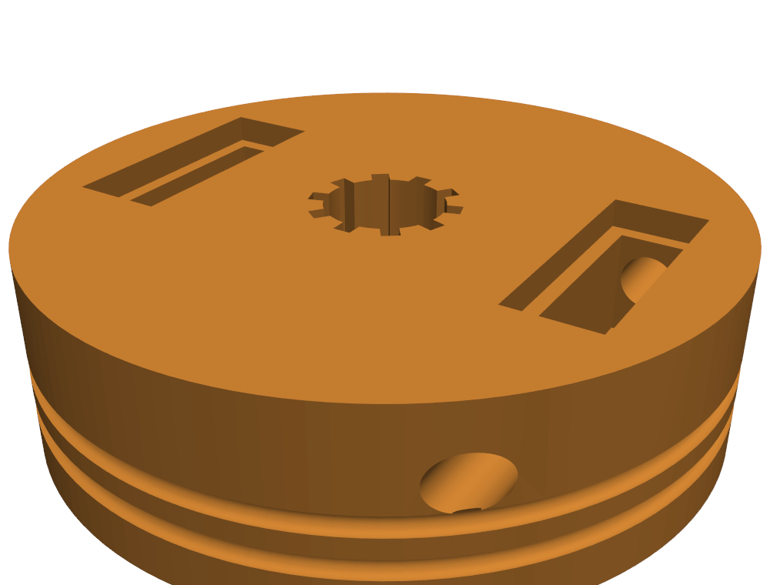
2-0/manual/img/_disk_grooves.png
