Korvova/gitar/2-0/manual/img/_fin_hole2.png

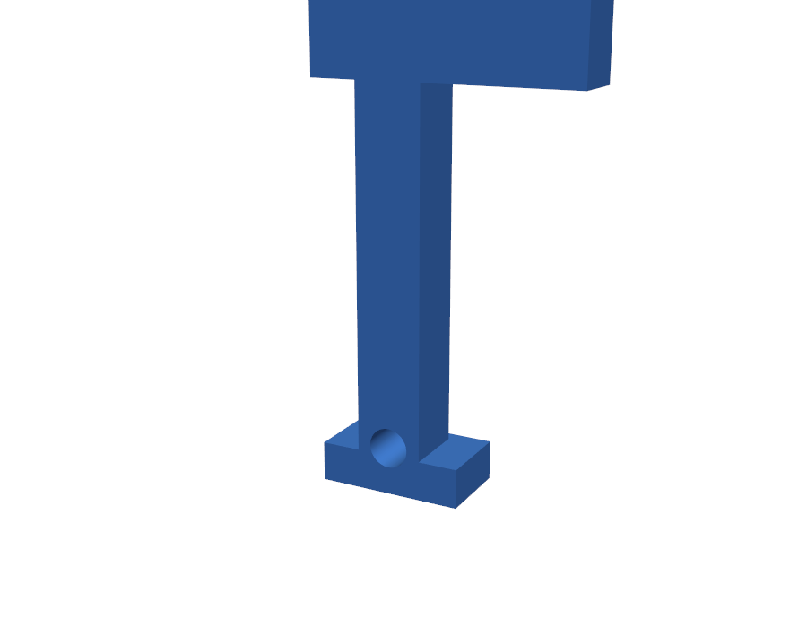
2-0/manual/img/_fin_hole2.png
