Korvova/gitar/2-0/manual/img/_finB_pass.png

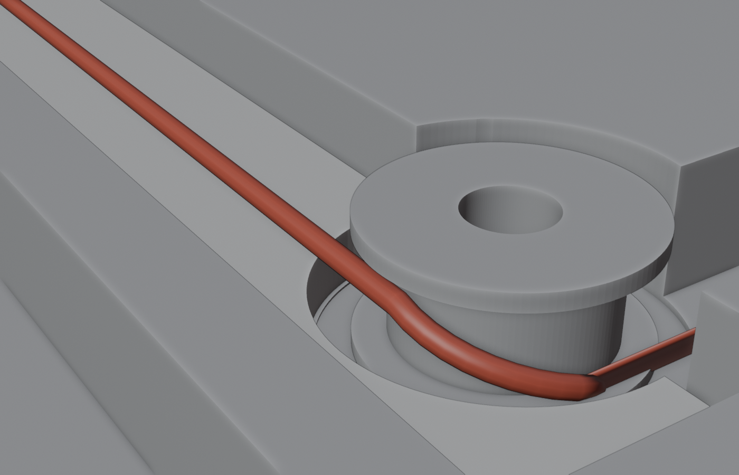
2-0/manual/img/_finB_pass.png
