Korvova/gitar/2-0/manual/img/_flex_demo.png

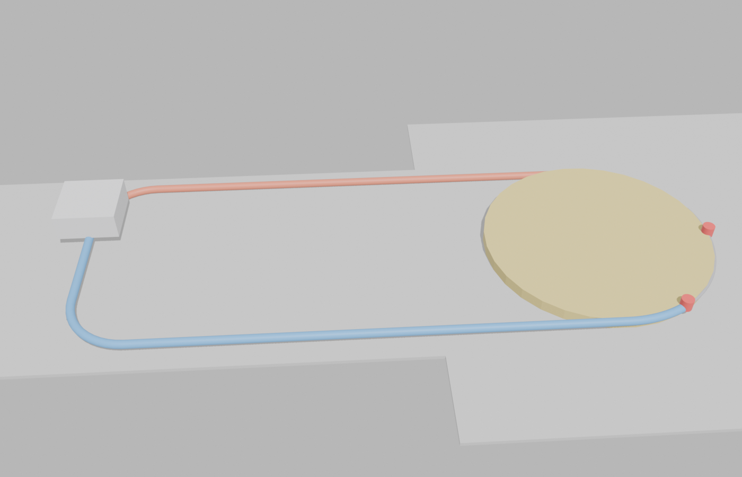
2-0/manual/img/_flex_demo.png
