Korvova/gitar/2-0/manual/img/_keylock2.png

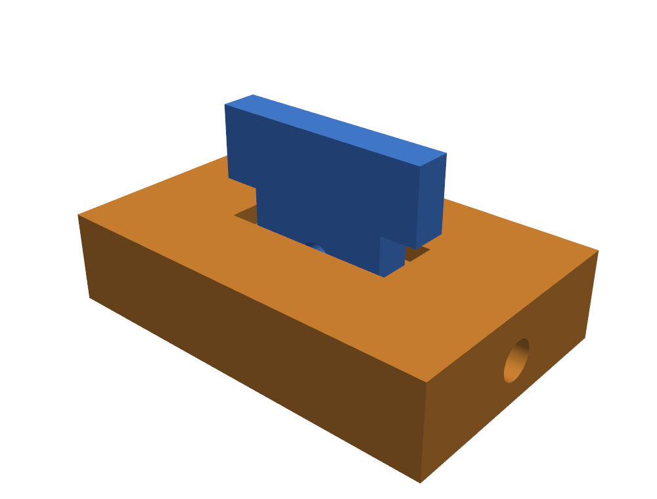
2-0/manual/img/_keylock2.png
