Korvova/gitar/2-0/manual/img/_keylock.png

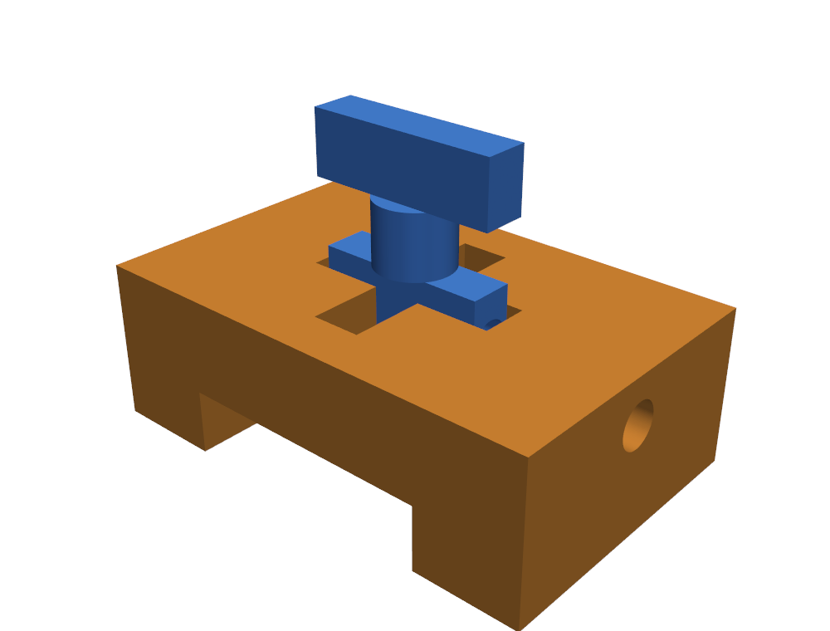
2-0/manual/img/_keylock.png
