Korvova/gitar/2-0/manual/img/_liner_screw.png

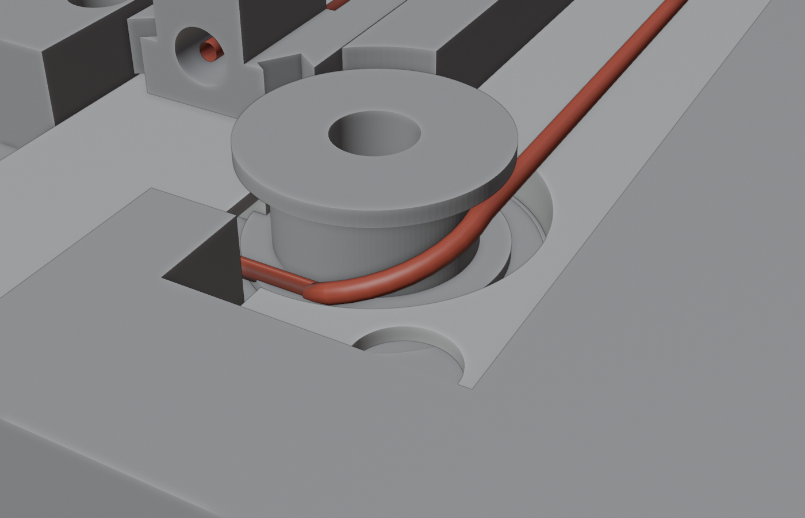
2-0/manual/img/_liner_screw.png
