Korvova/gitar/2-0/manual/img/_linerB_tunnel.png

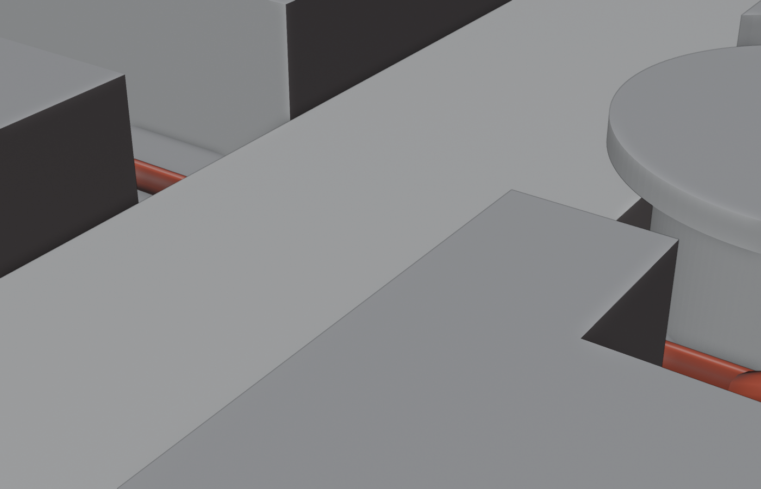
2-0/manual/img/_linerB_tunnel.png
