Korvova/gitar/2-0/manual/img/_odnoetazhnik.png

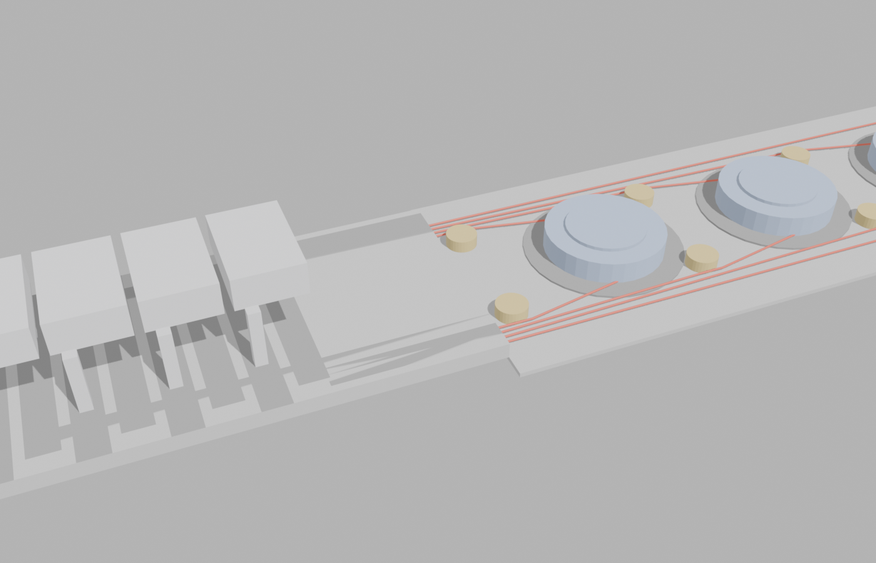
2-0/manual/img/_odnoetazhnik.png
