Korvova/gitar/2-0/manual/img/_palka_demo3.png

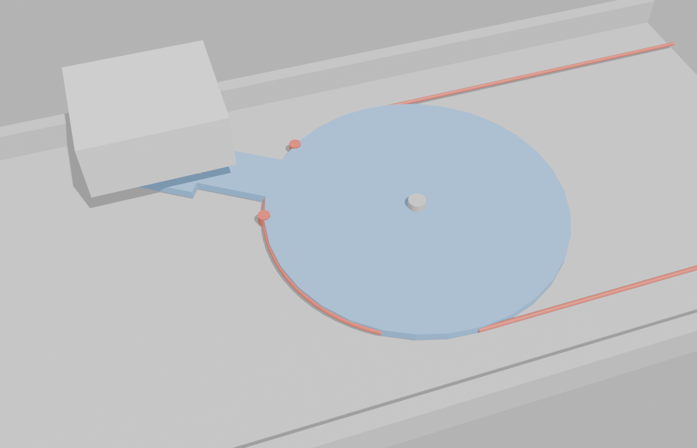
2-0/manual/img/_palka_demo3.png
