Korvova/gitar/2-0/manual/img/_palka_demo4.png

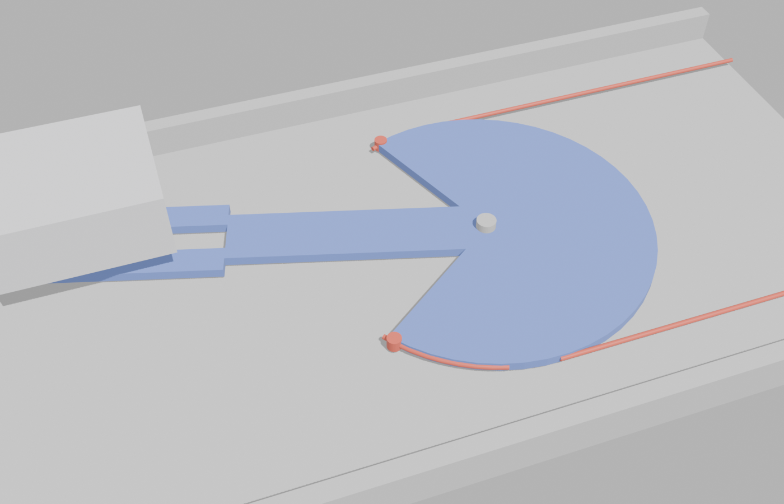
2-0/manual/img/_palka_demo4.png
