Korvova/gitar/2-0/manual/img/_palka_demo5.png

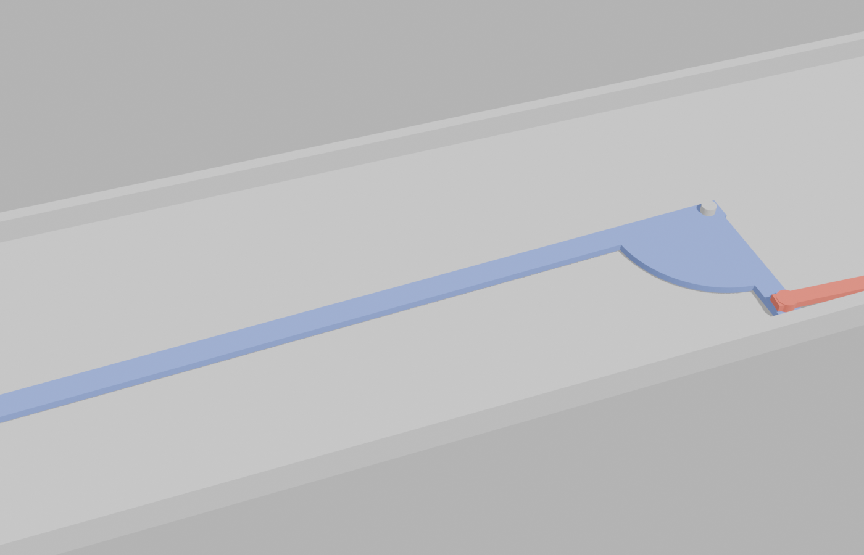
2-0/manual/img/_palka_demo5.png
