Korvova/gitar/2-0/manual/img/_palka_demo7.png

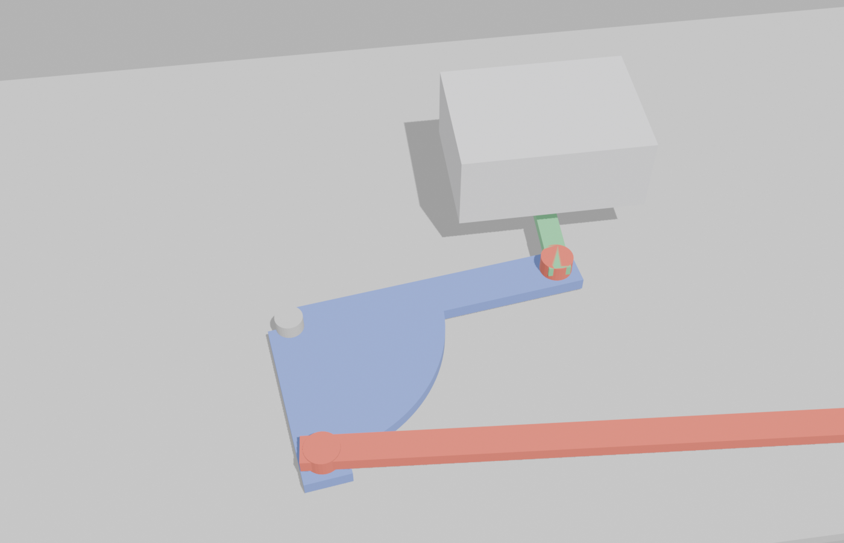
2-0/manual/img/_palka_demo7.png
