Korvova/gitar/2-0/manual/img/_palka_demo9.png

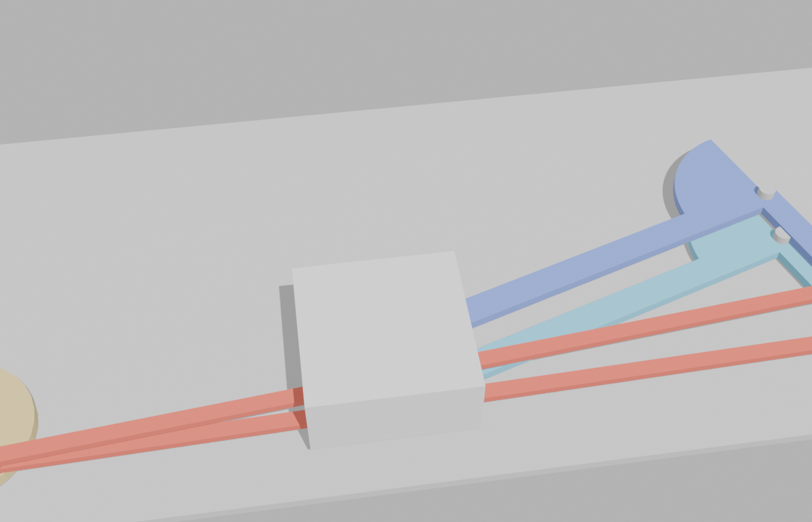
2-0/manual/img/_palka_demo9.png
