Korvova/gitar/2-0/manual/img/_palka_demo.png

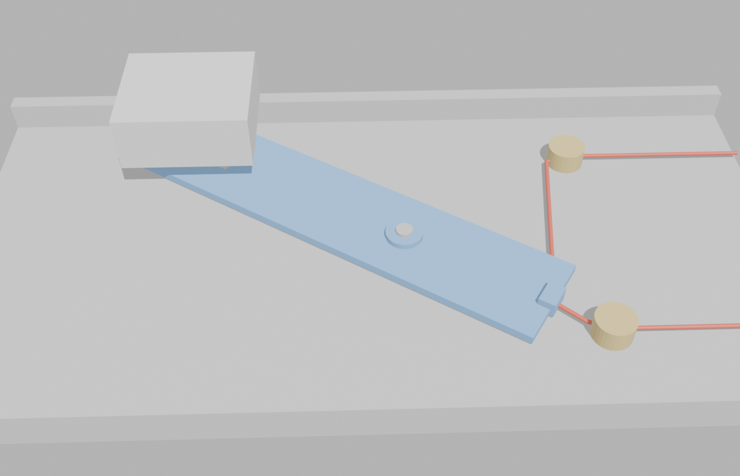
2-0/manual/img/_palka_demo.png
