Korvova/gitar/2-0/manual/img/_palka_full.png

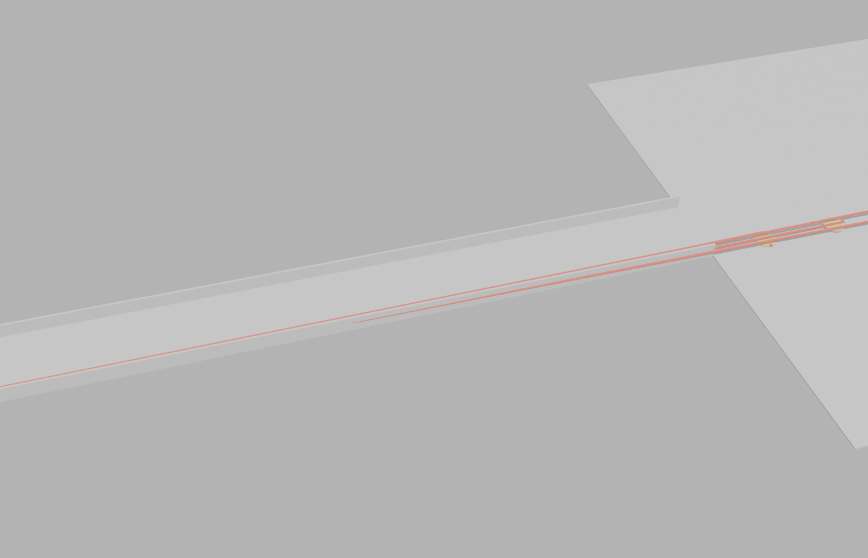
2-0/manual/img/_palka_full.png
