Korvova/gitar/2-0/manual/img/_palka_guitar.png

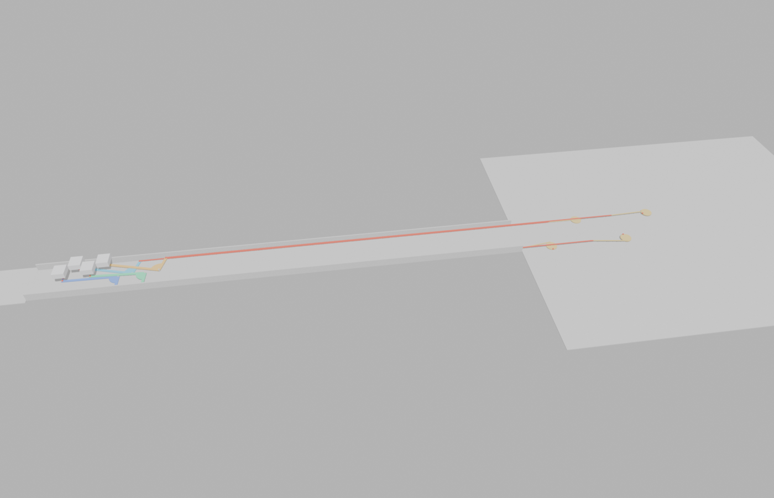
2-0/manual/img/_palka_guitar.png
