Korvova/gitar/2-0/manual/img/_palka_scale.png

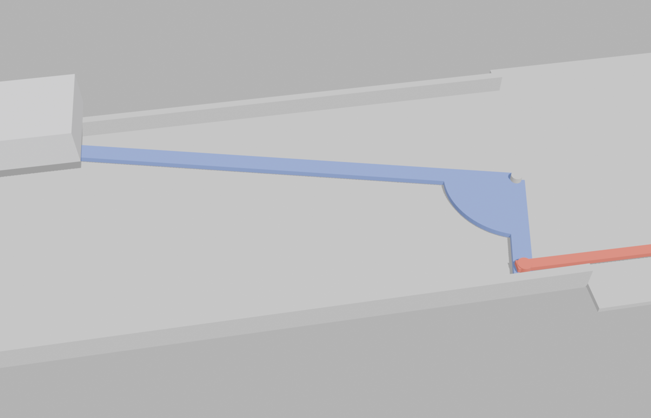
2-0/manual/img/_palka_scale.png
