Korvova/gitar/2-0/manual/img/_parus_demo.png

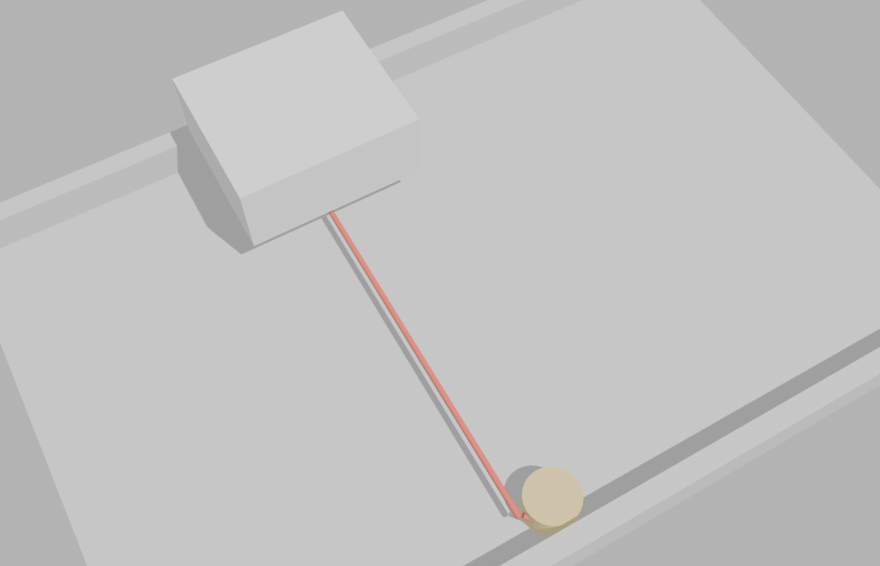
2-0/manual/img/_parus_demo.png
