Korvova/gitar/2-0/manual/img/_parus_top.png

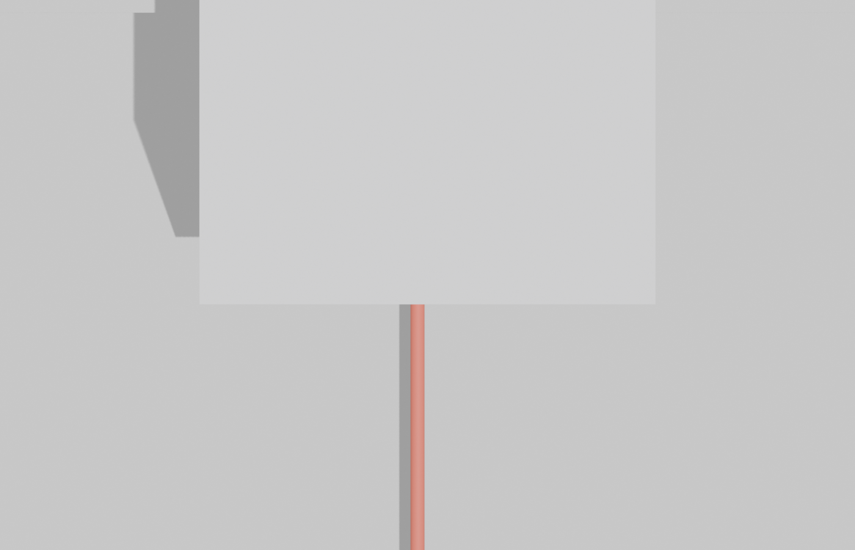
2-0/manual/img/_parus_top.png
