Korvova/gitar/2-0/manual/img/_sec1.png

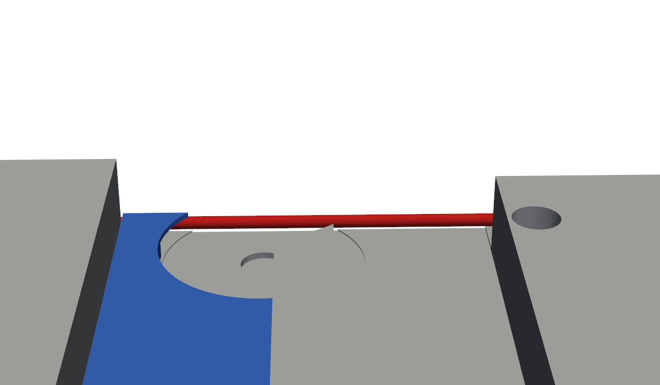
2-0/manual/img/_sec1.png
