Korvova/gitar/2-0/manual/img/_sec2.png

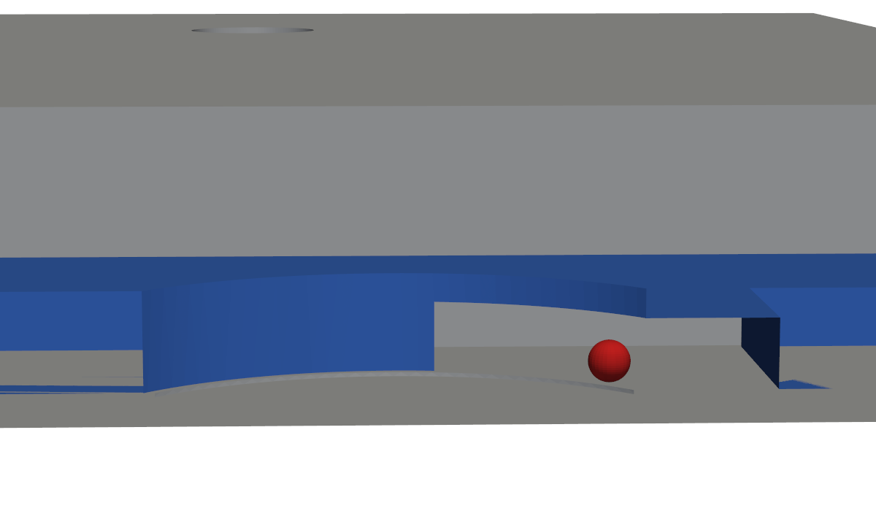
2-0/manual/img/_sec2.png
