Korvova/gitar/2-0/manual/img/_ski.png

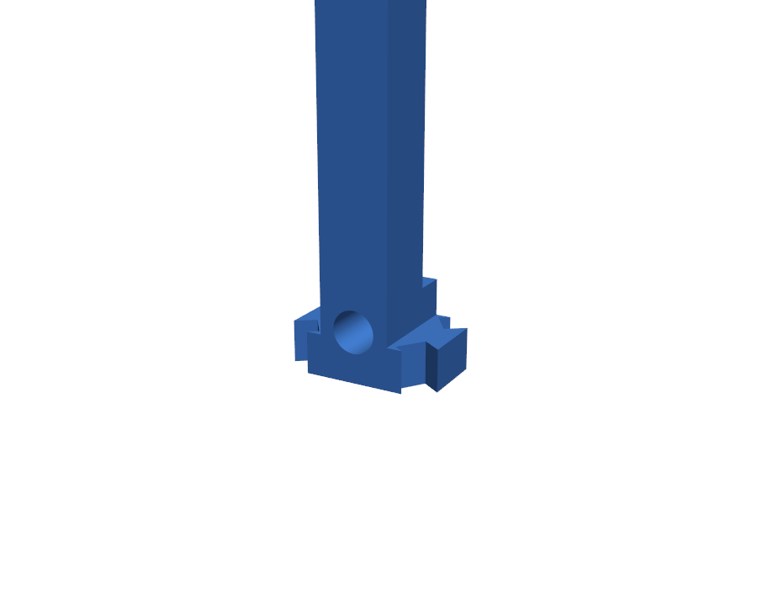
2-0/manual/img/_ski.png
