Korvova/gitar/2-0/manual/img/_slots.png

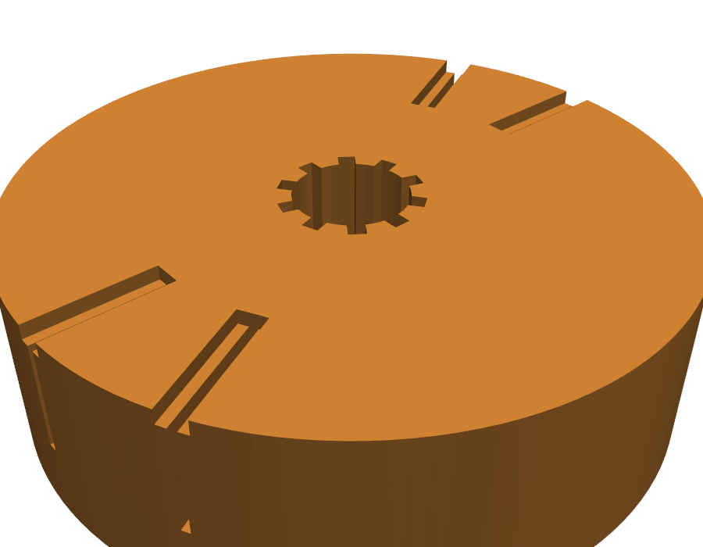
2-0/manual/img/_slots.png
