Korvova/gitar/2-0/manual/img/_userview3.png

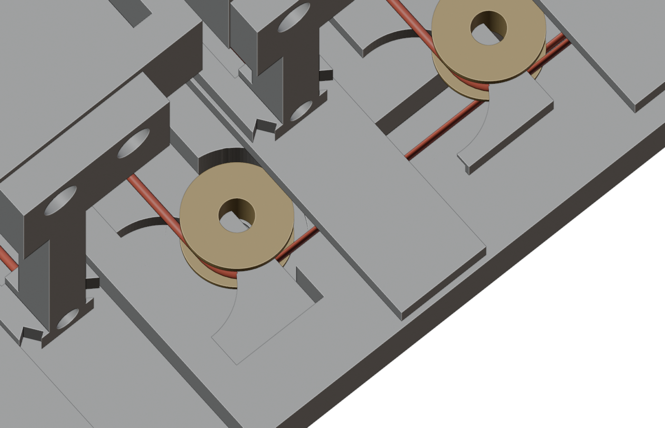
2-0/manual/img/_userview3.png
