Korvova/gitar/2-0/manual/img/_v10b.png

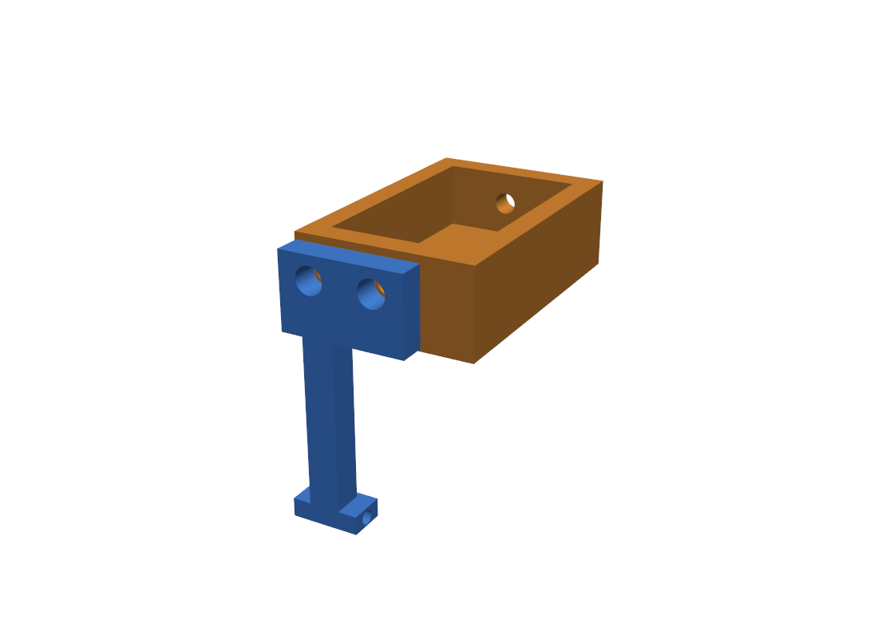
2-0/manual/img/_v10b.png
