Korvova/gitar/2-0/manual/img/_zigzag.png

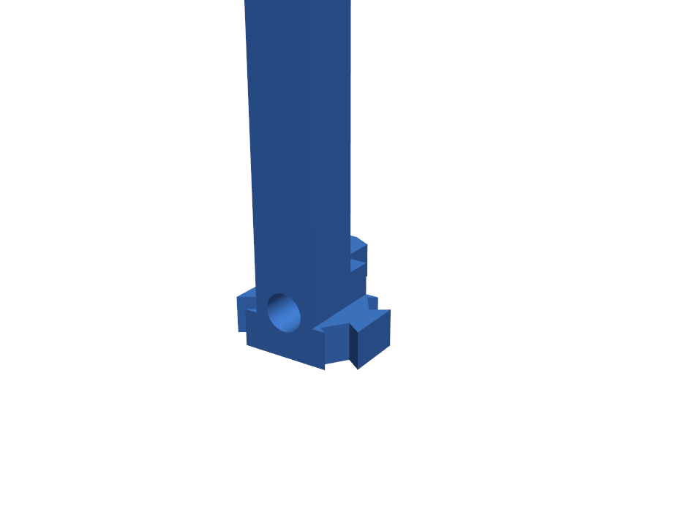
2-0/manual/img/_zigzag.png
