Korvova/gitar/2-0/manual/img/peg1.png

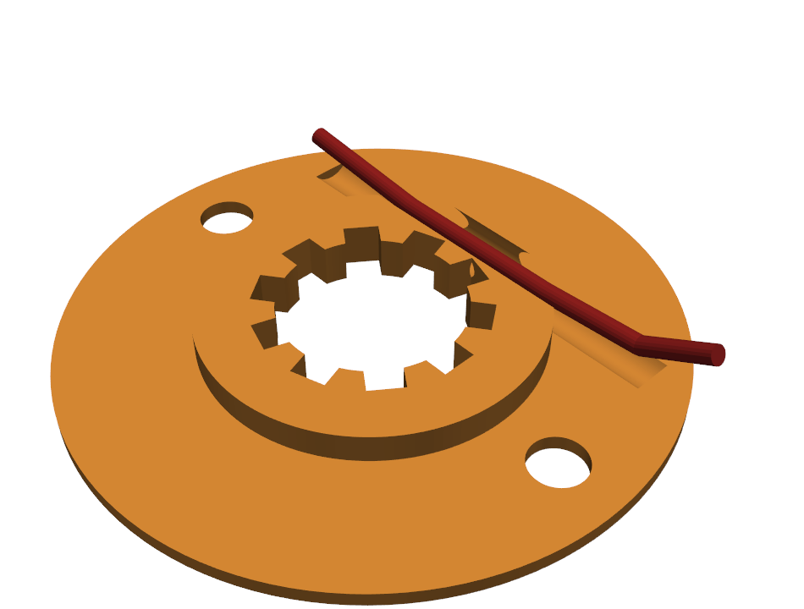
2-0/manual/img/peg1.png
