Korvova/gitar/2-0/manual/img/ratchet.png

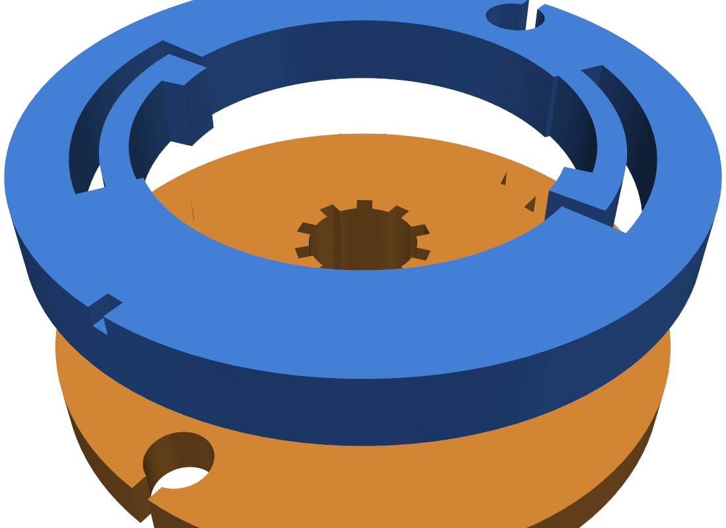
2-0/manual/img/ratchet.png
