Korvova/gitar/plata-4-motora/plata_4_motora.kicad_pcb

## KiCad design plata-4-motora/plata_4_motora.kicad_pcb (2026-09-20)

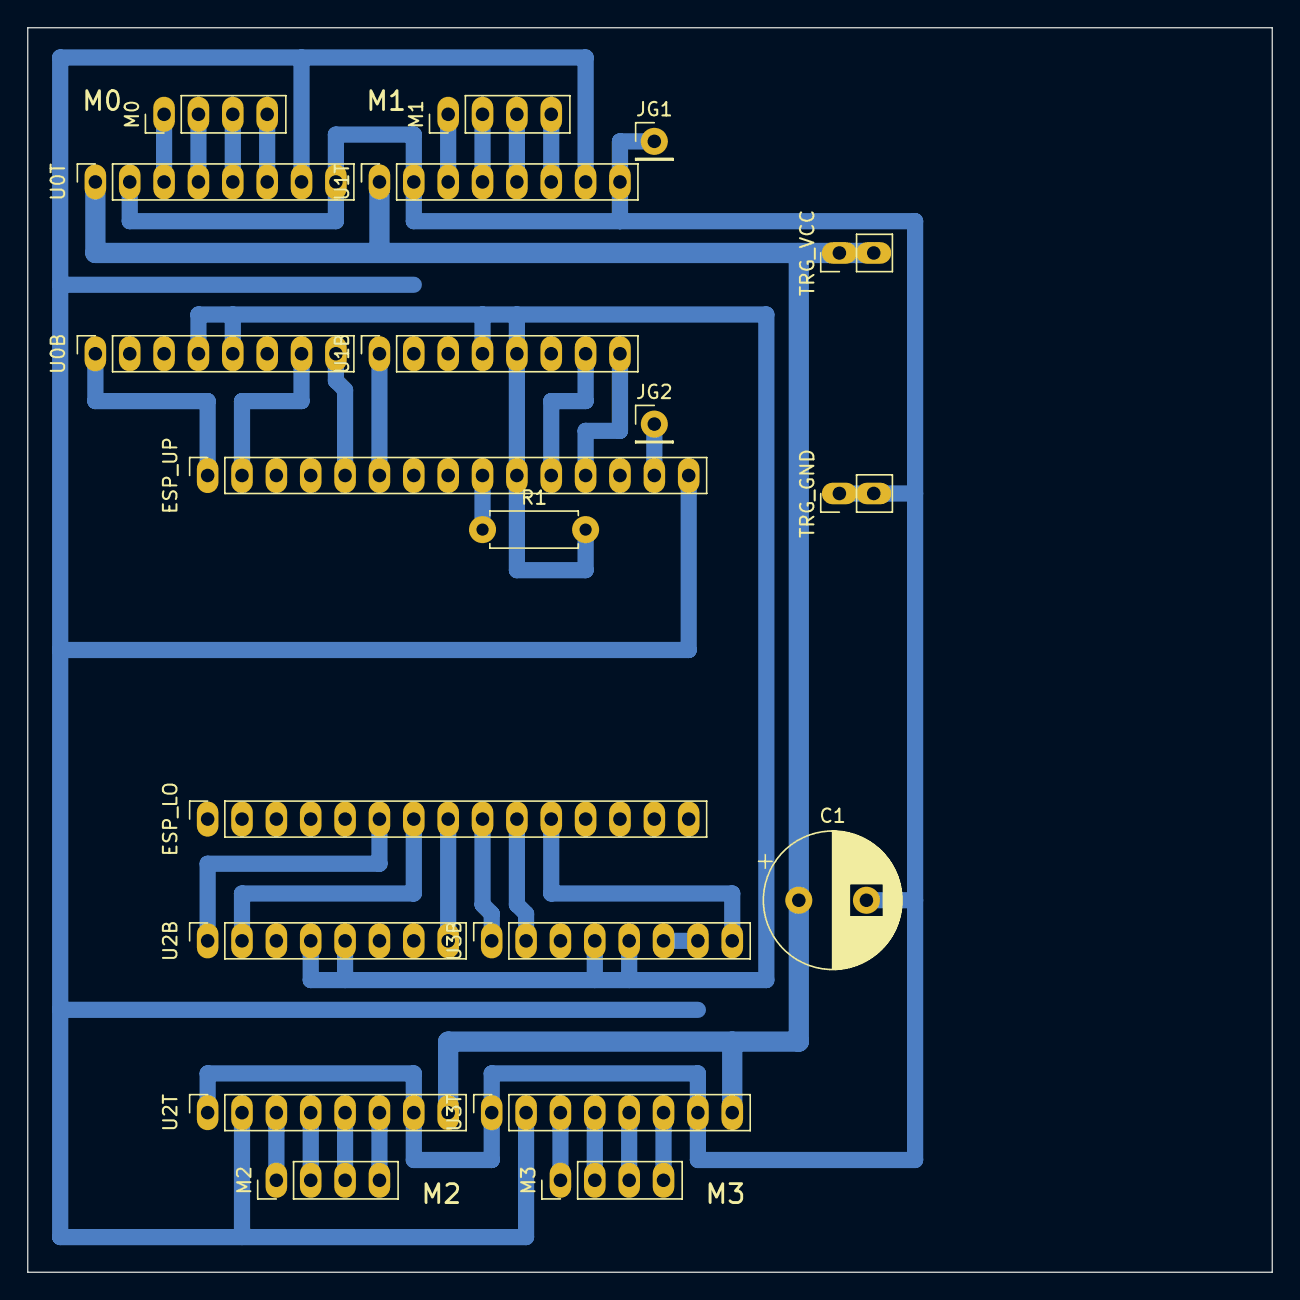
[picture p449: board plata_4_motora.kicad_pcb from above]

Board: 2 copper layers, 92.0 x 92.0 mm, 26 parts (0 on the bottom side), 33 nets.

Parts:
C1: 470u 35V; CP_Radial_D10.0mm_P5.00mm
DRV0, DRV1, DRV2, DRV3: (no value)
ESP: (no value)
ESP_LO: ESP32 EN..VIN; PinSocket_1x15_P2.54mm_Vertical
ESP_UP: ESP32 D23..3V3; PinSocket_1x15_P2.54mm_Vertical
JG1, JG2: PinHeader_1x01_P2.54mm_Vertical
M0: мотор 0; PinHeader_1x04_P2.54mm_Vertical
M1: мотор 1; PinHeader_1x04_P2.54mm_Vertical
M2: мотор 2; PinHeader_1x04_P2.54mm_Vertical
M3: мотор 3; PinHeader_1x04_P2.54mm_Vertical
R1: 1k; R_Axial_DIN0207_L6.3mm_D2.5mm_P7.62mm_Horizontal
TRG: (no value)
TRG_GND: триггер GND; PinHeader_1x02_P2.54mm_Vertical
TRG_VCC: триггер VCC; PinHeader_1x02_P2.54mm_Vertical
U0B, U0T, U1B, U1T, U2B, U2T, U3B, U3T: S2209; PinSocket_1x08_P2.54mm_Vertical

Connections:
DIR0: ESP_UP.5, U0B.8
DIR1: ESP_UP.12, U1B.8
DIR2: ESP_LO.6, U2B.1
DIR3: ESP_LO.9, U3B.1
EN0: ESP_UP.1, U0B.1
EN1: ESP_UP.6, U1B.1
EN2: ESP_LO.8, U2B.8
EN3: ESP_LO.11, U3B.8
GND: C1.2, ESP_UP.14, JG1.1, JG2.1, TRG_GND.1, TRG_GND.2, U0T.2, U0T.8, U1T.2, U1T.8, U2T.1, U2T.7, U3T.1, U3T.7
M0_A1: M0.2, U0T.4
M0_A2: M0.1, U0T.3
M0_B1: M0.3, U0T.5
M0_B2: M0.4, U0T.6
M1_A1: M1.2, U1T.4
M1_A2: M1.1, U1T.3
M1_B1: M1.3, U1T.5
M1_B2: M1.4, U1T.6
M2_A1: M2.3, U2T.5
M2_A2: M2.4, U2T.6
M2_B1: M2.2, U2T.4
M2_B2: M2.1, U2T.3
M3_A1: M3.3, U3T.5
M3_A2: M3.4, U3T.6
M3_B1: M3.2, U3T.4
M3_B2: M3.1, U3T.3
STEP0: ESP_UP.2, U0B.7
STEP1: ESP_UP.11, U1B.7
STEP2: ESP_LO.7, U2B.2
STEP3: ESP_LO.10, U3B.2
TX2R: ESP_UP.9, R1.1
UART: ESP_UP.10, R1.2, U0B.4, U0B.5, U1B.4, U1B.5, U2B.4, U2B.5, U3B.4, U3B.5
VIO: ESP_UP.15, U0T.7, U1B.2, U1T.7, U2B.6, U2T.2, U3B.6, U3B.7, U3T.2
VM: C1.1, TRG_VCC.1, TRG_VCC.2, U0T.1, U1T.1, U2T.8, U3T.8
