Korvova/gitar/blink/blink.ino

// Мигалка для ESP32 DevKit (WROOM-32, 38 pin)
// Встроенный синий светодиод на GPIO2

#define LED_PIN 2

void setup() {
  Serial.begin(115200);
  pinMode(LED_PIN, OUTPUT);
  Serial.println("Blink start!");
}

void loop() {
  digitalWrite(LED_PIN, HIGH);
  Serial.println("LED ON");
  delay(500);
  digitalWrite(LED_PIN, LOW);
  Serial.println("LED OFF");
  delay(500);
}
