Korvova/gitar/(commit log)

2026-07-25 Тренажёр v11: гриф с продлёнными канавками, тележки/плавники v10+зигзаг, ratchet-шайба, столы печати, мануал
    [01_grif_L1-L5.3mf, 02_deka_rail_stop.3mf, 03_telezhki_roliki.3mf, 05_plavniki_100pct.3mf, 06_vtulki_vremennye.3mf, 07_cart_body_fix.3mf, 08_barabany_fix.3mf, 09_drum_test.3mf]
2026-07-25 Поворотный ключ (идея юзера): тест-купон keylock v1, стол 13
    [01_grif_L1-L5.3mf, 02_deka_rail_stop.3mf, 03_telezhki_roliki.3mf, 05_plavniki_100pct.3mf, 06_vtulki_vremennye.3mf, 07_cart_body_fix.3mf, 08_barabany_fix.3mf, 09_drum_test.3mf]
2026-07-25 Keylock v2: плоский ключ 2мм + одна прорезь, поворот 180
    [01_grif_L1-L5.3mf, 02_deka_rail_stop.3mf, 03_telezhki_roliki.3mf, 05_plavniki_100pct.3mf, 06_vtulki_vremennye.3mf, 07_cart_body_fix.3mf, 08_barabany_fix.3mf, 09_drum_test.3mf]
2026-07-25 Стол 04: только направляющие ролики (цельные барабаны упразднены)
    [01_grif_L1-L5.3mf, 02_deka_rail_stop.3mf, 03_telezhki_roliki.3mf, 04_guides.3mf, 05_plavniki_100pct.3mf, 06_vtulki_vremennye.3mf, 07_cart_body_fix.3mf, 08_barabany_fix.3mf]
2026-07-25 Тоггл-гнездо в тест-плашке + колышек (древняя верёвочная классика)
    [01_grif_L1-L5.3mf, 02_deka_rail_stop.3mf, 03_telezhki_roliki.3mf, 04_guides.3mf, 05_plavniki_100pct.3mf, 06_vtulki_vremennye.3mf, 07_cart_body_fix.3mf, 08_barabany_fix.3mf]
2026-07-25 Плашка: канал нити сквозной по всей длине
    [01_grif_L1-L5.3mf, 02_deka_rail_stop.3mf, 03_telezhki_roliki.3mf, 04_guides.3mf, 05_plavniki_100pct.3mf, 06_vtulki_vremennye.3mf, 07_cart_body_fix.3mf, 08_barabany_fix.3mf]
2026-07-25 ФИНАЛ фиксации: диск Ø27 с 2 гнёздами поворотных ключей (360°), стол 14; убраны трещотка и твист-лок
    [01_grif_L1-L5.3mf, 02_deka_rail_stop.3mf, 03_telezhki_roliki.3mf, 04_guides.3mf, 05_plavniki_100pct.3mf, 06_vtulki_vremennye.3mf, 07_cart_body_fix.3mf, 08_barabany_fix.3mf]
2026-07-25 ПРОТЕСТИРОВАНО на валу: ключ-фиксация на диске Ø27 работает, кабестан-обхват даёт запас — хватает даже 90°; статус в CONTEXT.md
2026-07-25 Диск: перегородка Ø28.4 против нахлёста нитей A/B, два ручья + вырезы для хвостов
    [01_grif_L1-L5.3mf, 02_deka_rail_stop.3mf, 03_telezhki_roliki.3mf, 04_guides.3mf, 05_plavniki_100pct.3mf, 06_vtulki_vremennye.3mf, 07_cart_body_fix.3mf, 08_barabany_fix.3mf]
2026-07-25 Диск: винтовая канавка вместо перегородки (лебёдочная классика, без выступов)
    [01_grif_L1-L5.3mf, 02_deka_rail_stop.3mf, 03_telezhki_roliki.3mf, 04_guides.3mf, 05_plavniki_100pct.3mf, 06_vtulki_vremennye.3mf, 07_cart_body_fix.3mf, 08_barabany_fix.3mf]
2026-07-25 Диск: 2 кольцевые канавки-ручья (ход<оборота — спираль не нужна), нити разделены
    [01_grif_L1-L5.3mf, 02_deka_rail_stop.3mf, 03_telezhki_roliki.3mf, 04_guides.3mf, 05_plavniki_100pct.3mf, 06_vtulki_vremennye.3mf, 07_cart_body_fix.3mf, 08_barabany_fix.3mf]
2026-07-25 Диск Ø54 (гладкий, без канавок) + стол 15; пульт: селектор привода мм/об
    [01_grif_L1-L5.3mf, 02_deka_rail_stop.3mf, 03_telezhki_roliki.3mf, 04_guides.3mf, 05_plavniki_100pct.3mf, 06_vtulki_vremennye.3mf, 07_cart_body_fix.3mf, 08_barabany_fix.3mf]
2026-07-25 CONTEXT: уточнены намотки дисков (Ø27=86.4, Ø54=171.2)
2026-07-25 Ярус-диски по скетчу юзера: фланец Ø40 + цилиндр Ø27, стопка 2 шт, длинный ключ связывает; стол 16
    [01_grif_L1-L5.3mf, 02_deka_rail_stop.3mf, 03_telezhki_roliki.3mf, 04_guides.3mf, 05_plavniki_100pct.3mf, 06_vtulki_vremennye.3mf, 07_cart_body_fix.3mf, 08_barabany_fix.3mf]
2026-07-25 Гриф v12: канавки углублены на 0.8 под вкладыши-liner (идея юзера) — пятка едет по планке, нить в П-туннеле; стол 17
    [01_grif_L1-L5.3mf, 02_deka_rail_stop.3mf, 03_telezhki_roliki.3mf, 04_guides.3mf, 05_plavniki_100pct.3mf, 06_vtulki_vremennye.3mf, 07_cart_body_fix.3mf, 08_barabany_fix.3mf]
2026-07-25 Ярус-диск v2 (переосмысление юзера): нити снизу вертикальными проходами, оба ключа короткие сверху, третья сквозная прорезь+длинный ключ связывает диски
    [01_grif_L1-L5.3mf, 02_deka_rail_stop.3mf, 03_telezhki_roliki.3mf, 04_guides.3mf, 05_plavniki_100pct.3mf, 06_vtulki_vremennye.3mf, 07_cart_body_fix.3mf, 08_barabany_fix.3mf]
2026-07-25 Ярус-диск: убраны лишние вертикальные проходы (нить идёт через сквозную прорезь ключа)
    [01_grif_L1-L5.3mf, 02_deka_rail_stop.3mf, 03_telezhki_roliki.3mf, 04_guides.3mf, 05_plavniki_100pct.3mf, 06_vtulki_vremennye.3mf, 07_cart_body_fix.3mf, 08_barabany_fix.3mf]
2026-07-25 ФИКС юзерского бага: туннель вкладыша был впритык к нити (зазор 0) — вкладыш 1.2 толщиной, потолок туннеля 1.25 (зазор 0.25), пятка плавника поднята на 0.4
    [fin_f1_v9.stl, fin_f2_v9.stl, fin_f3_v9.stl, fin_f4_v9.stl, liner_f1_v1.stl, liner_f2_v1.stl, liner_f3_v1.stl, liner_f4_v1.stl]
2026-07-25 Кабели в сцене: обход угловых роликов правильной стороной (с торца грифа), все 8 по единой геометрии
    [01_grif_L1-L5.3mf, 02_deka_rail_stop.3mf, 03_telezhki_roliki.3mf, 04_guides.3mf, 05_plavniki_100pct.3mf, 06_vtulki_vremennye.3mf, 07_cart_body_fix.3mf, 08_barabany_fix.3mf]
2026-07-25 Кабели в Blender: обход ролика со стороны КРАЯ грифа (север-запад для A), прямой ход по дорожке пятки x=S∓4 без диагонали
    [Прототип.blend]
2026-07-25 Вкладыши: A и B — зеркальные детали (поворот 180 уводил вырез кармана на 5 мм мимо ролика B); liner_b1..b4, стол 17 = 4A+4B; сцена обновлена
    [01_grif_L1-L5.3mf, 02_deka_rail_stop.3mf, 03_telezhki_roliki.3mf, 04_guides.3mf, 05_plavniki_100pct.3mf, 06_vtulki_vremennye.3mf, 07_cart_body_fix.3mf, 08_barabany_fix.3mf]
2026-07-25 Вкладыш B: П-паз перенесён на сторону канала A (+chy) — именно там канал A пересекает канавку B; зазор нити 0.25 проверен
    [01_grif_L1-L5.3mf, 02_deka_rail_stop.3mf, 03_telezhki_roliki.3mf, 04_guides.3mf, 05_plavniki_100pct.3mf, 06_vtulki_vremennye.3mf, 07_cart_body_fix.3mf, 08_barabany_fix.3mf]
2026-07-25 Плавник B — отдельная деталь: зигзаг-палец на другой стороне лыжи (поворотная копия A упиралась в фланец ролика B); fin_b1..4, стол 05 = 4A+4B
    [01_grif_L1-L5.3mf, 02_deka_rail_stop.3mf, 03_telezhki_roliki.3mf, 04_guides.3mf, 05_plavniki_100pct.3mf, 06_vtulki_vremennye.3mf, 07_cart_body_fix.3mf, 08_barabany_fix.3mf]
2026-07-25 Сцена: восстановлены Fin1A-4A и Liner1A-4A (удалились при подмене общих мешей B-копий)
    [Прототип.blend]
2026-07-25 Сцена: Fin1A-4A привязаны к своим тележкам (parent), как B
    [Прототип.blend]
2026-07-25 Ярус-диск v3 (2 шурупа вместо третьей прорези, решение юзера), стол 18_etazh1_test для проверки этажа 1 руками, папка этапа 3-0, CONTEXT
    [01_grif_L1-L5.3mf, 02_deka_rail_stop.3mf, 03_telezhki_roliki.3mf, 04_guides.3mf, 05_plavniki_100pct.3mf, 06_vtulki_vremennye.3mf, 07_cart_body_fix.3mf, 08_barabany_fix.3mf]
2026-07-25 Ярус-диск v3: дырки стяжки шляп Ø1.9 под M2 (просьба юзера)
    [01_grif_L1-L5.3mf, 02_deka_rail_stop.3mf, 03_telezhki_roliki.3mf, 04_guides.3mf, 05_plavniki_100pct.3mf, 06_vtulki_vremennye.3mf, 07_cart_body_fix.3mf, 08_barabany_fix.3mf]
2026-07-25 4-канальная проверка ярус-дисков: крыша Ø40->Ø36 (нить 4 чиркала кромку верхней шляпы мотора 2), конфликтов 0; стопки на всех 4 моторах в сцене, барабаны скрыты
    [01_grif_L1-L5.3mf, 02_deka_rail_stop.3mf, 03_telezhki_roliki.3mf, 04_guides.3mf, 05_plavniki_100pct.3mf, 06_vtulki_vremennye.3mf, 07_cart_body_fix.3mf, 08_barabany_fix.3mf]
2026-07-25 Стол 19_tier_disks_x4: полный унифицированный комплект — 8 дисков v3 (Ø36) + 9 ключей на все 4 мотора
    [01_grif_L1-L5.3mf, 02_deka_rail_stop.3mf, 03_telezhki_roliki.3mf, 04_guides.3mf, 05_plavniki_100pct.3mf, 06_vtulki_vremennye.3mf, 07_cart_body_fix.3mf, 08_barabany_fix.3mf]
2026-07-25 Тест-нога 20 см на шестерню (насадка со свободной звёздочкой + 2 дырки M3 под линейку до 40 см) — проверка прямого рычага; стол 20_test_noga
    [01_grif_L1-L5.3mf, 02_deka_rail_stop.3mf, 03_telezhki_roliki.3mf, 04_guides.3mf, 05_plavniki_100pct.3mf, 06_vtulki_vremennye.3mf, 07_cart_body_fix.3mf, 08_barabany_fix.3mf]
2026-07-25 Линейка-удлинитель к тест-ноге (225 мм, дырки шаг 10 внахлёст) — плечо до ~40 см; стол 20 = нога + линейка
    [01_grif_L1-L5.3mf, 02_deka_rail_stop.3mf, 03_telezhki_roliki.3mf, 04_guides.3mf, 05_plavniki_100pct.3mf, 06_vtulki_vremennye.3mf, 07_cart_body_fix.3mf, 08_barabany_fix.3mf]
2026-07-25 Концепт спица+качалка отдельным файлом (Спица_концепт.blend + генератор spica_concept.py)
    [Спица_концепт.blend]
2026-07-25 Концепт: анимация 120 кадров + вторая станция с СЕРЬГОЙ вместо кулисы (ход +-20 у обеих)
    [Спица_концепт.blend]
2026-07-25 Фиксация вкладышей (идея юзера, адаптирована): M2 в мёртвом хвосте у ролика сквозь пол канавки, пилоты в слоях; столы 01/17/18 пересобраны
    [01_grif_L1-L5.3mf, 02_deka_rail_stop.3mf, 03_telezhki_roliki.3mf, 04_guides.3mf, 05_plavniki_100pct.3mf, 06_vtulki_vremennye.3mf, 07_cart_body_fix.3mf, 08_barabany_fix.3mf]
2026-07-25 Концепт рейка-шестерня-рейка отдельным файлом (Спица_рейка.blend): кривошип-скотч, спица-рейка, двухъярусный пиньон 1:2.22, ход тележки 40
    [Спица_рейка.blend]
2026-07-25 Винты вкладышей только на этаже 1 (замечание юзера: выше карман уезжает к стенке, хвоста нет); этажи 2-4 прижимаются слоем
    [01_grif_L1-L5.3mf, 02_deka_rail_stop.3mf, 03_telezhki_roliki.3mf, 04_guides.3mf, 05_plavniki_100pct.3mf, 06_vtulki_vremennye.3mf, 07_cart_body_fix.3mf, 08_barabany_fix.3mf]
2026-07-25 Вкладыши v14: башмак на мёртвом конце до потолка следующего слоя (зазор 0.1 вместо болтанки 1.9), печать как есть; замечание юзера
    [01_grif_L1-L5.3mf, 02_deka_rail_stop.3mf, 03_telezhki_roliki.3mf, 04_guides.3mf, 05_plavniki_100pct.3mf, 06_vtulki_vremennye.3mf, 07_cart_body_fix.3mf, 08_barabany_fix.3mf]
2026-07-25 ОДНОЭТАЖНИК-концепт: все 4 тележки на одном этаже (гриф 3 детали, диски одинаковые без ярусов и подставок, guides сдвинуты y=13.25/13.25/14.0/17.75, зазоры посчитаны)
    [Одноэтажник.blend]
2026-07-25 Демо схемы юзера: центральная палка на тележке, трос тянет её нижний конец; одна дорожка, ролики в неё, ход +-18, ничего за борта
    [Палка_демо.blend]
2026-07-25 Демо v2 по схеме юзера: палка-стрелка на неподвижной оси (плечи 26/19), верх прорезью на пальце тележки, низ качают тросики; ход 40, низ палки ±13
    [Палка_демо.blend]
2026-07-25 Демо ПАРУС: жёсткая центральная пластина, перекрёстная привязка нитей (A к югу, B к северу), ход 40 без шарниров и прорезей
    [Парус_демо.blend]
2026-07-25 Парус сдвинут западнее дорожки (замечание юзера: упирался в ролик) — проходит мимо шейки с зазором, ход полный
    [Парус_демо.blend]
2026-07-25 Демо v3 (bell crank с фото юзера): стрелка + диск-шкив r17 на оси, нити ложатся на дугу по касательной, угловые ролики не нужны
    [Палка_демо.blend]
2026-07-25 Демо v4: bell crank как на фото юзера — сектор с полукруглым основанием на оси, ленты-нити по касательной к дуге с якорями, плечо к тележке; ход 40
    [Палка_демо.blend]
2026-07-25 Демо v5 строго по фото: палка-спица у края от кривошипа, приколота к углу-1 треугольника с дуговым основанием, ось в центральном углу, угол-3 толкает тележку перпендикулярно
    [Палка_демо.blend]
2026-07-25 Демо v6: bell crank на чистых шарнирах (без кулисы) — честная геометрия: тяга-серьга 2.5 мм, плечо 110 мм; вывод — шарнирный вариант прожорлив по длине
    [Палка_демо.blend]
2026-07-25 Демо v7: компактный bell crank по фото без привязки к размерам — спица к углу-1, ось в центре, угол-3 через серьгу толкает тележку вбок
    [Палка_демо.blend]
2026-07-25 Демо v8 по разметке юзера: спица снизу к углу-1, ось, длинное плечо вдоль грифа, на конце шарнир+серьга вбок к тележке
    [Палка_демо.blend]
2026-07-25 Демо v9 (хитрость юзера): ДВА толкателя стопкой от одного вала, наконечники в окне тележки давят в противоположные стенки, ход в унисон — беззазорный привод
    [Палка_демо.blend]
2026-07-25 Демо v10: треугольники увеличены (плечо 45, ход ±19) и вынесены ЗА тележку по скрину юзера, спицы мимо тележки
    [Палка_демо.blend]
2026-07-25 Возврат к одобренному v8 (одно плечо + серьга) по просьбе юзера
    [Палка_демо.blend]
2026-07-25 ОДОБРЕННЫЙ механизм сохранён отдельно: Механизм_основа.blend (спица-треугольник-плечо-серьга, серьга по центру тележки — база для масштабирования)
    [Механизм_основа.blend]
2026-07-25 Палка_масштаб: одобренный механизм в реальном масштабе — гриф 125x50, серьга 3мм по центру тележки, плечо 85, кривошип R4.7 на деке; ход 39.2 мм, всё внутри бортов
    [Палка_демо.blend, Палка_масштаб.blend]
2026-07-26 Палка_4станции: полный макет — 4 одинаковых механизма слоями (веера к деке, пальцы западнее чужих вееров — конфликтов нет), кривошипы на моторах по высоте слоя
    [Палка_4станции.blend, Палка_масштаб.blend]
2026-07-26 Гитара_палка: макет в габаритах классики (гриф 600x52, тележки у головы, спицы ~520мм через гриф к кривошипам в деке; серьга 4, плечо 65)
    [Гитара_палка.blend, Палка_4станции.blend]
2026-07-26 Гитара_палка: шатун 45мм у кривошипа — спица строго в коридоре борта, за край грифа не выходит (замечание юзера)
    [Гитара_палка.blend]
2026-07-26 Зеркальная раскладка (идея юзера): станции 1,3 южный борт, 2,4 северный — по 2 спицы и 2 слоя на борт, пирог 3мм; треугольники отзеркалены
    [Гитара_палка.blend]
2026-07-26 Гитара_палка: зеркальная версия восстановлена (была перезаписана автосейвом при переоткрытии)
    [Гитара_палка.blend]
2026-07-26 Тест-стенд механизма палка: плита 250x70 + треугольник/спица/шатун/серьга/кривошип-звёздочка/тележка; стол 21_palka_test
    [01_grif_L1-L5.3mf, 02_deka_rail_stop.3mf, 03_telezhki_roliki.3mf, 04_guides.3mf, 05_plavniki_100pct.3mf, 06_vtulki_vremennye.3mf, 07_cart_body_fix.3mf, 08_barabany_fix.3mf]
2026-07-26 Инструкция сборки тест-стенда палки: manual/palka.html + 6 рендер-шагов; спица удлинена до цепочки, губки переставлены
    [21_palka_test.3mf, ptest_plate_v1.stl, ptest_spica_v1.stl]
2026-07-26 Стенд палки v2: проём в рельсе для плеча (замечание юзера про стену), колодец мотора NEMA14 + ножки + заглушка-фальшмотор; инструкция manual/palka.html переписана на 9 подробных шагов с рендерами
    [01_grif_L1-L5.3mf, 02_deka_rail_stop.3mf, 03_telezhki_roliki.3mf, 04_guides.3mf, 05_plavniki_100pct.3mf, 06_vtulki_vremennye.3mf, 07_cart_body_fix.3mf, 08_barabany_fix.3mf]
2026-07-26 Демо гибких прутков (идея юзера): два прутка в каналах с дугами R15 толкают/тянут тележку с центра, большой вал Ø60 наматывает; Пруток_демо.blend
    [Пруток_демо.blend]
2026-07-26 Тест-стенд v2 БЕЗ ШТИФТОВ (идея юзера): бугорки Ø4 в дырки Ø4.4 во всех шарнирах, 3 сменных кривошипа r6/6.5/7, заглушка с пеньком; инструкция и рендеры обновлены
    [01_grif_L1-L5.3mf, 02_deka_rail_stop.3mf, 03_telezhki_roliki.3mf, 04_guides.3mf, 05_plavniki_100pct.3mf, 06_vtulki_vremennye.3mf, 07_cart_body_fix.3mf, 08_barabany_fix.3mf]
2026-07-26 Инструкция палки: правки текста (14 деталей, серьга с бугорком)
2026-07-26 Стенд: штырьки Ø5 / ямки Ø6 (зазор 1 мм, просьба юзера не мельчить), рендеры и инструкция обновлены
    [01_grif_L1-L5.3mf, 02_deka_rail_stop.3mf, 03_telezhki_roliki.3mf, 04_guides.3mf, 05_plavniki_100pct.3mf, 06_vtulki_vremennye.3mf, 07_cart_body_fix.3mf, 08_barabany_fix.3mf]
2026-07-26 Стенд_сборка.blend: собранный вид тест-стенда из печатных STL для осмотра перед печатью
    [Стенд_сборка.blend]
2026-07-26 Заглушка: пенёк укорочен до 2.8 (замечание юзера — пересекался с бобышкой шатуна); стол 21 и сборка пересобраны
    [01_grif_L1-L5.3mf, 02_deka_rail_stop.3mf, 03_telezhki_roliki.3mf, 04_guides.3mf, 05_plavniki_100pct.3mf, 06_vtulki_vremennye.3mf, 07_cart_body_fix.3mf, 08_barabany_fix.3mf]
2026-07-26 Стенд по правкам юзера: серьга с 2 дырками, тележка с выпуклостью вниз и пазом для серьги, настилы-подложки (канал+шатун), губки расширены до 6.4 (спица проходила сквозь)
    [01_grif_L1-L5.3mf, 02_deka_rail_stop.3mf, 03_telezhki_roliki.3mf, 04_guides.3mf, 05_plavniki_100pct.3mf, 06_vtulki_vremennye.3mf, 07_cart_body_fix.3mf, 08_barabany_fix.3mf]
2026-07-26 Тележка: паз расширен до 19 (серьга машет до ±45°, упиралась в бортики — замечание юзера); столик шатуна обрезан от дисков
    [01_grif_L1-L5.3mf, 02_deka_rail_stop.3mf, 03_telezhki_roliki.3mf, 04_guides.3mf, 05_plavniki_100pct.3mf, 06_vtulki_vremennye.3mf, 07_cart_body_fix.3mf, 08_barabany_fix.3mf]
2026-07-26 Стенд_физика.blend: rigid body симуляция стенда — 7 hinge-шарниров, ползун тележки, мотор на кривошипе
    [Стенд_физика.blend]
2026-07-26 ФИЗИКА подтвердила механизм: ход тележки 40.5 мм за оборот кривошипа (Bullet, кинематический кривошип + hinge-цепь + виртуальные губки); попутно исправлена спица 103 (фазовый косяк) и центр выпуклост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
    [01_grif_L1-L5.3mf, 02_deka_rail_stop.3mf, 03_telezhki_roliki.3mf, 04_guides.3mf, 05_plavniki_100pct.3mf, 06_vtulki_vremennye.3mf, 07_cart_body_fix.3mf, 08_barabany_fix.3mf]
2026-07-26 Спица-шатун (идея юзера): 4-звенник без шатуна, губок и столика — спица 144 (ц-ц 134.25) дыркой прямо на палец кривошипа, хвост приподнят ступенькой над диском; физика: ход тележки 39.8 мм; стол 21 =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
    [01_grif_L1-L5.3mf, 02_deka_rail_stop.3mf, 03_telezhki_roliki.3mf, 04_guides.3mf, 05_plavniki_100pct.3mf, 06_vtulki_vremennye.3mf, 07_cart_body_fix.3mf, 08_barabany_fix.3mf]
2026-07-26 ЧЕСТНАЯ физика стенда (контакты + люфтовые узлы): полный оборот, ход 38.8. Симуляция нашла 5 конструктивных слабостей — все закрыты: спицу выдавливало с пальца (2 мостика-прижима), треугольник слезал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
    [01_grif_L1-L5.3mf, 02_deka_rail_stop.3mf, 03_telezhki_roliki.3mf, 04_guides.3mf, 05_plavniki_100pct.3mf, 06_vtulki_vremennye.3mf, 07_cart_body_fix.3mf, 08_barabany_fix.3mf]
2026-07-26 КУЛИСА (идея юзера): серьга удалена — высокий штырь плеча ходит прямо в щели палубы тележки (щель 13.5x6: вдоль хода люфт 1, поперёк ±4.25 под дугу). Рельсы подняты до 11 (вели только юбки — тележку 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
    [01_grif_L1-L5.3mf, 02_deka_rail_stop.3mf, 03_telezhki_roliki.3mf, 04_guides.3mf, 05_plavniki_100pct.3mf, 06_vtulki_vremennye.3mf, 07_cart_body_fix.3mf, 08_barabany_fix.3mf]
2026-07-26 Ход добит кривошипом r8.5 (идея юзера про радиус вала): 39.1 мм при честных люфтах. Кривошипы r6..r8.5 (5 шт), щель-кулиса стала вилкой (открыта на запад, сборка сбоку), канал удлинён на север (плита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
    [ptest_cart_v2.stl, ptest_crank_r80_v2.stl, ptest_crank_r85_v2.stl, ptest_plate_v2.stl, ptest_spica_v2.stl, Стенд_физика.blend]
2026-07-26 Режим КАЧАНИЯ мотора (идея юзера): сектор ±75° вокруг нижней точки, Стенд_качание.blend — ход 36.3, yaw 3.1 (самый чистый прогон); позиция тележки однозначна по углу мотора — ключ к позиционированию 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
    [Стенд_качание.blend]
2026-07-26 ЦЕЛЬ: ход >40 в обоих режимах (оборот 43.7 / качание 41.2, yaw 1.4). Юзер нашёл зацеп штыря плеча о высокие мосты (клиренс был 0.3) — штырь укорочен до 12; канал = две люфтовые связки на базе 28 (жёс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
    [ptest_triangle_v2.stl, Стенд_качание.blend, Стенд_физика.blend]
2026-07-26 Ось треугольника +2 на север (юзер заметил асимметрию хода: юг в упоре, север недоход) — нейтраль в центре канала; +кривошип r9 в набор (6 шт). ИТОГ: ход 40.7 (оборот) / 40.1 (качание), yaw 1.4 — тре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
    [ptest_crank_r90_v2.stl, ptest_plate_v2.stl, Стенд_качание.blend, Стенд_физика.blend]
2026-07-26 Кривошип r10 с запасом (идея юзера: большой вал + настройка сектором): качание ±58° даёт 43.2, оборот r8.5 — 42.8, yaw 1.4. Диск кривошипа растёт с радиусом (r9=Ø23, r10=Ø25), ступень спицы и мост-18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
    [ptest_crank_r100_v2.stl, ptest_crank_r90_v2.stl, ptest_plate_v2.stl, ptest_spica_v2.stl, Стенд_качание.blend, Стенд_физика.blend]
2026-07-26 Вилка углублена до 7.5 (юзер поймал упор штыря в торец — недоход 4мм), ноги мостов вне маха плеча (юзер поймал ограничитель в низком мосте), Стенд_ручной.blend — интерактив: крути кривошип рукой (R) 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
    [ptest_bridge_low_v1.stl, ptest_cart_v2.stl, ptest_plate_v2.stl, Стенд_качание.blend, Стенд_ручной.blend, Стенд_физика.blend]
2026-07-26 Аддон «Пульт мотора»: N-панель Стенд — крутилка кривошипа (ползунок + шаги ±15/±90), пуск физики, кнопка сброса; установлен и включён в Blender юзера
2026-07-26 Пульт v1.1: ползунок = ЦЕЛЬ, мотор доворачивается сам с пределом скорости (°/кадр) — рывки руки больше не рвут физику (как настоящий шаговик); показ фактического угла
2026-07-26 Пульт v1.1 фикс: обработчик кадров получает копию сцены (записи пропадали, мотор замирал на 1.5) — состояние в модуле, запись через bpy.data; проверено вживую: 0-30 за 20 кадров
2026-07-26 ПЕЧАТНЫЙ КОМПЛЕКТ ФИНАЛ: стол 21_palka_test = 22 детали (7 кривошипов r6-r10, 2 высоких моста, шайба, мосты), копия в 3-0; инструкция и рендеры пересобраны под финальную геометрию (вилка, качание, хо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
    [01_grif_L1-L5.3mf, 02_deka_rail_stop.3mf, 03_telezhki_roliki.3mf, 04_guides.3mf, 05_plavniki_100pct.3mf, 06_vtulki_vremennye.3mf, 07_cart_body_fix.3mf, 08_barabany_fix.3mf]
2026-07-26 Инструкция palka.html — финальный текст: 22 детали, 7 кривошипов с формулой хода, вилка-кулиса, 2 высоких моста, режим качания ±60
2026-07-26 Веб-симуляции механизма (three.js + cannon.js, референс для гитары и прошивки): guitar_four_physics — ЧЕТЫРЕ канала в слоях с прошивкой шаговиков; guitar_neck_stepper — один канал с обратной кинемати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
2026-07-27 Пульт по USB (Web Serial): прошивка v2 — команды по Serial 115200 (status/move/deg/sw/stop/free/hold/cur/zero...), КАЧАНИЕ sw <полуугол> <rpm> с махами к абсолютным целям, WiFi не блокирует старт (та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
2026-07-27 Прошивка: команда mode 1/0 — SpreadCycle (макс момент) / StealthChop (тихо)
2026-07-29 СТАРТ ПОЛНОЙ ГИТАРЫ: тест узлов сборности — стык спицы-ленты 2x8 внахлёст со встречными ступеньками (рисунок юзера, 2 отв Ø3.2 под М3/М2), стык секций грифа двойной ласточкин + штырь-замок Ø5.7 в шов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
    [01_grif_L1-L5.3mf, 02_deka_rail_stop.3mf, 03_telezhki_roliki.3mf, 04_guides.3mf, 05_plavniki_100pct.3mf, 06_vtulki_vremennye.3mf, 07_cart_body_fix.3mf, 08_barabany_fix.3mf]
2026-07-29 Стык грифа v2 (юзер поймал: ласточкин со штырём ничего не запирал): единый принцип со спицей — встречные ступеньки внахлёст 20мм по высоте, сквозь нахлёст 2 штыря Ø5.7 (позиция/сдвиги) + 2 отв под М3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
    [01_grif_L1-L5.3mf, 02_deka_rail_stop.3mf, 03_telezhki_roliki.3mf, 04_guides.3mf, 05_plavniki_100pct.3mf, 06_vtulki_vremennye.3mf, 07_cart_body_fix.3mf, 08_barabany_fix.3mf]
2026-07-29 Стык грифа v2.1: только 4 болта М3 сквозь нахлёст — штыри убраны (юзер: болты сами позиционируют и жмут, меньше деталей); стол 30 = 4 детали
    [01_grif_L1-L5.3mf, 02_deka_rail_stop.3mf, 03_telezhki_roliki.3mf, 04_guides.3mf, 05_plavniki_100pct.3mf, 06_vtulki_vremennye.3mf, 07_cart_body_fix.3mf, 08_barabany_fix.3mf]
2026-07-29 clearance.py — численное зрение сборок (python-fcl): проверка пересечений/зазоров пар деталей в рабочих позах, падает при нарушении; правило: каждый генератор заканчивается asm.check()
2026-07-29 clearance.py: метрика глубины через объём булева пересечения (manifold) — FCL depth врал на касаниях; детектор на первом прогоне поймал неверную сборку сегментов спицы в сцене (языки в одном слое, 12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
    [Гитара_стыки.blend]
2026-07-29 СЕКЦИЯ-1 ГИТАРЫ v0: этажная стопка 240x52 (дно + 3 межэтажки + палуба, все плашмя без поддержек), 4 канала механизма: плечи B52/A16 (мах ±22.6 = ход 40), спицы-ленты 8x1.6 стеком в жёлобе x16, тележк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
    [gs1_arm0.stl, gs1_arm1.stl, gs1_arm2.stl, gs1_arm3.stl, gs1_cart.stl, gs1_p0_base.stl, gs1_p1_mid.stl, gs1_p2_mid.stl]
2026-07-29 Секция-1 v0.1 (правки юзера): тележки-пальцы ВПЛОТНУЮ (шаг 16, зазор 2) в одном общем канале с внешними бортами; стяжки в приливах-бобышках на стенках (Ø3.2 не влезала в стенку 2 —半дырки наружу). cle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
    [gs1_p0_base.stl, gs1_p1_mid.stl, gs1_p2_mid.stl, gs1_p3_mid.stl, gs1_p4_deck.stl, gs1_spica1.stl, gs1_spica2.stl, gs1_spica3.stl]
2026-07-29 Секция-1: южный стык-полка (нахлёст + 4хМ3) на дне; печатные столы 31 (4 плиты стопки) и 32 (палуба + 4 плеча + 4 тележки + 4 ленты, профиль с бримом под штыри)
    [01_grif_L1-L5.3mf, 02_deka_rail_stop.3mf, 03_telezhki_roliki.3mf, 04_guides.3mf, 05_plavniki_100pct.3mf, 06_vtulki_vremennye.3mf, 07_cart_body_fix.3mf, 08_barabany_fix.3mf]
2026-07-29 СЕКЦИЯ-2: моноблок 240x52 — дно + башня жёлоба с 4 горизонтальными щелями-этажами (мосты 9мм, без поддержек), низ щелей вровень с полами секции-1 (детектор поймал порожек 0.1); стыки-нахлёсты с обеих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
    [01_grif_L1-L5.3mf, 02_deka_rail_stop.3mf, 03_telezhki_roliki.3mf, 04_guides.3mf, 05_plavniki_100pct.3mf, 06_vtulki_vremennye.3mf, 07_cart_body_fix.3mf, 08_barabany_fix.3mf]
2026-07-29 Секция-2 v2 РАЗБОРНАЯ (юзер: слоями и с возможностью разобрать): дно с карманом и стенками + 4 одинаковые П-рейки стопкой (лента в каждой, подошва след. = потолок) + крышка с язычком на 4 винтах М3 —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
    [01_grif_L1-L5.3mf, 02_deka_rail_stop.3mf, 03_telezhki_roliki.3mf, 04_guides.3mf, 05_plavniki_100pct.3mf, 06_vtulki_vremennye.3mf, 07_cart_body_fix.3mf, 08_barabany_fix.3mf]
2026-07-29 ЛАДЫ СВЕРХУ (юзер: имитация настоящего грифа): накладка-фретборд секции-2 на крышке и столбиках (7 винтов), ладовые валики на позициях мензуры 650; лады и на юге палубы секции-1; ШИНА-накладка стыка 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
    [01_grif_L1-L5.3mf, 02_deka_rail_stop.3mf, 03_telezhki_roliki.3mf, 04_guides.3mf, 05_plavniki_100pct.3mf, 06_vtulki_vremennye.3mf, 07_cart_body_fix.3mf, 08_barabany_fix.3mf]
2026-07-29 Секция-2 v3 (три правки юзера): западная стенка сплошная до накладки (бок не зияет, столбики не нужны), отверстия накладки сдвинуты в midpoints межладовых промежутков (лады 12/14/17/22 сидели на винт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
    [01_grif_L1-L5.3mf, 02_deka_rail_stop.3mf, 03_telezhki_roliki.3mf, 04_guides.3mf, 05_plavniki_100pct.3mf, 06_vtulki_vremennye.3mf, 07_cart_body_fix.3mf, 08_barabany_fix.3mf]
2026-07-29 Шина стыка убрана (юзер: полки-бутерброда с 4 винтами достаточно — струнных нагрузок нет, коробки секций жёсткие); лишний ряд отверстий из P0 удалён; столы пересобраны
    [01_grif_L1-L5.3mf, 02_deka_rail_stop.3mf, 03_telezhki_roliki.3mf, 04_guides.3mf, 05_plavniki_100pct.3mf, 06_vtulki_vremennye.3mf, 07_cart_body_fix.3mf, 08_barabany_fix.3mf]
2026-07-29 ТРИ СЕКЦИИ ПО 160 (юзер: 258 не влезало в стол 256): 3x160=480 = полный гриф классики; генератор секций 2/3 параметрический (одинаковые дно/крышка/рейки, свои фретборды), винты автоснапом в середины 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
    [01_grif_L1-L5.3mf, 02_deka_rail_stop.3mf, 03_telezhki_roliki.3mf, 04_guides.3mf, 05_plavniki_100pct.3mf, 06_vtulki_vremennye.3mf, 07_cart_body_fix.3mf, 08_barabany_fix.3mf]
2026-07-29 Крышка секций 2/3 упразднена (юзер): фретборд сам прижимает стопку и несёт язычок-потолок верхней ленты — минус деталь на секцию, гриф тоньше на 1.6; печать фретборда FLIP (лады вниз? нет — ладами вв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
    [01_grif_L1-L5.3mf, 02_deka_rail_stop.3mf, 03_telezhki_roliki.3mf, 04_guides.3mf, 05_plavniki_100pct.3mf, 06_vtulki_vremennye.3mf, 07_cart_body_fix.3mf, 08_barabany_fix.3mf]
2026-07-29 Язычок фретборда с 45-скосами (печать ладами вверх без поддержек), столы 33/34 без FLIP
    [01_grif_L1-L5.3mf, 02_deka_rail_stop.3mf, 03_telezhki_roliki.3mf, 04_guides.3mf, 05_plavniki_100pct.3mf, 06_vtulki_vremennye.3mf, 07_cart_body_fix.3mf, 08_barabany_fix.3mf]
2026-07-29 Язычок фретборда: направление экструзии исправлено (уезжал на север под палубу сек-1 — юзер увидел в прорезях) + страж позиции язычка; пазл-грибы на хвостах лент сек-1 (стыки сегментов без болтов)
    [01_grif_L1-L5.3mf, 02_deka_rail_stop.3mf, 03_telezhki_roliki.3mf, 04_guides.3mf, 05_plavniki_100pct.3mf, 06_vtulki_vremennye.3mf, 07_cart_body_fix.3mf, 08_barabany_fix.3mf]
2026-07-29 ДЕКА v1: 2 секции (Д1: моторы 505/555/605, Д2: 668 — не на стыке), кривошипы D-вал NEMA17 без ступиц + втулки-подставки высоты этажа, пин вниз r4.3 в ВИЛКУ хвоста ленты (кулиса #2 — лента строго в жё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
    [01_grif_L1-L5.3mf, 02_deka_rail_stop.3mf, 03_telezhki_roliki.3mf, 04_guides.3mf, 05_plavniki_100pct.3mf, 06_vtulki_vremennye.3mf, 07_cart_body_fix.3mf, 08_barabany_fix.3mf]
2026-07-29 Гитара_дека.blend — отдельная сцена деки (юзер: чтобы не путаться): Д1 терракотовая / Д2 синяя (юзер мерил 320 — это ДВЕ секции по 160, каждая влезает в стол), кривошипы, втулки, ленты, гребёнки + хв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
    [Гитара_дека.blend, Гитара_секция1.blend]
2026-07-29 Гребёнки v3 (юзер поймал: щели мимо лент, штырь в стену, тело сквозь стенку — проверок гребёнок не было): абсолютные координаты детали, штыри (-4,18) в ямки дна, тело до стенки; проверки лента-гребён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
    [01_grif_L1-L5.3mf, 02_deka_rail_stop.3mf, 03_telezhki_roliki.3mf, 04_guides.3mf, 05_plavniki_100pct.3mf, 06_vtulki_vremennye.3mf, 07_cart_body_fix.3mf, 08_barabany_fix.3mf]
2026-07-29 Стыки лент: взаимная защёлка (идея юзера) вместо пазла, стыки на переходах секций
    - нижний язык 0.8: штырёк вверх Ø3 (высокий, потолок щели запирает) + дырка
    - верхний язык 0.8: дырка + штырёк вниз заподлицо — палки запирают друг друга
    - стыки на y 160/320/480 (переходы) — при ходе +-3.8 ничего не цепляют
    - ext теперь ОДИН тип 178 мм (8 шт), голова сек-1 до 178, хвосты от 480
    - вилка хвоста отцентрована на пин кр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
    [01_grif_L1-L5.3mf, 02_deka_rail_stop.3mf, 03_telezhki_roliki.3mf, 04_guides.3mf, 05_plavniki_100pct.3mf, 06_vtulki_vremennye.3mf, 07_cart_body_fix.3mf, 08_barabany_fix.3mf]
2026-07-29 Корпус гитары в настоящих размерах: восьмёрка 480x370, глубина 95
    - gitara_korpus.py: контур Катмулл-Ром, дно 4 куска + бортик 10x10 + 9 тумб
    под хребет, крышка 4 куска с розеткой O87 (y=570) + бортик вниз,
    обечайка = 7 плоских лент PETG 95x209 на винтах М3 к бортикам
    - корпус свисает вниз от плоскости грифа: крышка z 23..26, дно z -69..-66,
    моторы NEMA17 прячутся внутри; проём грифа в обечайке + приступок пятки
    - gitara_deka.py: дырк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
    [01_grif_L1-L5.3mf, 02_deka_rail_stop.3mf, 03_telezhki_roliki.3mf, 04_guides.3mf, 05_plavniki_100pct.3mf, 06_vtulki_vremennye.3mf, 07_cart_body_fix.3mf, 08_barabany_fix.3mf]
2026-07-29 Розетка у талии (y=665, как у настоящей) + обечайка-визуализация с дырками
    - юзер: дырка была слишком близко к грифу (90 мм от края) -> 197 мм, у талии,
    под розеткой кривошип 4-го мотора
    - винты крышки переставлены мимо розетки (615/715), каналы в стенках хребта
    - гнутая обечайка в сцене: радиальные дырки + щели-границы 7 сегментов
    - столы 35/36/41-43 перегенерены, все 3 сцены пересобраны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
    [01_grif_L1-L5.3mf, 02_deka_rail_stop.3mf, 03_telezhki_roliki.3mf, 04_guides.3mf, 05_plavniki_100pct.3mf, 06_vtulki_vremennye.3mf, 07_cart_body_fix.3mf, 08_barabany_fix.3mf]
2026-07-29 Viewport-цвета материалов во всех сценах (diffuse_color = Base Color)
    [Гитара_дека.blend, Гитара_корпус.blend, Гитара_секция1.blend]
2026-07-29 Стыки корпуса: планки-накладки вместо нависающих полок (печать без поддержек)
    - юзер: полки стыков нависали при печати (крышка флип, вырезы дна)
    - куски дна и крышки теперь с ровными торцами; 7 плоских планок 1.5 мм
    изнутри на М3х4 (каналы Ø2.6 не насквозь — снаружи дырок нет)
    - рёбра и кольцо розетки с проёмами под планки; стол 47_korpus_planki
    - сцена корпуса пересобрана (планки зелёные)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
    [01_grif_L1-L5.3mf, 02_deka_rail_stop.3mf, 03_telezhki_roliki.3mf, 04_guides.3mf, 05_plavniki_100pct.3mf, 06_vtulki_vremennye.3mf, 07_cart_body_fix.3mf, 08_barabany_fix.3mf]
2026-07-29 Планка гриф-крышка: усиление верхнего пояса стыка (идея юзера)
    - планка 52x44x1.5 в утопленной нише крышки + на фретборде сек-3
    - 2 винта сквозь штатные дырки фретборда в стенки секции, 2 винта сквозь
    крышку в стенки хребта (y=486, каналы в деке) — бутерброд гриф-крышка-хребет
    - канавки под лады 456.8/467.6; печать флип, ниша при флипе у стола
    - стол 47 = 8 планок; столы 35/36/41-43 перегенерены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
    [01_grif_L1-L5.3mf, 02_deka_rail_stop.3mf, 03_telezhki_roliki.3mf, 04_guides.3mf, 05_plavniki_100pct.3mf, 06_vtulki_vremennye.3mf, 07_cart_body_fix.3mf, 08_barabany_fix.3mf]
2026-07-29 Стык гриф-крышка по-новому (юзер): язык фретборда в окно крышки
    - фретборд сек-3 продлён языком 55x26 на юг поверх корпуса (как накладка
    настоящей гитары), 2 дырки под М3
    - в крышке сквозное окно + бобышки-утолщения снизу (мимо жёлоба лент);
    винты сквозь язык и бобышку идут в пониженные стенки хребта — пакет
    гриф-крышка-хребет; отдельная планка pl_neck удалена
    - столы 34/35/36/41-43/47 перегенерены,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
    [01_grif_L1-L5.3mf, 02_deka_rail_stop.3mf, 03_telezhki_roliki.3mf, 04_guides.3mf, 05_plavniki_100pct.3mf, 06_vtulki_vremennye.3mf, 07_cart_body_fix.3mf, 08_barabany_fix.3mf]
2026-07-29 Инструкции сборки: manual/grif.html и manual/deka.html + 11 рендеров этапов
    - grif.html: секция-1 по этажам (плечи, спицы, палуба, тележки), рейки и
    фретборды секций 2/3, стыки; напоминание про поддержки для 33/34
    - deka.html: моторы в хребет, втулки/кривошипы, дно корпуса на планках,
    тумбы, протяжка лент по этажам с защёлками, обечайка, крышка с языком,
    электрика (20В, TMC2209 700мА, пины ESP32)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
2026-07-30 Стыки корпуса: встречные полки-бутерброды вместо планок (идея юзера)
    - юзер: зачем планки, если куски можно нахлёстом как остальные стыки
    - полки 1+2 мм: винт М3х4 снизу сквозь полку, канал Ø2.6 не насквозь —
    снаружи дно и крышка чистые; 24 винта вместо 7 планок + 40 винтов
    - печать: поддержки от стола для 39/40 (дно юг) и 41/43 (крышка север)
    - стол 47 удалён, deka.html обновлена, кадры 2/3/5/6 перерендерены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
    [01_grif_L1-L5.3mf, 02_deka_rail_stop.3mf, 03_telezhki_roliki.3mf, 04_guides.3mf, 05_plavniki_100pct.3mf, 06_vtulki_vremennye.3mf, 07_cart_body_fix.3mf, 08_barabany_fix.3mf]
2026-07-30 Струны-рычажки: концепт насадки над розеткой (gitara_struny.py)
    - 6 печатных струн 2x10x100: крест-лопатка в джойстиковый потенциометр
    ALPS 10к (ось+подшипник+датчик), сменная пружина-гармошка к стойке
    - рама на крышке wn вокруг розетки, 4хМ3, щели проводов вниз
    - размеры потенциометра ТИПОВЫЕ — уточнить по замеру (TODO в файле)
    - сцена Гитара_струны.blend (контекст: крышка wn)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
    [gst_garm.stl, gst_pot_dummy.stl, gst_rama.stl, gst_struna.stl, Гитара_корпус.blend, Гитара_струны.blend]
2026-07-30 Струны v2: лопатка под прямоугольный шлиц ротора, нахлёсты с М2, фиксация
    - лопатка ОДНА пластина (по фото юзера: ротор-диск с прямоугольной
    прорезью, не крест); болванка потенциометра обновлена
    - крепления гармошки: нахлёст + болтики М2 (юзер) — лапки на бобышку
    струны и площадку стойки
    - фиксация от вылета: прижим-планка ряда потенцев (окна под роторы, 2хМ2),
    мост-скоба над струнами (з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
    [gst_bridge.stl, gst_garm.stl, gst_klamp.stl, gst_pot_dummy.stl, gst_rama.stl, gst_struna.stl, Гитара_струны.blend]
2026-07-30 Струны v3: замок-болтик сквозь потенциометр вместо моста (идея юзера)
    - лопатка струны НАСКВОЗЬ ротора и корпуса (прорезь сквозная), снизу
    бобышка с поперечным болтиком М2 — струна заперта в самом потенце,
    трения нет; мост-скоба удалён
    - ряд потенцев на подиуме 4 мм со сквозными окнами: болтики вкручиваются
    до посадки рамы на крышку, после — заперты внутри
    - сцена пересобрана
    Co-Authore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
    [gst_pot_dummy.stl, gst_rama.stl, gst_struna.stl, Гитара_струны.blend]
2026-07-30 Струны v4: съёмные столбики + вертикальные лапки — печать без поддержек
    - лапки гармошки вертикальные, винты М2 вбок: струна печатается ЛЁЖА без
    поддержек, все дырки при печати вертикальные; гармошка — призма стоя
    - лопатка длинной стороной вдоль струны (при лежачей печати ничего не
    выступает вниз); замок: свободная дырка Ø2.2 + болтик М2 с гайкой (юзер)
    - столбики гармошек СЪЁМНЫЕ (юз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
    [gst_garm.stl, gst_pot_dummy.stl, gst_rama.stl, gst_stolb.stl, gst_struna.stl, Гитара_струны.blend]
2026-07-30 Струны: винт лапки гармошки С ЮГА сквозь столбик (юзер: доступ отвёртки)
    - канал столбика сквозной Ø2.2, винт М2х10 с юга — за столбиком свободно
    и на столе, и в собранном виде; лапка гармошки утолщена до 3 (нарезка)
    [gst_garm.stl, gst_stolb.stl, Гитара_струны.blend]
2026-07-30 Струны: южный конец гармошки буквой Г (юзер), столбики сдвинуты на 2.2
    [gst_garm.stl, gst_rama.stl, Гитара_струны.blend]
2026-07-30 Струны: прилив убран — сквозная дырочка в теле + винт М2 с гайкой (юзер)
    [gst_struna.stl, Гитара_струны.blend]
2026-07-30 Струны: винты прижим-планки в центр простенка (были у кромки, юзер)
    [gst_klamp.stl, gst_rama.stl, Гитара_струны.blend]
2026-07-30 Струны: дырки крепления рамы вынесены севернее подиума (юзер: близко)
    [gst_rama.stl, Гитара_струны.blend]
2026-07-30 Струны: корпус потенца 13x10x4 (данные юзера), проёмы пинов на юг
    - проём 8 мм в южной стенке стакана на всю высоту + насквозь вниз:
    потенц опускается с ножками, провода уходят в окно рамы к розетке
    - болванке добавлены 3 ножки; ротор/прорезь — TODO замер
    [gst_pot_dummy.stl, gst_rama.stl, gst_struna.stl, Гитара_струны.blend]
2026-07-31 Тест-стенд струны: плита с одним гнездом + стол 48 (юзер: примериться)
    - gst_test_plate 50x154: подиум, карман потенца, окно замка, проём пинов,
    каналы прижим-планки и столбика; gst_test_klamp — мини-прижим
    - гармошка -> make_garm(t): 0.8 и мягкая 0.6 на подбор жёсткости
    - стол 48_struna_test: 8 деталей (струна лёжа, 4 гармошки, столбик)
    [01_grif_L1-L5.3mf, 02_deka_rail_stop.3mf, 03_telezhki_roliki.3mf, 04_guides.3mf, 05_plavniki_100pct.3mf, 06_vtulki_vremennye.3mf, 07_cart_body_fix.3mf, 08_barabany_fix.3mf]
2026-07-31 docs: официальный даташит ALPS RKJXV (стик PS4, наши потенциометры-VR)
2026-07-31 Струны: данные даташита RKJXV в комментарий генератора
2026-07-31 Струны v5 (по примерке юзера): лопатка 2.8x0.85 под прорезь 3x1, крючок за столбик
    - лопатка по замеру; замок теперь шплинт-филамент 1.75 в дырку Ø1.7
    (болтик М2 в узкую лопатку не помещается; вертикаль держит гармошка)
    - конец гармошки обходит столбик и цепляется ЗА него: шуруп снаружи с юга,
    на виду (юзер: удобно подлезть); столбик и плита НЕ меняются
    - стол 48 перегенерён — перепечатать только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
    [01_grif_L1-L5.3mf, 02_deka_rail_stop.3mf, 03_telezhki_roliki.3mf, 04_guides.3mf, 05_plavniki_100pct.3mf, 06_vtulki_vremennye.3mf, 07_cart_body_fix.3mf, 08_barabany_fix.3mf]
2026-07-31 Струны: башмак убран (юзер) — струна плоская, печать лёжа без поддержек
    [01_grif_L1-L5.3mf, 02_deka_rail_stop.3mf, 03_telezhki_roliki.3mf, 04_guides.3mf, 05_plavniki_100pct.3mf, 06_vtulki_vremennye.3mf, 07_cart_body_fix.3mf, 08_barabany_fix.3mf]
2026-07-31 Струны: лопатка у края тела — печать лёжа полностью от стола (юзер)
    [01_grif_L1-L5.3mf, 02_deka_rail_stop.3mf, 03_telezhki_roliki.3mf, 04_guides.3mf, 05_plavniki_100pct.3mf, 06_vtulki_vremennye.3mf, 07_cart_body_fix.3mf, 08_barabany_fix.3mf]
2026-07-31 Тест v2 'как настоящая струна' (юзер): двусторонние гармошки, без потенца
    - струна симметричная между 2 гармошками на 2 столбиках; магнит AS5600
    на дно по центру, плата на плите в рамке, зазор ~2.4
    - стол 49: плита + струна + 1 столбик (гармошки и 1 столбик уже есть)
    [01_grif_L1-L5.3mf, 02_deka_rail_stop.3mf, 03_telezhki_roliki.3mf, 04_guides.3mf, 05_plavniki_100pct.3mf, 06_vtulki_vremennye.3mf, 07_cart_body_fix.3mf, 08_barabany_fix.3mf]
2026-08-01 Струна v2: ямка магнита 4.1x2.1 снизу + П-обойма с защёлкой (юзер), подиум платы AS5600
    [01_grif_L1-L5.3mf, 02_deka_rail_stop.3mf, 03_telezhki_roliki.3mf, 04_guides.3mf, 05_plavniki_100pct.3mf, 06_vtulki_vremennye.3mf, 07_cart_body_fix.3mf, 08_barabany_fix.3mf]
2026-08-01 Струна v2 по эскизу юзера: щель в кромке под магнит + П-коробочка со шплинтом
    - струна остаётся плоской 2 мм (печать без поддержек), щель 4.3x3.2 в
    нижней кромке; магнит боком, ориентация полюсов при сборке
    - П-обойма: дно с окном (магнит ближе к чипу), шплинт-филамент насквозь
    - подиум платы по центру, зазор чип-магнит ~2.7
    [01_grif_L1-L5.3mf, 02_deka_rail_stop.3mf, 03_telezhki_roliki.3mf, 04_guides.3mf, 05_plavniki_100pct.3mf, 06_vtulki_vremennye.3mf, 07_cart_body_fix.3mf, 08_barabany_fix.3mf]
2026-08-01 Тест v2: подиум платы +3 (зазор чип-магнит 5.7 -> 2.7, вскрыл макет)
    [01_grif_L1-L5.3mf, 02_deka_rail_stop.3mf, 03_telezhki_roliki.3mf, 04_guides.3mf, 05_plavniki_100pct.3mf, 06_vtulki_vremennye.3mf, 07_cart_body_fix.3mf, 08_barabany_fix.3mf]
2026-08-01 Тест v2: дно обоймы сплошное (юзер), плата поднята ещё на 1
    [01_grif_L1-L5.3mf, 02_deka_rail_stop.3mf, 03_telezhki_roliki.3mf, 04_guides.3mf, 05_plavniki_100pct.3mf, 06_vtulki_vremennye.3mf, 07_cart_body_fix.3mf, 08_barabany_fix.3mf]
2026-08-01 Тест v2: дырки струны у концов (зигзаг пересекал тело, юзер), столбики шире
    [01_grif_L1-L5.3mf, 02_deka_rail_stop.3mf, 03_telezhki_roliki.3mf, 04_guides.3mf, 05_plavniki_100pct.3mf, 06_vtulki_vremennye.3mf, 07_cart_body_fix.3mf, 08_barabany_fix.3mf]
2026-08-01 Тест v2 финал: магнит ПЛАШМЯ в ямке дна П-обоймы (юзер) — струна чистая пластина
    [01_grif_L1-L5.3mf, 02_deka_rail_stop.3mf, 03_telezhki_roliki.3mf, 04_guides.3mf, 05_plavniki_100pct.3mf, 06_vtulki_vremennye.3mf, 07_cart_body_fix.3mf, 08_barabany_fix.3mf]
2026-08-01 Обойма магнита = Г + отдельная щека-пластина (юзер: доступ для укладки)
    [01_grif_L1-L5.3mf, 02_deka_rail_stop.3mf, 03_telezhki_roliki.3mf, 04_guides.3mf, 05_plavniki_100pct.3mf, 06_vtulki_vremennye.3mf, 07_cart_body_fix.3mf, 08_barabany_fix.3mf]
2026-08-01 Обойма магнита: только Г, щека убрана (юзер) — магнит заперт ямкой и струной
    [01_grif_L1-L5.3mf, 02_deka_rail_stop.3mf, 03_telezhki_roliki.3mf, 04_guides.3mf, 05_plavniki_100pct.3mf, 06_vtulki_vremennye.3mf, 07_cart_body_fix.3mf, 08_barabany_fix.3mf]
2026-08-01 Тест v2: столбики на +-75.5 — плечо гармошки снаружи тела (юзер)
    [01_grif_L1-L5.3mf, 02_deka_rail_stop.3mf, 03_telezhki_roliki.3mf, 04_guides.3mf, 05_plavniki_100pct.3mf, 06_vtulki_vremennye.3mf, 07_cart_body_fix.3mf, 08_barabany_fix.3mf]
2026-08-01 Тест v2: сквозные прорези под пины платы + ножки плиты (юзер)
    [01_grif_L1-L5.3mf, 02_deka_rail_stop.3mf, 03_telezhki_roliki.3mf, 04_guides.3mf, 05_plavniki_100pct.3mf, 06_vtulki_vremennye.3mf, 07_cart_body_fix.3mf, 08_barabany_fix.3mf]
2026-08-01 Тест v2: прорези пинов расширены до центральной перемычки (юзер)
    [01_grif_L1-L5.3mf, 02_deka_rail_stop.3mf, 03_telezhki_roliki.3mf, 04_guides.3mf, 05_plavniki_100pct.3mf, 06_vtulki_vremennye.3mf, 07_cart_body_fix.3mf, 08_barabany_fix.3mf]
2026-08-01 Тест-скетч струны: AS5600 OUT -> GPIO34, Serial Plotter, автоноль
    [Гитара_струна_тест.blend]
2026-08-01 Стол 49: струна x2 (запас)
    [01_grif_L1-L5.3mf, 02_deka_rail_stop.3mf, 03_telezhki_roliki.3mf, 04_guides.3mf, 05_plavniki_100pct.3mf, 06_vtulki_vremennye.3mf, 07_cart_body_fix.3mf, 08_barabany_fix.3mf]
2026-08-01 Стол 49: + пружины-гармошки 2x0.8 и 2x0.6 (юзер), струна одна
    [01_grif_L1-L5.3mf, 02_deka_rail_stop.3mf, 03_telezhki_roliki.3mf, 04_guides.3mf, 05_plavniki_100pct.3mf, 06_vtulki_vremennye.3mf, 07_cart_body_fix.3mf, 08_barabany_fix.3mf]
2026-08-01 Ямка магнита сдвинута от стенки Г и расширена до Ø4.4 (юзер), чип следом
    [01_grif_L1-L5.3mf, 02_deka_rail_stop.3mf, 03_telezhki_roliki.3mf, 04_guides.3mf, 05_plavniki_100pct.3mf, 06_vtulki_vremennye.3mf, 07_cart_body_fix.3mf, 08_barabany_fix.3mf]
2026-08-01 Пульт струны: осциллограф Web Serial + звук щипка (Карплус-Стронг)
    - прошивка-стример: 1000 выборок/с, среднее из 4, Serial 115200
    - websim/struna_pult.html: живой график с порогом, детект щипка,
    синтез струны Web Audio, слайдеры порог/громкость/окно, кнопка Ноль
    [Гитара_струна_тест.blend]
2026-08-01 Пульт струны: крупный статус, счётчик потока, сброс DTR/RTS для ESP32
2026-08-01 Пульт струны: показ сырого ADC для диагностики
2026-08-01 Прошивка струны: чтение угла по I2C (AS5600L не умеет аналоговый OUT)
    - автопоиск адреса 0x36/0x40, RAW ANGLE 1 кГц, SDA=21 SCL=22 DIR=GND
2026-08-01 Пульт струны: детект щипка по фронту с перевзводом (был ретриггер, юзер)
2026-08-01 Пульт струны: быстрый перевзвод (0.85 порога) + антидребезг 70мс — быстрая игра
2026-08-01 Пульт струны: детект щипка по high-pass (скорость), не по уровню — база может плыть сколько угодно (юзер: пропуски звука)
2026-08-01 Пульт струны: разный тон по направлению щипка (вниз=соль, вверх=ре)
2026-08-01 Стол 50: обойма с хвостом х2 + подставка платы — тест выноса на стенде 49
    [01_grif_L1-L5.3mf, 02_deka_rail_stop.3mf, 03_telezhki_roliki.3mf, 04_guides.3mf, 05_plavniki_100pct.3mf, 06_vtulki_vremennye.3mf, 07_cart_body_fix.3mf, 08_barabany_fix.3mf]
2026-08-01 ШЕСТИСТРУНКА ФИНАЛ: рама v3 (gitara_struny.py переписан начисто)
    - рама 104x190 на 6 шайбах 4мм над крышкой (провода под рамой в розетку)
    - 12 столбиков, 6 струн, обоймы 2 обычные + 4 с хвостом (тройки юзера),
    6 подиумов плат лесенкой со сквозными прорезями пинов
    - потенциометровое наследие удалено; тест-плита и ножки сохранены
    - столы: 51 (рама), 52 (50 деталей мелочи); сцена Гитара_струны6.blend
    - все проверки з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
    [01_grif_L1-L5.3mf, 02_deka_rail_stop.3mf, 03_telezhki_roliki.3mf, 04_guides.3mf, 05_plavniki_100pct.3mf, 06_vtulki_vremennye.3mf, 07_cart_body_fix.3mf, 08_barabany_fix.3mf]
2026-08-01 Ямка магнита: зубцы-защёлка (3 навеса 0.3) + посадка туже 4.25 (юзер)
    [01_grif_L1-L5.3mf, 02_deka_rail_stop.3mf, 03_telezhki_roliki.3mf, 04_guides.3mf, 05_plavniki_100pct.3mf, 06_vtulki_vremennye.3mf, 07_cart_body_fix.3mf, 08_barabany_fix.3mf]
2026-08-01 Защёлка магнита: клин-зубцы с расчётом посадки (заход 35град, стоп-полка, зазор 0.15 над магнитом); только на хвостатой обойме (юзер)
    [01_grif_L1-L5.3mf, 02_deka_rail_stop.3mf, 03_telezhki_roliki.3mf, 04_guides.3mf, 05_plavniki_100pct.3mf, 06_vtulki_vremennye.3mf, 07_cart_body_fix.3mf, 08_barabany_fix.3mf]
2026-08-01 Зубцы защёлки — только с дальней от струны стороны (восток запирает струна)
    [01_grif_L1-L5.3mf, 02_deka_rail_stop.3mf, 03_telezhki_roliki.3mf, 04_guides.3mf, 05_plavniki_100pct.3mf, 06_vtulki_vremennye.3mf, 07_cart_body_fix.3mf, 08_barabany_fix.3mf]
2026-08-01 Магнит на хвосте: плоская КРЫШЕЧКА на 2хМ2 вместо зубцов (юзер) + вырезы в струне под проход над крышкой и шляпками
    [01_grif_L1-L5.3mf, 02_deka_rail_stop.3mf, 03_telezhki_roliki.3mf, 04_guides.3mf, 05_plavniki_100pct.3mf, 06_vtulki_vremennye.3mf, 07_cart_body_fix.3mf, 08_barabany_fix.3mf]
2026-08-01 Вырезы струны над крышечкой шире на 3 мм с каждого края (юзер)
    [01_grif_L1-L5.3mf, 02_deka_rail_stop.3mf, 03_telezhki_roliki.3mf, 04_guides.3mf, 05_plavniki_100pct.3mf, 06_vtulki_vremennye.3mf, 07_cart_body_fix.3mf, 08_barabany_fix.3mf]
2026-08-01 Рама: крепление плат козырёк+зубчик-защёлка, без металла (юзер: не скотч)
    [01_grif_L1-L5.3mf, 02_deka_rail_stop.3mf, 03_telezhki_roliki.3mf, 04_guides.3mf, 05_plavniki_100pct.3mf, 06_vtulki_vremennye.3mf, 07_cart_body_fix.3mf, 08_barabany_fix.3mf]
2026-08-01 Рама: карман плат 23.6 (юзер шлифовал), 4 штырька Ø2.7 в дырки 16x16 Ø3, прорези пинов по реальным колодкам платы, козырёк убран
    [01_grif_L1-L5.3mf, 02_deka_rail_stop.3mf, 03_telezhki_roliki.3mf, 04_guides.3mf, 05_plavniki_100pct.3mf, 06_vtulki_vremennye.3mf, 07_cart_body_fix.3mf, 08_barabany_fix.3mf]
2026-08-01 Штырьки плат: 2 диагональных с защёлкой-головкой (конус с прорезью, эскиз юзера)
    [01_grif_L1-L5.3mf, 02_deka_rail_stop.3mf, 03_telezhki_roliki.3mf, 04_guides.3mf, 05_plavniki_100pct.3mf, 06_vtulki_vremennye.3mf, 07_cart_body_fix.3mf, 08_barabany_fix.3mf]
2026-08-01 Стол 53: тест-ячейка платы (карман+штырьки+защёлки+прорези) — примерка
    [01_grif_L1-L5.3mf, 02_deka_rail_stop.3mf, 03_telezhki_roliki.3mf, 04_guides.3mf, 05_plavniki_100pct.3mf, 06_vtulki_vremennye.3mf, 07_cart_body_fix.3mf, 08_barabany_fix.3mf]
2026-08-01 Защёлки плат: щель до пола кармана — столбик из двух полуцилиндров со шляпой
    [01_grif_L1-L5.3mf, 02_deka_rail_stop.3mf, 03_telezhki_roliki.3mf, 04_guides.3mf, 05_plavniki_100pct.3mf, 06_vtulki_vremennye.3mf, 07_cart_body_fix.3mf, 08_barabany_fix.3mf]
2026-08-01 Крепёж плат: защёлки -> 2 штырька Ø3.1 + 2 винта М3; прорези пинов 5.5 ближе к краю
    [01_grif_L1-L5.3mf, 02_deka_rail_stop.3mf, 03_telezhki_roliki.3mf, 04_guides.3mf, 05_plavniki_100pct.3mf, 06_vtulki_vremennye.3mf, 07_cart_body_fix.3mf, 08_barabany_fix.3mf]
2026-08-01 Крышка платы AS5600: 26x26x0.8 на тех же М3, окно над чипом, бобышки-прижим
    [01_grif_L1-L5.3mf, 02_deka_rail_stop.3mf, 03_telezhki_roliki.3mf, 04_guides.3mf, 05_plavniki_100pct.3mf, 06_vtulki_vremennye.3mf, 07_cart_body_fix.3mf, 08_barabany_fix.3mf]
2026-08-01 Крышка платы упрощена: без бобышек, карман глубже 3мм, варианты с окном и глухая
    [01_grif_L1-L5.3mf, 02_deka_rail_stop.3mf, 03_telezhki_roliki.3mf, 04_guides.3mf, 05_plavniki_100pct.3mf, 06_vtulki_vremennye.3mf, 07_cart_body_fix.3mf, 08_barabany_fix.3mf]
2026-08-01 Крышка платы -> вкладыш 23.4 внутрь кармана, прижим винтами; штырьки Ø3.4
    [01_grif_L1-L5.3mf, 02_deka_rail_stop.3mf, 03_telezhki_roliki.3mf, 04_guides.3mf, 05_plavniki_100pct.3mf, 06_vtulki_vremennye.3mf, 07_cart_body_fix.3mf, 08_barabany_fix.3mf]
2026-08-01 Карман платы ужат до 23.1 (болталась), крышка-вкладыш 22.9
    [01_grif_L1-L5.3mf, 02_deka_rail_stop.3mf, 03_telezhki_roliki.3mf, 04_guides.3mf, 05_plavniki_100pct.3mf, 06_vtulki_vremennye.3mf, 07_cart_body_fix.3mf, 08_barabany_fix.3mf]
2026-08-01 Полное утапливание: карман гл.4 (плата+чип+крышка заподлицо), струна опущена на 1мм — зазор чип-магнит прежний ~2.8; штырьки Ø3.6
    [01_grif_L1-L5.3mf, 02_deka_rail_stop.3mf, 03_telezhki_roliki.3mf, 04_guides.3mf, 05_plavniki_100pct.3mf, 06_vtulki_vremennye.3mf, 07_cart_body_fix.3mf, 08_barabany_fix.3mf]
2026-08-01 Посадка платы подтверждена печатью (ячейка 53): размеры зафиксированы
    [Гитара_струны6.blend]
2026-08-01 Одна большая крышка плат 94x80 на 4 винтах в угловые бобышки вместо 6 вкладышей
    [01_grif_L1-L5.3mf, 02_deka_rail_stop.3mf, 03_telezhki_roliki.3mf, 04_guides.3mf, 05_plavniki_100pct.3mf, 06_vtulki_vremennye.3mf, 07_cart_body_fix.3mf, 08_barabany_fix.3mf]
2026-08-01 Бортики карманов осажены до 7.5 (глубина 3): плата+чип заподлицо, сверху общая крышка
    [01_grif_L1-L5.3mf, 02_deka_rail_stop.3mf, 03_telezhki_roliki.3mf, 04_guides.3mf, 05_plavniki_100pct.3mf, 06_vtulki_vremennye.3mf, 07_cart_body_fix.3mf, 08_barabany_fix.3mf]
2026-08-04 Прошивка-стример 49E (ADC GPIO34) + заготовка струны-6 через TCA9548A
    [Гитара_струны6.blend]
2026-08-04 49E: усреднение 16 замеров ADC против шума
2026-08-24 Страница-пульт шестиструнки: 6 осциллографов, детект, Карплус-Стронг EADGBE
2026-08-24 Пульт-6: подавление наводок между струнами (гейт по огибающей, как в e-drums)
2026-08-24 Гармошка 0.7 (стол 54): чередование жёсткостей против резонанса соседних струн
    [01_grif_L1-L5.3mf, 02_deka_rail_stop.3mf, 03_telezhki_roliki.3mf, 04_guides.3mf, 05_plavniki_100pct.3mf, 06_vtulki_vremennye.3mf, 07_cart_body_fix.3mf, 08_barabany_fix.3mf]
2026-08-24 Палка-моноблок гармошка+струна+гармошка, 3 жёсткости с метками; стол 55 на 6 струн
    [01_grif_L1-L5.3mf, 02_deka_rail_stop.3mf, 03_telezhki_roliki.3mf, 04_guides.3mf, 05_plavniki_100pct.3mf, 06_vtulki_vremennye.3mf, 07_cart_body_fix.3mf, 08_barabany_fix.3mf]
2026-08-24 Модуль-картридж струны на 49E: планка с интегр. столбиками и гнездом TO-92 (стол 56)
    [01_grif_L1-L5.3mf, 02_deka_rail_stop.3mf, 03_telezhki_roliki.3mf, 04_guides.3mf, 05_plavniki_100pct.3mf, 06_vtulki_vremennye.3mf, 07_cart_body_fix.3mf, 08_barabany_fix.3mf]
2026-08-24 Палка: хвост пружины прямой + один изгиб к столбику сбоку (идея юзера), столбики модуля сбоку от оси
    [01_grif_L1-L5.3mf, 02_deka_rail_stop.3mf, 03_telezhki_roliki.3mf, 04_guides.3mf, 05_plavniki_100pct.3mf, 06_vtulki_vremennye.3mf, 07_cart_body_fix.3mf, 08_barabany_fix.3mf]
2026-08-24 Палка: пружина из торца струны по оси (без лапки и нахлёста) — чистая линия
    [01_grif_L1-L5.3mf, 02_deka_rail_stop.3mf, 03_telezhki_roliki.3mf, 04_guides.3mf, 05_plavniki_100pct.3mf, 06_vtulki_vremennye.3mf, 07_cart_body_fix.3mf, 08_barabany_fix.3mf]
2026-08-24 Палка: чистая струна без вырезов и лишних дырок (хвостов больше нет)
    [01_grif_L1-L5.3mf, 02_deka_rail_stop.3mf, 03_telezhki_roliki.3mf, 04_guides.3mf, 05_plavniki_100pct.3mf, 06_vtulki_vremennye.3mf, 07_cart_body_fix.3mf, 08_barabany_fix.3mf]
2026-08-26 Столы 57-61: остальные 5 картриджей струн, по одному на стол, жёсткости чередуются
    [01_grif_L1-L5.3mf, 02_deka_rail_stop.3mf, 03_telezhki_roliki.3mf, 04_guides.3mf, 05_plavniki_100pct.3mf, 06_vtulki_vremennye.3mf, 07_cart_body_fix.3mf, 08_barabany_fix.3mf]
2026-08-26 Стол 62: все 5 оставшихся картриджей разом (18 деталей)
    [01_grif_L1-L5.3mf, 02_deka_rail_stop.3mf, 03_telezhki_roliki.3mf, 04_guides.3mf, 05_plavniki_100pct.3mf, 06_vtulki_vremennye.3mf, 07_cart_body_fix.3mf, 08_barabany_fix.3mf]
2026-08-27 Основание на 6 картриджей + площадка ESP32 и ножки (стол 63)
    [01_grif_L1-L5.3mf, 02_deka_rail_stop.3mf, 03_telezhki_roliki.3mf, 04_guides.3mf, 05_plavniki_100pct.3mf, 06_vtulki_vremennye.3mf, 07_cart_body_fix.3mf, 08_barabany_fix.3mf]
2026-08-27 Прошивка шестиструнки на 6 холлах 49E (ADC 32-39), формат под struny6_pult
2026-08-27 Основание: каналы ножек сквозь балку
    [01_grif_L1-L5.3mf, 02_deka_rail_stop.3mf, 03_telezhki_roliki.3mf, 04_guides.3mf, 05_plavniki_100pct.3mf, 06_vtulki_vremennye.3mf, 07_cart_body_fix.3mf, 08_barabany_fix.3mf]
2026-08-27 Вставка-фиксатор проводов в прорезь модуля (стол 64)
    [01_grif_L1-L5.3mf, 02_deka_rail_stop.3mf, 03_telezhki_roliki.3mf, 04_guides.3mf, 05_plavniki_100pct.3mf, 06_vtulki_vremennye.3mf, 07_cart_body_fix.3mf, 08_barabany_fix.3mf]
2026-08-27 Вставка: уже на 1 мм, без боковых бугорков — вокруг остаётся щель для проводов
    [01_grif_L1-L5.3mf, 02_deka_rail_stop.3mf, 03_telezhki_roliki.3mf, 04_guides.3mf, 05_plavniki_100pct.3mf, 06_vtulki_vremennye.3mf, 07_cart_body_fix.3mf, 08_barabany_fix.3mf]
2026-09-08 Репозиторий охватывает весь проект: модели, столы печати, прошивки моторов и струн, CAD
    [01_grif_L1-L5.3mf, 02_deka_rail_stop.3mf, 03_telezhki_roliki.3mf, 04_guides.3mf, 05_plavniki_100pct.3mf, 06_vtulki_vremennye.3mf, 07_cart_body_fix.3mf, 08_barabany_fix.3mf]
2026-09-08 Документация проекта в вики: эпик, 5 страниц требований, 2 техдока + скрипт публикации
2026-09-09 Пульт шестиструнки: 6 осциллографов, детект щипка per-string, Карплус-Стронг EADGBE
2026-09-09 Пульт шестиструнки: развязка перекрёстных срабатываний (winner-take, окно 18 мс)
2026-09-09 Пульт шестиструнки: занавес после щипка — соседям порог x1.5 от силы, спад тау 250 мс
2026-09-09 Пульт шестиструнки: общий масштаб дорожек (галка) + цифра бегущего пика hp у каждой струны
2026-09-09 Пульт шестиструнки: дефолтные ноты — контрастная лесенка C3..G4, чтобы различать струны на слух
2026-09-09 Пульт шестиструнки: график = сигнал детекта (hp), чекбоксы вкл/выкл струн, выключенные вне детекта и масштаба
2026-09-09 Пульт шестиструнки: маска перезапуска — новый щипок должен быть выше собственного звона на 25%
2026-09-09 Пульт шестиструнки: развёртка круговой шкалы AS5600 — магнит у границы 4095/0 больше не даёт ложных игл
2026-09-09 Пульт: маска звона забывается за 150 мс (тремоло больше не глохнет), частота потока по факту, заголовок под обе прошивки
2026-09-09 Пульт-6: слияние двух веток — дефолт E2..E4 + кнопки «⇅» и «Лесенка», лог прошивки в статус, жёлтый LED «подавлено»
    Ветка с машины 2 (развязка, занавес, маска звона, галки струн, общий масштаб)
    взята за основу; из ветки машины 1 перенесены обратный порядок нот, показ
    строк «#» от прошивки и индикация подавленного щипка.
2026-09-09 Вики: уроки отладки пульта и AS5600 (4.10–4.12, история сенсора), новая страница «Прошивка ESP32», вторая машина в доступах
2026-09-09 Вики: картинки моделей — рендер сцен фоновым Blender (tools/render_scene.py), корпус и дека на «Т. Корпус», ссылки на файлы в GitHub
2026-09-09 Вики: исправлен обратный слэш в команде рендера на «Т. Корпус»
2026-09-09 Вики: инструкции сборки — ссылки на отрисованные страницы (raw.githack), а не на исходник
2026-09-09 Вики: «Т. Гриф» — привод «палка» как текущий (2.10–2.15), тросовые строки исключены; 3.7 узел струн на крышке, 4.13 один ESP32; три страницы из вики затянуты в репо
2026-09-09 Вики: «Т. Сборка гриф» (чек-лист сборки по шагам с картинками) и «Т. План» (дорожная карта до производства, 8 этапов)
2026-09-09 Вики: «Т. План» — заметки по этапу 1: что печатаем под ручной тест цепочки, ссылки на столы 31–36
2026-09-09 Физика четырёх станций грифа (Bullet): gitara_physics4.py (запекание+отчёт / ручная сцена), отчёт по кэшу, аддон-пульт четырёх моторов
2026-09-09 Секция-1: прорези под штыри ±24.5 (физика 4 станций), вилка тележки — на север (инструкция, чек-лист), уроки в Т. Гриф 2.16 и Т. План; make_3mf с фильтром столов
    [gs1_p1_mid.stl, gs1_p2_mid.stl, gs1_p3_mid.stl, gs1_p4_deck.stl]
2026-09-09 Т. План: этап А отправлен в печать, место под результат теста
2026-09-11 Вики: «Т. Инструкция по сборке» (этап А по шагам с рендерами со STL, файлы печати, правки под подшипники); MuJoCo-симуляция привода «палка» с панелью; рендер шагов сборки
2026-09-11 Инструкция: подписи обзора деталей у основания, плечо 0 = штырь длиннее
2026-09-11 Секция-1: проход в южной стенке под жёлоб x 4..16 (спица упиралась в стенку от старого жёлоба 11..21, найдено рендером инструкции); проверка спица-плита; стол 31 перегенерирован; инструкция дополнена
    [31_gitara_sec1_plity.3mf, gs1_arm0.stl, gs1_arm1.stl, gs1_arm2.stl, gs1_arm3.stl, gs1_p0_base.stl, gs1_p1_mid.stl, gs1_p2_mid.stl]
2026-09-11 Инструкция: версия в адресах картинок (сброс кэша вики)
2026-09-11 Инструкция: картинки переименованы в *_v2 (вики держала старые в кэше)
2026-09-11 Секция-1: посадки Ø5 плотные (FIT_D=5.2: диск плеча, кольцо спицы, паз тележки) вместо Ø6; купон посадок gs1_kupon (стол 65); стол 32 перегенерирован; инструкция: шаг 0 купон и смазка
    [32_gitara_sec1_meh.3mf, 65_kupon_posadok.3mf, gs1_arm0.stl, gs1_arm1.stl, gs1_arm2.stl, gs1_arm3.stl, gs1_cart.stl, gs1_kupon.stl]
2026-09-11 Купон посадок: стад-щуп отдельной деталью (приросший столбик нельзя примерить); стол 65 = пластина + щуп
    [65_kupon_posadok.3mf, gs1_kupon.stl, gs1_kupon_stud.stl]
2026-09-11 Купон: у стада-щупа рычаг 40 мм
    [65_kupon_posadok.3mf, gs1_kupon_stud.stl]
2026-09-11 Инструкция: заметка для ИИ на другом ПК — что делать с результатом купона (FIT_D, генератор, стол 32)
2026-09-12 Купон: подошло 5.1 — FIT_D=5.1, стол 32 пересобран, инструкция и строка И0.5 обновлены
    [32_gitara_sec1_meh.3mf, gs1_arm0.stl, gs1_arm1.stl, gs1_arm2.stl, gs1_arm3.stl, gs1_cart.stl, gs1_kupon_stud.stl, gs1_p0_base.stl]
2026-09-12 Столы печати: папка 3-0 синхронизирована с генератором (46 файлов отставали с июля); ссылки на 3mf в вики — прямое скачивание
    [01_grif_L1-L5.3mf, 02_deka_rail_stop.3mf, 03_telezhki_roliki.3mf, 04_guides.3mf, 05_plavniki_100pct.3mf, 06_vtulki_vremennye.3mf, 07_cart_body_fix.3mf, 08_barabany_fix.3mf]
2026-09-12 Инструкция: в таблице печати отмечена версия стола 32 с посадками 5.1
2026-09-13 Фретборд секций 2-3 с плоским дном: потолок верхней ленты — отдельная планка gs2_cap (столы 33, 34)
    [33_gitara_sec2.3mf, 34_gitara_sec3.3mf, gs2_cap.stl, gs2_fret.stl, gs3_fret.stl]
2026-09-13 Инструкция «гриф с моторами»: этап В (секции 2-3, ленты, фретборды) с рендерами, этап Г под моторы Ø36; секция-1 отмечена собранной, столы напечатаны
2026-09-13 Дека v2 под моторы Ø36: модель мотора, кривошипы на шестерне, открытая вилка, симуляция качания; тумбы корпуса разведены от моторов; столы 66-68, сцена Blender, этап Г в вики
    [37_korpus_dno_nw.3mf, 38_korpus_dno_ne.3mf, 39_korpus_dno_sw.3mf, 40_korpus_dno_se.3mf, 41_korpus_top_wn.3mf, 42_korpus_top_ws.3mf, 43_korpus_top_e.3mf, 44_korpus_lenty_a.3mf]
2026-09-13 Фретборды секций 2-3: линии струн (6 валиков поверх ладов, разрывы у винтов); столы 33, 34
    [33_gitara_sec2.3mf, 34_gitara_sec3.3mf, gs2_fret.stl, gs3_fret.stl]
2026-09-13 Шестерня мотора: замер 6.0 совпал с моделью, столы 66-68 без изменений
2026-09-13 Инструкция «гриф с моторами» приведена к виду: что напечатать, что купить, шаги 1-10; устройство и симуляция деки перенесены в Т. Гриф
2026-09-13 Страница «Т. Гриф в деке»: дека с моторами по шагам простым языком, картинка на каждый шаг
2026-09-13 Дека v3: полный оборот кривошипа (кулиса, диск под лентой, палец вверх r4.8), проставка мотора 0, гребёнки «Е»; купон со звёздочкой z10; расчёт перенесён на сервер, утечка памяти в профиле звёздочки 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
    [gdk1_base_v3.stl, gdk2_base_v3.stl, gdk_comb_v3.stl, gdk_crank0_v3.stl, gdk_crank1_v3.stl, gdk_crank2_v3.stl, gdk_crank3_v3.stl, gdk_ext.stl]
2026-09-13 Дека v3: гребёнки «Е» с короткими зубьями и фиксатором, столы 66-68, сцена и картинки v3; инструкции «Т. Гриф в деке» и «гриф с моторами» под полный оборот
    [66_kupon_shesternya.3mf, 67_deka1_v2.3mf, 67_deka1_v3.3mf, 68_deka2_v2.3mf, 68_deka2_v3.3mf, gdk1_base_v3.stl, gdk_comb_key_v3.stl, gdk_comb_v3.stl]
2026-09-13 Стол 69: проба одного узла деки v3 (Д1, кривошип 1, лента 1, гребёнка, фиксатор)
    [69_deka_proba1.3mf]
2026-09-13 Вики: проба одного узла деки (стол 69) со статусами проверки
2026-09-13 Проба первого мотора со стола 67 (ленты 0-2 перенесены туда), стол 69 убран — без лишней печати Д1
    [67_deka1_v3.3mf, 68_deka2_v3.3mf, 69_deka_proba1.3mf]
2026-09-14 Положение тележек: датчики Холла по ленте в деке v3 (стойки gitara_hall.py, проверка на обороте), стенд проверки гипотезы (стол 70), стойки (стол 71), страница «Т. Положение тележек» с рендерами
    [70_hall_stend.3mf, 71_hall_posts.3mf, _hall_magnet0_model.stl, _hall_magnet1_model.stl, _hall_magnet2_model.stl, _hall_magnet3_model.stl, gdk_hall_post0_v1.stl, gdk_hall_post1_v1.stl]
2026-09-14 «Затвор» под большим пальцем — перемещение по грифу рукой: эскиз v0 (пластина под дно + ползунок, FSR по торцам и магнит+49E сбоку, 3 вибромотора), стол 72, страница «Т. Перемещение по грифу рукой»
    [72_zatvor.3mf, zatvor_plate_v0.stl, zatvor_slide_v0.stl]
2026-09-15 Т. План: результат этапа А закрыт (секция-1 собрана 13.09), ссылки на деку v3 и датчики положения
2026-09-15 Пульт стенда датчика положения: АЦП вживую, шум, таблица мм→АЦП с вердиктом (монотонность, Δ/шум), строка для вики
2026-09-15 Пульт стенда датчика: поле мм через valueAsNumber (запятая в локали), Enter без двойного срабатывания, кнопка тоже прибавляет мм
2026-09-15 Стенд датчика положения: анимация палки по показанию (авто-диапазон / таблица калибровки); вики 6.3 результат стенда, 6.7 датчик под лентой
2026-09-15 Стенд датчика: калибровка схемы кнопками «южный упор = 0» / «северный = 9.6» вместо авто-min/max, магнит в масштабе
2026-09-15 Вики: стенд датчика положения — 6.3 готово с таблицей, 6.8 карман магнита в лентах, 6.9 стойки v2 под лентой; план 1.7
2026-09-15 Т. Положение тележек переписана под подтверждённый формат (49E под лентой): статус ✅, 6.4 исключена, схема формата, результат стенда; старые разделы про стойки сбоку убраны
2026-09-15 Вики: страница «Гриф в деке от астра» затянута в репозиторий (была только в вики), заголовок в TITLES
2026-09-15 Т. Положение тележек: 6.10 язычок сбоку ленты под магнит + тумбочка с датчиком (идея владельца); план — заметка
2026-09-15 Т. Положение тележек: 6.11 накладка на ленту с крылом под магнит (без перепечатки хвостов)
2026-09-19 drive_web: команда diag — проверка проводки по UART драйвера (питание VM, EN, обрыв и замыкание катушек)
2026-09-19 drive_web: diag считает байты по RX2 — различает мёртвую линию, молчащий драйвер и рабочий UART
2026-09-19 Т. Плата: 8.2 UART на D16/D17 (не RX0/TX0), 8.3 diag, 8.4 S2209 V4, 8.5 питание VM, распиновка стенда
2026-09-19 Т. Плата: 8.6 проба первого мотора Ø36 от ESP32 — крутится; 8.5 уточнено питание от USB
2026-09-19 wiki_publish: страница t-plata переименована в «Т. Плата для мотора»
2026-09-19 Т. Плата для мотора: 8.7 питание от PD-триггера — мотор работает
2026-09-19 Т. Плата для мотора: схема стенда, фото, статусы 8.5 и 8.7 — проверено; скрипт схемы
2026-09-19 Вики: новая страница «Т. Плата для 4-х моторов» — пустая таблица требований
2026-09-19 Т. Плата для 4-х моторов: 9.1 посадочные размеры (ESP 25.4), 9.2 способ — маркер и травление; эскиз компоновки
2026-09-19 Плата 4 моторов: первая разводка в KiCad (односторонняя, под маркер), 3D-модели модулей, рендеры
    [esp32_devkit30.step, plata_4_motora.kicad_pcb, s2209.step]
2026-09-19 Плата 4 моторов: PD-триггер модулем на гнёздах, GND к ESP по нижнему краю, 137x86; вики 9.3–9.6 с рендерами
    [esp32_devkit30.step, pd_trigger.step, plata_4_motora.kicad_pcb, s2209.step]
2026-09-19 Плата 4 моторов v3: оба разъёма на правом краю, триггер лежит на штырях насквозь; вики 9.3, 9.6
    [plata_4_motora.kicad_pcb]
2026-09-19 Плата 4 моторов: триггер лежит на плате плашмя, штыри без пластика; вики 9.6
    [plata_4_motora.kicad_pcb]
2026-09-19 Т. Плата для 4-х моторов: таблица «Создание платы» 9.10–9.17 (рисунок маркером, точки синхронизации, сверловка, травление, пайка, проверка)
2026-09-20 Плата 4 моторов: G-code калибровки маркера (K1 сверло, K2 маркер)
2026-09-20 Плата 4 моторов: G-code — 1_marker (рисунок + два крестика синхронизации), 2_sverlo_1.0 (ноль по левому крестику, пауза над правым)
2026-09-20 Плата 4 моторов: G-code повёрнут — длинная сторона вдоль Y (по X у станка ~125 мм хода)
2026-09-20 Плата 4 моторов: G-code двумя половинами под поле станка 100x100, синхронизация по четырём крестикам
2026-09-20 Плата 4 моторов: компактная 92x92 (рисунок 65x89) под заготовку 100x100 — драйверы 2+2, ESP посередине; G-code за одну установку; вики 9.7–9.9
    [plata_4_motora.kicad_pcb]
2026-09-20 Плата 4 моторов: сверловка глубже (2.4 мм), M0 без комментария, продолжение с отверстия N через SKIP
2026-09-20 Плата 4 моторов: файл обрезки кукурузой (Г-образный рез, 3 перемычки)
2026-09-20 Плата 4 моторов: обрезка двумя параллельными резами с перемычками, схема обрезки
2026-09-20 Т. Плата для 4-х моторов: рисунок, сверловка и обрезка сделаны; рецепт травления (перекись, лимонная кислота, соль); фото платы
2026-09-20 Т. Плата для 4-х моторов: таблицы по этапам (подготовка, станок, химия, пайка); травление и лужение сделаны; уроки про блок питания станка, поле 100x100, M0; фото
2026-09-20 Т. Плата для 4-х моторов: фото этапов перенесены внутрь строк таблиц
2026-09-20 Т. Плата для 4-х моторов: сверка статусов — 9.2 способ проверен, 9.7 и 9.9 уточнены
2026-09-20 Т. Плата для 4-х моторов: все картинки перенесены в строки требований, разделы «Как выглядит» и «Фото» убраны
2026-09-24 Плата 4 моторов: картинка с четырьмя перемычками (render_peremychki.py), в вики 9.16
2026-09-24 Плата 4 моторов: спаяна; diag опрашивает все 4 адреса, diag N — тест катушек на ножках платы; вики 9.16, 9.17 с фото
2026-09-24 Т. Плата для 4-х моторов: 9.16 спаяно, 9.17 проверка UART, фото
2026-09-24 Т. Плата для 4-х моторов: первое включение — драйвер отвечает, адрес под вопросом; фото
2026-09-24 Т. Плата для 4-х моторов: адреса 0, 2, 3 отвечают; гнездо 1 — перемычка MS1
2026-09-24 plata4_fw: прошивка платы 4 моторов — ножки по 9.8, 4 драйвера по адресам, m N / deg / sw / cur / init / diag
2026-09-24 Т. Плата для 4-х моторов: все 4 драйвера отвечают по адресам, прошивка plata4_fw залита
2026-09-25 Эпик: постановка — тележки ведут пальцы, струны только вскользь; исходная постановка наверх; плата 4 моторов в состоянии и оглавлении
2026-09-25 Пульт платы 4 моторов: websim/plata4_pult.html — карточка на каждый мотор, повороты, качание, тест катушек
2026-09-25 Вики: проба первого мотора на деке прошла (фото, видео); плата 4 моторов — мотор на драйвере 3 крутится
2026-09-25 Плата 4 моторов готова: все 4 мотора крутятся; diag проверяет EN и STEP (MSCNT); плохой припой D22 найден и перепаян
2026-09-25 Вики: новая страница «Т. Сборка короткий гриф» (стенд на 4 мотора без секции-3); оглавление эпика — сверху текущее, готовое внизу
2026-09-26 Ложе для пальца: тележка секции-1 с бортиками (gitara_lozhe.py), стол 69, вики 10.15–10.16
    [69_lozhe_palcy.3mf, gs1_cart_lozhe.stl]
2026-09-26 Плата 4 моторов: картинка прозвонки гнезда 1
2026-09-26 plata4_fw: ток удержания 20% (моторы грелись стоя), после теста мотор отпускается, команда off; кнопка «Отпустить все» в пульте
2026-09-26 Секция-1 v2: тележки на шаге V позиции 26/25/24, свои русла, ложа 24x22 (столы 73, 74); ложе v0 переделано по замерам: полозья в прорезь 10.5, канал штыря 5.3 (стол 69); вики 10.15–10.20, Т. Гриф 2.21
    [69_lozhe_palcy.3mf, 73_sec1_v2_plity.3mf, 74_sec1_v2_meh.3mf, gs1_arm0_v2.stl, gs1_arm1_v2.stl, gs1_arm2_v2.stl, gs1_arm3_v2.stl, gs1_cart_lozhe.stl]
2026-09-26 Т. Сборка короткий гриф 10.20: прорези перпендикулярны, угол пальца даёт просторное ложе
2026-09-26 Сцена Blender секции-1 v2 в сборе с анимацией качания
    [Гитара_секция1_v2.blend]
2026-09-26 Ложе v0: по центру прорези, полозья 2.9, крайнее для тележки 3 со ступенькой на бортик; стол 75 — проба одного, стол 69 — 3 + крайнее
    [69_lozhe_palcy.3mf, 75_lozhe_proba.3mf, gs1_cart_lozhe.stl, gs1_cart_lozhe_kraj.stl]
2026-09-26 Ложе v0 плоское (идея владельца): без тележки и скосов, полозья в прорезь, дырка под штырь; стол 75 — проба
    [75_lozhe_proba.3mf, gs1_cart_lozhe_plosk.stl]
2026-09-26 Плоское ложе: крайнее для тележки 3 (укорочено до бортика канала); стол 76 — ещё 3 шт
    [76_lozhe_plosk_3.3mf, gs1_cart_lozhe_plosk_kraj.stl]
2026-09-26 Вики: короткий гриф собран и работает; ложе — первая печать, плоское ложе (10.15a); сцена v2; струны-бугорки (10.21, ждёт решения); плата — нагрев стоя исправлен (9.18), пульт 4 моторов
2026-09-26 Т. Сборка короткий гриф 10.14: прогон всех четырёх — работает
2026-09-26 Секция-1 v2: линии струн на свободной части палубы (для вида); столы 73/74 и сцена пересобраны; вики 10.21
    [73_sec1_v2_plity.3mf, 74_sec1_v2_meh.3mf, gs1_p4_deck_v2.stl, Гитара_секция1_v2.blend]
2026-09-26 Вики: короткий гриф завершён; новые страницы «Т. Тележки» (11.x) и «Т. Гриф под тележки» (12.x), строки перенесены с пометкой; оглавление эпика
2026-09-26 Т. Тележки: этап 4 — калибровка струн, сверка, «Ода к радости» (звук в wiki/audio)
2026-09-26 Калибровка струн (save/ref/go/to/cal) в прошивке и пульте, проигрыватель «Оды к радости»; новая страница «Т. Софт» со скрином пульта
2026-09-26 Ложе v2 плоское: пластина с бортиками в своём русле, полозья в прорезь, дырка под штырь (как у v0)
    [gs1_cart_lozhe_v2_plosk.stl]
2026-09-26 Стол 77: 4 плоских ложа под секцию-1 v2
    [77_lozhe_v2_plosk.3mf]
2026-09-27 Пульт: мотор = палец по сборке (0 мизинец … 3 указательный), мелодия переназначена, карточки подписаны пальцами; вики 11.10, 13.8
2026-09-27 Пульт: выбор мелодии из списка — «Ода к радости», «Паучок» 6→1→6, ля-минорная пентатоника; переезд на 60 об/мин; вики 11.11, 13.8
2026-09-27 Пульт: упражнение «Указательный: прыжки», ползунок скорости переезда; вики 11.12
2026-09-27 Пульт: мелодия по кругу (галочка «по кругу»)
2026-09-27 Ток удержания выбирается в пульте (holdpct 20/50/100, по умолчанию 50): при 20% палец проворачивал мотор; вики 13.1
2026-09-27 Пульт: «прыжки» для каждого пальца (мизинец, указательный, безымянный, средний), мизинец первым
2026-09-27 Идея владельца: барабан на валу мотора в голове грифа, палец в дырке барабана — сцена Blender и кадры
    [Идея_барабан_палец.blend]
2026-09-27 Кривошип 3 R7.5 (по astra A3) + хвост 3 с западной кулисой, проверка моделью, стол 78; прошивка: границы хода по калибровке, кнопка «Стереть калибровку»; архив «астры» в 2-0/astra; вики 11.13, 13.7
    [01_A2_D1_and_3_guides.3mf, 03_v3_tails_optional.3mf, 04_A3_reinforced_cranks_1_2_3.3mf, 78_crank3_big.3mf, D1.stl, D2.stl, assembly_astra_A3.step, astra_closed_guide.stl]
2026-09-27 Кривошип 3 R7.5: посадка по зубьям шестерни z10 (зазор 0.10) вместо круглой — проворачивался; стол 79; вики 11.14
    [79_crank3_big_zub.3mf, gdk_crank3_big.stl]
2026-09-27 Концепт «рейка 1:1» для верхнего этажа: шестерня на моторе, лента с зубьями, двухвенцовая шестерня в секции-1, тележка с рейкой — сцена Blender
    [Идея_рейка_1к1.blend]
2026-09-27 Концепт «винт поперёк грифа» для верхнего этажа: пруток от мотора, коническая пара, ходовой винт шаг 8, гайка в тележке — сцена Blender
2026-09-27 Этаж 3 (мизинец): плечо секции-1 52:16 вместо 52:10 (лента ±6.8 вместо ±4.2, люфт ×3.25 вместо ×5.2), своя спица с коленом к жёлобу, кривошип 3 R10 с хвостом; проверка моделью, сцена Blender
    [gdk_crank3_r10.stl, gdk_tail3_r10.stl, gs1_arm3_r16.stl, gs1_spica3_r16.stl]
2026-09-27 Стол 80: этаж 3 с рычагом 52:16 — плечо, спица, кривошип R10, хвост R10
2026-09-27 Вики: страница «Т. Вариант с тележками» — привод, причины плохого хода, отклонённые механизмы, рычаг ×3.25 на мизинце и план ×2; сцены винта и плеча R16
    [Идея_винт_поперёк.blend, Секция1_плечо3_R16.blend]
2026-09-27 Гриф ×2: секция-1 v3 (плечо 36:18, спицы с прорезью, ложе v3, без стяжки 23.5/120), дека ×2 (DEKA_X2=1: кривошипы R15 рычажком по зубьям, кулисы с запада, окно Д1 по сектору), симуляция Гриф_x2.blend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
    [gdk1_base_x2.stl, gdk2_base_v3.stl, gdk_crank0_x2.stl, gdk_crank1_x2.stl, gdk_crank2_x2.stl, gdk_crank3_x2.stl, gdk_spacer0_v3.stl, gdk_tail0_x2.stl]
2026-09-27 Дека ×2: кривошипы R10 полным диском с телом до дна, полный оборот (струны 1–6 = 180°), кулиса в обе стороны с перемычками 3 мм, окно Д1 кругом; симуляция с полными оборотами; вики 14.12
    [gdk1_base_x2.stl, gdk_crank0_x2.stl, gdk_crank1_x2.stl, gdk_crank2_x2.stl, gdk_crank3_x2.stl, gdk_tail0_x2.stl, gdk_tail1_x2.stl, gdk_tail2_x2.stl]
2026-09-27 Дека ×2: пальцы кривошипов выше ленты на 1.8 (у этажа 3 на 1.3), чтобы кулиса не соскакивала; вики 14.12
    [gdk_crank0_x2.stl, gdk_crank1_x2.stl, gdk_crank2_x2.stl, gdk_crank3_x2.stl, Гриф_x2.blend]
2026-09-27 Стенд одного пальца (указательный, ×2): дно, середина с потолком, палуба 24, плечо 36:18, лента-кулиса, кривошип R10 полный оборот; проверка моделью, сцена, стол 81; вики 14.13
    [mini1_arm.stl, mini1_base.stl, mini1_deck.stl, mini1_lenta.stl, mini1_mid.stl, Стенд_один_палец.blend]
2026-09-27 Столы 80 (этаж 3 ×3.25) и 81 (стенд одного пальца) — файлы 3mf
    [80_etazh3_r16.3mf, 81_stend_odin_palec.3mf]
2026-09-27 Без поддержек: кривошипы ×2 цилиндром с плоским дном, проставка 0 кольцом; стенд — лента со стадом вверх, плечо с прорезью на ступеньке оси; стол 81 пересобран; вики 14.12–14.13
    [81_stend_odin_palec.3mf, gdk_crank0_x2.stl, gdk_crank1_x2.stl, gdk_crank2_x2.stl, gdk_crank3_x2.stl, gdk_spacer0_x2.stl, mini1_arm.stl, mini1_base.stl]
2026-09-27 Концепт «шатун вместо прорези» у плеча стенда: лента → шатун с двумя круглыми дырками → плечо — сцена Blender
    [Идея_шатун_плечо.blend]
2026-09-27 Стенд одного пальца v2: шатун прямо на пальце кривошипа (идея владельца) — четырёхзвенник без ленты и прорезей, плечо 32.5:18, шатун 34.9, ложе ±20; проверка полным оборотом, сцена
    [mini2_arm.stl, mini2_base.stl, mini2_crank.stl, mini2_deck.stl, mini2_mid.stl, mini2_shatun.stl, Стенд_шатун.blend]
2026-09-27 Стол 82: стенд одного пальца v2 с шатуном на кривошипе; вики 14.14
    [82_stend_shatun.3mf]
2026-09-27 Стенд v2: штырьки торчат на 1.5 (потолок 8.3), дырка Ø2.6 в штыре ложа под самонарез М3 с шайбой, штырь на 0.3 выше дна ложа; ложе v3 с разрывом южного бортика; стол 82 пересобран; вики 14.14
    [82_stend_shatun.3mf, gs1_lozhe_v3.stl, mini2_arm.stl, mini2_base.stl, mini2_crank.stl, mini2_mid.stl, mini2_vint_proverka.stl, Стенд_шатун.blend]
2026-09-27 Физика стенда v2 с шатуном: квазистатика + MuJoCo (на сервере) — момент мотора под пальцем 3 Н, угол передачи, проворот на удержании; окно pyvista с движением по траектории MuJoCo
2026-09-27 Физика стенда v2: жёсткий шарнир шатун-плечо (шаг 0.1 мс, расхождение 0.011 мм вместо ~10°), окно берёт позу шатуна прямо из MuJoCo и показывает расхождение
2026-10-01 Магнитная версия привода: линейный мотор в грифе (катушки в русле, тележка — скоба с магнитами N52), расчёты сил, модель guitar_mag_lanes.blend, страница «Т. Магнитная версия»
    [guitar_mag_lanes.blend]
2026-10-01 Т. Магнитная версия: 15.12 — блок русел ездит вдоль грифа на NEMA 14 (идея на потом)
2026-10-01 Т. Магнитная версия: переписка 01.10 для продолжения на другом ПК, что есть в наличии, следующий шаг
2026-10-03 Стенд v2: дырки шатуна 5.5 и оси плеча 5.4 (напечатанные 5.2 / 5.1 входили туго); стол 83 — перепечатка шатуна и плеча, стол 82 пересобран
    [82_stend_shatun.3mf, 83_stend_shatun_dyrki.3mf, mini2_arm.stl, mini2_shatun.stl]
2026-10-03 Стенд v2: запасной стад оси плеча Ø5 × 3.3 (отломился), стол 84 — 3 шт
    [84_stad_osi_zapas.3mf, mini2_stad_osi.stl]
2026-10-03 Прошивка plata4: границы хода по калибровке выключены по умолчанию (стенд с шатуном и гриф ×2 крутятся полным оборотом), команда lim 1/0
2026-10-03 Стенд v2: ложе длиннее к деке (лежит на палубе по обе стороны прорези — не проваливается), южный бортик русла сдвинут; стол 85 — палуба + ложе, стол 82 пересобран
    [82_stend_shatun.3mf, 85_stend_paluba_lozhe.3mf, mini2_deck.stl, mini2_lozhe.stl, Стенд_шатун.blend]
2026-10-03 Магниты: расчёт пробы из дисков 4×2 владельца — U-скоба столбиком/плиткой и неподвижная дорожка с катушками на тележке
2026-10-03 Магниты: русло 15×10×5 N52 в две фазы под нашу плату (расчёт: последовательно ~64 Вт на 300 г, по катушке отдельно ~8–11 Вт), концепт пробного русла в Blender
    [Магнитное_русло_проба.blend]
2026-10-03 Концепт «храповик» (идея владельца): два толкателя-соленоида с собачками, рейка с зубьями шагом струн, фиксатор — сцена Blender
    [Идея_храповик.blend]
2026-10-03 Магниты: 2D МКЭ — магнит на тележке над рядом самодельных электромагнитов со стальным сердечником под струнами (липкость, прижим, перескок при 1.5 и 3 А)
2026-10-03 Магниты: сравнение вариантов с Ozon для скобы — лучший 20×10×5 стоя (катушка 16 в высоте магнита, стопка 25 мм)
2026-10-03 Проба магнитного русла под 20×10×5 N52: оправка для намотки, рамка 8 катушек, основа, U-скоба с гнёздами под магниты и сталь; проверка хода; стол 86, сцена; вики 15.13–15.14
    [86_magnit_proba.3mf, mag_katushki_proverka.stl, mag_magnity_proverka.stl, mag_opravka_a.stl, mag_opravka_b.stl, mag_osnova.stl, mag_ramka.stl, mag_skoba.stl]
2026-10-03 Вики: «Т. Инструкция по сборке: магнитное русло (проба)» — стол 86 по шагам с картинками, схема фаз; оглавление: магнитная версия — сейчас в работе
2026-10-03 Инструкция магнитного русла: анимация и картинки намотки катушки по слоям
    [Как_мотать_катушку.blend]
2026-10-03 Оправка для намотки на защёлках: два язычка с крючками и ушками, без винтов; стол 86 пересобран; инструкция 16.3
    [86_magnit_proba.3mf, mag_opravka_a.stl, Как_мотать_катушку.blend]
2026-10-03 Сцена стола 86: анимация сборки (оправка с защёлкой, рамка в основу, катушки, сталь и магниты в скобу, скоба на рельс) и ход скобы
    [Магнит_проба_стол86.blend]
2026-10-03 Сцена стола 86: катушки из провода (как с оправки) по одной переезжают в рамку; магниты и сталь ждут сбоку
    [Магнит_проба_стол86.blend]
2026-10-03 Магниты: влияние щели на силу и разрез «голая катушка / катушка в каркасе»
2026-10-03 Концепт «катушка в каркасе» (идея владельца): каркас 4 мм, каркасы кассетами в рамку, скоба со щелью 5 — сцена Blender
    [Идея_каркас_катушки.blend]
2026-10-03 Магниты: сила тяги голая катушка / в каркасе от нашей платы при 1–2 А
2026-10-03 Стенд v2: подбор сектора хода кривошипа и длины шатуна под угол передачи (R10 сектор — 38°, R14 — 52°, R17 — 57°, R20 — 61°)
2026-10-03 Концепт опыта «магнитный стержень + бегущая катушка» из дисков 4×2 владельца — сцена Blender
    [Идея_стержень_катушка.blend]
2026-10-03 Опыт «магнитный стержень + бегущая катушка» (диски 4×2): кассеты 5.6×5.6×8 с меткой N, заглушки, кондуктор, гильза с 4 отсеками на квадратном стержне, ложе, основа; проверка хода ±22.7; стол 87, сцена
    [87_sterzhen_proba.3mf, sz_kasseta.stl, sz_katushka.stl, sz_lozhe.stl, sz_osnova.stl, sz_sterzhen_proverka.stl, sz_zaglushka.stl, sz_zhelob.stl]
2026-10-03 Опыт со стержнем: ось для намотки гильзы (квадрат + шестигранник под шуруповёрт), анимация намотки 4 отсеков; стол 87 пересобран
    [87_sterzhen_proba.3mf, sz_os_namotki.stl, Как_мотать_гильзу.blend]
2026-10-03 Кассеты стержня: вдавленные стрелки на двух гранях к торцу N (глубина 0.3, без поддержек); стол 87 пересобран
    [87_sterzhen_proba.3mf, sz_kasseta.stl]
2026-10-03 Картинка кассеты со стрелкой
2026-10-03 Вики: «Т. Магнитная версия 2.0» — магнитный стержень + бегущая катушка (сравнение схем, расчёт Ø15×5, опыт стол 87, планы); вариант с тележками, магнитная версия и инструкция стола 86 — отложены; рас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
2026-10-04 Сохранение: shatun_sektor.py (подробно по секторам), перегенерированные модели деки
    [gdk_ext.stl, gdk_kupon_shesternya.stl, gdk_motor0_model.stl, gdk_motor1_model.stl, gdk_motor2_model.stl, gdk_motor3_model.stl]
2026-10-04 Опыт со стержнем: стержень одной деталью 6.4×6.4 с открытым жёлобом 4.6 под диски сверху, концы сразу в пазы стоек (кассеты, стрелки, заглушки, кондуктор убраны — печатались плохо); гильза и стойки п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
    [87_sterzhen_proba.3mf, sz_katushka.stl, sz_os_namotki.stl, sz_osnova.stl, sz_sterzhen.stl, sz_sterzhen_proverka.stl]
2026-10-04 Магниты: МКЭ — стальные шайбы между группами стержня дают +22% поля в катушке (1–2 мм одинаково)
2026-10-04 Магниты: МКЭ — неподвижный стальной П-жёлоб вокруг стержня: шайбы + дно ×1.47, шайбы + сталь со всех сторон ×1.65 по силе
2026-10-04 Опыт со стержнем: гильза сборная — трубка-сердечник (стоя) + 5 плоских щёчек с прорезью под выводы + шаблон 3.4 для склейки; без поддержек; стол 87 пересобран
    [87_sterzhen_proba.3mf, sz_gilza_shablon.stl, sz_gilza_shechka.stl, sz_gilza_trubka.stl]
2026-10-04 Опыт со стержнем: гильза из секций-стаканчиков — щёчка 0.8 + трубка, верх трубки входит на 0.4 в гнездо следующей щёчки; 4 секции + крышка, шаг 4.0, отсек 3.2 (~44 витка); без поддержек; стол 87 пере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
    [87_sterzhen_proba.3mf, sz_gilza_kryshka.stl, sz_gilza_sekciya.stl, sz_gilza_shablon.stl, sz_gilza_shechka.stl, sz_gilza_sobrannaya.stl, sz_gilza_trubka.stl]
2026-10-04 Стол 88: только гильза из секций — 8 секций + 2 крышки
    [88_gilza_sekcii.3mf]
2026-10-04 Стол 88: одна гильза — 4 секции + крышка
    [88_gilza_sekcii.3mf]
2026-10-04 Гильза: дырка 7.0 (стержень вышел 6.5×6.3, на 6.8 туго); ось для намотки 6.85 добавлена в стол 88; столы 87/88 пересобраны
    [87_sterzhen_proba.3mf, 88_gilza_sekcii.3mf, sz_gilza_kryshka.stl, sz_gilza_sekciya.stl, sz_gilza_sobrannaya.stl, sz_katushka.stl, sz_os_namotki.stl]
2026-10-04 Гильза: трубка со щёчкой + 4 насадки (щёчка + втулка-распорка), дырка 7.5, щёчки 15, ось стержня 10.5; столы 87/88 пересобраны
    [87_sterzhen_proba.3mf, 88_gilza_sekcii.3mf, sz_gilza_kryshka.stl, sz_gilza_nasadka.stl, sz_gilza_sekciya.stl, sz_gilza_sobrannaya.stl, sz_gilza_trubka.stl, sz_katushka.stl]
2026-10-04 Вики 17.17: стальные шайбы между полюсами — заказаны М5 DIN 9021 (15/5.3/1.2) и М8 DIN 125 (16/8.5/1.5); заготовка осесимметричного МКЭ с насыщением
2026-10-04 Вики 17.17: схема шайб в стержне и размеры М5 DIN 9021 / М8 DIN 125
2026-10-04 Вики 17.17: фото купленных шайб из магазина
2026-10-04 Вики: отложенные строки (💤) зачёркнуты, готовые (✅) на «Магнитной версии 2.0» — зелёным
2026-10-04 Вики 2.0: зелёный цвет готовых строк — разметка нового редактора {green}(…)
2026-10-04 Вики 2.0: у не начатых строк — чего ждут (⬜ Ждёт …)
2026-10-04 Вики 17.11: гильза намотана — фото
2026-10-04 Вики 17.12: катушка поехала на дисках 4×2 — слабо, у стальных шайб лучше
2026-10-04 Вики 17.12: фото подключения; прошивка plata4: команда spread 1/0 (spreadCycle для катушки), минимальная скорость 4 мкшага/с
2026-10-04 Пульт катушки-бегунка: ход в мм, скорость в мм/с, режим stealthChop/spreadCycle, качание
2026-10-04 Вики 17.9–17.10: детали опыта и сборка стержня — как сделано на самом деле (стол 87 v2, стол 88, фото стержня); ✅
2026-10-04 Вики 17.12: фото катушки на стержне
2026-10-04 Пульт катушки: «Настроить драйверы» и init + diag при подключении
2026-10-04 3D МКЭ стержня 15×5: шайбы, П-жёлоб, труба со щелью — с насыщением стали; режим sloi — 1/2/3 шайбы М5 в стык
2026-10-05 Стол 89: настоящий стержень на дисках 15×5 + шайбы М5 — брус 17 с жёлобом 15.4, гильза 24×24 (крышка + насадки, шаг 8.1, без трубки), основа (ось 15), ложе, ось намотки с шестигранником 7
    [89_sterzhen_15.3mf, s15_gilza_sobrannaya.stl, s15_kryshka.stl, s15_lozhe.stl, s15_nasadka.stl, s15_os_namotki.stl, s15_osnova.stl, s15_sterzhen.stl]
2026-10-05 Стол 89 — копия в 3-0/Print3mf
    [89_sterzhen_15.3mf]
2026-10-05 Стол 89: ось для намотки — шестигранник по оси квадрата, печать стоя
    [89_sterzhen_15.3mf, s15_os_namotki.stl]
2026-10-05 Стол 89: вернул трубку (трубка с нижней щёчкой + 4 насадки, как стол 88), гильза 26×26, ось стержня 16
    [89_sterzhen_15.3mf, s15_gilza_sobrannaya.stl, s15_kryshka.stl, s15_lozhe.stl, s15_nasadka.stl, s15_osnova.stl, s15_trubka.stl]
2026-10-05 Стол 89: гильза по рисунку владельца — основание со щёчкой и 4 штырьками 2×2 по углам вместо трубки, насадки с пазами в углах втулки; под провод 7.3 × 3.4 (~200 витков)
    [89_sterzhen_15.3mf, s15_gilza_sobrannaya.stl, s15_nasadka.stl, s15_osnovanie_shtyri.stl, s15_trubka.stl]
2026-10-05 Стол 89: вернул гильзу с трубкой (владелец: штырьки — провод ляжет плохо, потеря места невелика)
    [89_sterzhen_15.3mf, s15_gilza_sobrannaya.stl, s15_nasadka.stl, s15_osnovanie_shtyri.stl, s15_trubka.stl]
2026-10-07 Вики 17.18: стол 89 на дисках 15×5 — расчёт шайб и жёлоба, ошибка со стальной проволокой, заказан ПЭТВ-2 0.4
2026-10-08 Т. Вариант с тележками: 14.15 заметка — кулисный механизм Уитворта
2026-10-08 Т. Вариант с тележками 14.15: моторы в деке, у каждой тележки свой этаж
2026-10-08 Т. Вариант с тележками 14.15: качание туда-обратно, плотные посадки в парах палец-прорезь
2026-10-08 Т. Вариант с тележками: 14.16 заметка — кулиса с шатуном на ползун
2026-10-08 Пульт катушки: по умолчанию spreadCycle и 500 мА
2026-10-08 Вики 17.18: стол 89 на меди 0.4 поехал — 500 мА, ±16 мм; потеря шага при удержании пальцем
2026-10-08 Пульт катушки: выбор стержня — 15×5 (шаг 8.1 мм) по умолчанию, 4×2 (4 мм); было 4 мм для всех
2026-10-08 Вики 17.18: уточнение — пульт считал шаг 4 мм, на 15×5 он 8.1 мм
2026-10-08 Прошивка plata4: ток вверх/вниз (curup, curdn) и направление «вверх» (up) — стержень вертикально; пульт катушки: блок «вес», удержание в %
2026-10-08 Ползунок положения: прошивка plata4 — zero и at <шаги> (абсолютный ход), пульт катушки — ползунок ±22 мм
2026-10-08 Вики 17.18: настройка пульта, на которой бегунок хорошо ходит туда-сюда (в настоящих мм)
2026-10-08 Плавный ползунок: прошивка plata4 — tgt (следование с разгоном/торможением в loop, цель меняется на ходу), ms (дробление по мотору), acc; пульт катушки — дробление 1/32 (0.25 мм), ползунок шлёт tgt
2026-10-08 Идея: катушка неподвижно в грифе, стержень едет с рамкой над катушкой — сцена Blender и 3 положения
    [Рамка_стержень_едет.blend]
2026-10-08 Вики: новая страница «Т. Магнитный + Кривошип» — линейный привод в деке толкает ленту этажа, рычаг 1:1; почему стержень не влезает в гриф; сцена Blender деки с 4 приводами
    [Дека_линейные_приводы.blend]
2026-10-08 Т. Магнитный + Кривошип 18.9: рычаг 2:1 в деке — сцена одного пальца (привод ±44 → лента ±22 ×2 силы → крюк 1:1)
    [Рычаг_2к1_один_палец.blend]
2026-10-09 Стенд одного пальца на приблуде (вариант А): gitara_mini3.py, сцена, столы 90/91; вики 18.10
    [90_stend_pribluda.3mf, 91_stend_pribluda_verh.3mf, mini3_base.stl, mini3_lenta.stl, mini3_sedlo.stl, Стенд_один_палец_приблуда.blend]
2026-10-09 Стенд на приблуде: седло v2 — только торцевые вилки, медь до Ø34, ось стержня 26; стол 90 пересобран; вики 18.11
    [90_stend_pribluda.3mf, mini3_base.stl, mini3_med_proverka.stl, mini3_sedlo.stl, Стенд_один_палец_приблуда.blend]
2026-10-09 Т. Магнитный + Кривошип 18.12: STL стенда, что нужно для сборки, катушка 6/8 отсеков — таблица силы
2026-10-09 Стенд на приблуде: седло v3 — палец отдельной деталью, седло пластиной на стол без поддержек, зубцы вилок толще; стол 90 пересобран; вики 18.13
    [90_stend_pribluda.3mf, mini3_lenta.stl, mini3_palec.stl, mini3_palec_sborka.stl, mini3_sedlo.stl]
2026-10-09 Стенд v2 с длинным шатуном ~97 мм (мотор дальше): gitara_mini2_dlinnyj.py, стол 92, худший угол передачи 47° вместо 31°; вики 14.17
    [92_stend_shatun_100.3mf, mini2d_arm.stl, mini2d_base.stl, mini2d_crank.stl, mini2d_deck.stl, mini2d_lozhe.stl, mini2d_mid.stl, mini2d_shatun.stl]
2026-10-09 Стенд «приблуда + шатун» без прорези: gitara_mini4.py, стол 93 (дно, шатун 110 с круглыми дырками, плечо с круглой дыркой); вики 18.14
    [93_stend_pribluda_shatun.3mf, mini4_arm.stl, mini4_base.stl, mini4_shatun.stl]
2026-10-09 Стол 94: палуба v2 (северный бортик +17) + длинное ложе mini2 — короткое ложе v3 проваливалось в прорезь; проверки стендов 90/93 на новой палубе — чисто
    [94_paluba_v2_dlinnoe_lozhe.3mf, mini1_deck_v2.stl]
2026-10-09 Вики 18.15: палуба v2 и длинное ложе (стол 94)
2026-10-09 Ложе v2 с длинными полозьями (штырь зажат по высоте ~16 мм): стол 94 пересобран, проверки стендов 82/90/93 — чисто; вики 18.15
    [94_paluba_v2_dlinnoe_lozhe.3mf, mini2_lozhe_v2.stl]
2026-10-09 Стенд с мотором: кривошип R14 сектором ±46° (без мёртвых точек), шатун 95 — gitara_mini2_sektor.py, столы 95 и 96 (кривошип с поддержкой от стола); вики 14.18
    [95_stend_nema_sektor.3mf, 96_krivoshyp_r14.3mf, mini2s_arm.stl, mini2s_base.stl, mini2s_crank.stl, mini2s_deck.stl, mini2s_lozhe.stl, mini2s_mid.stl]
2026-10-09 Вики 18.16: стенд 90 тянет слабо — решение вернуться к NEMA с кривошипом сектором (14.18)
2026-10-09 Стенд-сектор: ложе ±22 (6 струн по 8.8) — сектор +51.3/−52.4°, стенки в полосе штыря 1 мм, прорезь ±25, ложе без полозьев; столы 95/96 пересобраны; вики 14.18
    [95_stend_nema_sektor.3mf, 96_krivoshyp_r14.3mf, mini2s_arm.stl, mini2s_base.stl, mini2s_deck.stl, mini2s_lozhe.stl, mini2s_mid.stl]
2026-10-09 Сцена Blender стенда с мотором и кривошипом R14 сектором (столы 95/96) из STL, анимация ±22
    [Стенд_мотор_сектор.blend]
2026-10-10 Стол 97: цилиндр R8.3 × 3 с глухой дыркой Ø5 × 1.2
    [97_cilindr_r8_3.3mf, cilindr_r8_3.stl]
2026-10-10 Стол 98: шатун стенда 95 с дырками 5.3 и 5.2 (было 5.5) — против люфта
    [98_shatun_dyrki_menshe.3mf, mini2s_shatun_d52.stl, mini2s_shatun_d53.stl]
2026-10-10 Стенд «спарник»: два диска R20 и планка со щелью (gitara_sparnik.py), стол 99; вики 14.19
    [99_stend_sparnik.3mf, spar_base.stl, spar_disk_motor.stl, spar_disk_svob.stl, spar_planka.stl, spar_stupica.stl]
2026-10-10 Спарник: мостик с поперечной прорезью и Т-тележка (штырь в пересечении прорезей), стол 99 пересобран, сцена Стенд_спарник.blend
    [99_stend_sparnik.3mf, spar_base.stl, spar_most.stl, spar_telezhka.stl, Стенд_спарник.blend]
2026-10-10 Идея: спарник на 4 тележки — планки по этажам, палец на конце планки в лапе тележки с прорезью вдоль грифа; сцена Blender
    [Спарник_4_тележки.blend]
2026-10-10 Спарник на 4 тележки: в сцене диски и моторы в деке (у каждого пальца пара дисков, дальний палец ближе к грифу)
    [Спарник_4_тележки.blend]
2026-10-10 Идея: 4 этажа «как стенд 95» — мотор R14 сектором в деке, длинная спица, ножка 36:18 у своей тележки на своём этаже; сцена Blender
    [Ножки_4_этажа.blend]
2026-10-10 Идея владельца: полудиск у каждой тележки повторяет диск в деке (спарник по этажам); сцена Blender
    [Полудиск_4_этажа.blend]
2026-10-10 Полудиск на 4 этажа: полудиск сдвинут от тележки к деке, тележка — неподвижный по y штырь и лапа на своём этаже (нижние этажи не протыкают верхние)
    [Полудиск_4_этажа.blend]
2026-10-10 Макет «второй диск у тележки» (один мотор): gitara_sparnik2.py, стол 100; вики 14.20
    [100_maket_disk_u_telezhki.3mf, spar2_base.stl, spar2_disk.stl, spar2_most.stl, spar2_planka.stl, spar2_salazki.stl]
2026-10-10 Сцена Blender макета «второй диск у тележки» (стол 100) из STL
    [Макет_диск_у_тележки.blend]
2026-10-10 Макет 100: винты мостика вынесены за бортики (салазки ходили над головками), мостик ±36.5; проверка с головками винтов — чисто
    [100_maket_disk_u_telezhki.3mf, spar2_base.stl, spar2_most.stl, Макет_диск_у_тележки.blend]
2026-10-12 Вики: новая страница «Т. Моторчик в тележке» (мотор в тележке, шестерня по рейке, выбор GB1806), 📜 Хроника проекта, статусы и оглавление эпика; магнитные и кривошипные направления — 💤; концепт-сцена 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
2026-10-12 Т. Моторчик в тележке: отклонённые 19.7 и 19.13 зачёркнуты
2026-10-12 Хроника и Т. Моторчик 19.17: донор — стабилизатор Aochuan с Авито для пробы гимбал-моторов
2026-10-14 Т. Моторчик в тележке: донор Zhiyun Smooth 4 (19.18, Aochuan 19.17 ❌); этап 5 — платформа вдоль грифа: толкатель из деки, штанга-трубка с проводами, электроника на платформе, катящаяся петля в деке (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
2026-10-14 Т. Моторчик 19.25: плоский толкатель-накладка со струнами, лады метками на бортиках (19.22 трубка ❌); концепт-сцена
2026-10-14 Т. Моторчик 19.26: жёсткость грифа — ребро-клин снизу по центру + печатная насадка; хроника 14.10
2026-10-14 Т. Моторчик 19.26: убрана подставка под голову — тренажёр держат как настоящую гитару
2026-10-15 Т. Моторчик 19.27–19.28: вибрация самим мотором тележки; зажатие — две кнопки под концами рейки; хроника 15.10
2026-10-29 Стенд одного пальца «мотор в тележке» на гимбале 2204: шестерня m1 z20, рейка, Т-рельсы с фаской — gitara_motor1.py (проверка зацепления), стол 101, сцена; вики 19.29
2026-10-29 Стенд 2204: шестерня z26 (мотор целиком выше рейки), тележка-клетка с полом, окном под провода и крышкой на 4 защёлках; рама печатается стоя; стол 101, сцена, вики 19.29
2026-10-29 Стенд 2204: плита шириной грифа 52, рейка с зубьями до края — тележка на краях выезжает за грань; стол 101 пересобран
2026-10-29 Стенд 2204: мотор к клетке двумя винтами М2 по диагонали — радиальные прорези в стенке под 45°/225°; стол 101
2026-10-29 Т. Моторчик 19.11: заказано 4 × GB1806 с AS5048A (29.10), скрин и параметры продавца
2026-10-29 Т. Моторчик 19.15: заказано 5 × DRV8316CT (29.10), скрин
2026-10-29 Стенд 2204: полозья тележки по ширине коробки (±16.8 вместо ±12) — меньше перекос и закусывание; стол 102 (только тележка), 101 пересобран
2026-10-29 Стенд 2204: зазор тележки вокруг рейки 1.5 вместо 0.5 (бока выше зубьев, пол короче) — при наклоне цепляла зубья; столы 101, 102
2026-10-29 Т. Моторчик: стенд 2204 собран (19.29 — что вылезло и что исправлено), драйвер SimpleFOC Mini V2 с фото (19.15), новый этап 6 «Тест стенда 2204» 19.30–19.35: подключение со схемой, питание от PD-триг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
2026-10-30 Стенд 2204: прошивка motor1_fw (SimpleFOC без датчика, команды x/s/u/on/off/z/dir/p) и пульт motor1_pult.html через Web Serial
2026-10-30 Т. Моторчик 30.10: драйвер и ESP32 работают (19.30), PD-триггер 12 В — переключатель 1 и кабель C–C (19.31), прошивка и пульт (19.32); гимбал 2204 сломан — обрыв обмоток, вероятно винтами (19.9), уро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
2026-10-30 Т. Моторчик 19.30: драйвер подтверждён на моторе 1306 — крутится ровно на 0.54 В; прошивка motor1306_sinus
2026-10-30 Стенд под GB1806 (19.16), нарисован заранее: шестерня m1 z14 (~870 г/А), рейка на гребне, мотор винтами М2 корпусом энкодера к стенке (глубина — параметр SCREW_IN), окна под разъём AS5048A; стол 103,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
2026-11-01 Сборка тренажёра с корпусом из фанеры (концепт): дно, кольца, дека — лазер; бока ПЭТ; гриф из 2 слоёв фанеры с пазом, алюминиевое ребро, печатные спинка и бортики; платформа с 4 тележками GB1806, тол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
2026-11-01 Сборка с фанерным корпусом: гриф = платформа с тележками ~27 мм (дно 1.5 + платформа 1.5 + мотор 22 + ложе), дно плоское без ребра и спинки, тележки выходят за край на крайних струнах, рейка толкател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
2026-11-01 Сборка: толкатель — короб во всю высоту грифа (верх вровень с ложами), дека поднята над ним
2026-11-01 Сборка: у каждой тележки корпус-«клавиша» со скруглёнными углами и выемкой под палец (в цвет короба толкателя), торец короба толкателя
2026-11-01 Сборка: плата ESP32 + 4 драйвера внутри короба толкателя, платформа короче
2026-11-01 Вики: новая страница «Т. Сборка: лазерная резка» (20.1–20.10) с картинками сборки; ссылка в эпике
2026-11-01 Сборка как настоящая классика: корпус с XII лада (325 вместо 480), окно в деке под платформу, розетка и подставка; снизу гриф конусом — клин из 9 фанерных пластин; вики 20.11, 20.12
2026-11-01 Сборка: гриф расширяется 52 → 60 к XII; клин по грифу убран (43 мм не обхватить) — пятка только в корпусе; вики 20.12, 20.13
2026-11-01 Вики 20.8: жёсткость грифа — расчёт «плашмя» и разбор нагрузок, когда гитару держат боком; проверить полосой в руках
2026-11-01 Опыт 20.8: полоса дна грифа 2.5 × 295, 52 → 58, гравировка струн и ладов, по диагонали стола — стол 104 (PETG, заполнение 100% прямыми линиями); make_3mf печатает ошибку слайсера
2026-11-01 Сборка: толкатель тянет ремень GT2 в корпусе (NEMA17 + натяжной шкив) — рейки и паза в дне грифа нет; вики 20.14, 20.7, 20.8
2026-11-01 Сборка: привод толкателя — рейка по краю паза в дне короба (паз и для проводов), NEMA17 осью вверх, шестерня через окошко в полу канала; ремень убран; вики 20.14
2026-11-01 Вики 20.8: опыт — PLA-полоса 295 мм боком держит крепко → дно грифа фанера 3 мм (2 мм авиа — проверить)
2026-11-01 Вики: плата AS5048A продавца — распиновка, 3 провода через ШИМ, питание 5 В (19.14); провода от тележек к плате — шлейфы катящейся петлёй (20.15)
2026-11-02 Хроника: 29.10–02.11 — стенд 2204, драйвер проверен на 1306, заказ GB1806/DRV8316, сборка из фанеры, 2204 с Авито
2026-11-02 Т. Моторчик 19.18 ❌: моторы Zhiyun Smooth 4 залиты в корпус — не вынуть; хроника 02.11
2026-11-04 Кассета владельца (телескоп m0.5, мотор неподвижен): файлы автора, проверка хода ±24 — пересечений нет, зубья в зацеплении; FDM-проба без мотора с осями из прутка 1.75 — стол 105
2026-11-04 Кассета: сцена Blender с анимацией хода ±24 (мотор неподвижен, телескоп)
2026-11-04 Кассета: макет мотора (корпус, выступ со штырьками, ось D5 с ручкой снизу, подставка) — проверить силу хода и люфт тележки без мотора; стол 106
2026-11-04 Стол 106: кассета целиком + макет мотора на одном столе
2026-11-04 Кассета: сцена-инструкция сборки по шагам; корпус макета мотора без штырьков (задвигается сбоку под стенку, зазор 0.3) — дырки под прутки снизу; стол 106 пересобран
2026-11-04 Убран scene_kasseta_sborka.py (по просьбе владельца)
2026-11-04 Кассета: сцена только механизма — тележка выдвигается и втягивается ±24 с паузами, основание и тележка полупрозрачные
2026-11-04 Кассета FDM: полка-мостик под плавающими шестернями над мотором (идея владельца), штырьки-оси Ø2 заодно с ползуном, отверстие шестерён Ø2.4; проверка хода ±24 чистая; стол 106
2026-11-04 motor1_fw: свой синус через ledc вместо SimpleFOC — SimpleFOC на этой ESP32 мотор не крутил, синус крутит (проверено на гимбале с Авито, 11 Ом); команды пульта прежние
2026-11-04 Вики: гимбал 2204 с Авито крутится, SimpleFOC молчит — прошивка на своём синусе (19.9, 19.30, 19.32); хроника 04.11
2026-11-04 Кассета под гимбал 2204 с Авито (Ø27.8 × 12.23): основание со стенками и полкой выше — под фланцем; фланец на 4 × М2 на Ø12 + ножка с шестернёй Z18 в шестигранник; ход ±24 и задвигание мотора сбоку п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
2026-11-04 Кассета 2204: сцена Blender — мотор неподвижен, фланец и шестерня крутятся, тележка ±24
2026-11-04 Кассета 2204: паз ползуна глухой канавкой — наружная стенка целая, полоска не висит; упор-вкладыш 3 мм в конце канавки — ползун ±12, тележка ±24; проверено; стол 107, сцена
2026-11-04 Кассета: стопор тележки относительно ползуна ±12.5 — выступ и пруток на гребне в двух дорожках, канавки с ключами в тележке; надевается с +X, пруток вклеить после; столы 106, 107, сцены
2026-11-04 Кассета 2204 без поддержек: левая стенка до дна, опоры правой стенки по краям (мосты ~29 мм); ползун из пластины и вклеиваемого гребня; ножка шестернёй на стол; стол 107 без поддержек
2026-11-04 Концепт: кассета на два GB1806 — рейка тележки переходит с шестерни на шестерню (m1 z14 через 8π), ход ±24; зацепление и моторы проверены; сцена
2026-11-04 Рольганг под 2204 (идея владельца): 3 верхние шестерни m1 z12 через 5π, средняя на моторе, крайние двухэтажные от промежуточных z10 в нижнем слое (фазы подобраны, левая и правая крайние разные), теле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
2026-11-04 Рольганг 2204: столы 108 (основание, поддержки только под палубой) и 109 (шестерни, тележка, рельс, крышка, фланец — без поддержек)
2026-11-04 Рольганг 2204: основание из двух частей (низ + верх с палубой, фиксаторы Ø3 и клей) — стол 108 без поддержек; проверка чистая
2026-11-04 Рольганг: низ основания без плёнки на разрезе; стол 108
2026-11-04 Рольганг: шляпка рельса и губы полоза тележки со скосами 45°, зубья рейки до пластины — тележка и рельс без поддержек; столы 108, 109
2026-11-04 Рольганг: фиксаторы основания сдвинуты внутрь (y 3.5 / 20.5) — дырки больше не режут стенки; стойки шире, дырки крепления кассеты y 9 / 15; стол 108
2026-11-04 Рольганг: фиксаторы основания 1.2 в глухие дырки 1.3 — палуба сверху целая, крайние шестерни не задевают; проверка чистая; стол 108
2026-11-04 Рольганг: рельс — гребень ласточкина хвоста, тележка — паз (как в телескопе), задняя стенка ниже полоза; всё без поддержек; проверка чистая; столы 108, 109
2026-11-04 Рольганг: ограничитель тележки — штырёк Ø2 в прорези крышки (крышка 1.0, ±27, прорезь открыта с +X + пробка) — тележка не дальше ±24.2; проверка чистая; столы 108, 109
2026-11-05 Т. Моторчик 19.36: запасной вариант — шестерня-улитка (половина лысая), две рейки сверху со штырьком на спине; сцена и скрипт; хроника 05.11
2026-11-05 Т. Моторчик 19.37: шестерни-улитки + копир — рейки не поднимаются, штырёк тележки переводит S-паз ~25°; сцена, скрипт; хроника 05.11
2026-11-05 Барабанный кулачок на 2204 (идея владельца): мотор внутри барабана, V-канавка 0.8 оборота на ход ±24, палец-конус 45° над осью, тележка на ласточкином хвосте; ход проверен, палец в канавке; стол 110,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
2026-11-05 Барабан: ручная проба без мотора — сплошной барабан с шестигранным гнездом, рама с втулкой, ручка-крутилка; стол 111
2026-11-05 Мотор плашмя в тележке (идея владельца): винт М3 сквозь трубку 2204, шестерня m1 z12 под тележкой по рейке, тележка на ласточкиных хвостах, ложе на стойках; ход ±24 чистый; стол 112, сцена
2026-11-05 Мотор плашмя: карман 12×6.6×1.6 в тележке под пайку и провода 2204 (площадки у края донышка между винтами), мотор проводами к +Y; стол 112 пересобран
2026-11-05 Мотор плашмя: сквозная дырка 5×4 под провода в тележке и щель 54×5 в куске грифа вдоль хода; стол 112 пересобран
2026-11-05 Мотор плашмя: большое окно под провода в тележке 21×6 насквозь (вместо кармана), щель в грифе 54×7; стол 112 пересобран
2026-11-05 Мотор плашмя: ложе шире (29.2), стойки больше не торчат за край; стол 112 пересобран
2026-11-05 Мотор плашмя: в сцене винт М3×20 — шток сквозь мотор в шестерню
2026-11-05 Мотор плашмя: соединение на шестигранниках — винт М3×20 DIN 933 в шестигранном гнезде крышки, гайка М3 в гнезде шестерни, ступица Ø4.4 до кольца подшипника; стол 112 пересобран
2026-11-05 Мотор плашмя: винт М3×20 из набора (круглая головка) — круглое гнездо в крышке, ложе выше на 1 мм; гайка М3 в гнезде шестерни; стол 112 пересобран
2026-11-05 Мотор плашмя: печать без поддержек — гнёзда стоек в тележке насквозь, потолок гнезда гайки ступенчатыми мостами; стол 112 пересобран
2026-11-05 Мотор плашмя: в шестерне квадрат 2.6 насквозь вместо гнезда гайки (идея владельца) — винт М3 сам режет резьбу, мостов нет; стол 112 пересобран
2026-11-05 Плоский диск-кулачок (идея владельца): канавка через центр, ход ±24 за 150°, тележка между двумя рельсами, штырёк без ножки, ручная проба без мотора; стол 113, сцена
2026-11-06 Т. Моторчик 19.38: мотор плашмя, низкий вариант — шестерня сразу на выходе, перемычка, упоры под шестернёй, провода вниз; сцена, скрипт, задание на файлы печати (стол 114); хроника 06.11
2026-11-06 Т. Моторчик 19.38: плита стенда 2 мм, материалы плиты и дна для настоящего грифа; хроника
2026-11-06 Вики 20.8–20.9, 19.38: дно грифа — авиафанера 2 мм; опыт полосы был на PETG (исправлено с PLA), пересчёт; бюджет высоты ~26 мм; хроника
2026-11-06 Вики 20.8: полоса всё-таки PLA (подтвердил владелец), пересчёт жёсткости; хроника
2026-11-06 Т. Моторчик 19.38: бюджет высоты 24.5 мм, крышка = дно ложа, шпилька М3 без головки, датчика пока нет; основание 2–2.5 мм; хроника
2026-11-06 Т. Моторчик 19.39: заметка — моторизированный фейдер с ремешком (Behringer X32); хроника
2026-11-06 Т. Моторчик 19.40: заметка — датчик положения для режима «сам»: 49E и магнит под шестернёй; хроника
2026-11-06 Т. Моторчик 19.40: основной вариант — 49E на тележке, магниты под струнами, разная полярность и высота; хроника
2026-11-06 Т. Моторчик: порядок работ — сначала перемещение (19.38), режим «сам» и датчик потом (19.40); хроника
2026-11-06 Т. Моторчик 19.38: итоговая схема грифа — основание, щель, платформа, 4 тележки, петли проводов, 24.5 мм; сцена и скрипт
2026-11-06 Т. Моторчик 19.41: ванночка, кубики, рейка с крышкой — версия на печать, одна тележка; сцена, скрипт, хроника
2026-11-06 Т. Моторчик 19.42: мотор перевёрнут, провода через его трубку, полая шестерня в пазу — версия на печать, одна тележка; сцена, скрипт, хроника
2026-11-06 Т. Моторчик 19.43: итог — рейка со скосом, узкий задний рельс, два зеркальных окна, замеры мотора; версия на печать, скрипт и сцена; хроника
2026-11-06 Стол 114: стенд на одну тележку по вики 19.42/19.43 — мотор перевёрнут, провода через трубку, полая шестерня в пазу, рейка со скосом, два окна; ход ±22 чистый, детали без поддержек; генератор, сцена
2026-11-06 Стол 114: мотор прикручен к крыше сверху М2×4 через прорези (замер владельца), окно в крыше под пайку и провода, прижимная пластина
2026-11-06 Стол 114: ножки вдвое короче (15 мм), просьба владельца
2026-11-06 Сцена: 4 тележки стола 114 со смещённым ложем (идея владельца) — шаг моторов 30, шаг пальцев 24, сдвиги ±3 и ±9
2026-11-06 Стол 114 после сборки: дно платформы 2 мм, П-стойка вместо ножек (4×М2 с гайками), кубик выше на 1.5, шейка шестерни — квадрат под головки М2, фланец толще; планка над зубьями убрана, упор и щёчка ко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
2026-11-06 Стол 114: стойка — перевёрнутая П: дно-рамка с окном, шипы стенок входят в платформу снизу
2026-11-06 П-стойка низкая: стенки 3 мм; стол 115 только со стойкой, стол 114 пересобран
2026-11-06 motor1_fw: шестерня m1 z12 стенда 114, RP = 6 мм
2026-11-06 П-стойка: сплошное дно без окна
2026-11-06 П-стойка: стенки на концах хода, вдоль грифа открыто под провода к плате, 4 столбика с шипами
2026-11-06 Стойка заменена двумя вкладками (идея владельца): каждая со стенкой и двумя шипами, снизу и вдоль грифа открыто под провода
2026-11-06 Вибрация «прижми здесь»: команды v, va, vf в motor1_fw, кнопка и ползунки в пульте
2026-11-07 Стол 116: проба на 4 пальца — цельная платформа с шагом 30, вкладки, площадки со сдвигом ±3 и ±9 (шаг пальцев 24)
2026-11-07 Датчик положения: ямка под 49E в нижнем этаже, канал проводов через угол кубика, гнёзда магнитов Ø4 под струнами 1–5 (идея владельца), шипы вкладок между магнитами; столы 114 и 116
2026-11-07 Сцена 116: датчик на своём месте
2026-11-07 Сцена 116: датчик в ямке (координаты)
2026-11-07 Датчик и магниты на места владельца: 49E у перемычки над пазом, магниты насквозь в дне паза, шипы вкладок обратно 18…24
2026-11-07 Кубик: канал проводов Ø2.8 в углу и широкий вход в него из полости
2026-11-07 Нижний этаж: щели между перемычкой и юбкой закрыты, перемычка с обеих сторон
2026-11-07 Датчик 49E на одном моторе: чтение GPIO 32 в motor1_fw, график и скан в пульте; магниты в платформе стола 114
2026-11-07 Кубик: канал проводов насквозь через крышу и канавка сверху от угла к окну, карман в пластине
2026-11-07 Кубик: широкий треугольный канал по крыше от угла к окну
2026-11-07 Датчик 49E вставляется снаружи через боковое окно, ножки Г, провода по канавке на стенке и крыше; угловой канал убран; магниты сдвинуты; столы 114 и 116
2026-11-07 Стол 116: пластина для второго мотора
2026-11-07 Стол 116: борта ложа на площадках, отдельными деталями на штырьках
2026-11-07 Стол 116 под ключ: 4 кубика, 4 нижних этажа, 4 пластины, 4 шестерни, 4 фланца
2026-11-08 Т. Моторчик: заметка — шагоход, 3 слоя реек, сцена и скрипт; хроника
2026-11-09 Т. Моторчик: шагоход на 3 слоя — задание на стенд одной тележки, порядок сборки; хроника
2026-11-09 Т. Моторчик: шагоход отложен, итоги проб, симуляция MuJoCo; хроника
2026-11-09 Т. Моторчик: провода через центр мотора — МГТФ 0,07 или 30 AWG; хроника
2026-11-09 Пульт: кнопки струн записывают значение датчика 49E, таблица и подсказка текущей струны
2026-11-09 Пульт: ручной режим 49E — счёт пиков от струны 6, график по времени
2026-11-09 Страница struny_49e: пошаговая запись значений 49E по струнам и определение струны с учётом соседних
2026-11-09 struny_49e: если соседние не подходят и тележка стоит — поиск по всем струнам
2026-11-09 struny_49e: определение только по соседям — знак пика, направление, струна без магнита как старт
2026-11-09 struny_49e: живой график волны датчика
2026-11-09 Датчик 49E: 200 значений в секунду, страницы подстроены
2026-11-09 struny_49e: при отсутствии поля честно писать «нет поля»
2026-11-09 struny_49e: нет поля 0.7 с — струна без магнита
2026-11-09 struny_49e: выбор соседней струны по высоте пика вместо направления
2026-11-09 struny_49e: раскладка 0 − − + + − (идея владельца), сосед выбирается по знаку пика
2026-11-09 struny_49e: со соседней струны на струну без магнита за 0.3 с
2026-11-09 Положение тележки (решение владельца): 3 датчика 49E в дне паза и 2 магнита на тележке, 6 разных сигналов; прошивка на 3 входа, страница struny_3x49e; столы 114 и 116
2026-11-10 Т. Моторчик: 3 датчика 49E боком, ножки в отверстия, провода снизу; сцена, скрипт, схема; задание на STL; хроника
2026-11-12 Телескоп v3 работает: мотор неподвижен, ход тележки ±22 удвоением шестернями; генератор, STL, сцена, сборка; вики и хроника
2026-11-12 Телескоп v4: кнопки зажатия в мосту, крышки, каналы, скосы; генератор, STL, сцена; вики
2026-11-12 Т. Моторчик 19.49: схема кнопок — резисторная лестница на один пин
2026-11-12 Т. Моторчик: задание — мост-кассета с кнопками под плату; хроника
2026-11-12 Мост-кассета с кнопками: STL пробы, генераторы, сцена; тележка v4 под неё; вики
2026-11-13 Полный макет v5: телескоп v3 + узкий мост с кнопками, вибро под мостом на TPU-подушках; вики 19.51
2026-11-13 Проба балки с кнопками (most_test): корпус, пластина с ячейками, лента с язычками, 2 тележки по зазору; вики 19.52
2026-11-13 Тележка с двумя П-язычками, зазор хвоста 0.2; все генераторы, сцены Blender, STL и asm (most_v2, most_test, full_v5); вики 19.53
2026-11-13 Проба балки v2: шаг кнопок 8.5, П ленты в одну сторону, широкий язычок тележки; вики 19.54
2026-11-13 Проба балки v2 (вики 19.54): папка 3-0/19.54_balka_v2 со всеми STL, сценой и столом 117
2026-11-13 Балка v2: нажимник на самом кончике П-язычка тележки (владелец); путь к most_v2 в репо
2026-11-13 Балка v2: убрана стенка 0.05 за крайними ячейками пластины
2026-11-13 Балка v2: прорезь П-язычка тележки только сквозь крышу, скос паза целый
2026-11-13 Балка v2: край ленты у торца 0.8 (крайний язычок короче), нажимник тележки пирамидкой
2026-11-13 Балка v2: плёнка 0.24 поверх ленты в желобке крышки (владелец), нажимник выше на её толщину
2026-11-13 Балка v2: вместо отдельной плёнки — кожица 0.24 поверх прорезей ленты (владелец), прорези видны как линии
2026-11-13 Балка v2: поперечная щель ленты насквозь (как струна), продольные под кожицей
2026-11-13 Балка v2: продольные щели ленты насквозь, поперечная под кожицей (по разметке владельца)
2026-11-13 Балка v2: П-язычок тележки на всю толщину дна 1.3 (владелец)
